GabrielPaschoalin/PFC/maglev/Analises/PULSO_255_150_800_9_800/debug/sync_preview.jpg

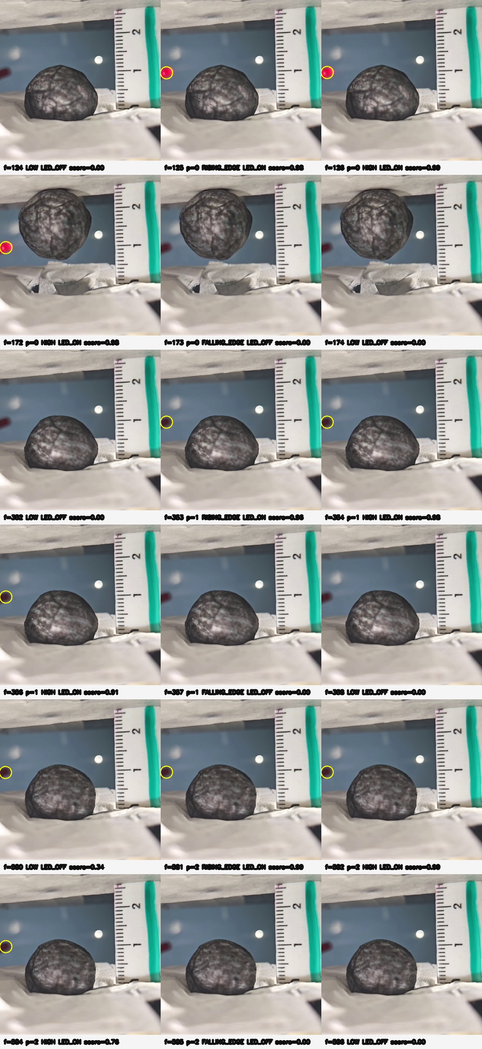
maglev/Analises/PULSO_255_150_800_9_800/debug/sync_preview.jpg
