GabrielPaschoalin/PFC/maglev/Analises/PULSO_255_150_800_9_800/debug/ruler_preview.jpg

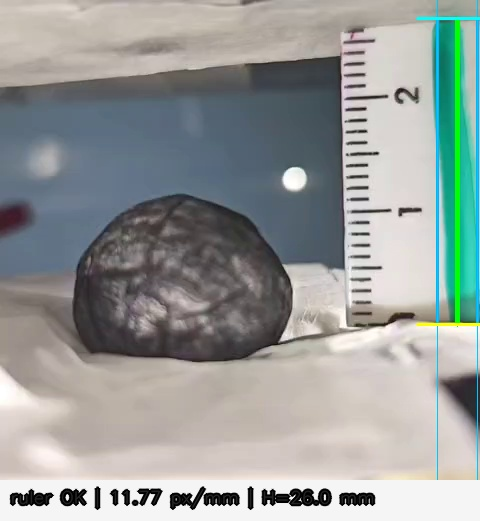
maglev/Analises/PULSO_255_150_800_9_800/debug/ruler_preview.jpg
