GabrielPaschoalin/PFC/TESE/modelo_latex/modelo_latex/Monografia.tex

% Monografia para Projeto de Fim de Curso - Exemplo no LaTeX
%-----------------------------------------------------------

%---------------Inicialização de pacotes--------------------

\documentclass[12pt,a4paper,notitlepage,twoside]{book}
\usepackage{times}

\usepackage{graphicx}
\usepackage[latin1]{inputenc}
\usepackage[brazil]{babel}
\usepackage[T1]{fontenc}
\usepackage{amsmath}
\usepackage{amsthm,amsfonts}
\usepackage{color}
\usepackage[colorlinks]{hyperref}
\usepackage{abntex2abrev}

\usepackage[a4paper,top=30mm,bottom=30mm,inner=30mm,outer=25mm,headheight=7mm,headsep=6mm,footskip=7mm]{geometry}
%\usepackage{epsfig}
%\usepackage{latexsym}
%\usepackage{float}
%\usepackage{quotes}
%\pagestyle {plain}

\makeindex

\def\baselinestretch{1.0}

%---------------Início do documento-------------------------

\begin{document}

\include{Capa/capa}

\pagenumbering{roman}
\include{Resumo/Resumo}
\include{Agradecimentos/Agradecimentos}
\include{TabelaConteudo/TabelaConteudo}
\include{ListaFiguras/ListaFiguras}
\include{ListaTabelas/ListaTabelas}

\pagenumbering{arabic}
\setcounter{page}{1}
\include{Introducao/Introducao}
\include{DescricaoProcesso/DescricaoProcesso}
\include{Metodologia/Metodologia}
\include{Resultados/Resultados}
\include{Conclusao/Conclusao}

\addcontentsline{toc}{chapter}{Referências Bibliográficas}
\bibliographystyle{plain}
\begin{small}
\bibliography{telefonia}%,library}
%\input{Monografia.bbl}
\end{small}

\end{document}

%---------------Fim do documento----------------------------
