GabrielPaschoalin/PFC/Modelagem-PFC/Magnetic Cores with FEMM and LUA.pptx

## Magnetic Cores designs with FEMM

Simulating magnetic core using FEMM and LUA scripts to estimate inductance and Magnetic Gain
Javier Contreras
Scott Vestal
February 2017

## Installing FEMM

- FEMM can be downloaded from the official website. http://www.femm.info/wiki/HomePage.

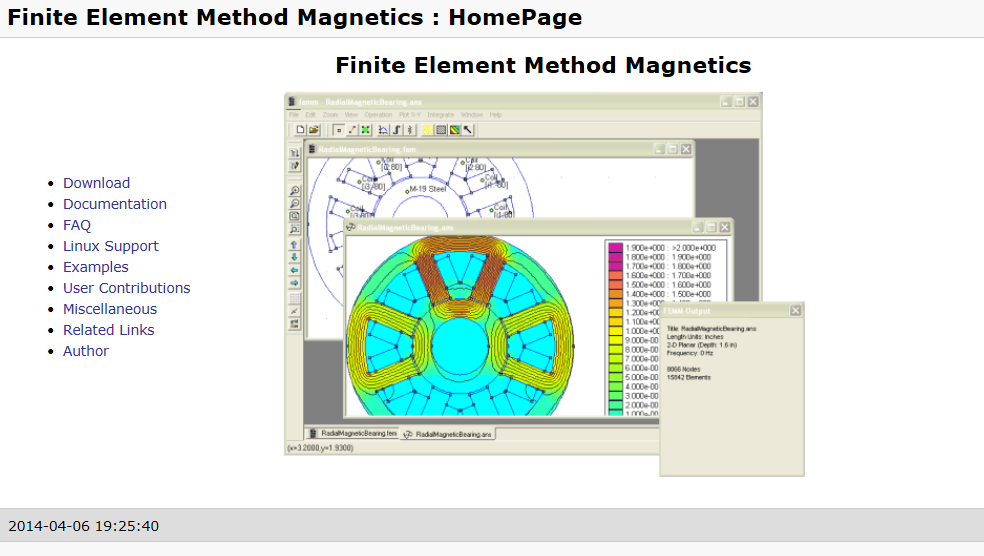
[picture p3: figure]

## Finite Element Method Magnetics (FEMM) Basics

- FEMM uses a Finite Element method to solve electromagnetics problems.
- Nodes connected by line segments and arcs to define boundary conditions as well as regions containing different materials and current distributions.
- FEMM then generates a mesh within this problem’s geometry, which it uses to solve for the magnetic field distribution within the boundaries.

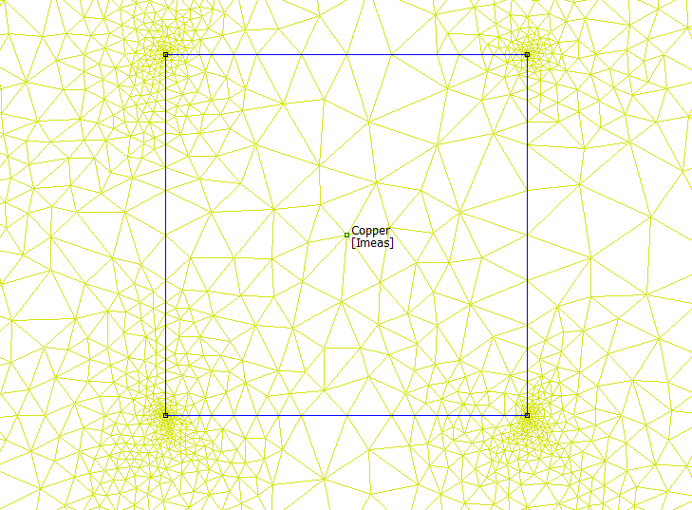
[picture p4: figure]

## Finite Element Method Magnetics (FEMM) Basics

- LUA allows all the functionality of FEMM to be controlled through scripting and make drawing a core and changing parameters quicker and not having to redraw a core in FEMM
- Scripts attached are used to get an estimate of magnetic core’s inductance in the secondary coil and the core’s magnetic gain.
- Parameters are used in the DRV421 System Parameter Calculator (http://www.ti.com/lit/zip/sloc329)

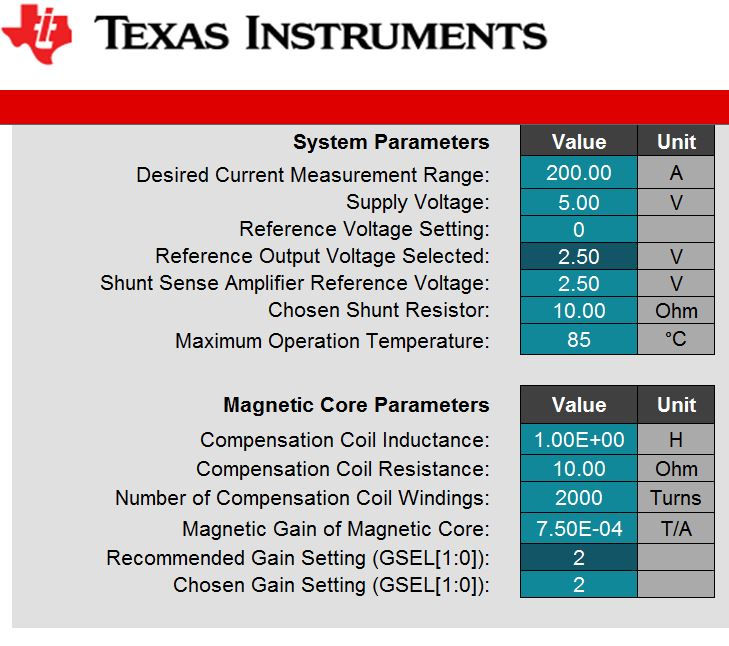
[picture p5: figure]

## Magnetic Core

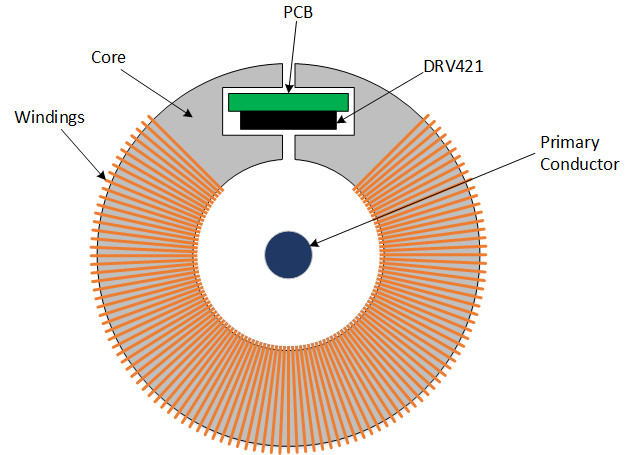
[picture p6: figure]

- The script attached will draw the core seen.
- Download script and save where you would like all your FEMM Magnetic Core simulations saved.

## Run Script From FEMM

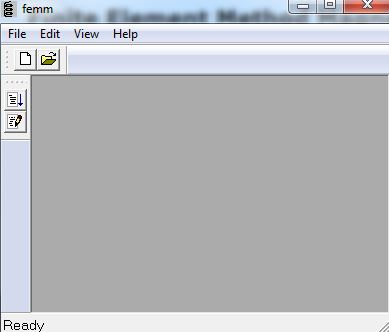
[picture p7: figure]

- Click “Open a Lua Script”
- Navigate to location of the scipt “Build_Magnetic_Core.lua” and select it.
- Follow the next slides for description of the input parameters.

## Input Parameters for Script

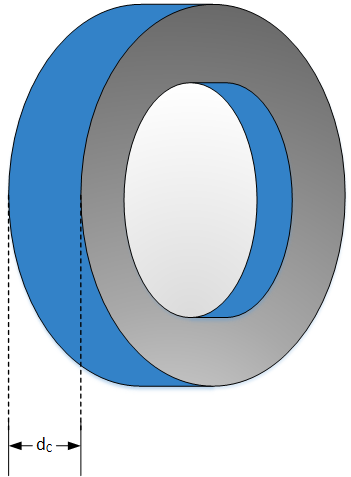
[picture p8: figure]

- File Name – This is the name of the file created and saved. It will be save in the folder that contains the script.
  - Note: file name must include .fem extension
- Core_Depth (dc) This is how much depth in the simulation there is. This is the axis that is not shown in FEMM since this is only a 2D drawing.

## Input Parameters for Script Cont.

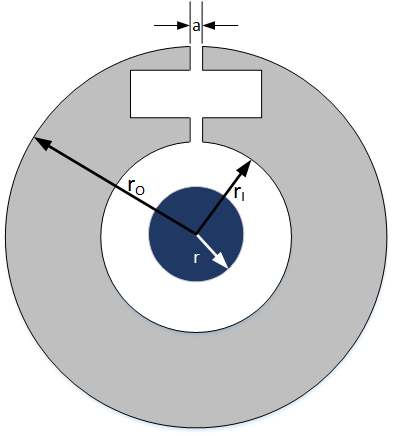
[picture p9: figure]

- Core Inside Radius (ri)
- Core Outer Radius (ro)
- Air Gap (a)

## Input Parameters for Script Cont.

- Primary Radius (r)
- Core Permeability
  - 14000 (Iron)
  - 83000 (Mu Metal)

## Input Parameters for Script Cont.

- Number of Turns- Secondary Coil number of windings.
- Winding Angle (ti°)

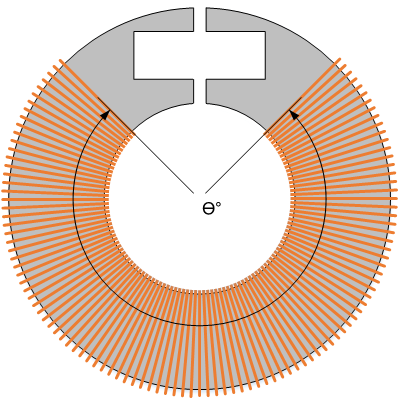
[picture p10: figure]

## Input Parameters for Script Cont.

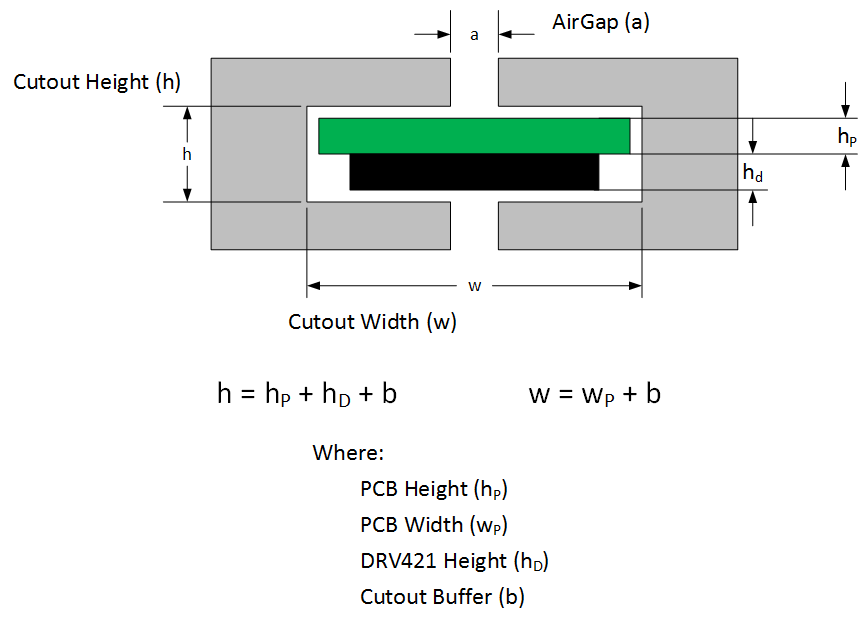
[picture p11: figure]

- PCB Height (hP)
- PCB Width (wP)
- Cutout Buffer (b)
- DRV421 Height (hD) is a constant

## Script outputs

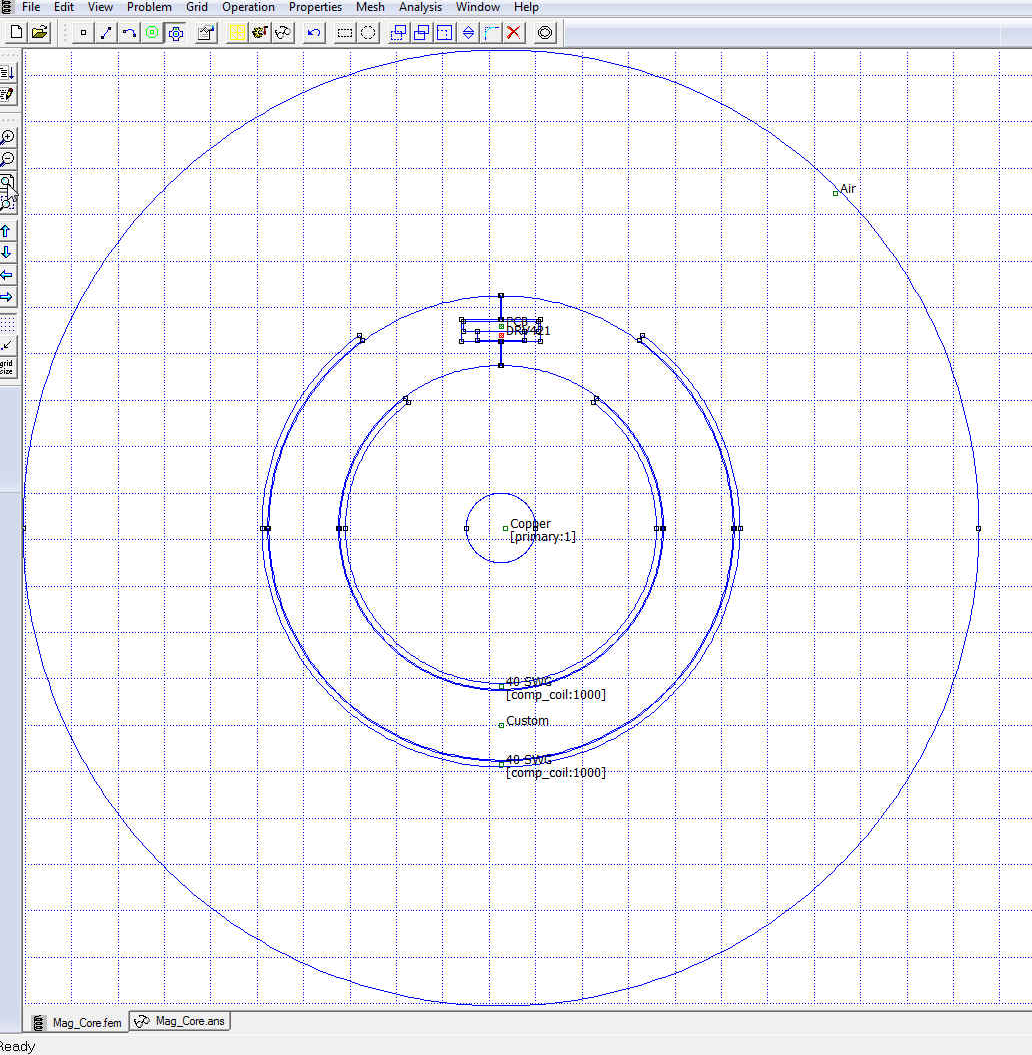
[picture p12: figure]

- Filename.fem file with the drawing of the Magnetic Core with input parameters.
i. A current on the compensation coil. Compensation current is (1A)/(# of Turns) . The current is used to calculate the inductance and magnetic core gain.
ii. Primary current is zero.

## Script outputs Cont.

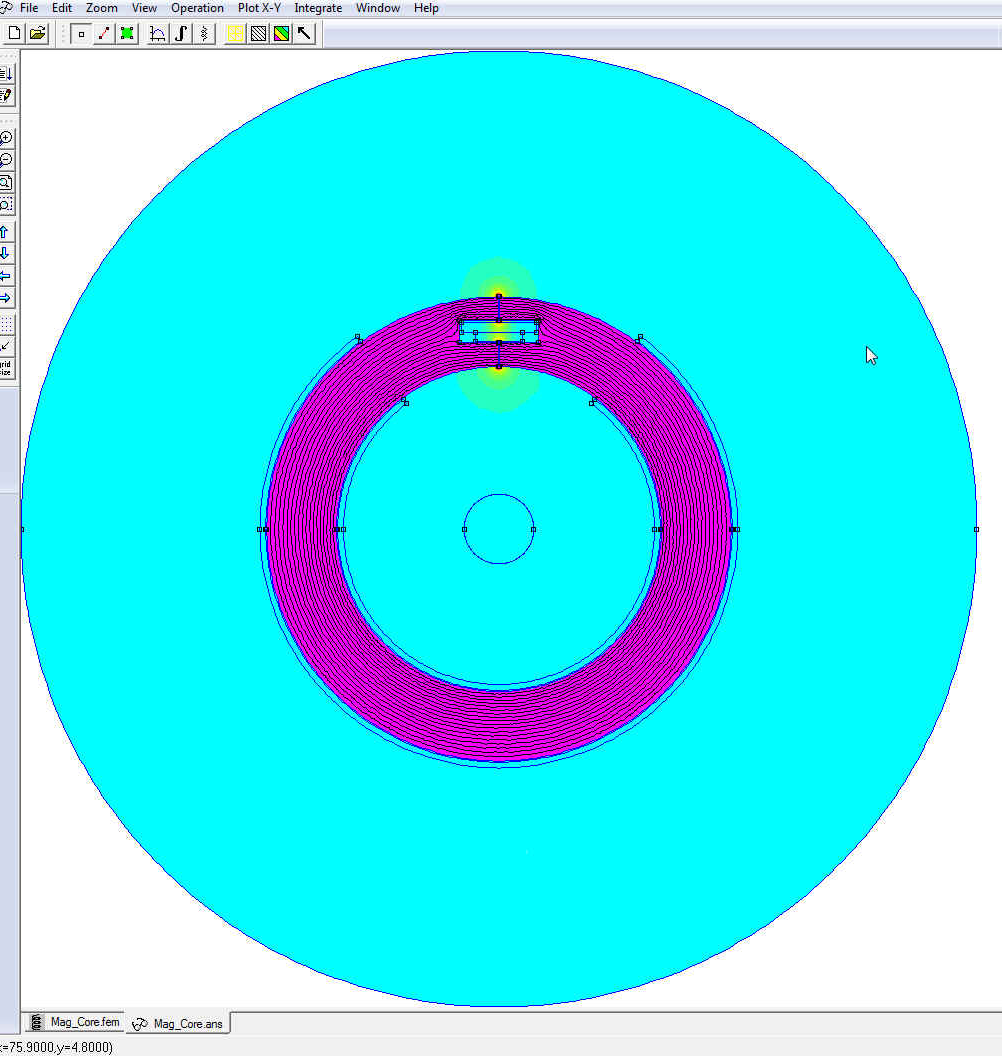
[picture p13: figure]

- Filename.ans (answer) file that shows the magnetic field on and surrounding the magnetic core with current on the compensation coil as described in previous slide.

## Script outputs Cont.

- Lua Outputs.
1. Inductance(H)
2. Core Magnetic Gain (Tesla/Amp)
3. Sensor Location (X,Y) 0.4 mm from top of DRV421

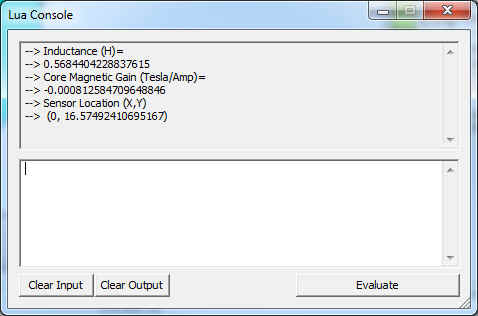
[picture p14: figure]
