GabrielPaschoalin/PFC/TESE/modelo_latex/modelo_latex/Conclusao/Conclusao.tex

\chapter{Conclusões}

\section{Considerações Finais}

Aqui vai o texto da conclusão.

\section{Propostas de Continuidade}

\clearpage
