GabrielPaschoalin/PFC/TESE/modelo_latex/modelo_latex/DescricaoProcesso/DescricaoProcesso.tex

\chapter{Descrição do Processo}

Se desejar, uma visão geral do Capítulo pode ser colocada antes da primeira Seção. Este é o capítulo de descrição do processo e formulação do problema. Tendo em vista que se trata de uma monografia de engenharia de controle e automação, em muitos casos, é fundamental a apresentação dos sensores e atuadores do processo.

\section{Processo de Fazer Alguma Coisa}
\markright{\thesection ~~~ Histórico}
\label{hist}

...

\section{Instrumentação do Processo}
\markright{\thesection ~~~ O Telefone}
\label{telefone}

Continua ...

\section{Resumo do Capítulo}

Não termine de forma abrupta.

\clearpage
