GabrielPaschoalin/PFC/TESE/modelo_latex/modelo_latex/ListaFiguras/ListaFiguras.tex

\listoffigures
\addcontentsline{toc}{chapter}{Lista de Figuras}
%\markboth{Lista de Figuras}{Lista de Figuras}

\clearpage
%\thispagestyle{empty}
%\cleardoublepage

% Normalmente, este arquivo só contém isto.
