GabrielPaschoalin/PFC/TESE/modelo_latex/modelo_latex/ListaTabelas/ListaTabelas.tex

\listoftables
\addcontentsline{toc}{chapter}{Lista de Tabelas}
%\markboth{Lista de Tabelas}{Lista de Tabelas}

\clearpage
%\thispagestyle{empty}
%\cleardoublepage

% Normalmente, este arquivo só contém isto.
