GabrielPaschoalin/PFC/TESE/modelo_latex/modelo_latex/Metodologia/Metodologia.tex

\chapter{Metodologia}

Neste capítulo, você deve apresentar uma breve revisão bibliográfica sobre as técnicas utilizadas para solução do problema.

\section{Técnica 1}
\markright{\thesection ~~~ Metodologia}
\label{metodo}

Aqui você encontra um exemplo de inserção de figura. Veja o arquivo DescricaoProjeto.tex para ver os comandos.
\begin{figure}[!htbp]
	\centering		
	
	\caption{figuara teste}
	\label{fig:ciclodesenvolvimento}
\end{figure}

A figura \ref{fig:ciclodesenvolvimento} tal aparece.

\begin{table}
	\centering
		\begin{tabular}{c|c}
			1 & 2 \\
			1 & 2 \\
			1 & 2 \\
			1 & 2 \\
			1 & 2 \\			
		\end{tabular}
\end{table}

\begin{figure}[htbp]
\centering

\caption{Ciclo de desenvolvimento de um projeto \cite{and/74}.}
\label{CicloDesenvolvimento1}
\end{figure}

Para referenciar a Figura \ref{CicloDesenvolvimento1}, veja arquivo .tex.

\begin{equation}\label{eq:forca}
	f=ma
\end{equation}

A equação \ref{eq:forca}
\section{Técnica 2}
\markright{\thesection ~~~ Metodologia}
\label{metodo1a}

\section{Resumo do Capítulo}
\markright{\thesection ~~~ Metodologia}
\label{metodo1b}

\clearpage
