GabrielPaschoalin/PFC/TESE/Referência/LAB 1 - MAGLEV.pdf

## Relatório do Módulo 2: MAGLEV (Levitador Magnético)

Bernardo de Souza Silva, Gabriel Henrique Lara Paschoalin Dias, Igor Miranda Sartori, Júlia de Castro
Laboratório de Controle e Automação I - Turma PN2 I - Introdução
O objetivo do presente relatório é fornecer uma descrição dos procedimentos realizados em ambiente laboratorial para o desenvolvimento de um controlador destinado à planta conhecida como MAGLEV (Levitador Magnético). O princípio de funcionamento deste dispositivo é baseado na levitação de uma pequena esfera metálica por meio da criação de um campo eletromagnético. Assim, o dispositivo é um modelo simplificado de mecanismos que usam propriedades eletromagnéticas para reduzir o atrito, como trens de levitação magnética, rolamentos magnéticos, bombas, ventiladores, turbinas, entre outros. A Figura 1 apresenta o modelo visual da planta controlada.

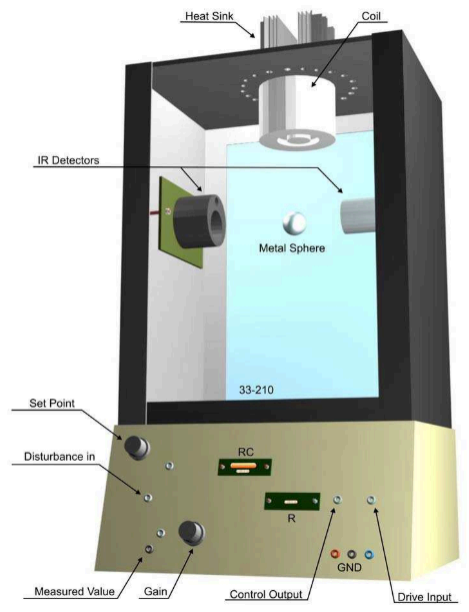
[picture p41: figure]

Figura 1: Modelo visual do MAGLEV (Feedback Instruments Ltd., 2006)

O MAGLEV está equipado com sensor infravermelho para detectar a posição da esfera e uma bobina, que gera o campo eletromagnético quando uma corrente elétrica é aplicada. O sistema é SISO (Single Input, Single Output), tendo como entrada a corrente e como saída a posição da esfera metálica. Na prática, a entrada do módulo de levitação não é a corrente na bobina, tampouco a saída é a posição em metros da esfera. O que ocorre é que a corrente é produzida a partir de um sinal de tensão e a posição da esfera é medida pelo sensor infravermelho e enviada à placa de aquisição de dados, também em forma de tensão.

O módulo possui uma interface para se comunicar com a placa de aquisição de dados, que é responsável por fornecer os sinais necessários para o funcionamento do sistema de controle. Esse sistema de controle é implementado no ambiente MATLAB, utilizando a ferramenta Simulink. Os sinais de controle, calculados pelo controlador, são convertidos em sinais de tensão na faixa de -5 V a 5 V. Esses sinais de tensão são então aplicados à bobina, permitindo o controle preciso da posição vertical da esfera metálica.
A fabricante Feedback libera um projeto inicial funcional, mostrado na Figura 2, com um diagrama de blocos implementado. A partir dele, inicia-se o projeto do controlador.

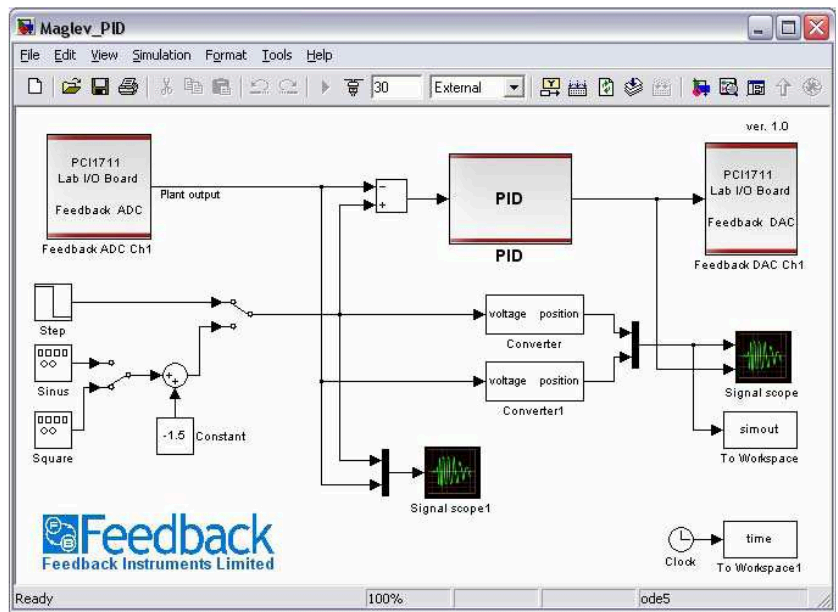
[picture p42: figure]

Figura 2: Projeto inicial do MAGLEV, fornecido pela fabricante Feedback (Feedback Instruments Ltd., 2006)

Na prática realizada, foram editados os blocos PID, para alterar os parâmetros KP, KI e KD; Square, para gerar os degraus; Constant, para alterar o valor da constante que define a posição que será o ponto de operação, em metros. Além disso, adicionou-se um conversor de tensão para posição após a saída da planta; e um conversor de posição para tensão após a saída do controlador. Um bloco ctrl_signal foi adicionado para obter os valores do sinal de controle.

II - Descrição da planta
Identificação das variáveis controlada, manipulada, medida e de referência
Diante da análise feita na planta do MAGLEV, identificou-se as variáveis do sistema. Estas são indicadas a seguir:
- Variável controlada: Posição da esfera metálica (m), após a conversão de tensão para posição;
- Variável manipulada: Corrente elétrica na bobina (A), que é produzida por um sinal de tensão;
- Variável medida: Posição da esfera metálica (m);
- Variável de referência: Posição desejada da esfera metálica, 0,009 metros acima do ponto inicial. Identificação dos subsistemas físicos correspondentes à planta, ao sensor, ao atuador e ao gerador de sinais de referência
Diante da análise feita na planta do MAGLEV, identificou-se os subsistemas físicos correspondentes à planta, ao sensor, ao atuador e ao gerador de sinais de referência. Estes são indicadas a seguir:
- Planta: Representa o sistema físico real sendo controlado, ou seja, o próprio MAGLEV (Levitador Magnético), que consiste em uma estrutura composta por uma bobina e uma esfera metálica.
- Sensor: Refere-se ao sensor infravermelho utilizado para detectar a posição da esfera metálica. Esse sensor fornece informações sobre a posição do sistema em relação à posição vertical.
- Atuador: Representa a bobina do MAGLEV, que é controlada pela variação da tensão aplicada a ela. Essa variação na tensão afeta diretamente a posição vertical da esfera metálica.
- Gerador de sinais de referência: Representa o bloco de geração de sinais de referência do Simulink, que é utilizado para definir as posições verticais desejadas da esfera metálica. Identificação dos sinais de perturbação e não-linearidades
Diante da análise feita na planta do MAGLEV, identificou-se possíveis sinais de perturbação e não-linearidades do sistema. Estes são indicadas a seguir:
- Sinais de perturbação: Incluem influências externas que afetam o comportamento do sistema, como vibrações na planta e na mesa onde ela está localizada, variações na corrente elétrica fornecida, interferências magnéticas externas e outros tipos de esforços externos sobre o sistema durante o seu funcionamento. O controlador deve ser capaz de lidar com essas perturbações, de modo a manter o sistema estável.
- Não-linearidades: A dinâmica do MAGLEV pode apresentar não-linearidades devido a vários fatores, tais como variações altas na corrente elétrica fornecida à bobina, saturação magnética, efeitos não-lineares do sensor infravermelho, não-linearidades nos conversores de tensão para posição e posição para tensão, entre outros. Essas não-linearidades podem afetar o comportamento do sistema, especialmente em posições extremas da esfera metálica ou em condições de alta velocidade.

III - Especificação de desempenho desejado (objetivo)
A fim de obter um bom resultado no controle da planta, foram estabelecidos previamente alguns parâmetros a serem seguidos, sendo estes:
- Rejeitar distúrbios: O sistema deve ser capaz de rejeitar eficientemente os distúrbios externos, como variações na carga, vibrações e interferências magnéticas, garantindo que a posição da esfera metálica seja mantida próxima à posição desejada, mesmo diante dessas perturbações.
- Tempo de assentamento e overshoot baixos: O sistema deve ser capaz de atingir a posição desejada da esfera metálica o mais rápido possível, minimizando tanto o tempo de assentamento, em torno de 1 segundo, quanto o overshoot, em torno de 20%. Isso proporciona uma resposta rápida e suave do sistema, evitando oscilações e permitindo que a esfera atinja a posição desejada com precisão e estabilidade.
- Seguimento de trajetória em degrau: O sistema deve ser capaz de seguir com precisão uma trajetória em degrau, ou seja, quando a posição desejada da esfera metálica é alterada abruptamente. O controlador deve garantir que a esfera se mova suavemente e rapidamente para a nova posição, minimizando o tempo de resposta e reduzindo o overshoot, garantindo assim um controle eficiente e preciso do sistema.

IV - Modelagem matemática
Segundo o manual da planta (Feedback Instruments Ltd., 2006), constatou-se que a função de transferência, no ponto de operação, é dada por:
G(s) = | , | (1)

−Ki
(s² + Kx
)
em que:
K | (2)
x =

−2mg
x
o
e
K | (3)
i =

2mg
i
o
Nas equações (2) e (3), m = 0, 02 kg é a massa da esfera metálica, constatado via pesagem na
balança, i | é a corrente inicial aplicada e | é a posição inicial, expressa em V.
o = 0, 8 A | x

o = 1, 5 V
Para o cálculo das constantes K e | , os valores de e | foram convertidos para metros, de
x

K
i

i
o

x
o
modo que possa ser calculado corretamente o modelo. A fórmula de conversão é indicada abaixo:
Posição[m] = 0, 007 · Tensão[V] + 0, 0195 | (4)
Para x = -1,5 V, a posição, em metros, encontrada é:
o
x [m] | (5)
o | = 0, 007 · (− 1, 5) + 0, 0195 = 0, 009 m
Logo,
K | (6)
x =

−2·(0,02)·(9,8)
0,009 =− 43, 5

Já para i = 0,8 A, a posição, em metros, encontrada é
o
i | , | (7)
o

[m] = 0, 007 · (

0,8
1,05

) + 0, 0195 = 0, 0248 m
de modo que:
K | (8)
i =

2·(0,02)·(9,8)
0,0248 = 15, 8
Com toda a manipulação apresentada, é possível encontrar a função de transferência do sistema G(s), que é:
G(s) = | (9) ⁻ ¹⁵,8
(s² −43,5)

V - Validação do modelo obtido
A validação do modelo obtido do relatório não se fez necessária devido à abordagem adotada durante a fase de modelagem física do sistema. Seguindo as diretrizes estabelecidas no manual, garantimos a fidelidade do modelo em relação à realidade operacional. Os testes subsequentes demonstram essa assertiva, evidenciando a congruência entre a simulação teórica e os resultados práticos obtidos.

VI - Projeto do controlador
Na etapa de projeto do controlador, foram analisados diversos aspectos da planta, especialmente o comportamento do seu lugar das raízes, conforme ilustrado na Figura 3.

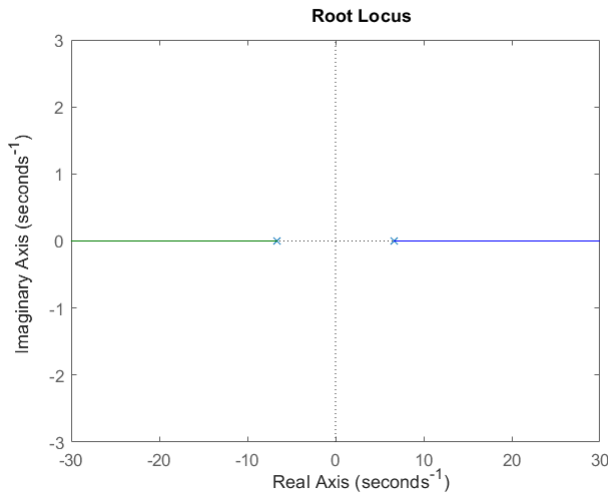
[picture p43: figure]

Figura 3: Lugar das raízes da planta

Para atender os requisitos de rejeição de distúrbios, tempo de assentamento baixo e pouco sobressinal, projetou-se um controlador PID, que tem equação:

PID = K | , | (10)
P +

KI
s + K
D

s
onde K é o ganho proporcional, | é o ganho integral e | é o ganho derivativo. Sabe-se que aumentar o
P

K
I

K
D
K pode tornar a resposta do sistema mais rápida, aumentar o pode reduzir o erro em regime
P

K
I
permanente e aumentar o K pode reduzir a magnitude das oscilações (SOUZA, 2023). Porém, aumentar
D
demais os ganhos pode causar mais instabilidade, oscilações e ruídos. Usando a função systool do MATLAB, identificou-se o melhor lugar para os polos do sistema e, com isso, determinou-se as
constantes do controlador: K = 4, | = 6, | = 0,9.
P

K
I

K
D
A Figura 4 mostra o lugar das raízes da planta junto do controlador.

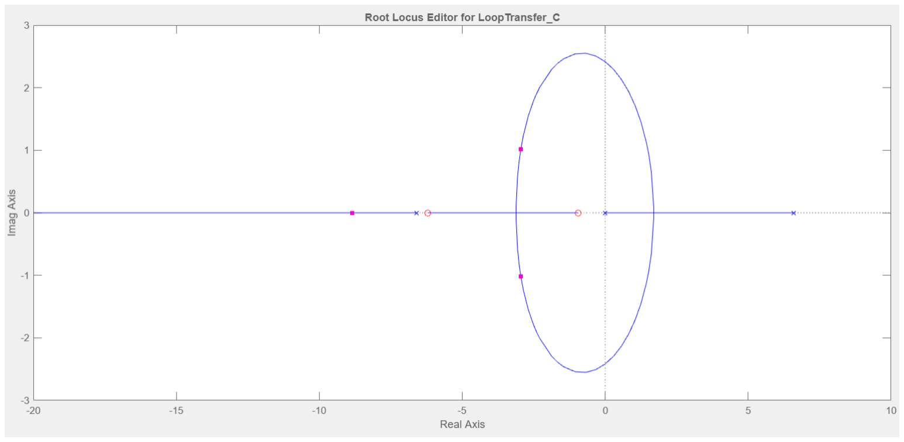
[picture p44: figure]

Figura 4: Lugar das raízes de C(s)G(s)

Logo, por meio da equação (10):
PID = 4 + | (11) ⁶
s + 0, 9s =

0,9s² + 4s + 6
s
Esse controlador apresentou um resultado satisfatório e foi considerado o controlador ideal para solucionar o problema apresentado, como será detalhado na próxima seção.

VII - Resultados experimentais em Malha Fechada
O ambiente no Simulink utilizado para os experimentos é mostrado na Figura 5. Neste diagrama, foi necessário criar os blocos Converter2 e Converter3, onde o primeiro recebe a medição da planta em volts e converter para metros. Já o segundo, recebe o sinal de controle calculado em metros e o converte para volts, para que o mesmo possa ser aplicado no atuador da planta.

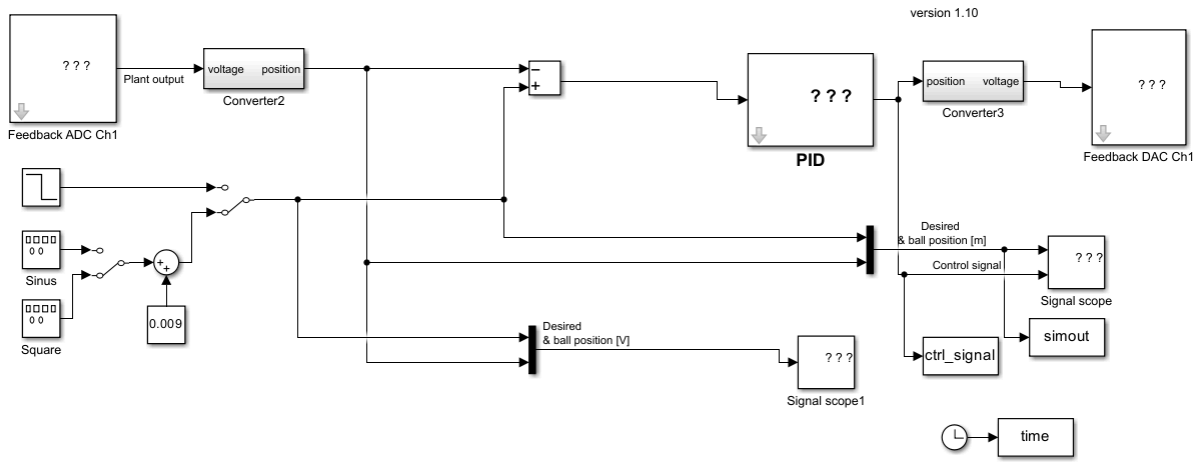
[picture p45: figure]

Figura 5: Ambiente do Simulink utilizado para os experimentos

Para testar o sistema em malha fechada com o controlador PID, definiu-se alguns cenários a serem levados em consideração, sendo indicados abaixo os gráficos das respostas a cada situação. Previamente, é necessário indicar um comportamento programado para o sistema, que é aplicar o efeito do integrador apenas após 15 segundos do início da aplicação. Isso implica que o sistema tende a erro zero apenas após esse tempo.
O primeiro caso é quando o sistema parte do repouso até a sua estabilização, sendo que a esfera é colocada manualmente. Na Figura 6, observa-se que o sistema não apresenta overshoot significativo e a esfera se desloca cerca de 4% para cima e para baixo em regime transitório, o que pode ser considerado um erro pequeno.

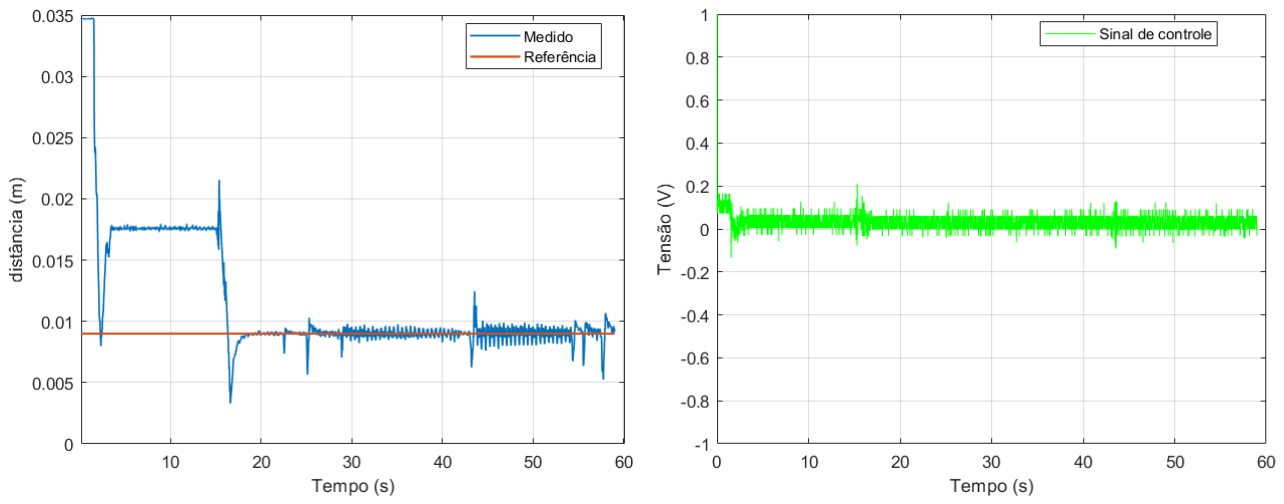
[picture p46: figure]

Figura 6: Comparação entre a posição da esfera e a referência ao longo do tempo e sinal de controle correspondente

Neste experimento específico, para simular um distúrbio, optou-se por aplicar um tremor sobre a mesa sob a qual o experimento está posicionado. A Figura 7 mostra, de forma ampliada, a resposta ao distúrbio no experimento acima, evidenciando, mais uma vez, a eficácia do controlador implementado. Vale ressaltar, que a oscilação no gráfica é baixa, considerando que a escala do eixo da distância está na escala 10 .

−3

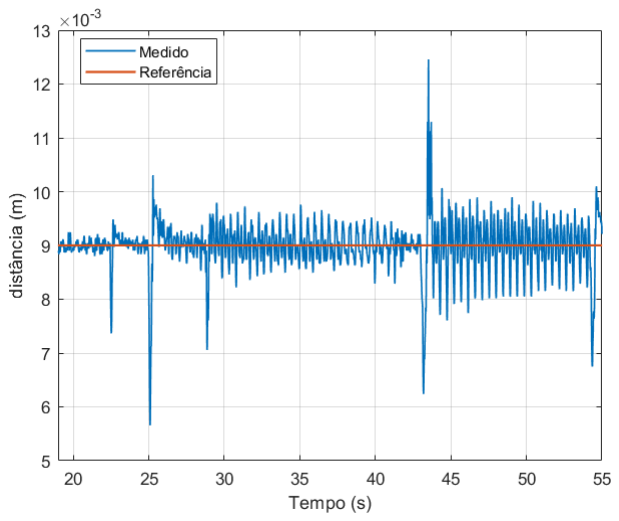
[picture p47: figure]

Figura 7: Regime permanente e aplicação de distúrbio

No segundo experimento realizado, testou-se o segmento de trajetória em degrau, aplicando-se degraus de 2 milímetros de forma ascendente no sistema e observando sua resposta. Na Figura 8, observa-se que o sistema teve uma resposta rápida e pouco oscilatória.

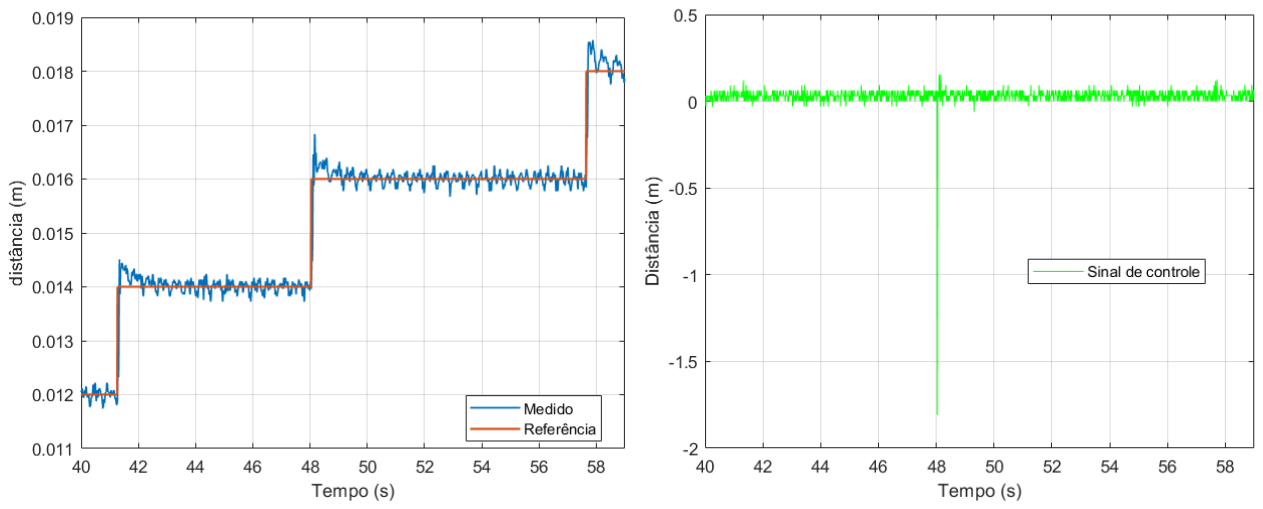
[picture p48: figure]

Figura 8: Trajetória em degrau do sistema e sinal de controle correspondente

No terceiro cenário, aplicou-se um trem de impulsos de amplitude 1 milímetro e frequência 0,2 Hz e observou-se o comportamento do sistema. A Figura 9 mostra que o sistema teve um pouco de dificuldade para acompanhar essa dinâmica devido à frequência dos pulsos, tendo um overshoot de aproximadamente 50% e resposta lenta, sem tempo suficiente para estabilizar completamente antes do próximo degrau.

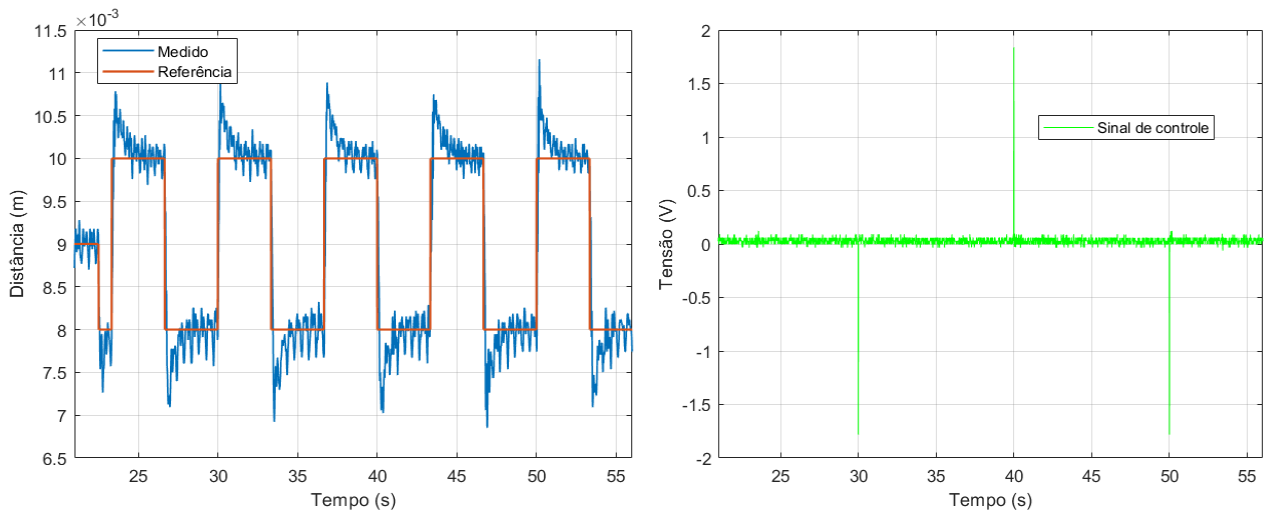
[picture p49: figure]

Figura 9: Resposta do sistema para uma entrada de trem de pulsos e sinal de controle correspondente

No quarto cenário realizado, indicado pela Figura 10, testou-se o segmento de trajetória de uma onda senoidal de frequência 0,2 Hz, aplicando-se inicialmente uma amplitude de 3 milímetros, seguido por 4mm, ambos com uma boa resposta. Por fim, aplicou-se uma amplitude de 5 milímetros, o que gerou uma saturação no sistema, de modo que a linearidade deixou de existir. A Figura 11 apresenta um zoom no gráfico da Figura 10, entre os intervalos 60 e 85 segundos, permitindo observar a qualidade do segmento da curva senoidal.

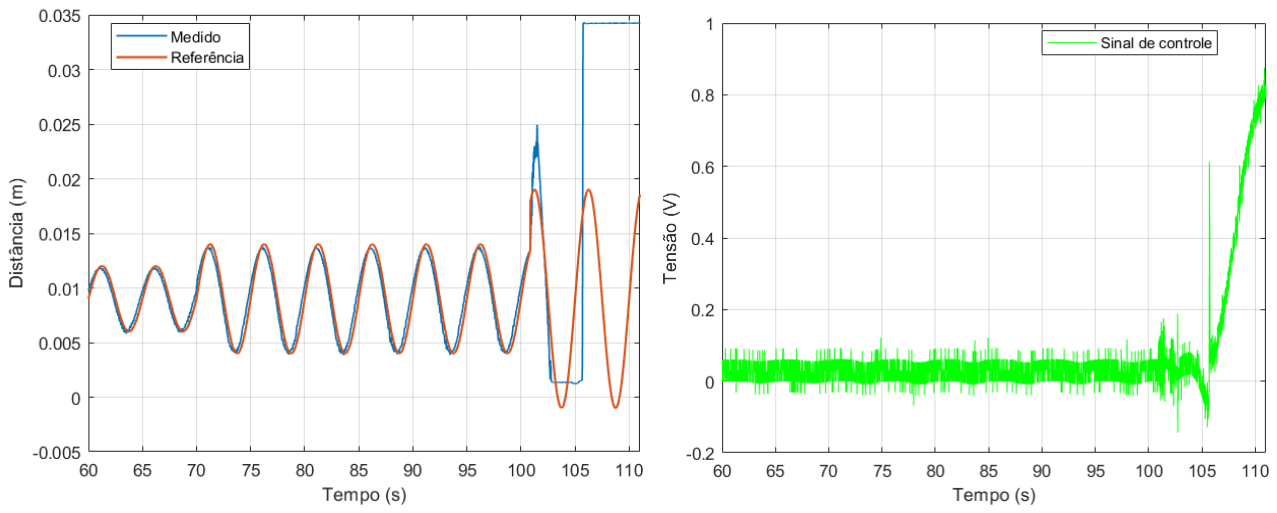
[picture p50: figure]

Figura 10: Resposta do sistema para uma entrada senoidal de amplitude baixa e sinal de controle correspondente

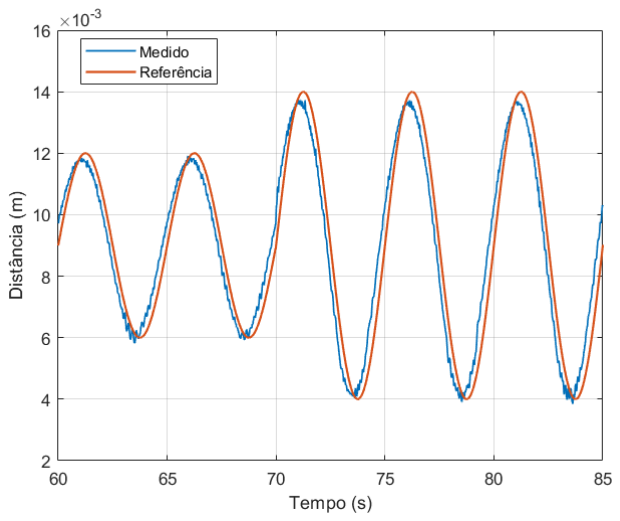
[picture p51: figure]

Figura 11: Destaque de um trecho da resposta à uma entrada senoidal

VIII - Conclusões
Através da modelagem matemática e da determinação das constantes utilizando a ferramenta systool do MATLAB, foi alcançado um resultado de controle satisfatório para a planta utilizando um controlador PID. Esta abordagem nos permitiu desenvolver uma estratégia de controle eficaz, adaptada às características específicas do sistema e aos requisitos de implementação. Devido ao ponto de operação milimétrico da planta, o sistema restringe seu funcionamento a ganhos e distúrbios pequenos como visto nos resultados em malha fechada. Para referências de posição abaixo de 7 milímetros ou acima de 20 milímetros e distúrbios muito grandes, o sistema já se torna instável.

IX - Referências bibliográficas
Feedback Instruments Ltd. MAGNETIC LEVITATION, Installation & Commissioning. Manual: 33-942IC, Ed 1, 2006.
SOUZA, Fernando de Oliveira. Notas de aula de Engenharia de Controle. UFMG, 2023.
