GabrielPaschoalin/PFC/comparacao_permeabilidade_nucleo.png

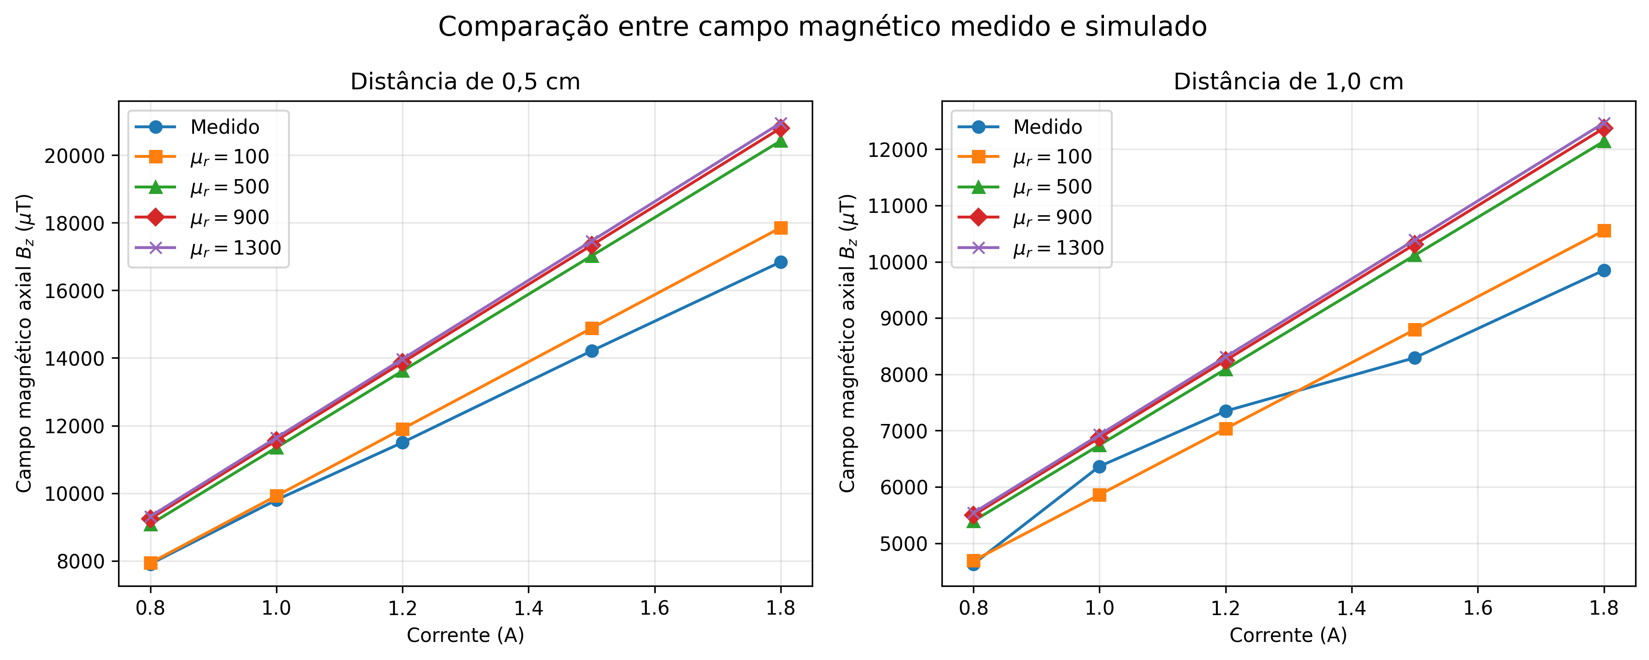
comparacao_permeabilidade_nucleo.png
