GabrielPaschoalin/PFC/Controlador/Plots/Lugar_raizes_sem_compensador.png

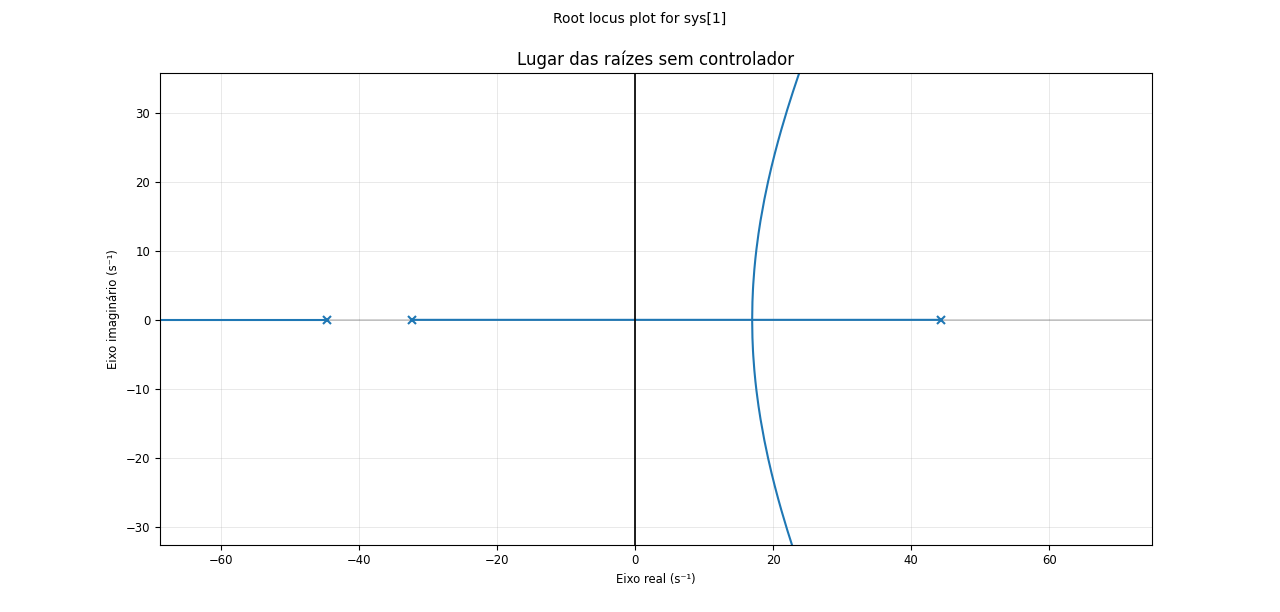
Controlador/Plots/Lugar_raizes_sem_compensador.png
