GabrielPaschoalin/PFC/Controlador/Projeto final/rlocus_planta_-1.png

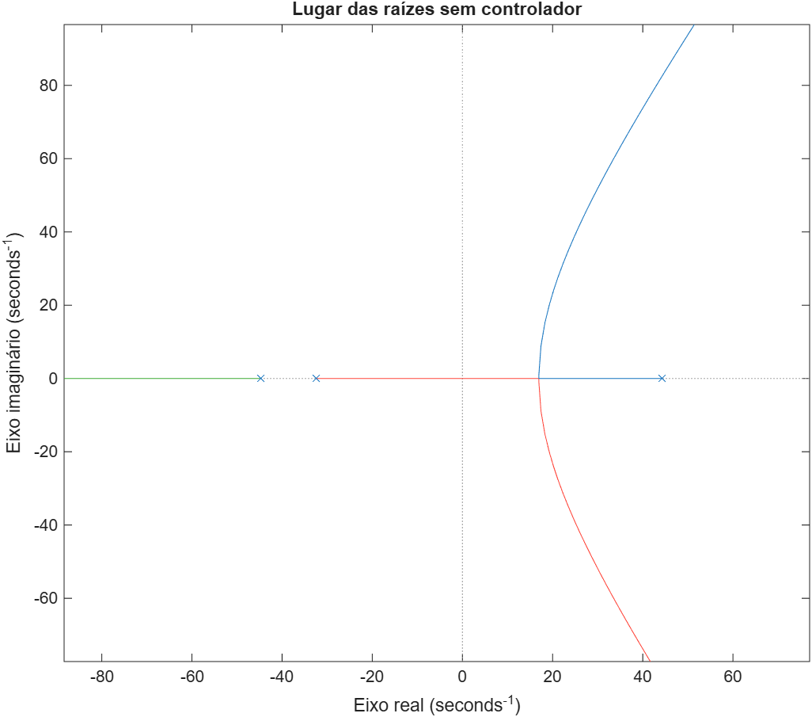
Controlador/Projeto final/rlocus_planta_-1.png
