GabrielPaschoalin/PFC/Controlador/Projeto final/rlocusSem.png

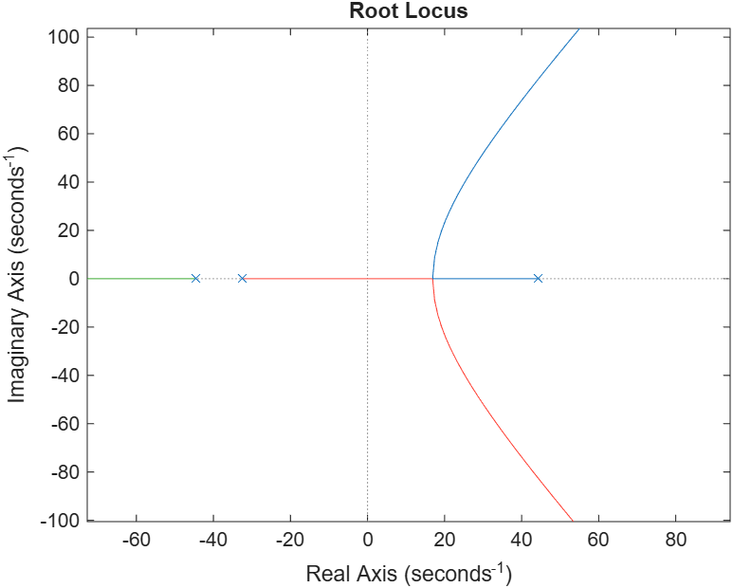
Controlador/Projeto final/rlocusSem.png
