GabrielPaschoalin/PFC/maglev/Analises/2024/plot.png

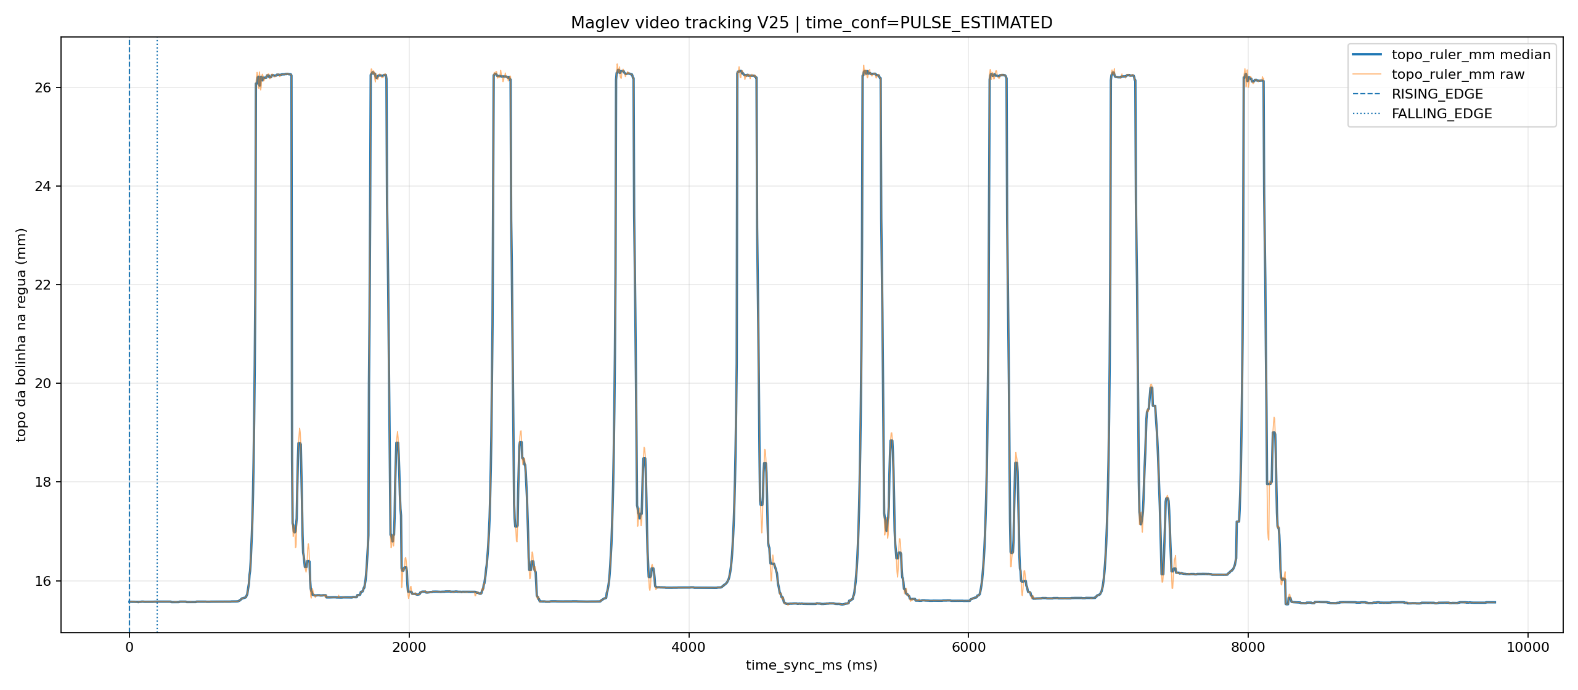
maglev/Analises/2024/plot.png
