GabrielPaschoalin/PFC/maglev/Analises/PULSO_190_250_800_10/Vídeo/plot.png

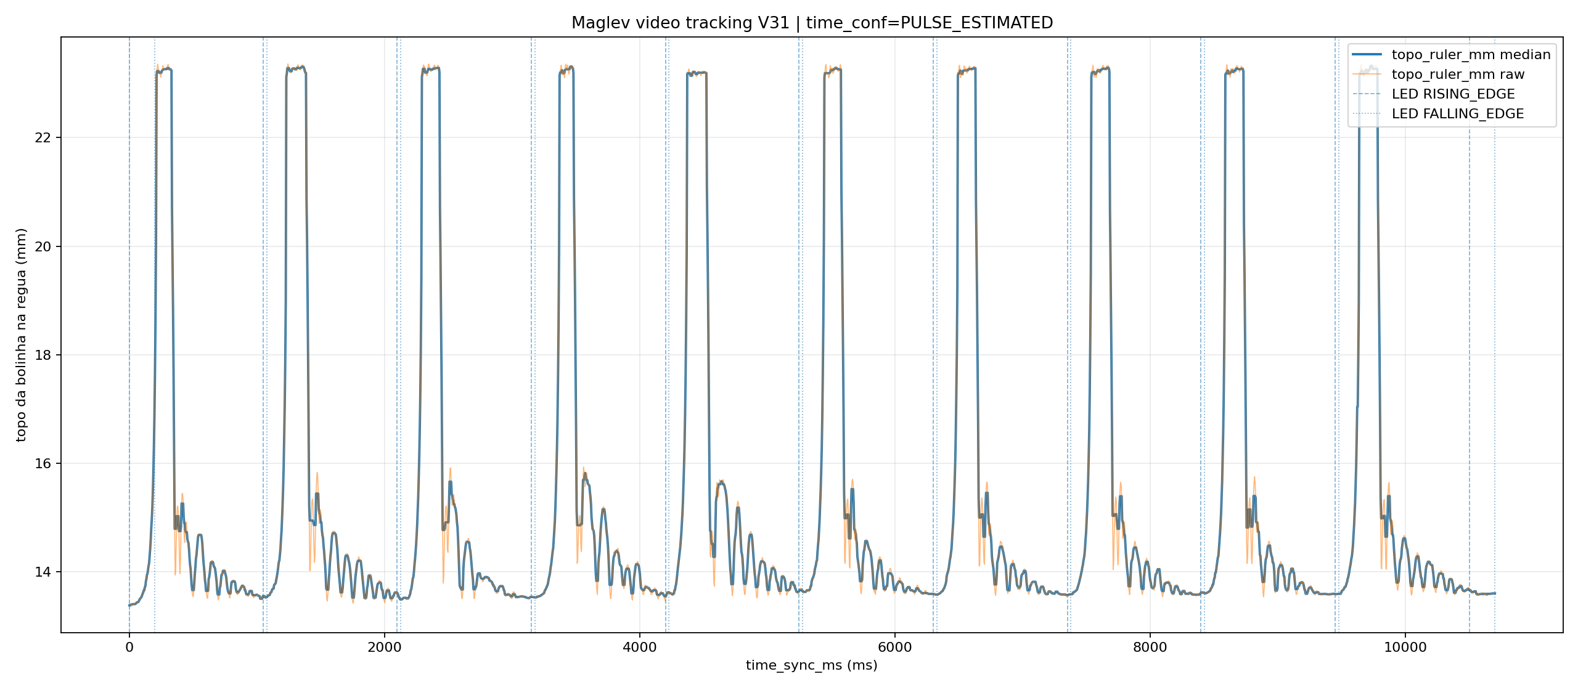
maglev/Analises/PULSO_190_250_800_10/Vídeo/plot.png
