GabrielPaschoalin/PFC/maglev/Analises/PULSO_230_100_1200_10/Video/plot.png

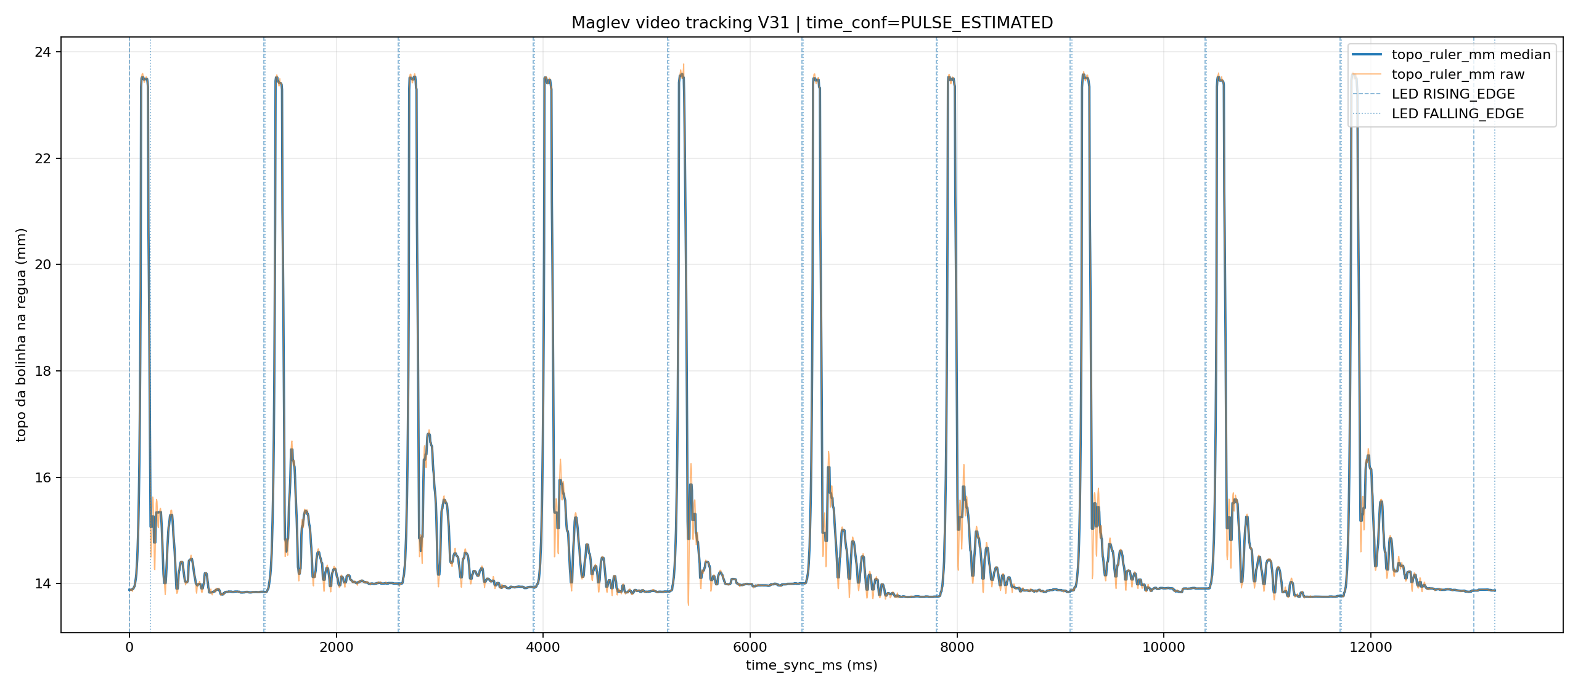
maglev/Analises/PULSO_230_100_1200_10/Video/plot.png
