GabrielPaschoalin/PFC/maglev/Analises/PULSO_255_150_800_9_800/plot.png

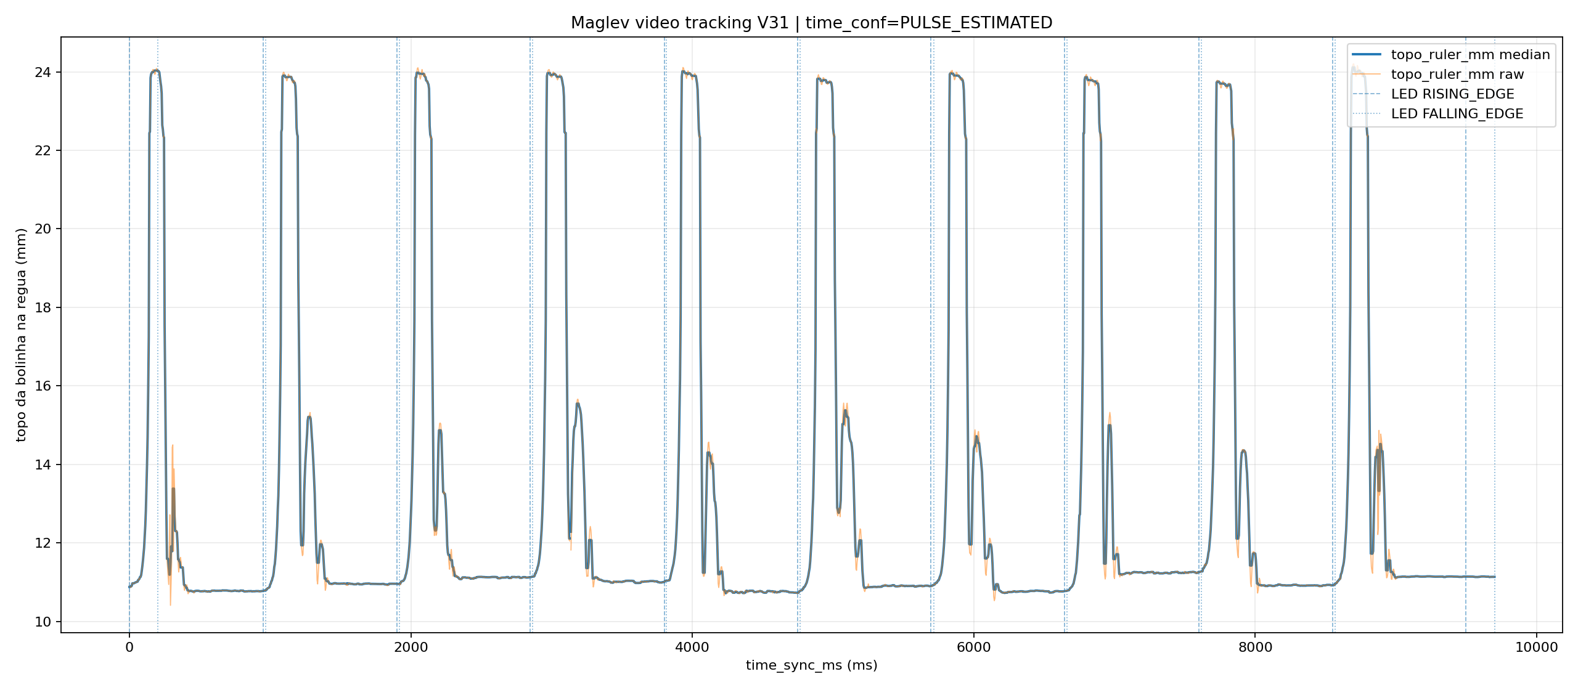
maglev/Analises/PULSO_255_150_800_9_800/plot.png
