GabrielPaschoalin/PFC/maglev/Bckp/00_28/plot.png

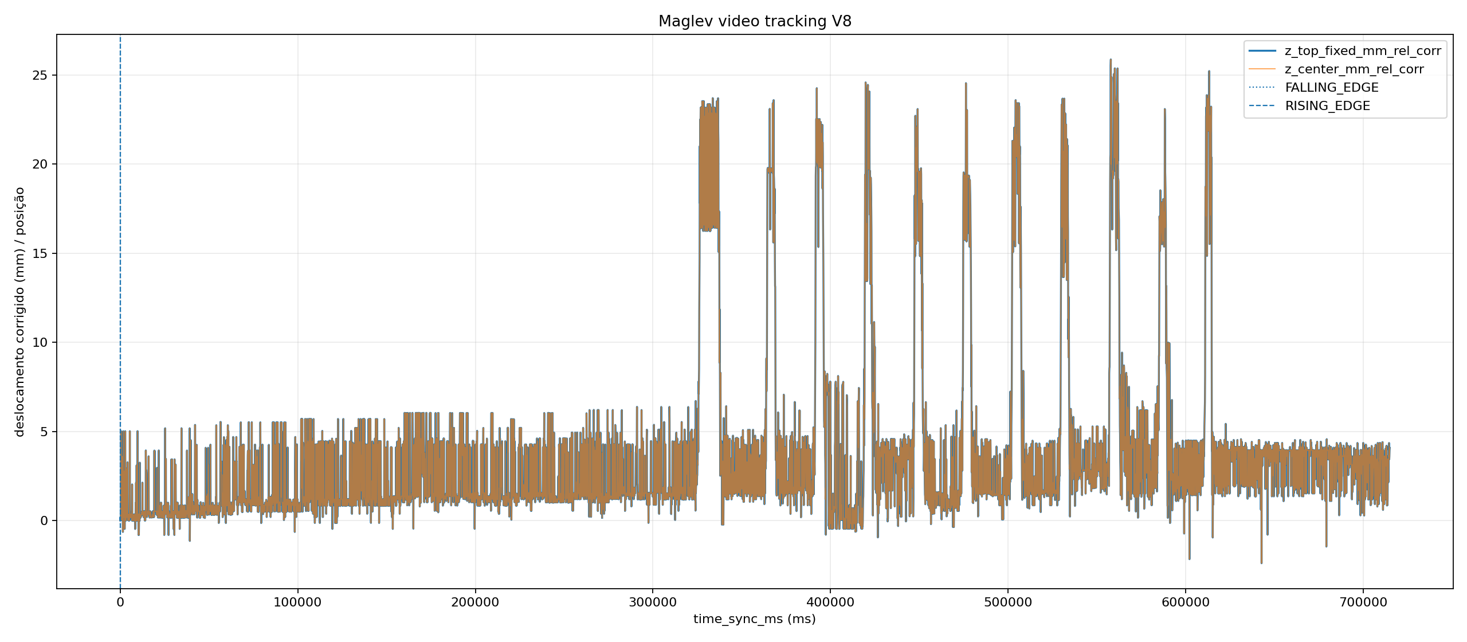
maglev/Bckp/00_28/plot.png
