GabrielPaschoalin/PFC/maglev/Bckp/ident_2/plot.png

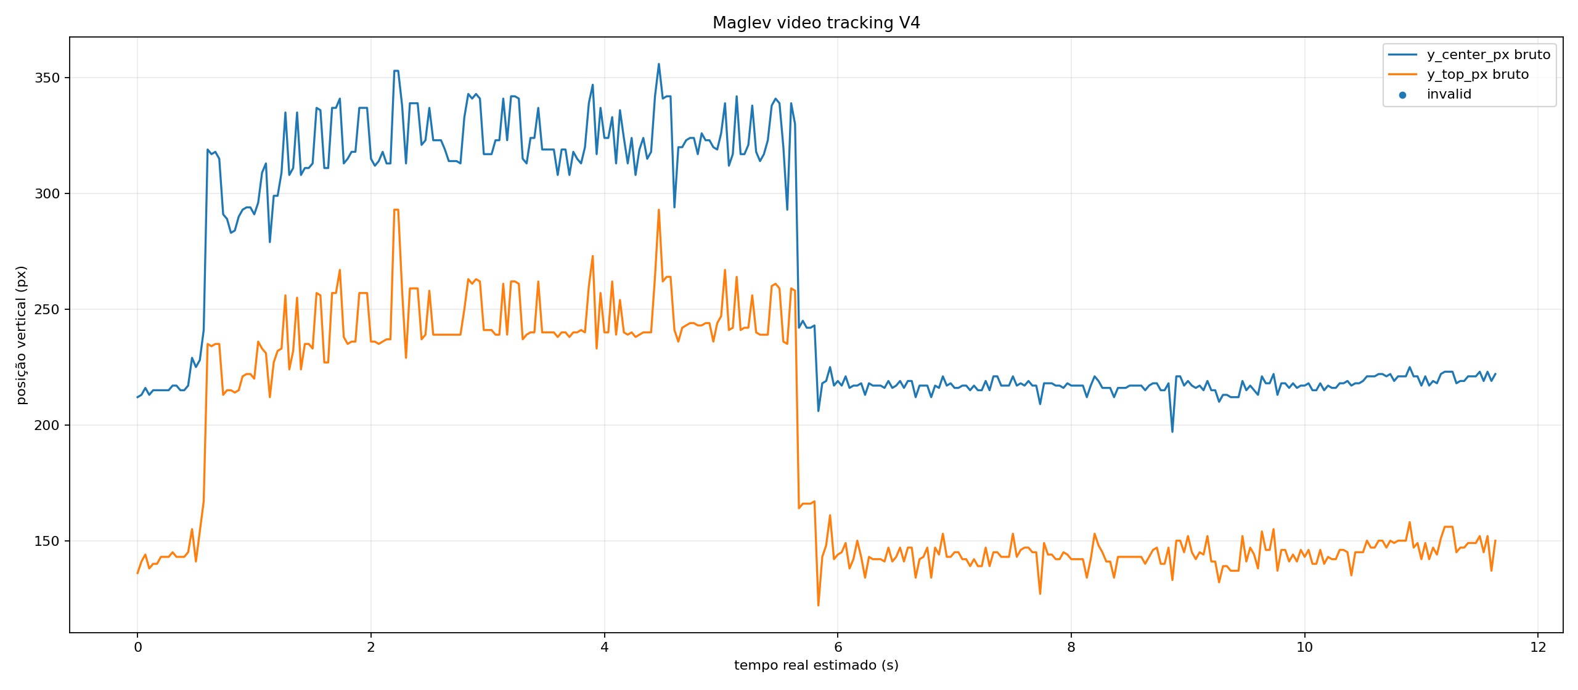
maglev/Bckp/ident_2/plot.png
