GabrielPaschoalin/PFC/maglev/Bckp/ident_2/preview.jpg

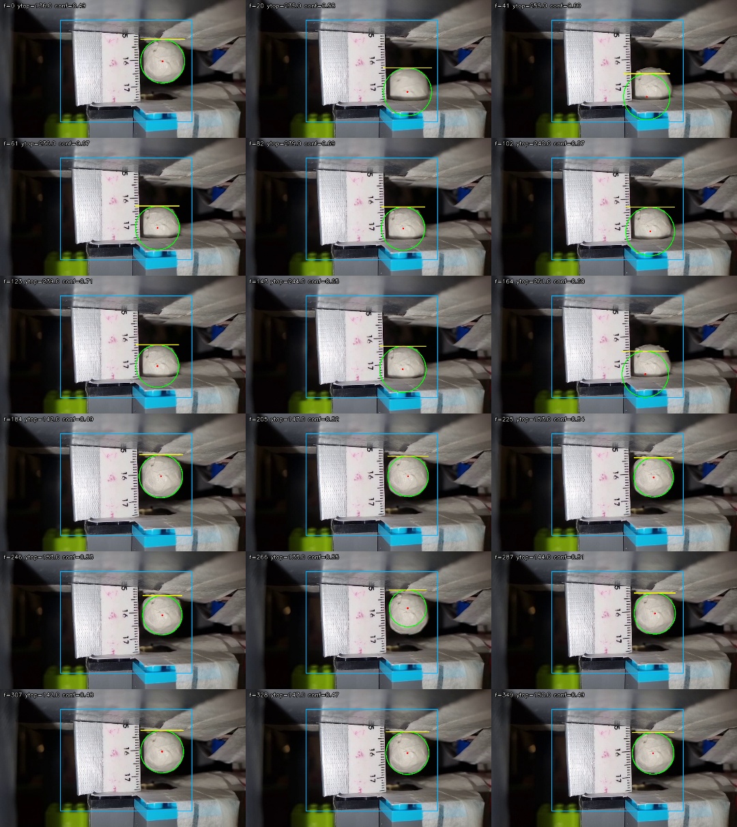
maglev/Bckp/ident_2/preview.jpg
