GabrielPaschoalin/PFC/maglev/Bckp/ident_slow_mo/plot.png

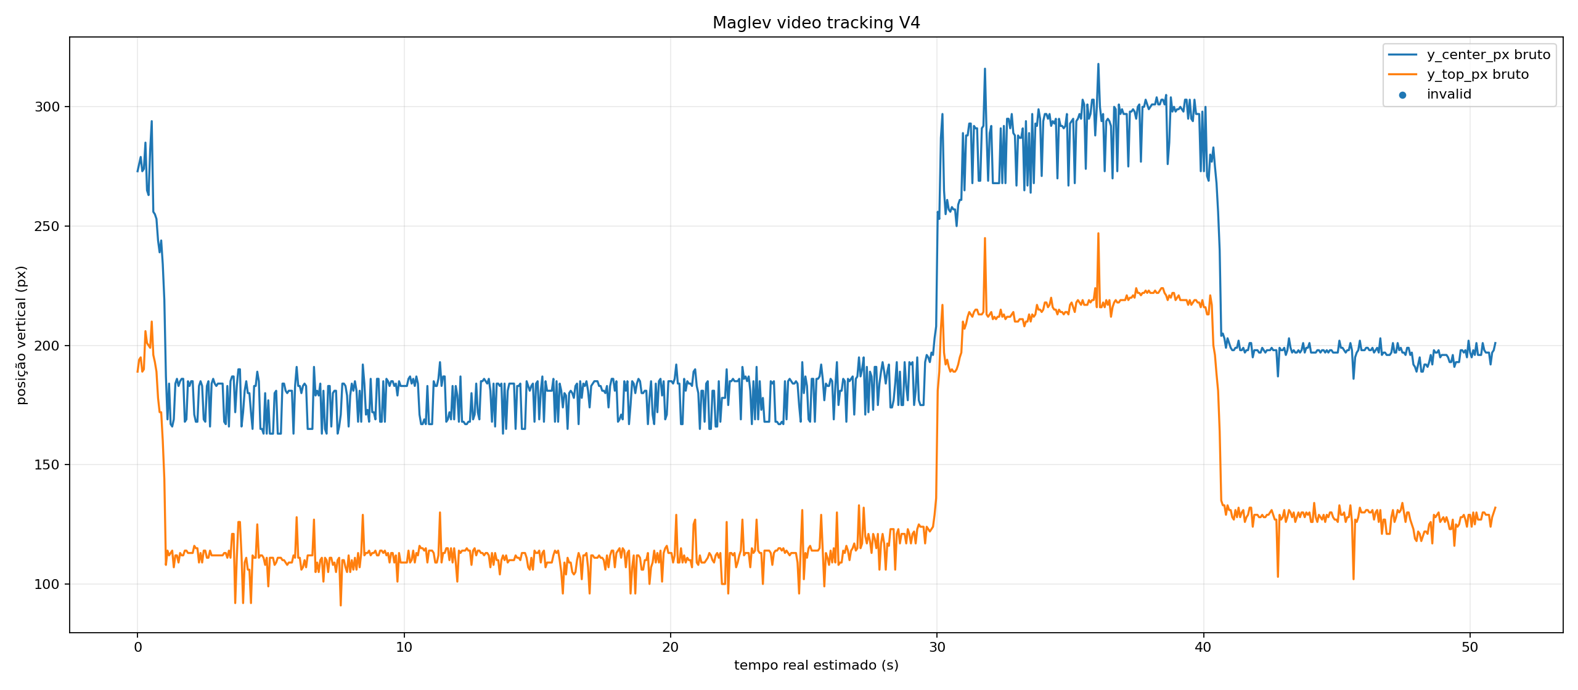
maglev/Bckp/ident_slow_mo/plot.png
