GabrielPaschoalin/PFC/maglev/Bckp/O_MELHOR_PULSO_1434/plot.png

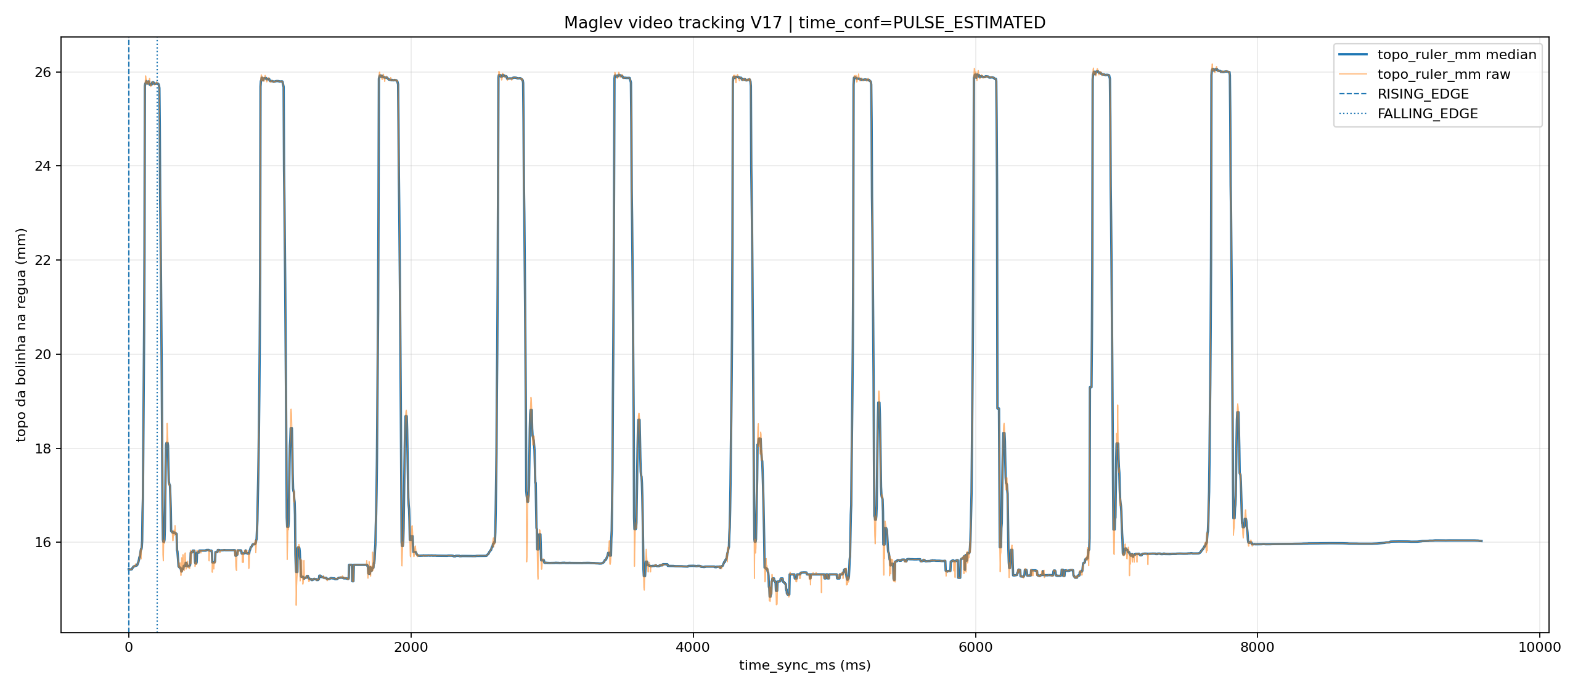
maglev/Bckp/O_MELHOR_PULSO_1434/plot.png
