GabrielPaschoalin/PFC/maglev/Bckp/O_MELHOR_PULSO_1434/preview.jpg

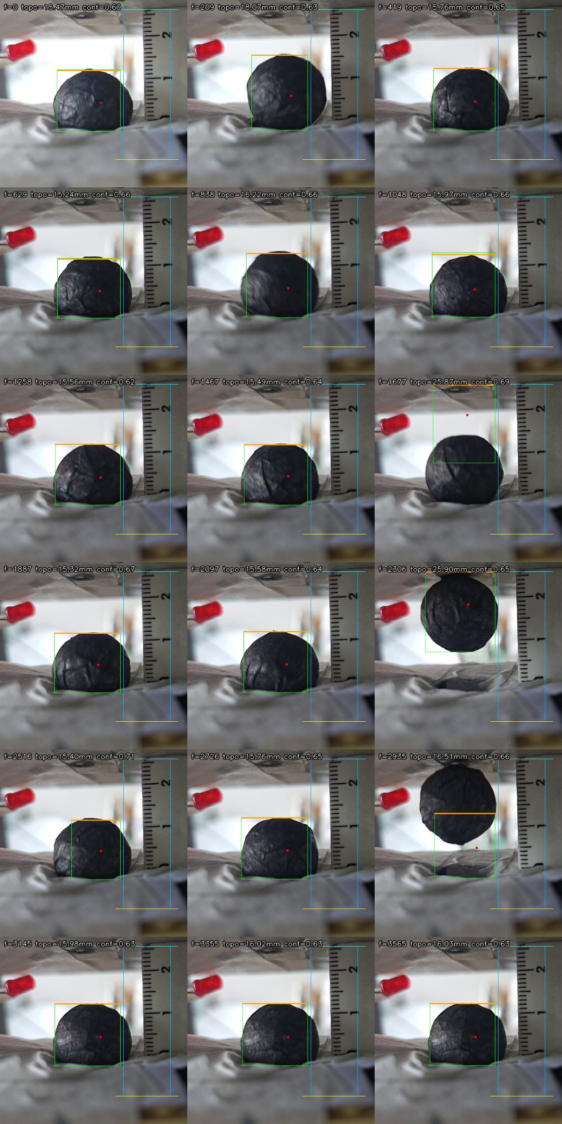
maglev/Bckp/O_MELHOR_PULSO_1434/preview.jpg
