GabrielPaschoalin/PFC/maglev/Bckp/O_MELHOR_PULSO_1434/ruler_preview.jpg

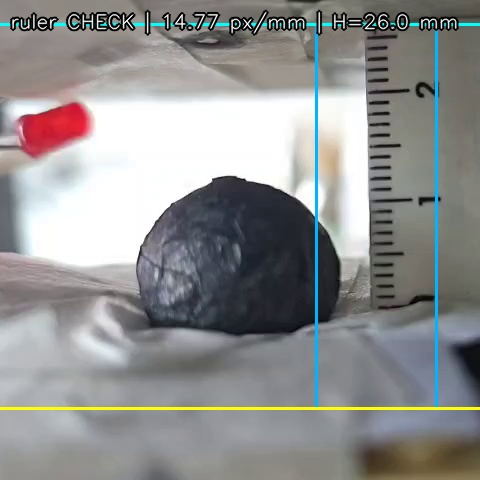
maglev/Bckp/O_MELHOR_PULSO_1434/ruler_preview.jpg
