GabrielPaschoalin/PFC/maglev/Bckp/O_MELHOR_PULSO_1434/sync_preview.jpg

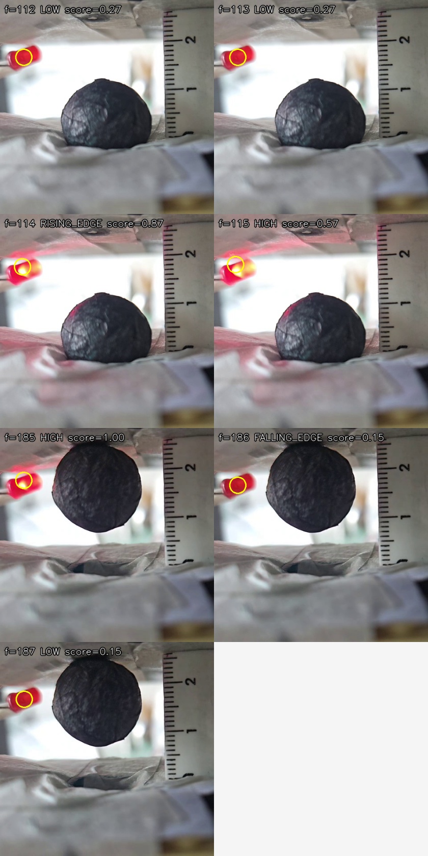
maglev/Bckp/O_MELHOR_PULSO_1434/sync_preview.jpg
