GabrielPaschoalin/PFC/maglev/Bckp/PULSO_00_28/plot.png

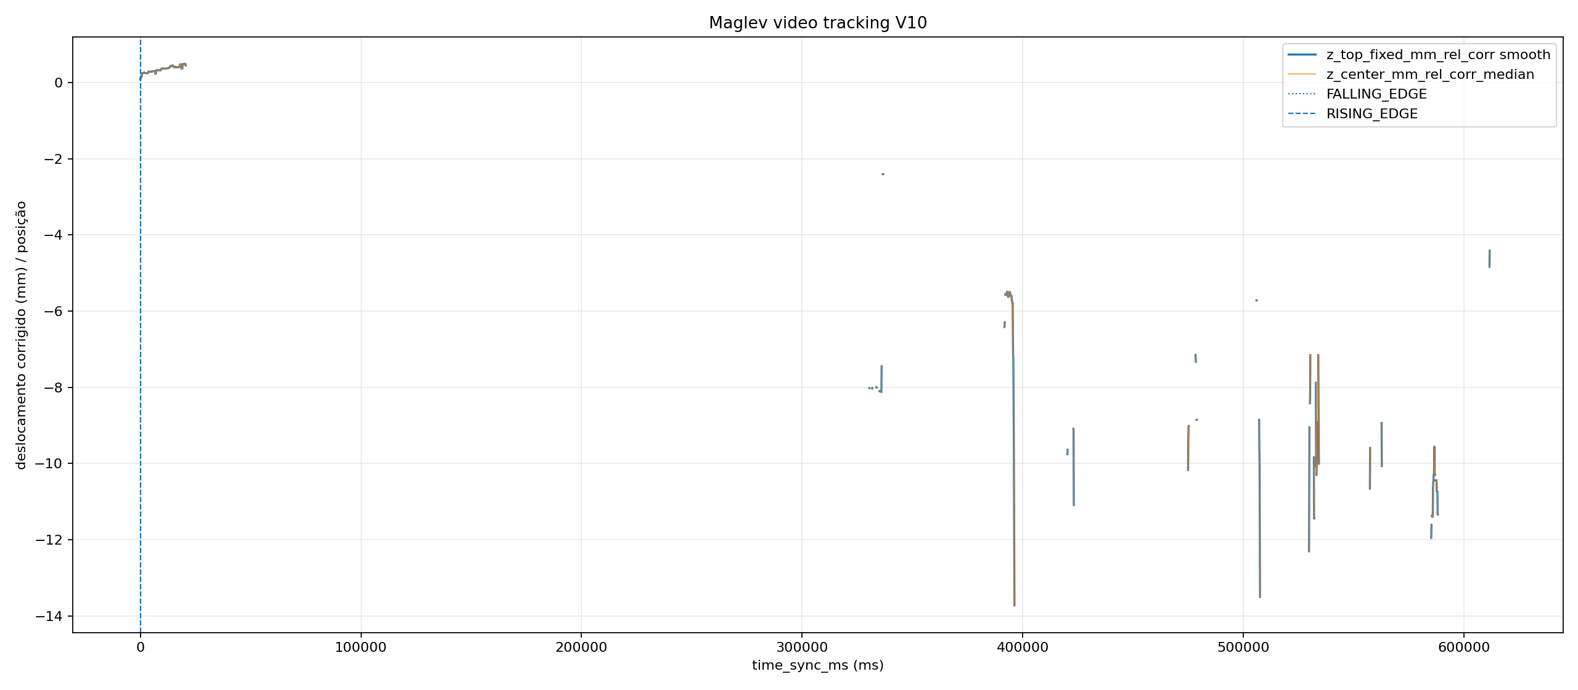
maglev/Bckp/PULSO_00_28/plot.png
