GabrielPaschoalin/PFC/maglev/Bckp/PULSO_00_28/preview.jpg

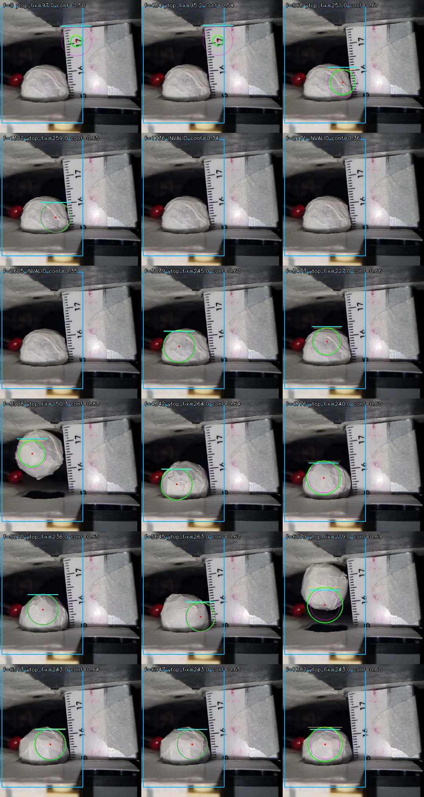
maglev/Bckp/PULSO_00_28/preview.jpg
