GabrielPaschoalin/PFC/maglev/Bckp/PULSO_00_28/ruler_preview.jpg

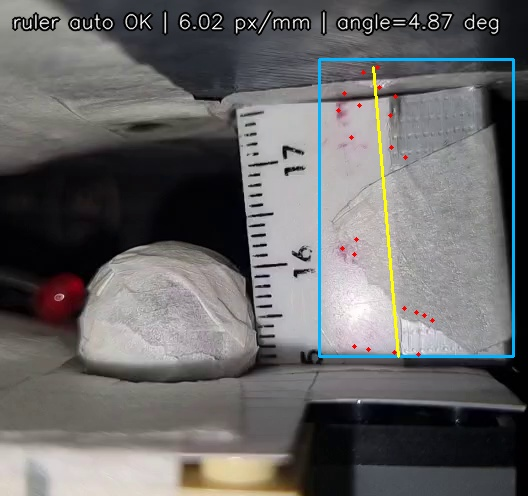
maglev/Bckp/PULSO_00_28/ruler_preview.jpg
