GabrielPaschoalin/PFC/maglev/Bckp/PULSO_00_28/sync_preview.jpg

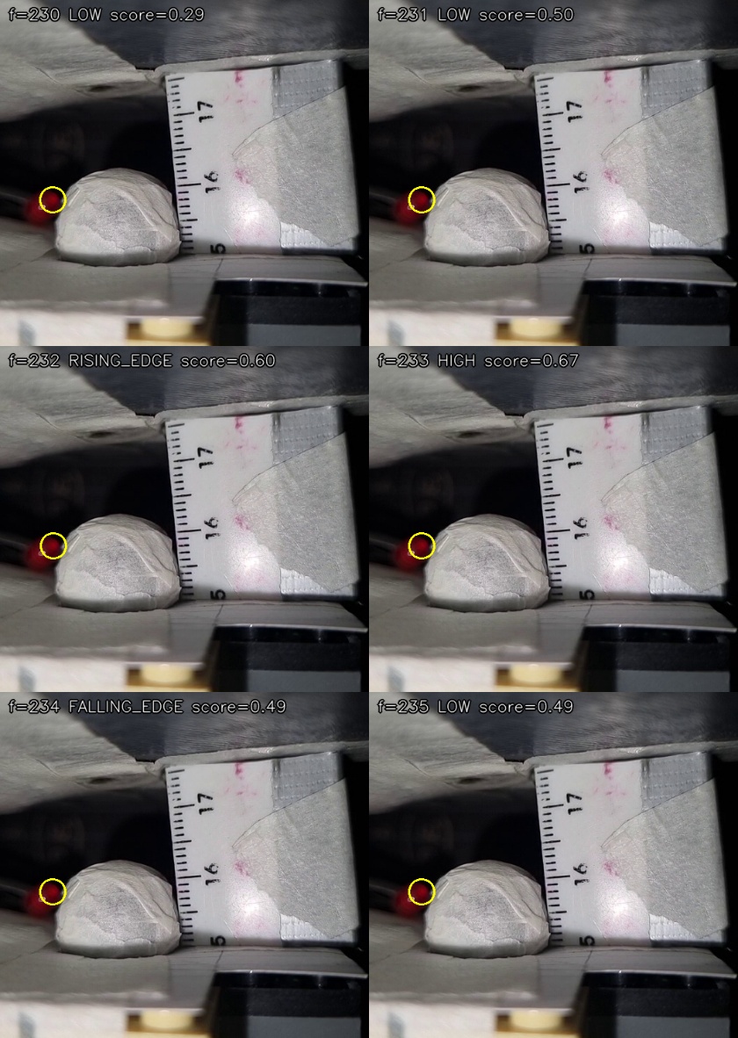
maglev/Bckp/PULSO_00_28/sync_preview.jpg
