GabrielPaschoalin/PFC/maglev/Bckp/PULSO_00_28_v12_preto/plot.png

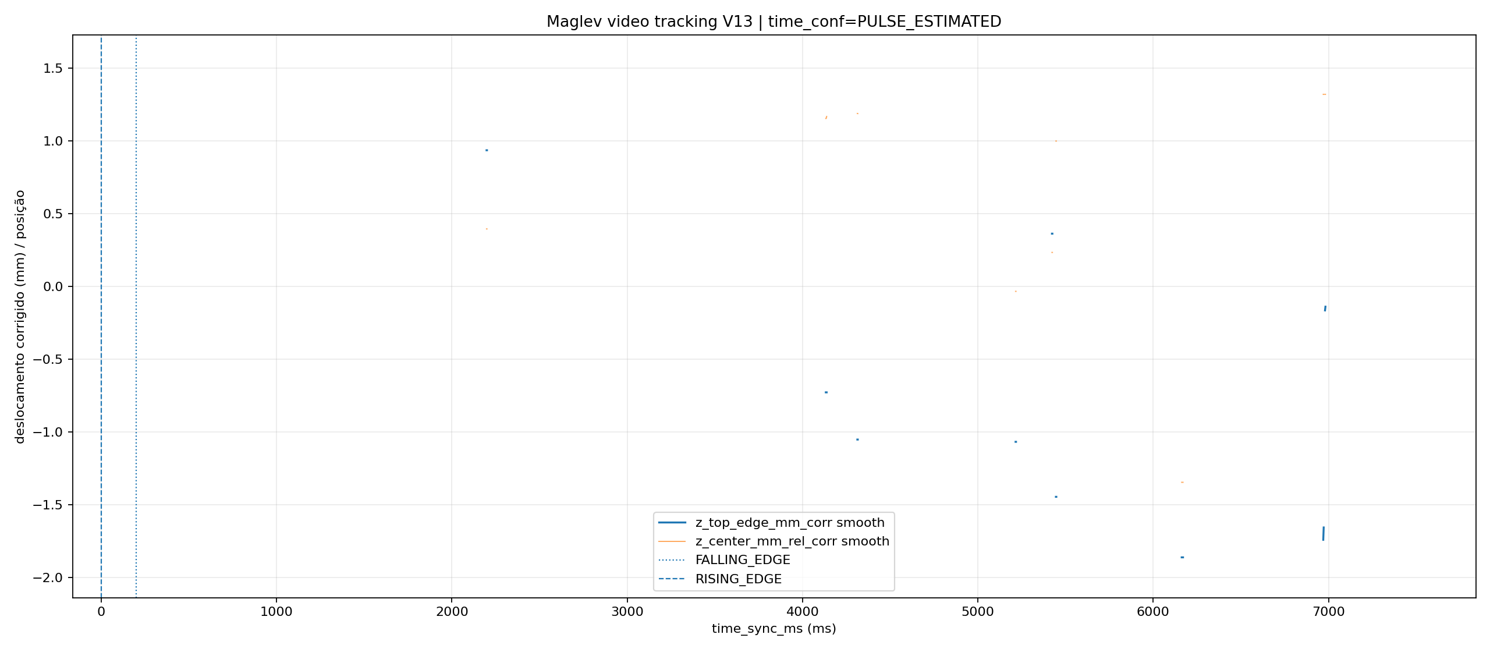
maglev/Bckp/PULSO_00_28_v12_preto/plot.png
