GabrielPaschoalin/PFC/maglev/Bckp/PULSO_IDENT_1220/plot.png

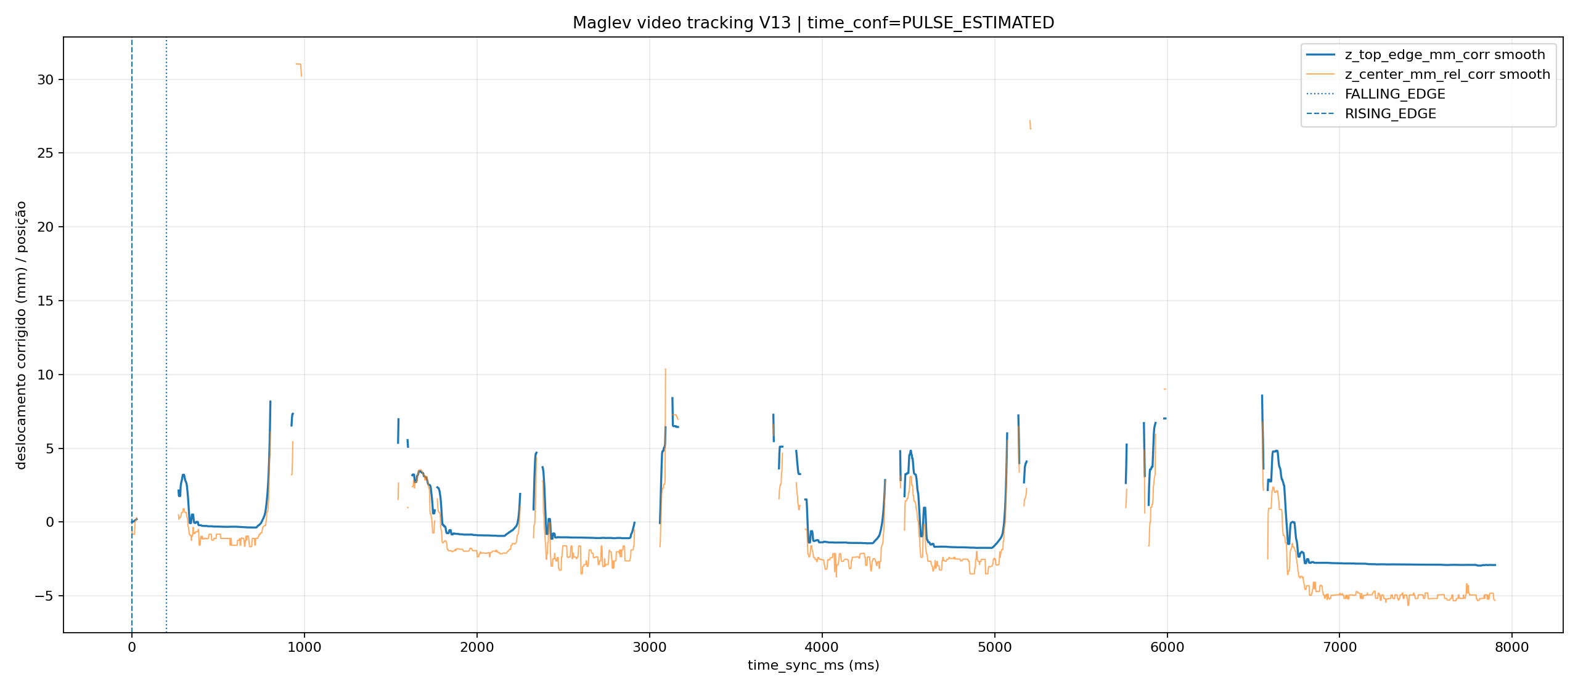
maglev/Bckp/PULSO_IDENT_1220/plot.png
