GabrielPaschoalin/PFC/maglev/Bckp/tracking/plot.png

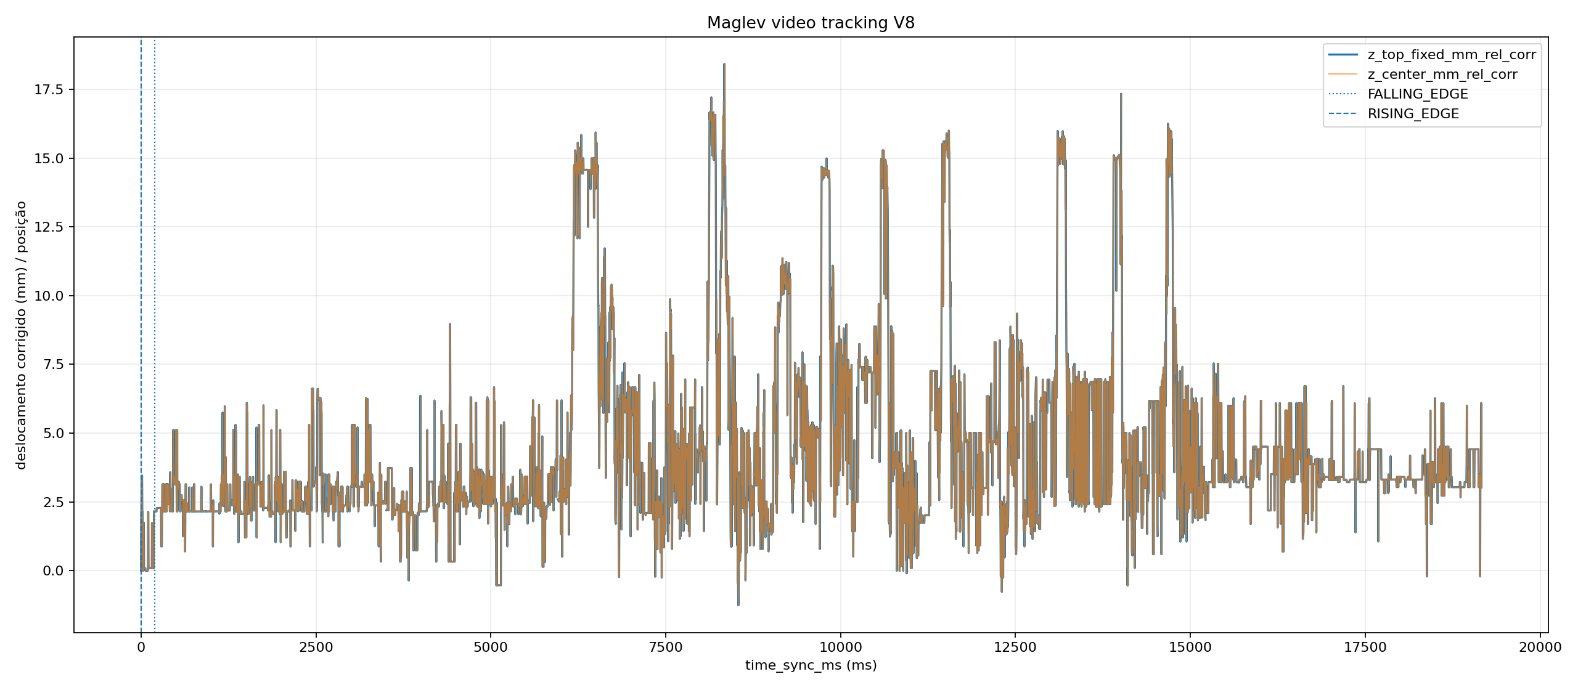
maglev/Bckp/tracking/plot.png
