GabrielPaschoalin/PFC/maglev/videos_ident/CameraOutputs/1608/plot.png

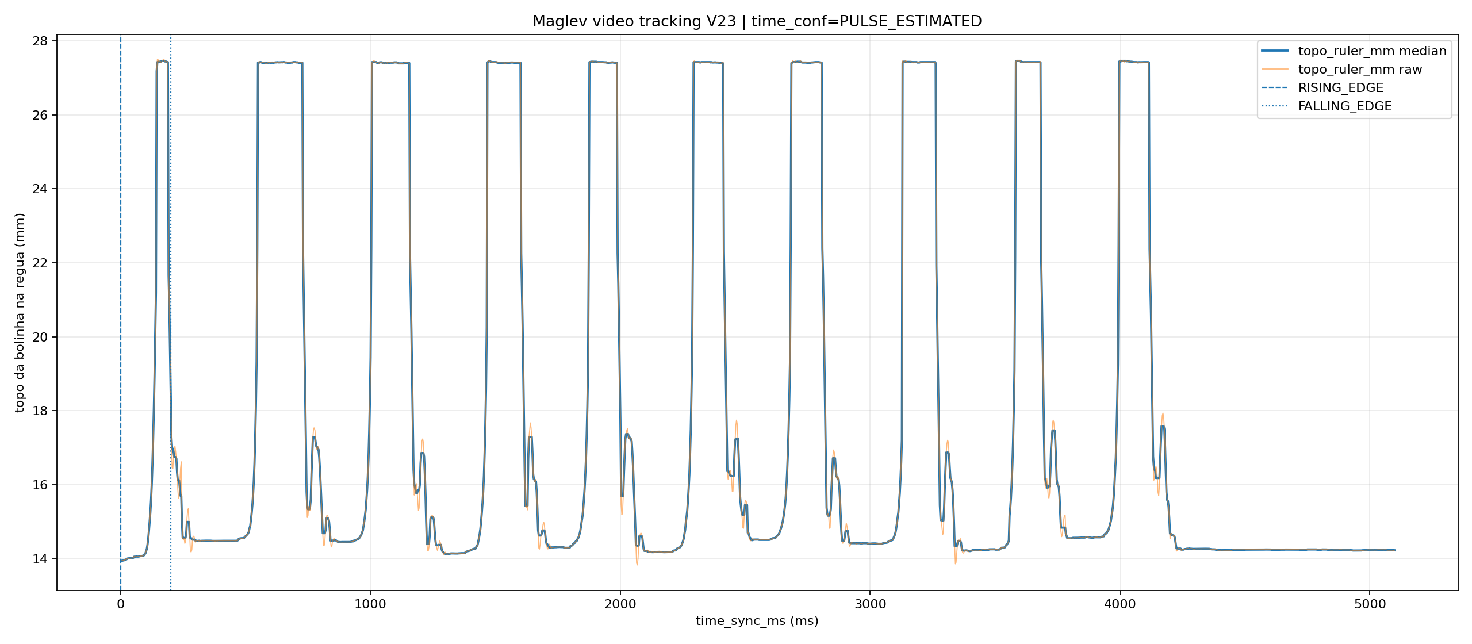
maglev/videos_ident/CameraOutputs/1608/plot.png
