GabrielPaschoalin/PFC/maglev/videos_ident/CameraOutputs/1610/plot.png

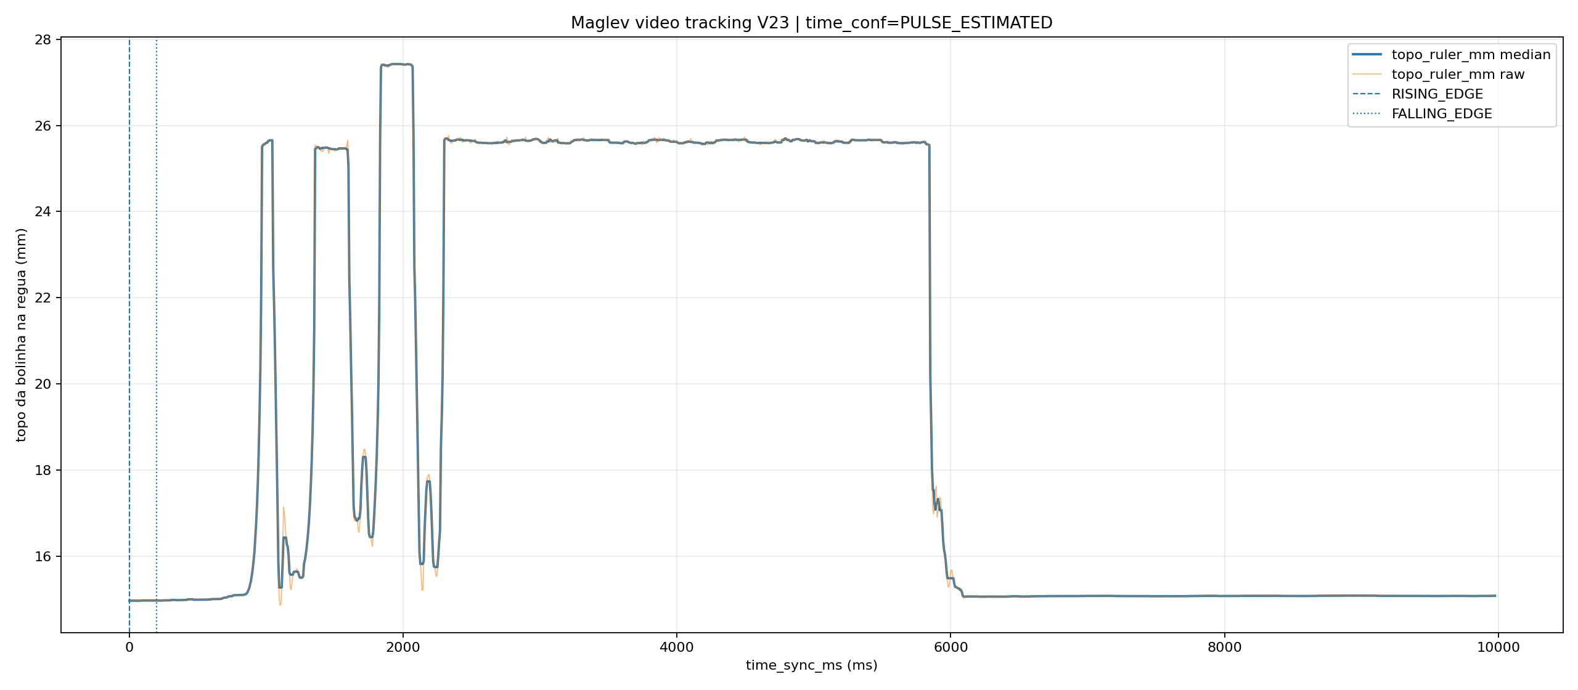
maglev/videos_ident/CameraOutputs/1610/plot.png
