GabrielPaschoalin/PFC/polos_zeros_malha_aberta.png

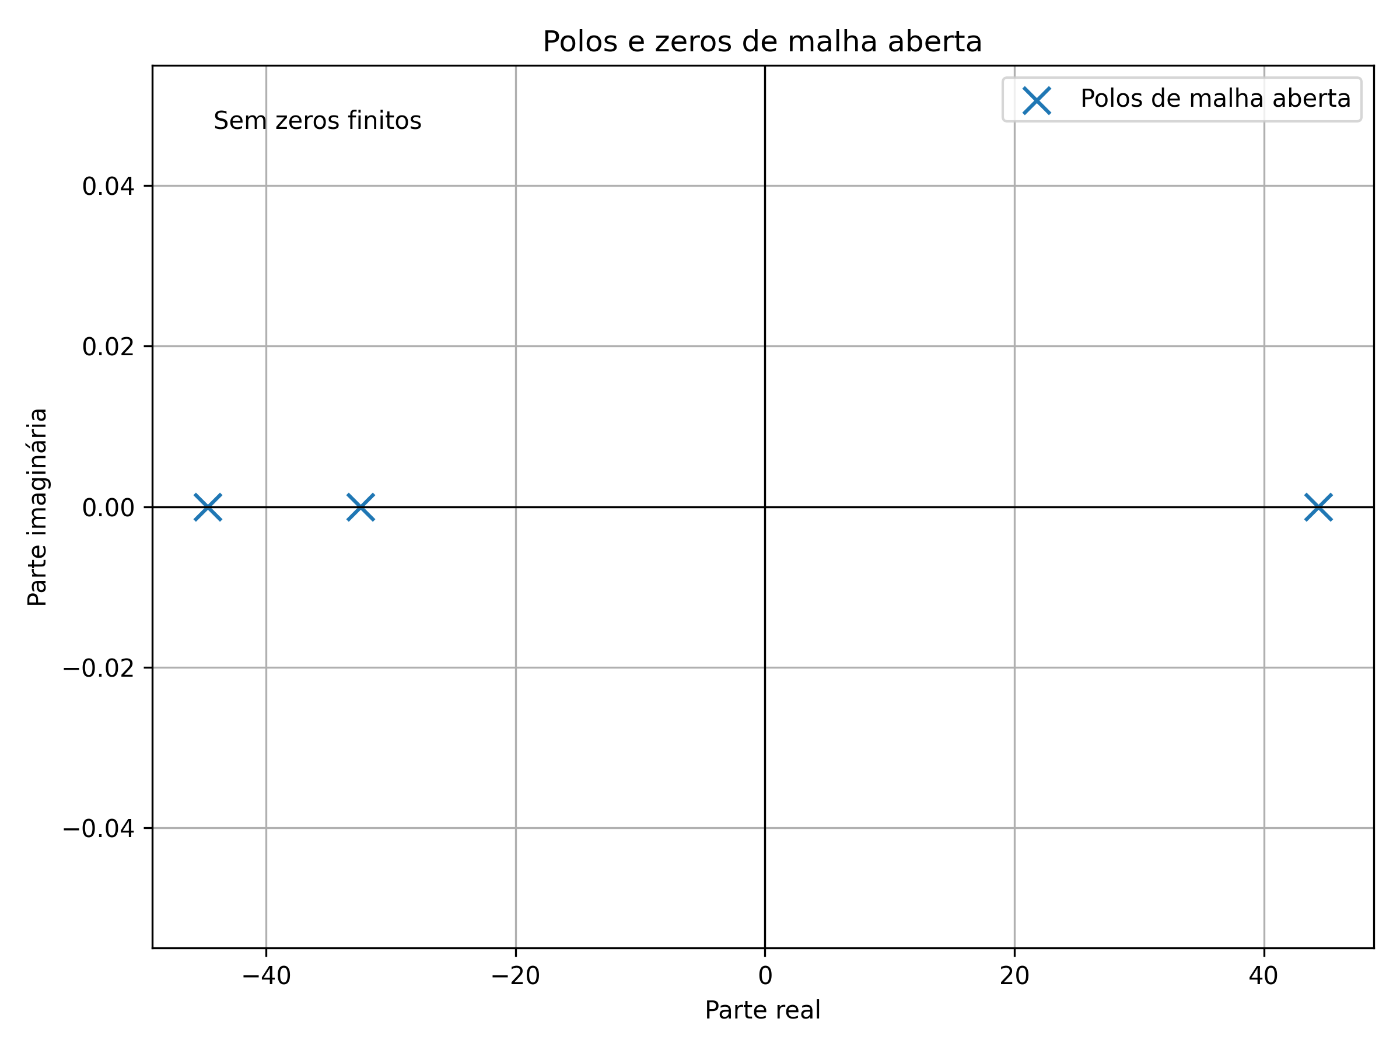
polos_zeros_malha_aberta.png
