GabrielPaschoalin/PFC/resposta_degrau_1mm_pid.png

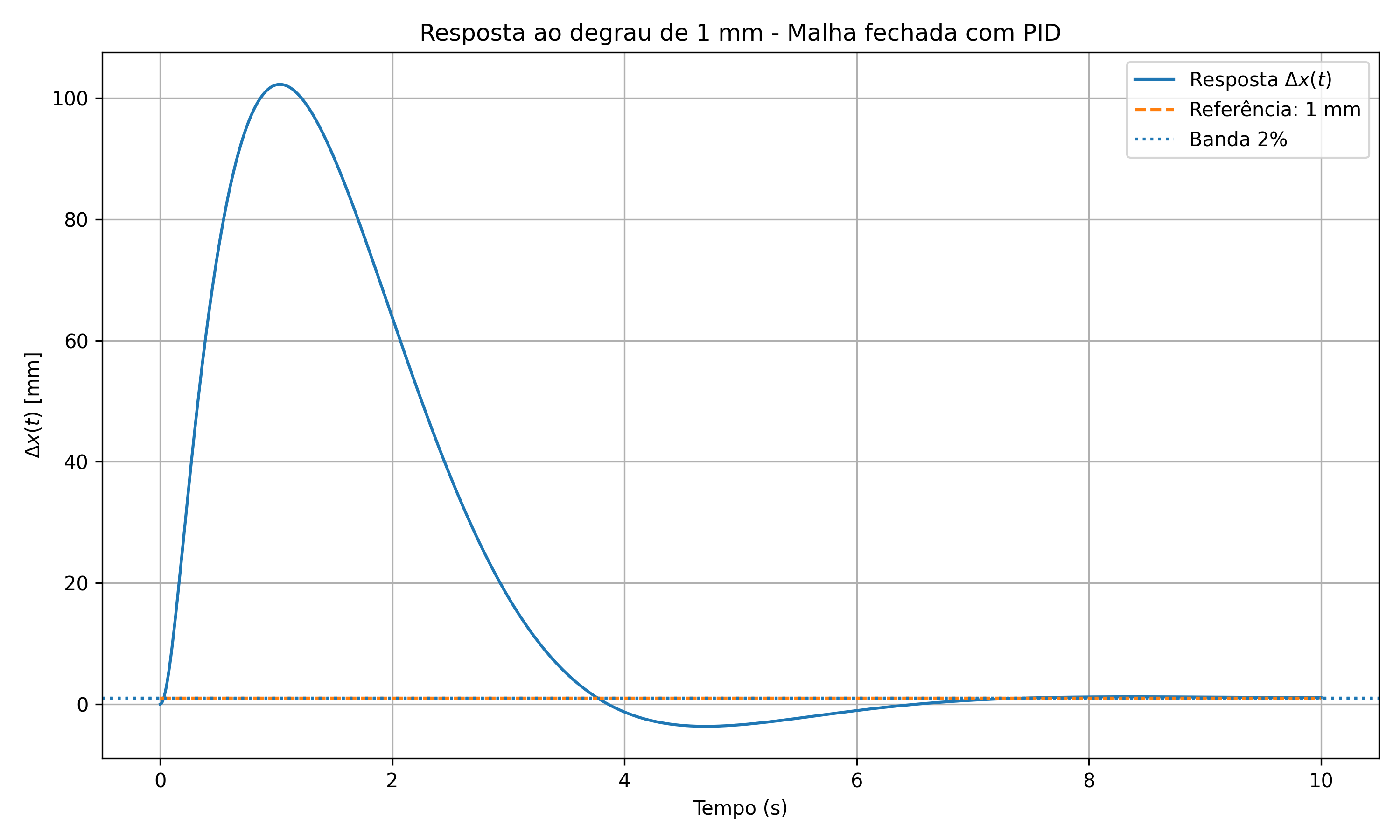
resposta_degrau_1mm_pid.png
