GabrielPaschoalin/PFC/TESE/Imagens/ENROLANDO BOBINA 2.jpeg

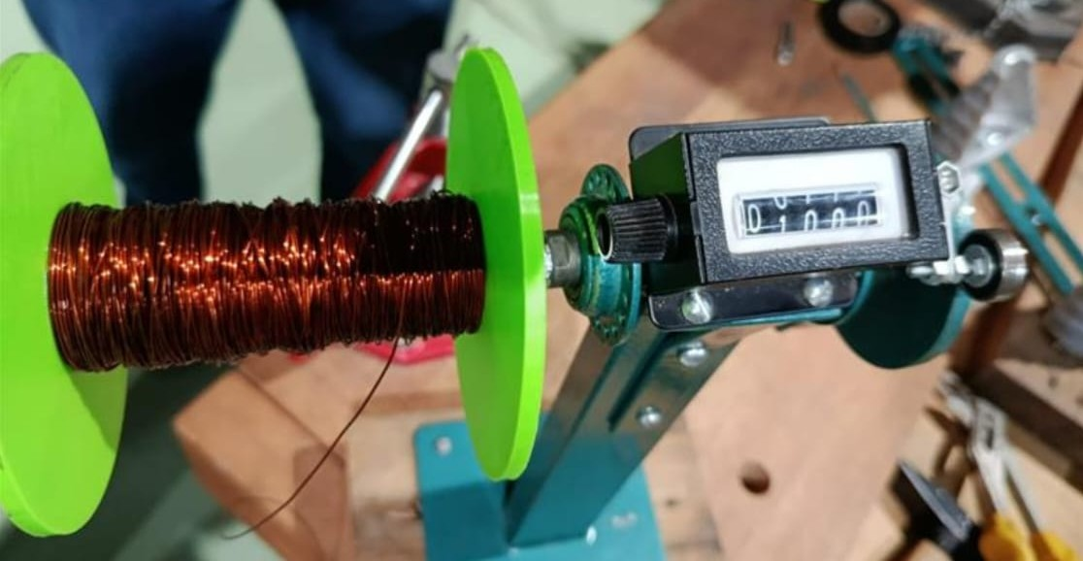
TESE/Imagens/ENROLANDO BOBINA 2.jpeg
