GabrielPaschoalin/PFC/TESE/Imagens/ENROLANDO BOBINA.jpeg

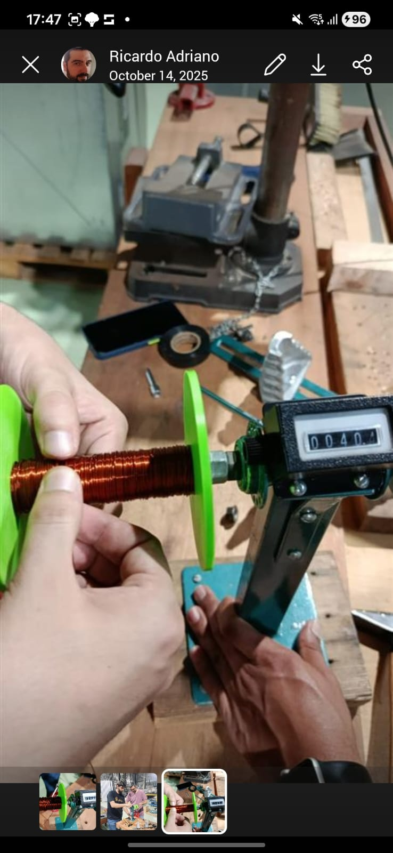
TESE/Imagens/ENROLANDO BOBINA.jpeg
