GabrielPaschoalin/PFC/TESE/Imagens/EU E RICARDO ENROLANDO BOBINA.jpeg

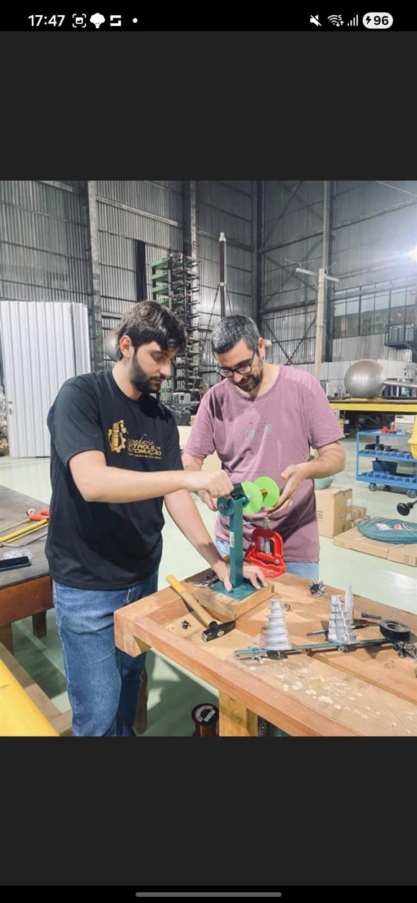
TESE/Imagens/EU E RICARDO ENROLANDO BOBINA.jpeg
