GabrielPaschoalin/PFC/TESE/Imagens/FEMM.jpeg

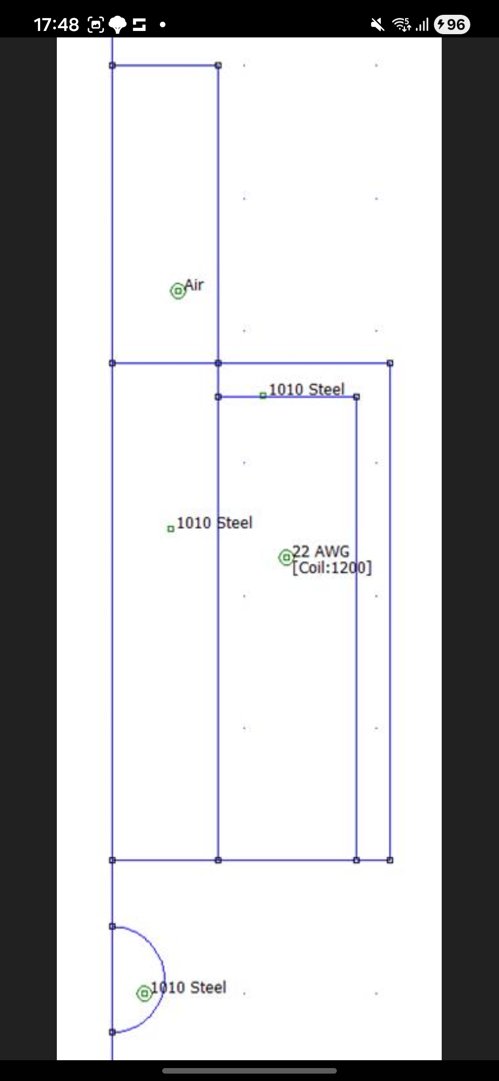
TESE/Imagens/FEMM.jpeg
