GabrielPaschoalin/PFC/TESE/Imagens/FIO COBRE.jpeg

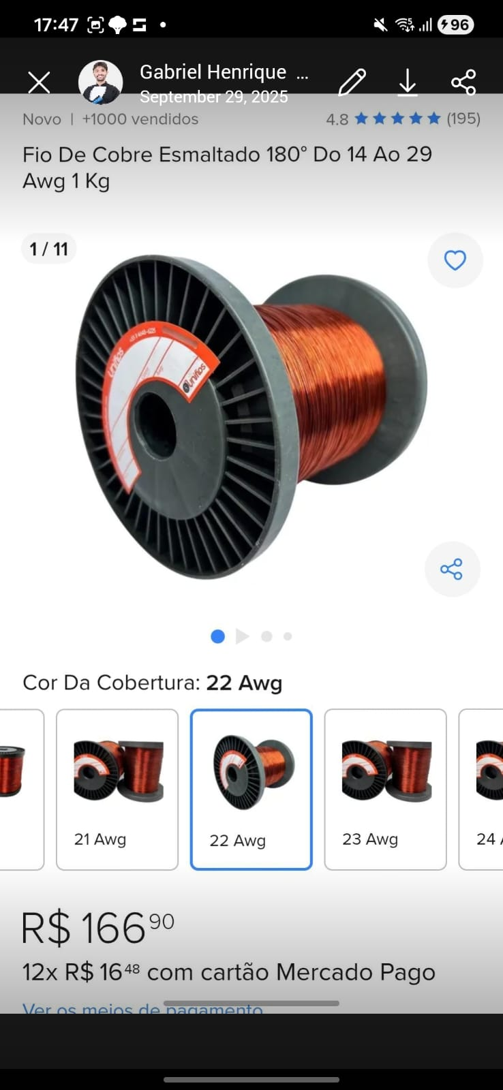
TESE/Imagens/FIO COBRE.jpeg
