GabrielPaschoalin/PFC/TESE/Matéria Ricardo/Figs/Aula04_alto-falante_3D.png

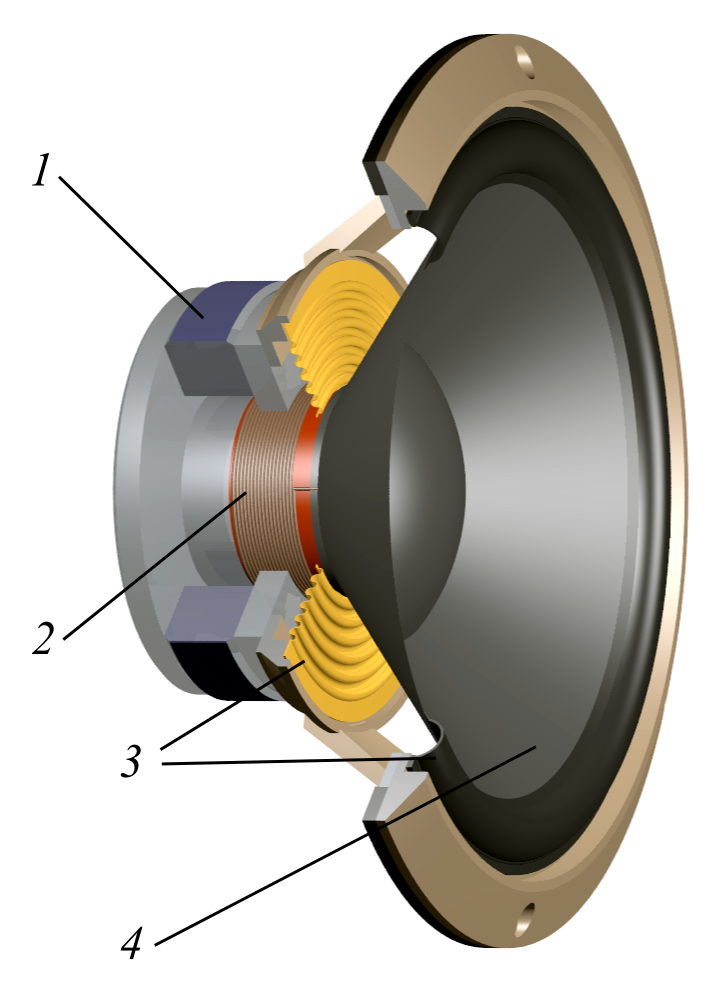
TESE/Matéria Ricardo/Figs/Aula04_alto-falante_3D.png
