GabrielPaschoalin/PFC/TESE/Matéria Ricardo/Figs/Aula04_alto-falante_partes.jpg

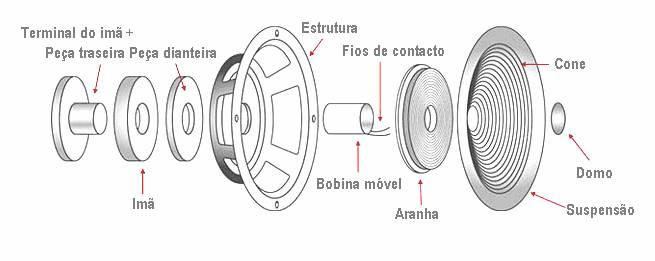
TESE/Matéria Ricardo/Figs/Aula04_alto-falante_partes.jpg
