GabrielPaschoalin/PFC/TESE/Matéria Ricardo/Figs/Aula07_curvaBl.png

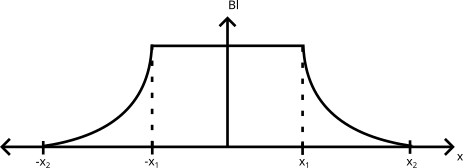
TESE/Matéria Ricardo/Figs/Aula07_curvaBl.png
