GabrielPaschoalin/PFC/TESE/Matéria Ricardo/Figs/Aula08_Capacitor.png

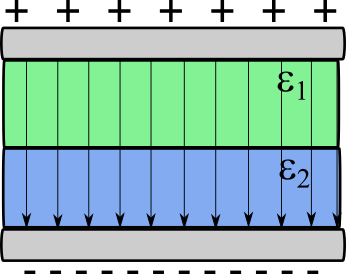
TESE/Matéria Ricardo/Figs/Aula08_Capacitor.png
