GabrielPaschoalin/PFC/TESE/Matéria Ricardo/Figs/Aula08_CSR.png

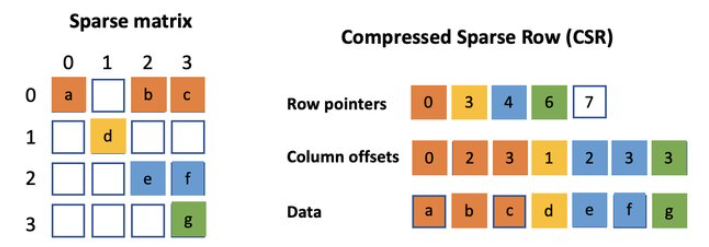
TESE/Matéria Ricardo/Figs/Aula08_CSR.png
