GabrielPaschoalin/PFC/TESE/Matéria Ricardo/Figs/Aula08_Greenfunc.png

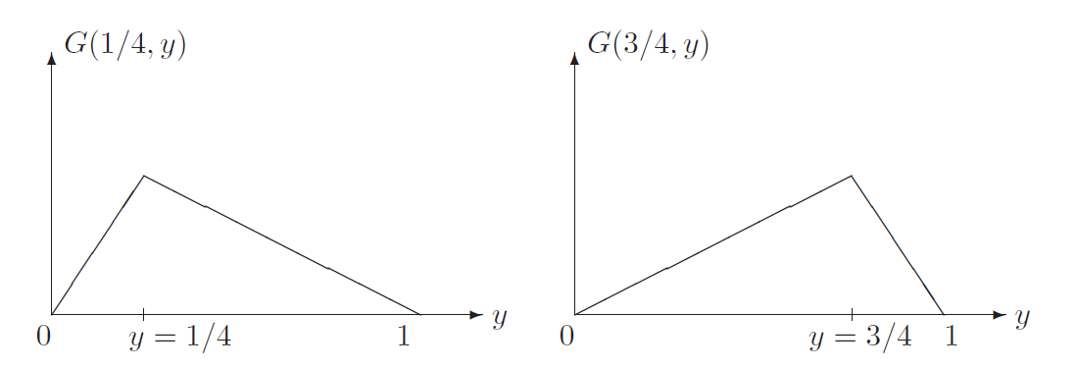
TESE/Matéria Ricardo/Figs/Aula08_Greenfunc.png
