GabrielPaschoalin/PFC/TESE/Matéria Ricardo/Figs/Aula13_BobinaFEMM.png

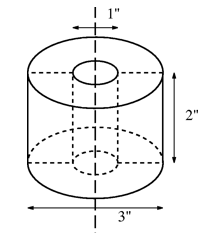
TESE/Matéria Ricardo/Figs/Aula13_BobinaFEMM.png
