GabrielPaschoalin/PFC/TESE/Matéria Ricardo/Figs/Aula16_eletroima.png

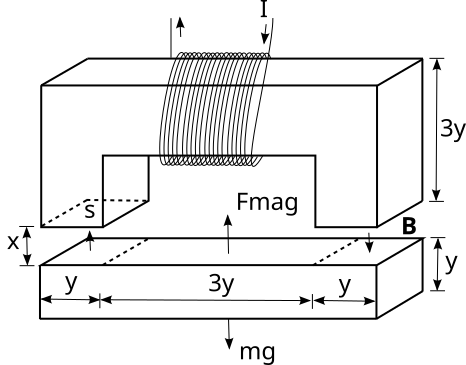
TESE/Matéria Ricardo/Figs/Aula16_eletroima.png
