GabrielPaschoalin/PFC/TESE/Matéria Ricardo/Figs/Aula16_levitadorGeoAxiss.png

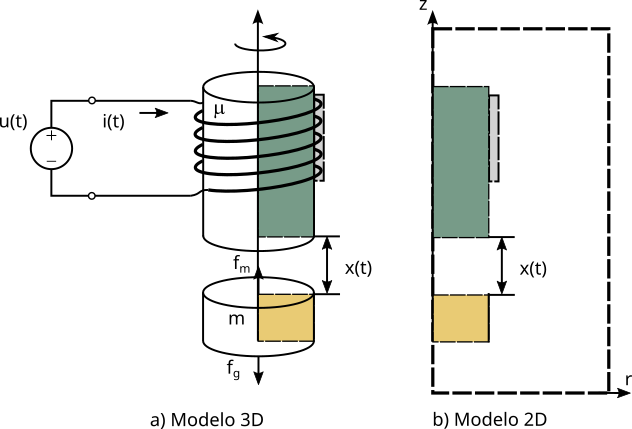
TESE/Matéria Ricardo/Figs/Aula16_levitadorGeoAxiss.png
