GabrielPaschoalin/PFC/TESE/Matéria Ricardo/Figs/Halfwave_geo.png

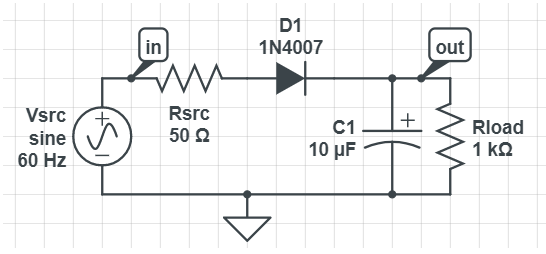
TESE/Matéria Ricardo/Figs/Halfwave_geo.png
