GabrielPaschoalin/PFC/TESE/Matéria Ricardo/Figs/LevitadorCirc.png

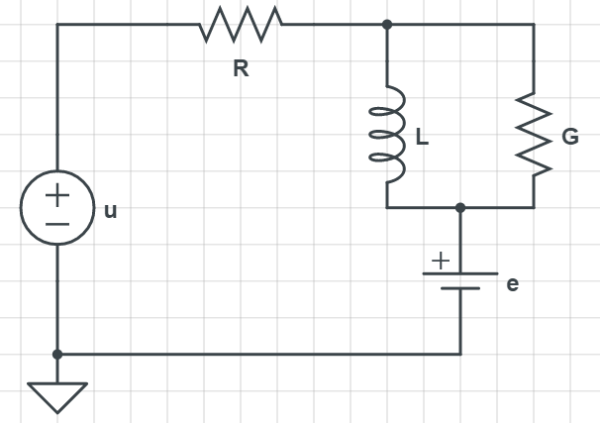
TESE/Matéria Ricardo/Figs/LevitadorCirc.png
