GabrielPaschoalin/PFC/TESE/Matéria Ricardo/Figs/LevitadorGeo.png

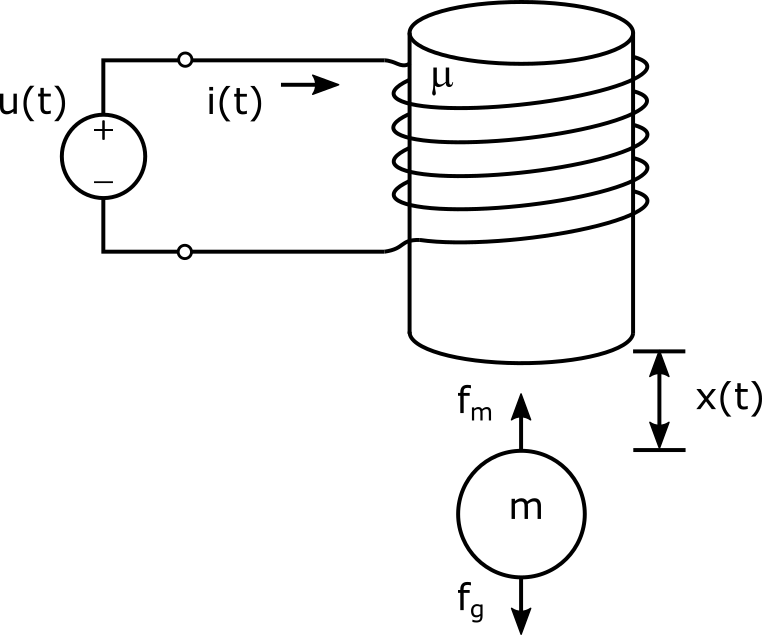
TESE/Matéria Ricardo/Figs/LevitadorGeo.png
