GabrielPaschoalin/PFC/TESE/Matéria Ricardo/Figs/LevitadorReal.png

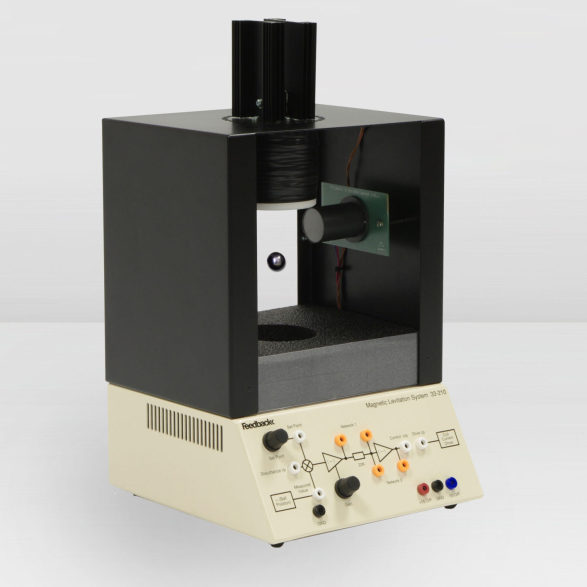
TESE/Matéria Ricardo/Figs/LevitadorReal.png
