GabrielPaschoalin/PFC/TESE/Matéria Ricardo/Figs/Navier-stokes_GEO-2d.png

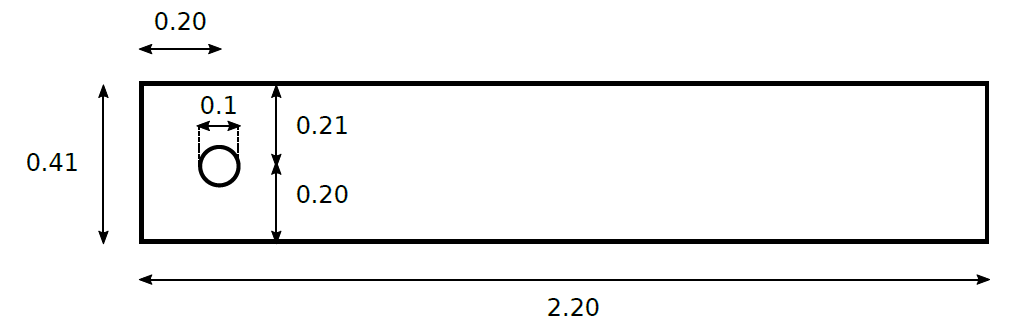
TESE/Matéria Ricardo/Figs/Navier-stokes_GEO-2d.png
