GabrielPaschoalin/PFC/TESE/Matéria Ricardo/Figs/pendulo_geo.jpeg

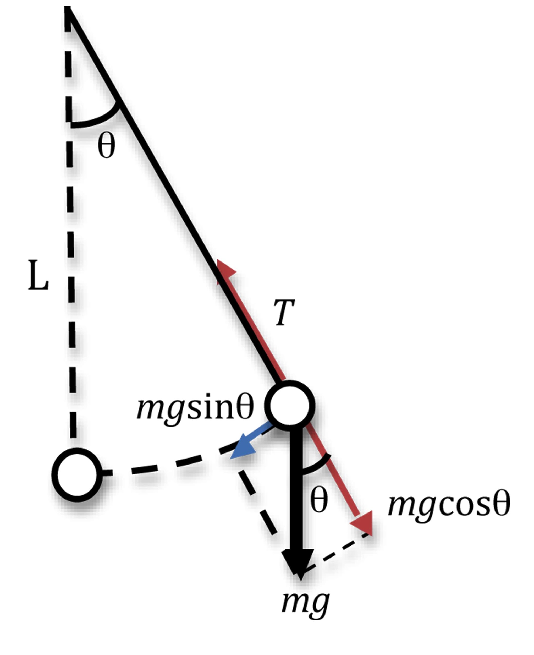
TESE/Matéria Ricardo/Figs/pendulo_geo.jpeg
