GabrielPaschoalin/PFC/TESE/Matéria Ricardo/Figs/RLC_geo.png

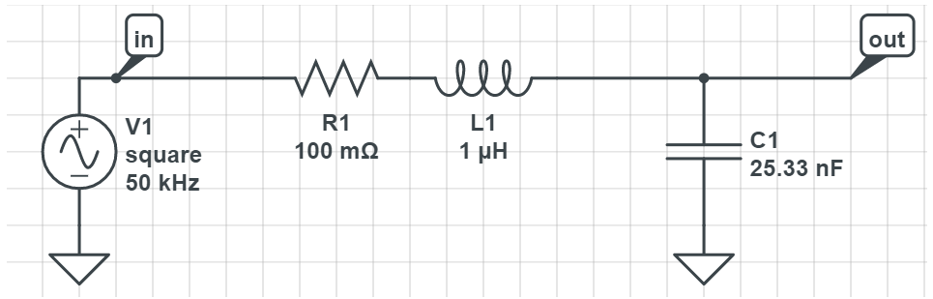
TESE/Matéria Ricardo/Figs/RLC_geo.png
