GabrielPaschoalin/PFC/TESE/Referência/grafico-bobina.png

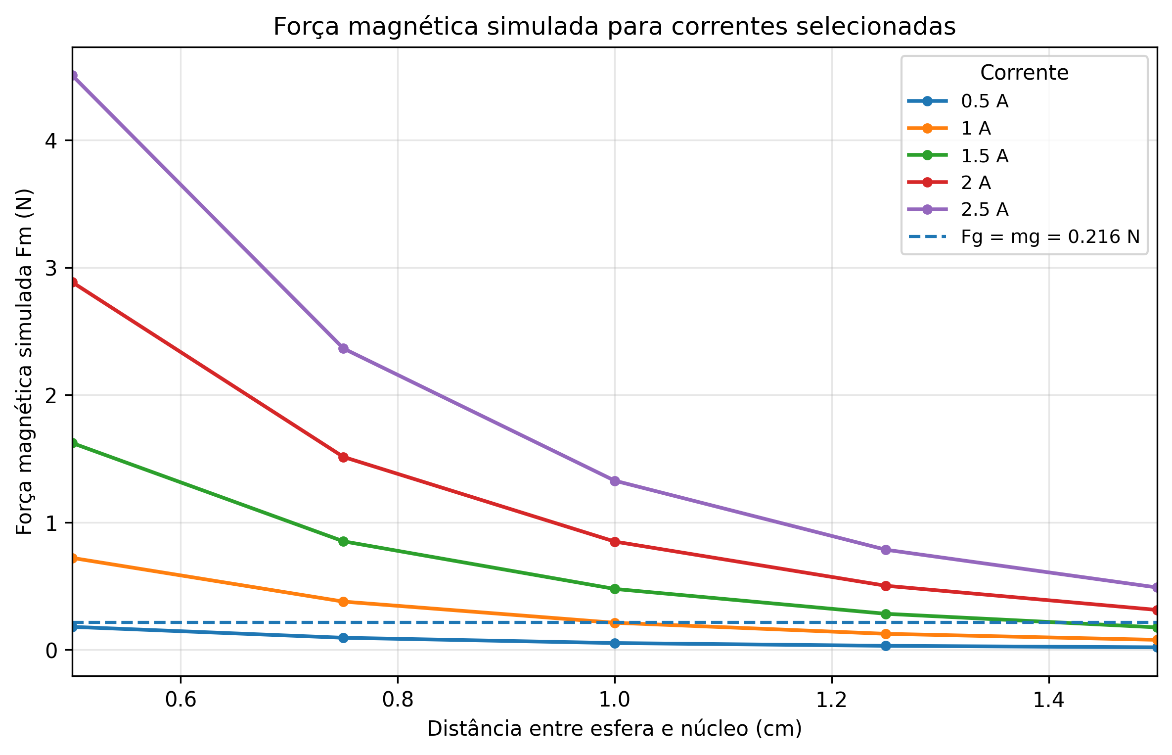
TESE/Referência/grafico-bobina.png
