GabrielPaschoalin/PFC/Self-Balancing-Bike/3D printing/Extra/front_wheel_axle.stl

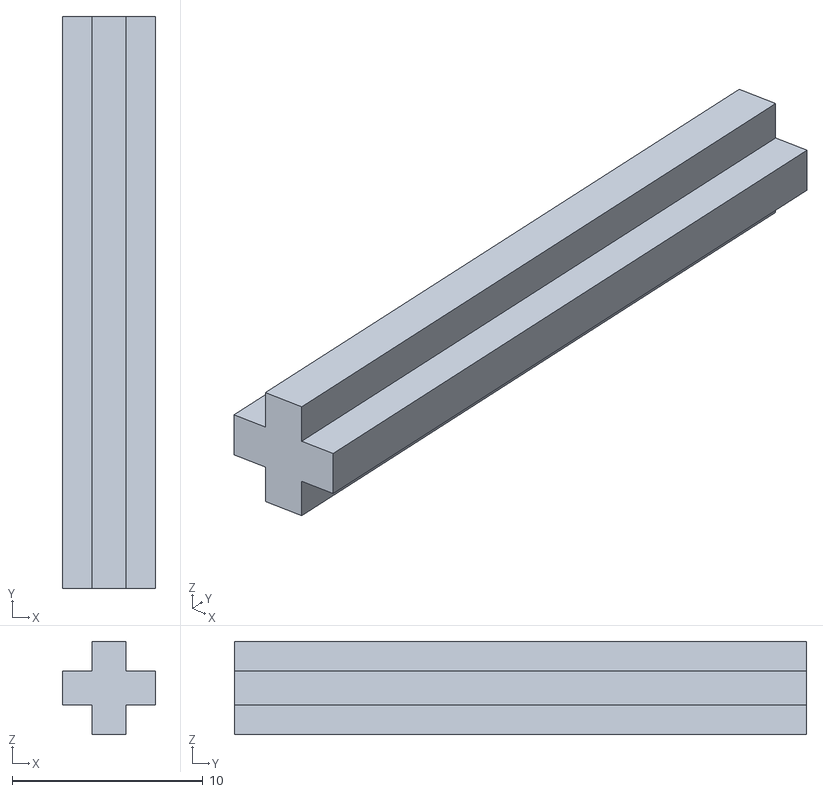
[picture p155: CAD file, 2026-04-25]
Self-Balancing-Bike/3D printing/Extra/front_wheel_axle.stl
4.90 x 30.0 x 4.90
