GabrielPaschoalin/PFC/Self-Balancing-Bike/3D printing/right_body.stl

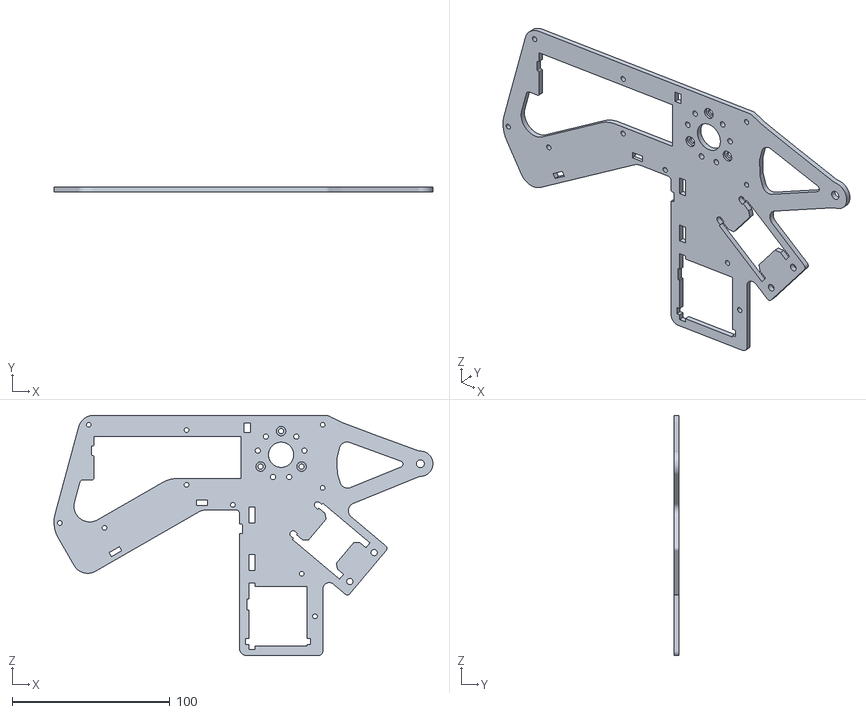
[picture p156: CAD file, 2026-04-25]
Self-Balancing-Bike/3D printing/right_body.stl
240.4 x 3.00 x 152.5
