GabrielPaschoalin/PFC/Self-Balancing-Bike/3D printing/Extra/rear_wheel_axle.stl

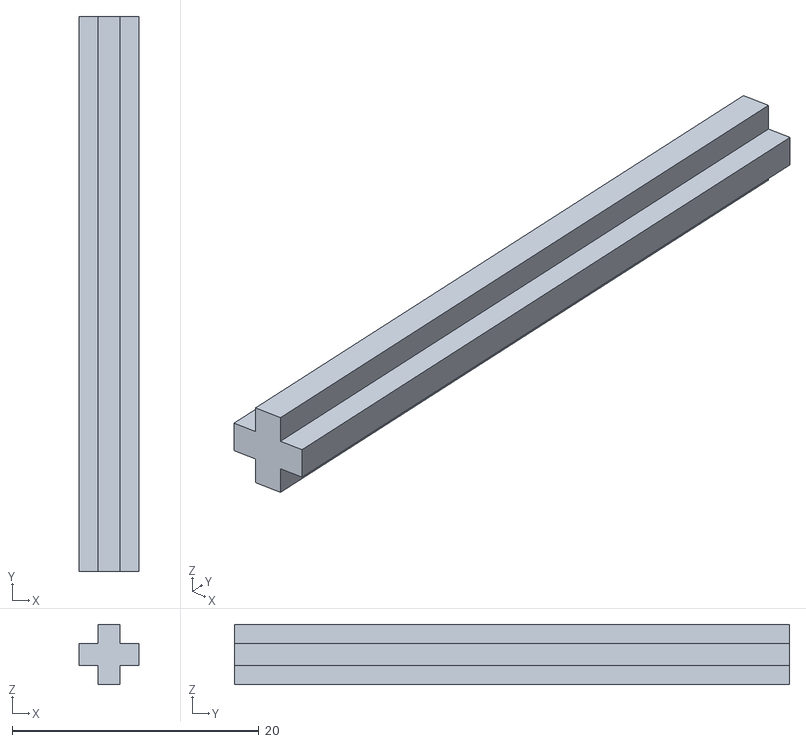
[picture p157: CAD file, 2026-04-25]
Self-Balancing-Bike/3D printing/Extra/rear_wheel_axle.stl
4.90 x 45.0 x 4.90
