GabrielPaschoalin/PFC/Self-Balancing-Bike/3D printing/wheel_spacer.stl

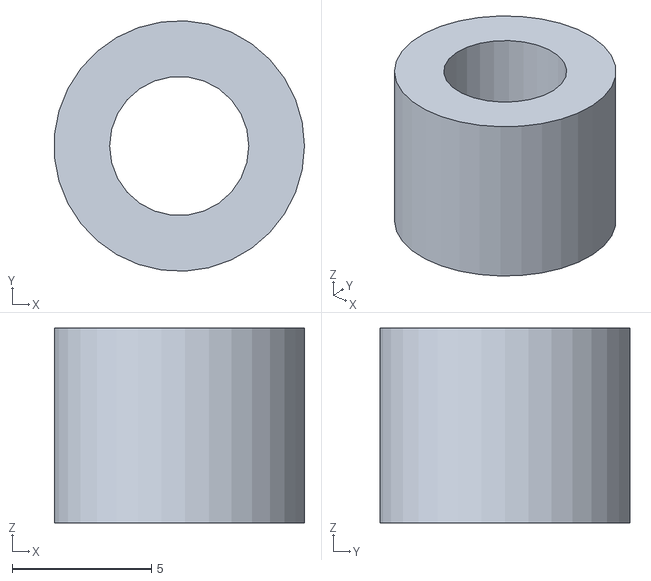
[picture p158: CAD file, 2026-04-25]
Self-Balancing-Bike/3D printing/wheel_spacer.stl
8.98 x 8.99 x 7.00
