GabrielPaschoalin/PFC/Self-Balancing-Bike/3D printing/Extra/tire.stl

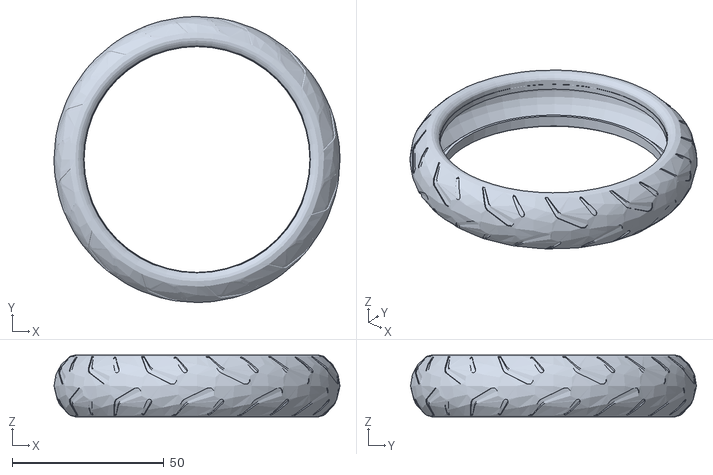
[picture p159: CAD file, 2026-04-25]
Self-Balancing-Bike/3D printing/Extra/tire.stl
94.3 x 94.3 x 20.4
