GabrielPaschoalin/PFC/Self-Balancing-Bike/3D printing/IMU_holder.stl

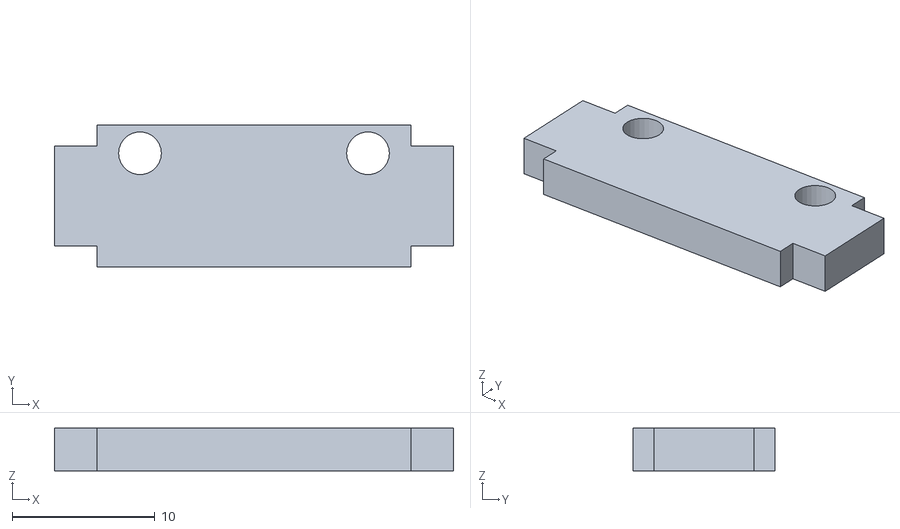
[picture p160: CAD file, 2026-04-25]
Self-Balancing-Bike/3D printing/IMU_holder.stl
28.0 x 10.00 x 3.00
