GabrielPaschoalin/PFC/Self-Balancing-Bike/3D printing/Extra/wheel.stl

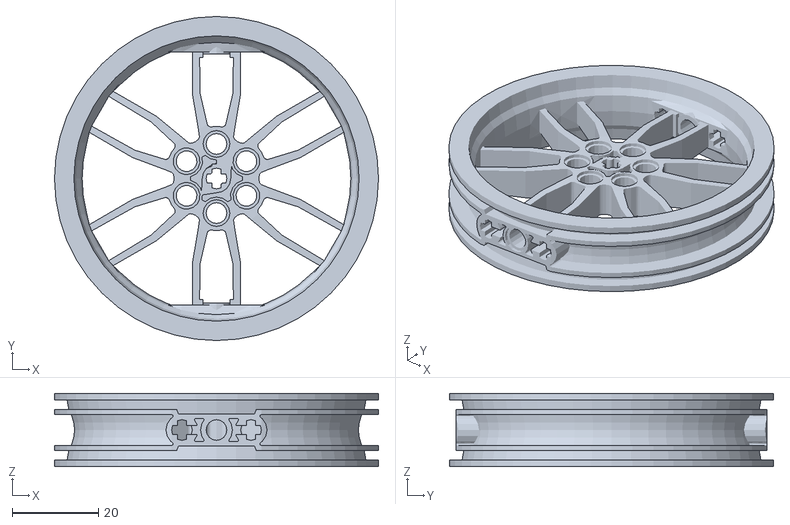
[picture p161: CAD file, 2026-04-25]
Self-Balancing-Bike/3D printing/Extra/wheel.stl
75.0 x 75.0 x 17.0
