GabrielPaschoalin/PFC/Self-Balancing-Bike/3D printing/servo_top.stl

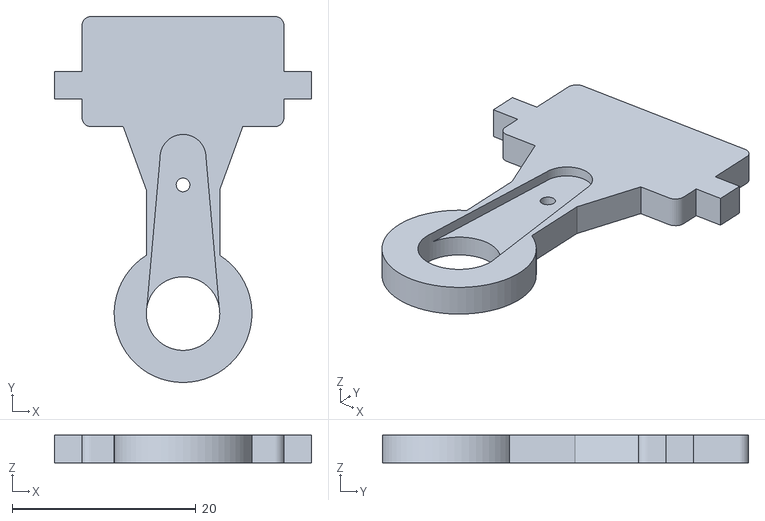
[picture p162: CAD file, 2026-04-25]
Self-Balancing-Bike/3D printing/servo_top.stl
28.0 x 39.8 x 3.00
