GabrielPaschoalin/PFC/Self-Balancing-Bike/3D printing/flywheel.stl

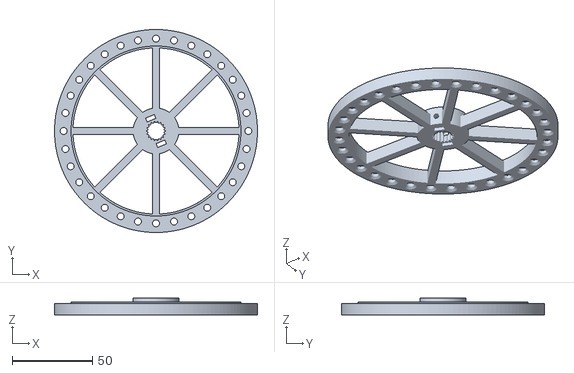
[picture p163: CAD file, 2026-04-25]
Self-Balancing-Bike/3D printing/flywheel.stl
126.4 x 126.4 x 10.5
