GabrielPaschoalin/PFC/Self-Balancing-Bike/3D printing/servo_front.stl

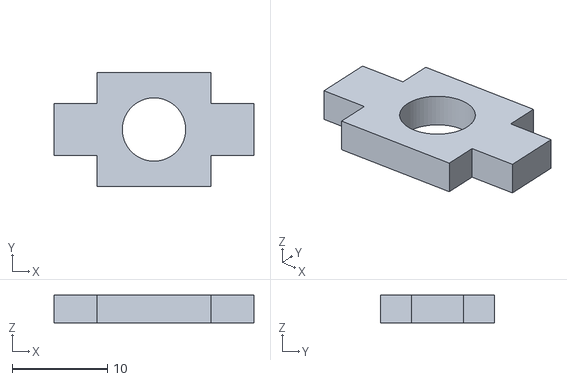
[picture p164: CAD file, 2026-04-25]
Self-Balancing-Bike/3D printing/servo_front.stl
21.0 x 12.0 x 2.90
