GabrielPaschoalin/PFC/Self-Balancing-Bike/3D printing/support.stl

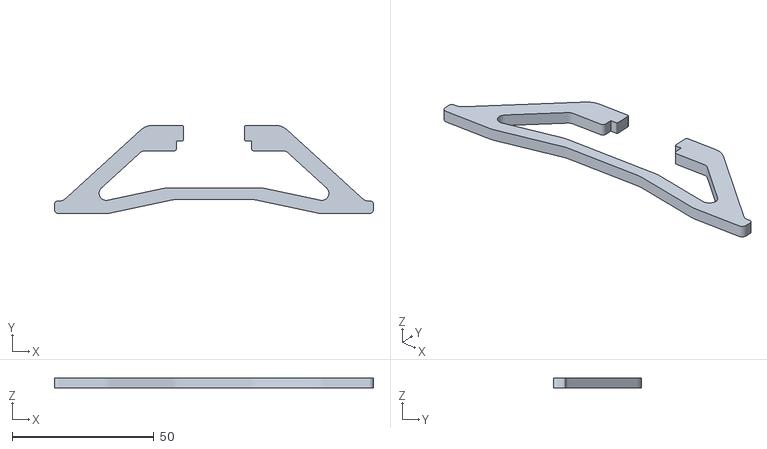
[picture p165: CAD file, 2026-04-25]
Self-Balancing-Bike/3D printing/support.stl
112.7 x 31.2 x 3.60
