GabrielPaschoalin/PFC/Self-Balancing-Bike/3D printing/servo_bottom.stl

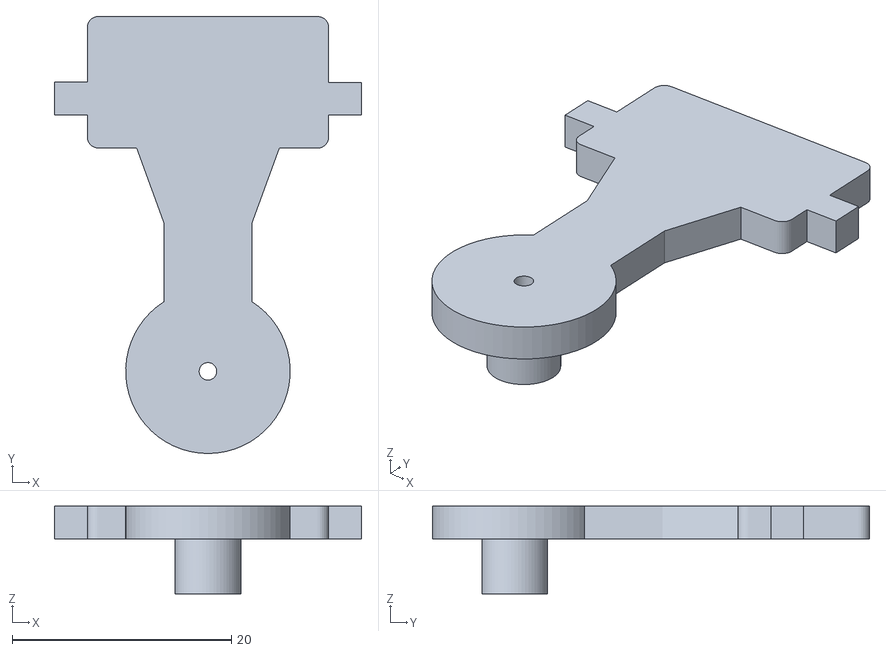
[picture p166: CAD file, 2026-04-25]
Self-Balancing-Bike/3D printing/servo_bottom.stl
28.0 x 39.8 x 8.00
