GabrielPaschoalin/PFC/Self-Balancing-Bike/3D printing/servo_side.stl

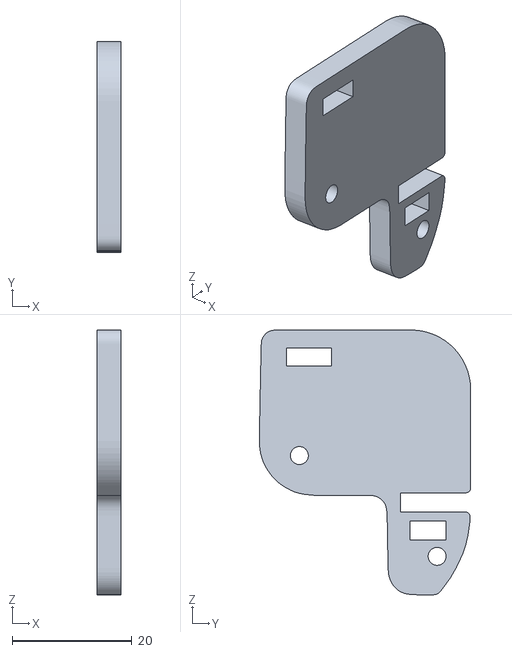
[picture p167: CAD file, 2026-04-25]
Self-Balancing-Bike/3D printing/servo_side.stl
4.00 x 35.4 x 44.3
