GabrielPaschoalin/PFC/Self-Balancing-Bike/3D printing/gear_spacer.stl

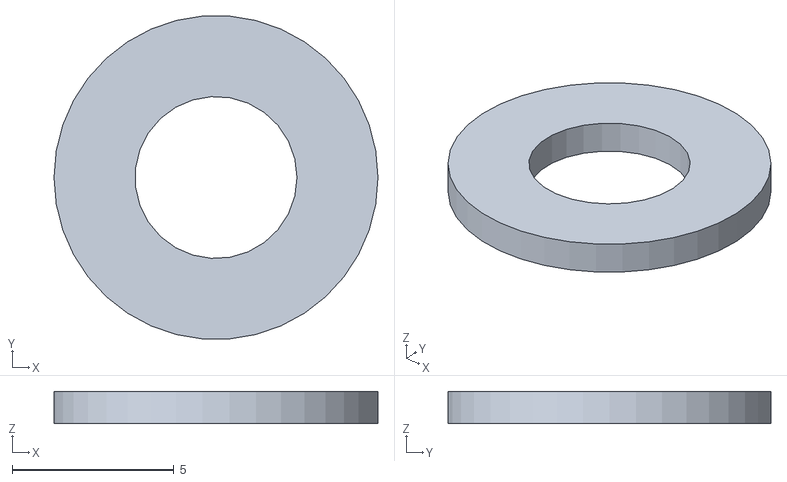
[picture p168: CAD file, 2026-04-25]
Self-Balancing-Bike/3D printing/gear_spacer.stl
10.0 x 9.97 x 1.00
