GabrielPaschoalin/PFC/Self-Balancing-Bike/3D printing/servo_back.stl

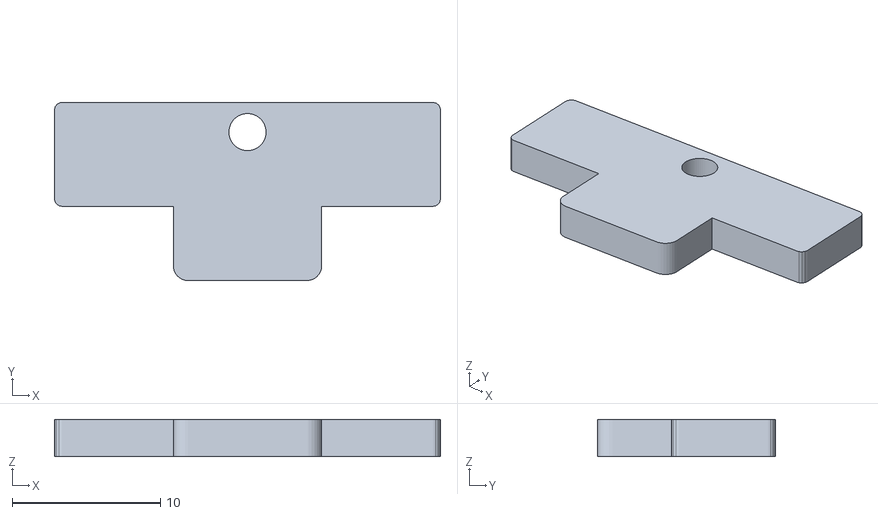
[picture p169: CAD file, 2026-04-25]
Self-Balancing-Bike/3D printing/servo_back.stl
26.0 x 12.0 x 2.50
