GabrielPaschoalin/PFC/Self-Balancing-Bike/3D printing/Nidec_holder.stl

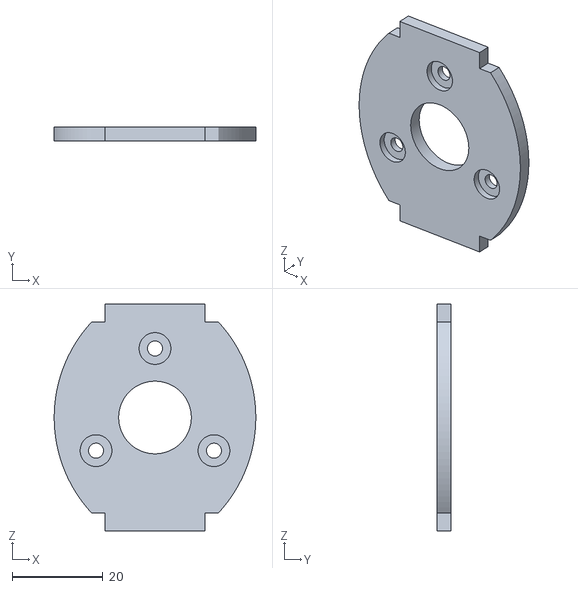
[picture p170: CAD file, 2026-04-25]
Self-Balancing-Bike/3D printing/Nidec_holder.stl
44.4 x 3.00 x 50.0
