GabrielPaschoalin/PFC/Self-Balancing-Bike/3D printing/regulator_holder.stl

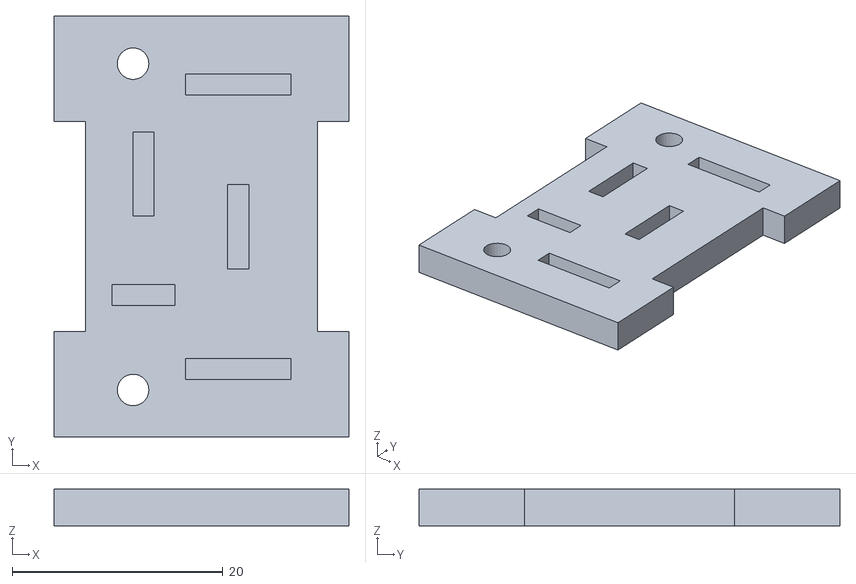
[picture p171: CAD file, 2026-04-25]
Self-Balancing-Bike/3D printing/regulator_holder.stl
28.0 x 40.0 x 3.50
