GabrielPaschoalin/PFC/Self-Balancing-Bike/3D printing/fork.stl

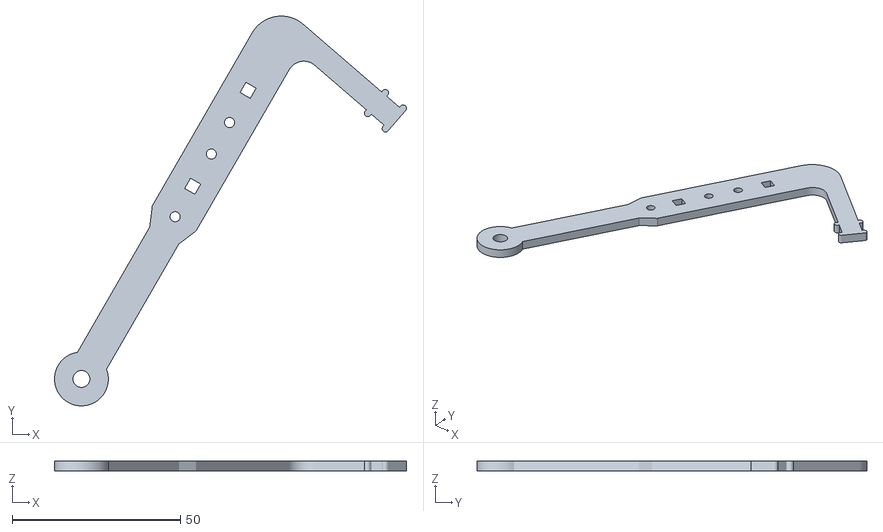
[picture p172: CAD file, 2026-04-25]
Self-Balancing-Bike/3D printing/fork.stl
104.5 x 115.8 x 3.00
