GabrielPaschoalin/PFC/Self-Balancing-Bike/3D printing/wheel_gear.stl

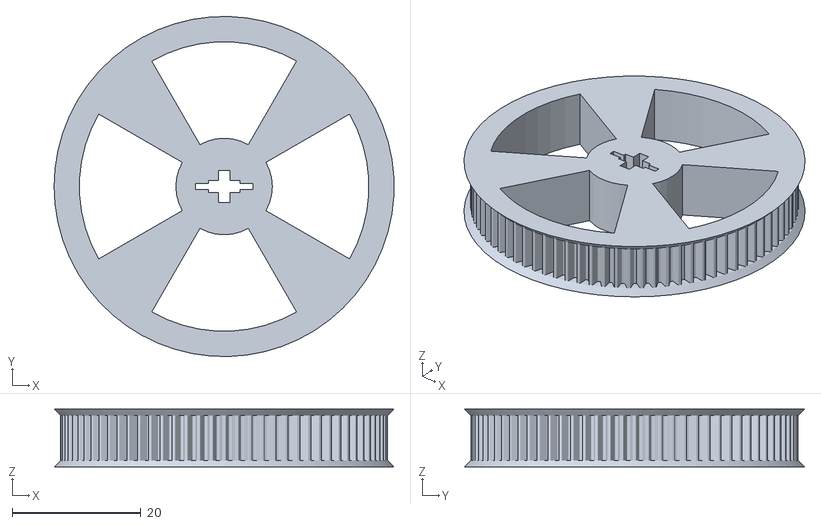
[picture p173: CAD file, 2026-04-25]
Self-Balancing-Bike/3D printing/wheel_gear.stl
52.8 x 52.8 x 9.00
