GabrielPaschoalin/PFC/Self-Balancing-Bike/3D printing/left_body.stl

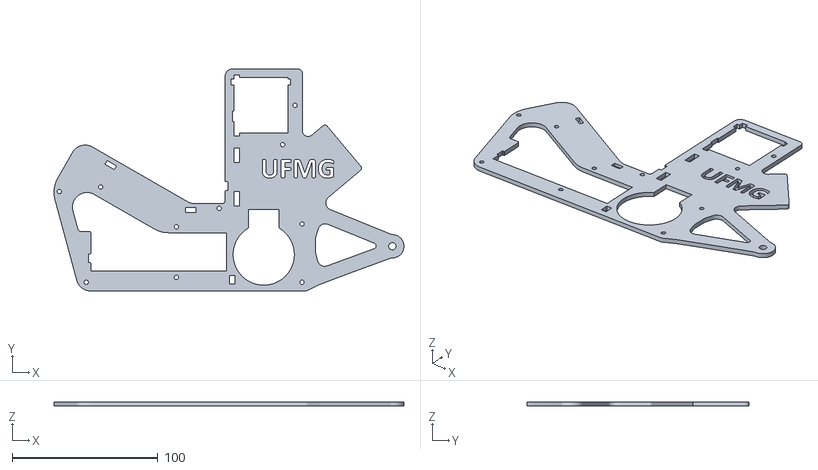
[picture p174: CAD file, 2026-04-25]
Self-Balancing-Bike/3D printing/left_body.stl
240.4 x 152.5 x 3.00
