GabrielPaschoalin/PFC/Self-Balancing-Bike/3D printing/Nidec_gear.stl

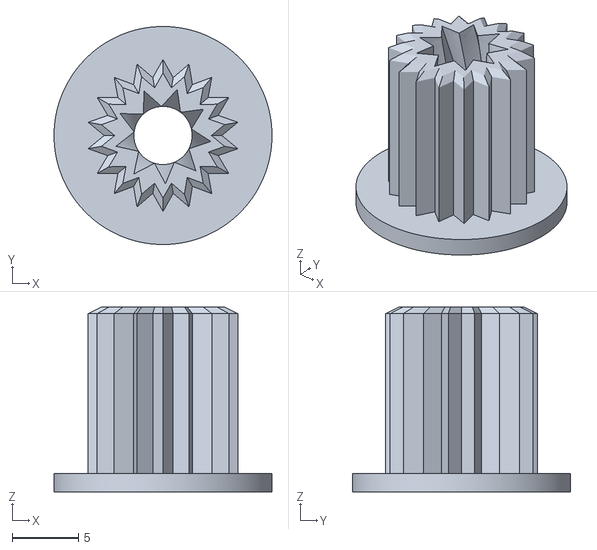
[picture p175: CAD file, 2026-04-25]
Self-Balancing-Bike/3D printing/Nidec_gear.stl
16.5 x 16.5 x 14.0
