GabrielPaschoalin/PFC/maglev/Ensaios/TESTE_PULSO_26_04_00_28.txt

LL_CIMA_MV:1495,PULSO_HALL_CIMA_PICO_MV:1724,SCALE_LOW:-5.00,SCALE_HIGH:30.00
TEST_ID:IDENT_PULSO_SUBIDA_AGR,TEST_PARAM:SIG=PUL;TB=800;BUSCA=5;TPAT=300;RMIN=5.00;MARG=40;TD=1200;TP=150;TE=1000;REP=10,T_US:1737823374,PWM:0,RAW:74.000,ACTUAL:14.351,REF:0.000,ERRO:14.351,HALL_MV:3129,HALL_FILT_MV:3129,HALL_CIMA_MV:1717,HALL_CIMA_FILT_MV:1707,TOF_VALID:1,NEW_TOF:0,RANGE_STATUS:0,SIGNAL_MCPS:22.6250,AMBIENT_MCPS:0.0312,SPAD:14.0156,VEL_MM_S:-0.0046,MEAS_RATE_HZ:12.6247,MEAS_AGE_US:4254,DT_HALL_US:492,DT_TOF_US:79210,DT_EST_US:491,DT_CTRL_US:488,IDENT_ACTIVE:0,IDENT_STATE:FINALIZADO,IDENT_TYPE:PULSO,IDENT_REP:10,IDENT_REP_MAX:10,IDENT_FASE:0,LIM_PWM:185,LIM_HALL_MV:3129,LIM_ACTUAL_MM:-17.867,LIM_RAW_MM:92.000,DELTA_LIM_MM:-6.589,TEST_PWM:225,TOF_BASE_MM:-11.278,PULSO_HALL_PICO_MV:3129,PULSO_ACTUAL_PICO_MM:-16.246,DELTA_PULSO_MM:-4.969,IDENT_MOTIVO:OK,SYNC_PULSE:0,LIM_HALL_CIMA_MV:1495,PULSO_HALL_CIMA_PICO_MV:1724,SCALE_LOW:-5.00,SCALE_HIGH:30.00
TEST_ID:IDENT_PULSO_SUBIDA_AGR,TEST_PARAM:SIG=PUL;TB=800;BUSCA=5;TPAT=300;RMIN=5.00;MARG=40;TD=1200;TP=150;TE=1000;REP=10,T_US:1737966796,PWM:0,RAW:79.000,ACTUAL:13.339,REF:0.000,ERRO:13.339,HALL_MV:3129,HALL_FILT_MV:3129,HALL_CIMA_MV:1692,HALL_CIMA_FILT_MV:1698,TOF_VALID:1,NEW_TOF:0,RANGE_STATUS:0,SIGNAL_MCPS:22.6563,AMBIENT_MCPS:0.0391,SPAD:14.0156,VEL_MM_S:0.0040,MEAS_RATE_HZ:13.4755,MEAS_AGE_US:9270,DT_HALL_US:1997,DT_TOF_US:74209,DT_EST_US:1999,DT_CTRL_US:1998,IDENT_ACTIVE:0,IDENT_STATE:FINALIZADO,IDENT_TYPE:PULSO,IDENT_REP:10,IDENT_REP_MAX:10,IDENT_FASE:0,LIM_PWM:185,LIM_HALL_MV:3129,LIM_ACTUAL_MM:-17.867,LIM_RAW_MM:92.000,DELTA_LIM_MM:-6.589,TEST_PWM:225,TOF_BASE_MM:-11.278,PULSO_HALL_PICO_MV:3129,PULSO_ACTUAL_PICO_MM:-16.246,DELTA_PULSO_MM:-4.969,IDENT_MOTIVO:OK,SYNC_PULSE:0,LIM_HALL_CIMA_MV:1495,PULSO_HALL_CIMA_PICO_MV:1724,SCALE_LOW:-5.00,SCALE_HIGH:30.00
TEST_ID:IDENT_PULSO_SUBIDA_AGR,TEST_PARAM:SIG=PUL;TB=800;BUSCA=5;TPAT=300;RMIN=5.00;MARG=40;TD=1200;TP=150;TE=1000;REP=10,T_US:1737976796,PWM:0,RAW:75.000,ACTUAL:13.865,REF:0.000,ERRO:13.865,HALL_MV:3129,HALL_FILT_MV:3129,HALL_CIMA_MV:1718,HALL_CIMA_FILT_MV:1684,TOF_VALID:1,NEW_TOF:0,RANGE_STATUS:0,SIGNAL_MCPS:22.6563,AMBIENT_MCPS:0.0234,SPAD:14.0156,VEL_MM_S:-0.0012,MEAS_RATE_HZ:12.6250,MEAS_AGE_US:4265,DT_HALL_US:488,DT_TOF_US:79208,DT_EST_US:487,DT_CTRL_US:491,IDENT_ACTIVE:0,IDENT_STATE:FINALIZADO,IDENT_TYPE:PULSO,IDENT_REP:10,IDENT_REP_MAX:10,IDENT_FASE:0,LIM_PWM:185,LIM_HALL_MV:3129,LIM_ACTUAL_MM:-17.867,LIM_RAW_MM:92.000,DELTA_LIM_MM:-6.589,TEST_PWM:225,TOF_BASE_MM:-11.278,PULSO_HALL_PICO_MV:3129,PULSO_ACTUAL_PICO_MM:-16.246,DELTA_PULSO_MM:-4.969,IDENT_MOTIVO:OK,SYNC_PULSE:0,LIM_HALL_CIMA_MV:1495,PULSO_HALL_CIMA_PICO_MV:1724,SCALE_LOW:-5.00,SCALE_HIGH:30.00
TEST_ID:IDENT_PULSO_SUBIDA_AGR,TEST_PARAM:SIG=PUL;TB=800;BUSCA=5;TPAT=300;RMIN=5.00;MARG=40;TD=1200;TP=150;TE=1000;REP=10,T_US:1738120216,PWM:0,RAW:76.000,ACTUAL:13.976,REF:0.000,ERRO:13.976,HALL_MV:3129,HALL_FILT_MV:3129,HALL_CIMA_MV:1733,HALL_CIMA_FILT_MV:1720,TOF_VALID:1,NEW_TOF:0,RANGE_STATUS:0,SIGNAL_MCPS:22.6406,AMBIENT_MCPS:0.0312,SPAD:14.0156,VEL_MM_S:-0.0022,MEAS_RATE_HZ:13.4749,MEAS_AGE_US:9277,DT_HALL_US:2000,DT_TOF_US:74212,DT_EST_US:2002,DT_CTRL_US:2000,IDENT_ACTIVE:0,IDENT_STATE:FINALIZADO,IDENT_TYPE:PULSO,IDENT_REP:10,IDENT_REP_MAX:10,IDENT_FASE:0,LIM_PWM:185,LIM_HALL_MV:3129,LIM_ACTUAL_MM:-17.867,LIM_RAW_MM:92.000,DELTA_LIM_MM:-6.589,TEST_PWM:225,TOF_BASE_MM:-11.278,PULSO_HALL_PICO_MV:3129,PULSO_ACTUAL_PICO_MM:-16.246,DELTA_PULSO_MM:-4.969,IDENT_MOTIVO:OK,SYNC_PULSE:0,LIM_HALL_CIMA_MV:1495,PULSO_HALL_CIMA_PICO_MV:1724,SCALE_LOW:-5.00,SCALE_HIGH:30.00
TEST_ID:IDENT_PULSO_SUBIDA_AGR,TEST_PARAM:SIG=PUL;TB=800;BUSCA=5;TPAT=300;RMIN=5.00;MARG=40;TD=1200;TP=150;TE=1000;REP=10,T_US:1738130216,PWM:0,RAW:77.000,ACTUAL:13.776,REF:0.000,ERRO:13.776,HALL_MV:3129,HALL_FILT_MV:3129,HALL_CIMA_MV:1582,HALL_CIMA_FILT_MV:1642,TOF_VALID:1,NEW_TOF:0,RANGE_STATUS:0,SIGNAL_MCPS:22.7422,AMBIENT_MCPS:0.0234,SPAD:14.0156,VEL_MM_S:0.0001,MEAS_RATE_HZ:12.6234,MEAS_AGE_US:4262,DT_HALL_US:488,DT_TOF_US:79218,DT_EST_US:486,DT_CTRL_US:489,IDENT_ACTIVE:0,IDENT_STATE:FINALIZADO,IDENT_TYPE:PULSO,IDENT_REP:10,IDENT_REP_MAX:10,IDENT_FASE:0,LIM_PWM:185,LIM_HALL_MV:3129,LIM_ACTUAL_MM:-17.867,LIM_RAW_MM:92.000,DELTA_LIM_MM:-6.589,TEST_PWM:225,TOF_BASE_MM:-11.278,PULSO_HALL_PICO_MV:3129,PULSO_ACTUAL_PICO_MM:-16.246,DELTA_PULSO_MM:-4.969,IDENT_MOTIVO:OK,SYNC_PULSE:0,LIM_HALL_CIMA_MV:1495,PULSO_HALL_CIMA_PICO_MV:1724,SCALE_LOW:-5.00,SCALE_HIGH:30.00
TEST_ID:IDENT_PULSO_SUBIDA_AGR,TEST_PARAM:SIG=PUL;TB=800;BUSCA=5;TPAT=300;RMIN=5.00;MARG=40;TD=1200;TP=150;TE=1000;REP=10,T_US:1738273640,PWM:0,RAW:77.000,ACTUAL:13.598,REF:0.000,ERRO:13.598,HALL_MV:3129,HALL_FILT_MV:3129,HALL_CIMA_MV:1678,HALL_CIMA_FILT_MV:1687,TOF_VALID:1,NEW_TOF:0,RANGE_STATUS:0,SIGNAL_MCPS:22.6250,AMBIENT_MCPS:0.0234,SPAD:14.0156,VEL_MM_S:0.0020,MEAS_RATE_HZ:13.4755,MEAS_AGE_US:9268,DT_HALL_US:2000,DT_TOF_US:74209,DT_EST_US:2001,DT_CTRL_US:1999,IDENT_ACTIVE:0,IDENT_STATE:FINALIZADO,IDENT_TYPE:PULSO,IDENT_REP:10,IDENT_REP_MAX:10,IDENT_FASE:0,LIM_PWM:185,LIM_HALL_MV:3129,LIM_ACTUAL_MM:-17.867,LIM_RAW_MM:92.000,DELTA_LIM_MM:-6.589,TEST_PWM:225,TOF_BASE_MM:-11.278,PULSO_HALL_PICO_MV:3129,PULSO_ACTUAL_PICO_MM:-16.246,DELTA_PULSO_MM:-4.969,IDENT_MOTIVO:OK,SYNC_PULSE:0,LIM_HALL_CIMA_MV:1495,PULSO_HALL_CIMA_PICO_MV:1724,SCALE_LOW:-5.00,SCALE_HIGH:30.00
TEST_ID:IDENT_PULSO_SUBIDA_AGR,TEST_PARAM:SIG=PUL;TB=800;BUSCA=5;TPAT=300;RMIN=5.00;MARG=40;TD=1200;TP=150;TE=1000;REP=10,T_US:1738283640,PWM:0,RAW:77.000,ACTUAL:13.449,REF:0.000,ERRO:13.449,HALL_MV:3129,HALL_FILT_MV:3129,HALL_CIMA_MV:1723,HALL_CIMA_FILT_MV:1703,TOF_VALID:1,NEW_TOF:0,RANGE_STATUS:0,SIGNAL_MCPS:22.5703,AMBIENT_MCPS:0.0312,SPAD:14.0156,VEL_MM_S:0.0035,MEAS_RATE_HZ:12.6253,MEAS_AGE_US:4257,DT_HALL_US:489,DT_TOF_US:79206,DT_EST_US:486,DT_CTRL_US:492,IDENT_ACTIVE:0,IDENT_STATE:FINALIZADO,IDENT_TYPE:PULSO,IDENT_REP:10,IDENT_REP_MAX:10,IDENT_FASE:0,LIM_PWM:185,LIM_HALL_MV:3129,LIM_ACTUAL_MM:-17.867,LIM_RAW_MM:92.000,DELTA_LIM_MM:-6.589,TEST_PWM:225,TOF_BASE_MM:-11.278,PULSO_HALL_PICO_MV:3129,PULSO_ACTUAL_PICO_MM:-16.246,DELTA_PULSO_MM:-4.969,IDENT_MOTIVO:OK,SYNC_PULSE:0,LIM_HALL_CIMA_MV:1495,PULSO_HALL_CIMA_PICO_MV:1724,SCALE_LOW:-5.00,SCALE_HIGH:30.00
TEST_ID:IDENT_PULSO_SUBIDA_AGR,TEST_PARAM:SIG=PUL;TB=800;BUSCA=5;TPAT=300;RMIN=5.00;MARG=40;TD=1200;TP=150;TE=1000;REP=10,T_US:1738427058,PWM:0,RAW:77.000,ACTUAL:13.322,REF:0.000,ERRO:13.322,HALL_MV:3129,HALL_FILT_MV:3129,HALL_CIMA_MV:1703,HALL_CIMA_FILT_MV:1686,TOF_VALID:1,NEW_TOF:0,RANGE_STATUS:0,SIGNAL_MCPS:22.7188,AMBIENT_MCPS:0.0234,SPAD:14.0156,VEL_MM_S:0.0045,MEAS_RATE_HZ:13.4758,MEAS_AGE_US:9275,DT_HALL_US:2003,DT_TOF_US:74207,DT_EST_US:2004,DT_CTRL_US:2002,IDENT_ACTIVE:0,IDENT_STATE:FINALIZADO,IDENT_TYPE:PULSO,IDENT_REP:10,IDENT_REP_MAX:10,IDENT_FASE:0,LIM_PWM:185,LIM_HALL_MV:3129,LIM_ACTUAL_MM:-17.867,LIM_RAW_MM:92.000,DELTA_LIM_MM:-6.589,TEST_PWM:225,TOF_BASE_MM:-11.278,PULSO_HALL_PICO_MV:3129,PULSO_ACTUAL_PICO_MM:-16.246,DELTA_PULSO_MM:-4.969,IDENT_MOTIVO:OK,SYNC_PULSE:0,LIM_HALL_CIMA_MV:1495,PULSO_HALL_CIMA_PICO_MV:1724,SCALE_LOW:-5.00,SCALE_HIGH:30.00
TEST_ID:IDENT_PULSO_SUBIDA_AGR,TEST_PARAM:SIG=PUL;TB=800;BUSCA=5;TPAT=300;RMIN=5.00;MARG=40;TD=1200;TP=150;TE=1000;REP=10,T_US:1738437058,PWM:0,RAW:79.000,ACTUAL:12.875,REF:0.000,ERRO:12.875,HALL_MV:3129,HALL_FILT_MV:3129,HALL_CIMA_MV:1656,HALL_CIMA_FILT_MV:1678,TOF_VALID:1,NEW_TOF:1,RANGE_STATUS:0,SIGNAL_MCPS:22.6484,AMBIENT_MCPS:0.0234,SPAD:14.0156,VEL_MM_S:0.0089,MEAS_RATE_HZ:200.0000,MEAS_AGE_US:0,DT_HALL_US:494,DT_TOF_US:5000,DT_EST_US:492,DT_CTRL_US:2540,IDENT_ACTIVE:0,IDENT_STATE:FINALIZADO,IDENT_TYPE:PULSO,IDENT_REP:10,IDENT_REP_MAX:10,IDENT_FASE:0,LIM_PWM:185,LIM_HALL_MV:3129,LIM_ACTUAL_MM:-17.867,LIM_RAW_MM:92.000,DELTA_LIM_MM:-6.589,TEST_PWM:225,TOF_BASE_MM:-11.278,PULSO_HALL_PICO_MV:3129,PULSO_ACTUAL_PICO_MM:-16.246,DELTA_PULSO_MM:-4.969,IDENT_MOTIVO:OK,SYNC_PULSE:0,LIM_HALL_CIMA_MV:1495,PULSO_HALL_CIMA_PICO_MV:1724,SCALE_LOW:-5.00,SCALE_HIGH:30.00
TEST_ID:IDENT_PULSO_SUBIDA_AGR,TEST_PARAM:SIG=PUL;TB=800;BUSCA=5;TPAT=300;RMIN=5.00;MARG=40;TD=1200;TP=150;TE=1000;REP=10,T_US:1738582465,PWM:0,RAW:77.000,ACTUAL:12.828,REF:0.000,ERRO:12.828,HALL_MV:3129,HALL_FILT_MV:3129,HALL_CIMA_MV:1670,HALL_CIMA_FILT_MV:1675,TOF_VALID:1,NEW_TOF:0,RANGE_STATUS:0,SIGNAL_MCPS:22.6719,AMBIENT_MCPS:0.0234,SPAD:14.0156,VEL_MM_S:0.0087,MEAS_RATE_HZ:13.9036,MEAS_AGE_US:9288,DT_HALL_US:2008,DT_TOF_US:71924,DT_EST_US:2009,DT_CTRL_US:2007,IDENT_ACTIVE:0,IDENT_STATE:FINALIZADO,IDENT_TYPE:PULSO,IDENT_REP:10,IDENT_REP_MAX:10,IDENT_FASE:0,LIM_PWM:185,LIM_HALL_MV:3129,LIM_ACTUAL_MM:-17.867,LIM_RAW_MM:92.000,DELTA_LIM_MM:-6.589,TEST_PWM:225,TOF_BASE_MM:-11.278,PULSO_HALL_PICO_MV:3129,PULSO_ACTUAL_PICO_MM:-16.246,DELTA_PULSO_MM:-4.969,IDENT_MOTIVO:OK,SYNC_PULSE:0,LIM_HALL_CIMA_MV:1495,PULSO_HALL_CIMA_PICO_MV:1724,SCALE_LOW:-5.00,SCALE_HIGH:30.00
TEST_ID:IDENT_PULSO_SUBIDA_AGR,TEST_PARAM:SIG=PUL;TB=800;BUSCA=5;TPAT=300;RMIN=5.00;MARG=40;TD=1200;TP=150;TE=1000;REP=10,T_US:1738592465,PWM:0,RAW:76.000,ACTUAL:13.066,REF:0.000,ERRO:13.066,HALL_MV:3129,HALL_FILT_MV:3129,HALL_CIMA_MV:1745,HALL_CIMA_FILT_MV:1704,TOF_VALID:1,NEW_TOF:0,RANGE_STATUS:0,SIGNAL_MCPS:22.6641,AMBIENT_MCPS:0.0234,SPAD:14.0156,VEL_MM_S:0.0057,MEAS_RATE_HZ:12.6088,MEAS_AGE_US:4262,DT_HALL_US:488,DT_TOF_US:79310,DT_EST_US:486,DT_CTRL_US:490,IDENT_ACTIVE:0,IDENT_STATE:FINALIZADO,IDENT_TYPE:PULSO,IDENT_REP:10,IDENT_REP_MAX:10,IDENT_FASE:0,LIM_PWM:185,LIM_HALL_MV:3129,LIM_ACTUAL_MM:-17.867,LIM_RAW_MM:92.000,DELTA_LIM_MM:-6.589,TEST_PWM:225,TOF_BASE_MM:-11.278,PULSO_HALL_PICO_MV:3129,PULSO_ACTUAL_PICO_MM:-16.246,DELTA_PULSO_MM:-4.969,IDENT_MOTIVO:OK,SYNC_PULSE:0,LIM_HALL_CIMA_MV:1495,PULSO_HALL_CIMA_PICO_MV:1724,SCALE_LOW:-5.00,SCALE_HIGH:30.00
TEST_ID:IDENT_PULSO_SUBIDA_AGR,TEST_PARAM:SIG=PUL;TB=800;BUSCA=5;TPAT=300;RMIN=5.00;MARG=40;TD=1200;TP=150;TE=1000;REP=10,T_US:1738735974,PWM:0,RAW:75.000,ACTUAL:13.568,REF:0.000,ERRO:13.568,HALL_MV:3129,HALL_FILT_MV:3129,HALL_CIMA_MV:1716,HALL_CIMA_FILT_MV:1709,TOF_VALID:1,NEW_TOF:0,RANGE_STATUS:0,SIGNAL_MCPS:22.7500,AMBIENT_MCPS:0.0234,SPAD:14.0156,VEL_MM_S:0.0006,MEAS_RATE_HZ:13.4758,MEAS_AGE_US:9274,DT_HALL_US:1996,DT_TOF_US:74207,DT_EST_US:1998,DT_CTRL_US:1996,IDENT_ACTIVE:0,IDENT_STATE:FINALIZADO,IDENT_TYPE:PULSO,IDENT_REP:10,IDENT_REP_MAX:10,IDENT_FASE:0,LIM_PWM:185,LIM_HALL_MV:3129,LIM_ACTUAL_MM:-17.867,LIM_RAW_MM:92.000,DELTA_LIM_MM:-6.589,TEST_PWM:225,TOF_BASE_MM:-11.278,PULSO_HALL_PICO_MV:3129,PULSO_ACTUAL_PICO_MM:-16.246,DELTA_PULSO_MM:-4.969,IDENT_MOTIVO:OK,SYNC_PULSE:0,LIM_HALL_CIMA_MV:1495,PULSO_HALL_CIMA_PICO_MV:1724,SCALE_LOW:-5.00,SCALE_HIGH:30.00
TEST_ID:IDENT_PULSO_SUBIDA_AGR,TEST_PARAM:SIG=PUL;TB=800;BUSCA=5;TPAT=300;RMIN=5.00;MARG=40;TD=1200;TP=150;TE=1000;REP=10,T_US:1738745974,PWM:0,RAW:76.000,ACTUAL:13.714,REF:0.000,ERRO:13.714,HALL_MV:3129,HALL_FILT_MV:3129,HALL_CIMA_MV:1751,HALL_CIMA_FILT_MV:1711,TOF_VALID:1,NEW_TOF:0,RANGE_STATUS:0,SIGNAL_MCPS:22.6797,AMBIENT_MCPS:0.0312,SPAD:14.0156,VEL_MM_S:-0.0008,MEAS_RATE_HZ:12.6248,MEAS_AGE_US:4263,DT_HALL_US:488,DT_TOF_US:79209,DT_EST_US:490,DT_CTRL_US:492,IDENT_ACTIVE:0,IDENT_STATE:FINALIZADO,IDENT_TYPE:PULSO,IDENT_REP:10,IDENT_REP_MAX:10,IDENT_FASE:0,LIM_PWM:185,LIM_HALL_MV:3129,LIM_ACTUAL_MM:-17.867,LIM_RAW_MM:92.000,DELTA_LIM_MM:-6.589,TEST_PWM:225,TOF_BASE_MM:-11.278,PULSO_HALL_PICO_MV:3129,PULSO_ACTUAL_PICO_MM:-16.246,DELTA_PULSO_MM:-4.969,IDENT_MOTIVO:OK,SYNC_PULSE:0,LIM_HALL_CIMA_MV:1495,PULSO_HALL_CIMA_PICO_MV:1724,SCALE_LOW:-5.00,SCALE_HIGH:30.00
TEST_ID:IDENT_PULSO_SUBIDA_AGR,TEST_PARAM:SIG=PUL;TB=800;BUSCA=5;TPAT=300;RMIN=5.00;MARG=40;TD=1200;TP=150;TE=1000;REP=10,T_US:1738889401,PWM:0,RAW:78.000,ACTUAL:13.283,REF:0.000,ERRO:13.283,HALL_MV:3129,HALL_FILT_MV:3129,HALL_CIMA_MV:1769,HALL_CIMA_FILT_MV:1720,TOF_VALID:1,NEW_TOF:0,RANGE_STATUS:0,SIGNAL_MCPS:22.6172,AMBIENT_MCPS:0.0312,SPAD:14.0156,VEL_MM_S:0.0030,MEAS_RATE_HZ:13.4742,MEAS_AGE_US:9276,DT_HALL_US:2000,DT_TOF_US:74216,DT_EST_US:2001,DT_CTRL_US:1999,IDENT_ACTIVE:0,IDENT_STATE:FINALIZADO,IDENT_TYPE:PULSO,IDENT_REP:10,IDENT_REP_MAX:10,IDENT_FASE:0,LIM_PWM:185,LIM_HALL_MV:3129,LIM_ACTUAL_MM:-17.867,LIM_RAW_MM:92.000,DELTA_LIM_MM:-6.589,TEST_PWM:225,TOF_BASE_MM:-11.278,PULSO_HALL_PICO_MV:3129,PULSO_ACTUAL_PICO_MM:-16.246,DELTA_PULSO_MM:-4.969,IDENT_MOTIVO:OK,SYNC_PULSE:0,LIM_HALL_CIMA_MV:1495,PULSO_HALL_CIMA_PICO_MV:1724,SCALE_LOW:-5.00,SCALE_HIGH:30.00
TEST_ID:IDENT_PULSO_SUBIDA_AGR,TEST_PARAM:SIG=PUL;TB=800;BUSCA=5;TPAT=300;RMIN=5.00;MARG=40;TD=1200;TP=150;TE=1000;REP=10,T_US:1738899401,PWM:0,RAW:75.000,ACTUAL:13.723,REF:0.000,ERRO:13.723,HALL_MV:3129,HALL_FILT_MV:3129,HALL_CIMA_MV:1678,HALL_CIMA_FILT_MV:1708,TOF_VALID:1,NEW_TOF:0,RANGE_STATUS:0,SIGNAL_MCPS:24.3125,AMBIENT_MCPS:0.0312,SPAD:15.0156,VEL_MM_S:-0.0009,MEAS_RATE_HZ:12.6236,MEAS_AGE_US:4258,DT_HALL_US:493,DT_TOF_US:79217,DT_EST_US:490,DT_CTRL_US:488,IDENT_ACTIVE:0,IDENT_STATE:FINALIZADO,IDENT_TYPE:PULSO,IDENT_REP:10,IDENT_REP_MAX:10,IDENT_FASE:0,LIM_PWM:185,LIM_HALL_MV:3129,LIM_ACTUAL_MM:-17.867,LIM_RAW_MM:92.000,DELTA_LIM_MM:-6.589,TEST_PWM:225,TOF_BASE_MM:-11.278,PULSO_HALL_PICO_MV:3129,PULSO_ACTUAL_PICO_MM:-16.246,DELTA_PULSO_MM:-4.969,IDENT_MOTIVO:OK,SYNC_PULSE:0,LIM_HALL_CIMA_MV:1495,PULSO_HALL_CIMA_PICO_MV:1724,SCALE_LOW:-5.00,SCALE_HIGH:30.00
TEST_ID:IDENT_PULSO_SUBIDA_AGR,TEST_PARAM:SIG=PUL;TB=800;BUSCA=5;TPAT=300;RMIN=5.00;MARG=40;TD=1200;TP=150;TE=1000;REP=10,T_US:1739042817,PWM:0,RAW:76.000,ACTUAL:13.836,REF:0.000,ERRO:13.836,HALL_MV:3129,HALL_FILT_MV:3129,HALL_CIMA_MV:1712,HALL_CIMA_FILT_MV:1693,TOF_VALID:1,NEW_TOF:0,RANGE_STATUS:0,SIGNAL_MCPS:22.6016,AMBIENT_MCPS:0.0312,SPAD:14.0156,VEL_MM_S:-0.0018,MEAS_RATE_HZ:13.4762,MEAS_AGE_US:9271,DT_HALL_US:1996,DT_TOF_US:74205,DT_EST_US:1998,DT_CTRL_US:1998,IDENT_ACTIVE:0,IDENT_STATE:FINALIZADO,IDENT_TYPE:PULSO,IDENT_REP:10,IDENT_REP_MAX:10,IDENT_FASE:0,LIM_PWM:185,LIM_HALL_MV:3129,LIM_ACTUAL_MM:-17.867,LIM_RAW_MM:92.000,DELTA_LIM_MM:-6.589,TEST_PWM:225,TOF_BASE_MM:-11.278,PULSO_HALL_PICO_MV:3129,PULSO_ACTUAL_PICO_MM:-16.246,DELTA_PULSO_MM:-4.969,IDENT_MOTIVO:OK,SYNC_PULSE:0,LIM_HALL_CIMA_MV:1495,PULSO_HALL_CIMA_PICO_MV:1724,SCALE_LOW:-5.00,SCALE_HIGH:30.00
TEST_ID:IDENT_PULSO_SUBIDA_AGR,TEST_PARAM:SIG=PUL;TB=800;BUSCA=5;TPAT=300;RMIN=5.00;MARG=40;TD=1200;TP=150;TE=1000;REP=10,T_US:1739052817,PWM:0,RAW:76.000,ACTUAL:13.944,REF:0.000,ERRO:13.944,HALL_MV:3129,HALL_FILT_MV:3129,HALL_CIMA_MV:1693,HALL_CIMA_FILT_MV:1710,TOF_VALID:1,NEW_TOF:0,RANGE_STATUS:0,SIGNAL_MCPS:22.6016,AMBIENT_MCPS:0.0312,SPAD:14.0156,VEL_MM_S:-0.0025,MEAS_RATE_HZ:12.6248,MEAS_AGE_US:4257,DT_HALL_US:488,DT_TOF_US:79209,DT_EST_US:486,DT_CTRL_US:492,IDENT_ACTIVE:0,IDENT_STATE:FINALIZADO,IDENT_TYPE:PULSO,IDENT_REP:10,IDENT_REP_MAX:10,IDENT_FASE:0,LIM_PWM:185,LIM_HALL_MV:3129,LIM_ACTUAL_MM:-17.867,LIM_RAW_MM:92.000,DELTA_LIM_MM:-6.589,TEST_PWM:225,TOF_BASE_MM:-11.278,PULSO_HALL_PICO_MV:3129,PULSO_ACTUAL_PICO_MM:-16.246,DELTA_PULSO_MM:-4.969,IDENT_MOTIVO:OK,SYNC_PULSE:0,LIM_HALL_CIMA_MV:1495,PULSO_HALL_CIMA_PICO_MV:1724,SCALE_LOW:-5.00,SCALE_HIGH:30.00
TEST_ID:IDENT_PULSO_SUBIDA_AGR,TEST_PARAM:SIG=PUL;TB=800;BUSCA=5;TPAT=300;RMIN=5.00;MARG=40;TD=1200;TP=150;TE=1000;REP=10,T_US:1739196239,PWM:0,RAW:74.000,ACTUAL:14.617,REF:0.000,ERRO:14.617,HALL_MV:3129,HALL_FILT_MV:3129,HALL_CIMA_MV:1716,HALL_CIMA_FILT_MV:1719,TOF_VALID:1,NEW_TOF:0,RANGE_STATUS:0,SIGNAL_MCPS:22.5391,AMBIENT_MCPS:0.0312,SPAD:14.0156,VEL_MM_S:-0.0074,MEAS_RATE_HZ:13.4749,MEAS_AGE_US:9278,DT_HALL_US:2000,DT_TOF_US:74212,DT_EST_US:2001,DT_CTRL_US:1999,IDENT_ACTIVE:0,IDENT_STATE:FINALIZADO,IDENT_TYPE:PULSO,IDENT_REP:10,IDENT_REP_MAX:10,IDENT_FASE:0,LIM_PWM:185,LIM_HALL_MV:3129,LIM_ACTUAL_MM:-17.867,LIM_RAW_MM:92.000,DELTA_LIM_MM:-6.589,TEST_PWM:225,TOF_BASE_MM:-11.278,PULSO_HALL_PICO_MV:3129,PULSO_ACTUAL_PICO_MM:-16.246,DELTA_PULSO_MM:-4.969,IDENT_MOTIVO:OK,SYNC_PULSE:0,LIM_HALL_CIMA_MV:1495,PULSO_HALL_CIMA_PICO_MV:1724,SCALE_LOW:-5.00,SCALE_HIGH:30.00
TEST_ID:IDENT_PULSO_SUBIDA_AGR,TEST_PARAM:SIG=PUL;TB=800;BUSCA=5;TPAT=300;RMIN=5.00;MARG=40;TD=1200;TP=150;TE=1000;REP=10,T_US:1739206239,PWM:0,RAW:77.000,ACTUAL:14.350,REF:0.000,ERRO:14.350,HALL_MV:3129,HALL_FILT_MV:3129,HALL_CIMA_MV:1695,HALL_CIMA_FILT_MV:1699,TOF_VALID:1,NEW_TOF:0,RANGE_STATUS:0,SIGNAL_MCPS:22.6484,AMBIENT_MCPS:0.0312,SPAD:14.0156,VEL_MM_S:-0.0049,MEAS_RATE_HZ:12.6237,MEAS_AGE_US:4271,DT_HALL_US:492,DT_TOF_US:79216,DT_EST_US:491,DT_CTRL_US:488,IDENT_ACTIVE:0,IDENT_STATE:FINALIZADO,IDENT_TYPE:PULSO,IDENT_REP:10,IDENT_REP_MAX:10,IDENT_FASE:0,LIM_PWM:185,LIM_HALL_MV:3129,LIM_ACTUAL_MM:-17.867,LIM_RAW_MM:92.000,DELTA_LIM_MM:-6.589,TEST_PWM:225,TOF_BASE_MM:-11.278,PULSO_HALL_PICO_MV:3129,PULSO_ACTUAL_PICO_MM:-16.246,DELTA_PULSO_MM:-4.969,IDENT_MOTIVO:OK,SYNC_PULSE:0,LIM_HALL_CIMA_MV:1495,PULSO_HALL_CIMA_PICO_MV:1724,SCALE_LOW:-5.00,SCALE_HIGH:30.00
TEST_ID:IDENT_PULSO_SUBIDA_AGR,TEST_PARAM:SIG=PUL;TB=800;BUSCA=5;TPAT=300;RMIN=5.00;MARG=40;TD=1200;TP=150;TE=1000;REP=10,T_US:1739349667,PWM:0,RAW:77.000,ACTUAL:14.178,REF:0.000,ERRO:14.178,HALL_MV:3129,HALL_FILT_MV:3129,HALL_CIMA_MV:1663,HALL_CIMA_FILT_MV:1695,TOF_VALID:1,NEW_TOF:1,RANGE_STATUS:0,SIGNAL_MCPS:22.7500,AMBIENT_MCPS:0.0312,SPAD:14.0156,VEL_MM_S:-0.0032,MEAS_RATE_HZ:107.7935,MEAS_AGE_US:0,DT_HALL_US:2000,DT_TOF_US:9277,DT_EST_US:2002,DT_CTRL_US:4065,IDENT_ACTIVE:0,IDENT_STATE:FINALIZADO,IDENT_TYPE:PULSO,IDENT_REP:10,IDENT_REP_MAX:10,IDENT_FASE:0,LIM_PWM:185,LIM_HALL_MV:3129,LIM_ACTUAL_MM:-17.867,LIM_RAW_MM:92.000,DELTA_LIM_MM:-6.589,TEST_PWM:225,TOF_BASE_MM:-11.278,PULSO_HALL_PICO_MV:3129,PULSO_ACTUAL_PICO_MM:-16.246,DELTA_PULSO_MM:-4.969,IDENT_MOTIVO:OK,SYNC_PULSE:0,LIM_HALL_CIMA_MV:1495,PULSO_HALL_CIMA_PICO_MV:1724,SCALE_LOW:-5.00,SCALE_HIGH:30.00
TEST_ID:IDENT_PULSO_SUBIDA_AGR,TEST_PARAM:SIG=PUL;TB=800;BUSCA=5;TPAT=300;RMIN=5.00;MARG=40;TD=1200;TP=150;TE=1000;REP=10,T_US:1739359667,PWM:0,RAW:76.000,ACTUAL:14.233,REF:0.000,ERRO:14.233,HALL_MV:3129,HALL_FILT_MV:3129,HALL_CIMA_MV:1701,HALL_CIMA_FILT_MV:1687,TOF_VALID:1,NEW_TOF:0,RANGE_STATUS:0,SIGNAL_MCPS:22.5391,AMBIENT_MCPS:0.0234,SPAD:14.0156,VEL_MM_S:-0.0034,MEAS_RATE_HZ:13.8829,MEAS_AGE_US:4278,DT_HALL_US:488,DT_TOF_US:72031,DT_EST_US:488,DT_CTRL_US:494,IDENT_ACTIVE:0,IDENT_STATE:FINALIZADO,IDENT_TYPE:PULSO,IDENT_REP:10,IDENT_REP_MAX:10,IDENT_FASE:0,LIM_PWM:185,LIM_HALL_MV:3129,LIM_ACTUAL_MM:-17.867,LIM_RAW_MM:92.000,DELTA_LIM_MM:-6.589,TEST_PWM:225,TOF_BASE_MM:-11.278,PULSO_HALL_PICO_MV:3129,PULSO_ACTUAL_PICO_MM:-16.246,DELTA_PULSO_MM:-4.969,IDENT_MOTIVO:OK,SYNC_PULSE:0,LIM_HALL_CIMA_MV:1495,PULSO_HALL_CIMA_PICO_MV:1724,SCALE_LOW:-5.00,SCALE_HIGH:30.00
TEST_ID:IDENT_PULSO_SUBIDA_AGR,TEST_PARAM:SIG=PUL;TB=800;BUSCA=5;TPAT=300;RMIN=5.00;MARG=40;TD=1200;TP=150;TE=1000;REP=10,T_US:1739505184,PWM:0,RAW:77.000,ACTUAL:14.324,REF:0.000,ERRO:14.324,HALL_MV:3129,HALL_FILT_MV:3129,HALL_CIMA_MV:1710,HALL_CIMA_FILT_MV:1699,TOF_VALID:1,NEW_TOF:0,RANGE_STATUS:0,SIGNAL_MCPS:22.6875,AMBIENT_MCPS:0.0312,SPAD:14.0156,VEL_MM_S:-0.0037,MEAS_RATE_HZ:189.2506,MEAS_AGE_US:4006,DT_HALL_US:1432,DT_TOF_US:5284,DT_EST_US:1417,DT_CTRL_US:1328,IDENT_ACTIVE:0,IDENT_STATE:FINALIZADO,IDENT_TYPE:PULSO,IDENT_REP:10,IDENT_REP_MAX:10,IDENT_FASE:0,LIM_PWM:185,LIM_HALL_MV:3129,LIM_ACTUAL_MM:-17.867,LIM_RAW_MM:92.000,DELTA_LIM_MM:-6.589,TEST_PWM:225,TOF_BASE_MM:-11.278,PULSO_HALL_PICO_MV:3129,PULSO_ACTUAL_PICO_MM:-16.246,DELTA_PULSO_MM:-4.969,IDENT_MOTIVO:OK,SYNC_PULSE:0,LIM_HALL_CIMA_MV:1495,PULSO_HALL_CIMA_PICO_MV:1724,SCALE_LOW:-5.00,SCALE_HIGH:30.00
TEST_ID:IDENT_PULSO_SUBIDA_AGR,TEST_PARAM:SIG=PUL;TB=800;BUSCA=5;TPAT=300;RMIN=5.00;MARG=40;TD=1200;TP=150;TE=1000;REP=10,T_US:1739515184,PWM:0,RAW:76.000,ACTUAL:14.360,REF:0.000,ERRO:14.360,HALL_MV:3129,HALL_FILT_MV:3129,HALL_CIMA_MV:1725,HALL_CIMA_FILT_MV:1702,TOF_VALID:1,NEW_TOF:0,RANGE_STATUS:0,SIGNAL_MCPS:22.6953,AMBIENT_MCPS:0.0234,SPAD:14.0156,VEL_MM_S:-0.0037,MEAS_RATE_HZ:13.5068,MEAS_AGE_US:4299,DT_HALL_US:492,DT_TOF_US:74037,DT_EST_US:486,DT_CTRL_US:488,IDENT_ACTIVE:0,IDENT_STATE:FINALIZADO,IDENT_TYPE:PULSO,IDENT_REP:10,IDENT_REP_MAX:10,IDENT_FASE:0,LIM_PWM:185,LIM_HALL_MV:3129,LIM_ACTUAL_MM:-17.867,LIM_RAW_MM:92.000,DELTA_LIM_MM:-6.589,TEST_PWM:225,TOF_BASE_MM:-11.278,PULSO_HALL_PICO_MV:3129,PULSO_ACTUAL_PICO_MM:-16.246,DELTA_PULSO_MM:-4.969,IDENT_MOTIVO:OK,SYNC_PULSE:0,LIM_HALL_CIMA_MV:1495,PULSO_HALL_CIMA_PICO_MV:1724,SCALE_LOW:-5.00,SCALE_HIGH:30.00
TEST_ID:IDENT_PULSO_SUBIDA_AGR,TEST_PARAM:SIG=PUL;TB=800;BUSCA=5;TPAT=300;RMIN=5.00;MARG=40;TD=1200;TP=150;TE=1000;REP=10,T_US:1739660736,PWM:0,RAW:74.000,ACTUAL:14.411,REF:0.000,ERRO:14.411,HALL_MV:3129,HALL_FILT_MV:3129,HALL_CIMA_MV:1705,HALL_CIMA_FILT_MV:1681,TOF_VALID:1,NEW_TOF:0,RANGE_STATUS:0,SIGNAL_MCPS:22.6172,AMBIENT_MCPS:0.0391,SPAD:14.0156,VEL_MM_S:-0.0037,MEAS_RATE_HZ:200.0000,MEAS_AGE_US:8604,DT_HALL_US:1996,DT_TOF_US:5000,DT_EST_US:1996,DT_CTRL_US:1990,IDENT_ACTIVE:1,IDENT_STATE:CAPTURANDO_BASELINE,IDENT_TYPE:PULSO,IDENT_REP:0,IDENT_REP_MAX:10,IDENT_FASE:1,LIM_PWM:-1,LIM_HALL_MV:0,LIM_ACTUAL_MM:NULL,LIM_RAW_MM:NULL,DELTA_LIM_MM:NULL,TEST_PWM:-1,TOF_BASE_MM:NULL,PULSO_HALL_PICO_MV:0,PULSO_ACTUAL_PICO_MM:NULL,DELTA_PULSO_MM:NULL,IDENT_MOTIVO:EM_ANDAMENTO,SYNC_PULSE:1,LIM_HALL_CIMA_MV:0,PULSO_HALL_CIMA_PICO_MV:0,SCALE_LOW:-5.00,SCALE_HIGH:30.00
TEST_ID:IDENT_PULSO_SUBIDA_AGR,TEST_PARAM:SIG=PUL;TB=800;BUSCA=5;TPAT=300;RMIN=5.00;MARG=40;TD=1200;TP=150;TE=1000;REP=10,T_US:1739670736,PWM:0,RAW:77.000,ACTUAL:14.215,REF:0.000,ERRO:14.215,HALL_MV:3129,HALL_FILT_MV:3129,HALL_CIMA_MV:1675,HALL_CIMA_FILT_MV:1685,TOF_VALID:1,NEW_TOF:0,RANGE_STATUS:0,SIGNAL_MCPS:22.7109,AMBIENT_MCPS:0.0312,SPAD:14.0156,VEL_MM_S:-0.0022,MEAS_RATE_HZ:12.8154,MEAS_AGE_US:4347,DT_HALL_US:492,DT_TOF_US:78031,DT_EST_US:490,DT_CTRL_US:489,IDENT_ACTIVE:1,IDENT_STATE:CAPTURANDO_BASELINE,IDENT_TYPE:PULSO,IDENT_REP:0,IDENT_REP_MAX:10,IDENT_FASE:1,LIM_PWM:-1,LIM_HALL_MV:0,LIM_ACTUAL_MM:NULL,LIM_RAW_MM:NULL,DELTA_LIM_MM:NULL,TEST_PWM:-1,TOF_BASE_MM:NULL,PULSO_HALL_PICO_MV:0,PULSO_ACTUAL_PICO_MM:NULL,DELTA_PULSO_MM:NULL,IDENT_MOTIVO:EM_ANDAMENTO,SYNC_PULSE:1,LIM_HALL_CIMA_MV:0,PULSO_HALL_CIMA_PICO_MV:0,SCALE_LOW:-5.00,SCALE_HIGH:30.00
TEST_ID:IDENT_PULSO_SUBIDA_AGR,TEST_PARAM:SIG=PUL;TB=800;BUSCA=5;TPAT=300;RMIN=5.00;MARG=40;TD=1200;TP=150;TE=1000;REP=10,T_US:1739813212,PWM:0,RAW:77.000,ACTUAL:14.027,REF:0.000,ERRO:14.027,HALL_MV:3129,HALL_FILT_MV:3129,HALL_CIMA_MV:1717,HALL_CIMA_FILT_MV:1696,TOF_VALID:1,NEW_TOF:0,RANGE_STATUS:0,SIGNAL_MCPS:22.6406,AMBIENT_MCPS:0.0312,SPAD:14.0156,VEL_MM_S:-0.0009,MEAS_RATE_HZ:13.5555,MEAS_AGE_US:9281,DT_HALL_US:1999,DT_TOF_US:73771,DT_EST_US:2001,DT_CTRL_US:1999,IDENT_ACTIVE:1,IDENT_STATE:CAPTURANDO_BASELINE,IDENT_TYPE:PULSO,IDENT_REP:0,IDENT_REP_MAX:10,IDENT_FASE:1,LIM_PWM:-1,LIM_HALL_MV:0,LIM_ACTUAL_MM:NULL,LIM_RAW_MM:NULL,DELTA_LIM_MM:NULL,TEST_PWM:-1,TOF_BASE_MM:NULL,PULSO_HALL_PICO_MV:0,PULSO_ACTUAL_PICO_MM:NULL,DELTA_PULSO_MM:NULL,IDENT_MOTIVO:EM_ANDAMENTO,SYNC_PULSE:1,LIM_HALL_CIMA_MV:0,PULSO_HALL_CIMA_PICO_MV:0,SCALE_LOW:-5.00,SCALE_HIGH:30.00
TEST_ID:IDENT_PULSO_SUBIDA_AGR,TEST_PARAM:SIG=PUL;TB=800;BUSCA=5;TPAT=300;RMIN=5.00;MARG=40;TD=1200;TP=150;TE=1000;REP=10,T_US:1739823212,PWM:0,RAW:76.000,ACTUAL:14.098,REF:0.000,ERRO:14.098,HALL_MV:3129,HALL_FILT_MV:3129,HALL_CIMA_MV:1760,HALL_CIMA_FILT_MV:1713,TOF_VALID:1,NEW_TOF:0,RANGE_STATUS:0,SIGNAL_MCPS:22.7656,AMBIENT_MCPS:0.0234,SPAD:14.0156,VEL_MM_S:-0.0012,MEAS_RATE_HZ:12.7210,MEAS_AGE_US:4265,DT_HALL_US:489,DT_TOF_US:78610,DT_EST_US:486,DT_CTRL_US:495,IDENT_ACTIVE:1,IDENT_STATE:CAPTURANDO_BASELINE,IDENT_TYPE:PULSO,IDENT_REP:0,IDENT_REP_MAX:10,IDENT_FASE:1,LIM_PWM:-1,LIM_HALL_MV:0,LIM_ACTUAL_MM:NULL,LIM_RAW_MM:NULL,DELTA_LIM_MM:NULL,TEST_PWM:-1,TOF_BASE_MM:NULL,PULSO_HALL_PICO_MV:0,PULSO_ACTUAL_PICO_MM:NULL,DELTA_PULSO_MM:NULL,IDENT_MOTIVO:EM_ANDAMENTO,SYNC_PULSE:1,LIM_HALL_CIMA_MV:0,PULSO_HALL_CIMA_PICO_MV:0,SCALE_LOW:-5.00,SCALE_HIGH:30.00
TEST_ID:IDENT_PULSO_SUBIDA_AGR,TEST_PARAM:SIG=PUL;TB=800;BUSCA=5;TPAT=300;RMIN=5.00;MARG=40;TD=1200;TP=150;TE=1000;REP=10,T_US:1739965425,PWM:0,RAW:77.000,ACTUAL:13.910,REF:0.000,ERRO:13.910,HALL_MV:3129,HALL_FILT_MV:3129,HALL_CIMA_MV:1696,HALL_CIMA_FILT_MV:1701,TOF_VALID:1,NEW_TOF:0,RANGE_STATUS:0,SIGNAL_MCPS:24.3516,AMBIENT_MCPS:0.0312,SPAD:15.0156,VEL_MM_S:-0.0000,MEAS_RATE_HZ:13.5855,MEAS_AGE_US:9272,DT_HALL_US:2000,DT_TOF_US:73608,DT_EST_US:2002,DT_CTRL_US:2000,IDENT_ACTIVE:1,IDENT_STATE:CAPTURANDO_BASELINE,IDENT_TYPE:PULSO,IDENT_REP:0,IDENT_REP_MAX:10,IDENT_FASE:1,LIM_PWM:-1,LIM_HALL_MV:0,LIM_ACTUAL_MM:NULL,LIM_RAW_MM:NULL,DELTA_LIM_MM:NULL,TEST_PWM:-1,TOF_BASE_MM:NULL,PULSO_HALL_PICO_MV:0,PULSO_ACTUAL_PICO_MM:NULL,DELTA_PULSO_MM:NULL,IDENT_MOTIVO:EM_ANDAMENTO,SYNC_PULSE:0,LIM_HALL_CIMA_MV:0,PULSO_HALL_CIMA_PICO_MV:0,SCALE_LOW:-5.00,SCALE_HIGH:30.00
TEST_ID:IDENT_PULSO_SUBIDA_AGR,TEST_PARAM:SIG=PUL;TB=800;BUSCA=5;TPAT=300;RMIN=5.00;MARG=40;TD=1200;TP=150;TE=1000;REP=10,T_US:1739975425,PWM:0,RAW:74.000,ACTUAL:14.506,REF:0.000,ERRO:14.506,HALL_MV:3129,HALL_FILT_MV:3129,HALL_CIMA_MV:1664,HALL_CIMA_FILT_MV:1683,TOF_VALID:1,NEW_TOF:0,RANGE_STATUS:0,SIGNAL_MCPS:22.6250,AMBIENT_MCPS:0.0234,SPAD:14.0156,VEL_MM_S:-0.0035,MEAS_RATE_HZ:12.7094,MEAS_AGE_US:4265,DT_HALL_US:488,DT_TOF_US:78682,DT_EST_US:486,DT_CTRL_US:493,IDENT_ACTIVE:1,IDENT_STATE:CAPTURANDO_BASELINE,IDENT_TYPE:PULSO,IDENT_REP:0,IDENT_REP_MAX:10,IDENT_FASE:1,LIM_PWM:-1,LIM_HALL_MV:0,LIM_ACTUAL_MM:NULL,LIM_RAW_MM:NULL,DELTA_LIM_MM:NULL,TEST_PWM:-1,TOF_BASE_MM:NULL,PULSO_HALL_PICO_MV:0,PULSO_ACTUAL_PICO_MM:NULL,DELTA_PULSO_MM:NULL,IDENT_MOTIVO:EM_ANDAMENTO,SYNC_PULSE:0,LIM_HALL_CIMA_MV:0,PULSO_HALL_CIMA_PICO_MV:0,SCALE_LOW:-5.00,SCALE_HIGH:30.00
TEST_ID:IDENT_PULSO_SUBIDA_AGR,TEST_PARAM:SIG=PUL;TB=800;BUSCA=5;TPAT=300;RMIN=5.00;MARG=40;TD=1200;TP=150;TE=1000;REP=10,T_US:1740117717,PWM:0,RAW:75.000,ACTUAL:14.775,REF:0.000,ERRO:14.775,HALL_MV:3129,HALL_FILT_MV:3129,HALL_CIMA_MV:1742,HALL_CIMA_FILT_MV:1697,TOF_VALID:1,NEW_TOF:0,RANGE_STATUS:0,SIGNAL_MCPS:22.6250,AMBIENT_MCPS:0.0234,SPAD:14.0156,VEL_MM_S:-0.0047,MEAS_RATE_HZ:13.5851,MEAS_AGE_US:9273,DT_HALL_US:1996,DT_TOF_US:73610,DT_EST_US:1998,DT_CTRL_US:1996,IDENT_ACTIVE:1,IDENT_STATE:CAPTURANDO_BASELINE,IDENT_TYPE:PULSO,IDENT_REP:0,IDENT_REP_MAX:10,IDENT_FASE:1,LIM_PWM:-1,LIM_HALL_MV:0,LIM_ACTUAL_MM:NULL,LIM_RAW_MM:NULL,DELTA_LIM_MM:NULL,TEST_PWM:-1,TOF_BASE_MM:NULL,PULSO_HALL_PICO_MV:0,PULSO_ACTUAL_PICO_MM:NULL,DELTA_PULSO_MM:NULL,IDENT_MOTIVO:EM_ANDAMENTO,SYNC_PULSE:0,LIM_HALL_CIMA_MV:0,PULSO_HALL_CIMA_PICO_MV:0,SCALE_LOW:-5.00,SCALE_HIGH:30.00
TEST_ID:IDENT_PULSO_SUBIDA_AGR,TEST_PARAM:SIG=PUL;TB=800;BUSCA=5;TPAT=300;RMIN=5.00;MARG=40;TD=1200;TP=150;TE=1000;REP=10,T_US:1740127717,PWM:0,RAW:76.000,ACTUAL:14.759,REF:0.000,ERRO:14.759,HALL_MV:3129,HALL_FILT_MV:3129,HALL_CIMA_MV:1697,HALL_CIMA_FILT_MV:1700,TOF_VALID:1,NEW_TOF:0,RANGE_STATUS:0,SIGNAL_MCPS:22.5000,AMBIENT_MCPS:0.0234,SPAD:14.0156,VEL_MM_S:-0.0043,MEAS_RATE_HZ:12.7078,MEAS_AGE_US:4264,DT_HALL_US:491,DT_TOF_US:78692,DT_EST_US:489,DT_CTRL_US:488,IDENT_ACTIVE:1,IDENT_STATE:CAPTURANDO_BASELINE,IDENT_TYPE:PULSO,IDENT_REP:0,IDENT_REP_MAX:10,IDENT_FASE:1,LIM_PWM:-1,LIM_HALL_MV:0,LIM_ACTUAL_MM:NULL,LIM_RAW_MM:NULL,DELTA_LIM_MM:NULL,TEST_PWM:-1,TOF_BASE_MM:NULL,PULSO_HALL_PICO_MV:0,PULSO_ACTUAL_PICO_MM:NULL,DELTA_PULSO_MM:NULL,IDENT_MOTIVO:EM_ANDAMENTO,SYNC_PULSE:0,LIM_HALL_CIMA_MV:0,PULSO_HALL_CIMA_PICO_MV:0,SCALE_LOW:-5.00,SCALE_HIGH:30.00
TEST_ID:IDENT_PULSO_SUBIDA_AGR,TEST_PARAM:SIG=PUL;TB=800;BUSCA=5;TPAT=300;RMIN=5.00;MARG=40;TD=1200;TP=150;TE=1000;REP=10,T_US:1740270024,PWM:0,RAW:75.000,ACTUAL:15.014,REF:0.000,ERRO:15.014,HALL_MV:3129,HALL_FILT_MV:3129,HALL_CIMA_MV:1648,HALL_CIMA_FILT_MV:1669,TOF_VALID:1,NEW_TOF:0,RANGE_STATUS:0,SIGNAL_MCPS:22.5469,AMBIENT_MCPS:0.0234,SPAD:14.0156,VEL_MM_S:-0.0054,MEAS_RATE_HZ:13.5868,MEAS_AGE_US:9286,DT_HALL_US:1996,DT_TOF_US:73601,DT_EST_US:1999,DT_CTRL_US:1996,IDENT_ACTIVE:1,IDENT_STATE:CAPTURANDO_BASELINE,IDENT_TYPE:PULSO,IDENT_REP:0,IDENT_REP_MAX:10,IDENT_FASE:1,LIM_PWM:-1,LIM_HALL_MV:0,LIM_ACTUAL_MM:NULL,LIM_RAW_MM:NULL,DELTA_LIM_MM:NULL,TEST_PWM:-1,TOF_BASE_MM:NULL,PULSO_HALL_PICO_MV:0,PULSO_ACTUAL_PICO_MM:NULL,DELTA_PULSO_MM:NULL,IDENT_MOTIVO:EM_ANDAMENTO,SYNC_PULSE:0,LIM_HALL_CIMA_MV:0,PULSO_HALL_CIMA_PICO_MV:0,SCALE_LOW:-5.00,SCALE_HIGH:30.00
TEST_ID:IDENT_PULSO_SUBIDA_AGR,TEST_PARAM:SIG=PUL;TB=800;BUSCA=5;TPAT=300;RMIN=5.00;MARG=40;TD=1200;TP=150;TE=1000;REP=10,T_US:1740280024,PWM:0,RAW:75.000,ACTUAL:15.257,REF:0.000,ERRO:15.257,HALL_MV:3129,HALL_FILT_MV:3129,HALL_CIMA_MV:1659,HALL_CIMA_FILT_MV:1673,TOF_VALID:1,NEW_TOF:0,RANGE_STATUS:0,SIGNAL_MCPS:22.6719,AMBIENT_MCPS:0.0234,SPAD:14.0156,VEL_MM_S:-0.0063,MEAS_RATE_HZ:12.7191,MEAS_AGE_US:4265,DT_HALL_US:492,DT_TOF_US:78622,DT_EST_US:491,DT_CTRL_US:490,IDENT_ACTIVE:1,IDENT_STATE:CAPTURANDO_BASELINE,IDENT_TYPE:PULSO,IDENT_REP:0,IDENT_REP_MAX:10,IDENT_FASE:1,LIM_PWM:-1,LIM_HALL_MV:0,LIM_ACTUAL_MM:NULL,LIM_RAW_MM:NULL,DELTA_LIM_MM:NULL,TEST_PWM:-1,TOF_BASE_MM:NULL,PULSO_HALL_PICO_MV:0,PULSO_ACTUAL_PICO_MM:NULL,DELTA_PULSO_MM:NULL,IDENT_MOTIVO:EM_ANDAMENTO,SYNC_PULSE:0,LIM_HALL_CIMA_MV:0,PULSO_HALL_CIMA_PICO_MV:0,SCALE_LOW:-5.00,SCALE_HIGH:30.00
TEST_ID:IDENT_PULSO_SUBIDA_AGR,TEST_PARAM:SIG=PUL;TB=800;BUSCA=5;TPAT=300;RMIN=5.00;MARG=40;TD=1200;TP=150;TE=1000;REP=10,T_US:1740422230,PWM:0,RAW:75.000,ACTUAL:15.476,REF:0.000,ERRO:15.476,HALL_MV:3129,HALL_FILT_MV:3129,HALL_CIMA_MV:1703,HALL_CIMA_FILT_MV:1697,TOF_VALID:1,NEW_TOF:0,RANGE_STATUS:0,SIGNAL_MCPS:22.6094,AMBIENT_MCPS:0.0312,SPAD:14.0156,VEL_MM_S:-0.0069,MEAS_RATE_HZ:13.5871,MEAS_AGE_US:9280,DT_HALL_US:1999,DT_TOF_US:73599,DT_EST_US:2002,DT_CTRL_US:2000,IDENT_ACTIVE:1,IDENT_STATE:CAPTURANDO_BASELINE,IDENT_TYPE:PULSO,IDENT_REP:0,IDENT_REP_MAX:10,IDENT_FASE:1,LIM_PWM:-1,LIM_HALL_MV:0,LIM_ACTUAL_MM:NULL,LIM_RAW_MM:NULL,DELTA_LIM_MM:NULL,TEST_PWM:-1,TOF_BASE_MM:NULL,PULSO_HALL_PICO_MV:0,PULSO_ACTUAL_PICO_MM:NULL,DELTA_PULSO_MM:NULL,IDENT_MOTIVO:EM_ANDAMENTO,SYNC_PULSE:0,LIM_HALL_CIMA_MV:0,PULSO_HALL_CIMA_PICO_MV:0,SCALE_LOW:-5.00,SCALE_HIGH:30.00
TEST_ID:IDENT_PULSO_SUBIDA_AGR,TEST_PARAM:SIG=PUL;TB=800;BUSCA=5;TPAT=300;RMIN=5.00;MARG=40;TD=1200;TP=150;TE=1000;REP=10,T_US:1740432230,PWM:5,RAW:77.000,ACTUAL:15.068,REF:0.000,ERRO:15.068,HALL_MV:3129,HALL_FILT_MV:3129,HALL_CIMA_MV:1680,HALL_CIMA_FILT_MV:1704,TOF_VALID:1,NEW_TOF:0,RANGE_STATUS:0,SIGNAL_MCPS:22.6484,AMBIENT_MCPS:0.0234,SPAD:14.0156,VEL_MM_S:-0.0042,MEAS_RATE_HZ:12.7079,MEAS_AGE_US:4262,DT_HALL_US:488,DT_TOF_US:78691,DT_EST_US:487,DT_CTRL_US:492,IDENT_ACTIVE:1,IDENT_STATE:BUSCANDO_LIMIAR,IDENT_TYPE:PULSO,IDENT_REP:0,IDENT_REP_MAX:10,IDENT_FASE:1,LIM_PWM:-1,LIM_HALL_MV:0,LIM_ACTUAL_MM:NULL,LIM_RAW_MM:NULL,DELTA_LIM_MM:NULL,TEST_PWM:-1,TOF_BASE_MM:14.602,PULSO_HALL_PICO_MV:0,PULSO_ACTUAL_PICO_MM:NULL,DELTA_PULSO_MM:NULL,IDENT_MOTIVO:EM_ANDAMENTO,SYNC_PULSE:0,LIM_HALL_CIMA_MV:0,PULSO_HALL_CIMA_PICO_MV:0,SCALE_LOW:-5.00,SCALE_HIGH:30.00
TEST_ID:IDENT_PULSO_SUBIDA_AGR,TEST_PARAM:SIG=PUL;TB=800;BUSCA=5;TPAT=300;RMIN=5.00;MARG=40;TD=1200;TP=150;TE=1000;REP=10,T_US:1740574704,PWM:5,RAW:76.000,ACTUAL:15.010,REF:0.000,ERRO:15.010,HALL_MV:3129,HALL_FILT_MV:3129,HALL_CIMA_MV:1681,HALL_CIMA_FILT_MV:1712,TOF_VALID:1,NEW_TOF:0,RANGE_STATUS:0,SIGNAL_MCPS:22.6172,AMBIENT_MCPS:0.0234,SPAD:14.0156,VEL_MM_S:-0.0036,MEAS_RATE_HZ:13.5534,MEAS_AGE_US:9278,DT_HALL_US:2008,DT_TOF_US:73782,DT_EST_US:2009,DT_CTRL_US:2007,IDENT_ACTIVE:1,IDENT_STATE:BUSCANDO_LIMIAR,IDENT_TYPE:PULSO,IDENT_REP:0,IDENT_REP_MAX:10,IDENT_FASE:1,LIM_PWM:-1,LIM_HALL_MV:0,LIM_ACTUAL_MM:NULL,LIM_RAW_MM:NULL,DELTA_LIM_MM:NULL,TEST_PWM:-1,TOF_BASE_MM:14.602,PULSO_HALL_PICO_MV:0,PULSO_ACTUAL_PICO_MM:NULL,DELTA_PULSO_MM:NULL,IDENT_MOTIVO:EM_ANDAMENTO,SYNC_PULSE:0,LIM_HALL_CIMA_MV:0,PULSO_HALL_CIMA_PICO_MV:0,SCALE_LOW:-5.00,SCALE_HIGH:30.00
TEST_ID:IDENT_PULSO_SUBIDA_AGR,TEST_PARAM:SIG=PUL;TB=800;BUSCA=5;TPAT=300;RMIN=5.00;MARG=40;TD=1200;TP=150;TE=1000;REP=10,T_US:1740584704,PWM:5,RAW:79.000,ACTUAL:13.781,REF:0.000,ERRO:13.781,HALL_MV:3129,HALL_FILT_MV:3129,HALL_CIMA_MV:1684,HALL_CIMA_FILT_MV:1708,TOF_VALID:1,NEW_TOF:0,RANGE_STATUS:0,SIGNAL_MCPS:22.5391,AMBIENT_MCPS:0.0234,SPAD:14.0156,VEL_MM_S:0.0018,MEAS_RATE_HZ:12.6928,MEAS_AGE_US:4263,DT_HALL_US:493,DT_TOF_US:78785,DT_EST_US:490,DT_CTRL_US:488,IDENT_ACTIVE:1,IDENT_STATE:BUSCANDO_LIMIAR,IDENT_TYPE:PULSO,IDENT_REP:0,IDENT_REP_MAX:10,IDENT_FASE:1,LIM_PWM:-1,LIM_HALL_MV:0,LIM_ACTUAL_MM:NULL,LIM_RAW_MM:NULL,DELTA_LIM_MM:NULL,TEST_PWM:-1,TOF_BASE_MM:14.602,PULSO_HALL_PICO_MV:0,PULSO_ACTUAL_PICO_MM:NULL,DELTA_PULSO_MM:NULL,IDENT_MOTIVO:EM_ANDAMENTO,SYNC_PULSE:0,LIM_HALL_CIMA_MV:0,PULSO_HALL_CIMA_PICO_MV:0,SCALE_LOW:-5.00,SCALE_HIGH:30.00
TEST_ID:IDENT_PULSO_SUBIDA_AGR,TEST_PARAM:SIG=PUL;TB=800;BUSCA=5;TPAT=300;RMIN=5.00;MARG=40;TD=1200;TP=150;TE=1000;REP=10,T_US:1740727322,PWM:5,RAW:76.000,ACTUAL:13.920,REF:0.000,ERRO:13.920,HALL_MV:3129,HALL_FILT_MV:3129,HALL_CIMA_MV:1685,HALL_CIMA_FILT_MV:1705,TOF_VALID:1,NEW_TOF:0,RANGE_STATUS:0,SIGNAL_MCPS:22.7109,AMBIENT_MCPS:0.0234,SPAD:14.0156,VEL_MM_S:0.0009,MEAS_RATE_HZ:13.5461,MEAS_AGE_US:9285,DT_HALL_US:2000,DT_TOF_US:73822,DT_EST_US:2002,DT_CTRL_US:1999,IDENT_ACTIVE:1,IDENT_STATE:BUSCANDO_LIMIAR,IDENT_TYPE:PULSO,IDENT_REP:0,IDENT_REP_MAX:10,IDENT_FASE:1,LIM_PWM:-1,LIM_HALL_MV:0,LIM_ACTUAL_MM:NULL,LIM_RAW_MM:NULL,DELTA_LIM_MM:NULL,TEST_PWM:-1,TOF_BASE_MM:14.602,PULSO_HALL_PICO_MV:0,PULSO_ACTUAL_PICO_MM:NULL,DELTA_PULSO_MM:NULL,IDENT_MOTIVO:EM_ANDAMENTO,SYNC_PULSE:0,LIM_HALL_CIMA_MV:0,PULSO_HALL_CIMA_PICO_MV:0,SCALE_LOW:-5.00,SCALE_HIGH:30.00
TEST_ID:IDENT_PULSO_SUBIDA_AGR,TEST_PARAM:SIG=PUL;TB=800;BUSCA=5;TPAT=300;RMIN=5.00;MARG=40;TD=1200;TP=150;TE=1000;REP=10,T_US:1740737322,PWM:10,RAW:73.000,ACTUAL:14.927,REF:0.000,ERRO:14.927,HALL_MV:3129,HALL_FILT_MV:3129,HALL_CIMA_MV:1685,HALL_CIMA_FILT_MV:1715,TOF_VALID:1,NEW_TOF:0,RANGE_STATUS:0,SIGNAL_MCPS:22.6875,AMBIENT_MCPS:0.0312,SPAD:14.0156,VEL_MM_S:-0.0054,MEAS_RATE_HZ:12.6933,MEAS_AGE_US:4269,DT_HALL_US:488,DT_TOF_US:78782,DT_EST_US:486,DT_CTRL_US:493,IDENT_ACTIVE:1,IDENT_STATE:BUSCANDO_LIMIAR,IDENT_TYPE:PULSO,IDENT_REP:0,IDENT_REP_MAX:10,IDENT_FASE:1,LIM_PWM:-1,LIM_HALL_MV:0,LIM_ACTUAL_MM:NULL,LIM_RAW_MM:NULL,DELTA_LIM_MM:NULL,TEST_PWM:-1,TOF_BASE_MM:14.602,PULSO_HALL_PICO_MV:0,PULSO_ACTUAL_PICO_MM:NULL,DELTA_PULSO_MM:NULL,IDENT_MOTIVO:EM_ANDAMENTO,SYNC_PULSE:0,LIM_HALL_CIMA_MV:0,PULSO_HALL_CIMA_PICO_MV:0,SCALE_LOW:-5.00,SCALE_HIGH:30.00
TEST_ID:IDENT_PULSO_SUBIDA_AGR,TEST_PARAM:SIG=PUL;TB=800;BUSCA=5;TPAT=300;RMIN=5.00;MARG=40;TD=1200;TP=150;TE=1000;REP=10,T_US:1740879924,PWM:10,RAW:77.000,ACTUAL:14.617,REF:0.000,ERRO:14.617,HALL_MV:3129,HALL_FILT_MV:3129,HALL_CIMA_MV:1673,HALL_CIMA_FILT_MV:1673,TOF_VALID:1,NEW_TOF:0,RANGE_STATUS:0,SIGNAL_MCPS:22.7734,AMBIENT_MCPS:0.0234,SPAD:14.0156,VEL_MM_S:-0.0028,MEAS_RATE_HZ:13.5450,MEAS_AGE_US:9278,DT_HALL_US:2000,DT_TOF_US:73828,DT_EST_US:2002,DT_CTRL_US:2000,IDENT_ACTIVE:1,IDENT_STATE:BUSCANDO_LIMIAR,IDENT_TYPE:PULSO,IDENT_REP:0,IDENT_REP_MAX:10,IDENT_FASE:1,LIM_PWM:-1,LIM_HALL_MV:0,LIM_ACTUAL_MM:NULL,LIM_RAW_MM:NULL,DELTA_LIM_MM:NULL,TEST_PWM:-1,TOF_BASE_MM:14.602,PULSO_HALL_PICO_MV:0,PULSO_ACTUAL_PICO_MM:NULL,DELTA_PULSO_MM:NULL,IDENT_MOTIVO:EM_ANDAMENTO,SYNC_PULSE:0,LIM_HALL_CIMA_MV:0,PULSO_HALL_CIMA_PICO_MV:0,SCALE_LOW:-5.00,SCALE_HIGH:30.00
TEST_ID:IDENT_PULSO_SUBIDA_AGR,TEST_PARAM:SIG=PUL;TB=800;BUSCA=5;TPAT=300;RMIN=5.00;MARG=40;TD=1200;TP=150;TE=1000;REP=10,T_US:1740889924,PWM:10,RAW:76.000,ACTUAL:14.620,REF:0.000,ERRO:14.620,HALL_MV:3129,HALL_FILT_MV:3129,HALL_CIMA_MV:1718,HALL_CIMA_FILT_MV:1687,TOF_VALID:1,NEW_TOF:0,RANGE_STATUS:0,SIGNAL_MCPS:22.5469,AMBIENT_MCPS:0.0312,SPAD:14.0156,VEL_MM_S:-0.0027,MEAS_RATE_HZ:12.6937,MEAS_AGE_US:4270,DT_HALL_US:493,DT_TOF_US:78779,DT_EST_US:486,DT_CTRL_US:490,IDENT_ACTIVE:1,IDENT_STATE:BUSCANDO_LIMIAR,IDENT_TYPE:PULSO,IDENT_REP:0,IDENT_REP_MAX:10,IDENT_FASE:1,LIM_PWM:-1,LIM_HALL_MV:0,LIM_ACTUAL_MM:NULL,LIM_RAW_MM:NULL,DELTA_LIM_MM:NULL,TEST_PWM:-1,TOF_BASE_MM:14.602,PULSO_HALL_PICO_MV:0,PULSO_ACTUAL_PICO_MM:NULL,DELTA_PULSO_MM:NULL,IDENT_MOTIVO:EM_ANDAMENTO,SYNC_PULSE:0,LIM_HALL_CIMA_MV:0,PULSO_HALL_CIMA_PICO_MV:0,SCALE_LOW:-5.00,SCALE_HIGH:30.00
TEST_ID:IDENT_PULSO_SUBIDA_AGR,TEST_PARAM:SIG=PUL;TB=800;BUSCA=5;TPAT=300;RMIN=5.00;MARG=40;TD=1200;TP=150;TE=1000;REP=10,T_US:1741032468,PWM:10,RAW:78.000,ACTUAL:14.095,REF:0.000,ERRO:14.095,HALL_MV:3129,HALL_FILT_MV:3129,HALL_CIMA_MV:1723,HALL_CIMA_FILT_MV:1689,TOF_VALID:1,NEW_TOF:0,RANGE_STATUS:0,SIGNAL_MCPS:22.5938,AMBIENT_MCPS:0.0234,SPAD:14.0156,VEL_MM_S:0.0016,MEAS_RATE_HZ:13.5569,MEAS_AGE_US:9280,DT_HALL_US:2000,DT_TOF_US:73763,DT_EST_US:2002,DT_CTRL_US:2000,IDENT_ACTIVE:1,IDENT_STATE:BUSCANDO_LIMIAR,IDENT_TYPE:PULSO,IDENT_REP:0,IDENT_REP_MAX:10,IDENT_FASE:1,LIM_PWM:-1,LIM_HALL_MV:0,LIM_ACTUAL_MM:NULL,LIM_RAW_MM:NULL,DELTA_LIM_MM:NULL,TEST_PWM:-1,TOF_BASE_MM:14.602,PULSO_HALL_PICO_MV:0,PULSO_ACTUAL_PICO_MM:NULL,DELTA_PULSO_MM:NULL,IDENT_MOTIVO:EM_ANDAMENTO,SYNC_PULSE:0,LIM_HALL_CIMA_MV:0,PULSO_HALL_CIMA_PICO_MV:0,SCALE_LOW:-5.00,SCALE_HIGH:30.00
TEST_ID:IDENT_PULSO_SUBIDA_AGR,TEST_PARAM:SIG=PUL;TB=800;BUSCA=5;TPAT=300;RMIN=5.00;MARG=40;TD=1200;TP=150;TE=1000;REP=10,T_US:1741042468,PWM:15,RAW:75.000,ACTUAL:14.211,REF:0.000,ERRO:14.211,HALL_MV:3129,HALL_FILT_MV:3129,HALL_CIMA_MV:1641,HALL_CIMA_FILT_MV:1688,TOF_VALID:1,NEW_TOF:0,RANGE_STATUS:0,SIGNAL_MCPS:22.5625,AMBIENT_MCPS:0.0234,SPAD:14.0156,VEL_MM_S:0.0005,MEAS_RATE_HZ:200.0000,MEAS_AGE_US:2562,DT_HALL_US:2538,DT_TOF_US:5000,DT_EST_US:2556,DT_CTRL_US:629,IDENT_ACTIVE:1,IDENT_STATE:BUSCANDO_LIMIAR,IDENT_TYPE:PULSO,IDENT_REP:0,IDENT_REP_MAX:10,IDENT_FASE:1,LIM_PWM:-1,LIM_HALL_MV:0,LIM_ACTUAL_MM:NULL,LIM_RAW_MM:NULL,DELTA_LIM_MM:NULL,TEST_PWM:-1,TOF_BASE_MM:14.602,PULSO_HALL_PICO_MV:0,PULSO_ACTUAL_PICO_MM:NULL,DELTA_PULSO_MM:NULL,IDENT_MOTIVO:EM_ANDAMENTO,SYNC_PULSE:0,LIM_HALL_CIMA_MV:0,PULSO_HALL_CIMA_PICO_MV:0,SCALE_LOW:-5.00,SCALE_HIGH:30.00
TEST_ID:IDENT_PULSO_SUBIDA_AGR,TEST_PARAM:SIG=PUL;TB=800;BUSCA=5;TPAT=300;RMIN=5.00;MARG=40;TD=1200;TP=150;TE=1000;REP=10,T_US:1741187180,PWM:15,RAW:75.000,ACTUAL:14.499,REF:0.000,ERRO:14.499,HALL_MV:3129,HALL_FILT_MV:3129,HALL_CIMA_MV:1653,HALL_CIMA_FILT_MV:1670,TOF_VALID:1,NEW_TOF:0,RANGE_STATUS:0,SIGNAL_MCPS:22.7656,AMBIENT_MCPS:0.0312,SPAD:14.0156,VEL_MM_S:-0.0017,MEAS_RATE_HZ:13.8596,MEAS_AGE_US:9283,DT_HALL_US:1998,DT_TOF_US:72152,DT_EST_US:2001,DT_CTRL_US:1998,IDENT_ACTIVE:1,IDENT_STATE:BUSCANDO_LIMIAR,IDENT_TYPE:PULSO,IDENT_REP:0,IDENT_REP_MAX:10,IDENT_FASE:1,LIM_PWM:-1,LIM_HALL_MV:0,LIM_ACTUAL_MM:NULL,LIM_RAW_MM:NULL,DELTA_LIM_MM:NULL,TEST_PWM:-1,TOF_BASE_MM:14.602,PULSO_HALL_PICO_MV:0,PULSO_ACTUAL_PICO_MM:NULL,DELTA_PULSO_MM:NULL,IDENT_MOTIVO:EM_ANDAMENTO,SYNC_PULSE:0,LIM_HALL_CIMA_MV:0,PULSO_HALL_CIMA_PICO_MV:0,SCALE_LOW:-5.00,SCALE_HIGH:30.00
TEST_ID:IDENT_PULSO_SUBIDA_AGR,TEST_PARAM:SIG=PUL;TB=800;BUSCA=5;TPAT=300;RMIN=5.00;MARG=40;TD=1200;TP=150;TE=1000;REP=10,T_US:1741197180,PWM:15,RAW:77.000,ACTUAL:14.260,REF:0.000,ERRO:14.260,HALL_MV:3129,HALL_FILT_MV:3129,HALL_CIMA_MV:1705,HALL_CIMA_FILT_MV:1684,TOF_VALID:1,NEW_TOF:0,RANGE_STATUS:0,SIGNAL_MCPS:22.7500,AMBIENT_MCPS:0.0312,SPAD:14.0156,VEL_MM_S:0.0002,MEAS_RATE_HZ:12.6937,MEAS_AGE_US:4272,DT_HALL_US:488,DT_TOF_US:78779,DT_EST_US:489,DT_CTRL_US:496,IDENT_ACTIVE:1,IDENT_STATE:BUSCANDO_LIMIAR,IDENT_TYPE:PULSO,IDENT_REP:0,IDENT_REP_MAX:10,IDENT_FASE:1,LIM_PWM:-1,LIM_HALL_MV:0,LIM_ACTUAL_MM:NULL,LIM_RAW_MM:NULL,DELTA_LIM_MM:NULL,TEST_PWM:-1,TOF_BASE_MM:14.602,PULSO_HALL_PICO_MV:0,PULSO_ACTUAL_PICO_MM:NULL,DELTA_PULSO_MM:NULL,IDENT_MOTIVO:EM_ANDAMENTO,SYNC_PULSE:0,LIM_HALL_CIMA_MV:0,PULSO_HALL_CIMA_PICO_MV:0,SCALE_LOW:-5.00,SCALE_HIGH:30.00
TEST_ID:IDENT_PULSO_SUBIDA_AGR,TEST_PARAM:SIG=PUL;TB=800;BUSCA=5;TPAT=300;RMIN=5.00;MARG=40;TD=1200;TP=150;TE=1000;REP=10,T_US:1741339782,PWM:15,RAW:75.000,ACTUAL:14.562,REF:0.000,ERRO:14.562,HALL_MV:3129,HALL_FILT_MV:3129,HALL_CIMA_MV:1641,HALL_CIMA_FILT_MV:1679,TOF_VALID:1,NEW_TOF:0,RANGE_STATUS:0,SIGNAL_MCPS:22.6563,AMBIENT_MCPS:0.0312,SPAD:14.0156,VEL_MM_S:-0.0021,MEAS_RATE_HZ:13.5441,MEAS_AGE_US:9270,DT_HALL_US:2000,DT_TOF_US:73833,DT_EST_US:2002,DT_CTRL_US:2000,IDENT_ACTIVE:1,IDENT_STATE:BUSCANDO_LIMIAR,IDENT_TYPE:PULSO,IDENT_REP:0,IDENT_REP_MAX:10,IDENT_FASE:1,LIM_PWM:-1,LIM_HALL_MV:0,LIM_ACTUAL_MM:NULL,LIM_RAW_MM:NULL,DELTA_LIM_MM:NULL,TEST_PWM:-1,TOF_BASE_MM:14.602,PULSO_HALL_PICO_MV:0,PULSO_ACTUAL_PICO_MM:NULL,DELTA_PULSO_MM:NULL,IDENT_MOTIVO:EM_ANDAMENTO,SYNC_PULSE:0,LIM_HALL_CIMA_MV:0,PULSO_HALL_CIMA_PICO_MV:0,SCALE_LOW:-5.00,SCALE_HIGH:30.00
TEST_ID:IDENT_PULSO_SUBIDA_AGR,TEST_PARAM:SIG=PUL;TB=800;BUSCA=5;TPAT=300;RMIN=5.00;MARG=40;TD=1200;TP=150;TE=1000;REP=10,T_US:1741349782,PWM:20,RAW:77.000,ACTUAL:14.300,REF:0.000,ERRO:14.300,HALL_MV:3129,HALL_FILT_MV:3129,HALL_CIMA_MV:1665,HALL_CIMA_FILT_MV:1675,TOF_VALID:1,NEW_TOF:0,RANGE_STATUS:0,SIGNAL_MCPS:22.7188,AMBIENT_MCPS:0.0234,SPAD:14.0156,VEL_MM_S:0.0000,MEAS_RATE_HZ:12.6939,MEAS_AGE_US:4259,DT_HALL_US:488,DT_TOF_US:78778,DT_EST_US:486,DT_CTRL_US:488,IDENT_ACTIVE:1,IDENT_STATE:BUSCANDO_LIMIAR,IDENT_TYPE:PULSO,IDENT_REP:0,IDENT_REP_MAX:10,IDENT_FASE:1,LIM_PWM:-1,LIM_HALL_MV:0,LIM_ACTUAL_MM:NULL,LIM_RAW_MM:NULL,DELTA_LIM_MM:NULL,TEST_PWM:-1,TOF_BASE_MM:14.602,PULSO_HALL_PICO_MV:0,PULSO_ACTUAL_PICO_MM:NULL,DELTA_PULSO_MM:NULL,IDENT_MOTIVO:EM_ANDAMENTO,SYNC_PULSE:0,LIM_HALL_CIMA_MV:0,PULSO_HALL_CIMA_PICO_MV:0,SCALE_LOW:-5.00,SCALE_HIGH:30.00
TEST_ID:IDENT_PULSO_SUBIDA_AGR,TEST_PARAM:SIG=PUL;TB=800;BUSCA=5;TPAT=300;RMIN=5.00;MARG=40;TD=1200;TP=150;TE=1000;REP=10,T_US:1741492394,PWM:20,RAW:78.000,ACTUAL:13.801,REF:0.000,ERRO:13.801,HALL_MV:3129,HALL_FILT_MV:3129,HALL_CIMA_MV:1741,HALL_CIMA_FILT_MV:1703,TOF_VALID:1,NEW_TOF:0,RANGE_STATUS:0,SIGNAL_MCPS:22.7188,AMBIENT_MCPS:0.0312,SPAD:14.0156,VEL_MM_S:0.0037,MEAS_RATE_HZ:13.5455,MEAS_AGE_US:9281,DT_HALL_US:1999,DT_TOF_US:73825,DT_EST_US:2002,DT_CTRL_US:2000,IDENT_ACTIVE:1,IDENT_STATE:BUSCANDO_LIMIAR,IDENT_TYPE:PULSO,IDENT_REP:0,IDENT_REP_MAX:10,IDENT_FASE:1,LIM_PWM:-1,LIM_HALL_MV:0,LIM_ACTUAL_MM:NULL,LIM_RAW_MM:NULL,DELTA_LIM_MM:NULL,TEST_PWM:-1,TOF_BASE_MM:14.602,PULSO_HALL_PICO_MV:0,PULSO_ACTUAL_PICO_MM:NULL,DELTA_PULSO_MM:NULL,IDENT_MOTIVO:EM_ANDAMENTO,SYNC_PULSE:0,LIM_HALL_CIMA_MV:0,PULSO_HALL_CIMA_PICO_MV:0,SCALE_LOW:-5.00,SCALE_HIGH:30.00
TEST_ID:IDENT_PULSO_SUBIDA_AGR,TEST_PARAM:SIG=PUL;TB=800;BUSCA=5;TPAT=300;RMIN=5.00;MARG=40;TD=1200;TP=150;TE=1000;REP=10,T_US:1741502394,PWM:20,RAW:76.000,ACTUAL:13.909,REF:0.000,ERRO:13.909,HALL_MV:3129,HALL_FILT_MV:3129,HALL_CIMA_MV:1643,HALL_CIMA_FILT_MV:1668,TOF_VALID:1,NEW_TOF:0,RANGE_STATUS:0,SIGNAL_MCPS:22.9297,AMBIENT_MCPS:0.0312,SPAD:14.0156,VEL_MM_S:0.0026,MEAS_RATE_HZ:12.6941,MEAS_AGE_US:4278,DT_HALL_US:489,DT_TOF_US:78777,DT_EST_US:490,DT_CTRL_US:492,IDENT_ACTIVE:1,IDENT_STATE:BUSCANDO_LIMIAR,IDENT_TYPE:PULSO,IDENT_REP:0,IDENT_REP_MAX:10,IDENT_FASE:1,LIM_PWM:-1,LIM_HALL_MV:0,LIM_ACTUAL_MM:NULL,LIM_RAW_MM:NULL,DELTA_LIM_MM:NULL,TEST_PWM:-1,TOF_BASE_MM:14.602,PULSO_HALL_PICO_MV:0,PULSO_ACTUAL_PICO_MM:NULL,DELTA_PULSO_MM:NULL,IDENT_MOTIVO:EM_ANDAMENTO,SYNC_PULSE:0,LIM_HALL_CIMA_MV:0,PULSO_HALL_CIMA_PICO_MV:0,SCALE_LOW:-5.00,SCALE_HIGH:30.00
TEST_ID:IDENT_PULSO_SUBIDA_AGR,TEST_PARAM:SIG=PUL;TB=800;BUSCA=5;TPAT=300;RMIN=5.00;MARG=40;TD=1200;TP=150;TE=1000;REP=10,T_US:1741644905,PWM:20,RAW:77.000,ACTUAL:13.732,REF:0.000,ERRO:13.732,HALL_MV:3129,HALL_FILT_MV:3129,HALL_CIMA_MV:1641,HALL_CIMA_FILT_MV:1645,TOF_VALID:1,NEW_TOF:0,RANGE_STATUS:0,SIGNAL_MCPS:22.5469,AMBIENT_MCPS:0.0312,SPAD:14.0156,VEL_MM_S:0.0036,MEAS_RATE_HZ:13.5608,MEAS_AGE_US:9268,DT_HALL_US:1995,DT_TOF_US:73742,DT_EST_US:1998,DT_CTRL_US:1996,IDENT_ACTIVE:1,IDENT_STATE:BUSCANDO_LIMIAR,IDENT_TYPE:PULSO,IDENT_REP:0,IDENT_REP_MAX:10,IDENT_FASE:1,LIM_PWM:-1,LIM_HALL_MV:0,LIM_ACTUAL_MM:NULL,LIM_RAW_MM:NULL,DELTA_LIM_MM:NULL,TEST_PWM:-1,TOF_BASE_MM:14.602,PULSO_HALL_PICO_MV:0,PULSO_ACTUAL_PICO_MM:NULL,DELTA_PULSO_MM:NULL,IDENT_MOTIVO:EM_ANDAMENTO,SYNC_PULSE:0,LIM_HALL_CIMA_MV:0,PULSO_HALL_CIMA_PICO_MV:0,SCALE_LOW:-5.00,SCALE_HIGH:30.00
TEST_ID:IDENT_PULSO_SUBIDA_AGR,TEST_PARAM:SIG=PUL;TB=800;BUSCA=5;TPAT=300;RMIN=5.00;MARG=40;TD=1200;TP=150;TE=1000;REP=10,T_US:1741654905,PWM:25,RAW:75.000,ACTUAL:14.114,REF:0.000,ERRO:14.114,HALL_MV:3129,HALL_FILT_MV:3129,HALL_CIMA_MV:1665,HALL_CIMA_FILT_MV:1666,TOF_VALID:1,NEW_TOF:0,RANGE_STATUS:0,SIGNAL_MCPS:22.5781,AMBIENT_MCPS:0.0312,SPAD:14.0156,VEL_MM_S:0.0008,MEAS_RATE_HZ:12.6947,MEAS_AGE_US:4262,DT_HALL_US:492,DT_TOF_US:78773,DT_EST_US:487,DT_CTRL_US:490,IDENT_ACTIVE:1,IDENT_STATE:BUSCANDO_LIMIAR,IDENT_TYPE:PULSO,IDENT_REP:0,IDENT_REP_MAX:10,IDENT_FASE:1,LIM_PWM:-1,LIM_HALL_MV:0,LIM_ACTUAL_MM:NULL,LIM_RAW_MM:NULL,DELTA_LIM_MM:NULL,TEST_PWM:-1,TOF_BASE_MM:14.602,PULSO_HALL_PICO_MV:0,PULSO_ACTUAL_PICO_MM:NULL,DELTA_PULSO_MM:NULL,IDENT_MOTIVO:EM_ANDAMENTO,SYNC_PULSE:0,LIM_HALL_CIMA_MV:0,PULSO_HALL_CIMA_PICO_MV:0,SCALE_LOW:-5.00,SCALE_HIGH:30.00
TEST_ID:IDENT_PULSO_SUBIDA_AGR,TEST_PARAM:SIG=PUL;TB=800;BUSCA=5;TPAT=300;RMIN=5.00;MARG=40;TD=1200;TP=150;TE=1000;REP=10,T_US:1741797434,PWM:25,RAW:77.000,ACTUAL:13.908,REF:0.000,ERRO:13.908,HALL_MV:3129,HALL_FILT_MV:3129,HALL_CIMA_MV:1725,HALL_CIMA_FILT_MV:1699,TOF_VALID:1,NEW_TOF:0,RANGE_STATUS:0,SIGNAL_MCPS:22.5938,AMBIENT_MCPS:0.0312,SPAD:14.0156,VEL_MM_S:0.0021,MEAS_RATE_HZ:13.5599,MEAS_AGE_US:9280,DT_HALL_US:2000,DT_TOF_US:73747,DT_EST_US:2001,DT_CTRL_US:2000,IDENT_ACTIVE:1,IDENT_STATE:BUSCANDO_LIMIAR,IDENT_TYPE:PULSO,IDENT_REP:0,IDENT_REP_MAX:10,IDENT_FASE:1,LIM_PWM:-1,LIM_HALL_MV:0,LIM_ACTUAL_MM:NULL,LIM_RAW_MM:NULL,DELTA_LIM_MM:NULL,TEST_PWM:-1,TOF_BASE_MM:14.602,PULSO_HALL_PICO_MV:0,PULSO_ACTUAL_PICO_MM:NULL,DELTA_PULSO_MM:NULL,IDENT_MOTIVO:EM_ANDAMENTO,SYNC_PULSE:0,LIM_HALL_CIMA_MV:0,PULSO_HALL_CIMA_PICO_MV:0,SCALE_LOW:-5.00,SCALE_HIGH:30.00
TEST_ID:IDENT_PULSO_SUBIDA_AGR,TEST_PARAM:SIG=PUL;TB=800;BUSCA=5;TPAT=300;RMIN=5.00;MARG=40;TD=1200;TP=150;TE=1000;REP=10,T_US:1741807434,PWM:25,RAW:75.000,ACTUAL:14.277,REF:0.000,ERRO:14.277,HALL_MV:3129,HALL_FILT_MV:3129,HALL_CIMA_MV:1613,HALL_CIMA_FILT_MV:1658,TOF_VALID:1,NEW_TOF:0,RANGE_STATUS:0,SIGNAL_MCPS:22.5938,AMBIENT_MCPS:0.0234,SPAD:14.0156,VEL_MM_S:-0.0004,MEAS_RATE_HZ:12.6941,MEAS_AGE_US:4269,DT_HALL_US:489,DT_TOF_US:78777,DT_EST_US:491,DT_CTRL_US:492,IDENT_ACTIVE:1,IDENT_STATE:BUSCANDO_LIMIAR,IDENT_TYPE:PULSO,IDENT_REP:0,IDENT_REP_MAX:10,IDENT_FASE:1,LIM_PWM:-1,LIM_HALL_MV:0,LIM_ACTUAL_MM:NULL,LIM_RAW_MM:NULL,DELTA_LIM_MM:NULL,TEST_PWM:-1,TOF_BASE_MM:14.602,PULSO_HALL_PICO_MV:0,PULSO_ACTUAL_PICO_MM:NULL,DELTA_PULSO_MM:NULL,IDENT_MOTIVO:EM_ANDAMENTO,SYNC_PULSE:0,LIM_HALL_CIMA_MV:0,PULSO_HALL_CIMA_PICO_MV:0,SCALE_LOW:-5.00,SCALE_HIGH:30.00
TEST_ID:IDENT_PULSO_SUBIDA_AGR,TEST_PARAM:SIG=PUL;TB=800;BUSCA=5;TPAT=300;RMIN=5.00;MARG=40;TD=1200;TP=150;TE=1000;REP=10,T_US:1741950039,PWM:25,RAW:78.000,ACTUAL:13.788,REF:0.000,ERRO:13.788,HALL_MV:3129,HALL_FILT_MV:3129,HALL_CIMA_MV:1585,HALL_CIMA_FILT_MV:1644,TOF_VALID:1,NEW_TOF:0,RANGE_STATUS:0,SIGNAL_MCPS:22.4844,AMBIENT_MCPS:0.0234,SPAD:14.0156,VEL_MM_S:0.0026,MEAS_RATE_HZ:13.5450,MEAS_AGE_US:9283,DT_HALL_US:2000,DT_TOF_US:73828,DT_EST_US:2002,DT_CTRL_US:2000,IDENT_ACTIVE:1,IDENT_STATE:BUSCANDO_LIMIAR,IDENT_TYPE:PULSO,IDENT_REP:0,IDENT_REP_MAX:10,IDENT_FASE:1,LIM_PWM:-1,LIM_HALL_MV:0,LIM_ACTUAL_MM:NULL,LIM_RAW_MM:NULL,DELTA_LIM_MM:NULL,TEST_PWM:-1,TOF_BASE_MM:14.602,PULSO_HALL_PICO_MV:0,PULSO_ACTUAL_PICO_MM:NULL,DELTA_PULSO_MM:NULL,IDENT_MOTIVO:EM_ANDAMENTO,SYNC_PULSE:0,LIM_HALL_CIMA_MV:0,PULSO_HALL_CIMA_PICO_MV:0,SCALE_LOW:-5.00,SCALE_HIGH:30.00
TEST_ID:IDENT_PULSO_SUBIDA_AGR,TEST_PARAM:SIG=PUL;TB=800;BUSCA=5;TPAT=300;RMIN=5.00;MARG=40;TD=1200;TP=150;TE=1000;REP=10,T_US:1741960039,PWM:30,RAW:76.000,ACTUAL:13.897,REF:0.000,ERRO:13.897,HALL_MV:3129,HALL_FILT_MV:3129,HALL_CIMA_MV:1717,HALL_CIMA_FILT_MV:1689,TOF_VALID:1,NEW_TOF:0,RANGE_STATUS:0,SIGNAL_MCPS:22.6172,AMBIENT_MCPS:0.0234,SPAD:14.0156,VEL_MM_S:0.0018,MEAS_RATE_HZ:12.6931,MEAS_AGE_US:4270,DT_HALL_US:489,DT_TOF_US:78783,DT_EST_US:486,DT_CTRL_US:493,IDENT_ACTIVE:1,IDENT_STATE:BUSCANDO_LIMIAR,IDENT_TYPE:PULSO,IDENT_REP:0,IDENT_REP_MAX:10,IDENT_FASE:1,LIM_PWM:-1,LIM_HALL_MV:0,LIM_ACTUAL_MM:NULL,LIM_RAW_MM:NULL,DELTA_LIM_MM:NULL,TEST_PWM:-1,TOF_BASE_MM:14.602,PULSO_HALL_PICO_MV:0,PULSO_ACTUAL_PICO_MM:NULL,DELTA_PULSO_MM:NULL,IDENT_MOTIVO:EM_ANDAMENTO,SYNC_PULSE:0,LIM_HALL_CIMA_MV:0,PULSO_HALL_CIMA_PICO_MV:0,SCALE_LOW:-5.00,SCALE_HIGH:30.00
TEST_ID:IDENT_PULSO_SUBIDA_AGR,TEST_PARAM:SIG=PUL;TB=800;BUSCA=5;TPAT=300;RMIN=5.00;MARG=40;TD=1200;TP=150;TE=1000;REP=10,T_US:1742102566,PWM:30,RAW:79.000,ACTUAL:13.222,REF:0.000,ERRO:13.222,HALL_MV:3129,HALL_FILT_MV:3129,HALL_CIMA_MV:1661,HALL_CIMA_FILT_MV:1684,TOF_VALID:1,NEW_TOF:0,RANGE_STATUS:0,SIGNAL_MCPS:22.7422,AMBIENT_MCPS:0.0234,SPAD:14.0156,VEL_MM_S:0.0055,MEAS_RATE_HZ:13.5602,MEAS_AGE_US:9283,DT_HALL_US:2004,DT_TOF_US:73745,DT_EST_US:2006,DT_CTRL_US:2004,IDENT_ACTIVE:1,IDENT_STATE:BUSCANDO_LIMIAR,IDENT_TYPE:PULSO,IDENT_REP:0,IDENT_REP_MAX:10,IDENT_FASE:1,LIM_PWM:-1,LIM_HALL_MV:0,LIM_ACTUAL_MM:NULL,LIM_RAW_MM:NULL,DELTA_LIM_MM:NULL,TEST_PWM:-1,TOF_BASE_MM:14.602,PULSO_HALL_PICO_MV:0,PULSO_ACTUAL_PICO_MM:NULL,DELTA_PULSO_MM:NULL,IDENT_MOTIVO:EM_ANDAMENTO,SYNC_PULSE:0,LIM_HALL_CIMA_MV:0,PULSO_HALL_CIMA_PICO_MV:0,SCALE_LOW:-5.00,SCALE_HIGH:30.00
TEST_ID:IDENT_PULSO_SUBIDA_AGR,TEST_PARAM:SIG=PUL;TB=800;BUSCA=5;TPAT=300;RMIN=5.00;MARG=40;TD=1200;TP=150;TE=1000;REP=10,T_US:1742112566,PWM:30,RAW:76.000,ACTUAL:13.394,REF:0.000,ERRO:13.394,HALL_MV:3129,HALL_FILT_MV:3129,HALL_CIMA_MV:1689,HALL_CIMA_FILT_MV:1673,TOF_VALID:1,NEW_TOF:0,RANGE_STATUS:0,SIGNAL_MCPS:22.4922,AMBIENT_MCPS:0.0312,SPAD:14.0156,VEL_MM_S:0.0041,MEAS_RATE_HZ:12.6936,MEAS_AGE_US:4265,DT_HALL_US:492,DT_TOF_US:78780,DT_EST_US:490,DT_CTRL_US:489,IDENT_ACTIVE:1,IDENT_STATE:BUSCANDO_LIMIAR,IDENT_TYPE:PULSO,IDENT_REP:0,IDENT_REP_MAX:10,IDENT_FASE:1,LIM_PWM:-1,LIM_HALL_MV:0,LIM_ACTUAL_MM:NULL,LIM_RAW_MM:NULL,DELTA_LIM_MM:NULL,TEST_PWM:-1,TOF_BASE_MM:14.602,PULSO_HALL_PICO_MV:0,PULSO_ACTUAL_PICO_MM:NULL,DELTA_PULSO_MM:NULL,IDENT_MOTIVO:EM_ANDAMENTO,SYNC_PULSE:0,LIM_HALL_CIMA_MV:0,PULSO_HALL_CIMA_PICO_MV:0,SCALE_LOW:-5.00,SCALE_HIGH:30.00
TEST_ID:IDENT_PULSO_SUBIDA_AGR,TEST_PARAM:SIG=PUL;TB=800;BUSCA=5;TPAT=300;RMIN=5.00;MARG=40;TD=1200;TP=150;TE=1000;REP=10,T_US:1742255084,PWM:30,RAW:78.000,ACTUAL:13.032,REF:0.000,ERRO:13.032,HALL_MV:3129,HALL_FILT_MV:3129,HALL_CIMA_MV:1639,HALL_CIMA_FILT_MV:1657,TOF_VALID:1,NEW_TOF:0,RANGE_STATUS:0,SIGNAL_MCPS:22.6016,AMBIENT_MCPS:0.0312,SPAD:14.0156,VEL_MM_S:0.0058,MEAS_RATE_HZ:13.5608,MEAS_AGE_US:9274,DT_HALL_US:1997,DT_TOF_US:73742,DT_EST_US:1999,DT_CTRL_US:1996,IDENT_ACTIVE:1,IDENT_STATE:BUSCANDO_LIMIAR,IDENT_TYPE:PULSO,IDENT_REP:0,IDENT_REP_MAX:10,IDENT_FASE:1,LIM_PWM:-1,LIM_HALL_MV:0,LIM_ACTUAL_MM:NULL,LIM_RAW_MM:NULL,DELTA_LIM_MM:NULL,TEST_PWM:-1,TOF_BASE_MM:14.602,PULSO_HALL_PICO_MV:0,PULSO_ACTUAL_PICO_MM:NULL,DELTA_PULSO_MM:NULL,IDENT_MOTIVO:EM_ANDAMENTO,SYNC_PULSE:0,LIM_HALL_CIMA_MV:0,PULSO_HALL_CIMA_PICO_MV:0,SCALE_LOW:-5.00,SCALE_HIGH:30.00
TEST_ID:IDENT_PULSO_SUBIDA_AGR,TEST_PARAM:SIG=PUL;TB=800;BUSCA=5;TPAT=300;RMIN=5.00;MARG=40;TD=1200;TP=150;TE=1000;REP=10,T_US:1742265084,PWM:35,RAW:76.000,ACTUAL:13.227,REF:0.000,ERRO:13.227,HALL_MV:3129,HALL_FILT_MV:3129,HALL_CIMA_MV:1577,HALL_CIMA_FILT_MV:1647,TOF_VALID:1,NEW_TOF:0,RANGE_STATUS:0,SIGNAL_MCPS:22.5781,AMBIENT_MCPS:0.0234,SPAD:14.0156,VEL_MM_S:0.0043,MEAS_RATE_HZ:12.6944,MEAS_AGE_US:4269,DT_HALL_US:488,DT_TOF_US:78775,DT_EST_US:486,DT_CTRL_US:490,IDENT_ACTIVE:1,IDENT_STATE:BUSCANDO_LIMIAR,IDENT_TYPE:PULSO,IDENT_REP:0,IDENT_REP_MAX:10,IDENT_FASE:1,LIM_PWM:-1,LIM_HALL_MV:0,LIM_ACTUAL_MM:NULL,LIM_RAW_MM:NULL,DELTA_LIM_MM:NULL,TEST_PWM:-1,TOF_BASE_MM:14.602,PULSO_HALL_PICO_MV:0,PULSO_ACTUAL_PICO_MM:NULL,DELTA_PULSO_MM:NULL,IDENT_MOTIVO:EM_ANDAMENTO,SYNC_PULSE:0,LIM_HALL_CIMA_MV:0,PULSO_HALL_CIMA_PICO_MV:0,SCALE_LOW:-5.00,SCALE_HIGH:30.00
TEST_ID:IDENT_PULSO_SUBIDA_AGR,TEST_PARAM:SIG=PUL;TB=800;BUSCA=5;TPAT=300;RMIN=5.00;MARG=40;TD=1200;TP=150;TE=1000;REP=10,T_US:1742407607,PWM:35,RAW:77.000,ACTUAL:13.140,REF:0.000,ERRO:13.140,HALL_MV:3129,HALL_FILT_MV:3129,HALL_CIMA_MV:1595,HALL_CIMA_FILT_MV:1594,TOF_VALID:1,NEW_TOF:0,RANGE_STATUS:0,SIGNAL_MCPS:22.7500,AMBIENT_MCPS:0.0234,SPAD:14.0156,VEL_MM_S:0.0044,MEAS_RATE_HZ:13.5599,MEAS_AGE_US:9277,DT_HALL_US:2004,DT_TOF_US:73747,DT_EST_US:2005,DT_CTRL_US:2003,IDENT_ACTIVE:1,IDENT_STATE:BUSCANDO_LIMIAR,IDENT_TYPE:PULSO,IDENT_REP:0,IDENT_REP_MAX:10,IDENT_FASE:1,LIM_PWM:-1,LIM_HALL_MV:0,LIM_ACTUAL_MM:NULL,LIM_RAW_MM:NULL,DELTA_LIM_MM:NULL,TEST_PWM:-1,TOF_BASE_MM:14.602,PULSO_HALL_PICO_MV:0,PULSO_ACTUAL_PICO_MM:NULL,DELTA_PULSO_MM:NULL,IDENT_MOTIVO:EM_ANDAMENTO,SYNC_PULSE:0,LIM_HALL_CIMA_MV:0,PULSO_HALL_CIMA_PICO_MV:0,SCALE_LOW:-5.00,SCALE_HIGH:30.00
TEST_ID:IDENT_PULSO_SUBIDA_AGR,TEST_PARAM:SIG=PUL;TB=800;BUSCA=5;TPAT=300;RMIN=5.00;MARG=40;TD=1200;TP=150;TE=1000;REP=10,T_US:1742417607,PWM:35,RAW:77.000,ACTUAL:13.063,REF:0.000,ERRO:13.063,HALL_MV:3129,HALL_FILT_MV:3129,HALL_CIMA_MV:1743,HALL_CIMA_FILT_MV:1660,TOF_VALID:1,NEW_TOF:0,RANGE_STATUS:0,SIGNAL_MCPS:22.7266,AMBIENT_MCPS:0.0234,SPAD:14.0156,VEL_MM_S:0.0045,MEAS_RATE_HZ:12.6942,MEAS_AGE_US:4264,DT_HALL_US:490,DT_TOF_US:78776,DT_EST_US:487,DT_CTRL_US:488,IDENT_ACTIVE:1,IDENT_STATE:BUSCANDO_LIMIAR,IDENT_TYPE:PULSO,IDENT_REP:0,IDENT_REP_MAX:10,IDENT_FASE:1,LIM_PWM:-1,LIM_HALL_MV:0,LIM_ACTUAL_MM:NULL,LIM_RAW_MM:NULL,DELTA_LIM_MM:NULL,TEST_PWM:-1,TOF_BASE_MM:14.602,PULSO_HALL_PICO_MV:0,PULSO_ACTUAL_PICO_MM:NULL,DELTA_PULSO_MM:NULL,IDENT_MOTIVO:EM_ANDAMENTO,SYNC_PULSE:0,LIM_HALL_CIMA_MV:0,PULSO_HALL_CIMA_PICO_MV:0,SCALE_LOW:-5.00,SCALE_HIGH:30.00
TEST_ID:IDENT_PULSO_SUBIDA_AGR,TEST_PARAM:SIG=PUL;TB=800;BUSCA=5;TPAT=300;RMIN=5.00;MARG=40;TD=1200;TP=150;TE=1000;REP=10,T_US:1742560121,PWM:35,RAW:77.000,ACTUAL:13.183,REF:0.000,ERRO:13.183,HALL_MV:3129,HALL_FILT_MV:3129,HALL_CIMA_MV:1620,HALL_CIMA_FILT_MV:1654,TOF_VALID:1,NEW_TOF:1,RANGE_STATUS:0,SIGNAL_MCPS:22.7656,AMBIENT_MCPS:0.0234,SPAD:14.0156,VEL_MM_S:0.0035,MEAS_RATE_HZ:107.8283,MEAS_AGE_US:0,DT_HALL_US:1997,DT_TOF_US:9274,DT_EST_US:1998,DT_CTRL_US:4047,IDENT_ACTIVE:1,IDENT_STATE:BUSCANDO_LIMIAR,IDENT_TYPE:PULSO,IDENT_REP:0,IDENT_REP_MAX:10,IDENT_FASE:1,LIM_PWM:-1,LIM_HALL_MV:0,LIM_ACTUAL_MM:NULL,LIM_RAW_MM:NULL,DELTA_LIM_MM:NULL,TEST_PWM:-1,TOF_BASE_MM:14.602,PULSO_HALL_PICO_MV:0,PULSO_ACTUAL_PICO_MM:NULL,DELTA_PULSO_MM:NULL,IDENT_MOTIVO:EM_ANDAMENTO,SYNC_PULSE:0,LIM_HALL_CIMA_MV:0,PULSO_HALL_CIMA_PICO_MV:0,SCALE_LOW:-5.00,SCALE_HIGH:30.00
TEST_ID:IDENT_PULSO_SUBIDA_AGR,TEST_PARAM:SIG=PUL;TB=800;BUSCA=5;TPAT=300;RMIN=5.00;MARG=40;TD=1200;TP=150;TE=1000;REP=10,T_US:1742570121,PWM:40,RAW:76.000,ACTUAL:13.371,REF:0.000,ERRO:13.371,HALL_MV:3129,HALL_FILT_MV:3129,HALL_CIMA_MV:1615,HALL_CIMA_FILT_MV:1627,TOF_VALID:1,NEW_TOF:0,RANGE_STATUS:0,SIGNAL_MCPS:22.7344,AMBIENT_MCPS:0.0234,SPAD:14.0156,VEL_MM_S:0.0023,MEAS_RATE_HZ:13.9706,MEAS_AGE_US:4251,DT_HALL_US:488,DT_TOF_US:71579,DT_EST_US:487,DT_CTRL_US:494,IDENT_ACTIVE:1,IDENT_STATE:BUSCANDO_LIMIAR,IDENT_TYPE:PULSO,IDENT_REP:0,IDENT_REP_MAX:10,IDENT_FASE:1,LIM_PWM:-1,LIM_HALL_MV:0,LIM_ACTUAL_MM:NULL,LIM_RAW_MM:NULL,DELTA_LIM_MM:NULL,TEST_PWM:-1,TOF_BASE_MM:14.602,PULSO_HALL_PICO_MV:0,PULSO_ACTUAL_PICO_MM:NULL,DELTA_PULSO_MM:NULL,IDENT_MOTIVO:EM_ANDAMENTO,SYNC_PULSE:0,LIM_HALL_CIMA_MV:0,PULSO_HALL_CIMA_PICO_MV:0,SCALE_LOW:-5.00,SCALE_HIGH:30.00
TEST_ID:IDENT_PULSO_SUBIDA_AGR,TEST_PARAM:SIG=PUL;TB=800;BUSCA=5;TPAT=300;RMIN=5.00;MARG=40;TD=1200;TP=150;TE=1000;REP=10,T_US:1742714722,PWM:40,RAW:77.000,ACTUAL:13.416,REF:0.000,ERRO:13.416,HALL_MV:3129,HALL_FILT_MV:3129,HALL_CIMA_MV:1614,HALL_CIMA_FILT_MV:1628,TOF_VALID:1,NEW_TOF:0,RANGE_STATUS:0,SIGNAL_MCPS:22.6484,AMBIENT_MCPS:0.0312,SPAD:14.0156,VEL_MM_S:0.0019,MEAS_RATE_HZ:137.2684,MEAS_AGE_US:2574,DT_HALL_US:2547,DT_TOF_US:7285,DT_EST_US:2568,DT_CTRL_US:621,IDENT_ACTIVE:1,IDENT_STATE:BUSCANDO_LIMIAR,IDENT_TYPE:PULSO,IDENT_REP:0,IDENT_REP_MAX:10,IDENT_FASE:1,LIM_PWM:-1,LIM_HALL_MV:0,LIM_ACTUAL_MM:NULL,LIM_RAW_MM:NULL,DELTA_LIM_MM:NULL,TEST_PWM:-1,TOF_BASE_MM:14.602,PULSO_HALL_PICO_MV:0,PULSO_ACTUAL_PICO_MM:NULL,DELTA_PULSO_MM:NULL,IDENT_MOTIVO:EM_ANDAMENTO,SYNC_PULSE:0,LIM_HALL_CIMA_MV:0,PULSO_HALL_CIMA_PICO_MV:0,SCALE_LOW:-5.00,SCALE_HIGH:30.00
TEST_ID:IDENT_PULSO_SUBIDA_AGR,TEST_PARAM:SIG=PUL;TB=800;BUSCA=5;TPAT=300;RMIN=5.00;MARG=40;TD=1200;TP=150;TE=1000;REP=10,T_US:1742724722,PWM:40,RAW:77.000,ACTUAL:13.299,REF:0.000,ERRO:13.299,HALL_MV:3129,HALL_FILT_MV:3129,HALL_CIMA_MV:1610,HALL_CIMA_FILT_MV:1621,TOF_VALID:1,NEW_TOF:0,RANGE_STATUS:0,SIGNAL_MCPS:22.8047,AMBIENT_MCPS:0.0312,SPAD:14.0156,VEL_MM_S:0.0024,MEAS_RATE_HZ:13.8573,MEAS_AGE_US:4272,DT_HALL_US:493,DT_TOF_US:72164,DT_EST_US:494,DT_CTRL_US:492,IDENT_ACTIVE:1,IDENT_STATE:BUSCANDO_LIMIAR,IDENT_TYPE:PULSO,IDENT_REP:0,IDENT_REP_MAX:10,IDENT_FASE:1,LIM_PWM:-1,LIM_HALL_MV:0,LIM_ACTUAL_MM:NULL,LIM_RAW_MM:NULL,DELTA_LIM_MM:NULL,TEST_PWM:-1,TOF_BASE_MM:14.602,PULSO_HALL_PICO_MV:0,PULSO_ACTUAL_PICO_MM:NULL,DELTA_PULSO_MM:NULL,IDENT_MOTIVO:EM_ANDAMENTO,SYNC_PULSE:0,LIM_HALL_CIMA_MV:0,PULSO_HALL_CIMA_PICO_MV:0,SCALE_LOW:-5.00,SCALE_HIGH:30.00
TEST_ID:IDENT_PULSO_SUBIDA_AGR,TEST_PARAM:SIG=PUL;TB=800;BUSCA=5;TPAT=300;RMIN=5.00;MARG=40;TD=1200;TP=150;TE=1000;REP=10,T_US:1742869303,PWM:40,RAW:78.000,ACTUAL:13.132,REF:0.000,ERRO:13.132,HALL_MV:3129,HALL_FILT_MV:3129,HALL_CIMA_MV:1685,HALL_CIMA_FILT_MV:1649,TOF_VALID:1,NEW_TOF:0,RANGE_STATUS:0,SIGNAL_MCPS:22.8203,AMBIENT_MCPS:0.0312,SPAD:14.0156,VEL_MM_S:0.0031,MEAS_RATE_HZ:200.0000,MEAS_AGE_US:5978,DT_HALL_US:2001,DT_TOF_US:5000,DT_EST_US:2002,DT_CTRL_US:1998,IDENT_ACTIVE:1,IDENT_STATE:BUSCANDO_LIMIAR,IDENT_TYPE:PULSO,IDENT_REP:0,IDENT_REP_MAX:10,IDENT_FASE:1,LIM_PWM:-1,LIM_HALL_MV:0,LIM_ACTUAL_MM:NULL,LIM_RAW_MM:NULL,DELTA_LIM_MM:NULL,TEST_PWM:-1,TOF_BASE_MM:14.602,PULSO_HALL_PICO_MV:0,PULSO_ACTUAL_PICO_MM:NULL,DELTA_PULSO_MM:NULL,IDENT_MOTIVO:EM_ANDAMENTO,SYNC_PULSE:0,LIM_HALL_CIMA_MV:0,PULSO_HALL_CIMA_PICO_MV:0,SCALE_LOW:-5.00,SCALE_HIGH:30.00
TEST_ID:IDENT_PULSO_SUBIDA_AGR,TEST_PARAM:SIG=PUL;TB=800;BUSCA=5;TPAT=300;RMIN=5.00;MARG=40;TD=1200;TP=150;TE=1000;REP=10,T_US:1742879303,PWM:45,RAW:76.000,ACTUAL:13.300,REF:0.000,ERRO:13.300,HALL_MV:3129,HALL_FILT_MV:3129,HALL_CIMA_MV:1549,HALL_CIMA_FILT_MV:1599,TOF_VALID:1,NEW_TOF:0,RANGE_STATUS:0,SIGNAL_MCPS:22.6641,AMBIENT_MCPS:0.0312,SPAD:14.0156,VEL_MM_S:0.0020,MEAS_RATE_HZ:13.2494,MEAS_AGE_US:4276,DT_HALL_US:488,DT_TOF_US:75475,DT_EST_US:486,DT_CTRL_US:493,IDENT_ACTIVE:1,IDENT_STATE:BUSCANDO_LIMIAR,IDENT_TYPE:PULSO,IDENT_REP:0,IDENT_REP_MAX:10,IDENT_FASE:1,LIM_PWM:-1,LIM_HALL_MV:0,LIM_ACTUAL_MM:NULL,LIM_RAW_MM:NULL,DELTA_LIM_MM:NULL,TEST_PWM:-1,TOF_BASE_MM:14.602,PULSO_HALL_PICO_MV:0,PULSO_ACTUAL_PICO_MM:NULL,DELTA_PULSO_MM:NULL,IDENT_MOTIVO:EM_ANDAMENTO,SYNC_PULSE:0,LIM_HALL_CIMA_MV:0,PULSO_HALL_CIMA_PICO_MV:0,SCALE_LOW:-5.00,SCALE_HIGH:30.00
TEST_ID:IDENT_PULSO_SUBIDA_AGR,TEST_PARAM:SIG=PUL;TB=800;BUSCA=5;TPAT=300;RMIN=5.00;MARG=40;TD=1200;TP=150;TE=1000;REP=10,T_US:1743021830,PWM:45,RAW:77.000,ACTUAL:13.208,REF:0.000,ERRO:13.208,HALL_MV:3129,HALL_FILT_MV:3129,HALL_CIMA_MV:1556,HALL_CIMA_FILT_MV:1580,TOF_VALID:1,NEW_TOF:0,RANGE_STATUS:0,SIGNAL_MCPS:22.7969,AMBIENT_MCPS:0.0234,SPAD:14.0156,VEL_MM_S:0.0023,MEAS_RATE_HZ:13.5599,MEAS_AGE_US:9285,DT_HALL_US:2004,DT_TOF_US:73747,DT_EST_US:2005,DT_CTRL_US:2005,IDENT_ACTIVE:1,IDENT_STATE:BUSCANDO_LIMIAR,IDENT_TYPE:PULSO,IDENT_REP:0,IDENT_REP_MAX:10,IDENT_FASE:1,LIM_PWM:-1,LIM_HALL_MV:0,LIM_ACTUAL_MM:NULL,LIM_RAW_MM:NULL,DELTA_LIM_MM:NULL,TEST_PWM:-1,TOF_BASE_MM:14.602,PULSO_HALL_PICO_MV:0,PULSO_ACTUAL_PICO_MM:NULL,DELTA_PULSO_MM:NULL,IDENT_MOTIVO:EM_ANDAMENTO,SYNC_PULSE:0,LIM_HALL_CIMA_MV:0,PULSO_HALL_CIMA_PICO_MV:0,SCALE_LOW:-5.00,SCALE_HIGH:30.00
TEST_ID:IDENT_PULSO_SUBIDA_AGR,TEST_PARAM:SIG=PUL;TB=800;BUSCA=5;TPAT=300;RMIN=5.00;MARG=40;TD=1200;TP=150;TE=1000;REP=10,T_US:1743031830,PWM:45,RAW:75.000,ACTUAL:13.629,REF:0.000,ERRO:13.629,HALL_MV:3129,HALL_FILT_MV:3129,HALL_CIMA_MV:1592,HALL_CIMA_FILT_MV:1612,TOF_VALID:1,NEW_TOF:0,RANGE_STATUS:0,SIGNAL_MCPS:22.9375,AMBIENT_MCPS:0.0234,SPAD:14.0156,VEL_MM_S:-0.0001,MEAS_RATE_HZ:12.6913,MEAS_AGE_US:4269,DT_HALL_US:492,DT_TOF_US:78794,DT_EST_US:489,DT_CTRL_US:488,IDENT_ACTIVE:1,IDENT_STATE:BUSCANDO_LIMIAR,IDENT_TYPE:PULSO,IDENT_REP:0,IDENT_REP_MAX:10,IDENT_FASE:1,LIM_PWM:-1,LIM_HALL_MV:0,LIM_ACTUAL_MM:NULL,LIM_RAW_MM:NULL,DELTA_LIM_MM:NULL,TEST_PWM:-1,TOF_BASE_MM:14.602,PULSO_HALL_PICO_MV:0,PULSO_ACTUAL_PICO_MM:NULL,DELTA_PULSO_MM:NULL,IDENT_MOTIVO:EM_ANDAMENTO,SYNC_PULSE:0,LIM_HALL_CIMA_MV:0,PULSO_HALL_CIMA_PICO_MV:0,SCALE_LOW:-5.00,SCALE_HIGH:30.00
TEST_ID:IDENT_PULSO_SUBIDA_AGR,TEST_PARAM:SIG=PUL;TB=800;BUSCA=5;TPAT=300;RMIN=5.00;MARG=40;TD=1200;TP=150;TE=1000;REP=10,T_US:1743174436,PWM:45,RAW:76.000,ACTUAL:13.751,REF:0.000,ERRO:13.751,HALL_MV:3129,HALL_FILT_MV:3129,HALL_CIMA_MV:1556,HALL_CIMA_FILT_MV:1585,TOF_VALID:1,NEW_TOF:0,RANGE_STATUS:0,SIGNAL_MCPS:22.8828,AMBIENT_MCPS:0.0312,SPAD:14.0156,VEL_MM_S:-0.0008,MEAS_RATE_HZ:13.5452,MEAS_AGE_US:9270,DT_HALL_US:2000,DT_TOF_US:73827,DT_EST_US:2002,DT_CTRL_US:2000,IDENT_ACTIVE:1,IDENT_STATE:BUSCANDO_LIMIAR,IDENT_TYPE:PULSO,IDENT_REP:0,IDENT_REP_MAX:10,IDENT_FASE:1,LIM_PWM:-1,LIM_HALL_MV:0,LIM_ACTUAL_MM:NULL,LIM_RAW_MM:NULL,DELTA_LIM_MM:NULL,TEST_PWM:-1,TOF_BASE_MM:14.602,PULSO_HALL_PICO_MV:0,PULSO_ACTUAL_PICO_MM:NULL,DELTA_PULSO_MM:NULL,IDENT_MOTIVO:EM_ANDAMENTO,SYNC_PULSE:0,LIM_HALL_CIMA_MV:0,PULSO_HALL_CIMA_PICO_MV:0,SCALE_LOW:-5.00,SCALE_HIGH:30.00
TEST_ID:IDENT_PULSO_SUBIDA_AGR,TEST_PARAM:SIG=PUL;TB=800;BUSCA=5;TPAT=300;RMIN=5.00;MARG=40;TD=1200;TP=150;TE=1000;REP=10,T_US:1743184436,PWM:50,RAW:78.000,ACTUAL:13.346,REF:0.000,ERRO:13.346,HALL_MV:3129,HALL_FILT_MV:3129,HALL_CIMA_MV:1636,HALL_CIMA_FILT_MV:1607,TOF_VALID:1,NEW_TOF:0,RANGE_STATUS:0,SIGNAL_MCPS:22.7734,AMBIENT_MCPS:0.0391,SPAD:14.0156,VEL_MM_S:0.0014,MEAS_RATE_HZ:12.6958,MEAS_AGE_US:4283,DT_HALL_US:488,DT_TOF_US:78766,DT_EST_US:491,DT_CTRL_US:493,IDENT_ACTIVE:1,IDENT_STATE:BUSCANDO_LIMIAR,IDENT_TYPE:PULSO,IDENT_REP:0,IDENT_REP_MAX:10,IDENT_FASE:1,LIM_PWM:-1,LIM_HALL_MV:0,LIM_ACTUAL_MM:NULL,LIM_RAW_MM:NULL,DELTA_LIM_MM:NULL,TEST_PWM:-1,TOF_BASE_MM:14.602,PULSO_HALL_PICO_MV:0,PULSO_ACTUAL_PICO_MM:NULL,DELTA_PULSO_MM:NULL,IDENT_MOTIVO:EM_ANDAMENTO,SYNC_PULSE:0,LIM_HALL_CIMA_MV:0,PULSO_HALL_CIMA_PICO_MV:0,SCALE_LOW:-5.00,SCALE_HIGH:30.00
TEST_ID:IDENT_PULSO_SUBIDA_AGR,TEST_PARAM:SIG=PUL;TB=800;BUSCA=5;TPAT=300;RMIN=5.00;MARG=40;TD=1200;TP=150;TE=1000;REP=10,T_US:1743327051,PWM:50,RAW:78.000,ACTUAL:12.992,REF:0.000,ERRO:12.992,HALL_MV:3129,HALL_FILT_MV:3129,HALL_CIMA_MV:1617,HALL_CIMA_FILT_MV:1584,TOF_VALID:1,NEW_TOF:0,RANGE_STATUS:0,SIGNAL_MCPS:22.8438,AMBIENT_MCPS:0.0234,SPAD:14.0156,VEL_MM_S:0.0032,MEAS_RATE_HZ:13.5450,MEAS_AGE_US:9289,DT_HALL_US:1996,DT_TOF_US:73828,DT_EST_US:1998,DT_CTRL_US:1996,IDENT_ACTIVE:1,IDENT_STATE:BUSCANDO_LIMIAR,IDENT_TYPE:PULSO,IDENT_REP:0,IDENT_REP_MAX:10,IDENT_FASE:1,LIM_PWM:-1,LIM_HALL_MV:0,LIM_ACTUAL_MM:NULL,LIM_RAW_MM:NULL,DELTA_LIM_MM:NULL,TEST_PWM:-1,TOF_BASE_MM:14.602,PULSO_HALL_PICO_MV:0,PULSO_ACTUAL_PICO_MM:NULL,DELTA_PULSO_MM:NULL,IDENT_MOTIVO:EM_ANDAMENTO,SYNC_PULSE:0,LIM_HALL_CIMA_MV:0,PULSO_HALL_CIMA_PICO_MV:0,SCALE_LOW:-5.00,SCALE_HIGH:30.00
TEST_ID:IDENT_PULSO_SUBIDA_AGR,TEST_PARAM:SIG=PUL;TB=800;BUSCA=5;TPAT=300;RMIN=5.00;MARG=40;TD=1200;TP=150;TE=1000;REP=10,T_US:1743337051,PWM:50,RAW:76.000,ACTUAL:13.187,REF:0.000,ERRO:13.187,HALL_MV:3129,HALL_FILT_MV:3129,HALL_CIMA_MV:1591,HALL_CIMA_FILT_MV:1602,TOF_VALID:1,NEW_TOF:0,RANGE_STATUS:0,SIGNAL_MCPS:22.8281,AMBIENT_MCPS:0.0312,SPAD:14.0156,VEL_MM_S:0.0019,MEAS_RATE_HZ:12.6920,MEAS_AGE_US:4268,DT_HALL_US:489,DT_TOF_US:78790,DT_EST_US:486,DT_CTRL_US:493,IDENT_ACTIVE:1,IDENT_STATE:BUSCANDO_LIMIAR,IDENT_TYPE:PULSO,IDENT_REP:0,IDENT_REP_MAX:10,IDENT_FASE:1,LIM_PWM:-1,LIM_HALL_MV:0,LIM_ACTUAL_MM:NULL,LIM_RAW_MM:NULL,DELTA_LIM_MM:NULL,TEST_PWM:-1,TOF_BASE_MM:14.602,PULSO_HALL_PICO_MV:0,PULSO_ACTUAL_PICO_MM:NULL,DELTA_PULSO_MM:NULL,IDENT_MOTIVO:EM_ANDAMENTO,SYNC_PULSE:0,LIM_HALL_CIMA_MV:0,PULSO_HALL_CIMA_PICO_MV:0,SCALE_LOW:-5.00,SCALE_HIGH:30.00
TEST_ID:IDENT_PULSO_SUBIDA_AGR,TEST_PARAM:SIG=PUL;TB=800;BUSCA=5;TPAT=300;RMIN=5.00;MARG=40;TD=1200;TP=150;TE=1000;REP=10,T_US:1743479570,PWM:50,RAW:75.000,ACTUAL:13.631,REF:0.000,ERRO:13.631,HALL_MV:3129,HALL_FILT_MV:3129,HALL_CIMA_MV:1546,HALL_CIMA_FILT_MV:1588,TOF_VALID:1,NEW_TOF:0,RANGE_STATUS:0,SIGNAL_MCPS:22.8359,AMBIENT_MCPS:0.0312,SPAD:14.0156,VEL_MM_S:-0.0005,MEAS_RATE_HZ:13.5604,MEAS_AGE_US:9274,DT_HALL_US:1996,DT_TOF_US:73744,DT_EST_US:1999,DT_CTRL_US:1997,IDENT_ACTIVE:1,IDENT_STATE:BUSCANDO_LIMIAR,IDENT_TYPE:PULSO,IDENT_REP:0,IDENT_REP_MAX:10,IDENT_FASE:1,LIM_PWM:-1,LIM_HALL_MV:0,LIM_ACTUAL_MM:NULL,LIM_RAW_MM:NULL,DELTA_LIM_MM:NULL,TEST_PWM:-1,TOF_BASE_MM:14.602,PULSO_HALL_PICO_MV:0,PULSO_ACTUAL_PICO_MM:NULL,DELTA_PULSO_MM:NULL,IDENT_MOTIVO:EM_ANDAMENTO,SYNC_PULSE:0,LIM_HALL_CIMA_MV:0,PULSO_HALL_CIMA_PICO_MV:0,SCALE_LOW:-5.00,SCALE_HIGH:30.00
TEST_ID:IDENT_PULSO_SUBIDA_AGR,TEST_PARAM:SIG=PUL;TB=800;BUSCA=5;TPAT=300;RMIN=5.00;MARG=40;TD=1200;TP=150;TE=1000;REP=10,T_US:1743489570,PWM:55,RAW:75.000,ACTUAL:14.047,REF:0.000,ERRO:14.047,HALL_MV:3129,HALL_FILT_MV:3129,HALL_CIMA_MV:1641,HALL_CIMA_FILT_MV:1608,TOF_VALID:1,NEW_TOF:0,RANGE_STATUS:0,SIGNAL_MCPS:22.6719,AMBIENT_MCPS:0.0234,SPAD:14.0156,VEL_MM_S:-0.0025,MEAS_RATE_HZ:12.6950,MEAS_AGE_US:4274,DT_HALL_US:491,DT_TOF_US:78771,DT_EST_US:489,DT_CTRL_US:488,IDENT_ACTIVE:1,IDENT_STATE:BUSCANDO_LIMIAR,IDENT_TYPE:PULSO,IDENT_REP:0,IDENT_REP_MAX:10,IDENT_FASE:1,LIM_PWM:-1,LIM_HALL_MV:0,LIM_ACTUAL_MM:NULL,LIM_RAW_MM:NULL,DELTA_LIM_MM:NULL,TEST_PWM:-1,TOF_BASE_MM:14.602,PULSO_HALL_PICO_MV:0,PULSO_ACTUAL_PICO_MM:NULL,DELTA_PULSO_MM:NULL,IDENT_MOTIVO:EM_ANDAMENTO,SYNC_PULSE:0,LIM_HALL_CIMA_MV:0,PULSO_HALL_CIMA_PICO_MV:0,SCALE_LOW:-5.00,SCALE_HIGH:30.00
TEST_ID:IDENT_PULSO_SUBIDA_AGR,TEST_PARAM:SIG=PUL;TB=800;BUSCA=5;TPAT=300;RMIN=5.00;MARG=40;TD=1200;TP=150;TE=1000;REP=10,T_US:1743632102,PWM:55,RAW:75.000,ACTUAL:14.457,REF:0.000,ERRO:14.457,HALL_MV:3129,HALL_FILT_MV:3129,HALL_CIMA_MV:1543,HALL_CIMA_FILT_MV:1554,TOF_VALID:1,NEW_TOF:0,RANGE_STATUS:0,SIGNAL_MCPS:22.8906,AMBIENT_MCPS:0.0234,SPAD:14.0156,VEL_MM_S:-0.0041,MEAS_RATE_HZ:13.5573,MEAS_AGE_US:9278,DT_HALL_US:2004,DT_TOF_US:73761,DT_EST_US:2007,DT_CTRL_US:2005,IDENT_ACTIVE:1,IDENT_STATE:BUSCANDO_LIMIAR,IDENT_TYPE:PULSO,IDENT_REP:0,IDENT_REP_MAX:10,IDENT_FASE:1,LIM_PWM:-1,LIM_HALL_MV:0,LIM_ACTUAL_MM:NULL,LIM_RAW_MM:NULL,DELTA_LIM_MM:NULL,TEST_PWM:-1,TOF_BASE_MM:14.602,PULSO_HALL_PICO_MV:0,PULSO_ACTUAL_PICO_MM:NULL,DELTA_PULSO_MM:NULL,IDENT_MOTIVO:EM_ANDAMENTO,SYNC_PULSE:0,LIM_HALL_CIMA_MV:0,PULSO_HALL_CIMA_PICO_MV:0,SCALE_LOW:-5.00,SCALE_HIGH:30.00
TEST_ID:IDENT_PULSO_SUBIDA_AGR,TEST_PARAM:SIG=PUL;TB=800;BUSCA=5;TPAT=300;RMIN=5.00;MARG=40;TD=1200;TP=150;TE=1000;REP=10,T_US:1743642102,PWM:55,RAW:77.000,ACTUAL:14.175,REF:0.000,ERRO:14.175,HALL_MV:3129,HALL_FILT_MV:3129,HALL_CIMA_MV:1617,HALL_CIMA_FILT_MV:1574,TOF_VALID:1,NEW_TOF:0,RANGE_STATUS:0,SIGNAL_MCPS:22.8203,AMBIENT_MCPS:0.0234,SPAD:14.0156,VEL_MM_S:-0.0023,MEAS_RATE_HZ:12.6937,MEAS_AGE_US:4266,DT_HALL_US:489,DT_TOF_US:78779,DT_EST_US:486,DT_CTRL_US:491,IDENT_ACTIVE:1,IDENT_STATE:BUSCANDO_LIMIAR,IDENT_TYPE:PULSO,IDENT_REP:0,IDENT_REP_MAX:10,IDENT_FASE:1,LIM_PWM:-1,LIM_HALL_MV:0,LIM_ACTUAL_MM:NULL,LIM_RAW_MM:NULL,DELTA_LIM_MM:NULL,TEST_PWM:-1,TOF_BASE_MM:14.602,PULSO_HALL_PICO_MV:0,PULSO_ACTUAL_PICO_MM:NULL,DELTA_PULSO_MM:NULL,IDENT_MOTIVO:EM_ANDAMENTO,SYNC_PULSE:0,LIM_HALL_CIMA_MV:0,PULSO_HALL_CIMA_PICO_MV:0,SCALE_LOW:-5.00,SCALE_HIGH:30.00
TEST_ID:IDENT_PULSO_SUBIDA_AGR,TEST_PARAM:SIG=PUL;TB=800;BUSCA=5;TPAT=300;RMIN=5.00;MARG=40;TD=1200;TP=150;TE=1000;REP=10,T_US:1743784646,PWM:55,RAW:75.000,ACTUAL:14.531,REF:0.000,ERRO:14.531,HALL_MV:3129,HALL_FILT_MV:3129,HALL_CIMA_MV:1568,HALL_CIMA_FILT_MV:1552,TOF_VALID:1,NEW_TOF:0,RANGE_STATUS:0,SIGNAL_MCPS:22.9922,AMBIENT_MCPS:0.0312,SPAD:14.0156,VEL_MM_S:-0.0041,MEAS_RATE_HZ:13.5560,MEAS_AGE_US:9272,DT_HALL_US:1999,DT_TOF_US:73768,DT_EST_US:2002,DT_CTRL_US:2000,IDENT_ACTIVE:1,IDENT_STATE:BUSCANDO_LIMIAR,IDENT_TYPE:PULSO,IDENT_REP:0,IDENT_REP_MAX:10,IDENT_FASE:1,LIM_PWM:-1,LIM_HALL_MV:0,LIM_ACTUAL_MM:NULL,LIM_RAW_MM:NULL,DELTA_LIM_MM:NULL,TEST_PWM:-1,TOF_BASE_MM:14.602,PULSO_HALL_PICO_MV:0,PULSO_ACTUAL_PICO_MM:NULL,DELTA_PULSO_MM:NULL,IDENT_MOTIVO:EM_ANDAMENTO,SYNC_PULSE:0,LIM_HALL_CIMA_MV:0,PULSO_HALL_CIMA_PICO_MV:0,SCALE_LOW:-5.00,SCALE_HIGH:30.00
TEST_ID:IDENT_PULSO_SUBIDA_AGR,TEST_PARAM:SIG=PUL;TB=800;BUSCA=5;TPAT=300;RMIN=5.00;MARG=40;TD=1200;TP=150;TE=1000;REP=10,T_US:1743794646,PWM:60,RAW:74.000,ACTUAL:15.220,REF:0.000,ERRO:15.220,HALL_MV:3129,HALL_FILT_MV:3129,HALL_CIMA_MV:1504,HALL_CIMA_FILT_MV:1560,TOF_VALID:1,NEW_TOF:0,RANGE_STATUS:0,SIGNAL_MCPS:22.9375,AMBIENT_MCPS:0.0312,SPAD:14.0156,VEL_MM_S:-0.0075,MEAS_RATE_HZ:12.6945,MEAS_AGE_US:4259,DT_HALL_US:489,DT_TOF_US:78774,DT_EST_US:486,DT_CTRL_US:488,IDENT_ACTIVE:1,IDENT_STATE:BUSCANDO_LIMIAR,IDENT_TYPE:PULSO,IDENT_REP:0,IDENT_REP_MAX:10,IDENT_FASE:1,LIM_PWM:-1,LIM_HALL_MV:0,LIM_ACTUAL_MM:NULL,LIM_RAW_MM:NULL,DELTA_LIM_MM:NULL,TEST_PWM:-1,TOF_BASE_MM:14.602,PULSO_HALL_PICO_MV:0,PULSO_ACTUAL_PICO_MM:NULL,DELTA_PULSO_MM:NULL,IDENT_MOTIVO:EM_ANDAMENTO,SYNC_PULSE:0,LIM_HALL_CIMA_MV:0,PULSO_HALL_CIMA_PICO_MV:0,SCALE_LOW:-5.00,SCALE_HIGH:30.00
TEST_ID:IDENT_PULSO_SUBIDA_AGR,TEST_PARAM:SIG=PUL;TB=800;BUSCA=5;TPAT=300;RMIN=5.00;MARG=40;TD=1200;TP=150;TE=1000;REP=10,T_US:1743937189,PWM:60,RAW:78.000,ACTUAL:14.576,REF:0.000,ERRO:14.576,HALL_MV:3129,HALL_FILT_MV:3129,HALL_CIMA_MV:1539,HALL_CIMA_FILT_MV:1540,TOF_VALID:1,NEW_TOF:0,RANGE_STATUS:0,SIGNAL_MCPS:22.8047,AMBIENT_MCPS:0.0234,SPAD:14.0156,VEL_MM_S:-0.0031,MEAS_RATE_HZ:13.5580,MEAS_AGE_US:9288,DT_HALL_US:2000,DT_TOF_US:73757,DT_EST_US:2002,DT_CTRL_US:2000,IDENT_ACTIVE:1,IDENT_STATE:BUSCANDO_LIMIAR,IDENT_TYPE:PULSO,IDENT_REP:0,IDENT_REP_MAX:10,IDENT_FASE:1,LIM_PWM:-1,LIM_HALL_MV:0,LIM_ACTUAL_MM:NULL,LIM_RAW_MM:NULL,DELTA_LIM_MM:NULL,TEST_PWM:-1,TOF_BASE_MM:14.602,PULSO_HALL_PICO_MV:0,PULSO_ACTUAL_PICO_MM:NULL,DELTA_PULSO_MM:NULL,IDENT_MOTIVO:EM_ANDAMENTO,SYNC_PULSE:0,LIM_HALL_CIMA_MV:0,PULSO_HALL_CIMA_PICO_MV:0,SCALE_LOW:-5.00,SCALE_HIGH:30.00
TEST_ID:IDENT_PULSO_SUBIDA_AGR,TEST_PARAM:SIG=PUL;TB=800;BUSCA=5;TPAT=300;RMIN=5.00;MARG=40;TD=1200;TP=150;TE=1000;REP=10,T_US:1743947189,PWM:60,RAW:78.000,ACTUAL:13.973,REF:0.000,ERRO:13.973,HALL_MV:3129,HALL_FILT_MV:3129,HALL_CIMA_MV:1545,HALL_CIMA_FILT_MV:1556,TOF_VALID:1,NEW_TOF:0,RANGE_STATUS:0,SIGNAL_MCPS:22.7734,AMBIENT_MCPS:0.0234,SPAD:14.0156,VEL_MM_S:0.0009,MEAS_RATE_HZ:12.6928,MEAS_AGE_US:4268,DT_HALL_US:488,DT_TOF_US:78785,DT_EST_US:487,DT_CTRL_US:494,IDENT_ACTIVE:1,IDENT_STATE:BUSCANDO_LIMIAR,IDENT_TYPE:PULSO,IDENT_REP:0,IDENT_REP_MAX:10,IDENT_FASE:1,LIM_PWM:-1,LIM_HALL_MV:0,LIM_ACTUAL_MM:NULL,LIM_RAW_MM:NULL,DELTA_LIM_MM:NULL,TEST_PWM:-1,TOF_BASE_MM:14.602,PULSO_HALL_PICO_MV:0,PULSO_ACTUAL_PICO_MM:NULL,DELTA_PULSO_MM:NULL,IDENT_MOTIVO:EM_ANDAMENTO,SYNC_PULSE:0,LIM_HALL_CIMA_MV:0,PULSO_HALL_CIMA_PICO_MV:0,SCALE_LOW:-5.00,SCALE_HIGH:30.00
TEST_ID:IDENT_PULSO_SUBIDA_AGR,TEST_PARAM:SIG=PUL;TB=800;BUSCA=5;TPAT=300;RMIN=5.00;MARG=40;TD=1200;TP=150;TE=1000;REP=10,T_US:1744089797,PWM:60,RAW:74.000,ACTUAL:14.619,REF:0.000,ERRO:14.619,HALL_MV:3129,HALL_FILT_MV:3129,HALL_CIMA_MV:1528,HALL_CIMA_FILT_MV:1553,TOF_VALID:1,NEW_TOF:0,RANGE_STATUS:0,SIGNAL_MCPS:22.7813,AMBIENT_MCPS:0.0234,SPAD:14.0156,VEL_MM_S:-0.0034,MEAS_RATE_HZ:13.5441,MEAS_AGE_US:9273,DT_HALL_US:1997,DT_TOF_US:73833,DT_EST_US:1998,DT_CTRL_US:1997,IDENT_ACTIVE:1,IDENT_STATE:BUSCANDO_LIMIAR,IDENT_TYPE:PULSO,IDENT_REP:0,IDENT_REP_MAX:10,IDENT_FASE:1,LIM_PWM:-1,LIM_HALL_MV:0,LIM_ACTUAL_MM:NULL,LIM_RAW_MM:NULL,DELTA_LIM_MM:NULL,TEST_PWM:-1,TOF_BASE_MM:14.602,PULSO_HALL_PICO_MV:0,PULSO_ACTUAL_PICO_MM:NULL,DELTA_PULSO_MM:NULL,IDENT_MOTIVO:EM_ANDAMENTO,SYNC_PULSE:0,LIM_HALL_CIMA_MV:0,PULSO_HALL_CIMA_PICO_MV:0,SCALE_LOW:-5.00,SCALE_HIGH:30.00
TEST_ID:IDENT_PULSO_SUBIDA_AGR,TEST_PARAM:SIG=PUL;TB=800;BUSCA=5;TPAT=300;RMIN=5.00;MARG=40;TD=1200;TP=150;TE=1000;REP=10,T_US:1744099797,PWM:65,RAW:78.000,ACTUAL:14.077,REF:0.000,ERRO:14.077,HALL_MV:3129,HALL_FILT_MV:3129,HALL_CIMA_MV:1558,HALL_CIMA_FILT_MV:1554,TOF_VALID:1,NEW_TOF:0,RANGE_STATUS:0,SIGNAL_MCPS:22.5859,AMBIENT_MCPS:0.0312,SPAD:14.0156,VEL_MM_S:0.0005,MEAS_RATE_HZ:12.6933,MEAS_AGE_US:4263,DT_HALL_US:492,DT_TOF_US:78782,DT_EST_US:489,DT_CTRL_US:489,IDENT_ACTIVE:1,IDENT_STATE:BUSCANDO_LIMIAR,IDENT_TYPE:PULSO,IDENT_REP:0,IDENT_REP_MAX:10,IDENT_FASE:1,LIM_PWM:-1,LIM_HALL_MV:0,LIM_ACTUAL_MM:NULL,LIM_RAW_MM:NULL,DELTA_LIM_MM:NULL,TEST_PWM:-1,TOF_BASE_MM:14.602,PULSO_HALL_PICO_MV:0,PULSO_ACTUAL_PICO_MM:NULL,DELTA_PULSO_MM:NULL,IDENT_MOTIVO:EM_ANDAMENTO,SYNC_PULSE:0,LIM_HALL_CIMA_MV:0,PULSO_HALL_CIMA_PICO_MV:0,SCALE_LOW:-5.00,SCALE_HIGH:30.00
TEST_ID:IDENT_PULSO_SUBIDA_AGR,TEST_PARAM:SIG=PUL;TB=800;BUSCA=5;TPAT=300;RMIN=5.00;MARG=40;TD=1200;TP=150;TE=1000;REP=10,T_US:1744242416,PWM:65,RAW:75.000,ACTUAL:14.399,REF:0.000,ERRO:14.399,HALL_MV:3129,HALL_FILT_MV:3129,HALL_CIMA_MV:1499,HALL_CIMA_FILT_MV:1528,TOF_VALID:1,NEW_TOF:0,RANGE_STATUS:0,SIGNAL_MCPS:22.8750,AMBIENT_MCPS:0.0234,SPAD:14.0156,VEL_MM_S:-0.0018,MEAS_RATE_HZ:13.5452,MEAS_AGE_US:9282,DT_HALL_US:2000,DT_TOF_US:73827,DT_EST_US:2002,DT_CTRL_US:2000,IDENT_ACTIVE:1,IDENT_STATE:BUSCANDO_LIMIAR,IDENT_TYPE:PULSO,IDENT_REP:0,IDENT_REP_MAX:10,IDENT_FASE:1,LIM_PWM:-1,LIM_HALL_MV:0,LIM_ACTUAL_MM:NULL,LIM_RAW_MM:NULL,DELTA_LIM_MM:NULL,TEST_PWM:-1,TOF_BASE_MM:14.602,PULSO_HALL_PICO_MV:0,PULSO_ACTUAL_PICO_MM:NULL,DELTA_PULSO_MM:NULL,IDENT_MOTIVO:EM_ANDAMENTO,SYNC_PULSE:0,LIM_HALL_CIMA_MV:0,PULSO_HALL_CIMA_PICO_MV:0,SCALE_LOW:-5.00,SCALE_HIGH:30.00
TEST_ID:IDENT_PULSO_SUBIDA_AGR,TEST_PARAM:SIG=PUL;TB=800;BUSCA=5;TPAT=300;RMIN=5.00;MARG=40;TD=1200;TP=150;TE=1000;REP=10,T_US:1744252416,PWM:65,RAW:77.000,ACTUAL:14.174,REF:0.000,ERRO:14.174,HALL_MV:3129,HALL_FILT_MV:3129,HALL_CIMA_MV:1518,HALL_CIMA_FILT_MV:1535,TOF_VALID:1,NEW_TOF:0,RANGE_STATUS:0,SIGNAL_MCPS:22.9375,AMBIENT_MCPS:0.0312,SPAD:14.0156,VEL_MM_S:-0.0000,MEAS_RATE_HZ:12.6937,MEAS_AGE_US:4269,DT_HALL_US:489,DT_TOF_US:78779,DT_EST_US:491,DT_CTRL_US:492,IDENT_ACTIVE:1,IDENT_STATE:BUSCANDO_LIMIAR,IDENT_TYPE:PULSO,IDENT_REP:0,IDENT_REP_MAX:10,IDENT_FASE:1,LIM_PWM:-1,LIM_HALL_MV:0,LIM_ACTUAL_MM:NULL,LIM_RAW_MM:NULL,DELTA_LIM_MM:NULL,TEST_PWM:-1,TOF_BASE_MM:14.602,PULSO_HALL_PICO_MV:0,PULSO_ACTUAL_PICO_MM:NULL,DELTA_PULSO_MM:NULL,IDENT_MOTIVO:EM_ANDAMENTO,SYNC_PULSE:0,LIM_HALL_CIMA_MV:0,PULSO_HALL_CIMA_PICO_MV:0,SCALE_LOW:-5.00,SCALE_HIGH:30.00
TEST_ID:IDENT_PULSO_SUBIDA_AGR,TEST_PARAM:SIG=PUL;TB=800;BUSCA=5;TPAT=300;RMIN=5.00;MARG=40;TD=1200;TP=150;TE=1000;REP=10,T_US:1744394952,PWM:65,RAW:74.000,ACTUAL:14.716,REF:0.000,ERRO:14.716,HALL_MV:3129,HALL_FILT_MV:3129,HALL_CIMA_MV:1552,HALL_CIMA_FILT_MV:1532,TOF_VALID:1,NEW_TOF:0,RANGE_STATUS:0,SIGNAL_MCPS:22.8672,AMBIENT_MCPS:0.0234,SPAD:14.0156,VEL_MM_S:-0.0039,MEAS_RATE_HZ:13.5573,MEAS_AGE_US:9280,DT_HALL_US:1997,DT_TOF_US:73761,DT_EST_US:1999,DT_CTRL_US:1996,IDENT_ACTIVE:1,IDENT_STATE:BUSCANDO_LIMIAR,IDENT_TYPE:PULSO,IDENT_REP:0,IDENT_REP_MAX:10,IDENT_FASE:1,LIM_PWM:-1,LIM_HALL_MV:0,LIM_ACTUAL_MM:NULL,LIM_RAW_MM:NULL,DELTA_LIM_MM:NULL,TEST_PWM:-1,TOF_BASE_MM:14.602,PULSO_HALL_PICO_MV:0,PULSO_ACTUAL_PICO_MM:NULL,DELTA_PULSO_MM:NULL,IDENT_MOTIVO:EM_ANDAMENTO,SYNC_PULSE:0,LIM_HALL_CIMA_MV:0,PULSO_HALL_CIMA_PICO_MV:0,SCALE_LOW:-5.00,SCALE_HIGH:30.00
TEST_ID:IDENT_PULSO_SUBIDA_AGR,TEST_PARAM:SIG=PUL;TB=800;BUSCA=5;TPAT=300;RMIN=5.00;MARG=40;TD=1200;TP=150;TE=1000;REP=10,T_US:1744404952,PWM:70,RAW:76.000,ACTUAL:15.574,REF:0.000,ERRO:15.574,HALL_MV:3129,HALL_FILT_MV:3129,HALL_CIMA_MV:1589,HALL_CIMA_FILT_MV:1537,TOF_VALID:1,NEW_TOF:0,RANGE_STATUS:0,SIGNAL_MCPS:22.8672,AMBIENT_MCPS:0.0312,SPAD:14.0156,VEL_MM_S:-0.0094,MEAS_RATE_HZ:200.0000,MEAS_AGE_US:3136,DT_HALL_US:606,DT_TOF_US:5000,DT_EST_US:584,DT_CTRL_US:489,IDENT_ACTIVE:1,IDENT_STATE:BUSCANDO_LIMIAR,IDENT_TYPE:PULSO,IDENT_REP:0,IDENT_REP_MAX:10,IDENT_FASE:1,LIM_PWM:-1,LIM_HALL_MV:0,LIM_ACTUAL_MM:NULL,LIM_RAW_MM:NULL,DELTA_LIM_MM:NULL,TEST_PWM:-1,TOF_BASE_MM:14.602,PULSO_HALL_PICO_MV:0,PULSO_ACTUAL_PICO_MM:NULL,DELTA_PULSO_MM:NULL,IDENT_MOTIVO:EM_ANDAMENTO,SYNC_PULSE:0,LIM_HALL_CIMA_MV:0,PULSO_HALL_CIMA_PICO_MV:0,SCALE_LOW:-5.00,SCALE_HIGH:30.00
TEST_ID:IDENT_PULSO_SUBIDA_AGR,TEST_PARAM:SIG=PUL;TB=800;BUSCA=5;TPAT=300;RMIN=5.00;MARG=40;TD=1200;TP=150;TE=1000;REP=10,T_US:1744549657,PWM:70,RAW:75.000,ACTUAL:15.727,REF:0.000,ERRO:15.727,HALL_MV:3129,HALL_FILT_MV:3129,HALL_CIMA_MV:1620,HALL_CIMA_FILT_MV:1542,TOF_VALID:1,NEW_TOF:0,RANGE_STATUS:0,SIGNAL_MCPS:22.9375,AMBIENT_MCPS:0.0234,SPAD:14.0156,VEL_MM_S:-0.0095,MEAS_RATE_HZ:13.7669,MEAS_AGE_US:9266,DT_HALL_US:2000,DT_TOF_US:72638,DT_EST_US:2002,DT_CTRL_US:1999,IDENT_ACTIVE:1,IDENT_STATE:BUSCANDO_LIMIAR,IDENT_TYPE:PULSO,IDENT_REP:0,IDENT_REP_MAX:10,IDENT_FASE:1,LIM_PWM:-1,LIM_HALL_MV:0,LIM_ACTUAL_MM:NULL,LIM_RAW_MM:NULL,DELTA_LIM_MM:NULL,TEST_PWM:-1,TOF_BASE_MM:14.602,PULSO_HALL_PICO_MV:0,PULSO_ACTUAL_PICO_MM:NULL,DELTA_PULSO_MM:NULL,IDENT_MOTIVO:EM_ANDAMENTO,SYNC_PULSE:0,LIM_HALL_CIMA_MV:0,PULSO_HALL_CIMA_PICO_MV:0,SCALE_LOW:-5.00,SCALE_HIGH:30.00
TEST_ID:IDENT_PULSO_SUBIDA_AGR,TEST_PARAM:SIG=PUL;TB=800;BUSCA=5;TPAT=300;RMIN=5.00;MARG=40;TD=1200;TP=150;TE=1000;REP=10,T_US:1744559657,PWM:70,RAW:77.000,ACTUAL:15.308,REF:0.000,ERRO:15.308,HALL_MV:3129,HALL_FILT_MV:3129,HALL_CIMA_MV:1474,HALL_CIMA_FILT_MV:1496,TOF_VALID:1,NEW_TOF:0,RANGE_STATUS:0,SIGNAL_MCPS:22.9375,AMBIENT_MCPS:0.0312,SPAD:14.0156,VEL_MM_S:-0.0060,MEAS_RATE_HZ:12.6949,MEAS_AGE_US:4261,DT_HALL_US:489,DT_TOF_US:78772,DT_EST_US:487,DT_CTRL_US:488,IDENT_ACTIVE:1,IDENT_STATE:BUSCANDO_LIMIAR,IDENT_TYPE:PULSO,IDENT_REP:0,IDENT_REP_MAX:10,IDENT_FASE:1,LIM_PWM:-1,LIM_HALL_MV:0,LIM_ACTUAL_MM:NULL,LIM_RAW_MM:NULL,DELTA_LIM_MM:NULL,TEST_PWM:-1,TOF_BASE_MM:14.602,PULSO_HALL_PICO_MV:0,PULSO_ACTUAL_PICO_MM:NULL,DELTA_PULSO_MM:NULL,IDENT_MOTIVO:EM_ANDAMENTO,SYNC_PULSE:0,LIM_HALL_CIMA_MV:0,PULSO_HALL_CIMA_PICO_MV:0,SCALE_LOW:-5.00,SCALE_HIGH:30.00
TEST_ID:IDENT_PULSO_SUBIDA_AGR,TEST_PARAM:SIG=PUL;TB=800;BUSCA=5;TPAT=300;RMIN=5.00;MARG=40;TD=1200;TP=150;TE=1000;REP=10,T_US:1744702189,PWM:70,RAW:79.000,ACTUAL:14.427,REF:0.000,ERRO:14.427,HALL_MV:3129,HALL_FILT_MV:3129,HALL_CIMA_MV:1534,HALL_CIMA_FILT_MV:1544,TOF_VALID:1,NEW_TOF:0,RANGE_STATUS:0,SIGNAL_MCPS:22.8906,AMBIENT_MCPS:0.0312,SPAD:14.0156,VEL_MM_S:0.0006,MEAS_RATE_HZ:13.5588,MEAS_AGE_US:9280,DT_HALL_US:2000,DT_TOF_US:73753,DT_EST_US:2001,DT_CTRL_US:1999,IDENT_ACTIVE:1,IDENT_STATE:BUSCANDO_LIMIAR,IDENT_TYPE:PULSO,IDENT_REP:0,IDENT_REP_MAX:10,IDENT_FASE:1,LIM_PWM:-1,LIM_HALL_MV:0,LIM_ACTUAL_MM:NULL,LIM_RAW_MM:NULL,DELTA_LIM_MM:NULL,TEST_PWM:-1,TOF_BASE_MM:14.602,PULSO_HALL_PICO_MV:0,PULSO_ACTUAL_PICO_MM:NULL,DELTA_PULSO_MM:NULL,IDENT_MOTIVO:EM_ANDAMENTO,SYNC_PULSE:0,LIM_HALL_CIMA_MV:0,PULSO_HALL_CIMA_PICO_MV:0,SCALE_LOW:-5.00,SCALE_HIGH:30.00
TEST_ID:IDENT_PULSO_SUBIDA_AGR,TEST_PARAM:SIG=PUL;TB=800;BUSCA=5;TPAT=300;RMIN=5.00;MARG=40;TD=1200;TP=150;TE=1000;REP=10,T_US:1744712189,PWM:75,RAW:77.000,ACTUAL:14.114,REF:0.000,ERRO:14.114,HALL_MV:3129,HALL_FILT_MV:3129,HALL_CIMA_MV:1480,HALL_CIMA_FILT_MV:1522,TOF_VALID:1,NEW_TOF:0,RANGE_STATUS:0,SIGNAL_MCPS:22.8281,AMBIENT_MCPS:0.0312,SPAD:14.0156,VEL_MM_S:0.0023,MEAS_RATE_HZ:12.6942,MEAS_AGE_US:4274,DT_HALL_US:488,DT_TOF_US:78776,DT_EST_US:487,DT_CTRL_US:493,IDENT_ACTIVE:1,IDENT_STATE:BUSCANDO_LIMIAR,IDENT_TYPE:PULSO,IDENT_REP:0,IDENT_REP_MAX:10,IDENT_FASE:1,LIM_PWM:-1,LIM_HALL_MV:0,LIM_ACTUAL_MM:NULL,LIM_RAW_MM:NULL,DELTA_LIM_MM:NULL,TEST_PWM:-1,TOF_BASE_MM:14.602,PULSO_HALL_PICO_MV:0,PULSO_ACTUAL_PICO_MM:NULL,DELTA_PULSO_MM:NULL,IDENT_MOTIVO:EM_ANDAMENTO,SYNC_PULSE:0,LIM_HALL_CIMA_MV:0,PULSO_HALL_CIMA_PICO_MV:0,SCALE_LOW:-5.00,SCALE_HIGH:30.00
TEST_ID:IDENT_PULSO_SUBIDA_AGR,TEST_PARAM:SIG=PUL;TB=800;BUSCA=5;TPAT=300;RMIN=5.00;MARG=40;TD=1200;TP=150;TE=1000;REP=10,T_US:1744854716,PWM:75,RAW:78.000,ACTUAL:13.271,REF:0.000,ERRO:13.271,HALL_MV:3129,HALL_FILT_MV:3129,HALL_CIMA_MV:1484,HALL_CIMA_FILT_MV:1517,TOF_VALID:1,NEW_TOF:0,RANGE_STATUS:0,SIGNAL_MCPS:22.6875,AMBIENT_MCPS:0.0312,SPAD:14.0156,VEL_MM_S:0.0059,MEAS_RATE_HZ:13.5599,MEAS_AGE_US:9279,DT_HALL_US:1996,DT_TOF_US:73747,DT_EST_US:1998,DT_CTRL_US:1996,IDENT_ACTIVE:1,IDENT_STATE:BUSCANDO_LIMIAR,IDENT_TYPE:PULSO,IDENT_REP:0,IDENT_REP_MAX:10,IDENT_FASE:1,LIM_PWM:-1,LIM_HALL_MV:0,LIM_ACTUAL_MM:NULL,LIM_RAW_MM:NULL,DELTA_LIM_MM:NULL,TEST_PWM:-1,TOF_BASE_MM:14.602,PULSO_HALL_PICO_MV:0,PULSO_ACTUAL_PICO_MM:NULL,DELTA_PULSO_MM:NULL,IDENT_MOTIVO:EM_ANDAMENTO,SYNC_PULSE:0,LIM_HALL_CIMA_MV:0,PULSO_HALL_CIMA_PICO_MV:0,SCALE_LOW:-5.00,SCALE_HIGH:30.00
TEST_ID:IDENT_PULSO_SUBIDA_AGR,TEST_PARAM:SIG=PUL;TB=800;BUSCA=5;TPAT=300;RMIN=5.00;MARG=40;TD=1200;TP=150;TE=1000;REP=10,T_US:1744864716,PWM:75,RAW:76.000,ACTUAL:13.644,REF:0.000,ERRO:13.644,HALL_MV:3129,HALL_FILT_MV:3129,HALL_CIMA_MV:1522,HALL_CIMA_FILT_MV:1504,TOF_VALID:1,NEW_TOF:0,RANGE_STATUS:0,SIGNAL_MCPS:22.8203,AMBIENT_MCPS:0.0234,SPAD:14.0156,VEL_MM_S:0.0036,MEAS_RATE_HZ:12.6928,MEAS_AGE_US:4263,DT_HALL_US:493,DT_TOF_US:78785,DT_EST_US:489,DT_CTRL_US:489,IDENT_ACTIVE:1,IDENT_STATE:BUSCANDO_LIMIAR,IDENT_TYPE:PULSO,IDENT_REP:0,IDENT_REP_MAX:10,IDENT_FASE:1,LIM_PWM:-1,LIM_HALL_MV:0,LIM_ACTUAL_MM:NULL,LIM_RAW_MM:NULL,DELTA_LIM_MM:NULL,TEST_PWM:-1,TOF_BASE_MM:14.602,PULSO_HALL_PICO_MV:0,PULSO_ACTUAL_PICO_MM:NULL,DELTA_PULSO_MM:NULL,IDENT_MOTIVO:EM_ANDAMENTO,SYNC_PULSE:0,LIM_HALL_CIMA_MV:0,PULSO_HALL_CIMA_PICO_MV:0,SCALE_LOW:-5.00,SCALE_HIGH:30.00
TEST_ID:IDENT_PULSO_SUBIDA_AGR,TEST_PARAM:SIG=PUL;TB=800;BUSCA=5;TPAT=300;RMIN=5.00;MARG=40;TD=1200;TP=150;TE=1000;REP=10,T_US:1745007326,PWM:75,RAW:74.000,ACTUAL:14.740,REF:0.000,ERRO:14.740,HALL_MV:3129,HALL_FILT_MV:3129,HALL_CIMA_MV:1526,HALL_CIMA_FILT_MV:1496,TOF_VALID:1,NEW_TOF:0,RANGE_STATUS:0,SIGNAL_MCPS:22.6484,AMBIENT_MCPS:0.0312,SPAD:14.0156,VEL_MM_S:-0.0050,MEAS_RATE_HZ:13.5461,MEAS_AGE_US:9282,DT_HALL_US:1999,DT_TOF_US:73822,DT_EST_US:2001,DT_CTRL_US:1999,IDENT_ACTIVE:1,IDENT_STATE:BUSCANDO_LIMIAR,IDENT_TYPE:PULSO,IDENT_REP:0,IDENT_REP_MAX:10,IDENT_FASE:1,LIM_PWM:-1,LIM_HALL_MV:0,LIM_ACTUAL_MM:NULL,LIM_RAW_MM:NULL,DELTA_LIM_MM:NULL,TEST_PWM:-1,TOF_BASE_MM:14.602,PULSO_HALL_PICO_MV:0,PULSO_ACTUAL_PICO_MM:NULL,DELTA_PULSO_MM:NULL,IDENT_MOTIVO:EM_ANDAMENTO,SYNC_PULSE:0,LIM_HALL_CIMA_MV:0,PULSO_HALL_CIMA_PICO_MV:0,SCALE_LOW:-5.00,SCALE_HIGH:30.00
TEST_ID:IDENT_PULSO_SUBIDA_AGR,TEST_PARAM:SIG=PUL;TB=800;BUSCA=5;TPAT=300;RMIN=5.00;MARG=40;TD=1200;TP=150;TE=1000;REP=10,T_US:1745017326,PWM:80,RAW:76.000,ACTUAL:14.720,REF:0.000,ERRO:14.720,HALL_MV:3129,HALL_FILT_MV:3129,HALL_CIMA_MV:1433,HALL_CIMA_FILT_MV:1487,TOF_VALID:1,NEW_TOF:0,RANGE_STATUS:0,SIGNAL_MCPS:22.6406,AMBIENT_MCPS:0.0234,SPAD:14.0156,VEL_MM_S:-0.0045,MEAS_RATE_HZ:12.6937,MEAS_AGE_US:4271,DT_HALL_US:489,DT_TOF_US:78779,DT_EST_US:486,DT_CTRL_US:492,IDENT_ACTIVE:1,IDENT_STATE:BUSCANDO_LIMIAR,IDENT_TYPE:PULSO,IDENT_REP:0,IDENT_REP_MAX:10,IDENT_FASE:1,LIM_PWM:-1,LIM_HALL_MV:0,LIM_ACTUAL_MM:NULL,LIM_RAW_MM:NULL,DELTA_LIM_MM:NULL,TEST_PWM:-1,TOF_BASE_MM:14.602,PULSO_HALL_PICO_MV:0,PULSO_ACTUAL_PICO_MM:NULL,DELTA_PULSO_MM:NULL,IDENT_MOTIVO:EM_ANDAMENTO,SYNC_PULSE:0,LIM_HALL_CIMA_MV:0,PULSO_HALL_CIMA_PICO_MV:0,SCALE_LOW:-5.00,SCALE_HIGH:30.00
TEST_ID:IDENT_PULSO_SUBIDA_AGR,TEST_PARAM:SIG=PUL;TB=800;BUSCA=5;TPAT=300;RMIN=5.00;MARG=40;TD=1200;TP=150;TE=1000;REP=10,T_US:1745159871,PWM:80,RAW:79.000,ACTUAL:13.586,REF:0.000,ERRO:13.586,HALL_MV:3129,HALL_FILT_MV:3129,HALL_CIMA_MV:1518,HALL_CIMA_FILT_MV:1513,TOF_VALID:1,NEW_TOF:0,RANGE_STATUS:0,SIGNAL_MCPS:22.5078,AMBIENT_MCPS:0.0312,SPAD:14.0156,VEL_MM_S:0.0103,MEAS_RATE_HZ:13.5566,MEAS_AGE_US:9282,DT_HALL_US:1996,DT_TOF_US:73765,DT_EST_US:1998,DT_CTRL_US:1996,IDENT_ACTIVE:1,IDENT_STATE:BUSCANDO_LIMIAR,IDENT_TYPE:PULSO,IDENT_REP:0,IDENT_REP_MAX:10,IDENT_FASE:1,LIM_PWM:-1,LIM_HALL_MV:0,LIM_ACTUAL_MM:NULL,LIM_RAW_MM:NULL,DELTA_LIM_MM:NULL,TEST_PWM:-1,TOF_BASE_MM:14.602,PULSO_HALL_PICO_MV:0,PULSO_ACTUAL_PICO_MM:NULL,DELTA_PULSO_MM:NULL,IDENT_MOTIVO:EM_ANDAMENTO,SYNC_PULSE:0,LIM_HALL_CIMA_MV:0,PULSO_HALL_CIMA_PICO_MV:0,SCALE_LOW:-5.00,SCALE_HIGH:30.00
TEST_ID:IDENT_PULSO_SUBIDA_AGR,TEST_PARAM:SIG=PUL;TB=800;BUSCA=5;TPAT=300;RMIN=5.00;MARG=40;TD=1200;TP=150;TE=1000;REP=10,T_US:1745169871,PWM:80,RAW:77.000,ACTUAL:13.412,REF:0.000,ERRO:13.412,HALL_MV:3129,HALL_FILT_MV:3129,HALL_CIMA_MV:1475,HALL_CIMA_FILT_MV:1499,TOF_VALID:1,NEW_TOF:0,RANGE_STATUS:0,SIGNAL_MCPS:22.6250,AMBIENT_MCPS:0.0312,SPAD:14.0156,VEL_MM_S:0.0120,MEAS_RATE_HZ:12.6920,MEAS_AGE_US:4264,DT_HALL_US:492,DT_TOF_US:78790,DT_EST_US:486,DT_CTRL_US:493,IDENT_ACTIVE:1,IDENT_STATE:BUSCANDO_LIMIAR,IDENT_TYPE:PULSO,IDENT_REP:0,IDENT_REP_MAX:10,IDENT_FASE:1,LIM_PWM:-1,LIM_HALL_MV:0,LIM_ACTUAL_MM:NULL,LIM_RAW_MM:NULL,DELTA_LIM_MM:NULL,TEST_PWM:-1,TOF_BASE_MM:14.602,PULSO_HALL_PICO_MV:0,PULSO_ACTUAL_PICO_MM:NULL,DELTA_PULSO_MM:NULL,IDENT_MOTIVO:EM_ANDAMENTO,SYNC_PULSE:0,LIM_HALL_CIMA_MV:0,PULSO_HALL_CIMA_PICO_MV:0,SCALE_LOW:-5.00,SCALE_HIGH:30.00
TEST_ID:IDENT_PULSO_SUBIDA_AGR,TEST_PARAM:SIG=PUL;TB=800;BUSCA=5;TPAT=300;RMIN=5.00;MARG=40;TD=1200;TP=150;TE=1000;REP=10,T_US:1745312394,PWM:80,RAW:77.000,ACTUAL:13.274,REF:0.000,ERRO:13.274,HALL_MV:3129,HALL_FILT_MV:3129,HALL_CIMA_MV:1487,HALL_CIMA_FILT_MV:1493,TOF_VALID:1,NEW_TOF:0,RANGE_STATUS:0,SIGNAL_MCPS:22.7578,AMBIENT_MCPS:0.0312,SPAD:14.0156,VEL_MM_S:0.0131,MEAS_RATE_HZ:13.5617,MEAS_AGE_US:9277,DT_HALL_US:2000,DT_TOF_US:73737,DT_EST_US:2003,DT_CTRL_US:2000,IDENT_ACTIVE:1,IDENT_STATE:BUSCANDO_LIMIAR,IDENT_TYPE:PULSO,IDENT_REP:0,IDENT_REP_MAX:10,IDENT_FASE:1,LIM_PWM:-1,LIM_HALL_MV:0,LIM_ACTUAL_MM:NULL,LIM_RAW_MM:NULL,DELTA_LIM_MM:NULL,TEST_PWM:-1,TOF_BASE_MM:14.602,PULSO_HALL_PICO_MV:0,PULSO_ACTUAL_PICO_MM:NULL,DELTA_PULSO_MM:NULL,IDENT_MOTIVO:EM_ANDAMENTO,SYNC_PULSE:0,LIM_HALL_CIMA_MV:0,PULSO_HALL_CIMA_PICO_MV:0,SCALE_LOW:-5.00,SCALE_HIGH:30.00
TEST_ID:IDENT_PULSO_SUBIDA_AGR,TEST_PARAM:SIG=PUL;TB=800;BUSCA=5;TPAT=300;RMIN=5.00;MARG=40;TD=1200;TP=150;TE=1000;REP=10,T_US:1745322394,PWM:85,RAW:76.000,ACTUAL:13.478,REF:0.000,ERRO:13.478,HALL_MV:3129,HALL_FILT_MV:3129,HALL_CIMA_MV:1512,HALL_CIMA_FILT_MV:1473,TOF_VALID:1,NEW_TOF:0,RANGE_STATUS:0,SIGNAL_MCPS:22.7813,AMBIENT_MCPS:0.0234,SPAD:14.0156,VEL_MM_S:0.0088,MEAS_RATE_HZ:12.6947,MEAS_AGE_US:4281,DT_HALL_US:488,DT_TOF_US:78773,DT_EST_US:490,DT_CTRL_US:492,IDENT_ACTIVE:1,IDENT_STATE:BUSCANDO_LIMIAR,IDENT_TYPE:PULSO,IDENT_REP:0,IDENT_REP_MAX:10,IDENT_FASE:1,LIM_PWM:-1,LIM_HALL_MV:0,LIM_ACTUAL_MM:NULL,LIM_RAW_MM:NULL,DELTA_LIM_MM:NULL,TEST_PWM:-1,TOF_BASE_MM:14.602,PULSO_HALL_PICO_MV:0,PULSO_ACTUAL_PICO_MM:NULL,DELTA_PULSO_MM:NULL,IDENT_MOTIVO:EM_ANDAMENTO,SYNC_PULSE:0,LIM_HALL_CIMA_MV:0,PULSO_HALL_CIMA_PICO_MV:0,SCALE_LOW:-5.00,SCALE_HIGH:30.00
TEST_ID:IDENT_PULSO_SUBIDA_AGR,TEST_PARAM:SIG=PUL;TB=800;BUSCA=5;TPAT=300;RMIN=5.00;MARG=40;TD=1200;TP=150;TE=1000;REP=10,T_US:1745464914,PWM:85,RAW:76.000,ACTUAL:13.646,REF:0.000,ERRO:13.646,HALL_MV:3129,HALL_FILT_MV:3129,HALL_CIMA_MV:1478,HALL_CIMA_FILT_MV:1496,TOF_VALID:1,NEW_TOF:0,RANGE_STATUS:0,SIGNAL_MCPS:22.8516,AMBIENT_MCPS:0.0312,SPAD:14.0156,VEL_MM_S:0.0054,MEAS_RATE_HZ:13.5608,MEAS_AGE_US:9283,DT_HALL_US:2002,DT_TOF_US:73742,DT_EST_US:2004,DT_CTRL_US:2002,IDENT_ACTIVE:1,IDENT_STATE:BUSCANDO_LIMIAR,IDENT_TYPE:PULSO,IDENT_REP:0,IDENT_REP_MAX:10,IDENT_FASE:1,LIM_PWM:-1,LIM_HALL_MV:0,LIM_ACTUAL_MM:NULL,LIM_RAW_MM:NULL,DELTA_LIM_MM:NULL,TEST_PWM:-1,TOF_BASE_MM:14.602,PULSO_HALL_PICO_MV:0,PULSO_ACTUAL_PICO_MM:NULL,DELTA_PULSO_MM:NULL,IDENT_MOTIVO:EM_ANDAMENTO,SYNC_PULSE:0,LIM_HALL_CIMA_MV:0,PULSO_HALL_CIMA_PICO_MV:0,SCALE_LOW:-5.00,SCALE_HIGH:30.00
TEST_ID:IDENT_PULSO_SUBIDA_AGR,TEST_PARAM:SIG=PUL;TB=800;BUSCA=5;TPAT=300;RMIN=5.00;MARG=40;TD=1200;TP=150;TE=1000;REP=10,T_US:1745474914,PWM:85,RAW:76.000,ACTUAL:13.787,REF:0.000,ERRO:13.787,HALL_MV:3129,HALL_FILT_MV:3129,HALL_CIMA_MV:1418,HALL_CIMA_FILT_MV:1466,TOF_VALID:1,NEW_TOF:0,RANGE_STATUS:0,SIGNAL_MCPS:22.9688,AMBIENT_MCPS:0.0391,SPAD:14.0156,VEL_MM_S:0.0026,MEAS_RATE_HZ:12.6924,MEAS_AGE_US:4269,DT_HALL_US:492,DT_TOF_US:78787,DT_EST_US:486,DT_CTRL_US:488,IDENT_ACTIVE:1,IDENT_STATE:BUSCANDO_LIMIAR,IDENT_TYPE:PULSO,IDENT_REP:0,IDENT_REP_MAX:10,IDENT_FASE:1,LIM_PWM:-1,LIM_HALL_MV:0,LIM_ACTUAL_MM:NULL,LIM_RAW_MM:NULL,DELTA_LIM_MM:NULL,TEST_PWM:-1,TOF_BASE_MM:14.602,PULSO_HALL_PICO_MV:0,PULSO_ACTUAL_PICO_MM:NULL,DELTA_PULSO_MM:NULL,IDENT_MOTIVO:EM_ANDAMENTO,SYNC_PULSE:0,LIM_HALL_CIMA_MV:0,PULSO_HALL_CIMA_PICO_MV:0,SCALE_LOW:-5.00,SCALE_HIGH:30.00
TEST_ID:IDENT_PULSO_SUBIDA_AGR,TEST_PARAM:SIG=PUL;TB=800;BUSCA=5;TPAT=300;RMIN=5.00;MARG=40;TD=1200;TP=150;TE=1000;REP=10,T_US:1745617436,PWM:85,RAW:79.000,ACTUAL:13.009,REF:0.000,ERRO:13.009,HALL_MV:3129,HALL_FILT_MV:3129,HALL_CIMA_MV:1481,HALL_CIMA_FILT_MV:1483,TOF_VALID:1,NEW_TOF:0,RANGE_STATUS:0,SIGNAL_MCPS:23.0234,AMBIENT_MCPS:0.0391,SPAD:14.0156,VEL_MM_S:0.0148,MEAS_RATE_HZ:13.5604,MEAS_AGE_US:9277,DT_HALL_US:2000,DT_TOF_US:73744,DT_EST_US:2002,DT_CTRL_US:2000,IDENT_ACTIVE:1,IDENT_STATE:BUSCANDO_LIMIAR,IDENT_TYPE:PULSO,IDENT_REP:0,IDENT_REP_MAX:10,IDENT_FASE:1,LIM_PWM:-1,LIM_HALL_MV:0,LIM_ACTUAL_MM:NULL,LIM_RAW_MM:NULL,DELTA_LIM_MM:NULL,TEST_PWM:-1,TOF_BASE_MM:14.602,PULSO_HALL_PICO_MV:0,PULSO_ACTUAL_PICO_MM:NULL,DELTA_PULSO_MM:NULL,IDENT_MOTIVO:EM_ANDAMENTO,SYNC_PULSE:0,LIM_HALL_CIMA_MV:0,PULSO_HALL_CIMA_PICO_MV:0,SCALE_LOW:-5.00,SCALE_HIGH:30.00
TEST_ID:IDENT_PULSO_SUBIDA_AGR,TEST_PARAM:SIG=PUL;TB=800;BUSCA=5;TPAT=300;RMIN=5.00;MARG=40;TD=1200;TP=150;TE=1000;REP=10,T_US:1745627436,PWM:90,RAW:79.000,ACTUAL:12.313,REF:0.000,ERRO:12.313,HALL_MV:3129,HALL_FILT_MV:3129,HALL_CIMA_MV:1574,HALL_CIMA_FILT_MV:1492,TOF_VALID:1,NEW_TOF:0,RANGE_STATUS:0,SIGNAL_MCPS:23.1641,AMBIENT_MCPS:0.0156,SPAD:14.0156,VEL_MM_S:0.0244,MEAS_RATE_HZ:12.6945,MEAS_AGE_US:4275,DT_HALL_US:488,DT_TOF_US:78774,DT_EST_US:491,DT_CTRL_US:493,IDENT_ACTIVE:1,IDENT_STATE:BUSCANDO_LIMIAR,IDENT_TYPE:PULSO,IDENT_REP:0,IDENT_REP_MAX:10,IDENT_FASE:1,LIM_PWM:-1,LIM_HALL_MV:0,LIM_ACTUAL_MM:NULL,LIM_RAW_MM:NULL,DELTA_LIM_MM:NULL,TEST_PWM:-1,TOF_BASE_MM:14.602,PULSO_HALL_PICO_MV:0,PULSO_ACTUAL_PICO_MM:NULL,DELTA_PULSO_MM:NULL,IDENT_MOTIVO:EM_ANDAMENTO,SYNC_PULSE:0,LIM_HALL_CIMA_MV:0,PULSO_HALL_CIMA_PICO_MV:0,SCALE_LOW:-5.00,SCALE_HIGH:30.00
TEST_ID:IDENT_PULSO_SUBIDA_AGR,TEST_PARAM:SIG=PUL;TB=800;BUSCA=5;TPAT=300;RMIN=5.00;MARG=40;TD=1200;TP=150;TE=1000;REP=10,T_US:1745769963,PWM:90,RAW:80.000,ACTUAL:11.435,REF:0.000,ERRO:11.435,HALL_MV:3129,HALL_FILT_MV:3129,HALL_CIMA_MV:1408,HALL_CIMA_FILT_MV:1459,TOF_VALID:1,NEW_TOF:0,RANGE_STATUS:0,SIGNAL_MCPS:22.8750,AMBIENT_MCPS:0.0234,SPAD:14.0156,VEL_MM_S:0.0346,MEAS_RATE_HZ:13.5608,MEAS_AGE_US:9287,DT_HALL_US:2004,DT_TOF_US:73742,DT_EST_US:2006,DT_CTRL_US:2003,IDENT_ACTIVE:1,IDENT_STATE:BUSCANDO_LIMIAR,IDENT_TYPE:PULSO,IDENT_REP:0,IDENT_REP_MAX:10,IDENT_FASE:1,LIM_PWM:-1,LIM_HALL_MV:0,LIM_ACTUAL_MM:NULL,LIM_RAW_MM:NULL,DELTA_LIM_MM:NULL,TEST_PWM:-1,TOF_BASE_MM:14.602,PULSO_HALL_PICO_MV:0,PULSO_ACTUAL_PICO_MM:NULL,DELTA_PULSO_MM:NULL,IDENT_MOTIVO:EM_ANDAMENTO,SYNC_PULSE:0,LIM_HALL_CIMA_MV:0,PULSO_HALL_CIMA_PICO_MV:0,SCALE_LOW:-5.00,SCALE_HIGH:30.00
TEST_ID:IDENT_PULSO_SUBIDA_AGR,TEST_PARAM:SIG=PUL;TB=800;BUSCA=5;TPAT=300;RMIN=5.00;MARG=40;TD=1200;TP=150;TE=1000;REP=10,T_US:1745779963,PWM:90,RAW:77.000,ACTUAL:11.586,REF:0.000,ERRO:11.586,HALL_MV:3129,HALL_FILT_MV:3129,HALL_CIMA_MV:1467,HALL_CIMA_FILT_MV:1471,TOF_VALID:1,NEW_TOF:0,RANGE_STATUS:0,SIGNAL_MCPS:22.9688,AMBIENT_MCPS:0.0391,SPAD:14.0156,VEL_MM_S:0.0299,MEAS_RATE_HZ:12.6916,MEAS_AGE_US:4261,DT_HALL_US:491,DT_TOF_US:78792,DT_EST_US:486,DT_CTRL_US:488,IDENT_ACTIVE:1,IDENT_STATE:BUSCANDO_LIMIAR,IDENT_TYPE:PULSO,IDENT_REP:0,IDENT_REP_MAX:10,IDENT_FASE:1,LIM_PWM:-1,LIM_HALL_MV:0,LIM_ACTUAL_MM:NULL,LIM_RAW_MM:NULL,DELTA_LIM_MM:NULL,TEST_PWM:-1,TOF_BASE_MM:14.602,PULSO_HALL_PICO_MV:0,PULSO_ACTUAL_PICO_MM:NULL,DELTA_PULSO_MM:NULL,IDENT_MOTIVO:EM_ANDAMENTO,SYNC_PULSE:0,LIM_HALL_CIMA_MV:0,PULSO_HALL_CIMA_PICO_MV:0,SCALE_LOW:-5.00,SCALE_HIGH:30.00
TEST_ID:IDENT_PULSO_SUBIDA_AGR,TEST_PARAM:SIG=PUL;TB=800;BUSCA=5;TPAT=300;RMIN=5.00;MARG=40;TD=1200;TP=150;TE=1000;REP=10,T_US:1745922484,PWM:90,RAW:78.000,ACTUAL:11.548,REF:0.000,ERRO:11.548,HALL_MV:3129,HALL_FILT_MV:3129,HALL_CIMA_MV:1543,HALL_CIMA_FILT_MV:1494,TOF_VALID:1,NEW_TOF:1,RANGE_STATUS:0,SIGNAL_MCPS:22.9375,AMBIENT_MCPS:0.0312,SPAD:14.0156,VEL_MM_S:0.0280,MEAS_RATE_HZ:107.8981,MEAS_AGE_US:0,DT_HALL_US:1992,DT_TOF_US:9268,DT_EST_US:1995,DT_CTRL_US:4035,IDENT_ACTIVE:1,IDENT_STATE:BUSCANDO_LIMIAR,IDENT_TYPE:PULSO,IDENT_REP:0,IDENT_REP_MAX:10,IDENT_FASE:1,LIM_PWM:-1,LIM_HALL_MV:0,LIM_ACTUAL_MM:NULL,LIM_RAW_MM:NULL,DELTA_LIM_MM:NULL,TEST_PWM:-1,TOF_BASE_MM:14.602,PULSO_HALL_PICO_MV:0,PULSO_ACTUAL_PICO_MM:NULL,DELTA_PULSO_MM:NULL,IDENT_MOTIVO:EM_ANDAMENTO,SYNC_PULSE:0,LIM_HALL_CIMA_MV:0,PULSO_HALL_CIMA_PICO_MV:0,SCALE_LOW:-5.00,SCALE_HIGH:30.00
TEST_ID:IDENT_PULSO_SUBIDA_AGR,TEST_PARAM:SIG=PUL;TB=800;BUSCA=5;TPAT=300;RMIN=5.00;MARG=40;TD=1200;TP=150;TE=1000;REP=10,T_US:1745932484,PWM:95,RAW:77.000,ACTUAL:11.665,REF:0.000,ERRO:11.665,HALL_MV:3129,HALL_FILT_MV:3129,HALL_CIMA_MV:1492,HALL_CIMA_FILT_MV:1494,TOF_VALID:1,NEW_TOF:0,RANGE_STATUS:0,SIGNAL_MCPS:22.9297,AMBIENT_MCPS:0.0234,SPAD:14.0156,VEL_MM_S:0.0245,MEAS_RATE_HZ:13.9731,MEAS_AGE_US:4254,DT_HALL_US:494,DT_TOF_US:71566,DT_EST_US:493,DT_CTRL_US:489,IDENT_ACTIVE:1,IDENT_STATE:BUSCANDO_LIMIAR,IDENT_TYPE:PULSO,IDENT_REP:0,IDENT_REP_MAX:10,IDENT_FASE:1,LIM_PWM:-1,LIM_HALL_MV:0,LIM_ACTUAL_MM:NULL,LIM_RAW_MM:NULL,DELTA_LIM_MM:NULL,TEST_PWM:-1,TOF_BASE_MM:14.602,PULSO_HALL_PICO_MV:0,PULSO_ACTUAL_PICO_MM:NULL,DELTA_PULSO_MM:NULL,IDENT_MOTIVO:EM_ANDAMENTO,SYNC_PULSE:0,LIM_HALL_CIMA_MV:0,PULSO_HALL_CIMA_PICO_MV:0,SCALE_LOW:-5.00,SCALE_HIGH:30.00
TEST_ID:IDENT_PULSO_SUBIDA_AGR,TEST_PARAM:SIG=PUL;TB=800;BUSCA=5;TPAT=300;RMIN=5.00;MARG=40;TD=1200;TP=150;TE=1000;REP=10,T_US:1746077057,PWM:95,RAW:77.000,ACTUAL:11.877,REF:0.000,ERRO:11.877,HALL_MV:3129,HALL_FILT_MV:3129,HALL_CIMA_MV:1401,HALL_CIMA_FILT_MV:1455,TOF_VALID:1,NEW_TOF:0,RANGE_STATUS:0,SIGNAL_MCPS:22.6016,AMBIENT_MCPS:0.0234,SPAD:14.0156,VEL_MM_S:0.0201,MEAS_RATE_HZ:189.5375,MEAS_AGE_US:4002,DT_HALL_US:1450,DT_TOF_US:5276,DT_EST_US:1431,DT_CTRL_US:1333,IDENT_ACTIVE:1,IDENT_STATE:BUSCANDO_LIMIAR,IDENT_TYPE:PULSO,IDENT_REP:0,IDENT_REP_MAX:10,IDENT_FASE:1,LIM_PWM:-1,LIM_HALL_MV:0,LIM_ACTUAL_MM:NULL,LIM_RAW_MM:NULL,DELTA_LIM_MM:NULL,TEST_PWM:-1,TOF_BASE_MM:14.602,PULSO_HALL_PICO_MV:0,PULSO_ACTUAL_PICO_MM:NULL,DELTA_PULSO_MM:NULL,IDENT_MOTIVO:EM_ANDAMENTO,SYNC_PULSE:0,LIM_HALL_CIMA_MV:0,PULSO_HALL_CIMA_PICO_MV:0,SCALE_LOW:-5.00,SCALE_HIGH:30.00
TEST_ID:IDENT_PULSO_SUBIDA_AGR,TEST_PARAM:SIG=PUL;TB=800;BUSCA=5;TPAT=300;RMIN=5.00;MARG=40;TD=1200;TP=150;TE=1000;REP=10,T_US:1746087057,PWM:95,RAW:75.000,ACTUAL:13.139,REF:0.000,ERRO:13.139,HALL_MV:3129,HALL_FILT_MV:3129,HALL_CIMA_MV:1410,HALL_CIMA_FILT_MV:1408,TOF_VALID:1,NEW_TOF:0,RANGE_STATUS:0,SIGNAL_MCPS:22.5625,AMBIENT_MCPS:0.0312,SPAD:14.0156,VEL_MM_S:0.0120,MEAS_RATE_HZ:13.6047,MEAS_AGE_US:4262,DT_HALL_US:488,DT_TOF_US:73504,DT_EST_US:487,DT_CTRL_US:493,IDENT_ACTIVE:1,IDENT_STATE:BUSCANDO_LIMIAR,IDENT_TYPE:PULSO,IDENT_REP:0,IDENT_REP_MAX:10,IDENT_FASE:1,LIM_PWM:-1,LIM_HALL_MV:0,LIM_ACTUAL_MM:NULL,LIM_RAW_MM:NULL,DELTA_LIM_MM:NULL,TEST_PWM:-1,TOF_BASE_MM:14.602,PULSO_HALL_PICO_MV:0,PULSO_ACTUAL_PICO_MM:NULL,DELTA_PULSO_MM:NULL,IDENT_MOTIVO:EM_ANDAMENTO,SYNC_PULSE:0,LIM_HALL_CIMA_MV:0,PULSO_HALL_CIMA_PICO_MV:0,SCALE_LOW:-5.00,SCALE_HIGH:30.00
TEST_ID:IDENT_PULSO_SUBIDA_AGR,TEST_PARAM:SIG=PUL;TB=800;BUSCA=5;TPAT=300;RMIN=5.00;MARG=40;TD=1200;TP=150;TE=1000;REP=10,T_US:1746229574,PWM:95,RAW:75.000,ACTUAL:14.357,REF:0.000,ERRO:14.357,HALL_MV:3129,HALL_FILT_MV:3129,HALL_CIMA_MV:1396,HALL_CIMA_FILT_MV:1410,TOF_VALID:1,NEW_TOF:0,RANGE_STATUS:0,SIGNAL_MCPS:22.5156,AMBIENT_MCPS:0.0312,SPAD:14.0156,VEL_MM_S:0.0047,MEAS_RATE_HZ:189.8614,MEAS_AGE_US:4000,DT_HALL_US:1449,DT_TOF_US:5267,DT_EST_US:1431,DT_CTRL_US:1335,IDENT_ACTIVE:1,IDENT_STATE:BUSCANDO_LIMIAR,IDENT_TYPE:PULSO,IDENT_REP:0,IDENT_REP_MAX:10,IDENT_FASE:1,LIM_PWM:-1,LIM_HALL_MV:0,LIM_ACTUAL_MM:NULL,LIM_RAW_MM:NULL,DELTA_LIM_MM:NULL,TEST_PWM:-1,TOF_BASE_MM:14.602,PULSO_HALL_PICO_MV:0,PULSO_ACTUAL_PICO_MM:NULL,DELTA_PULSO_MM:NULL,IDENT_MOTIVO:EM_ANDAMENTO,SYNC_PULSE:0,LIM_HALL_CIMA_MV:0,PULSO_HALL_CIMA_PICO_MV:0,SCALE_LOW:-5.00,SCALE_HIGH:30.00
TEST_ID:IDENT_PULSO_SUBIDA_AGR,TEST_PARAM:SIG=PUL;TB=800;BUSCA=5;TPAT=300;RMIN=5.00;MARG=40;TD=1200;TP=150;TE=1000;REP=10,T_US:1746239574,PWM:100,RAW:79.000,ACTUAL:13.261,REF:0.000,ERRO:13.261,HALL_MV:3129,HALL_FILT_MV:3129,HALL_CIMA_MV:1573,HALL_CIMA_FILT_MV:1458,TOF_VALID:1,NEW_TOF:0,RANGE_STATUS:0,SIGNAL_MCPS:22.5469,AMBIENT_MCPS:0.0234,SPAD:14.0156,VEL_MM_S:0.0149,MEAS_RATE_HZ:13.6049,MEAS_AGE_US:4265,DT_HALL_US:490,DT_TOF_US:73503,DT_EST_US:489,DT_CTRL_US:488,IDENT_ACTIVE:1,IDENT_STATE:BUSCANDO_LIMIAR,IDENT_TYPE:PULSO,IDENT_REP:0,IDENT_REP_MAX:10,IDENT_FASE:1,LIM_PWM:-1,LIM_HALL_MV:0,LIM_ACTUAL_MM:NULL,LIM_RAW_MM:NULL,DELTA_LIM_MM:NULL,TEST_PWM:-1,TOF_BASE_MM:14.602,PULSO_HALL_PICO_MV:0,PULSO_ACTUAL_PICO_MM:NULL,DELTA_PULSO_MM:NULL,IDENT_MOTIVO:EM_ANDAMENTO,SYNC_PULSE:0,LIM_HALL_CIMA_MV:0,PULSO_HALL_CIMA_PICO_MV:0,SCALE_LOW:-5.00,SCALE_HIGH:30.00
TEST_ID:IDENT_PULSO_SUBIDA_AGR,TEST_PARAM:SIG=PUL;TB=800;BUSCA=5;TPAT=300;RMIN=5.00;MARG=40;TD=1200;TP=150;TE=1000;REP=10,T_US:1746382188,PWM:100,RAW:74.000,ACTUAL:14.491,REF:0.000,ERRO:14.491,HALL_MV:3129,HALL_FILT_MV:3129,HALL_CIMA_MV:1371,HALL_CIMA_FILT_MV:1409,TOF_VALID:1,NEW_TOF:0,RANGE_STATUS:0,SIGNAL_MCPS:22.4922,AMBIENT_MCPS:0.0312,SPAD:14.0156,VEL_MM_S:-0.0029,MEAS_RATE_HZ:189.1432,MEAS_AGE_US:3999,DT_HALL_US:1440,DT_TOF_US:5287,DT_EST_US:1426,DT_CTRL_US:1323,IDENT_ACTIVE:1,IDENT_STATE:BUSCANDO_LIMIAR,IDENT_TYPE:PULSO,IDENT_REP:0,IDENT_REP_MAX:10,IDENT_FASE:1,LIM_PWM:-1,LIM_HALL_MV:0,LIM_ACTUAL_MM:NULL,LIM_RAW_MM:NULL,DELTA_LIM_MM:NULL,TEST_PWM:-1,TOF_BASE_MM:14.602,PULSO_HALL_PICO_MV:0,PULSO_ACTUAL_PICO_MM:NULL,DELTA_PULSO_MM:NULL,IDENT_MOTIVO:EM_ANDAMENTO,SYNC_PULSE:0,LIM_HALL_CIMA_MV:0,PULSO_HALL_CIMA_PICO_MV:0,SCALE_LOW:-5.00,SCALE_HIGH:30.00
TEST_ID:IDENT_PULSO_SUBIDA_AGR,TEST_PARAM:SIG=PUL;TB=800;BUSCA=5;TPAT=300;RMIN=5.00;MARG=40;TD=1200;TP=150;TE=1000;REP=10,T_US:1746392188,PWM:100,RAW:77.000,ACTUAL:14.254,REF:0.000,ERRO:14.254,HALL_MV:3129,HALL_FILT_MV:3129,HALL_CIMA_MV:1407,HALL_CIMA_FILT_MV:1417,TOF_VALID:1,NEW_TOF:0,RANGE_STATUS:0,SIGNAL_MCPS:22.6172,AMBIENT_MCPS:0.0312,SPAD:14.0156,VEL_MM_S:0.0013,MEAS_RATE_HZ:13.6058,MEAS_AGE_US:4270,DT_HALL_US:488,DT_TOF_US:73498,DT_EST_US:487,DT_CTRL_US:493,IDENT_ACTIVE:1,IDENT_STATE:BUSCANDO_LIMIAR,IDENT_TYPE:PULSO,IDENT_REP:0,IDENT_REP_MAX:10,IDENT_FASE:1,LIM_PWM:-1,LIM_HALL_MV:0,LIM_ACTUAL_MM:NULL,LIM_RAW_MM:NULL,DELTA_LIM_MM:NULL,TEST_PWM:-1,TOF_BASE_MM:14.602,PULSO_HALL_PICO_MV:0,PULSO_ACTUAL_PICO_MM:NULL,DELTA_PULSO_MM:NULL,IDENT_MOTIVO:EM_ANDAMENTO,SYNC_PULSE:0,LIM_HALL_CIMA_MV:0,PULSO_HALL_CIMA_PICO_MV:0,SCALE_LOW:-5.00,SCALE_HIGH:30.00
TEST_ID:IDENT_PULSO_SUBIDA_AGR,TEST_PARAM:SIG=PUL;TB=800;BUSCA=5;TPAT=300;RMIN=5.00;MARG=40;TD=1200;TP=150;TE=1000;REP=10,T_US:1746535347,PWM:100,RAW:76.000,ACTUAL:14.301,REF:0.000,ERRO:14.301,HALL_MV:3129,HALL_FILT_MV:3129,HALL_CIMA_MV:1423,HALL_CIMA_FILT_MV:1431,TOF_VALID:1,NEW_TOF:0,RANGE_STATUS:0,SIGNAL_MCPS:22.6875,AMBIENT_MCPS:0.0234,SPAD:14.0156,VEL_MM_S:0.0003,MEAS_RATE_HZ:13.5534,MEAS_AGE_US:9874,DT_HALL_US:2000,DT_TOF_US:73782,DT_EST_US:2002,DT_CTRL_US:1999,IDENT_ACTIVE:1,IDENT_STATE:BUSCANDO_LIMIAR,IDENT_TYPE:PULSO,IDENT_REP:0,IDENT_REP_MAX:10,IDENT_FASE:1,LIM_PWM:-1,LIM_HALL_MV:0,LIM_ACTUAL_MM:NULL,LIM_RAW_MM:NULL,DELTA_LIM_MM:NULL,TEST_PWM:-1,TOF_BASE_MM:14.602,PULSO_HALL_PICO_MV:0,PULSO_ACTUAL_PICO_MM:NULL,DELTA_PULSO_MM:NULL,IDENT_MOTIVO:EM_ANDAMENTO,SYNC_PULSE:0,LIM_HALL_CIMA_MV:0,PULSO_HALL_CIMA_PICO_MV:0,SCALE_LOW:-5.00,SCALE_HIGH:30.00
TEST_ID:IDENT_PULSO_SUBIDA_AGR,TEST_PARAM:SIG=PUL;TB=800;BUSCA=5;TPAT=300;RMIN=5.00;MARG=40;TD=1200;TP=150;TE=1000;REP=10,T_US:1746545347,PWM:105,RAW:75.000,ACTUAL:14.598,REF:0.000,ERRO:14.598,HALL_MV:3129,HALL_FILT_MV:3129,HALL_CIMA_MV:1450,HALL_CIMA_FILT_MV:1452,TOF_VALID:1,NEW_TOF:0,RANGE_STATUS:0,SIGNAL_MCPS:22.6016,AMBIENT_MCPS:0.0234,SPAD:14.0156,VEL_MM_S:-0.0055,MEAS_RATE_HZ:12.5991,MEAS_AGE_US:4278,DT_HALL_US:491,DT_TOF_US:79371,DT_EST_US:488,DT_CTRL_US:492,IDENT_ACTIVE:1,IDENT_STATE:BUSCANDO_LIMIAR,IDENT_TYPE:PULSO,IDENT_REP:0,IDENT_REP_MAX:10,IDENT_FASE:1,LIM_PWM:-1,LIM_HALL_MV:0,LIM_ACTUAL_MM:NULL,LIM_RAW_MM:NULL,DELTA_LIM_MM:NULL,TEST_PWM:-1,TOF_BASE_MM:14.602,PULSO_HALL_PICO_MV:0,PULSO_ACTUAL_PICO_MM:NULL,DELTA_PULSO_MM:NULL,IDENT_MOTIVO:EM_ANDAMENTO,SYNC_PULSE:0,LIM_HALL_CIMA_MV:0,PULSO_HALL_CIMA_PICO_MV:0,SCALE_LOW:-5.00,SCALE_HIGH:30.00
TEST_ID:IDENT_PULSO_SUBIDA_AGR,TEST_PARAM:SIG=PUL;TB=800;BUSCA=5;TPAT=300;RMIN=5.00;MARG=40;TD=1200;TP=150;TE=1000;REP=10,T_US:1746687896,PWM:105,RAW:78.000,ACTUAL:14.095,REF:0.000,ERRO:14.095,HALL_MV:3129,HALL_FILT_MV:3129,HALL_CIMA_MV:1436,HALL_CIMA_FILT_MV:1410,TOF_VALID:1,NEW_TOF:0,RANGE_STATUS:0,SIGNAL_MCPS:22.8203,AMBIENT_MCPS:0.0234,SPAD:14.0156,VEL_MM_S:0.0048,MEAS_RATE_HZ:13.5534,MEAS_AGE_US:9270,DT_HALL_US:2000,DT_TOF_US:73782,DT_EST_US:2002,DT_CTRL_US:2000,IDENT_ACTIVE:1,IDENT_STATE:BUSCANDO_LIMIAR,IDENT_TYPE:PULSO,IDENT_REP:0,IDENT_REP_MAX:10,IDENT_FASE:1,LIM_PWM:-1,LIM_HALL_MV:0,LIM_ACTUAL_MM:NULL,LIM_RAW_MM:NULL,DELTA_LIM_MM:NULL,TEST_PWM:-1,TOF_BASE_MM:14.602,PULSO_HALL_PICO_MV:0,PULSO_ACTUAL_PICO_MM:NULL,DELTA_PULSO_MM:NULL,IDENT_MOTIVO:EM_ANDAMENTO,SYNC_PULSE:0,LIM_HALL_CIMA_MV:0,PULSO_HALL_CIMA_PICO_MV:0,SCALE_LOW:-5.00,SCALE_HIGH:30.00
TEST_ID:IDENT_PULSO_SUBIDA_AGR,TEST_PARAM:SIG=PUL;TB=800;BUSCA=5;TPAT=300;RMIN=5.00;MARG=40;TD=1200;TP=150;TE=1000;REP=10,T_US:1746697896,PWM:105,RAW:76.000,ACTUAL:14.161,REF:0.000,ERRO:14.161,HALL_MV:3129,HALL_FILT_MV:3129,HALL_CIMA_MV:1524,HALL_CIMA_FILT_MV:1414,TOF_VALID:1,NEW_TOF:0,RANGE_STATUS:0,SIGNAL_MCPS:22.8281,AMBIENT_MCPS:0.0234,SPAD:14.0156,VEL_MM_S:0.0031,MEAS_RATE_HZ:12.6949,MEAS_AGE_US:4266,DT_HALL_US:493,DT_TOF_US:78772,DT_EST_US:486,DT_CTRL_US:491,IDENT_ACTIVE:1,IDENT_STATE:BUSCANDO_LIMIAR,IDENT_TYPE:PULSO,IDENT_REP:0,IDENT_REP_MAX:10,IDENT_FASE:1,LIM_PWM:-1,LIM_HALL_MV:0,LIM_ACTUAL_MM:NULL,LIM_RAW_MM:NULL,DELTA_LIM_MM:NULL,TEST_PWM:-1,TOF_BASE_MM:14.602,PULSO_HALL_PICO_MV:0,PULSO_ACTUAL_PICO_MM:NULL,DELTA_PULSO_MM:NULL,IDENT_MOTIVO:EM_ANDAMENTO,SYNC_PULSE:0,LIM_HALL_CIMA_MV:0,PULSO_HALL_CIMA_PICO_MV:0,SCALE_LOW:-5.00,SCALE_HIGH:30.00
TEST_ID:IDENT_PULSO_SUBIDA_AGR,TEST_PARAM:SIG=PUL;TB=800;BUSCA=5;TPAT=300;RMIN=5.00;MARG=40;TD=1200;TP=150;TE=1000;REP=10,T_US:1746840442,PWM:105,RAW:76.000,ACTUAL:14.222,REF:0.000,ERRO:14.222,HALL_MV:3129,HALL_FILT_MV:3129,HALL_CIMA_MV:1436,HALL_CIMA_FILT_MV:1423,TOF_VALID:1,NEW_TOF:0,RANGE_STATUS:0,SIGNAL_MCPS:22.8438,AMBIENT_MCPS:0.0234,SPAD:14.0156,VEL_MM_S:0.0017,MEAS_RATE_HZ:13.5566,MEAS_AGE_US:9285,DT_HALL_US:2000,DT_TOF_US:73765,DT_EST_US:2002,DT_CTRL_US:2000,IDENT_ACTIVE:1,IDENT_STATE:BUSCANDO_LIMIAR,IDENT_TYPE:PULSO,IDENT_REP:0,IDENT_REP_MAX:10,IDENT_FASE:1,LIM_PWM:-1,LIM_HALL_MV:0,LIM_ACTUAL_MM:NULL,LIM_RAW_MM:NULL,DELTA_LIM_MM:NULL,TEST_PWM:-1,TOF_BASE_MM:14.602,PULSO_HALL_PICO_MV:0,PULSO_ACTUAL_PICO_MM:NULL,DELTA_PULSO_MM:NULL,IDENT_MOTIVO:EM_ANDAMENTO,SYNC_PULSE:0,LIM_HALL_CIMA_MV:0,PULSO_HALL_CIMA_PICO_MV:0,SCALE_LOW:-5.00,SCALE_HIGH:30.00
TEST_ID:IDENT_PULSO_SUBIDA_AGR,TEST_PARAM:SIG=PUL;TB=800;BUSCA=5;TPAT=300;RMIN=5.00;MARG=40;TD=1200;TP=150;TE=1000;REP=10,T_US:1746850442,PWM:110,RAW:78.000,ACTUAL:13.681,REF:0.000,ERRO:13.681,HALL_MV:3129,HALL_FILT_MV:3129,HALL_CIMA_MV:1469,HALL_CIMA_FILT_MV:1428,TOF_VALID:1,NEW_TOF:0,RANGE_STATUS:0,SIGNAL_MCPS:22.8672,AMBIENT_MCPS:0.0234,SPAD:14.0156,VEL_MM_S:0.0111,MEAS_RATE_HZ:12.6934,MEAS_AGE_US:4269,DT_HALL_US:489,DT_TOF_US:78781,DT_EST_US:490,DT_CTRL_US:492,IDENT_ACTIVE:1,IDENT_STATE:BUSCANDO_LIMIAR,IDENT_TYPE:PULSO,IDENT_REP:0,IDENT_REP_MAX:10,IDENT_FASE:1,LIM_PWM:-1,LIM_HALL_MV:0,LIM_ACTUAL_MM:NULL,LIM_RAW_MM:NULL,DELTA_LIM_MM:NULL,TEST_PWM:-1,TOF_BASE_MM:14.602,PULSO_HALL_PICO_MV:0,PULSO_ACTUAL_PICO_MM:NULL,DELTA_PULSO_MM:NULL,IDENT_MOTIVO:EM_ANDAMENTO,SYNC_PULSE:0,LIM_HALL_CIMA_MV:0,PULSO_HALL_CIMA_PICO_MV:0,SCALE_LOW:-5.00,SCALE_HIGH:30.00
TEST_ID:IDENT_PULSO_SUBIDA_AGR,TEST_PARAM:SIG=PUL;TB=800;BUSCA=5;TPAT=300;RMIN=5.00;MARG=40;TD=1200;TP=150;TE=1000;REP=10,T_US:1746992982,PWM:110,RAW:75.000,ACTUAL:14.089,REF:0.000,ERRO:14.089,HALL_MV:3129,HALL_FILT_MV:3129,HALL_CIMA_MV:1446,HALL_CIMA_FILT_MV:1389,TOF_VALID:1,NEW_TOF:0,RANGE_STATUS:0,SIGNAL_MCPS:22.5547,AMBIENT_MCPS:0.0312,SPAD:14.0156,VEL_MM_S:0.0033,MEAS_RATE_HZ:13.5573,MEAS_AGE_US:9281,DT_HALL_US:2004,DT_TOF_US:73761,DT_EST_US:2006,DT_CTRL_US:2004,IDENT_ACTIVE:1,IDENT_STATE:BUSCANDO_LIMIAR,IDENT_TYPE:PULSO,IDENT_REP:0,IDENT_REP_MAX:10,IDENT_FASE:1,LIM_PWM:-1,LIM_HALL_MV:0,LIM_ACTUAL_MM:NULL,LIM_RAW_MM:NULL,DELTA_LIM_MM:NULL,TEST_PWM:-1,TOF_BASE_MM:14.602,PULSO_HALL_PICO_MV:0,PULSO_ACTUAL_PICO_MM:NULL,DELTA_PULSO_MM:NULL,IDENT_MOTIVO:EM_ANDAMENTO,SYNC_PULSE:0,LIM_HALL_CIMA_MV:0,PULSO_HALL_CIMA_PICO_MV:0,SCALE_LOW:-5.00,SCALE_HIGH:30.00
TEST_ID:IDENT_PULSO_SUBIDA_AGR,TEST_PARAM:SIG=PUL;TB=800;BUSCA=5;TPAT=300;RMIN=5.00;MARG=40;TD=1200;TP=150;TE=1000;REP=10,T_US:1747002982,PWM:110,RAW:77.000,ACTUAL:13.877,REF:0.000,ERRO:13.877,HALL_MV:3129,HALL_FILT_MV:3129,HALL_CIMA_MV:1405,HALL_CIMA_FILT_MV:1401,TOF_VALID:1,NEW_TOF:0,RANGE_STATUS:0,SIGNAL_MCPS:22.4844,AMBIENT_MCPS:0.0234,SPAD:14.0156,VEL_MM_S:0.0065,MEAS_RATE_HZ:12.6926,MEAS_AGE_US:4269,DT_HALL_US:488,DT_TOF_US:78786,DT_EST_US:486,DT_CTRL_US:490,IDENT_ACTIVE:1,IDENT_STATE:BUSCANDO_LIMIAR,IDENT_TYPE:PULSO,IDENT_REP:0,IDENT_REP_MAX:10,IDENT_FASE:1,LIM_PWM:-1,LIM_HALL_MV:0,LIM_ACTUAL_MM:NULL,LIM_RAW_MM:NULL,DELTA_LIM_MM:NULL,TEST_PWM:-1,TOF_BASE_MM:14.602,PULSO_HALL_PICO_MV:0,PULSO_ACTUAL_PICO_MM:NULL,DELTA_PULSO_MM:NULL,IDENT_MOTIVO:EM_ANDAMENTO,SYNC_PULSE:0,LIM_HALL_CIMA_MV:0,PULSO_HALL_CIMA_PICO_MV:0,SCALE_LOW:-5.00,SCALE_HIGH:30.00
TEST_ID:IDENT_PULSO_SUBIDA_AGR,TEST_PARAM:SIG=PUL;TB=800;BUSCA=5;TPAT=300;RMIN=5.00;MARG=40;TD=1200;TP=150;TE=1000;REP=10,T_US:1747145527,PWM:110,RAW:76.000,ACTUAL:13.978,REF:0.000,ERRO:13.978,HALL_MV:3129,HALL_FILT_MV:3129,HALL_CIMA_MV:1425,HALL_CIMA_FILT_MV:1392,TOF_VALID:1,NEW_TOF:0,RANGE_STATUS:0,SIGNAL_MCPS:22.6016,AMBIENT_MCPS:0.0234,SPAD:14.0156,VEL_MM_S:0.0044,MEAS_RATE_HZ:13.5566,MEAS_AGE_US:9277,DT_HALL_US:1999,DT_TOF_US:73765,DT_EST_US:2002,DT_CTRL_US:2000,IDENT_ACTIVE:1,IDENT_STATE:BUSCANDO_LIMIAR,IDENT_TYPE:PULSO,IDENT_REP:0,IDENT_REP_MAX:10,IDENT_FASE:1,LIM_PWM:-1,LIM_HALL_MV:0,LIM_ACTUAL_MM:NULL,LIM_RAW_MM:NULL,DELTA_LIM_MM:NULL,TEST_PWM:-1,TOF_BASE_MM:14.602,PULSO_HALL_PICO_MV:0,PULSO_ACTUAL_PICO_MM:NULL,DELTA_PULSO_MM:NULL,IDENT_MOTIVO:EM_ANDAMENTO,SYNC_PULSE:0,LIM_HALL_CIMA_MV:0,PULSO_HALL_CIMA_PICO_MV:0,SCALE_LOW:-5.00,SCALE_HIGH:30.00
TEST_ID:IDENT_PULSO_SUBIDA_AGR,TEST_PARAM:SIG=PUL;TB=800;BUSCA=5;TPAT=300;RMIN=5.00;MARG=40;TD=1200;TP=150;TE=1000;REP=10,T_US:1747155527,PWM:115,RAW:79.000,ACTUAL:13.238,REF:0.000,ERRO:13.238,HALL_MV:3129,HALL_FILT_MV:3129,HALL_CIMA_MV:1360,HALL_CIMA_FILT_MV:1399,TOF_VALID:1,NEW_TOF:0,RANGE_STATUS:0,SIGNAL_MCPS:22.6719,AMBIENT_MCPS:0.0234,SPAD:14.0156,VEL_MM_S:0.0147,MEAS_RATE_HZ:12.6947,MEAS_AGE_US:4280,DT_HALL_US:496,DT_TOF_US:78773,DT_EST_US:494,DT_CTRL_US:488,IDENT_ACTIVE:1,IDENT_STATE:BUSCANDO_LIMIAR,IDENT_TYPE:PULSO,IDENT_REP:0,IDENT_REP_MAX:10,IDENT_FASE:1,LIM_PWM:-1,LIM_HALL_MV:0,LIM_ACTUAL_MM:NULL,LIM_RAW_MM:NULL,DELTA_LIM_MM:NULL,TEST_PWM:-1,TOF_BASE_MM:14.602,PULSO_HALL_PICO_MV:0,PULSO_ACTUAL_PICO_MM:NULL,DELTA_PULSO_MM:NULL,IDENT_MOTIVO:EM_ANDAMENTO,SYNC_PULSE:0,LIM_HALL_CIMA_MV:0,PULSO_HALL_CIMA_PICO_MV:0,SCALE_LOW:-5.00,SCALE_HIGH:30.00
TEST_ID:IDENT_PULSO_SUBIDA_AGR,TEST_PARAM:SIG=PUL;TB=800;BUSCA=5;TPAT=300;RMIN=5.00;MARG=40;TD=1200;TP=150;TE=1000;REP=10,T_US:1747298063,PWM:115,RAW:79.000,ACTUAL:12.618,REF:0.000,ERRO:12.618,HALL_MV:3129,HALL_FILT_MV:3129,HALL_CIMA_MV:1392,HALL_CIMA_FILT_MV:1388,TOF_VALID:1,NEW_TOF:0,RANGE_STATUS:0,SIGNAL_MCPS:22.7500,AMBIENT_MCPS:0.0234,SPAD:14.0156,VEL_MM_S:0.0218,MEAS_RATE_HZ:13.5573,MEAS_AGE_US:9278,DT_HALL_US:2004,DT_TOF_US:73761,DT_EST_US:2006,DT_CTRL_US:2004,IDENT_ACTIVE:1,IDENT_STATE:BUSCANDO_LIMIAR,IDENT_TYPE:PULSO,IDENT_REP:0,IDENT_REP_MAX:10,IDENT_FASE:1,LIM_PWM:-1,LIM_HALL_MV:0,LIM_ACTUAL_MM:NULL,LIM_RAW_MM:NULL,DELTA_LIM_MM:NULL,TEST_PWM:-1,TOF_BASE_MM:14.602,PULSO_HALL_PICO_MV:0,PULSO_ACTUAL_PICO_MM:NULL,DELTA_PULSO_MM:NULL,IDENT_MOTIVO:EM_ANDAMENTO,SYNC_PULSE:0,LIM_HALL_CIMA_MV:0,PULSO_HALL_CIMA_PICO_MV:0,SCALE_LOW:-5.00,SCALE_HIGH:30.00
TEST_ID:IDENT_PULSO_SUBIDA_AGR,TEST_PARAM:SIG=PUL;TB=800;BUSCA=5;TPAT=300;RMIN=5.00;MARG=40;TD=1200;TP=150;TE=1000;REP=10,T_US:1747308063,PWM:115,RAW:76.000,ACTUAL:12.867,REF:0.000,ERRO:12.867,HALL_MV:3129,HALL_FILT_MV:3129,HALL_CIMA_MV:1359,HALL_CIMA_FILT_MV:1384,TOF_VALID:1,NEW_TOF:0,RANGE_STATUS:0,SIGNAL_MCPS:22.4844,AMBIENT_MCPS:0.0312,SPAD:14.0156,VEL_MM_S:0.0170,MEAS_RATE_HZ:12.6937,MEAS_AGE_US:4260,DT_HALL_US:488,DT_TOF_US:78779,DT_EST_US:487,DT_CTRL_US:492,IDENT_ACTIVE:1,IDENT_STATE:BUSCANDO_LIMIAR,IDENT_TYPE:PULSO,IDENT_REP:0,IDENT_REP_MAX:10,IDENT_FASE:1,LIM_PWM:-1,LIM_HALL_MV:0,LIM_ACTUAL_MM:NULL,LIM_RAW_MM:NULL,DELTA_LIM_MM:NULL,TEST_PWM:-1,TOF_BASE_MM:14.602,PULSO_HALL_PICO_MV:0,PULSO_ACTUAL_PICO_MM:NULL,DELTA_PULSO_MM:NULL,IDENT_MOTIVO:EM_ANDAMENTO,SYNC_PULSE:0,LIM_HALL_CIMA_MV:0,PULSO_HALL_CIMA_PICO_MV:0,SCALE_LOW:-5.00,SCALE_HIGH:30.00
TEST_ID:IDENT_PULSO_SUBIDA_AGR,TEST_PARAM:SIG=PUL;TB=800;BUSCA=5;TPAT=300;RMIN=5.00;MARG=40;TD=1200;TP=150;TE=1000;REP=10,T_US:1747450603,PWM:115,RAW:76.000,ACTUAL:13.083,REF:0.000,ERRO:13.083,HALL_MV:3129,HALL_FILT_MV:3129,HALL_CIMA_MV:1355,HALL_CIMA_FILT_MV:1383,TOF_VALID:1,NEW_TOF:0,RANGE_STATUS:0,SIGNAL_MCPS:22.3828,AMBIENT_MCPS:0.0234,SPAD:14.0156,VEL_MM_S:0.0131,MEAS_RATE_HZ:13.5569,MEAS_AGE_US:9274,DT_HALL_US:2004,DT_TOF_US:73763,DT_EST_US:2005,DT_CTRL_US:2003,IDENT_ACTIVE:1,IDENT_STATE:BUSCANDO_LIMIAR,IDENT_TYPE:PULSO,IDENT_REP:0,IDENT_REP_MAX:10,IDENT_FASE:1,LIM_PWM:-1,LIM_HALL_MV:0,LIM_ACTUAL_MM:NULL,LIM_RAW_MM:NULL,DELTA_LIM_MM:NULL,TEST_PWM:-1,TOF_BASE_MM:14.602,PULSO_HALL_PICO_MV:0,PULSO_ACTUAL_PICO_MM:NULL,DELTA_PULSO_MM:NULL,IDENT_MOTIVO:EM_ANDAMENTO,SYNC_PULSE:0,LIM_HALL_CIMA_MV:0,PULSO_HALL_CIMA_PICO_MV:0,SCALE_LOW:-5.00,SCALE_HIGH:30.00
TEST_ID:IDENT_PULSO_SUBIDA_AGR,TEST_PARAM:SIG=PUL;TB=800;BUSCA=5;TPAT=300;RMIN=5.00;MARG=40;TD=1200;TP=150;TE=1000;REP=10,T_US:1747460603,PWM:120,RAW:81.000,ACTUAL:12.045,REF:0.000,ERRO:12.045,HALL_MV:3129,HALL_FILT_MV:3129,HALL_CIMA_MV:1411,HALL_CIMA_FILT_MV:1390,TOF_VALID:1,NEW_TOF:0,RANGE_STATUS:0,SIGNAL_MCPS:22.5469,AMBIENT_MCPS:0.0234,SPAD:14.0156,VEL_MM_S:0.0235,MEAS_RATE_HZ:12.6945,MEAS_AGE_US:4267,DT_HALL_US:489,DT_TOF_US:78774,DT_EST_US:487,DT_CTRL_US:488,IDENT_ACTIVE:1,IDENT_STATE:BUSCANDO_LIMIAR,IDENT_TYPE:PULSO,IDENT_REP:0,IDENT_REP_MAX:10,IDENT_FASE:1,LIM_PWM:-1,LIM_HALL_MV:0,LIM_ACTUAL_MM:NULL,LIM_RAW_MM:NULL,DELTA_LIM_MM:NULL,TEST_PWM:-1,TOF_BASE_MM:14.602,PULSO_HALL_PICO_MV:0,PULSO_ACTUAL_PICO_MM:NULL,DELTA_PULSO_MM:NULL,IDENT_MOTIVO:EM_ANDAMENTO,SYNC_PULSE:0,LIM_HALL_CIMA_MV:0,PULSO_HALL_CIMA_PICO_MV:0,SCALE_LOW:-5.00,SCALE_HIGH:30.00
TEST_ID:IDENT_PULSO_SUBIDA_AGR,TEST_PARAM:SIG=PUL;TB=800;BUSCA=5;TPAT=300;RMIN=5.00;MARG=40;TD=1200;TP=150;TE=1000;REP=10,T_US:1747603144,PWM:120,RAW:75.000,ACTUAL:12.561,REF:0.000,ERRO:12.561,HALL_MV:3129,HALL_FILT_MV:3129,HALL_CIMA_MV:1366,HALL_CIMA_FILT_MV:1386,TOF_VALID:1,NEW_TOF:0,RANGE_STATUS:0,SIGNAL_MCPS:22.6875,AMBIENT_MCPS:0.0234,SPAD:14.0156,VEL_MM_S:0.0163,MEAS_RATE_HZ:13.5579,MEAS_AGE_US:9289,DT_HALL_US:2000,DT_TOF_US:73758,DT_EST_US:2006,DT_CTRL_US:1999,IDENT_ACTIVE:1,IDENT_STATE:BUSCANDO_LIMIAR,IDENT_TYPE:PULSO,IDENT_REP:0,IDENT_REP_MAX:10,IDENT_FASE:1,LIM_PWM:-1,LIM_HALL_MV:0,LIM_ACTUAL_MM:NULL,LIM_RAW_MM:NULL,DELTA_LIM_MM:NULL,TEST_PWM:-1,TOF_BASE_MM:14.602,PULSO_HALL_PICO_MV:0,PULSO_ACTUAL_PICO_MM:NULL,DELTA_PULSO_MM:NULL,IDENT_MOTIVO:EM_ANDAMENTO,SYNC_PULSE:0,LIM_HALL_CIMA_MV:0,PULSO_HALL_CIMA_PICO_MV:0,SCALE_LOW:-5.00,SCALE_HIGH:30.00
TEST_ID:IDENT_PULSO_SUBIDA_AGR,TEST_PARAM:SIG=PUL;TB=800;BUSCA=5;TPAT=300;RMIN=5.00;MARG=40;TD=1200;TP=150;TE=1000;REP=10,T_US:1747613144,PWM:120,RAW:75.000,ACTUAL:13.052,REF:0.000,ERRO:13.052,HALL_MV:3129,HALL_FILT_MV:3129,HALL_CIMA_MV:1401,HALL_CIMA_FILT_MV:1364,TOF_VALID:1,NEW_TOF:0,RANGE_STATUS:0,SIGNAL_MCPS:22.7031,AMBIENT_MCPS:0.0312,SPAD:14.0156,VEL_MM_S:0.0105,MEAS_RATE_HZ:12.6926,MEAS_AGE_US:4257,DT_HALL_US:489,DT_TOF_US:78786,DT_EST_US:486,DT_CTRL_US:492,IDENT_ACTIVE:1,IDENT_STATE:BUSCANDO_LIMIAR,IDENT_TYPE:PULSO,IDENT_REP:0,IDENT_REP_MAX:10,IDENT_FASE:1,LIM_PWM:-1,LIM_HALL_MV:0,LIM_ACTUAL_MM:NULL,LIM_RAW_MM:NULL,DELTA_LIM_MM:NULL,TEST_PWM:-1,TOF_BASE_MM:14.602,PULSO_HALL_PICO_MV:0,PULSO_ACTUAL_PICO_MM:NULL,DELTA_PULSO_MM:NULL,IDENT_MOTIVO:EM_ANDAMENTO,SYNC_PULSE:0,LIM_HALL_CIMA_MV:0,PULSO_HALL_CIMA_PICO_MV:0,SCALE_LOW:-5.00,SCALE_HIGH:30.00
TEST_ID:IDENT_PULSO_SUBIDA_AGR,TEST_PARAM:SIG=PUL;TB=800;BUSCA=5;TPAT=300;RMIN=5.00;MARG=40;TD=1200;TP=150;TE=1000;REP=10,T_US:1747755686,PWM:120,RAW:79.000,ACTUAL:12.514,REF:0.000,ERRO:12.514,HALL_MV:3129,HALL_FILT_MV:3129,HALL_CIMA_MV:1323,HALL_CIMA_FILT_MV:1346,TOF_VALID:1,NEW_TOF:0,RANGE_STATUS:0,SIGNAL_MCPS:22.6563,AMBIENT_MCPS:0.0234,SPAD:14.0156,VEL_MM_S:0.0144,MEAS_RATE_HZ:13.5566,MEAS_AGE_US:9276,DT_HALL_US:2004,DT_TOF_US:73765,DT_EST_US:2006,DT_CTRL_US:2005,IDENT_ACTIVE:1,IDENT_STATE:BUSCANDO_LIMIAR,IDENT_TYPE:PULSO,IDENT_REP:0,IDENT_REP_MAX:10,IDENT_FASE:1,LIM_PWM:-1,LIM_HALL_MV:0,LIM_ACTUAL_MM:NULL,LIM_RAW_MM:NULL,DELTA_LIM_MM:NULL,TEST_PWM:-1,TOF_BASE_MM:14.602,PULSO_HALL_PICO_MV:0,PULSO_ACTUAL_PICO_MM:NULL,DELTA_PULSO_MM:NULL,IDENT_MOTIVO:EM_ANDAMENTO,SYNC_PULSE:0,LIM_HALL_CIMA_MV:0,PULSO_HALL_CIMA_PICO_MV:0,SCALE_LOW:-5.00,SCALE_HIGH:30.00
TEST_ID:IDENT_PULSO_SUBIDA_AGR,TEST_PARAM:SIG=PUL;TB=800;BUSCA=5;TPAT=300;RMIN=5.00;MARG=40;TD=1200;TP=150;TE=1000;REP=10,T_US:1747765686,PWM:125,RAW:79.000,ACTUAL:12.529,REF:0.000,ERRO:12.529,HALL_MV:3129,HALL_FILT_MV:3129,HALL_CIMA_MV:1348,HALL_CIMA_FILT_MV:1342,TOF_VALID:1,NEW_TOF:1,RANGE_STATUS:0,SIGNAL_MCPS:22.5391,AMBIENT_MCPS:0.0312,SPAD:14.0156,VEL_MM_S:0.0132,MEAS_RATE_HZ:200.0000,MEAS_AGE_US:0,DT_HALL_US:492,DT_TOF_US:5000,DT_EST_US:491,DT_CTRL_US:2521,IDENT_ACTIVE:1,IDENT_STATE:BUSCANDO_LIMIAR,IDENT_TYPE:PULSO,IDENT_REP:0,IDENT_REP_MAX:10,IDENT_FASE:1,LIM_PWM:-1,LIM_HALL_MV:0,LIM_ACTUAL_MM:NULL,LIM_RAW_MM:NULL,DELTA_LIM_MM:NULL,TEST_PWM:-1,TOF_BASE_MM:14.602,PULSO_HALL_PICO_MV:0,PULSO_ACTUAL_PICO_MM:NULL,DELTA_PULSO_MM:NULL,IDENT_MOTIVO:EM_ANDAMENTO,SYNC_PULSE:0,LIM_HALL_CIMA_MV:0,PULSO_HALL_CIMA_PICO_MV:0,SCALE_LOW:-5.00,SCALE_HIGH:30.00
TEST_ID:IDENT_PULSO_SUBIDA_AGR,TEST_PARAM:SIG=PUL;TB=800;BUSCA=5;TPAT=300;RMIN=5.00;MARG=40;TD=1200;TP=150;TE=1000;REP=10,T_US:1747910293,PWM:125,RAW:77.000,ACTUAL:12.528,REF:0.000,ERRO:12.528,HALL_MV:3129,HALL_FILT_MV:3129,HALL_CIMA_MV:1436,HALL_CIMA_FILT_MV:1373,TOF_VALID:1,NEW_TOF:0,RANGE_STATUS:0,SIGNAL_MCPS:22.7188,AMBIENT_MCPS:0.0312,SPAD:14.0156,VEL_MM_S:0.0122,MEAS_RATE_HZ:13.9745,MEAS_AGE_US:9270,DT_HALL_US:2000,DT_TOF_US:71559,DT_EST_US:2002,DT_CTRL_US:2000,IDENT_ACTIVE:1,IDENT_STATE:BUSCANDO_LIMIAR,IDENT_TYPE:PULSO,IDENT_REP:0,IDENT_REP_MAX:10,IDENT_FASE:1,LIM_PWM:-1,LIM_HALL_MV:0,LIM_ACTUAL_MM:NULL,LIM_RAW_MM:NULL,DELTA_LIM_MM:NULL,TEST_PWM:-1,TOF_BASE_MM:14.602,PULSO_HALL_PICO_MV:0,PULSO_ACTUAL_PICO_MM:NULL,DELTA_PULSO_MM:NULL,IDENT_MOTIVO:EM_ANDAMENTO,SYNC_PULSE:0,LIM_HALL_CIMA_MV:0,PULSO_HALL_CIMA_PICO_MV:0,SCALE_LOW:-5.00,SCALE_HIGH:30.00
TEST_ID:IDENT_PULSO_SUBIDA_AGR,TEST_PARAM:SIG=PUL;TB=800;BUSCA=5;TPAT=300;RMIN=5.00;MARG=40;TD=1200;TP=150;TE=1000;REP=10,T_US:1747920293,PWM:125,RAW:75.000,ACTUAL:12.973,REF:0.000,ERRO:12.973,HALL_MV:3129,HALL_FILT_MV:3129,HALL_CIMA_MV:1440,HALL_CIMA_FILT_MV:1398,TOF_VALID:1,NEW_TOF:0,RANGE_STATUS:0,SIGNAL_MCPS:22.5469,AMBIENT_MCPS:0.0312,SPAD:14.0156,VEL_MM_S:0.0078,MEAS_RATE_HZ:12.6957,MEAS_AGE_US:4253,DT_HALL_US:490,DT_TOF_US:78767,DT_EST_US:487,DT_CTRL_US:489,IDENT_ACTIVE:1,IDENT_STATE:BUSCANDO_LIMIAR,IDENT_TYPE:PULSO,IDENT_REP:0,IDENT_REP_MAX:10,IDENT_FASE:1,LIM_PWM:-1,LIM_HALL_MV:0,LIM_ACTUAL_MM:NULL,LIM_RAW_MM:NULL,DELTA_LIM_MM:NULL,TEST_PWM:-1,TOF_BASE_MM:14.602,PULSO_HALL_PICO_MV:0,PULSO_ACTUAL_PICO_MM:NULL,DELTA_PULSO_MM:NULL,IDENT_MOTIVO:EM_ANDAMENTO,SYNC_PULSE:0,LIM_HALL_CIMA_MV:0,PULSO_HALL_CIMA_PICO_MV:0,SCALE_LOW:-5.00,SCALE_HIGH:30.00
TEST_ID:IDENT_PULSO_SUBIDA_AGR,TEST_PARAM:SIG=PUL;TB=800;BUSCA=5;TPAT=300;RMIN=5.00;MARG=40;TD=1200;TP=150;TE=1000;REP=10,T_US:1748062828,PWM:125,RAW:78.000,ACTUAL:12.693,REF:0.000,ERRO:12.693,HALL_MV:3129,HALL_FILT_MV:3129,HALL_CIMA_MV:1281,HALL_CIMA_FILT_MV:1353,TOF_VALID:1,NEW_TOF:0,RANGE_STATUS:0,SIGNAL_MCPS:22.5391,AMBIENT_MCPS:0.0234,SPAD:14.0156,VEL_MM_S:0.0093,MEAS_RATE_HZ:13.5564,MEAS_AGE_US:9274,DT_HALL_US:2003,DT_TOF_US:73766,DT_EST_US:2005,DT_CTRL_US:2003,IDENT_ACTIVE:1,IDENT_STATE:BUSCANDO_LIMIAR,IDENT_TYPE:PULSO,IDENT_REP:0,IDENT_REP_MAX:10,IDENT_FASE:1,LIM_PWM:-1,LIM_HALL_MV:0,LIM_ACTUAL_MM:NULL,LIM_RAW_MM:NULL,DELTA_LIM_MM:NULL,TEST_PWM:-1,TOF_BASE_MM:14.602,PULSO_HALL_PICO_MV:0,PULSO_ACTUAL_PICO_MM:NULL,DELTA_PULSO_MM:NULL,IDENT_MOTIVO:EM_ANDAMENTO,SYNC_PULSE:0,LIM_HALL_CIMA_MV:0,PULSO_HALL_CIMA_PICO_MV:0,SCALE_LOW:-5.00,SCALE_HIGH:30.00
TEST_ID:IDENT_PULSO_SUBIDA_AGR,TEST_PARAM:SIG=PUL;TB=800;BUSCA=5;TPAT=300;RMIN=5.00;MARG=40;TD=1200;TP=150;TE=1000;REP=10,T_US:1748072828,PWM:130,RAW:75.000,ACTUAL:13.162,REF:0.000,ERRO:13.162,HALL_MV:3129,HALL_FILT_MV:3129,HALL_CIMA_MV:1369,HALL_CIMA_FILT_MV:1350,TOF_VALID:1,NEW_TOF:0,RANGE_STATUS:0,SIGNAL_MCPS:22.7734,AMBIENT_MCPS:0.0312,SPAD:14.0156,VEL_MM_S:0.0052,MEAS_RATE_HZ:12.6934,MEAS_AGE_US:4264,DT_HALL_US:493,DT_TOF_US:78781,DT_EST_US:490,DT_CTRL_US:488,IDENT_ACTIVE:1,IDENT_STATE:BUSCANDO_LIMIAR,IDENT_TYPE:PULSO,IDENT_REP:0,IDENT_REP_MAX:10,IDENT_FASE:1,LIM_PWM:-1,LIM_HALL_MV:0,LIM_ACTUAL_MM:NULL,LIM_RAW_MM:NULL,DELTA_LIM_MM:NULL,TEST_PWM:-1,TOF_BASE_MM:14.602,PULSO_HALL_PICO_MV:0,PULSO_ACTUAL_PICO_MM:NULL,DELTA_PULSO_MM:NULL,IDENT_MOTIVO:EM_ANDAMENTO,SYNC_PULSE:0,LIM_HALL_CIMA_MV:0,PULSO_HALL_CIMA_PICO_MV:0,SCALE_LOW:-5.00,SCALE_HIGH:30.00
TEST_ID:IDENT_PULSO_SUBIDA_AGR,TEST_PARAM:SIG=PUL;TB=800;BUSCA=5;TPAT=300;RMIN=5.00;MARG=40;TD=1200;TP=150;TE=1000;REP=10,T_US:1748215371,PWM:130,RAW:76.000,ACTUAL:13.335,REF:0.000,ERRO:13.335,HALL_MV:3129,HALL_FILT_MV:3129,HALL_CIMA_MV:1275,HALL_CIMA_FILT_MV:1320,TOF_VALID:1,NEW_TOF:0,RANGE_STATUS:0,SIGNAL_MCPS:22.5938,AMBIENT_MCPS:0.0312,SPAD:14.0156,VEL_MM_S:0.0036,MEAS_RATE_HZ:13.5577,MEAS_AGE_US:9278,DT_HALL_US:2000,DT_TOF_US:73759,DT_EST_US:2001,DT_CTRL_US:1999,IDENT_ACTIVE:1,IDENT_STATE:BUSCANDO_LIMIAR,IDENT_TYPE:PULSO,IDENT_REP:0,IDENT_REP_MAX:10,IDENT_FASE:1,LIM_PWM:-1,LIM_HALL_MV:0,LIM_ACTUAL_MM:NULL,LIM_RAW_MM:NULL,DELTA_LIM_MM:NULL,TEST_PWM:-1,TOF_BASE_MM:14.602,PULSO_HALL_PICO_MV:0,PULSO_ACTUAL_PICO_MM:NULL,DELTA_PULSO_MM:NULL,IDENT_MOTIVO:EM_ANDAMENTO,SYNC_PULSE:0,LIM_HALL_CIMA_MV:0,PULSO_HALL_CIMA_PICO_MV:0,SCALE_LOW:-5.00,SCALE_HIGH:30.00
TEST_ID:IDENT_PULSO_SUBIDA_AGR,TEST_PARAM:SIG=PUL;TB=800;BUSCA=5;TPAT=300;RMIN=5.00;MARG=40;TD=1200;TP=150;TE=1000;REP=10,T_US:1748225371,PWM:130,RAW:75.000,ACTUAL:13.854,REF:0.000,ERRO:13.854,HALL_MV:3129,HALL_FILT_MV:3129,HALL_CIMA_MV:1313,HALL_CIMA_FILT_MV:1328,TOF_VALID:1,NEW_TOF:0,RANGE_STATUS:0,SIGNAL_MCPS:22.5938,AMBIENT_MCPS:0.0312,SPAD:14.0156,VEL_MM_S:0.0004,MEAS_RATE_HZ:12.6944,MEAS_AGE_US:4264,DT_HALL_US:491,DT_TOF_US:78775,DT_EST_US:488,DT_CTRL_US:493,IDENT_ACTIVE:1,IDENT_STATE:BUSCANDO_LIMIAR,IDENT_TYPE:PULSO,IDENT_REP:0,IDENT_REP_MAX:10,IDENT_FASE:1,LIM_PWM:-1,LIM_HALL_MV:0,LIM_ACTUAL_MM:NULL,LIM_RAW_MM:NULL,DELTA_LIM_MM:NULL,TEST_PWM:-1,TOF_BASE_MM:14.602,PULSO_HALL_PICO_MV:0,PULSO_ACTUAL_PICO_MM:NULL,DELTA_PULSO_MM:NULL,IDENT_MOTIVO:EM_ANDAMENTO,SYNC_PULSE:0,LIM_HALL_CIMA_MV:0,PULSO_HALL_CIMA_PICO_MV:0,SCALE_LOW:-5.00,SCALE_HIGH:30.00
TEST_ID:IDENT_PULSO_SUBIDA_AGR,TEST_PARAM:SIG=PUL;TB=800;BUSCA=5;TPAT=300;RMIN=5.00;MARG=40;TD=1200;TP=150;TE=1000;REP=10,T_US:1748367903,PWM:130,RAW:74.000,ACTUAL:14.687,REF:0.000,ERRO:14.687,HALL_MV:3129,HALL_FILT_MV:3129,HALL_CIMA_MV:1260,HALL_CIMA_FILT_MV:1325,TOF_VALID:1,NEW_TOF:0,RANGE_STATUS:0,SIGNAL_MCPS:24.3281,AMBIENT_MCPS:0.0234,SPAD:15.0156,VEL_MM_S:-0.0040,MEAS_RATE_HZ:13.5573,MEAS_AGE_US:9272,DT_HALL_US:1996,DT_TOF_US:73761,DT_EST_US:1997,DT_CTRL_US:1995,IDENT_ACTIVE:1,IDENT_STATE:BUSCANDO_LIMIAR,IDENT_TYPE:PULSO,IDENT_REP:0,IDENT_REP_MAX:10,IDENT_FASE:1,LIM_PWM:-1,LIM_HALL_MV:0,LIM_ACTUAL_MM:NULL,LIM_RAW_MM:NULL,DELTA_LIM_MM:NULL,TEST_PWM:-1,TOF_BASE_MM:14.602,PULSO_HALL_PICO_MV:0,PULSO_ACTUAL_PICO_MM:NULL,DELTA_PULSO_MM:NULL,IDENT_MOTIVO:EM_ANDAMENTO,SYNC_PULSE:0,LIM_HALL_CIMA_MV:0,PULSO_HALL_CIMA_PICO_MV:0,SCALE_LOW:-5.00,SCALE_HIGH:30.00
TEST_ID:IDENT_PULSO_SUBIDA_AGR,TEST_PARAM:SIG=PUL;TB=800;BUSCA=5;TPAT=300;RMIN=5.00;MARG=40;TD=1200;TP=150;TE=1000;REP=10,T_US:1748377903,PWM:135,RAW:72.000,ACTUAL:17.216,REF:0.000,ERRO:17.216,HALL_MV:3129,HALL_FILT_MV:3129,HALL_CIMA_MV:1322,HALL_CIMA_FILT_MV:1322,TOF_VALID:1,NEW_TOF:0,RANGE_STATUS:0,SIGNAL_MCPS:22.7344,AMBIENT_MCPS:0.0312,SPAD:14.0156,VEL_MM_S:-0.0121,MEAS_RATE_HZ:12.6941,MEAS_AGE_US:4260,DT_HALL_US:492,DT_TOF_US:78777,DT_EST_US:486,DT_CTRL_US:490,IDENT_ACTIVE:1,IDENT_STATE:BUSCANDO_LIMIAR,IDENT_TYPE:PULSO,IDENT_REP:0,IDENT_REP_MAX:10,IDENT_FASE:1,LIM_PWM:-1,LIM_HALL_MV:0,LIM_ACTUAL_MM:NULL,LIM_RAW_MM:NULL,DELTA_LIM_MM:NULL,TEST_PWM:-1,TOF_BASE_MM:14.602,PULSO_HALL_PICO_MV:0,PULSO_ACTUAL_PICO_MM:NULL,DELTA_PULSO_MM:NULL,IDENT_MOTIVO:EM_ANDAMENTO,SYNC_PULSE:0,LIM_HALL_CIMA_MV:0,PULSO_HALL_CIMA_PICO_MV:0,SCALE_LOW:-5.00,SCALE_HIGH:30.00
TEST_ID:IDENT_PULSO_SUBIDA_AGR,TEST_PARAM:SIG=PUL;TB=800;BUSCA=5;TPAT=300;RMIN=5.00;MARG=40;TD=1200;TP=150;TE=1000;REP=10,T_US:1748520467,PWM:135,RAW:75.000,ACTUAL:17.101,REF:0.000,ERRO:17.101,HALL_MV:3129,HALL_FILT_MV:3129,HALL_CIMA_MV:1282,HALL_CIMA_FILT_MV:1312,TOF_VALID:1,NEW_TOF:0,RANGE_STATUS:0,SIGNAL_MCPS:22.7813,AMBIENT_MCPS:0.0234,SPAD:14.0156,VEL_MM_S:-0.0105,MEAS_RATE_HZ:13.5538,MEAS_AGE_US:9282,DT_HALL_US:2000,DT_TOF_US:73780,DT_EST_US:2002,DT_CTRL_US:2000,IDENT_ACTIVE:1,IDENT_STATE:BUSCANDO_LIMIAR,IDENT_TYPE:PULSO,IDENT_REP:0,IDENT_REP_MAX:10,IDENT_FASE:1,LIM_PWM:-1,LIM_HALL_MV:0,LIM_ACTUAL_MM:NULL,LIM_RAW_MM:NULL,DELTA_LIM_MM:NULL,TEST_PWM:-1,TOF_BASE_MM:14.602,PULSO_HALL_PICO_MV:0,PULSO_ACTUAL_PICO_MM:NULL,DELTA_PULSO_MM:NULL,IDENT_MOTIVO:EM_ANDAMENTO,SYNC_PULSE:0,LIM_HALL_CIMA_MV:0,PULSO_HALL_CIMA_PICO_MV:0,SCALE_LOW:-5.00,SCALE_HIGH:30.00
TEST_ID:IDENT_PULSO_SUBIDA_AGR,TEST_PARAM:SIG=PUL;TB=800;BUSCA=5;TPAT=300;RMIN=5.00;MARG=40;TD=1200;TP=150;TE=1000;REP=10,T_US:1748530467,PWM:135,RAW:77.000,ACTUAL:16.157,REF:0.000,ERRO:16.157,HALL_MV:3129,HALL_FILT_MV:3129,HALL_CIMA_MV:1296,HALL_CIMA_FILT_MV:1311,TOF_VALID:1,NEW_TOF:0,RANGE_STATUS:0,SIGNAL_MCPS:22.7891,AMBIENT_MCPS:0.0312,SPAD:14.0156,VEL_MM_S:-0.0016,MEAS_RATE_HZ:12.6939,MEAS_AGE_US:4265,DT_HALL_US:489,DT_TOF_US:78778,DT_EST_US:490,DT_CTRL_US:492,IDENT_ACTIVE:1,IDENT_STATE:BUSCANDO_LIMIAR,IDENT_TYPE:PULSO,IDENT_REP:0,IDENT_REP_MAX:10,IDENT_FASE:1,LIM_PWM:-1,LIM_HALL_MV:0,LIM_ACTUAL_MM:NULL,LIM_RAW_MM:NULL,DELTA_LIM_MM:NULL,TEST_PWM:-1,TOF_BASE_MM:14.602,PULSO_HALL_PICO_MV:0,PULSO_ACTUAL_PICO_MM:NULL,DELTA_PULSO_MM:NULL,IDENT_MOTIVO:EM_ANDAMENTO,SYNC_PULSE:0,LIM_HALL_CIMA_MV:0,PULSO_HALL_CIMA_PICO_MV:0,SCALE_LOW:-5.00,SCALE_HIGH:30.00
TEST_ID:IDENT_PULSO_SUBIDA_AGR,TEST_PARAM:SIG=PUL;TB=800;BUSCA=5;TPAT=300;RMIN=5.00;MARG=40;TD=1200;TP=150;TE=1000;REP=10,T_US:1748673028,PWM:135,RAW:77.000,ACTUAL:15.495,REF:0.000,ERRO:15.495,HALL_MV:3129,HALL_FILT_MV:3129,HALL_CIMA_MV:1315,HALL_CIMA_FILT_MV:1324,TOF_VALID:1,NEW_TOF:0,RANGE_STATUS:0,SIGNAL_MCPS:22.7734,AMBIENT_MCPS:0.0312,SPAD:14.0156,VEL_MM_S:0.0058,MEAS_RATE_HZ:13.5542,MEAS_AGE_US:9283,DT_HALL_US:2000,DT_TOF_US:73778,DT_EST_US:2003,DT_CTRL_US:2000,IDENT_ACTIVE:1,IDENT_STATE:BUSCANDO_LIMIAR,IDENT_TYPE:PULSO,IDENT_REP:0,IDENT_REP_MAX:10,IDENT_FASE:1,LIM_PWM:-1,LIM_HALL_MV:0,LIM_ACTUAL_MM:NULL,LIM_RAW_MM:NULL,DELTA_LIM_MM:NULL,TEST_PWM:-1,TOF_BASE_MM:14.602,PULSO_HALL_PICO_MV:0,PULSO_ACTUAL_PICO_MM:NULL,DELTA_PULSO_MM:NULL,IDENT_MOTIVO:EM_ANDAMENTO,SYNC_PULSE:0,LIM_HALL_CIMA_MV:0,PULSO_HALL_CIMA_PICO_MV:0,SCALE_LOW:-5.00,SCALE_HIGH:30.00
TEST_ID:IDENT_PULSO_SUBIDA_AGR,TEST_PARAM:SIG=PUL;TB=800;BUSCA=5;TPAT=300;RMIN=5.00;MARG=40;TD=1200;TP=150;TE=1000;REP=10,T_US:1748683028,PWM:140,RAW:77.000,ACTUAL:14.916,REF:0.000,ERRO:14.916,HALL_MV:3129,HALL_FILT_MV:3129,HALL_CIMA_MV:1321,HALL_CIMA_FILT_MV:1311,TOF_VALID:1,NEW_TOF:0,RANGE_STATUS:0,SIGNAL_MCPS:22.7969,AMBIENT_MCPS:0.0312,SPAD:14.0156,VEL_MM_S:0.0124,MEAS_RATE_HZ:12.6928,MEAS_AGE_US:4269,DT_HALL_US:488,DT_TOF_US:78785,DT_EST_US:487,DT_CTRL_US:495,IDENT_ACTIVE:1,IDENT_STATE:BUSCANDO_LIMIAR,IDENT_TYPE:PULSO,IDENT_REP:0,IDENT_REP_MAX:10,IDENT_FASE:1,LIM_PWM:-1,LIM_HALL_MV:0,LIM_ACTUAL_MM:NULL,LIM_RAW_MM:NULL,DELTA_LIM_MM:NULL,TEST_PWM:-1,TOF_BASE_MM:14.602,PULSO_HALL_PICO_MV:0,PULSO_ACTUAL_PICO_MM:NULL,DELTA_PULSO_MM:NULL,IDENT_MOTIVO:EM_ANDAMENTO,SYNC_PULSE:0,LIM_HALL_CIMA_MV:0,PULSO_HALL_CIMA_PICO_MV:0,SCALE_LOW:-5.00,SCALE_HIGH:30.00
TEST_ID:IDENT_PULSO_SUBIDA_AGR,TEST_PARAM:SIG=PUL;TB=800;BUSCA=5;TPAT=300;RMIN=5.00;MARG=40;TD=1200;TP=150;TE=1000;REP=10,T_US:1748825572,PWM:140,RAW:76.000,ACTUAL:14.866,REF:0.000,ERRO:14.866,HALL_MV:3129,HALL_FILT_MV:3129,HALL_CIMA_MV:1343,HALL_CIMA_FILT_MV:1303,TOF_VALID:1,NEW_TOF:0,RANGE_STATUS:0,SIGNAL_MCPS:22.5703,AMBIENT_MCPS:0.0234,SPAD:14.0156,VEL_MM_S:0.0121,MEAS_RATE_HZ:13.5564,MEAS_AGE_US:9276,DT_HALL_US:1996,DT_TOF_US:73766,DT_EST_US:1999,DT_CTRL_US:1996,IDENT_ACTIVE:1,IDENT_STATE:BUSCANDO_LIMIAR,IDENT_TYPE:PULSO,IDENT_REP:0,IDENT_REP_MAX:10,IDENT_FASE:1,LIM_PWM:-1,LIM_HALL_MV:0,LIM_ACTUAL_MM:NULL,LIM_RAW_MM:NULL,DELTA_LIM_MM:NULL,TEST_PWM:-1,TOF_BASE_MM:14.602,PULSO_HALL_PICO_MV:0,PULSO_ACTUAL_PICO_MM:NULL,DELTA_PULSO_MM:NULL,IDENT_MOTIVO:EM_ANDAMENTO,SYNC_PULSE:0,LIM_HALL_CIMA_MV:0,PULSO_HALL_CIMA_PICO_MV:0,SCALE_LOW:-5.00,SCALE_HIGH:30.00
TEST_ID:IDENT_PULSO_SUBIDA_AGR,TEST_PARAM:SIG=PUL;TB=800;BUSCA=5;TPAT=300;RMIN=5.00;MARG=40;TD=1200;TP=150;TE=1000;REP=10,T_US:1748835572,PWM:140,RAW:74.000,ACTUAL:15.519,REF:0.000,ERRO:15.519,HALL_MV:3129,HALL_FILT_MV:3129,HALL_CIMA_MV:1359,HALL_CIMA_FILT_MV:1315,TOF_VALID:1,NEW_TOF:0,RANGE_STATUS:0,SIGNAL_MCPS:22.6094,AMBIENT_MCPS:0.0312,SPAD:14.0156,VEL_MM_S:0.0016,MEAS_RATE_HZ:12.6947,MEAS_AGE_US:4265,DT_HALL_US:492,DT_TOF_US:78773,DT_EST_US:490,DT_CTRL_US:488,IDENT_ACTIVE:1,IDENT_STATE:BUSCANDO_LIMIAR,IDENT_TYPE:PULSO,IDENT_REP:0,IDENT_REP_MAX:10,IDENT_FASE:1,LIM_PWM:-1,LIM_HALL_MV:0,LIM_ACTUAL_MM:NULL,LIM_RAW_MM:NULL,DELTA_LIM_MM:NULL,TEST_PWM:-1,TOF_BASE_MM:14.602,PULSO_HALL_PICO_MV:0,PULSO_ACTUAL_PICO_MM:NULL,DELTA_PULSO_MM:NULL,IDENT_MOTIVO:EM_ANDAMENTO,SYNC_PULSE:0,LIM_HALL_CIMA_MV:0,PULSO_HALL_CIMA_PICO_MV:0,SCALE_LOW:-5.00,SCALE_HIGH:30.00
TEST_ID:IDENT_PULSO_SUBIDA_AGR,TEST_PARAM:SIG=PUL;TB=800;BUSCA=5;TPAT=300;RMIN=5.00;MARG=40;TD=1200;TP=150;TE=1000;REP=10,T_US:1748978108,PWM:140,RAW:72.000,ACTUAL:16.600,REF:0.000,ERRO:16.600,HALL_MV:3129,HALL_FILT_MV:3129,HALL_CIMA_MV:1282,HALL_CIMA_FILT_MV:1293,TOF_VALID:1,NEW_TOF:0,RANGE_STATUS:0,SIGNAL_MCPS:22.4609,AMBIENT_MCPS:0.0312,SPAD:14.0156,VEL_MM_S:-0.0154,MEAS_RATE_HZ:13.5573,MEAS_AGE_US:9281,DT_HALL_US:2000,DT_TOF_US:73761,DT_EST_US:2002,DT_CTRL_US:2000,IDENT_ACTIVE:1,IDENT_STATE:BUSCANDO_LIMIAR,IDENT_TYPE:PULSO,IDENT_REP:0,IDENT_REP_MAX:10,IDENT_FASE:1,LIM_PWM:-1,LIM_HALL_MV:0,LIM_ACTUAL_MM:NULL,LIM_RAW_MM:NULL,DELTA_LIM_MM:NULL,TEST_PWM:-1,TOF_BASE_MM:14.602,PULSO_HALL_PICO_MV:0,PULSO_ACTUAL_PICO_MM:NULL,DELTA_PULSO_MM:NULL,IDENT_MOTIVO:EM_ANDAMENTO,SYNC_PULSE:0,LIM_HALL_CIMA_MV:0,PULSO_HALL_CIMA_PICO_MV:0,SCALE_LOW:-5.00,SCALE_HIGH:30.00
TEST_ID:IDENT_PULSO_SUBIDA_AGR,TEST_PARAM:SIG=PUL;TB=800;BUSCA=5;TPAT=300;RMIN=5.00;MARG=40;TD=1200;TP=150;TE=1000;REP=10,T_US:1748988108,PWM:145,RAW:73.000,ACTUAL:17.240,REF:0.000,ERRO:17.240,HALL_MV:3129,HALL_FILT_MV:3129,HALL_CIMA_MV:1371,HALL_CIMA_FILT_MV:1302,TOF_VALID:1,NEW_TOF:0,RANGE_STATUS:0,SIGNAL_MCPS:22.4844,AMBIENT_MCPS:0.0312,SPAD:14.0156,VEL_MM_S:-0.0241,MEAS_RATE_HZ:12.6933,MEAS_AGE_US:4260,DT_HALL_US:489,DT_TOF_US:78782,DT_EST_US:486,DT_CTRL_US:491,IDENT_ACTIVE:1,IDENT_STATE:BUSCANDO_LIMIAR,IDENT_TYPE:PULSO,IDENT_REP:0,IDENT_REP_MAX:10,IDENT_FASE:1,LIM_PWM:-1,LIM_HALL_MV:0,LIM_ACTUAL_MM:NULL,LIM_RAW_MM:NULL,DELTA_LIM_MM:NULL,TEST_PWM:-1,TOF_BASE_MM:14.602,PULSO_HALL_PICO_MV:0,PULSO_ACTUAL_PICO_MM:NULL,DELTA_PULSO_MM:NULL,IDENT_MOTIVO:EM_ANDAMENTO,SYNC_PULSE:0,LIM_HALL_CIMA_MV:0,PULSO_HALL_CIMA_PICO_MV:0,SCALE_LOW:-5.00,SCALE_HIGH:30.00
TEST_ID:IDENT_PULSO_SUBIDA_AGR,TEST_PARAM:SIG=PUL;TB=800;BUSCA=5;TPAT=300;RMIN=5.00;MARG=40;TD=1200;TP=150;TE=1000;REP=10,T_US:1749130671,PWM:145,RAW:79.000,ACTUAL:15.973,REF:0.000,ERRO:15.973,HALL_MV:3129,HALL_FILT_MV:3129,HALL_CIMA_MV:1284,HALL_CIMA_FILT_MV:1280,TOF_VALID:1,NEW_TOF:0,RANGE_STATUS:0,SIGNAL_MCPS:22.4063,AMBIENT_MCPS:0.0312,SPAD:14.0156,VEL_MM_S:-0.0022,MEAS_RATE_HZ:13.5529,MEAS_AGE_US:9275,DT_HALL_US:1996,DT_TOF_US:73785,DT_EST_US:1998,DT_CTRL_US:1997,IDENT_ACTIVE:1,IDENT_STATE:BUSCANDO_LIMIAR,IDENT_TYPE:PULSO,IDENT_REP:0,IDENT_REP_MAX:10,IDENT_FASE:1,LIM_PWM:-1,LIM_HALL_MV:0,LIM_ACTUAL_MM:NULL,LIM_RAW_MM:NULL,DELTA_LIM_MM:NULL,TEST_PWM:-1,TOF_BASE_MM:14.602,PULSO_HALL_PICO_MV:0,PULSO_ACTUAL_PICO_MM:NULL,DELTA_PULSO_MM:NULL,IDENT_MOTIVO:EM_ANDAMENTO,SYNC_PULSE:0,LIM_HALL_CIMA_MV:0,PULSO_HALL_CIMA_PICO_MV:0,SCALE_LOW:-5.00,SCALE_HIGH:30.00
TEST_ID:IDENT_PULSO_SUBIDA_AGR,TEST_PARAM:SIG=PUL;TB=800;BUSCA=5;TPAT=300;RMIN=5.00;MARG=40;TD=1200;TP=150;TE=1000;REP=10,T_US:1749140671,PWM:145,RAW:77.000,ACTUAL:15.517,REF:0.000,ERRO:15.517,HALL_MV:3129,HALL_FILT_MV:3129,HALL_CIMA_MV:1226,HALL_CIMA_FILT_MV:1255,TOF_VALID:1,NEW_TOF:0,RANGE_STATUS:0,SIGNAL_MCPS:22.4844,AMBIENT_MCPS:0.0234,SPAD:14.0156,VEL_MM_S:0.0052,MEAS_RATE_HZ:12.6941,MEAS_AGE_US:4263,DT_HALL_US:494,DT_TOF_US:78777,DT_EST_US:491,DT_CTRL_US:488,IDENT_ACTIVE:1,IDENT_STATE:BUSCANDO_LIMIAR,IDENT_TYPE:PULSO,IDENT_REP:0,IDENT_REP_MAX:10,IDENT_FASE:1,LIM_PWM:-1,LIM_HALL_MV:0,LIM_ACTUAL_MM:NULL,LIM_RAW_MM:NULL,DELTA_LIM_MM:NULL,TEST_PWM:-1,TOF_BASE_MM:14.602,PULSO_HALL_PICO_MV:0,PULSO_ACTUAL_PICO_MM:NULL,DELTA_PULSO_MM:NULL,IDENT_MOTIVO:EM_ANDAMENTO,SYNC_PULSE:0,LIM_HALL_CIMA_MV:0,PULSO_HALL_CIMA_PICO_MV:0,SCALE_LOW:-5.00,SCALE_HIGH:30.00
TEST_ID:IDENT_PULSO_SUBIDA_AGR,TEST_PARAM:SIG=PUL;TB=800;BUSCA=5;TPAT=300;RMIN=5.00;MARG=40;TD=1200;TP=150;TE=1000;REP=10,T_US:1749283226,PWM:145,RAW:77.000,ACTUAL:14.793,REF:0.000,ERRO:14.793,HALL_MV:3129,HALL_FILT_MV:3129,HALL_CIMA_MV:1308,HALL_CIMA_FILT_MV:1291,TOF_VALID:1,NEW_TOF:1,RANGE_STATUS:0,SIGNAL_MCPS:22.7422,AMBIENT_MCPS:0.0234,SPAD:14.0156,VEL_MM_S:0.0156,MEAS_RATE_HZ:107.6658,MEAS_AGE_US:0,DT_HALL_US:2000,DT_TOF_US:9288,DT_EST_US:2002,DT_CTRL_US:4045,IDENT_ACTIVE:1,IDENT_STATE:BUSCANDO_LIMIAR,IDENT_TYPE:PULSO,IDENT_REP:0,IDENT_REP_MAX:10,IDENT_FASE:1,LIM_PWM:-1,LIM_HALL_MV:0,LIM_ACTUAL_MM:NULL,LIM_RAW_MM:NULL,DELTA_LIM_MM:NULL,TEST_PWM:-1,TOF_BASE_MM:14.602,PULSO_HALL_PICO_MV:0,PULSO_ACTUAL_PICO_MM:NULL,DELTA_PULSO_MM:NULL,IDENT_MOTIVO:EM_ANDAMENTO,SYNC_PULSE:0,LIM_HALL_CIMA_MV:0,PULSO_HALL_CIMA_PICO_MV:0,SCALE_LOW:-5.00,SCALE_HIGH:30.00
TEST_ID:IDENT_PULSO_SUBIDA_AGR,TEST_PARAM:SIG=PUL;TB=800;BUSCA=5;TPAT=300;RMIN=5.00;MARG=40;TD=1200;TP=150;TE=1000;REP=10,T_US:1749293226,PWM:150,RAW:72.000,ACTUAL:15.789,REF:0.000,ERRO:15.789,HALL_MV:3129,HALL_FILT_MV:3129,HALL_CIMA_MV:1270,HALL_CIMA_FILT_MV:1301,TOF_VALID:1,NEW_TOF:0,RANGE_STATUS:0,SIGNAL_MCPS:22.6641,AMBIENT_MCPS:0.0234,SPAD:14.0156,VEL_MM_S:-0.0003,MEAS_RATE_HZ:13.9723,MEAS_AGE_US:4243,DT_HALL_US:489,DT_TOF_US:71570,DT_EST_US:487,DT_CTRL_US:489,IDENT_ACTIVE:1,IDENT_STATE:BUSCANDO_LIMIAR,IDENT_TYPE:PULSO,IDENT_REP:0,IDENT_REP_MAX:10,IDENT_FASE:1,LIM_PWM:-1,LIM_HALL_MV:0,LIM_ACTUAL_MM:NULL,LIM_RAW_MM:NULL,DELTA_LIM_MM:NULL,TEST_PWM:-1,TOF_BASE_MM:14.602,PULSO_HALL_PICO_MV:0,PULSO_ACTUAL_PICO_MM:NULL,DELTA_PULSO_MM:NULL,IDENT_MOTIVO:EM_ANDAMENTO,SYNC_PULSE:0,LIM_HALL_CIMA_MV:0,PULSO_HALL_CIMA_PICO_MV:0,SCALE_LOW:-5.00,SCALE_HIGH:30.00
TEST_ID:IDENT_PULSO_SUBIDA_AGR,TEST_PARAM:SIG=PUL;TB=800;BUSCA=5;TPAT=300;RMIN=5.00;MARG=40;TD=1200;TP=150;TE=1000;REP=10,T_US:1749437897,PWM:150,RAW:74.000,ACTUAL:15.742,REF:0.000,ERRO:15.742,HALL_MV:3129,HALL_FILT_MV:3129,HALL_CIMA_MV:1231,HALL_CIMA_FILT_MV:1258,TOF_VALID:1,NEW_TOF:0,RANGE_STATUS:0,SIGNAL_MCPS:22.7266,AMBIENT_MCPS:0.0234,SPAD:14.0156,VEL_MM_S:0.0003,MEAS_RATE_HZ:137.5516,MEAS_AGE_US:2576,DT_HALL_US:2547,DT_TOF_US:7270,DT_EST_US:2570,DT_CTRL_US:618,IDENT_ACTIVE:1,IDENT_STATE:BUSCANDO_LIMIAR,IDENT_TYPE:PULSO,IDENT_REP:0,IDENT_REP_MAX:10,IDENT_FASE:1,LIM_PWM:-1,LIM_HALL_MV:0,LIM_ACTUAL_MM:NULL,LIM_RAW_MM:NULL,DELTA_LIM_MM:NULL,TEST_PWM:-1,TOF_BASE_MM:14.602,PULSO_HALL_PICO_MV:0,PULSO_ACTUAL_PICO_MM:NULL,DELTA_PULSO_MM:NULL,IDENT_MOTIVO:EM_ANDAMENTO,SYNC_PULSE:0,LIM_HALL_CIMA_MV:0,PULSO_HALL_CIMA_PICO_MV:0,SCALE_LOW:-5.00,SCALE_HIGH:30.00
TEST_ID:IDENT_PULSO_SUBIDA_AGR,TEST_PARAM:SIG=PUL;TB=800;BUSCA=5;TPAT=300;RMIN=5.00;MARG=40;TD=1200;TP=150;TE=1000;REP=10,T_US:1749447897,PWM:150,RAW:76.000,ACTUAL:15.614,REF:0.000,ERRO:15.614,HALL_MV:3129,HALL_FILT_MV:3129,HALL_CIMA_MV:1319,HALL_CIMA_FILT_MV:1285,TOF_VALID:1,NEW_TOF:0,RANGE_STATUS:0,SIGNAL_MCPS:22.8516,AMBIENT_MCPS:0.0312,SPAD:14.0156,VEL_MM_S:0.0019,MEAS_RATE_HZ:13.8569,MEAS_AGE_US:4253,DT_HALL_US:492,DT_TOF_US:72166,DT_EST_US:489,DT_CTRL_US:488,IDENT_ACTIVE:1,IDENT_STATE:BUSCANDO_LIMIAR,IDENT_TYPE:PULSO,IDENT_REP:0,IDENT_REP_MAX:10,IDENT_FASE:1,LIM_PWM:-1,LIM_HALL_MV:0,LIM_ACTUAL_MM:NULL,LIM_RAW_MM:NULL,DELTA_LIM_MM:NULL,TEST_PWM:-1,TOF_BASE_MM:14.602,PULSO_HALL_PICO_MV:0,PULSO_ACTUAL_PICO_MM:NULL,DELTA_PULSO_MM:NULL,IDENT_MOTIVO:EM_ANDAMENTO,SYNC_PULSE:0,LIM_HALL_CIMA_MV:0,PULSO_HALL_CIMA_PICO_MV:0,SCALE_LOW:-5.00,SCALE_HIGH:30.00
TEST_ID:IDENT_PULSO_SUBIDA_AGR,TEST_PARAM:SIG=PUL;TB=800;BUSCA=5;TPAT=300;RMIN=5.00;MARG=40;TD=1200;TP=150;TE=1000;REP=10,T_US:1749592561,PWM:150,RAW:77.000,ACTUAL:15.798,REF:0.000,ERRO:15.798,HALL_MV:3129,HALL_FILT_MV:3129,HALL_CIMA_MV:1152,HALL_CIMA_FILT_MV:1223,TOF_VALID:1,NEW_TOF:0,RANGE_STATUS:0,SIGNAL_MCPS:22.7969,AMBIENT_MCPS:0.0312,SPAD:14.0156,VEL_MM_S:0.0008,MEAS_RATE_HZ:200.0000,MEAS_AGE_US:5978,DT_HALL_US:1996,DT_TOF_US:5000,DT_EST_US:1998,DT_CTRL_US:1990,IDENT_ACTIVE:1,IDENT_STATE:BUSCANDO_LIMIAR,IDENT_TYPE:PULSO,IDENT_REP:0,IDENT_REP_MAX:10,IDENT_FASE:1,LIM_PWM:-1,LIM_HALL_MV:0,LIM_ACTUAL_MM:NULL,LIM_RAW_MM:NULL,DELTA_LIM_MM:NULL,TEST_PWM:-1,TOF_BASE_MM:14.602,PULSO_HALL_PICO_MV:0,PULSO_ACTUAL_PICO_MM:NULL,DELTA_PULSO_MM:NULL,IDENT_MOTIVO:EM_ANDAMENTO,SYNC_PULSE:0,LIM_HALL_CIMA_MV:0,PULSO_HALL_CIMA_PICO_MV:0,SCALE_LOW:-5.00,SCALE_HIGH:30.00
TEST_ID:IDENT_PULSO_SUBIDA_AGR,TEST_PARAM:SIG=PUL;TB=800;BUSCA=5;TPAT=300;RMIN=5.00;MARG=40;TD=1200;TP=150;TE=1000;REP=10,T_US:1749602561,PWM:155,RAW:75.000,ACTUAL:15.949,REF:0.000,ERRO:15.949,HALL_MV:3129,HALL_FILT_MV:3129,HALL_CIMA_MV:1308,HALL_CIMA_FILT_MV:1267,TOF_VALID:1,NEW_TOF:0,RANGE_STATUS:0,SIGNAL_MCPS:22.8828,AMBIENT_MCPS:0.0234,SPAD:14.0156,VEL_MM_S:-0.0007,MEAS_RATE_HZ:13.2494,MEAS_AGE_US:4270,DT_HALL_US:493,DT_TOF_US:75475,DT_EST_US:491,DT_CTRL_US:488,IDENT_ACTIVE:1,IDENT_STATE:BUSCANDO_LIMIAR,IDENT_TYPE:PULSO,IDENT_REP:0,IDENT_REP_MAX:10,IDENT_FASE:1,LIM_PWM:-1,LIM_HALL_MV:0,LIM_ACTUAL_MM:NULL,LIM_RAW_MM:NULL,DELTA_LIM_MM:NULL,TEST_PWM:-1,TOF_BASE_MM:14.602,PULSO_HALL_PICO_MV:0,PULSO_ACTUAL_PICO_MM:NULL,DELTA_PULSO_MM:NULL,IDENT_MOTIVO:EM_ANDAMENTO,SYNC_PULSE:0,LIM_HALL_CIMA_MV:0,PULSO_HALL_CIMA_PICO_MV:0,SCALE_LOW:-5.00,SCALE_HIGH:30.00
TEST_ID:IDENT_PULSO_SUBIDA_AGR,TEST_PARAM:SIG=PUL;TB=800;BUSCA=5;TPAT=300;RMIN=5.00;MARG=40;TD=1200;TP=150;TE=1000;REP=10,T_US:1749745109,PWM:155,RAW:77.000,ACTUAL:15.438,REF:0.000,ERRO:15.438,HALL_MV:3129,HALL_FILT_MV:3129,HALL_CIMA_MV:1255,HALL_CIMA_FILT_MV:1257,TOF_VALID:1,NEW_TOF:0,RANGE_STATUS:0,SIGNAL_MCPS:22.7734,AMBIENT_MCPS:0.0312,SPAD:14.0156,VEL_MM_S:0.0056,MEAS_RATE_HZ:13.5542,MEAS_AGE_US:9280,DT_HALL_US:2000,DT_TOF_US:73778,DT_EST_US:2002,DT_CTRL_US:2001,IDENT_ACTIVE:1,IDENT_STATE:BUSCANDO_LIMIAR,IDENT_TYPE:PULSO,IDENT_REP:0,IDENT_REP_MAX:10,IDENT_FASE:1,LIM_PWM:-1,LIM_HALL_MV:0,LIM_ACTUAL_MM:NULL,LIM_RAW_MM:NULL,DELTA_LIM_MM:NULL,TEST_PWM:-1,TOF_BASE_MM:14.602,PULSO_HALL_PICO_MV:0,PULSO_ACTUAL_PICO_MM:NULL,DELTA_PULSO_MM:NULL,IDENT_MOTIVO:EM_ANDAMENTO,SYNC_PULSE:0,LIM_HALL_CIMA_MV:0,PULSO_HALL_CIMA_PICO_MV:0,SCALE_LOW:-5.00,SCALE_HIGH:30.00
TEST_ID:IDENT_PULSO_SUBIDA_AGR,TEST_PARAM:SIG=PUL;TB=800;BUSCA=5;TPAT=300;RMIN=5.00;MARG=40;TD=1200;TP=150;TE=1000;REP=10,T_US:1749755109,PWM:155,RAW:76.000,ACTUAL:15.284,REF:0.000,ERRO:15.284,HALL_MV:3129,HALL_FILT_MV:3129,HALL_CIMA_MV:1260,HALL_CIMA_FILT_MV:1250,TOF_VALID:1,NEW_TOF:0,RANGE_STATUS:0,SIGNAL_MCPS:22.6641,AMBIENT_MCPS:0.0312,SPAD:14.0156,VEL_MM_S:0.0069,MEAS_RATE_HZ:12.6934,MEAS_AGE_US:4257,DT_HALL_US:488,DT_TOF_US:78781,DT_EST_US:486,DT_CTRL_US:491,IDENT_ACTIVE:1,IDENT_STATE:BUSCANDO_LIMIAR,IDENT_TYPE:PULSO,IDENT_REP:0,IDENT_REP_MAX:10,IDENT_FASE:1,LIM_PWM:-1,LIM_HALL_MV:0,LIM_ACTUAL_MM:NULL,LIM_RAW_MM:NULL,DELTA_LIM_MM:NULL,TEST_PWM:-1,TOF_BASE_MM:14.602,PULSO_HALL_PICO_MV:0,PULSO_ACTUAL_PICO_MM:NULL,DELTA_PULSO_MM:NULL,IDENT_MOTIVO:EM_ANDAMENTO,SYNC_PULSE:0,LIM_HALL_CIMA_MV:0,PULSO_HALL_CIMA_PICO_MV:0,SCALE_LOW:-5.00,SCALE_HIGH:30.00
TEST_ID:IDENT_PULSO_SUBIDA_AGR,TEST_PARAM:SIG=PUL;TB=800;BUSCA=5;TPAT=300;RMIN=5.00;MARG=40;TD=1200;TP=150;TE=1000;REP=10,T_US:1749897653,PWM:155,RAW:78.000,ACTUAL:14.411,REF:0.000,ERRO:14.411,HALL_MV:3129,HALL_FILT_MV:3129,HALL_CIMA_MV:1288,HALL_CIMA_FILT_MV:1280,TOF_VALID:1,NEW_TOF:0,RANGE_STATUS:0,SIGNAL_MCPS:22.8828,AMBIENT_MCPS:0.0234,SPAD:14.0156,VEL_MM_S:0.0179,MEAS_RATE_HZ:13.5560,MEAS_AGE_US:9273,DT_HALL_US:2001,DT_TOF_US:73768,DT_EST_US:2003,DT_CTRL_US:1999,IDENT_ACTIVE:1,IDENT_STATE:BUSCANDO_LIMIAR,IDENT_TYPE:PULSO,IDENT_REP:0,IDENT_REP_MAX:10,IDENT_FASE:1,LIM_PWM:-1,LIM_HALL_MV:0,LIM_ACTUAL_MM:NULL,LIM_RAW_MM:NULL,DELTA_LIM_MM:NULL,TEST_PWM:-1,TOF_BASE_MM:14.602,PULSO_HALL_PICO_MV:0,PULSO_ACTUAL_PICO_MM:NULL,DELTA_PULSO_MM:NULL,IDENT_MOTIVO:EM_ANDAMENTO,SYNC_PULSE:0,LIM_HALL_CIMA_MV:0,PULSO_HALL_CIMA_PICO_MV:0,SCALE_LOW:-5.00,SCALE_HIGH:30.00
TEST_ID:IDENT_PULSO_SUBIDA_AGR,TEST_PARAM:SIG=PUL;TB=800;BUSCA=5;TPAT=300;RMIN=5.00;MARG=40;TD=1200;TP=150;TE=1000;REP=10,T_US:1749907653,PWM:160,RAW:76.000,ACTUAL:14.448,REF:0.000,ERRO:14.448,HALL_MV:3129,HALL_FILT_MV:3129,HALL_CIMA_MV:1256,HALL_CIMA_FILT_MV:1254,TOF_VALID:1,NEW_TOF:0,RANGE_STATUS:0,SIGNAL_MCPS:22.7031,AMBIENT_MCPS:0.0156,SPAD:14.0156,VEL_MM_S:0.0160,MEAS_RATE_HZ:12.6939,MEAS_AGE_US:4261,DT_HALL_US:490,DT_TOF_US:78778,DT_EST_US:488,DT_CTRL_US:488,IDENT_ACTIVE:1,IDENT_STATE:BUSCANDO_LIMIAR,IDENT_TYPE:PULSO,IDENT_REP:0,IDENT_REP_MAX:10,IDENT_FASE:1,LIM_PWM:-1,LIM_HALL_MV:0,LIM_ACTUAL_MM:NULL,LIM_RAW_MM:NULL,DELTA_LIM_MM:NULL,TEST_PWM:-1,TOF_BASE_MM:14.602,PULSO_HALL_PICO_MV:0,PULSO_ACTUAL_PICO_MM:NULL,DELTA_PULSO_MM:NULL,IDENT_MOTIVO:EM_ANDAMENTO,SYNC_PULSE:0,LIM_HALL_CIMA_MV:0,PULSO_HALL_CIMA_PICO_MV:0,SCALE_LOW:-5.00,SCALE_HIGH:30.00
TEST_ID:IDENT_PULSO_SUBIDA_AGR,TEST_PARAM:SIG=PUL;TB=800;BUSCA=5;TPAT=300;RMIN=5.00;MARG=40;TD=1200;TP=150;TE=1000;REP=10,T_US:1750050189,PWM:160,RAW:79.000,ACTUAL:13.421,REF:0.000,ERRO:13.421,HALL_MV:3129,HALL_FILT_MV:3129,HALL_CIMA_MV:1272,HALL_CIMA_FILT_MV:1270,TOF_VALID:1,NEW_TOF:0,RANGE_STATUS:0,SIGNAL_MCPS:22.5313,AMBIENT_MCPS:0.0234,SPAD:14.0156,VEL_MM_S:0.0299,MEAS_RATE_HZ:13.5586,MEAS_AGE_US:9280,DT_HALL_US:2000,DT_TOF_US:73754,DT_EST_US:2001,DT_CTRL_US:1999,IDENT_ACTIVE:1,IDENT_STATE:BUSCANDO_LIMIAR,IDENT_TYPE:PULSO,IDENT_REP:0,IDENT_REP_MAX:10,IDENT_FASE:1,LIM_PWM:-1,LIM_HALL_MV:0,LIM_ACTUAL_MM:NULL,LIM_RAW_MM:NULL,DELTA_LIM_MM:NULL,TEST_PWM:-1,TOF_BASE_MM:14.602,PULSO_HALL_PICO_MV:0,PULSO_ACTUAL_PICO_MM:NULL,DELTA_PULSO_MM:NULL,IDENT_MOTIVO:EM_ANDAMENTO,SYNC_PULSE:0,LIM_HALL_CIMA_MV:0,PULSO_HALL_CIMA_PICO_MV:0,SCALE_LOW:-5.00,SCALE_HIGH:30.00
TEST_ID:IDENT_PULSO_SUBIDA_AGR,TEST_PARAM:SIG=PUL;TB=800;BUSCA=5;TPAT=300;RMIN=5.00;MARG=40;TD=1200;TP=150;TE=1000;REP=10,T_US:1750060189,PWM:160,RAW:78.000,ACTUAL:12.860,REF:0.000,ERRO:12.860,HALL_MV:3129,HALL_FILT_MV:3129,HALL_CIMA_MV:1308,HALL_CIMA_FILT_MV:1280,TOF_VALID:1,NEW_TOF:0,RANGE_STATUS:0,SIGNAL_MCPS:24.0781,AMBIENT_MCPS:0.0312,SPAD:15.0156,VEL_MM_S:0.0351,MEAS_RATE_HZ:12.6941,MEAS_AGE_US:4268,DT_HALL_US:488,DT_TOF_US:78777,DT_EST_US:487,DT_CTRL_US:493,IDENT_ACTIVE:1,IDENT_STATE:BUSCANDO_LIMIAR,IDENT_TYPE:PULSO,IDENT_REP:0,IDENT_REP_MAX:10,IDENT_FASE:1,LIM_PWM:-1,LIM_HALL_MV:0,LIM_ACTUAL_MM:NULL,LIM_RAW_MM:NULL,DELTA_LIM_MM:NULL,TEST_PWM:-1,TOF_BASE_MM:14.602,PULSO_HALL_PICO_MV:0,PULSO_ACTUAL_PICO_MM:NULL,DELTA_PULSO_MM:NULL,IDENT_MOTIVO:EM_ANDAMENTO,SYNC_PULSE:0,LIM_HALL_CIMA_MV:0,PULSO_HALL_CIMA_PICO_MV:0,SCALE_LOW:-5.00,SCALE_HIGH:30.00
TEST_ID:IDENT_PULSO_SUBIDA_AGR,TEST_PARAM:SIG=PUL;TB=800;BUSCA=5;TPAT=300;RMIN=5.00;MARG=40;TD=1200;TP=150;TE=1000;REP=10,T_US:1750202728,PWM:160,RAW:77.000,ACTUAL:12.800,REF:0.000,ERRO:12.800,HALL_MV:3129,HALL_FILT_MV:3129,HALL_CIMA_MV:1260,HALL_CIMA_FILT_MV:1237,TOF_VALID:1,NEW_TOF:0,RANGE_STATUS:0,SIGNAL_MCPS:22.5234,AMBIENT_MCPS:0.0312,SPAD:14.0156,VEL_MM_S:0.0331,MEAS_RATE_HZ:13.5564,MEAS_AGE_US:9271,DT_HALL_US:1996,DT_TOF_US:73766,DT_EST_US:1999,DT_CTRL_US:1997,IDENT_ACTIVE:1,IDENT_STATE:BUSCANDO_LIMIAR,IDENT_TYPE:PULSO,IDENT_REP:0,IDENT_REP_MAX:10,IDENT_FASE:1,LIM_PWM:-1,LIM_HALL_MV:0,LIM_ACTUAL_MM:NULL,LIM_RAW_MM:NULL,DELTA_LIM_MM:NULL,TEST_PWM:-1,TOF_BASE_MM:14.602,PULSO_HALL_PICO_MV:0,PULSO_ACTUAL_PICO_MM:NULL,DELTA_PULSO_MM:NULL,IDENT_MOTIVO:EM_ANDAMENTO,SYNC_PULSE:0,LIM_HALL_CIMA_MV:0,PULSO_HALL_CIMA_PICO_MV:0,SCALE_LOW:-5.00,SCALE_HIGH:30.00
TEST_ID:IDENT_PULSO_SUBIDA_AGR,TEST_PARAM:SIG=PUL;TB=800;BUSCA=5;TPAT=300;RMIN=5.00;MARG=40;TD=1200;TP=150;TE=1000;REP=10,T_US:1750212728,PWM:165,RAW:77.000,ACTUAL:12.751,REF:0.000,ERRO:12.751,HALL_MV:3129,HALL_FILT_MV:3129,HALL_CIMA_MV:1329,HALL_CIMA_FILT_MV:1255,TOF_VALID:1,NEW_TOF:0,RANGE_STATUS:0,SIGNAL_MCPS:22.6406,AMBIENT_MCPS:0.0156,SPAD:14.0156,VEL_MM_S:0.0313,MEAS_RATE_HZ:12.6941,MEAS_AGE_US:4262,DT_HALL_US:490,DT_TOF_US:78777,DT_EST_US:489,DT_CTRL_US:489,IDENT_ACTIVE:1,IDENT_STATE:BUSCANDO_LIMIAR,IDENT_TYPE:PULSO,IDENT_REP:0,IDENT_REP_MAX:10,IDENT_FASE:1,LIM_PWM:-1,LIM_HALL_MV:0,LIM_ACTUAL_MM:NULL,LIM_RAW_MM:NULL,DELTA_LIM_MM:NULL,TEST_PWM:-1,TOF_BASE_MM:14.602,PULSO_HALL_PICO_MV:0,PULSO_ACTUAL_PICO_MM:NULL,DELTA_PULSO_MM:NULL,IDENT_MOTIVO:EM_ANDAMENTO,SYNC_PULSE:0,LIM_HALL_CIMA_MV:0,PULSO_HALL_CIMA_PICO_MV:0,SCALE_LOW:-5.00,SCALE_HIGH:30.00
TEST_ID:IDENT_PULSO_SUBIDA_AGR,TEST_PARAM:SIG=PUL;TB=800;BUSCA=5;TPAT=300;RMIN=5.00;MARG=40;TD=1200;TP=150;TE=1000;REP=10,T_US:1750355275,PWM:165,RAW:77.000,ACTUAL:12.711,REF:0.000,ERRO:12.711,HALL_MV:3129,HALL_FILT_MV:3129,HALL_CIMA_MV:1267,HALL_CIMA_FILT_MV:1254,TOF_VALID:1,NEW_TOF:0,RANGE_STATUS:0,SIGNAL_MCPS:22.6406,AMBIENT_MCPS:0.0312,SPAD:14.0156,VEL_MM_S:0.0294,MEAS_RATE_HZ:13.5582,MEAS_AGE_US:9286,DT_HALL_US:2000,DT_TOF_US:73756,DT_EST_US:2002,DT_CTRL_US:2000,IDENT_ACTIVE:1,IDENT_STATE:BUSCANDO_LIMIAR,IDENT_TYPE:PULSO,IDENT_REP:0,IDENT_REP_MAX:10,IDENT_FASE:1,LIM_PWM:-1,LIM_HALL_MV:0,LIM_ACTUAL_MM:NULL,LIM_RAW_MM:NULL,DELTA_LIM_MM:NULL,TEST_PWM:-1,TOF_BASE_MM:14.602,PULSO_HALL_PICO_MV:0,PULSO_ACTUAL_PICO_MM:NULL,DELTA_PULSO_MM:NULL,IDENT_MOTIVO:EM_ANDAMENTO,SYNC_PULSE:0,LIM_HALL_CIMA_MV:0,PULSO_HALL_CIMA_PICO_MV:0,SCALE_LOW:-5.00,SCALE_HIGH:30.00
TEST_ID:IDENT_PULSO_SUBIDA_AGR,TEST_PARAM:SIG=PUL;TB=800;BUSCA=5;TPAT=300;RMIN=5.00;MARG=40;TD=1200;TP=150;TE=1000;REP=10,T_US:1750365275,PWM:165,RAW:72.000,ACTUAL:14.201,REF:0.000,ERRO:14.201,HALL_MV:3129,HALL_FILT_MV:3129,HALL_CIMA_MV:1266,HALL_CIMA_FILT_MV:1232,TOF_VALID:1,NEW_TOF:0,RANGE_STATUS:0,SIGNAL_MCPS:22.6641,AMBIENT_MCPS:0.0312,SPAD:14.0156,VEL_MM_S:0.0050,MEAS_RATE_HZ:12.6931,MEAS_AGE_US:4258,DT_HALL_US:488,DT_TOF_US:78783,DT_EST_US:487,DT_CTRL_US:491,IDENT_ACTIVE:1,IDENT_STATE:BUSCANDO_LIMIAR,IDENT_TYPE:PULSO,IDENT_REP:0,IDENT_REP_MAX:10,IDENT_FASE:1,LIM_PWM:-1,LIM_HALL_MV:0,LIM_ACTUAL_MM:NULL,LIM_RAW_MM:NULL,DELTA_LIM_MM:NULL,TEST_PWM:-1,TOF_BASE_MM:14.602,PULSO_HALL_PICO_MV:0,PULSO_ACTUAL_PICO_MM:NULL,DELTA_PULSO_MM:NULL,IDENT_MOTIVO:EM_ANDAMENTO,SYNC_PULSE:0,LIM_HALL_CIMA_MV:0,PULSO_HALL_CIMA_PICO_MV:0,SCALE_LOW:-5.00,SCALE_HIGH:30.00
TEST_ID:IDENT_PULSO_SUBIDA_AGR,TEST_PARAM:SIG=PUL;TB=800;BUSCA=5;TPAT=300;RMIN=5.00;MARG=40;TD=1200;TP=150;TE=1000;REP=10,T_US:1750507811,PWM:165,RAW:74.000,ACTUAL:15.268,REF:0.000,ERRO:15.268,HALL_MV:3129,HALL_FILT_MV:3129,HALL_CIMA_MV:1161,HALL_CIMA_FILT_MV:1207,TOF_VALID:1,NEW_TOF:0,RANGE_STATUS:0,SIGNAL_MCPS:22.4688,AMBIENT_MCPS:0.0312,SPAD:14.0156,VEL_MM_S:-0.0050,MEAS_RATE_HZ:13.5564,MEAS_AGE_US:9271,DT_HALL_US:1997,DT_TOF_US:73766,DT_EST_US:1999,DT_CTRL_US:1995,IDENT_ACTIVE:1,IDENT_STATE:BUSCANDO_LIMIAR,IDENT_TYPE:PULSO,IDENT_REP:0,IDENT_REP_MAX:10,IDENT_FASE:1,LIM_PWM:-1,LIM_HALL_MV:0,LIM_ACTUAL_MM:NULL,LIM_RAW_MM:NULL,DELTA_LIM_MM:NULL,TEST_PWM:-1,TOF_BASE_MM:14.602,PULSO_HALL_PICO_MV:0,PULSO_ACTUAL_PICO_MM:NULL,DELTA_PULSO_MM:NULL,IDENT_MOTIVO:EM_ANDAMENTO,SYNC_PULSE:0,LIM_HALL_CIMA_MV:0,PULSO_HALL_CIMA_PICO_MV:0,SCALE_LOW:-5.00,SCALE_HIGH:30.00
TEST_ID:IDENT_PULSO_SUBIDA_AGR,TEST_PARAM:SIG=PUL;TB=800;BUSCA=5;TPAT=300;RMIN=5.00;MARG=40;TD=1200;TP=150;TE=1000;REP=10,T_US:1750517811,PWM:170,RAW:77.000,ACTUAL:14.719,REF:0.000,ERRO:14.719,HALL_MV:3129,HALL_FILT_MV:3129,HALL_CIMA_MV:1276,HALL_CIMA_FILT_MV:1224,TOF_VALID:1,NEW_TOF:0,RANGE_STATUS:0,SIGNAL_MCPS:22.4141,AMBIENT_MCPS:0.0234,SPAD:14.0156,VEL_MM_S:0.0009,MEAS_RATE_HZ:12.6939,MEAS_AGE_US:4262,DT_HALL_US:493,DT_TOF_US:78778,DT_EST_US:490,DT_CTRL_US:488,IDENT_ACTIVE:1,IDENT_STATE:BUSCANDO_LIMIAR,IDENT_TYPE:PULSO,IDENT_REP:0,IDENT_REP_MAX:10,IDENT_FASE:1,LIM_PWM:-1,LIM_HALL_MV:0,LIM_ACTUAL_MM:NULL,LIM_RAW_MM:NULL,DELTA_LIM_MM:NULL,TEST_PWM:-1,TOF_BASE_MM:14.602,PULSO_HALL_PICO_MV:0,PULSO_ACTUAL_PICO_MM:NULL,DELTA_PULSO_MM:NULL,IDENT_MOTIVO:EM_ANDAMENTO,SYNC_PULSE:0,LIM_HALL_CIMA_MV:0,PULSO_HALL_CIMA_PICO_MV:0,SCALE_LOW:-5.00,SCALE_HIGH:30.00
TEST_ID:IDENT_PULSO_SUBIDA_AGR,TEST_PARAM:SIG=PUL;TB=800;BUSCA=5;TPAT=300;RMIN=5.00;MARG=40;TD=1200;TP=150;TE=1000;REP=10,T_US:1750660369,PWM:170,RAW:78.000,ACTUAL:13.944,REF:0.000,ERRO:13.944,HALL_MV:3129,HALL_FILT_MV:3129,HALL_CIMA_MV:1203,HALL_CIMA_FILT_MV:1212,TOF_VALID:1,NEW_TOF:0,RANGE_STATUS:0,SIGNAL_MCPS:22.5625,AMBIENT_MCPS:0.0234,SPAD:14.0156,VEL_MM_S:0.0101,MEAS_RATE_HZ:13.5547,MEAS_AGE_US:9281,DT_HALL_US:2000,DT_TOF_US:73775,DT_EST_US:2002,DT_CTRL_US:2000,IDENT_ACTIVE:1,IDENT_STATE:BUSCANDO_LIMIAR,IDENT_TYPE:PULSO,IDENT_REP:0,IDENT_REP_MAX:10,IDENT_FASE:1,LIM_PWM:-1,LIM_HALL_MV:0,LIM_ACTUAL_MM:NULL,LIM_RAW_MM:NULL,DELTA_LIM_MM:NULL,TEST_PWM:-1,TOF_BASE_MM:14.602,PULSO_HALL_PICO_MV:0,PULSO_ACTUAL_PICO_MM:NULL,DELTA_PULSO_MM:NULL,IDENT_MOTIVO:EM_ANDAMENTO,SYNC_PULSE:0,LIM_HALL_CIMA_MV:0,PULSO_HALL_CIMA_PICO_MV:0,SCALE_LOW:-5.00,SCALE_HIGH:30.00
TEST_ID:IDENT_PULSO_SUBIDA_AGR,TEST_PARAM:SIG=PUL;TB=800;BUSCA=5;TPAT=300;RMIN=5.00;MARG=40;TD=1200;TP=150;TE=1000;REP=10,T_US:1750670369,PWM:170,RAW:75.000,ACTUAL:14.407,REF:0.000,ERRO:14.407,HALL_MV:3129,HALL_FILT_MV:3129,HALL_CIMA_MV:1275,HALL_CIMA_FILT_MV:1233,TOF_VALID:1,NEW_TOF:0,RANGE_STATUS:0,SIGNAL_MCPS:22.4219,AMBIENT_MCPS:0.0312,SPAD:14.0156,VEL_MM_S:0.0029,MEAS_RATE_HZ:12.6941,MEAS_AGE_US:4272,DT_HALL_US:492,DT_TOF_US:78777,DT_EST_US:491,DT_CTRL_US:491,IDENT_ACTIVE:1,IDENT_STATE:BUSCANDO_LIMIAR,IDENT_TYPE:PULSO,IDENT_REP:0,IDENT_REP_MAX:10,IDENT_FASE:1,LIM_PWM:-1,LIM_HALL_MV:0,LIM_ACTUAL_MM:NULL,LIM_RAW_MM:NULL,DELTA_LIM_MM:NULL,TEST_PWM:-1,TOF_BASE_MM:14.602,PULSO_HALL_PICO_MV:0,PULSO_ACTUAL_PICO_MM:NULL,DELTA_PULSO_MM:NULL,IDENT_MOTIVO:EM_ANDAMENTO,SYNC_PULSE:0,LIM_HALL_CIMA_MV:0,PULSO_HALL_CIMA_PICO_MV:0,SCALE_LOW:-5.00,SCALE_HIGH:30.00
TEST_ID:IDENT_PULSO_SUBIDA_AGR,TEST_PARAM:SIG=PUL;TB=800;BUSCA=5;TPAT=300;RMIN=5.00;MARG=40;TD=1200;TP=150;TE=1000;REP=10,T_US:1750812909,PWM:170,RAW:78.000,ACTUAL:13.822,REF:0.000,ERRO:13.822,HALL_MV:3129,HALL_FILT_MV:3129,HALL_CIMA_MV:1204,HALL_CIMA_FILT_MV:1230,TOF_VALID:1,NEW_TOF:0,RANGE_STATUS:0,SIGNAL_MCPS:22.6406,AMBIENT_MCPS:0.0234,SPAD:14.0156,VEL_MM_S:0.0113,MEAS_RATE_HZ:13.5573,MEAS_AGE_US:9276,DT_HALL_US:1995,DT_TOF_US:73761,DT_EST_US:1998,DT_CTRL_US:1997,IDENT_ACTIVE:1,IDENT_STATE:BUSCANDO_LIMIAR,IDENT_TYPE:PULSO,IDENT_REP:0,IDENT_REP_MAX:10,IDENT_FASE:1,LIM_PWM:-1,LIM_HALL_MV:0,LIM_ACTUAL_MM:NULL,LIM_RAW_MM:NULL,DELTA_LIM_MM:NULL,TEST_PWM:-1,TOF_BASE_MM:14.602,PULSO_HALL_PICO_MV:0,PULSO_ACTUAL_PICO_MM:NULL,DELTA_PULSO_MM:NULL,IDENT_MOTIVO:EM_ANDAMENTO,SYNC_PULSE:0,LIM_HALL_CIMA_MV:0,PULSO_HALL_CIMA_PICO_MV:0,SCALE_LOW:-5.00,SCALE_HIGH:30.00
TEST_ID:IDENT_PULSO_SUBIDA_AGR,TEST_PARAM:SIG=PUL;TB=800;BUSCA=5;TPAT=300;RMIN=5.00;MARG=40;TD=1200;TP=150;TE=1000;REP=10,T_US:1750822909,PWM:175,RAW:74.000,ACTUAL:14.516,REF:0.000,ERRO:14.516,HALL_MV:3129,HALL_FILT_MV:3129,HALL_CIMA_MV:1179,HALL_CIMA_FILT_MV:1205,TOF_VALID:1,NEW_TOF:0,RANGE_STATUS:0,SIGNAL_MCPS:22.5547,AMBIENT_MCPS:0.0234,SPAD:14.0156,VEL_MM_S:-0.0003,MEAS_RATE_HZ:12.6936,MEAS_AGE_US:4269,DT_HALL_US:492,DT_TOF_US:78780,DT_EST_US:487,DT_CTRL_US:489,IDENT_ACTIVE:1,IDENT_STATE:BUSCANDO_LIMIAR,IDENT_TYPE:PULSO,IDENT_REP:0,IDENT_REP_MAX:10,IDENT_FASE:1,LIM_PWM:-1,LIM_HALL_MV:0,LIM_ACTUAL_MM:NULL,LIM_RAW_MM:NULL,DELTA_LIM_MM:NULL,TEST_PWM:-1,TOF_BASE_MM:14.602,PULSO_HALL_PICO_MV:0,PULSO_ACTUAL_PICO_MM:NULL,DELTA_PULSO_MM:NULL,IDENT_MOTIVO:EM_ANDAMENTO,SYNC_PULSE:0,LIM_HALL_CIMA_MV:0,PULSO_HALL_CIMA_PICO_MV:0,SCALE_LOW:-5.00,SCALE_HIGH:30.00
TEST_ID:IDENT_PULSO_SUBIDA_AGR,TEST_PARAM:SIG=PUL;TB=800;BUSCA=5;TPAT=300;RMIN=5.00;MARG=40;TD=1200;TP=150;TE=1000;REP=10,T_US:1750965469,PWM:175,RAW:76.000,ACTUAL:14.532,REF:0.000,ERRO:14.532,HALL_MV:3129,HALL_FILT_MV:3129,HALL_CIMA_MV:1193,HALL_CIMA_FILT_MV:1192,TOF_VALID:1,NEW_TOF:0,RANGE_STATUS:0,SIGNAL_MCPS:22.7891,AMBIENT_MCPS:0.0391,SPAD:14.0156,VEL_MM_S:-0.0006,MEAS_RATE_HZ:13.5538,MEAS_AGE_US:9279,DT_HALL_US:2000,DT_TOF_US:73780,DT_EST_US:2002,DT_CTRL_US:2000,IDENT_ACTIVE:1,IDENT_STATE:BUSCANDO_LIMIAR,IDENT_TYPE:PULSO,IDENT_REP:0,IDENT_REP_MAX:10,IDENT_FASE:1,LIM_PWM:-1,LIM_HALL_MV:0,LIM_ACTUAL_MM:NULL,LIM_RAW_MM:NULL,DELTA_LIM_MM:NULL,TEST_PWM:-1,TOF_BASE_MM:14.602,PULSO_HALL_PICO_MV:0,PULSO_ACTUAL_PICO_MM:NULL,DELTA_PULSO_MM:NULL,IDENT_MOTIVO:EM_ANDAMENTO,SYNC_PULSE:0,LIM_HALL_CIMA_MV:0,PULSO_HALL_CIMA_PICO_MV:0,SCALE_LOW:-5.00,SCALE_HIGH:30.00
TEST_ID:IDENT_PULSO_SUBIDA_AGR,TEST_PARAM:SIG=PUL;TB=800;BUSCA=5;TPAT=300;RMIN=5.00;MARG=40;TD=1200;TP=150;TE=1000;REP=10,T_US:1750975469,PWM:175,RAW:76.000,ACTUAL:14.547,REF:0.000,ERRO:14.547,HALL_MV:3129,HALL_FILT_MV:3129,HALL_CIMA_MV:1179,HALL_CIMA_FILT_MV:1173,TOF_VALID:1,NEW_TOF:0,RANGE_STATUS:0,SIGNAL_MCPS:22.5469,AMBIENT_MCPS:0.0234,SPAD:14.0156,VEL_MM_S:-0.0008,MEAS_RATE_HZ:12.6942,MEAS_AGE_US:4262,DT_HALL_US:489,DT_TOF_US:78776,DT_EST_US:491,DT_CTRL_US:492,IDENT_ACTIVE:1,IDENT_STATE:BUSCANDO_LIMIAR,IDENT_TYPE:PULSO,IDENT_REP:0,IDENT_REP_MAX:10,IDENT_FASE:1,LIM_PWM:-1,LIM_HALL_MV:0,LIM_ACTUAL_MM:NULL,LIM_RAW_MM:NULL,DELTA_LIM_MM:NULL,TEST_PWM:-1,TOF_BASE_MM:14.602,PULSO_HALL_PICO_MV:0,PULSO_ACTUAL_PICO_MM:NULL,DELTA_PULSO_MM:NULL,IDENT_MOTIVO:EM_ANDAMENTO,SYNC_PULSE:0,LIM_HALL_CIMA_MV:0,PULSO_HALL_CIMA_PICO_MV:0,SCALE_LOW:-5.00,SCALE_HIGH:30.00
TEST_ID:IDENT_PULSO_SUBIDA_AGR,TEST_PARAM:SIG=PUL;TB=800;BUSCA=5;TPAT=300;RMIN=5.00;MARG=40;TD=1200;TP=150;TE=1000;REP=10,T_US:1751118026,PWM:175,RAW:76.000,ACTUAL:14.560,REF:0.000,ERRO:14.560,HALL_MV:3129,HALL_FILT_MV:3129,HALL_CIMA_MV:1166,HALL_CIMA_FILT_MV:1191,TOF_VALID:1,NEW_TOF:0,RANGE_STATUS:0,SIGNAL_MCPS:22.4375,AMBIENT_MCPS:0.0312,SPAD:14.0156,VEL_MM_S:-0.0009,MEAS_RATE_HZ:13.5542,MEAS_AGE_US:9287,DT_HALL_US:2004,DT_TOF_US:73778,DT_EST_US:2007,DT_CTRL_US:2005,IDENT_ACTIVE:1,IDENT_STATE:BUSCANDO_LIMIAR,IDENT_TYPE:PULSO,IDENT_REP:0,IDENT_REP_MAX:10,IDENT_FASE:1,LIM_PWM:-1,LIM_HALL_MV:0,LIM_ACTUAL_MM:NULL,LIM_RAW_MM:NULL,DELTA_LIM_MM:NULL,TEST_PWM:-1,TOF_BASE_MM:14.602,PULSO_HALL_PICO_MV:0,PULSO_ACTUAL_PICO_MM:NULL,DELTA_PULSO_MM:NULL,IDENT_MOTIVO:EM_ANDAMENTO,SYNC_PULSE:0,LIM_HALL_CIMA_MV:0,PULSO_HALL_CIMA_PICO_MV:0,SCALE_LOW:-5.00,SCALE_HIGH:30.00
TEST_ID:IDENT_PULSO_SUBIDA_AGR,TEST_PARAM:SIG=PUL;TB=800;BUSCA=5;TPAT=300;RMIN=5.00;MARG=40;TD=1200;TP=150;TE=1000;REP=10,T_US:1751128026,PWM:180,RAW:75.000,ACTUAL:14.577,REF:0.000,ERRO:14.577,HALL_MV:3129,HALL_FILT_MV:3129,HALL_CIMA_MV:1118,HALL_CIMA_FILT_MV:1159,TOF_VALID:1,NEW_TOF:0,RANGE_STATUS:0,SIGNAL_MCPS:22.3516,AMBIENT_MCPS:0.0234,SPAD:14.0156,VEL_MM_S:-0.0011,MEAS_RATE_HZ:200.0000,MEAS_AGE_US:2553,DT_HALL_US:2529,DT_TOF_US:5000,DT_EST_US:2547,DT_CTRL_US:622,IDENT_ACTIVE:1,IDENT_STATE:BUSCANDO_LIMIAR,IDENT_TYPE:PULSO,IDENT_REP:0,IDENT_REP_MAX:10,IDENT_FASE:1,LIM_PWM:-1,LIM_HALL_MV:0,LIM_ACTUAL_MM:NULL,LIM_RAW_MM:NULL,DELTA_LIM_MM:NULL,TEST_PWM:-1,TOF_BASE_MM:14.602,PULSO_HALL_PICO_MV:0,PULSO_ACTUAL_PICO_MM:NULL,DELTA_PULSO_MM:NULL,IDENT_MOTIVO:EM_ANDAMENTO,SYNC_PULSE:0,LIM_HALL_CIMA_MV:0,PULSO_HALL_CIMA_PICO_MV:0,SCALE_LOW:-5.00,SCALE_HIGH:30.00
TEST_ID:IDENT_PULSO_SUBIDA_AGR,TEST_PARAM:SIG=PUL;TB=800;BUSCA=5;TPAT=300;RMIN=5.00;MARG=40;TD=1200;TP=150;TE=1000;REP=10,T_US:1751272747,PWM:180,RAW:77.000,ACTUAL:14.314,REF:0.000,ERRO:14.314,HALL_MV:3129,HALL_FILT_MV:3129,HALL_CIMA_MV:1134,HALL_CIMA_FILT_MV:1156,TOF_VALID:1,NEW_TOF:0,RANGE_STATUS:0,SIGNAL_MCPS:22.9063,AMBIENT_MCPS:0.0234,SPAD:14.0156,VEL_MM_S:0.0028,MEAS_RATE_HZ:13.8608,MEAS_AGE_US:9284,DT_HALL_US:2005,DT_TOF_US:72146,DT_EST_US:2006,DT_CTRL_US:2006,IDENT_ACTIVE:1,IDENT_STATE:BUSCANDO_LIMIAR,IDENT_TYPE:PULSO,IDENT_REP:0,IDENT_REP_MAX:10,IDENT_FASE:1,LIM_PWM:-1,LIM_HALL_MV:0,LIM_ACTUAL_MM:NULL,LIM_RAW_MM:NULL,DELTA_LIM_MM:NULL,TEST_PWM:-1,TOF_BASE_MM:14.602,PULSO_HALL_PICO_MV:0,PULSO_ACTUAL_PICO_MM:NULL,DELTA_PULSO_MM:NULL,IDENT_MOTIVO:EM_ANDAMENTO,SYNC_PULSE:0,LIM_HALL_CIMA_MV:0,PULSO_HALL_CIMA_PICO_MV:0,SCALE_LOW:-5.00,SCALE_HIGH:30.00
TEST_ID:IDENT_PULSO_SUBIDA_AGR,TEST_PARAM:SIG=PUL;TB=800;BUSCA=5;TPAT=300;RMIN=5.00;MARG=40;TD=1200;TP=150;TE=1000;REP=10,T_US:1751282747,PWM:180,RAW:77.000,ACTUAL:14.080,REF:0.000,ERRO:14.080,HALL_MV:3129,HALL_FILT_MV:3129,HALL_CIMA_MV:1193,HALL_CIMA_FILT_MV:1179,TOF_VALID:1,NEW_TOF:0,RANGE_STATUS:0,SIGNAL_MCPS:22.6641,AMBIENT_MCPS:0.0391,SPAD:14.0156,VEL_MM_S:0.0058,MEAS_RATE_HZ:12.6918,MEAS_AGE_US:4263,DT_HALL_US:489,DT_TOF_US:78791,DT_EST_US:486,DT_CTRL_US:488,IDENT_ACTIVE:1,IDENT_STATE:BUSCANDO_LIMIAR,IDENT_TYPE:PULSO,IDENT_REP:0,IDENT_REP_MAX:10,IDENT_FASE:1,LIM_PWM:-1,LIM_HALL_MV:0,LIM_ACTUAL_MM:NULL,LIM_RAW_MM:NULL,DELTA_LIM_MM:NULL,TEST_PWM:-1,TOF_BASE_MM:14.602,PULSO_HALL_PICO_MV:0,PULSO_ACTUAL_PICO_MM:NULL,DELTA_PULSO_MM:NULL,IDENT_MOTIVO:EM_ANDAMENTO,SYNC_PULSE:0,LIM_HALL_CIMA_MV:0,PULSO_HALL_CIMA_PICO_MV:0,SCALE_LOW:-5.00,SCALE_HIGH:30.00
TEST_ID:IDENT_PULSO_SUBIDA_AGR,TEST_PARAM:SIG=PUL;TB=800;BUSCA=5;TPAT=300;RMIN=5.00;MARG=40;TD=1200;TP=150;TE=1000;REP=10,T_US:1751425293,PWM:180,RAW:77.000,ACTUAL:13.822,REF:0.000,ERRO:13.822,HALL_MV:3129,HALL_FILT_MV:3129,HALL_CIMA_MV:1195,HALL_CIMA_FILT_MV:1185,TOF_VALID:1,NEW_TOF:0,RANGE_STATUS:0,SIGNAL_MCPS:22.5703,AMBIENT_MCPS:0.0312,SPAD:14.0156,VEL_MM_S:0.0084,MEAS_RATE_HZ:13.5580,MEAS_AGE_US:9280,DT_HALL_US:2000,DT_TOF_US:73757,DT_EST_US:2002,DT_CTRL_US:1999,IDENT_ACTIVE:1,IDENT_STATE:BUSCANDO_LIMIAR,IDENT_TYPE:PULSO,IDENT_REP:0,IDENT_REP_MAX:10,IDENT_FASE:1,LIM_PWM:-1,LIM_HALL_MV:0,LIM_ACTUAL_MM:NULL,LIM_RAW_MM:NULL,DELTA_LIM_MM:NULL,TEST_PWM:-1,TOF_BASE_MM:14.602,PULSO_HALL_PICO_MV:0,PULSO_ACTUAL_PICO_MM:NULL,DELTA_PULSO_MM:NULL,IDENT_MOTIVO:EM_ANDAMENTO,SYNC_PULSE:0,LIM_HALL_CIMA_MV:0,PULSO_HALL_CIMA_PICO_MV:0,SCALE_LOW:-5.00,SCALE_HIGH:30.00
TEST_ID:IDENT_PULSO_SUBIDA_AGR,TEST_PARAM:SIG=PUL;TB=800;BUSCA=5;TPAT=300;RMIN=5.00;MARG=40;TD=1200;TP=150;TE=1000;REP=10,T_US:1751435293,PWM:185,RAW:79.000,ACTUAL:12.811,REF:0.000,ERRO:12.811,HALL_MV:3129,HALL_FILT_MV:3129,HALL_CIMA_MV:1124,HALL_CIMA_FILT_MV:1176,TOF_VALID:1,NEW_TOF:0,RANGE_STATUS:0,SIGNAL_MCPS:22.6484,AMBIENT_MCPS:0.0312,SPAD:14.0156,VEL_MM_S:0.0180,MEAS_RATE_HZ:12.6941,MEAS_AGE_US:4266,DT_HALL_US:488,DT_TOF_US:78777,DT_EST_US:487,DT_CTRL_US:489,IDENT_ACTIVE:1,IDENT_STATE:BUSCANDO_LIMIAR,IDENT_TYPE:PULSO,IDENT_REP:0,IDENT_REP_MAX:10,IDENT_FASE:1,LIM_PWM:-1,LIM_HALL_MV:0,LIM_ACTUAL_MM:NULL,LIM_RAW_MM:NULL,DELTA_LIM_MM:NULL,TEST_PWM:-1,TOF_BASE_MM:14.602,PULSO_HALL_PICO_MV:0,PULSO_ACTUAL_PICO_MM:NULL,DELTA_PULSO_MM:NULL,IDENT_MOTIVO:EM_ANDAMENTO,SYNC_PULSE:0,LIM_HALL_CIMA_MV:0,PULSO_HALL_CIMA_PICO_MV:0,SCALE_LOW:-5.00,SCALE_HIGH:30.00
TEST_ID:IDENT_PULSO_SUBIDA_AGR,TEST_PARAM:SIG=PUL;TB=800;BUSCA=5;TPAT=300;RMIN=5.00;MARG=40;TD=1200;TP=150;TE=1000;REP=10,T_US:1751577834,PWM:185,RAW:77.000,ACTUAL:12.765,REF:0.000,ERRO:12.765,HALL_MV:3129,HALL_FILT_MV:3129,HALL_CIMA_MV:1108,HALL_CIMA_FILT_MV:1124,TOF_VALID:1,NEW_TOF:0,RANGE_STATUS:0,SIGNAL_MCPS:22.7109,AMBIENT_MCPS:0.0234,SPAD:14.0156,VEL_MM_S:0.0170,MEAS_RATE_HZ:13.5564,MEAS_AGE_US:9274,DT_HALL_US:1996,DT_TOF_US:73766,DT_EST_US:1998,DT_CTRL_US:1996,IDENT_ACTIVE:1,IDENT_STATE:BUSCANDO_LIMIAR,IDENT_TYPE:PULSO,IDENT_REP:0,IDENT_REP_MAX:10,IDENT_FASE:1,LIM_PWM:-1,LIM_HALL_MV:0,LIM_ACTUAL_MM:NULL,LIM_RAW_MM:NULL,DELTA_LIM_MM:NULL,TEST_PWM:-1,TOF_BASE_MM:14.602,PULSO_HALL_PICO_MV:0,PULSO_ACTUAL_PICO_MM:NULL,DELTA_PULSO_MM:NULL,IDENT_MOTIVO:EM_ANDAMENTO,SYNC_PULSE:0,LIM_HALL_CIMA_MV:0,PULSO_HALL_CIMA_PICO_MV:0,SCALE_LOW:-5.00,SCALE_HIGH:30.00
TEST_ID:IDENT_PULSO_SUBIDA_AGR,TEST_PARAM:SIG=PUL;TB=800;BUSCA=5;TPAT=300;RMIN=5.00;MARG=40;TD=1200;TP=150;TE=1000;REP=10,T_US:1751587834,PWM:185,RAW:78.000,ACTUAL:12.406,REF:0.000,ERRO:12.406,HALL_MV:3129,HALL_FILT_MV:3129,HALL_CIMA_MV:1091,HALL_CIMA_FILT_MV:1139,TOF_VALID:1,NEW_TOF:0,RANGE_STATUS:0,SIGNAL_MCPS:22.7188,AMBIENT_MCPS:0.0312,SPAD:14.0156,VEL_MM_S:0.0196,MEAS_RATE_HZ:12.6931,MEAS_AGE_US:4264,DT_HALL_US:491,DT_TOF_US:78783,DT_EST_US:490,DT_CTRL_US:489,IDENT_ACTIVE:1,IDENT_STATE:BUSCANDO_LIMIAR,IDENT_TYPE:PULSO,IDENT_REP:0,IDENT_REP_MAX:10,IDENT_FASE:1,LIM_PWM:-1,LIM_HALL_MV:0,LIM_ACTUAL_MM:NULL,LIM_RAW_MM:NULL,DELTA_LIM_MM:NULL,TEST_PWM:-1,TOF_BASE_MM:14.602,PULSO_HALL_PICO_MV:0,PULSO_ACTUAL_PICO_MM:NULL,DELTA_PULSO_MM:NULL,IDENT_MOTIVO:EM_ANDAMENTO,SYNC_PULSE:0,LIM_HALL_CIMA_MV:0,PULSO_HALL_CIMA_PICO_MV:0,SCALE_LOW:-5.00,SCALE_HIGH:30.00
TEST_ID:IDENT_PULSO_SUBIDA_AGR,TEST_PARAM:SIG=PUL;TB=800;BUSCA=5;TPAT=300;RMIN=5.00;MARG=40;TD=1200;TP=150;TE=1000;REP=10,T_US:1751730374,PWM:185,RAW:75.000,ACTUAL:12.993,REF:0.000,ERRO:12.993,HALL_MV:3129,HALL_FILT_MV:3129,HALL_CIMA_MV:1191,HALL_CIMA_FILT_MV:1164,TOF_VALID:1,NEW_TOF:0,RANGE_STATUS:0,SIGNAL_MCPS:22.6016,AMBIENT_MCPS:0.0234,SPAD:14.0156,VEL_MM_S:0.0116,MEAS_RATE_HZ:13.5586,MEAS_AGE_US:9277,DT_HALL_US:2000,DT_TOF_US:73754,DT_EST_US:2002,DT_CTRL_US:1999,IDENT_ACTIVE:1,IDENT_STATE:BUSCANDO_LIMIAR,IDENT_TYPE:PULSO,IDENT_REP:0,IDENT_REP_MAX:10,IDENT_FASE:1,LIM_PWM:-1,LIM_HALL_MV:0,LIM_ACTUAL_MM:NULL,LIM_RAW_MM:NULL,DELTA_LIM_MM:NULL,TEST_PWM:-1,TOF_BASE_MM:14.602,PULSO_HALL_PICO_MV:0,PULSO_ACTUAL_PICO_MM:NULL,DELTA_PULSO_MM:NULL,IDENT_MOTIVO:EM_ANDAMENTO,SYNC_PULSE:0,LIM_HALL_CIMA_MV:0,PULSO_HALL_CIMA_PICO_MV:0,SCALE_LOW:-5.00,SCALE_HIGH:30.00
TEST_ID:IDENT_PULSO_SUBIDA_AGR,TEST_PARAM:SIG=PUL;TB=800;BUSCA=5;TPAT=300;RMIN=5.00;MARG=40;TD=1200;TP=150;TE=1000;REP=10,T_US:1751740374,PWM:190,RAW:78.000,ACTUAL:12.647,REF:0.000,ERRO:12.647,HALL_MV:3129,HALL_FILT_MV:3129,HALL_CIMA_MV:1130,HALL_CIMA_FILT_MV:1164,TOF_VALID:1,NEW_TOF:0,RANGE_STATUS:0,SIGNAL_MCPS:22.6484,AMBIENT_MCPS:0.0312,SPAD:14.0156,VEL_MM_S:0.0145,MEAS_RATE_HZ:12.6945,MEAS_AGE_US:4272,DT_HALL_US:491,DT_TOF_US:78774,DT_EST_US:490,DT_CTRL_US:490,IDENT_ACTIVE:1,IDENT_STATE:BUSCANDO_LIMIAR,IDENT_TYPE:PULSO,IDENT_REP:0,IDENT_REP_MAX:10,IDENT_FASE:1,LIM_PWM:-1,LIM_HALL_MV:0,LIM_ACTUAL_MM:NULL,LIM_RAW_MM:NULL,DELTA_LIM_MM:NULL,TEST_PWM:-1,TOF_BASE_MM:14.602,PULSO_HALL_PICO_MV:0,PULSO_ACTUAL_PICO_MM:NULL,DELTA_PULSO_MM:NULL,IDENT_MOTIVO:EM_ANDAMENTO,SYNC_PULSE:0,LIM_HALL_CIMA_MV:0,PULSO_HALL_CIMA_PICO_MV:0,SCALE_LOW:-5.00,SCALE_HIGH:30.00
TEST_ID:IDENT_PULSO_SUBIDA_AGR,TEST_PARAM:SIG=PUL;TB=800;BUSCA=5;TPAT=300;RMIN=5.00;MARG=40;TD=1200;TP=150;TE=1000;REP=10,T_US:1751882912,PWM:190,RAW:76.000,ACTUAL:12.913,REF:0.000,ERRO:12.913,HALL_MV:3129,HALL_FILT_MV:3129,HALL_CIMA_MV:1181,HALL_CIMA_FILT_MV:1154,TOF_VALID:1,NEW_TOF:0,RANGE_STATUS:0,SIGNAL_MCPS:23.0703,AMBIENT_MCPS:0.0234,SPAD:14.0156,VEL_MM_S:0.0105,MEAS_RATE_HZ:13.5573,MEAS_AGE_US:9284,DT_HALL_US:2004,DT_TOF_US:73761,DT_EST_US:2006,DT_CTRL_US:2003,IDENT_ACTIVE:1,IDENT_STATE:BUSCANDO_LIMIAR,IDENT_TYPE:PULSO,IDENT_REP:0,IDENT_REP_MAX:10,IDENT_FASE:1,LIM_PWM:-1,LIM_HALL_MV:0,LIM_ACTUAL_MM:NULL,LIM_RAW_MM:NULL,DELTA_LIM_MM:NULL,TEST_PWM:-1,TOF_BASE_MM:14.602,PULSO_HALL_PICO_MV:0,PULSO_ACTUAL_PICO_MM:NULL,DELTA_PULSO_MM:NULL,IDENT_MOTIVO:EM_ANDAMENTO,SYNC_PULSE:0,LIM_HALL_CIMA_MV:0,PULSO_HALL_CIMA_PICO_MV:0,SCALE_LOW:-5.00,SCALE_HIGH:30.00
TEST_ID:IDENT_PULSO_SUBIDA_AGR,TEST_PARAM:SIG=PUL;TB=800;BUSCA=5;TPAT=300;RMIN=5.00;MARG=40;TD=1200;TP=150;TE=1000;REP=10,T_US:1751892912,PWM:190,RAW:76.000,ACTUAL:13.145,REF:0.000,ERRO:13.145,HALL_MV:3129,HALL_FILT_MV:3129,HALL_CIMA_MV:1119,HALL_CIMA_FILT_MV:1145,TOF_VALID:1,NEW_TOF:0,RANGE_STATUS:0,SIGNAL_MCPS:22.8750,AMBIENT_MCPS:0.0234,SPAD:14.0156,VEL_MM_S:0.0074,MEAS_RATE_HZ:12.6924,MEAS_AGE_US:4261,DT_HALL_US:494,DT_TOF_US:78787,DT_EST_US:486,DT_CTRL_US:488,IDENT_ACTIVE:1,IDENT_STATE:BUSCANDO_LIMIAR,IDENT_TYPE:PULSO,IDENT_REP:0,IDENT_REP_MAX:10,IDENT_FASE:1,LIM_PWM:-1,LIM_HALL_MV:0,LIM_ACTUAL_MM:NULL,LIM_RAW_MM:NULL,DELTA_LIM_MM:NULL,TEST_PWM:-1,TOF_BASE_MM:14.602,PULSO_HALL_PICO_MV:0,PULSO_ACTUAL_PICO_MM:NULL,DELTA_PULSO_MM:NULL,IDENT_MOTIVO:EM_ANDAMENTO,SYNC_PULSE:0,LIM_HALL_CIMA_MV:0,PULSO_HALL_CIMA_PICO_MV:0,SCALE_LOW:-5.00,SCALE_HIGH:30.00
TEST_ID:IDENT_PULSO_SUBIDA_AGR,TEST_PARAM:SIG=PUL;TB=800;BUSCA=5;TPAT=300;RMIN=5.00;MARG=40;TD=1200;TP=150;TE=1000;REP=10,T_US:1752035454,PWM:190,RAW:76.000,ACTUAL:13.358,REF:0.000,ERRO:13.358,HALL_MV:3129,HALL_FILT_MV:3129,HALL_CIMA_MV:1124,HALL_CIMA_FILT_MV:1147,TOF_VALID:1,NEW_TOF:0,RANGE_STATUS:0,SIGNAL_MCPS:22.9219,AMBIENT_MCPS:0.0312,SPAD:14.0156,VEL_MM_S:0.0049,MEAS_RATE_HZ:13.5566,MEAS_AGE_US:9272,DT_HALL_US:1999,DT_TOF_US:73765,DT_EST_US:2002,DT_CTRL_US:2000,IDENT_ACTIVE:1,IDENT_STATE:BUSCANDO_LIMIAR,IDENT_TYPE:PULSO,IDENT_REP:0,IDENT_REP_MAX:10,IDENT_FASE:1,LIM_PWM:-1,LIM_HALL_MV:0,LIM_ACTUAL_MM:NULL,LIM_RAW_MM:NULL,DELTA_LIM_MM:NULL,TEST_PWM:-1,TOF_BASE_MM:14.602,PULSO_HALL_PICO_MV:0,PULSO_ACTUAL_PICO_MM:NULL,DELTA_PULSO_MM:NULL,IDENT_MOTIVO:EM_ANDAMENTO,SYNC_PULSE:0,LIM_HALL_CIMA_MV:0,PULSO_HALL_CIMA_PICO_MV:0,SCALE_LOW:-5.00,SCALE_HIGH:30.00
TEST_ID:IDENT_PULSO_SUBIDA_AGR,TEST_PARAM:SIG=PUL;TB=800;BUSCA=5;TPAT=300;RMIN=5.00;MARG=40;TD=1200;TP=150;TE=1000;REP=10,T_US:1752045454,PWM:195,RAW:77.000,ACTUAL:13.236,REF:0.000,ERRO:13.236,HALL_MV:3129,HALL_FILT_MV:3129,HALL_CIMA_MV:1089,HALL_CIMA_FILT_MV:1120,TOF_VALID:1,NEW_TOF:0,RANGE_STATUS:0,SIGNAL_MCPS:22.8672,AMBIENT_MCPS:0.0234,SPAD:14.0156,VEL_MM_S:0.0056,MEAS_RATE_HZ:12.6952,MEAS_AGE_US:4267,DT_HALL_US:488,DT_TOF_US:78770,DT_EST_US:491,DT_CTRL_US:493,IDENT_ACTIVE:1,IDENT_STATE:BUSCANDO_LIMIAR,IDENT_TYPE:PULSO,IDENT_REP:0,IDENT_REP_MAX:10,IDENT_FASE:1,LIM_PWM:-1,LIM_HALL_MV:0,LIM_ACTUAL_MM:NULL,LIM_RAW_MM:NULL,DELTA_LIM_MM:NULL,TEST_PWM:-1,TOF_BASE_MM:14.602,PULSO_HALL_PICO_MV:0,PULSO_ACTUAL_PICO_MM:NULL,DELTA_PULSO_MM:NULL,IDENT_MOTIVO:EM_ANDAMENTO,SYNC_PULSE:0,LIM_HALL_CIMA_MV:0,PULSO_HALL_CIMA_PICO_MV:0,SCALE_LOW:-5.00,SCALE_HIGH:30.00
TEST_ID:IDENT_PULSO_SUBIDA_AGR,TEST_PARAM:SIG=PUL;TB=800;BUSCA=5;TPAT=300;RMIN=5.00;MARG=40;TD=1200;TP=150;TE=1000;REP=10,T_US:1752187995,PWM:195,RAW:78.000,ACTUAL:12.823,REF:0.000,ERRO:12.823,HALL_MV:3129,HALL_FILT_MV:3129,HALL_CIMA_MV:1160,HALL_CIMA_FILT_MV:1160,TOF_VALID:1,NEW_TOF:0,RANGE_STATUS:0,SIGNAL_MCPS:22.9766,AMBIENT_MCPS:0.0234,SPAD:14.0156,VEL_MM_S:0.0089,MEAS_RATE_HZ:13.5575,MEAS_AGE_US:9285,DT_HALL_US:1996,DT_TOF_US:73760,DT_EST_US:1999,DT_CTRL_US:1997,IDENT_ACTIVE:1,IDENT_STATE:BUSCANDO_LIMIAR,IDENT_TYPE:PULSO,IDENT_REP:0,IDENT_REP_MAX:10,IDENT_FASE:1,LIM_PWM:-1,LIM_HALL_MV:0,LIM_ACTUAL_MM:NULL,LIM_RAW_MM:NULL,DELTA_LIM_MM:NULL,TEST_PWM:-1,TOF_BASE_MM:14.602,PULSO_HALL_PICO_MV:0,PULSO_ACTUAL_PICO_MM:NULL,DELTA_PULSO_MM:NULL,IDENT_MOTIVO:EM_ANDAMENTO,SYNC_PULSE:0,LIM_HALL_CIMA_MV:0,PULSO_HALL_CIMA_PICO_MV:0,SCALE_LOW:-5.00,SCALE_HIGH:30.00
TEST_ID:IDENT_PULSO_SUBIDA_AGR,TEST_PARAM:SIG=PUL;TB=800;BUSCA=5;TPAT=300;RMIN=5.00;MARG=40;TD=1200;TP=150;TE=1000;REP=10,T_US:1752197995,PWM:195,RAW:79.000,ACTUAL:12.195,REF:0.000,ERRO:12.195,HALL_MV:3129,HALL_FILT_MV:3129,HALL_CIMA_MV:1147,HALL_CIMA_FILT_MV:1153,TOF_VALID:1,NEW_TOF:0,RANGE_STATUS:0,SIGNAL_MCPS:22.3047,AMBIENT_MCPS:0.0312,SPAD:14.0156,VEL_MM_S:0.0139,MEAS_RATE_HZ:12.6923,MEAS_AGE_US:4264,DT_HALL_US:488,DT_TOF_US:78788,DT_EST_US:487,DT_CTRL_US:490,IDENT_ACTIVE:1,IDENT_STATE:BUSCANDO_LIMIAR,IDENT_TYPE:PULSO,IDENT_REP:0,IDENT_REP_MAX:10,IDENT_FASE:1,LIM_PWM:-1,LIM_HALL_MV:0,LIM_ACTUAL_MM:NULL,LIM_RAW_MM:NULL,DELTA_LIM_MM:NULL,TEST_PWM:-1,TOF_BASE_MM:14.602,PULSO_HALL_PICO_MV:0,PULSO_ACTUAL_PICO_MM:NULL,DELTA_PULSO_MM:NULL,IDENT_MOTIVO:EM_ANDAMENTO,SYNC_PULSE:0,LIM_HALL_CIMA_MV:0,PULSO_HALL_CIMA_PICO_MV:0,SCALE_LOW:-5.00,SCALE_HIGH:30.00
TEST_ID:IDENT_PULSO_SUBIDA_AGR,TEST_PARAM:SIG=PUL;TB=800;BUSCA=5;TPAT=300;RMIN=5.00;MARG=40;TD=1200;TP=150;TE=1000;REP=10,T_US:1752340529,PWM:195,RAW:76.000,ACTUAL:12.530,REF:0.000,ERRO:12.530,HALL_MV:3129,HALL_FILT_MV:3129,HALL_CIMA_MV:1123,HALL_CIMA_FILT_MV:1137,TOF_VALID:1,NEW_TOF:0,RANGE_STATUS:0,SIGNAL_MCPS:22.4453,AMBIENT_MCPS:0.0234,SPAD:14.0156,VEL_MM_S:0.0098,MEAS_RATE_HZ:13.5571,MEAS_AGE_US:9265,DT_HALL_US:2000,DT_TOF_US:73762,DT_EST_US:2002,DT_CTRL_US:2000,IDENT_ACTIVE:1,IDENT_STATE:BUSCANDO_LIMIAR,IDENT_TYPE:PULSO,IDENT_REP:0,IDENT_REP_MAX:10,IDENT_FASE:1,LIM_PWM:-1,LIM_HALL_MV:0,LIM_ACTUAL_MM:NULL,LIM_RAW_MM:NULL,DELTA_LIM_MM:NULL,TEST_PWM:-1,TOF_BASE_MM:14.602,PULSO_HALL_PICO_MV:0,PULSO_ACTUAL_PICO_MM:NULL,DELTA_PULSO_MM:NULL,IDENT_MOTIVO:EM_ANDAMENTO,SYNC_PULSE:0,LIM_HALL_CIMA_MV:0,PULSO_HALL_CIMA_PICO_MV:0,SCALE_LOW:-5.00,SCALE_HIGH:30.00
TEST_ID:IDENT_PULSO_SUBIDA_AGR,TEST_PARAM:SIG=PUL;TB=800;BUSCA=5;TPAT=300;RMIN=5.00;MARG=40;TD=1200;TP=150;TE=1000;REP=10,T_US:1752350529,PWM:200,RAW:78.000,ACTUAL:12.240,REF:0.000,ERRO:12.240,HALL_MV:3129,HALL_FILT_MV:3129,HALL_CIMA_MV:1215,HALL_CIMA_FILT_MV:1147,TOF_VALID:1,NEW_TOF:0,RANGE_STATUS:0,SIGNAL_MCPS:22.4688,AMBIENT_MCPS:0.0312,SPAD:14.0156,VEL_MM_S:0.0116,MEAS_RATE_HZ:12.6965,MEAS_AGE_US:4272,DT_HALL_US:494,DT_TOF_US:78762,DT_EST_US:492,DT_CTRL_US:489,IDENT_ACTIVE:1,IDENT_STATE:BUSCANDO_LIMIAR,IDENT_TYPE:PULSO,IDENT_REP:0,IDENT_REP_MAX:10,IDENT_FASE:1,LIM_PWM:-1,LIM_HALL_MV:0,LIM_ACTUAL_MM:NULL,LIM_RAW_MM:NULL,DELTA_LIM_MM:NULL,TEST_PWM:-1,TOF_BASE_MM:14.602,PULSO_HALL_PICO_MV:0,PULSO_ACTUAL_PICO_MM:NULL,DELTA_PULSO_MM:NULL,IDENT_MOTIVO:EM_ANDAMENTO,SYNC_PULSE:0,LIM_HALL_CIMA_MV:0,PULSO_HALL_CIMA_PICO_MV:0,SCALE_LOW:-5.00,SCALE_HIGH:30.00
TEST_ID:IDENT_PULSO_SUBIDA_AGR,TEST_PARAM:SIG=PUL;TB=800;BUSCA=5;TPAT=300;RMIN=5.00;MARG=40;TD=1200;TP=150;TE=1000;REP=10,T_US:1752493061,PWM:200,RAW:76.000,ACTUAL:12.812,REF:0.000,ERRO:12.812,HALL_MV:3129,HALL_FILT_MV:3129,HALL_CIMA_MV:1055,HALL_CIMA_FILT_MV:1114,TOF_VALID:1,NEW_TOF:1,RANGE_STATUS:0,SIGNAL_MCPS:22.7656,AMBIENT_MCPS:0.0234,SPAD:14.0156,VEL_MM_S:0.0058,MEAS_RATE_HZ:107.8283,MEAS_AGE_US:0,DT_HALL_US:1997,DT_TOF_US:9274,DT_EST_US:1998,DT_CTRL_US:4047,IDENT_ACTIVE:1,IDENT_STATE:BUSCANDO_LIMIAR,IDENT_TYPE:PULSO,IDENT_REP:0,IDENT_REP_MAX:10,IDENT_FASE:1,LIM_PWM:-1,LIM_HALL_MV:0,LIM_ACTUAL_MM:NULL,LIM_RAW_MM:NULL,DELTA_LIM_MM:NULL,TEST_PWM:-1,TOF_BASE_MM:14.602,PULSO_HALL_PICO_MV:0,PULSO_ACTUAL_PICO_MM:NULL,DELTA_PULSO_MM:NULL,IDENT_MOTIVO:EM_ANDAMENTO,SYNC_PULSE:0,LIM_HALL_CIMA_MV:0,PULSO_HALL_CIMA_PICO_MV:0,SCALE_LOW:-5.00,SCALE_HIGH:30.00
TEST_ID:IDENT_PULSO_SUBIDA_AGR,TEST_PARAM:SIG=PUL;TB=800;BUSCA=5;TPAT=300;RMIN=5.00;MARG=40;TD=1200;TP=150;TE=1000;REP=10,T_US:1752503061,PWM:200,RAW:76.000,ACTUAL:13.047,REF:0.000,ERRO:13.047,HALL_MV:3129,HALL_FILT_MV:3129,HALL_CIMA_MV:1127,HALL_CIMA_FILT_MV:1123,TOF_VALID:1,NEW_TOF:0,RANGE_STATUS:0,SIGNAL_MCPS:22.5234,AMBIENT_MCPS:0.0234,SPAD:14.0156,VEL_MM_S:0.0035,MEAS_RATE_HZ:13.9712,MEAS_AGE_US:4245,DT_HALL_US:488,DT_TOF_US:71576,DT_EST_US:486,DT_CTRL_US:492,IDENT_ACTIVE:1,IDENT_STATE:BUSCANDO_LIMIAR,IDENT_TYPE:PULSO,IDENT_REP:0,IDENT_REP_MAX:10,IDENT_FASE:1,LIM_PWM:-1,LIM_HALL_MV:0,LIM_ACTUAL_MM:NULL,LIM_RAW_MM:NULL,DELTA_LIM_MM:NULL,TEST_PWM:-1,TOF_BASE_MM:14.602,PULSO_HALL_PICO_MV:0,PULSO_ACTUAL_PICO_MM:NULL,DELTA_PULSO_MM:NULL,IDENT_MOTIVO:EM_ANDAMENTO,SYNC_PULSE:0,LIM_HALL_CIMA_MV:0,PULSO_HALL_CIMA_PICO_MV:0,SCALE_LOW:-5.00,SCALE_HIGH:30.00
TEST_ID:IDENT_PULSO_SUBIDA_AGR,TEST_PARAM:SIG=PUL;TB=800;BUSCA=5;TPAT=300;RMIN=5.00;MARG=40;TD=1200;TP=150;TE=1000;REP=10,T_US:1752647641,PWM:200,RAW:78.000,ACTUAL:12.683,REF:0.000,ERRO:12.683,HALL_MV:3129,HALL_FILT_MV:3129,HALL_CIMA_MV:1054,HALL_CIMA_FILT_MV:1099,TOF_VALID:1,NEW_TOF:0,RANGE_STATUS:0,SIGNAL_MCPS:22.5547,AMBIENT_MCPS:0.0312,SPAD:14.0156,VEL_MM_S:0.0061,MEAS_RATE_HZ:137.6084,MEAS_AGE_US:2581,DT_HALL_US:2549,DT_TOF_US:7267,DT_EST_US:2575,DT_CTRL_US:622,IDENT_ACTIVE:1,IDENT_STATE:BUSCANDO_LIMIAR,IDENT_TYPE:PULSO,IDENT_REP:0,IDENT_REP_MAX:10,IDENT_FASE:1,LIM_PWM:-1,LIM_HALL_MV:0,LIM_ACTUAL_MM:NULL,LIM_RAW_MM:NULL,DELTA_LIM_MM:NULL,TEST_PWM:-1,TOF_BASE_MM:14.602,PULSO_HALL_PICO_MV:0,PULSO_ACTUAL_PICO_MM:NULL,DELTA_PULSO_MM:NULL,IDENT_MOTIVO:EM_ANDAMENTO,SYNC_PULSE:0,LIM_HALL_CIMA_MV:0,PULSO_HALL_CIMA_PICO_MV:0,SCALE_LOW:-5.00,SCALE_HIGH:30.00
TEST_ID:IDENT_PULSO_SUBIDA_AGR,TEST_PARAM:SIG=PUL;TB=800;BUSCA=5;TPAT=300;RMIN=5.00;MARG=40;TD=1200;TP=150;TE=1000;REP=10,T_US:1752657641,PWM:205,RAW:76.000,ACTUAL:12.915,REF:0.000,ERRO:12.915,HALL_MV:3129,HALL_FILT_MV:3129,HALL_CIMA_MV:1115,HALL_CIMA_FILT_MV:1121,TOF_VALID:1,NEW_TOF:0,RANGE_STATUS:0,SIGNAL_MCPS:22.7344,AMBIENT_MCPS:0.0234,SPAD:14.0156,VEL_MM_S:0.0038,MEAS_RATE_HZ:13.8558,MEAS_AGE_US:4261,DT_HALL_US:488,DT_TOF_US:72172,DT_EST_US:486,DT_CTRL_US:488,IDENT_ACTIVE:1,IDENT_STATE:BUSCANDO_LIMIAR,IDENT_TYPE:PULSO,IDENT_REP:0,IDENT_REP_MAX:10,IDENT_FASE:1,LIM_PWM:-1,LIM_HALL_MV:0,LIM_ACTUAL_MM:NULL,LIM_RAW_MM:NULL,DELTA_LIM_MM:NULL,TEST_PWM:-1,TOF_BASE_MM:14.602,PULSO_HALL_PICO_MV:0,PULSO_ACTUAL_PICO_MM:NULL,DELTA_PULSO_MM:NULL,IDENT_MOTIVO:EM_ANDAMENTO,SYNC_PULSE:0,LIM_HALL_CIMA_MV:0,PULSO_HALL_CIMA_PICO_MV:0,SCALE_LOW:-5.00,SCALE_HIGH:30.00
TEST_ID:IDENT_PULSO_SUBIDA_AGR,TEST_PARAM:SIG=PUL;TB=800;BUSCA=5;TPAT=300;RMIN=5.00;MARG=40;TD=1200;TP=150;TE=1000;REP=10,T_US:1752802318,PWM:205,RAW:78.000,ACTUAL:13.072,REF:0.000,ERRO:13.072,HALL_MV:3129,HALL_FILT_MV:3129,HALL_CIMA_MV:1043,HALL_CIMA_FILT_MV:1092,TOF_VALID:1,NEW_TOF:0,RANGE_STATUS:0,SIGNAL_MCPS:23.0391,AMBIENT_MCPS:0.0234,SPAD:14.0156,VEL_MM_S:0.0023,MEAS_RATE_HZ:200.0000,MEAS_AGE_US:5975,DT_HALL_US:2000,DT_TOF_US:5000,DT_EST_US:2003,DT_CTRL_US:1998,IDENT_ACTIVE:1,IDENT_STATE:BUSCANDO_LIMIAR,IDENT_TYPE:PULSO,IDENT_REP:0,IDENT_REP_MAX:10,IDENT_FASE:1,LIM_PWM:-1,LIM_HALL_MV:0,LIM_ACTUAL_MM:NULL,LIM_RAW_MM:NULL,DELTA_LIM_MM:NULL,TEST_PWM:-1,TOF_BASE_MM:14.602,PULSO_HALL_PICO_MV:0,PULSO_ACTUAL_PICO_MM:NULL,DELTA_PULSO_MM:NULL,IDENT_MOTIVO:EM_ANDAMENTO,SYNC_PULSE:0,LIM_HALL_CIMA_MV:0,PULSO_HALL_CIMA_PICO_MV:0,SCALE_LOW:-5.00,SCALE_HIGH:30.00
TEST_ID:IDENT_PULSO_SUBIDA_AGR,TEST_PARAM:SIG=PUL;TB=800;BUSCA=5;TPAT=300;RMIN=5.00;MARG=40;TD=1200;TP=150;TE=1000;REP=10,T_US:1752812318,PWM:205,RAW:75.000,ACTUAL:13.486,REF:0.000,ERRO:13.486,HALL_MV:3129,HALL_FILT_MV:3129,HALL_CIMA_MV:1155,HALL_CIMA_FILT_MV:1103,TOF_VALID:1,NEW_TOF:0,RANGE_STATUS:0,SIGNAL_MCPS:22.6328,AMBIENT_MCPS:0.0234,SPAD:14.0156,VEL_MM_S:-0.0011,MEAS_RATE_HZ:13.2499,MEAS_AGE_US:4271,DT_HALL_US:488,DT_TOF_US:75472,DT_EST_US:487,DT_CTRL_US:492,IDENT_ACTIVE:1,IDENT_STATE:BUSCANDO_LIMIAR,IDENT_TYPE:PULSO,IDENT_REP:0,IDENT_REP_MAX:10,IDENT_FASE:1,LIM_PWM:-1,LIM_HALL_MV:0,LIM_ACTUAL_MM:NULL,LIM_RAW_MM:NULL,DELTA_LIM_MM:NULL,TEST_PWM:-1,TOF_BASE_MM:14.602,PULSO_HALL_PICO_MV:0,PULSO_ACTUAL_PICO_MM:NULL,DELTA_PULSO_MM:NULL,IDENT_MOTIVO:EM_ANDAMENTO,SYNC_PULSE:0,LIM_HALL_CIMA_MV:0,PULSO_HALL_CIMA_PICO_MV:0,SCALE_LOW:-5.00,SCALE_HIGH:30.00
TEST_ID:IDENT_PULSO_SUBIDA_AGR,TEST_PARAM:SIG=PUL;TB=800;BUSCA=5;TPAT=300;RMIN=5.00;MARG=40;TD=1200;TP=150;TE=1000;REP=10,T_US:1752954879,PWM:205,RAW:77.000,ACTUAL:13.379,REF:0.000,ERRO:13.379,HALL_MV:3129,HALL_FILT_MV:3129,HALL_CIMA_MV:1110,HALL_CIMA_FILT_MV:1103,TOF_VALID:1,NEW_TOF:0,RANGE_STATUS:0,SIGNAL_MCPS:22.8906,AMBIENT_MCPS:0.0312,SPAD:14.0156,VEL_MM_S:-0.0002,MEAS_RATE_HZ:13.5533,MEAS_AGE_US:9280,DT_HALL_US:1996,DT_TOF_US:73783,DT_EST_US:1998,DT_CTRL_US:1993,IDENT_ACTIVE:1,IDENT_STATE:BUSCANDO_LIMIAR,IDENT_TYPE:PULSO,IDENT_REP:0,IDENT_REP_MAX:10,IDENT_FASE:1,LIM_PWM:-1,LIM_HALL_MV:0,LIM_ACTUAL_MM:NULL,LIM_RAW_MM:NULL,DELTA_LIM_MM:NULL,TEST_PWM:-1,TOF_BASE_MM:14.602,PULSO_HALL_PICO_MV:0,PULSO_ACTUAL_PICO_MM:NULL,DELTA_PULSO_MM:NULL,IDENT_MOTIVO:EM_ANDAMENTO,SYNC_PULSE:0,LIM_HALL_CIMA_MV:0,PULSO_HALL_CIMA_PICO_MV:0,SCALE_LOW:-5.00,SCALE_HIGH:30.00
TEST_ID:IDENT_PULSO_SUBIDA_AGR,TEST_PARAM:SIG=PUL;TB=800;BUSCA=5;TPAT=300;RMIN=5.00;MARG=40;TD=1200;TP=150;TE=1000;REP=10,T_US:1752964879,PWM:210,RAW:78.000,ACTUAL:13.038,REF:0.000,ERRO:13.038,HALL_MV:3129,HALL_FILT_MV:3129,HALL_CIMA_MV:1057,HALL_CIMA_FILT_MV:1093,TOF_VALID:1,NEW_TOF:0,RANGE_STATUS:0,SIGNAL_MCPS:22.8594,AMBIENT_MCPS:0.0312,SPAD:14.0156,VEL_MM_S:0.0024,MEAS_RATE_HZ:12.6933,MEAS_AGE_US:4272,DT_HALL_US:492,DT_TOF_US:78782,DT_EST_US:487,DT_CTRL_US:492,IDENT_ACTIVE:1,IDENT_STATE:BUSCANDO_LIMIAR,IDENT_TYPE:PULSO,IDENT_REP:0,IDENT_REP_MAX:10,IDENT_FASE:1,LIM_PWM:-1,LIM_HALL_MV:0,LIM_ACTUAL_MM:NULL,LIM_RAW_MM:NULL,DELTA_LIM_MM:NULL,TEST_PWM:-1,TOF_BASE_MM:14.602,PULSO_HALL_PICO_MV:0,PULSO_ACTUAL_PICO_MM:NULL,DELTA_PULSO_MM:NULL,IDENT_MOTIVO:EM_ANDAMENTO,SYNC_PULSE:0,LIM_HALL_CIMA_MV:0,PULSO_HALL_CIMA_PICO_MV:0,SCALE_LOW:-5.00,SCALE_HIGH:30.00
TEST_ID:IDENT_PULSO_SUBIDA_AGR,TEST_PARAM:SIG=PUL;TB=800;BUSCA=5;TPAT=300;RMIN=5.00;MARG=40;TD=1200;TP=150;TE=1000;REP=10,T_US:1753107434,PWM:210,RAW:80.000,ACTUAL:12.247,REF:0.000,ERRO:12.247,HALL_MV:3129,HALL_FILT_MV:3129,HALL_CIMA_MV:1106,HALL_CIMA_FILT_MV:1110,TOF_VALID:1,NEW_TOF:0,RANGE_STATUS:0,SIGNAL_MCPS:22.6328,AMBIENT_MCPS:0.0234,SPAD:14.0156,VEL_MM_S:0.0076,MEAS_RATE_HZ:13.5536,MEAS_AGE_US:9273,DT_HALL_US:2000,DT_TOF_US:73781,DT_EST_US:2002,DT_CTRL_US:2000,IDENT_ACTIVE:1,IDENT_STATE:BUSCANDO_LIMIAR,IDENT_TYPE:PULSO,IDENT_REP:0,IDENT_REP_MAX:10,IDENT_FASE:1,LIM_PWM:-1,LIM_HALL_MV:0,LIM_ACTUAL_MM:NULL,LIM_RAW_MM:NULL,DELTA_LIM_MM:NULL,TEST_PWM:-1,TOF_BASE_MM:14.602,PULSO_HALL_PICO_MV:0,PULSO_ACTUAL_PICO_MM:NULL,DELTA_PULSO_MM:NULL,IDENT_MOTIVO:EM_ANDAMENTO,SYNC_PULSE:0,LIM_HALL_CIMA_MV:0,PULSO_HALL_CIMA_PICO_MV:0,SCALE_LOW:-5.00,SCALE_HIGH:30.00
TEST_ID:IDENT_PULSO_SUBIDA_AGR,TEST_PARAM:SIG=PUL;TB=800;BUSCA=5;TPAT=300;RMIN=5.00;MARG=40;TD=1200;TP=150;TE=1000;REP=10,T_US:1753117434,PWM:210,RAW:77.000,ACTUAL:12.280,REF:0.000,ERRO:12.280,HALL_MV:3129,HALL_FILT_MV:3129,HALL_CIMA_MV:1157,HALL_CIMA_FILT_MV:1122,TOF_VALID:1,NEW_TOF:0,RANGE_STATUS:0,SIGNAL_MCPS:22.4766,AMBIENT_MCPS:0.0234,SPAD:14.0156,VEL_MM_S:0.0068,MEAS_RATE_HZ:12.6952,MEAS_AGE_US:4268,DT_HALL_US:489,DT_TOF_US:78770,DT_EST_US:491,DT_CTRL_US:492,IDENT_ACTIVE:1,IDENT_STATE:BUSCANDO_LIMIAR,IDENT_TYPE:PULSO,IDENT_REP:0,IDENT_REP_MAX:10,IDENT_FASE:1,LIM_PWM:-1,LIM_HALL_MV:0,LIM_ACTUAL_MM:NULL,LIM_RAW_MM:NULL,DELTA_LIM_MM:NULL,TEST_PWM:-1,TOF_BASE_MM:14.602,PULSO_HALL_PICO_MV:0,PULSO_ACTUAL_PICO_MM:NULL,DELTA_PULSO_MM:NULL,IDENT_MOTIVO:EM_ANDAMENTO,SYNC_PULSE:0,LIM_HALL_CIMA_MV:0,PULSO_HALL_CIMA_PICO_MV:0,SCALE_LOW:-5.00,SCALE_HIGH:30.00
TEST_ID:IDENT_PULSO_SUBIDA_AGR,TEST_PARAM:SIG=PUL;TB=800;BUSCA=5;TPAT=300;RMIN=5.00;MARG=40;TD=1200;TP=150;TE=1000;REP=10,T_US:1753259967,PWM:210,RAW:78.000,ACTUAL:12.039,REF:0.000,ERRO:12.039,HALL_MV:3129,HALL_FILT_MV:3129,HALL_CIMA_MV:1072,HALL_CIMA_FILT_MV:1104,TOF_VALID:1,NEW_TOF:0,RANGE_STATUS:0,SIGNAL_MCPS:22.7500,AMBIENT_MCPS:0.0312,SPAD:14.0156,VEL_MM_S:0.0078,MEAS_RATE_HZ:13.5573,MEAS_AGE_US:9276,DT_HALL_US:1996,DT_TOF_US:73761,DT_EST_US:1999,DT_CTRL_US:1996,IDENT_ACTIVE:1,IDENT_STATE:BUSCANDO_LIMIAR,IDENT_TYPE:PULSO,IDENT_REP:0,IDENT_REP_MAX:10,IDENT_FASE:1,LIM_PWM:-1,LIM_HALL_MV:0,LIM_ACTUAL_MM:NULL,LIM_RAW_MM:NULL,DELTA_LIM_MM:NULL,TEST_PWM:-1,TOF_BASE_MM:14.602,PULSO_HALL_PICO_MV:0,PULSO_ACTUAL_PICO_MM:NULL,DELTA_PULSO_MM:NULL,IDENT_MOTIVO:EM_ANDAMENTO,SYNC_PULSE:0,LIM_HALL_CIMA_MV:0,PULSO_HALL_CIMA_PICO_MV:0,SCALE_LOW:-5.00,SCALE_HIGH:30.00
TEST_ID:IDENT_PULSO_SUBIDA_AGR,TEST_PARAM:SIG=PUL;TB=800;BUSCA=5;TPAT=300;RMIN=5.00;MARG=40;TD=1200;TP=150;TE=1000;REP=10,T_US:1753269967,PWM:215,RAW:79.000,ACTUAL:11.498,REF:0.000,ERRO:11.498,HALL_MV:3129,HALL_FILT_MV:3129,HALL_CIMA_MV:1091,HALL_CIMA_FILT_MV:1090,TOF_VALID:1,NEW_TOF:0,RANGE_STATUS:0,SIGNAL_MCPS:22.2500,AMBIENT_MCPS:0.0312,SPAD:14.0156,VEL_MM_S:0.0104,MEAS_RATE_HZ:12.6934,MEAS_AGE_US:4264,DT_HALL_US:491,DT_TOF_US:78781,DT_EST_US:486,DT_CTRL_US:489,IDENT_ACTIVE:1,IDENT_STATE:BUSCANDO_LIMIAR,IDENT_TYPE:PULSO,IDENT_REP:0,IDENT_REP_MAX:10,IDENT_FASE:1,LIM_PWM:-1,LIM_HALL_MV:0,LIM_ACTUAL_MM:NULL,LIM_RAW_MM:NULL,DELTA_LIM_MM:NULL,TEST_PWM:-1,TOF_BASE_MM:14.602,PULSO_HALL_PICO_MV:0,PULSO_ACTUAL_PICO_MM:NULL,DELTA_PULSO_MM:NULL,IDENT_MOTIVO:EM_ANDAMENTO,SYNC_PULSE:0,LIM_HALL_CIMA_MV:0,PULSO_HALL_CIMA_PICO_MV:0,SCALE_LOW:-5.00,SCALE_HIGH:30.00
TEST_ID:IDENT_PULSO_SUBIDA_AGR,TEST_PARAM:SIG=PUL;TB=800;BUSCA=5;TPAT=300;RMIN=5.00;MARG=40;TD=1200;TP=150;TE=1000;REP=10,T_US:1753412513,PWM:215,RAW:88.000,ACTUAL:7.310,REF:0.000,ERRO:7.310,HALL_MV:3129,HALL_FILT_MV:3129,HALL_CIMA_MV:1418,HALL_CIMA_FILT_MV:1317,TOF_VALID:1,NEW_TOF:0,RANGE_STATUS:0,SIGNAL_MCPS:21.9922,AMBIENT_MCPS:0.0391,SPAD:19.0156,VEL_MM_S:0.0211,MEAS_RATE_HZ:13.5567,MEAS_AGE_US:9278,DT_HALL_US:2000,DT_TOF_US:73764,DT_EST_US:2001,DT_CTRL_US:2000,IDENT_ACTIVE:1,IDENT_STATE:BUSCANDO_LIMIAR,IDENT_TYPE:PULSO,IDENT_REP:0,IDENT_REP_MAX:10,IDENT_FASE:1,LIM_PWM:-1,LIM_HALL_MV:0,LIM_ACTUAL_MM:NULL,LIM_RAW_MM:NULL,DELTA_LIM_MM:NULL,TEST_PWM:-1,TOF_BASE_MM:14.602,PULSO_HALL_PICO_MV:0,PULSO_ACTUAL_PICO_MM:NULL,DELTA_PULSO_MM:NULL,IDENT_MOTIVO:EM_ANDAMENTO,SYNC_PULSE:0,LIM_HALL_CIMA_MV:0,PULSO_HALL_CIMA_PICO_MV:0,SCALE_LOW:-5.00,SCALE_HIGH:30.00
TEST_ID:IDENT_PULSO_SUBIDA_AGR,TEST_PARAM:SIG=PUL;TB=800;BUSCA=5;TPAT=300;RMIN=5.00;MARG=40;TD=1200;TP=150;TE=1000;REP=10,T_US:1753422513,PWM:215,RAW:86.000,ACTUAL:1.868,REF:0.000,ERRO:1.868,HALL_MV:3129,HALL_FILT_MV:3129,HALL_CIMA_MV:1387,HALL_CIMA_FILT_MV:1369,TOF_VALID:1,NEW_TOF:0,RANGE_STATUS:0,SIGNAL_MCPS:23.1563,AMBIENT_MCPS:0.0391,SPAD:20.0156,VEL_MM_S:0.0381,MEAS_RATE_HZ:12.6941,MEAS_AGE_US:4273,DT_HALL_US:496,DT_TOF_US:78777,DT_EST_US:493,DT_CTRL_US:488,IDENT_ACTIVE:1,IDENT_STATE:BUSCANDO_LIMIAR,IDENT_TYPE:PULSO,IDENT_REP:0,IDENT_REP_MAX:10,IDENT_FASE:1,LIM_PWM:-1,LIM_HALL_MV:0,LIM_ACTUAL_MM:NULL,LIM_RAW_MM:NULL,DELTA_LIM_MM:NULL,TEST_PWM:-1,TOF_BASE_MM:14.602,PULSO_HALL_PICO_MV:0,PULSO_ACTUAL_PICO_MM:NULL,DELTA_PULSO_MM:NULL,IDENT_MOTIVO:EM_ANDAMENTO,SYNC_PULSE:0,LIM_HALL_CIMA_MV:0,PULSO_HALL_CIMA_PICO_MV:0,SCALE_LOW:-5.00,SCALE_HIGH:30.00
TEST_ID:IDENT_PULSO_SUBIDA_AGR,TEST_PARAM:SIG=PUL;TB=800;BUSCA=5;TPAT=300;RMIN=5.00;MARG=40;TD=1200;TP=150;TE=1000;REP=10,T_US:1753565029,PWM:215,RAW:88.000,ACTUAL:-3.339,REF:0.000,ERRO:-3.339,HALL_MV:3129,HALL_FILT_MV:3129,HALL_CIMA_MV:1342,HALL_CIMA_FILT_MV:1362,TOF_VALID:1,NEW_TOF:0,RANGE_STATUS:0,SIGNAL_MCPS:22.2031,AMBIENT_MCPS:0.0391,SPAD:19.0156,VEL_MM_S:0.0596,MEAS_RATE_HZ:13.5608,MEAS_AGE_US:9271,DT_HALL_US:1993,DT_TOF_US:73742,DT_EST_US:1995,DT_CTRL_US:1992,IDENT_ACTIVE:1,IDENT_STATE:BUSCANDO_LIMIAR,IDENT_TYPE:PULSO,IDENT_REP:0,IDENT_REP_MAX:10,IDENT_FASE:1,LIM_PWM:-1,LIM_HALL_MV:0,LIM_ACTUAL_MM:NULL,LIM_RAW_MM:NULL,DELTA_LIM_MM:NULL,TEST_PWM:-1,TOF_BASE_MM:14.602,PULSO_HALL_PICO_MV:0,PULSO_ACTUAL_PICO_MM:NULL,DELTA_PULSO_MM:NULL,IDENT_MOTIVO:EM_ANDAMENTO,SYNC_PULSE:0,LIM_HALL_CIMA_MV:0,PULSO_HALL_CIMA_PICO_MV:0,SCALE_LOW:-5.00,SCALE_HIGH:30.00
TEST_ID:IDENT_PULSO_SUBIDA_AGR,TEST_PARAM:SIG=PUL;TB=800;BUSCA=5;TPAT=300;RMIN=5.00;MARG=40;TD=1200;TP=150;TE=1000;REP=10,T_US:1753575029,PWM:0,RAW:88.000,ACTUAL:-6.469,REF:0.000,ERRO:-6.469,HALL_MV:3129,HALL_FILT_MV:3129,HALL_CIMA_MV:1401,HALL_CIMA_FILT_MV:1386,TOF_VALID:1,NEW_TOF:0,RANGE_STATUS:0,SIGNAL_MCPS:23.3359,AMBIENT_MCPS:0.0391,SPAD:20.0156,VEL_MM_S:0.0755,MEAS_RATE_HZ:12.6949,MEAS_AGE_US:4271,DT_HALL_US:488,DT_TOF_US:78772,DT_EST_US:486,DT_CTRL_US:493,IDENT_ACTIVE:1,IDENT_STATE:DESGRUDANDO,IDENT_TYPE:PULSO,IDENT_REP:0,IDENT_REP_MAX:10,IDENT_FASE:2,LIM_PWM:215,LIM_HALL_MV:3129,LIM_ACTUAL_MM:-6.468,LIM_RAW_MM:88.000,DELTA_LIM_MM:-21.069,TEST_PWM:255,TOF_BASE_MM:14.602,PULSO_HALL_PICO_MV:0,PULSO_ACTUAL_PICO_MM:NULL,DELTA_PULSO_MM:NULL,IDENT_MOTIVO:EM_ANDAMENTO,SYNC_PULSE:0,LIM_HALL_CIMA_MV:1374,PULSO_HALL_CIMA_PICO_MV:0,SCALE_LOW:-5.00,SCALE_HIGH:30.00
TEST_ID:IDENT_PULSO_SUBIDA_AGR,TEST_PARAM:SIG=PUL;TB=800;BUSCA=5;TPAT=300;RMIN=5.00;MARG=40;TD=1200;TP=150;TE=1000;REP=10,T_US:1753717762,PWM:0,RAW:87.000,ACTUAL:-7.352,REF:0.000,ERRO:-7.352,HALL_MV:3129,HALL_FILT_MV:3129,HALL_CIMA_MV:1690,HALL_CIMA_FILT_MV:1621,TOF_VALID:1,NEW_TOF:0,RANGE_STATUS:0,SIGNAL_MCPS:22.1797,AMBIENT_MCPS:0.0391,SPAD:19.0156,VEL_MM_S:0.0768,MEAS_RATE_HZ:13.5223,MEAS_AGE_US:9279,DT_HALL_US:1997,DT_TOF_US:73952,DT_EST_US:1999,DT_CTRL_US:1996,IDENT_ACTIVE:1,IDENT_STATE:DESGRUDANDO,IDENT_TYPE:PULSO,IDENT_REP:0,IDENT_REP_MAX:10,IDENT_FASE:2,LIM_PWM:215,LIM_HALL_MV:3129,LIM_ACTUAL_MM:-6.468,LIM_RAW_MM:88.000,DELTA_LIM_MM:-21.069,TEST_PWM:255,TOF_BASE_MM:14.602,PULSO_HALL_PICO_MV:0,PULSO_ACTUAL_PICO_MM:NULL,DELTA_PULSO_MM:NULL,IDENT_MOTIVO:EM_ANDAMENTO,SYNC_PULSE:0,LIM_HALL_CIMA_MV:1374,PULSO_HALL_CIMA_PICO_MV:0,SCALE_LOW:-5.00,SCALE_HIGH:30.00
TEST_ID:IDENT_PULSO_SUBIDA_AGR,TEST_PARAM:SIG=PUL;TB=800;BUSCA=5;TPAT=300;RMIN=5.00;MARG=40;TD=1200;TP=150;TE=1000;REP=10,T_US:1753727762,PWM:0,RAW:87.000,ACTUAL:-7.893,REF:0.000,ERRO:-7.893,HALL_MV:3129,HALL_FILT_MV:3129,HALL_CIMA_MV:1717,HALL_CIMA_FILT_MV:1675,TOF_VALID:1,NEW_TOF:0,RANGE_STATUS:0,SIGNAL_MCPS:22.2266,AMBIENT_MCPS:0.0391,SPAD:19.0156,VEL_MM_S:0.0764,MEAS_RATE_HZ:12.6653,MEAS_AGE_US:4267,DT_HALL_US:492,DT_TOF_US:78956,DT_EST_US:487,DT_CTRL_US:492,IDENT_ACTIVE:1,IDENT_STATE:DESGRUDANDO,IDENT_TYPE:PULSO,IDENT_REP:0,IDENT_REP_MAX:10,IDENT_FASE:2,LIM_PWM:215,LIM_HALL_MV:3129,LIM_ACTUAL_MM:-6.468,LIM_RAW_MM:88.000,DELTA_LIM_MM:-21.069,TEST_PWM:255,TOF_BASE_MM:14.602,PULSO_HALL_PICO_MV:0,PULSO_ACTUAL_PICO_MM:NULL,DELTA_PULSO_MM:NULL,IDENT_MOTIVO:EM_ANDAMENTO,SYNC_PULSE:0,LIM_HALL_CIMA_MV:1374,PULSO_HALL_CIMA_PICO_MV:0,SCALE_LOW:-5.00,SCALE_HIGH:30.00
TEST_ID:IDENT_PULSO_SUBIDA_AGR,TEST_PARAM:SIG=PUL;TB=800;BUSCA=5;TPAT=300;RMIN=5.00;MARG=40;TD=1200;TP=150;TE=1000;REP=10,T_US:1753870749,PWM:0,RAW:84.000,ACTUAL:-5.571,REF:0.000,ERRO:-5.571,HALL_MV:3129,HALL_FILT_MV:3129,HALL_CIMA_MV:1662,HALL_CIMA_FILT_MV:1660,TOF_VALID:1,NEW_TOF:0,RANGE_STATUS:0,SIGNAL_MCPS:24.2344,AMBIENT_MCPS:0.0312,SPAD:18.0156,VEL_MM_S:0.0432,MEAS_RATE_HZ:13.5068,MEAS_AGE_US:9278,DT_HALL_US:2004,DT_TOF_US:74037,DT_EST_US:2006,DT_CTRL_US:2005,IDENT_ACTIVE:1,IDENT_STATE:DESGRUDANDO,IDENT_TYPE:PULSO,IDENT_REP:0,IDENT_REP_MAX:10,IDENT_FASE:2,LIM_PWM:215,LIM_HALL_MV:3129,LIM_ACTUAL_MM:-6.468,LIM_RAW_MM:88.000,DELTA_LIM_MM:-21.069,TEST_PWM:255,TOF_BASE_MM:14.602,PULSO_HALL_PICO_MV:0,PULSO_ACTUAL_PICO_MM:NULL,DELTA_PULSO_MM:NULL,IDENT_MOTIVO:EM_ANDAMENTO,SYNC_PULSE:0,LIM_HALL_CIMA_MV:1374,PULSO_HALL_CIMA_PICO_MV:0,SCALE_LOW:-5.00,SCALE_HIGH:30.00
TEST_ID:IDENT_PULSO_SUBIDA_AGR,TEST_PARAM:SIG=PUL;TB=800;BUSCA=5;TPAT=300;RMIN=5.00;MARG=40;TD=1200;TP=150;TE=1000;REP=10,T_US:1753880749,PWM:0,RAW:78.000,ACTUAL:-1.157,REF:0.000,ERRO:-1.157,HALL_MV:3129,HALL_FILT_MV:3129,HALL_CIMA_MV:1680,HALL_CIMA_FILT_MV:1691,TOF_VALID:1,NEW_TOF:0,RANGE_STATUS:0,SIGNAL_MCPS:23.1328,AMBIENT_MCPS:0.0312,SPAD:15.0156,VEL_MM_S:-0.0448,MEAS_RATE_HZ:12.6648,MEAS_AGE_US:4263,DT_HALL_US:492,DT_TOF_US:78959,DT_EST_US:487,DT_CTRL_US:489,IDENT_ACTIVE:1,IDENT_STATE:DESGRUDANDO,IDENT_TYPE:PULSO,IDENT_REP:0,IDENT_REP_MAX:10,IDENT_FASE:2,LIM_PWM:215,LIM_HALL_MV:3129,LIM_ACTUAL_MM:-6.468,LIM_RAW_MM:88.000,DELTA_LIM_MM:-21.069,TEST_PWM:255,TOF_BASE_MM:14.602,PULSO_HALL_PICO_MV:0,PULSO_ACTUAL_PICO_MM:NULL,DELTA_PULSO_MM:NULL,IDENT_MOTIVO:EM_ANDAMENTO,SYNC_PULSE:0,LIM_HALL_CIMA_MV:1374,PULSO_HALL_CIMA_PICO_MV:0,SCALE_LOW:-5.00,SCALE_HIGH:30.00
TEST_ID:IDENT_PULSO_SUBIDA_AGR,TEST_PARAM:SIG=PUL;TB=800;BUSCA=5;TPAT=300;RMIN=5.00;MARG=40;TD=1200;TP=150;TE=1000;REP=10,T_US:1754023659,PWM:0,RAW:77.000,ACTUAL:4.800,REF:0.000,ERRO:4.800,HALL_MV:3129,HALL_FILT_MV:3129,HALL_CIMA_MV:1670,HALL_CIMA_FILT_MV:1699,TOF_VALID:1,NEW_TOF:0,RANGE_STATUS:0,SIGNAL_MCPS:23.4609,AMBIENT_MCPS:0.0312,SPAD:15.0156,VEL_MM_S:-0.1316,MEAS_RATE_HZ:13.5219,MEAS_AGE_US:9276,DT_HALL_US:2000,DT_TOF_US:73954,DT_EST_US:2002,DT_CTRL_US:1999,IDENT_ACTIVE:1,IDENT_STATE:DESGRUDANDO,IDENT_TYPE:PULSO,IDENT_REP:0,IDENT_REP_MAX:10,IDENT_FASE:2,LIM_PWM:215,LIM_HALL_MV:3129,LIM_ACTUAL_MM:-6.468,LIM_RAW_MM:88.000,DELTA_LIM_MM:-21.069,TEST_PWM:255,TOF_BASE_MM:14.602,PULSO_HALL_PICO_MV:0,PULSO_ACTUAL_PICO_MM:NULL,DELTA_PULSO_MM:NULL,IDENT_MOTIVO:EM_ANDAMENTO,SYNC_PULSE:0,LIM_HALL_CIMA_MV:1374,PULSO_HALL_CIMA_PICO_MV:0,SCALE_LOW:-5.00,SCALE_HIGH:30.00
TEST_ID:IDENT_PULSO_SUBIDA_AGR,TEST_PARAM:SIG=PUL;TB=800;BUSCA=5;TPAT=300;RMIN=5.00;MARG=40;TD=1200;TP=150;TE=1000;REP=10,T_US:1754033659,PWM:0,RAW:79.000,ACTUAL:6.257,REF:0.000,ERRO:6.257,HALL_MV:3129,HALL_FILT_MV:3129,HALL_CIMA_MV:1722,HALL_CIMA_FILT_MV:1693,TOF_VALID:1,NEW_TOF:0,RANGE_STATUS:0,SIGNAL_MCPS:23.3281,AMBIENT_MCPS:0.0312,SPAD:15.0156,VEL_MM_S:-0.1435,MEAS_RATE_HZ:12.6520,MEAS_AGE_US:4263,DT_HALL_US:493,DT_TOF_US:79039,DT_EST_US:486,DT_CTRL_US:488,IDENT_ACTIVE:1,IDENT_STATE:DESGRUDANDO,IDENT_TYPE:PULSO,IDENT_REP:0,IDENT_REP_MAX:10,IDENT_FASE:2,LIM_PWM:215,LIM_HALL_MV:3129,LIM_ACTUAL_MM:-6.468,LIM_RAW_MM:88.000,DELTA_LIM_MM:-21.069,TEST_PWM:255,TOF_BASE_MM:14.602,PULSO_HALL_PICO_MV:0,PULSO_ACTUAL_PICO_MM:NULL,DELTA_PULSO_MM:NULL,IDENT_MOTIVO:EM_ANDAMENTO,SYNC_PULSE:0,LIM_HALL_CIMA_MV:1374,PULSO_HALL_CIMA_PICO_MV:0,SCALE_LOW:-5.00,SCALE_HIGH:30.00
TEST_ID:IDENT_PULSO_SUBIDA_AGR,TEST_PARAM:SIG=PUL;TB=800;BUSCA=5;TPAT=300;RMIN=5.00;MARG=40;TD=1200;TP=150;TE=1000;REP=10,T_US:1754176740,PWM:0,RAW:77.000,ACTUAL:9.099,REF:0.000,ERRO:9.099,HALL_MV:3129,HALL_FILT_MV:3129,HALL_CIMA_MV:1745,HALL_CIMA_FILT_MV:1696,TOF_VALID:1,NEW_TOF:0,RANGE_STATUS:0,SIGNAL_MCPS:23.4766,AMBIENT_MCPS:0.0312,SPAD:15.0156,VEL_MM_S:-0.1728,MEAS_RATE_HZ:13.5068,MEAS_AGE_US:9277,DT_HALL_US:1996,DT_TOF_US:74037,DT_EST_US:1998,DT_CTRL_US:1996,IDENT_ACTIVE:1,IDENT_STATE:DESGRUDANDO,IDENT_TYPE:PULSO,IDENT_REP:0,IDENT_REP_MAX:10,IDENT_FASE:2,LIM_PWM:215,LIM_HALL_MV:3129,LIM_ACTUAL_MM:-6.468,LIM_RAW_MM:88.000,DELTA_LIM_MM:-21.069,TEST_PWM:255,TOF_BASE_MM:14.602,PULSO_HALL_PICO_MV:0,PULSO_ACTUAL_PICO_MM:NULL,DELTA_PULSO_MM:NULL,IDENT_MOTIVO:EM_ANDAMENTO,SYNC_PULSE:0,LIM_HALL_CIMA_MV:1374,PULSO_HALL_CIMA_PICO_MV:0,SCALE_LOW:-5.00,SCALE_HIGH:30.00
TEST_ID:IDENT_PULSO_SUBIDA_AGR,TEST_PARAM:SIG=PUL;TB=800;BUSCA=5;TPAT=300;RMIN=5.00;MARG=40;TD=1200;TP=150;TE=1000;REP=10,T_US:1754186740,PWM:0,RAW:75.000,ACTUAL:11.883,REF:0.000,ERRO:11.883,HALL_MV:3129,HALL_FILT_MV:3129,HALL_CIMA_MV:1726,HALL_CIMA_FILT_MV:1699,TOF_VALID:1,NEW_TOF:0,RANGE_STATUS:0,SIGNAL_MCPS:23.5234,AMBIENT_MCPS:0.0234,SPAD:15.0156,VEL_MM_S:-0.2015,MEAS_RATE_HZ:200.0000,MEAS_AGE_US:3630,DT_HALL_US:489,DT_TOF_US:5000,DT_EST_US:486,DT_CTRL_US:492,IDENT_ACTIVE:1,IDENT_STATE:DESGRUDANDO,IDENT_TYPE:PULSO,IDENT_REP:0,IDENT_REP_MAX:10,IDENT_FASE:2,LIM_PWM:215,LIM_HALL_MV:3129,LIM_ACTUAL_MM:-6.468,LIM_RAW_MM:88.000,DELTA_LIM_MM:-21.069,TEST_PWM:255,TOF_BASE_MM:14.602,PULSO_HALL_PICO_MV:0,PULSO_ACTUAL_PICO_MM:NULL,DELTA_PULSO_MM:NULL,IDENT_MOTIVO:EM_ANDAMENTO,SYNC_PULSE:0,LIM_HALL_CIMA_MV:1374,PULSO_HALL_CIMA_PICO_MV:0,SCALE_LOW:-5.00,SCALE_HIGH:30.00
TEST_ID:IDENT_PULSO_SUBIDA_AGR,TEST_PARAM:SIG=PUL;TB=800;BUSCA=5;TPAT=300;RMIN=5.00;MARG=40;TD=1200;TP=150;TE=1000;REP=10,T_US:1754331791,PWM:0,RAW:76.000,ACTUAL:12.962,REF:0.000,ERRO:12.962,HALL_MV:3129,HALL_FILT_MV:3129,HALL_CIMA_MV:1685,HALL_CIMA_FILT_MV:1692,TOF_VALID:1,NEW_TOF:0,RANGE_STATUS:0,SIGNAL_MCPS:22.9766,AMBIENT_MCPS:0.0391,SPAD:15.0156,VEL_MM_S:-0.2025,MEAS_RATE_HZ:13.6409,MEAS_AGE_US:9273,DT_HALL_US:1996,DT_TOF_US:73309,DT_EST_US:1998,DT_CTRL_US:1998,IDENT_ACTIVE:1,IDENT_STATE:DESGRUDANDO,IDENT_TYPE:PULSO,IDENT_REP:0,IDENT_REP_MAX:10,IDENT_FASE:2,LIM_PWM:215,LIM_HALL_MV:3129,LIM_ACTUAL_MM:-6.468,LIM_RAW_MM:88.000,DELTA_LIM_MM:-21.069,TEST_PWM:255,TOF_BASE_MM:14.602,PULSO_HALL_PICO_MV:0,PULSO_ACTUAL_PICO_MM:NULL,DELTA_PULSO_MM:NULL,IDENT_MOTIVO:EM_ANDAMENTO,SYNC_PULSE:0,LIM_HALL_CIMA_MV:1374,PULSO_HALL_CIMA_PICO_MV:0,SCALE_LOW:-5.00,SCALE_HIGH:30.00
TEST_ID:IDENT_PULSO_SUBIDA_AGR,TEST_PARAM:SIG=PUL;TB=800;BUSCA=5;TPAT=300;RMIN=5.00;MARG=40;TD=1200;TP=150;TE=1000;REP=10,T_US:1754341791,PWM:0,RAW:79.000,ACTUAL:11.322,REF:0.000,ERRO:11.322,HALL_MV:3129,HALL_FILT_MV:3129,HALL_CIMA_MV:1661,HALL_CIMA_FILT_MV:1682,TOF_VALID:1,NEW_TOF:0,RANGE_STATUS:0,SIGNAL_MCPS:23.3750,AMBIENT_MCPS:0.0312,SPAD:15.0156,VEL_MM_S:-0.1551,MEAS_RATE_HZ:12.6656,MEAS_AGE_US:4261,DT_HALL_US:492,DT_TOF_US:78954,DT_EST_US:486,DT_CTRL_US:488,IDENT_ACTIVE:1,IDENT_STATE:DESGRUDANDO,IDENT_TYPE:PULSO,IDENT_REP:0,IDENT_REP_MAX:10,IDENT_FASE:2,LIM_PWM:215,LIM_HALL_MV:3129,LIM_ACTUAL_MM:-6.468,LIM_RAW_MM:88.000,DELTA_LIM_MM:-21.069,TEST_PWM:255,TOF_BASE_MM:14.602,PULSO_HALL_PICO_MV:0,PULSO_ACTUAL_PICO_MM:NULL,DELTA_PULSO_MM:NULL,IDENT_MOTIVO:EM_ANDAMENTO,SYNC_PULSE:0,LIM_HALL_CIMA_MV:1374,PULSO_HALL_CIMA_PICO_MV:0,SCALE_LOW:-5.00,SCALE_HIGH:30.00
TEST_ID:IDENT_PULSO_SUBIDA_AGR,TEST_PARAM:SIG=PUL;TB=800;BUSCA=5;TPAT=300;RMIN=5.00;MARG=40;TD=1200;TP=150;TE=1000;REP=10,T_US:1754484719,PWM:0,RAW:77.000,ACTUAL:11.689,REF:0.000,ERRO:11.689,HALL_MV:3129,HALL_FILT_MV:3129,HALL_CIMA_MV:1582,HALL_CIMA_FILT_MV:1674,TOF_VALID:1,NEW_TOF:0,RANGE_STATUS:0,SIGNAL_MCPS:23.5313,AMBIENT_MCPS:0.0234,SPAD:15.0156,VEL_MM_S:-0.1525,MEAS_RATE_HZ:13.5195,MEAS_AGE_US:9282,DT_HALL_US:2004,DT_TOF_US:73967,DT_EST_US:2006,DT_CTRL_US:2004,IDENT_ACTIVE:1,IDENT_STATE:DESGRUDANDO,IDENT_TYPE:PULSO,IDENT_REP:0,IDENT_REP_MAX:10,IDENT_FASE:2,LIM_PWM:215,LIM_HALL_MV:3129,LIM_ACTUAL_MM:-6.468,LIM_RAW_MM:88.000,DELTA_LIM_MM:-21.069,TEST_PWM:255,TOF_BASE_MM:14.602,PULSO_HALL_PICO_MV:0,PULSO_ACTUAL_PICO_MM:NULL,DELTA_PULSO_MM:NULL,IDENT_MOTIVO:EM_ANDAMENTO,SYNC_PULSE:0,LIM_HALL_CIMA_MV:1374,PULSO_HALL_CIMA_PICO_MV:0,SCALE_LOW:-5.00,SCALE_HIGH:30.00
TEST_ID:IDENT_PULSO_SUBIDA_AGR,TEST_PARAM:SIG=PUL;TB=800;BUSCA=5;TPAT=300;RMIN=5.00;MARG=40;TD=1200;TP=150;TE=1000;REP=10,T_US:1754494719,PWM:0,RAW:76.000,ACTUAL:12.448,REF:0.000,ERRO:12.448,HALL_MV:3129,HALL_FILT_MV:3129,HALL_CIMA_MV:1760,HALL_CIMA_FILT_MV:1712,TOF_VALID:1,NEW_TOF:0,RANGE_STATUS:0,SIGNAL_MCPS:23.5078,AMBIENT_MCPS:0.0312,SPAD:15.0156,VEL_MM_S:-0.1682,MEAS_RATE_HZ:12.6648,MEAS_AGE_US:4262,DT_HALL_US:492,DT_TOF_US:78959,DT_EST_US:486,DT_CTRL_US:491,IDENT_ACTIVE:1,IDENT_STATE:DESGRUDANDO,IDENT_TYPE:PULSO,IDENT_REP:0,IDENT_REP_MAX:10,IDENT_FASE:2,LIM_PWM:215,LIM_HALL_MV:3129,LIM_ACTUAL_MM:-6.468,LIM_RAW_MM:88.000,DELTA_LIM_MM:-21.069,TEST_PWM:255,TOF_BASE_MM:14.602,PULSO_HALL_PICO_MV:0,PULSO_ACTUAL_PICO_MM:NULL,DELTA_PULSO_MM:NULL,IDENT_MOTIVO:EM_ANDAMENTO,SYNC_PULSE:0,LIM_HALL_CIMA_MV:1374,PULSO_HALL_CIMA_PICO_MV:0,SCALE_LOW:-5.00,SCALE_HIGH:30.00
TEST_ID:IDENT_PULSO_SUBIDA_AGR,TEST_PARAM:SIG=PUL;TB=800;BUSCA=5;TPAT=300;RMIN=5.00;MARG=40;TD=1200;TP=150;TE=1000;REP=10,T_US:1754637639,PWM:0,RAW:77.000,ACTUAL:12.482,REF:0.000,ERRO:12.482,HALL_MV:3129,HALL_FILT_MV:3129,HALL_CIMA_MV:1692,HALL_CIMA_FILT_MV:1705,TOF_VALID:1,NEW_TOF:0,RANGE_STATUS:0,SIGNAL_MCPS:23.2109,AMBIENT_MCPS:0.0234,SPAD:15.0156,VEL_MM_S:-0.1555,MEAS_RATE_HZ:13.5194,MEAS_AGE_US:9274,DT_HALL_US:2000,DT_TOF_US:73968,DT_EST_US:2001,DT_CTRL_US:1999,IDENT_ACTIVE:1,IDENT_STATE:DESGRUDANDO,IDENT_TYPE:PULSO,IDENT_REP:0,IDENT_REP_MAX:10,IDENT_FASE:2,LIM_PWM:215,LIM_HALL_MV:3129,LIM_ACTUAL_MM:-6.468,LIM_RAW_MM:88.000,DELTA_LIM_MM:-21.069,TEST_PWM:255,TOF_BASE_MM:14.602,PULSO_HALL_PICO_MV:0,PULSO_ACTUAL_PICO_MM:NULL,DELTA_PULSO_MM:NULL,IDENT_MOTIVO:EM_ANDAMENTO,SYNC_PULSE:0,LIM_HALL_CIMA_MV:1374,PULSO_HALL_CIMA_PICO_MV:0,SCALE_LOW:-5.00,SCALE_HIGH:30.00
TEST_ID:IDENT_PULSO_SUBIDA_AGR,TEST_PARAM:SIG=PUL;TB=800;BUSCA=5;TPAT=300;RMIN=5.00;MARG=40;TD=1200;TP=150;TE=1000;REP=10,T_US:1754647639,PWM:0,RAW:78.000,ACTUAL:12.058,REF:0.000,ERRO:12.058,HALL_MV:3129,HALL_FILT_MV:3129,HALL_CIMA_MV:1691,HALL_CIMA_FILT_MV:1682,TOF_VALID:1,NEW_TOF:0,RANGE_STATUS:0,SIGNAL_MCPS:23.3281,AMBIENT_MCPS:0.0234,SPAD:15.0156,VEL_MM_S:-0.1221,MEAS_RATE_HZ:12.6653,MEAS_AGE_US:4258,DT_HALL_US:492,DT_TOF_US:78956,DT_EST_US:491,DT_CTRL_US:488,IDENT_ACTIVE:1,IDENT_STATE:DESGRUDANDO,IDENT_TYPE:PULSO,IDENT_REP:0,IDENT_REP_MAX:10,IDENT_FASE:2,LIM_PWM:215,LIM_HALL_MV:3129,LIM_ACTUAL_MM:-6.468,LIM_RAW_MM:88.000,DELTA_LIM_MM:-21.069,TEST_PWM:255,TOF_BASE_MM:14.602,PULSO_HALL_PICO_MV:0,PULSO_ACTUAL_PICO_MM:NULL,DELTA_PULSO_MM:NULL,IDENT_MOTIVO:EM_ANDAMENTO,SYNC_PULSE:0,LIM_HALL_CIMA_MV:1374,PULSO_HALL_CIMA_PICO_MV:0,SCALE_LOW:-5.00,SCALE_HIGH:30.00
TEST_ID:IDENT_PULSO_SUBIDA_AGR,TEST_PARAM:SIG=PUL;TB=800;BUSCA=5;TPAT=300;RMIN=5.00;MARG=40;TD=1200;TP=150;TE=1000;REP=10,T_US:1754790570,PWM:0,RAW:77.000,ACTUAL:12.160,REF:0.000,ERRO:12.160,HALL_MV:3129,HALL_FILT_MV:3129,HALL_CIMA_MV:1719,HALL_CIMA_FILT_MV:1700,TOF_VALID:1,NEW_TOF:0,RANGE_STATUS:0,SIGNAL_MCPS:23.4297,AMBIENT_MCPS:0.0312,SPAD:15.0156,VEL_MM_S:-0.1171,MEAS_RATE_HZ:13.5197,MEAS_AGE_US:9286,DT_HALL_US:2004,DT_TOF_US:73966,DT_EST_US:2006,DT_CTRL_US:2005,IDENT_ACTIVE:1,IDENT_STATE:DESGRUDANDO,IDENT_TYPE:PULSO,IDENT_REP:0,IDENT_REP_MAX:10,IDENT_FASE:2,LIM_PWM:215,LIM_HALL_MV:3129,LIM_ACTUAL_MM:-6.468,LIM_RAW_MM:88.000,DELTA_LIM_MM:-21.069,TEST_PWM:255,TOF_BASE_MM:14.602,PULSO_HALL_PICO_MV:0,PULSO_ACTUAL_PICO_MM:NULL,DELTA_PULSO_MM:NULL,IDENT_MOTIVO:EM_ANDAMENTO,SYNC_PULSE:0,LIM_HALL_CIMA_MV:1374,PULSO_HALL_CIMA_PICO_MV:0,SCALE_LOW:-5.00,SCALE_HIGH:30.00
TEST_ID:IDENT_PULSO_SUBIDA_AGR,TEST_PARAM:SIG=PUL;TB=800;BUSCA=5;TPAT=300;RMIN=5.00;MARG=40;TD=1200;TP=150;TE=1000;REP=10,T_US:1754800570,PWM:255,RAW:77.000,ACTUAL:12.239,REF:0.000,ERRO:12.239,HALL_MV:3129,HALL_FILT_MV:3129,HALL_CIMA_MV:1715,HALL_CIMA_FILT_MV:1684,TOF_VALID:1,NEW_TOF:0,RANGE_STATUS:0,SIGNAL_MCPS:23.2969,AMBIENT_MCPS:0.0312,SPAD:15.0156,VEL_MM_S:-0.1122,MEAS_RATE_HZ:12.6642,MEAS_AGE_US:4278,DT_HALL_US:488,DT_TOF_US:78963,DT_EST_US:487,DT_CTRL_US:489,IDENT_ACTIVE:1,IDENT_STATE:EXECUTANDO_PULSO,IDENT_TYPE:PULSO,IDENT_REP:1,IDENT_REP_MAX:10,IDENT_FASE:3,LIM_PWM:215,LIM_HALL_MV:3129,LIM_ACTUAL_MM:-6.468,LIM_RAW_MM:88.000,DELTA_LIM_MM:-21.069,TEST_PWM:255,TOF_BASE_MM:14.602,PULSO_HALL_PICO_MV:3129,PULSO_ACTUAL_PICO_MM:12.238,DELTA_PULSO_MM:-2.364,IDENT_MOTIVO:EM_ANDAMENTO,SYNC_PULSE:0,LIM_HALL_CIMA_MV:1374,PULSO_HALL_CIMA_PICO_MV:1691,SCALE_LOW:-5.00,SCALE_HIGH:30.00
TEST_ID:IDENT_PULSO_SUBIDA_AGR,TEST_PARAM:SIG=PUL;TB=800;BUSCA=5;TPAT=300;RMIN=5.00;MARG=40;TD=1200;TP=150;TE=1000;REP=10,T_US:1754943702,PWM:255,RAW:78.000,ACTUAL:11.931,REF:0.000,ERRO:11.931,HALL_MV:3129,HALL_FILT_MV:3129,HALL_CIMA_MV:1047,HALL_CIMA_FILT_MV:1201,TOF_VALID:1,NEW_TOF:0,RANGE_STATUS:0,SIGNAL_MCPS:23.1094,AMBIENT_MCPS:0.0234,SPAD:15.0156,VEL_MM_S:-0.0844,MEAS_RATE_HZ:13.4847,MEAS_AGE_US:9292,DT_HALL_US:2000,DT_TOF_US:74158,DT_EST_US:2001,DT_CTRL_US:2000,IDENT_ACTIVE:1,IDENT_STATE:EXECUTANDO_PULSO,IDENT_TYPE:PULSO,IDENT_REP:1,IDENT_REP_MAX:10,IDENT_FASE:3,LIM_PWM:215,LIM_HALL_MV:3129,LIM_ACTUAL_MM:-6.468,LIM_RAW_MM:88.000,DELTA_LIM_MM:-21.069,TEST_PWM:255,TOF_BASE_MM:14.602,PULSO_HALL_PICO_MV:3129,PULSO_ACTUAL_PICO_MM:11.929,DELTA_PULSO_MM:-2.673,IDENT_MOTIVO:EM_ANDAMENTO,SYNC_PULSE:0,LIM_HALL_CIMA_MV:1374,PULSO_HALL_CIMA_PICO_MV:1514,SCALE_LOW:-5.00,SCALE_HIGH:30.00
TEST_ID:IDENT_PULSO_SUBIDA_AGR,TEST_PARAM:SIG=PUL;TB=800;BUSCA=5;TPAT=300;RMIN=5.00;MARG=40;TD=1200;TP=150;TE=1000;REP=10,T_US:1754953702,PWM:0,RAW:86.000,ACTUAL:8.474,REF:0.000,ERRO:8.474,HALL_MV:3129,HALL_FILT_MV:3129,HALL_CIMA_MV:1277,HALL_CIMA_FILT_MV:1273,TOF_VALID:1,NEW_TOF:0,RANGE_STATUS:0,SIGNAL_MCPS:23.1719,AMBIENT_MCPS:0.0391,SPAD:20.0156,VEL_MM_S:0.0452,MEAS_RATE_HZ:12.6298,MEAS_AGE_US:4283,DT_HALL_US:489,DT_TOF_US:79178,DT_EST_US:487,DT_CTRL_US:492,IDENT_ACTIVE:1,IDENT_STATE:RECUPERANDO,IDENT_TYPE:PULSO,IDENT_REP:1,IDENT_REP_MAX:10,IDENT_FASE:4,LIM_PWM:215,LIM_HALL_MV:3129,LIM_ACTUAL_MM:-6.468,LIM_RAW_MM:88.000,DELTA_LIM_MM:-21.069,TEST_PWM:255,TOF_BASE_MM:14.602,PULSO_HALL_PICO_MV:3129,PULSO_ACTUAL_PICO_MM:8.474,DELTA_PULSO_MM:-6.127,IDENT_MOTIVO:EM_ANDAMENTO,SYNC_PULSE:0,LIM_HALL_CIMA_MV:1374,PULSO_HALL_CIMA_PICO_MV:1273,SCALE_LOW:-5.00,SCALE_HIGH:30.00
TEST_ID:IDENT_PULSO_SUBIDA_AGR,TEST_PARAM:SIG=PUL;TB=800;BUSCA=5;TPAT=300;RMIN=5.00;MARG=40;TD=1200;TP=150;TE=1000;REP=10,T_US:1755096991,PWM:0,RAW:88.000,ACTUAL:1.824,REF:0.000,ERRO:1.824,HALL_MV:3129,HALL_FILT_MV:3129,HALL_CIMA_MV:1769,HALL_CIMA_FILT_MV:1616,TOF_VALID:1,NEW_TOF:0,RANGE_STATUS:0,SIGNAL_MCPS:22.1719,AMBIENT_MCPS:0.0391,SPAD:19.0156,VEL_MM_S:0.1592,MEAS_RATE_HZ:13.4925,MEAS_AGE_US:9296,DT_HALL_US:1999,DT_TOF_US:74115,DT_EST_US:2000,DT_CTRL_US:1998,IDENT_ACTIVE:1,IDENT_STATE:RECUPERANDO,IDENT_TYPE:PULSO,IDENT_REP:1,IDENT_REP_MAX:10,IDENT_FASE:4,LIM_PWM:215,LIM_HALL_MV:3129,LIM_ACTUAL_MM:-6.468,LIM_RAW_MM:88.000,DELTA_LIM_MM:-21.069,TEST_PWM:255,TOF_BASE_MM:14.602,PULSO_HALL_PICO_MV:3129,PULSO_ACTUAL_PICO_MM:1.824,DELTA_PULSO_MM:-12.778,IDENT_MOTIVO:EM_ANDAMENTO,SYNC_PULSE:0,LIM_HALL_CIMA_MV:1374,PULSO_HALL_CIMA_PICO_MV:1616,SCALE_LOW:-5.00,SCALE_HIGH:30.00
TEST_ID:IDENT_PULSO_SUBIDA_AGR,TEST_PARAM:SIG=PUL;TB=800;BUSCA=5;TPAT=300;RMIN=5.00;MARG=40;TD=1200;TP=150;TE=1000;REP=10,T_US:1755106991,PWM:0,RAW:86.000,ACTUAL:-1.899,REF:0.000,ERRO:-1.899,HALL_MV:3129,HALL_FILT_MV:3129,HALL_CIMA_MV:1629,HALL_CIMA_FILT_MV:1657,TOF_VALID:1,NEW_TOF:0,RANGE_STATUS:0,SIGNAL_MCPS:22.7578,AMBIENT_MCPS:0.0391,SPAD:19.0156,VEL_MM_S:0.1966,MEAS_RATE_HZ:12.6357,MEAS_AGE_US:4278,DT_HALL_US:491,DT_TOF_US:79141,DT_EST_US:488,DT_CTRL_US:492,IDENT_ACTIVE:1,IDENT_STATE:RECUPERANDO,IDENT_TYPE:PULSO,IDENT_REP:1,IDENT_REP_MAX:10,IDENT_FASE:4,LIM_PWM:215,LIM_HALL_MV:3129,LIM_ACTUAL_MM:-6.468,LIM_RAW_MM:88.000,DELTA_LIM_MM:-21.069,TEST_PWM:255,TOF_BASE_MM:14.602,PULSO_HALL_PICO_MV:3129,PULSO_ACTUAL_PICO_MM:-1.899,DELTA_PULSO_MM:-16.501,IDENT_MOTIVO:EM_ANDAMENTO,SYNC_PULSE:0,LIM_HALL_CIMA_MV:1374,PULSO_HALL_CIMA_PICO_MV:1657,SCALE_LOW:-5.00,SCALE_HIGH:30.00
TEST_ID:IDENT_PULSO_SUBIDA_AGR,TEST_PARAM:SIG=PUL;TB=800;BUSCA=5;TPAT=300;RMIN=5.00;MARG=40;TD=1200;TP=150;TE=1000;REP=10,T_US:1755250359,PWM:0,RAW:76.000,ACTUAL:6.826,REF:0.000,ERRO:6.826,HALL_MV:3129,HALL_FILT_MV:3129,HALL_CIMA_MV:1633,HALL_CIMA_FILT_MV:1669,TOF_VALID:1,NEW_TOF:1,RANGE_STATUS:0,SIGNAL_MCPS:22.5469,AMBIENT_MCPS:0.0312,SPAD:14.0156,VEL_MM_S:0.0696,MEAS_RATE_HZ:107.6195,MEAS_AGE_US:0,DT_HALL_US:2000,DT_TOF_US:9292,DT_EST_US:2002,DT_CTRL_US:4050,IDENT_ACTIVE:1,IDENT_STATE:RECUPERANDO,IDENT_TYPE:PULSO,IDENT_REP:1,IDENT_REP_MAX:10,IDENT_FASE:4,LIM_PWM:215,LIM_HALL_MV:3129,LIM_ACTUAL_MM:-6.468,LIM_RAW_MM:88.000,DELTA_LIM_MM:-21.069,TEST_PWM:255,TOF_BASE_MM:14.602,PULSO_HALL_PICO_MV:3129,PULSO_ACTUAL_PICO_MM:-1.899,DELTA_PULSO_MM:-16.501,IDENT_MOTIVO:EM_ANDAMENTO,SYNC_PULSE:0,LIM_HALL_CIMA_MV:1374,PULSO_HALL_CIMA_PICO_MV:1657,SCALE_LOW:-5.00,SCALE_HIGH:30.00
TEST_ID:IDENT_PULSO_SUBIDA_AGR,TEST_PARAM:SIG=PUL;TB=800;BUSCA=5;TPAT=300;RMIN=5.00;MARG=40;TD=1200;TP=150;TE=1000;REP=10,T_US:1755260359,PWM:0,RAW:74.000,ACTUAL:9.602,REF:0.000,ERRO:9.602,HALL_MV:3129,HALL_FILT_MV:3129,HALL_CIMA_MV:1678,HALL_CIMA_FILT_MV:1680,TOF_VALID:1,NEW_TOF:0,RANGE_STATUS:0,SIGNAL_MCPS:23.8828,AMBIENT_MCPS:0.0234,SPAD:15.0156,VEL_MM_S:0.0071,MEAS_RATE_HZ:13.9016,MEAS_AGE_US:4247,DT_HALL_US:489,DT_TOF_US:71934,DT_EST_US:486,DT_CTRL_US:488,IDENT_ACTIVE:1,IDENT_STATE:RECUPERANDO,IDENT_TYPE:PULSO,IDENT_REP:1,IDENT_REP_MAX:10,IDENT_FASE:4,LIM_PWM:215,LIM_HALL_MV:3129,LIM_ACTUAL_MM:-6.468,LIM_RAW_MM:88.000,DELTA_LIM_MM:-21.069,TEST_PWM:255,TOF_BASE_MM:14.602,PULSO_HALL_PICO_MV:3129,PULSO_ACTUAL_PICO_MM:-1.899,DELTA_PULSO_MM:-16.501,IDENT_MOTIVO:EM_ANDAMENTO,SYNC_PULSE:0,LIM_HALL_CIMA_MV:1374,PULSO_HALL_CIMA_PICO_MV:1657,SCALE_LOW:-5.00,SCALE_HIGH:30.00
TEST_ID:IDENT_PULSO_SUBIDA_AGR,TEST_PARAM:SIG=PUL;TB=800;BUSCA=5;TPAT=300;RMIN=5.00;MARG=40;TD=1200;TP=150;TE=1000;REP=10,T_US:1755405789,PWM:0,RAW:73.000,ACTUAL:13.201,REF:0.000,ERRO:13.201,HALL_MV:3129,HALL_FILT_MV:3129,HALL_CIMA_MV:1713,HALL_CIMA_FILT_MV:1682,TOF_VALID:1,NEW_TOF:0,RANGE_STATUS:0,SIGNAL_MCPS:23.8047,AMBIENT_MCPS:0.0234,SPAD:15.0156,VEL_MM_S:-0.0566,MEAS_RATE_HZ:189.4298,MEAS_AGE_US:4004,DT_HALL_US:1439,DT_TOF_US:5279,DT_EST_US:1417,DT_CTRL_US:1323,IDENT_ACTIVE:1,IDENT_STATE:RECUPERANDO,IDENT_TYPE:PULSO,IDENT_REP:1,IDENT_REP_MAX:10,IDENT_FASE:4,LIM_PWM:215,LIM_HALL_MV:3129,LIM_ACTUAL_MM:-6.468,LIM_RAW_MM:88.000,DELTA_LIM_MM:-21.069,TEST_PWM:255,TOF_BASE_MM:14.602,PULSO_HALL_PICO_MV:3129,PULSO_ACTUAL_PICO_MM:-1.899,DELTA_PULSO_MM:-16.501,IDENT_MOTIVO:EM_ANDAMENTO,SYNC_PULSE:0,LIM_HALL_CIMA_MV:1374,PULSO_HALL_CIMA_PICO_MV:1657,SCALE_LOW:-5.00,SCALE_HIGH:30.00
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
