GabrielPaschoalin/PFC/maglev/Bckp/TESTES HALL/IDENT_1606.csv

T_FASE:0 | LIM_PWM:-1 | LIM_HALL_MV:0 | LIM_ACTUAL_MM:NULL | LIM_RAW_MM:NULL | DELTA_LIM_MM:NULL | TEST_PWM:200 | TOF_BASE_MM:NULL | PULSO_HALL_PICO_MV:0 | PULSO_ACTUAL_PICO_MM:NULL | DELTA_PULSO_MM:NULL | IDENT_MOTIVO:NULL | SYNC_PULSE:0 | LIM_HALL_CIMA_MV:0 | PULSO_HALL_CIMA_PICO_MV:0 | PULSO_PWM:200 | PULSO_T_MS:30 | PULSO_ENTRE_MS:1000 | PULSO_PRE_MS:0 | HALL_BASE_MV:0 | HALL_DELTA_PICO_MV:0 | HALL_CIMA_BASE_MV:0 | HALL_CIMA_DELTA_PICO_MV:0 | SCALE_LOW:-5.00 | SCALE_HIGH:30.00
TEST_ID:IDENT_PULSO_FIXO | TEST_PARAM:SIG=PUL_FIXO;PWM=200;TP=30;TE=1000;REP=10;PRE=0;TOF=IGNORADO | T_US:1223308870 | HALL_INF_MV:1574 | HALL_INF_FILT_MV:1593 | HALL_SUP_MV:1740 | HALL_SUP_FILT_MV:1703 | PWM:0 | RAW:0.000 | ACTUAL:11.558 | REF:0.000 | ERRO:11.558 | TOF_VALID:0 | NEW_TOF:0 | RANGE_STATUS:3 | SIGNAL_MCPS:0.0000 | AMBIENT_MCPS:0.0000 | SPAD:64.0000 | VEL_MM_S:-0.0000 | MEAS_RATE_HZ:11.8167 | MEAS_AGE_US:169627968 | DT_HALL_US:5216 | DT_TOF_US:84626 | DT_EST_US:5221 | DT_CTRL_US:5227 | IDENT_ACTIVE:0 | IDENT_STATE:PARADO | IDENT_TYPE:PULSO_FIXO | IDENT_REP:0 | IDENT_REP_MAX:10 | IDENT_FASE:0 | LIM_PWM:-1 | LIM_HALL_MV:0 | LIM_ACTUAL_MM:NULL | LIM_RAW_MM:NULL | DELTA_LIM_MM:NULL | TEST_PWM:200 | TOF_BASE_MM:NULL | PULSO_HALL_PICO_MV:0 | PULSO_ACTUAL_PICO_MM:NULL | DELTA_PULSO_MM:NULL | IDENT_MOTIVO:NULL | SYNC_PULSE:0 | LIM_HALL_CIMA_MV:0 | PULSO_HALL_CIMA_PICO_MV:0 | PULSO_PWM:200 | PULSO_T_MS:30 | PULSO_ENTRE_MS:1000 | PULSO_PRE_MS:0 | HALL_BASE_MV:0 | HALL_DELTA_PICO_MV:0 | HALL_CIMA_BASE_MV:0 | HALL_CIMA_DELTA_PICO_MV:0 | SCALE_LOW:-5.00 | SCALE_HIGH:30.00
TEST_ID:IDENT_PULSO_FIXO | TEST_PARAM:SIG=PUL_FIXO;PWM=200;TP=30;TE=1000;REP=10;PRE=0;TOF=IGNORADO | T_US:1223318870 | HALL_INF_MV:1613 | HALL_INF_FILT_MV:1609 | HALL_SUP_MV:1773 | HALL_SUP_FILT_MV:1722 | PWM:0 | RAW:0.000 | ACTUAL:11.558 | REF:0.000 | ERRO:11.558 | TOF_VALID:0 | NEW_TOF:0 | RANGE_STATUS:3 | SIGNAL_MCPS:0.0000 | AMBIENT_MCPS:0.0000 | SPAD:64.0000 | VEL_MM_S:-0.0000 | MEAS_RATE_HZ:11.8167 | MEAS_AGE_US:169724448 | DT_HALL_US:3213 | DT_TOF_US:84626 | DT_EST_US:3214 | DT_CTRL_US:3217 | IDENT_ACTIVE:0 | IDENT_STATE:PARADO | IDENT_TYPE:PULSO_FIXO | IDENT_REP:0 | IDENT_REP_MAX:10 | IDENT_FASE:0 | LIM_PWM:-1 | LIM_HALL_MV:0 | LIM_ACTUAL_MM:NULL | LIM_RAW_MM:NULL | DELTA_LIM_MM:NULL | TEST_PWM:200 | TOF_BASE_MM:NULL | PULSO_HALL_PICO_MV:0 | PULSO_ACTUAL_PICO_MM:NULL | DELTA_PULSO_MM:NULL | IDENT_MOTIVO:NULL | SYNC_PULSE:0 | LIM_HALL_CIMA_MV:0 | PULSO_HALL_CIMA_PICO_MV:0 | PULSO_PWM:200 | PULSO_T_MS:30 | PULSO_ENTRE_MS:1000 | PULSO_PRE_MS:0 | HALL_BASE_MV:0 | HALL_DELTA_PICO_MV:0 | HALL_CIMA_BASE_MV:0 | HALL_CIMA_DELTA_PICO_MV:0 | SCALE_LOW:-5.00 | SCALE_HIGH:30.00
TEST_ID:IDENT_PULSO_FIXO | TEST_PARAM:SIG=PUL_FIXO;PWM=200;TP=30;TE=1000;REP=10;PRE=0;TOF=IGNORADO | T_US:1223501373 | HALL_INF_MV:1589 | HALL_INF_FILT_MV:1592 | HALL_SUP_MV:1573 | HALL_SUP_FILT_MV:1678 | PWM:0 | RAW:0.000 | ACTUAL:11.558 | REF:0.000 | ERRO:11.558 | TOF_VALID:0 | NEW_TOF:0 | RANGE_STATUS:3 | SIGNAL_MCPS:0.0000 | AMBIENT_MCPS:0.0000 | SPAD:64.0000 | VEL_MM_S:-0.0000 | MEAS_RATE_HZ:11.8167 | MEAS_AGE_US:169822912 | DT_HALL_US:3214 | DT_TOF_US:84626 | DT_EST_US:3215 | DT_CTRL_US:3213 | IDENT_ACTIVE:0 | IDENT_STATE:PARADO | IDENT_TYPE:PULSO_FIXO | IDENT_REP:0 | IDENT_REP_MAX:10 | IDENT_FASE:0 | LIM_PWM:-1 | LIM_HALL_MV:0 | LIM_ACTUAL_MM:NULL | LIM_RAW_MM:NULL | DELTA_LIM_MM:NULL | TEST_PWM:200 | TOF_BASE_MM:NULL | PULSO_HALL_PICO_MV:0 | PULSO_ACTUAL_PICO_MM:NULL | DELTA_PULSO_MM:NULL | IDENT_MOTIVO:NULL | SYNC_PULSE:0 | LIM_HALL_CIMA_MV:0 | PULSO_HALL_CIMA_PICO_MV:0 | PULSO_PWM:200 | PULSO_T_MS:30 | PULSO_ENTRE_MS:1000 | PULSO_PRE_MS:0 | HALL_BASE_MV:0 | HALL_DELTA_PICO_MV:0 | HALL_CIMA_BASE_MV:0 | HALL_CIMA_DELTA_PICO_MV:0 | SCALE_LOW:-5.00 | SCALE_HIGH:30.00
TEST_ID:IDENT_PULSO_FIXO | TEST_PARAM:SIG=PUL_FIXO;PWM=200;TP=30;TE=1000;REP=10;PRE=0;TOF=IGNORADO | T_US:1223511373 | HALL_INF_MV:1587 | HALL_INF_FILT_MV:1574 | HALL_SUP_MV:1747 | HALL_SUP_FILT_MV:1713 | PWM:0 | RAW:0.000 | ACTUAL:11.558 | REF:0.000 | ERRO:11.558 | TOF_VALID:0 | NEW_TOF:0 | RANGE_STATUS:3 | SIGNAL_MCPS:0.0000 | AMBIENT_MCPS:0.0000 | SPAD:64.0000 | VEL_MM_S:-0.0000 | MEAS_RATE_HZ:11.8167 | MEAS_AGE_US:169919376 | DT_HALL_US:3220 | DT_TOF_US:84626 | DT_EST_US:3219 | DT_CTRL_US:3216 | IDENT_ACTIVE:0 | IDENT_STATE:PARADO | IDENT_TYPE:PULSO_FIXO | IDENT_REP:0 | IDENT_REP_MAX:10 | IDENT_FASE:0 | LIM_PWM:-1 | LIM_HALL_MV:0 | LIM_ACTUAL_MM:NULL | LIM_RAW_MM:NULL | DELTA_LIM_MM:NULL | TEST_PWM:200 | TOF_BASE_MM:NULL | PULSO_HALL_PICO_MV:0 | PULSO_ACTUAL_PICO_MM:NULL | DELTA_PULSO_MM:NULL | IDENT_MOTIVO:NULL | SYNC_PULSE:0 | LIM_HALL_CIMA_MV:0 | PULSO_HALL_CIMA_PICO_MV:0 | PULSO_PWM:200 | PULSO_T_MS:30 | PULSO_ENTRE_MS:1000 | PULSO_PRE_MS:0 | HALL_BASE_MV:0 | HALL_DELTA_PICO_MV:0 | HALL_CIMA_BASE_MV:0 | HALL_CIMA_DELTA_PICO_MV:0 | SCALE_LOW:-5.00 | SCALE_HIGH:30.00
TEST_ID:IDENT_PULSO_FIXO | TEST_PARAM:SIG=PUL_FIXO;PWM=200;TP=30;TE=1000;REP=10;PRE=0;TOF=IGNORADO | T_US:1223693737 | HALL_INF_MV:1614 | HALL_INF_FILT_MV:1580 | HALL_SUP_MV:1794 | HALL_SUP_FILT_MV:1710 | PWM:0 | RAW:0.000 | ACTUAL:11.558 | REF:0.000 | ERRO:11.558 | TOF_VALID:0 | NEW_TOF:0 | RANGE_STATUS:3 | SIGNAL_MCPS:0.0000 | AMBIENT_MCPS:0.0000 | SPAD:64.0000 | VEL_MM_S:-0.0000 | MEAS_RATE_HZ:11.8167 | MEAS_AGE_US:170017840 | DT_HALL_US:3214 | DT_TOF_US:84626 | DT_EST_US:3214 | DT_CTRL_US:3216 | IDENT_ACTIVE:0 | IDENT_STATE:PARADO | IDENT_TYPE:PULSO_FIXO | IDENT_REP:0 | IDENT_REP_MAX:10 | IDENT_FASE:0 | LIM_PWM:-1 | LIM_HALL_MV:0 | LIM_ACTUAL_MM:NULL | LIM_RAW_MM:NULL | DELTA_LIM_MM:NULL | TEST_PWM:200 | TOF_BASE_MM:NULL | PULSO_HALL_PICO_MV:0 | PULSO_ACTUAL_PICO_MM:NULL | DELTA_PULSO_MM:NULL | IDENT_MOTIVO:NULL | SYNC_PULSE:0 | LIM_HALL_CIMA_MV:0 | PULSO_HALL_CIMA_PICO_MV:0 | PULSO_PWM:200 | PULSO_T_MS:30 | PULSO_ENTRE_MS:1000 | PULSO_PRE_MS:0 | HALL_BASE_MV:0 | HALL_DELTA_PICO_MV:0 | HALL_CIMA_BASE_MV:0 | HALL_CIMA_DELTA_PICO_MV:0 | SCALE_LOW:-5.00 | SCALE_HIGH:30.00
TEST_ID:IDENT_PULSO_FIXO | TEST_PARAM:SIG=PUL_FIXO;PWM=200;TP=30;TE=1000;REP=10;PRE=0;TOF=IGNORADO | T_US:1223795986 | HALL_INF_MV:1609 | HALL_INF_FILT_MV:1594 | HALL_SUP_MV:1641 | HALL_SUP_FILT_MV:1696 | PWM:0 | RAW:0.000 | ACTUAL:11.558 | REF:0.000 | ERRO:11.558 | TOF_VALID:0 | NEW_TOF:0 | RANGE_STATUS:3 | SIGNAL_MCPS:0.0000 | AMBIENT_MCPS:0.0000 | SPAD:64.0000 | VEL_MM_S:-0.0000 | MEAS_RATE_HZ:11.8167 | MEAS_AGE_US:170116304 | DT_HALL_US:3222 | DT_TOF_US:84626 | DT_EST_US:3218 | DT_CTRL_US:3218 | IDENT_ACTIVE:0 | IDENT_STATE:PARADO | IDENT_TYPE:PULSO_FIXO | IDENT_REP:0 | IDENT_REP_MAX:10 | IDENT_FASE:0 | LIM_PWM:-1 | LIM_HALL_MV:0 | LIM_ACTUAL_MM:NULL | LIM_RAW_MM:NULL | DELTA_LIM_MM:NULL | TEST_PWM:200 | TOF_BASE_MM:NULL | PULSO_HALL_PICO_MV:0 | PULSO_ACTUAL_PICO_MM:NULL | DELTA_PULSO_MM:NULL | IDENT_MOTIVO:NULL | SYNC_PULSE:0 | LIM_HALL_CIMA_MV:0 | PULSO_HALL_CIMA_PICO_MV:0 | PULSO_PWM:200 | PULSO_T_MS:30 | PULSO_ENTRE_MS:1000 | PULSO_PRE_MS:0 | HALL_BASE_MV:0 | HALL_DELTA_PICO_MV:0 | HALL_CIMA_BASE_MV:0 | HALL_CIMA_DELTA_PICO_MV:0 | SCALE_LOW:-5.00 | SCALE_HIGH:30.00
TEST_ID:IDENT_PULSO_FIXO | TEST_PARAM:SIG=PUL_FIXO;PWM=200;TP=30;TE=1000;REP=10;PRE=0;TOF=IGNORADO | T_US:1223805986 | HALL_INF_MV:1578 | HALL_INF_FILT_MV:1607 | HALL_SUP_MV:1685 | HALL_SUP_FILT_MV:1685 | PWM:0 | RAW:0.000 | ACTUAL:11.558 | REF:0.000 | ERRO:11.558 | TOF_VALID:0 | NEW_TOF:0 | RANGE_STATUS:3 | SIGNAL_MCPS:0.0000 | AMBIENT_MCPS:0.0000 | SPAD:64.0000 | VEL_MM_S:-0.0000 | MEAS_RATE_HZ:11.8167 | MEAS_AGE_US:170212768 | DT_HALL_US:3210 | DT_TOF_US:84626 | DT_EST_US:3211 | DT_CTRL_US:3211 | IDENT_ACTIVE:0 | IDENT_STATE:PARADO | IDENT_TYPE:PULSO_FIXO | IDENT_REP:0 | IDENT_REP_MAX:10 | IDENT_FASE:0 | LIM_PWM:-1 | LIM_HALL_MV:0 | LIM_ACTUAL_MM:NULL | LIM_RAW_MM:NULL | DELTA_LIM_MM:NULL | TEST_PWM:200 | TOF_BASE_MM:NULL | PULSO_HALL_PICO_MV:0 | PULSO_ACTUAL_PICO_MM:NULL | DELTA_PULSO_MM:NULL | IDENT_MOTIVO:NULL | SYNC_PULSE:0 | LIM_HALL_CIMA_MV:0 | PULSO_HALL_CIMA_PICO_MV:0 | PULSO_PWM:200 | PULSO_T_MS:30 | PULSO_ENTRE_MS:1000 | PULSO_PRE_MS:0 | HALL_BASE_MV:0 | HALL_DELTA_PICO_MV:0 | HALL_CIMA_BASE_MV:0 | HALL_CIMA_DELTA_PICO_MV:0 | SCALE_LOW:-5.00 | SCALE_HIGH:30.00
TEST_ID:IDENT_PULSO_FIXO | TEST_PARAM:SIG=PUL_FIXO;PWM=200;TP=30;TE=1000;REP=10;PRE=0;TOF=IGNORADO | T_US:1223988465 | HALL_INF_MV:1620 | HALL_INF_FILT_MV:1600 | HALL_SUP_MV:1721 | HALL_SUP_FILT_MV:1708 | PWM:0 | RAW:0.000 | ACTUAL:11.558 | REF:0.000 | ERRO:11.558 | TOF_VALID:0 | NEW_TOF:0 | RANGE_STATUS:3 | SIGNAL_MCPS:0.0000 | AMBIENT_MCPS:0.0000 | SPAD:64.0000 | VEL_MM_S:-0.0000 | MEAS_RATE_HZ:11.8167 | MEAS_AGE_US:170311232 | DT_HALL_US:3214 | DT_TOF_US:84626 | DT_EST_US:3214 | DT_CTRL_US:3212 | IDENT_ACTIVE:0 | IDENT_STATE:PARADO | IDENT_TYPE:PULSO_FIXO | IDENT_REP:0 | IDENT_REP_MAX:10 | IDENT_FASE:0 | LIM_PWM:-1 | LIM_HALL_MV:0 | LIM_ACTUAL_MM:NULL | LIM_RAW_MM:NULL | DELTA_LIM_MM:NULL | TEST_PWM:200 | TOF_BASE_MM:NULL | PULSO_HALL_PICO_MV:0 | PULSO_ACTUAL_PICO_MM:NULL | DELTA_PULSO_MM:NULL | IDENT_MOTIVO:NULL | SYNC_PULSE:0 | LIM_HALL_CIMA_MV:0 | PULSO_HALL_CIMA_PICO_MV:0 | PULSO_PWM:200 | PULSO_T_MS:30 | PULSO_ENTRE_MS:1000 | PULSO_PRE_MS:0 | HALL_BASE_MV:0 | HALL_DELTA_PICO_MV:0 | HALL_CIMA_BASE_MV:0 | HALL_CIMA_DELTA_PICO_MV:0 | SCALE_LOW:-5.00 | SCALE_HIGH:30.00
TEST_ID:IDENT_PULSO_FIXO | TEST_PARAM:SIG=PUL_FIXO;PWM=200;TP=30;TE=1000;REP=10;PRE=0;TOF=IGNORADO | T_US:1224090588 | HALL_INF_MV:1629 | HALL_INF_FILT_MV:1598 | HALL_SUP_MV:1645 | HALL_SUP_FILT_MV:1677 | PWM:0 | RAW:0.000 | ACTUAL:11.558 | REF:0.000 | ERRO:11.558 | TOF_VALID:0 | NEW_TOF:0 | RANGE_STATUS:3 | SIGNAL_MCPS:0.0000 | AMBIENT_MCPS:0.0000 | SPAD:64.0000 | VEL_MM_S:-0.0000 | MEAS_RATE_HZ:11.8167 | MEAS_AGE_US:170409696 | DT_HALL_US:5221 | DT_TOF_US:84626 | DT_EST_US:5225 | DT_CTRL_US:5230 | IDENT_ACTIVE:0 | IDENT_STATE:PARADO | IDENT_TYPE:PULSO_FIXO | IDENT_REP:0 | IDENT_REP_MAX:10 | IDENT_FASE:0 | LIM_PWM:-1 | LIM_HALL_MV:0 | LIM_ACTUAL_MM:NULL | LIM_RAW_MM:NULL | DELTA_LIM_MM:NULL | TEST_PWM:200 | TOF_BASE_MM:NULL | PULSO_HALL_PICO_MV:0 | PULSO_ACTUAL_PICO_MM:NULL | DELTA_PULSO_MM:NULL | IDENT_MOTIVO:NULL | SYNC_PULSE:0 | LIM_HALL_CIMA_MV:0 | PULSO_HALL_CIMA_PICO_MV:0 | PULSO_PWM:200 | PULSO_T_MS:30 | PULSO_ENTRE_MS:1000 | PULSO_PRE_MS:0 | HALL_BASE_MV:0 | HALL_DELTA_PICO_MV:0 | HALL_CIMA_BASE_MV:0 | HALL_CIMA_DELTA_PICO_MV:0 | SCALE_LOW:-5.00 | SCALE_HIGH:30.00
TEST_ID:IDENT_PULSO_FIXO | TEST_PARAM:SIG=PUL_FIXO;PWM=200;TP=30;TE=1000;REP=10;PRE=0;TOF=IGNORADO | T_US:1224100588 | HALL_INF_MV:1666 | HALL_INF_FILT_MV:1597 | HALL_SUP_MV:1641 | HALL_SUP_FILT_MV:1686 | PWM:0 | RAW:0.000 | ACTUAL:11.558 | REF:0.000 | ERRO:11.558 | TOF_VALID:0 | NEW_TOF:0 | RANGE_STATUS:3 | SIGNAL_MCPS:0.0000 | AMBIENT_MCPS:0.0000 | SPAD:64.0000 | VEL_MM_S:-0.0000 | MEAS_RATE_HZ:11.8167 | MEAS_AGE_US:170506144 | DT_HALL_US:3210 | DT_TOF_US:84626 | DT_EST_US:3209 | DT_CTRL_US:3219 | IDENT_ACTIVE:0 | IDENT_STATE:PARADO | IDENT_TYPE:PULSO_FIXO | IDENT_REP:0 | IDENT_REP_MAX:10 | IDENT_FASE:0 | LIM_PWM:-1 | LIM_HALL_MV:0 | LIM_ACTUAL_MM:NULL | LIM_RAW_MM:NULL | DELTA_LIM_MM:NULL | TEST_PWM:200 | TOF_BASE_MM:NULL | PULSO_HALL_PICO_MV:0 | PULSO_ACTUAL_PICO_MM:NULL | DELTA_PULSO_MM:NULL | IDENT_MOTIVO:NULL | SYNC_PULSE:0 | LIM_HALL_CIMA_MV:0 | PULSO_HALL_CIMA_PICO_MV:0 | PULSO_PWM:200 | PULSO_T_MS:30 | PULSO_ENTRE_MS:1000 | PULSO_PRE_MS:0 | HALL_BASE_MV:0 | HALL_DELTA_PICO_MV:0 | HALL_CIMA_BASE_MV:0 | HALL_CIMA_DELTA_PICO_MV:0 | SCALE_LOW:-5.00 | SCALE_HIGH:30.00
TEST_ID:IDENT_PULSO_FIXO | TEST_PARAM:SIG=PUL_FIXO;PWM=200;TP=30;TE=1000;REP=10;PRE=0;TOF=IGNORADO | T_US:1224283088 | HALL_INF_MV:1589 | HALL_INF_FILT_MV:1585 | HALL_SUP_MV:1633 | HALL_SUP_FILT_MV:1676 | PWM:0 | RAW:0.000 | ACTUAL:11.558 | REF:0.000 | ERRO:11.558 | TOF_VALID:0 | NEW_TOF:0 | RANGE_STATUS:3 | SIGNAL_MCPS:0.0000 | AMBIENT_MCPS:0.0000 | SPAD:64.0000 | VEL_MM_S:-0.0000 | MEAS_RATE_HZ:11.8167 | MEAS_AGE_US:170604624 | DT_HALL_US:3214 | DT_TOF_US:84626 | DT_EST_US:3211 | DT_CTRL_US:3215 | IDENT_ACTIVE:0 | IDENT_STATE:PARADO | IDENT_TYPE:PULSO_FIXO | IDENT_REP:0 | IDENT_REP_MAX:10 | IDENT_FASE:0 | LIM_PWM:-1 | LIM_HALL_MV:0 | LIM_ACTUAL_MM:NULL | LIM_RAW_MM:NULL | DELTA_LIM_MM:NULL | TEST_PWM:200 | TOF_BASE_MM:NULL | PULSO_HALL_PICO_MV:0 | PULSO_ACTUAL_PICO_MM:NULL | DELTA_PULSO_MM:NULL | IDENT_MOTIVO:NULL | SYNC_PULSE:0 | LIM_HALL_CIMA_MV:0 | PULSO_HALL_CIMA_PICO_MV:0 | PULSO_PWM:200 | PULSO_T_MS:30 | PULSO_ENTRE_MS:1000 | PULSO_PRE_MS:0 | HALL_BASE_MV:0 | HALL_DELTA_PICO_MV:0 | HALL_CIMA_BASE_MV:0 | HALL_CIMA_DELTA_PICO_MV:0 | SCALE_LOW:-5.00 | SCALE_HIGH:30.00
TEST_ID:IDENT_PULSO_FIXO | TEST_PARAM:SIG=PUL_FIXO;PWM=200;TP=30;TE=1000;REP=10;PRE=0;TOF=IGNORADO | T_US:1224293088 | HALL_INF_MV:1602 | HALL_INF_FILT_MV:1590 | HALL_SUP_MV:1743 | HALL_SUP_FILT_MV:1705 | PWM:0 | RAW:0.000 | ACTUAL:11.558 | REF:0.000 | ERRO:11.558 | TOF_VALID:0 | NEW_TOF:0 | RANGE_STATUS:3 | SIGNAL_MCPS:0.0000 | AMBIENT_MCPS:0.0000 | SPAD:64.0000 | VEL_MM_S:-0.0000 | MEAS_RATE_HZ:11.8167 | MEAS_AGE_US:170701072 | DT_HALL_US:3212 | DT_TOF_US:84626 | DT_EST_US:3211 | DT_CTRL_US:3212 | IDENT_ACTIVE:0 | IDENT_STATE:PARADO | IDENT_TYPE:PULSO_FIXO | IDENT_REP:0 | IDENT_REP_MAX:10 | IDENT_FASE:0 | LIM_PWM:-1 | LIM_HALL_MV:0 | LIM_ACTUAL_MM:NULL | LIM_RAW_MM:NULL | DELTA_LIM_MM:NULL | TEST_PWM:200 | TOF_BASE_MM:NULL | PULSO_HALL_PICO_MV:0 | PULSO_ACTUAL_PICO_MM:NULL | DELTA_PULSO_MM:NULL | IDENT_MOTIVO:NULL | SYNC_PULSE:0 | LIM_HALL_CIMA_MV:0 | PULSO_HALL_CIMA_PICO_MV:0 | PULSO_PWM:200 | PULSO_T_MS:30 | PULSO_ENTRE_MS:1000 | PULSO_PRE_MS:0 | HALL_BASE_MV:0 | HALL_DELTA_PICO_MV:0 | HALL_CIMA_BASE_MV:0 | HALL_CIMA_DELTA_PICO_MV:0 | SCALE_LOW:-5.00 | SCALE_HIGH:30.00
TEST_ID:IDENT_PULSO_FIXO | TEST_PARAM:SIG=PUL_FIXO;PWM=200;TP=30;TE=1000;REP=10;PRE=0;TOF=IGNORADO | T_US:1224475441 | HALL_INF_MV:1607 | HALL_INF_FILT_MV:1582 | HALL_SUP_MV:1675 | HALL_SUP_FILT_MV:1699 | PWM:0 | RAW:0.000 | ACTUAL:11.558 | REF:0.000 | ERRO:11.558 | TOF_VALID:0 | NEW_TOF:0 | RANGE_STATUS:3 | SIGNAL_MCPS:0.0000 | AMBIENT_MCPS:0.0000 | SPAD:64.0000 | VEL_MM_S:-0.0000 | MEAS_RATE_HZ:11.8167 | MEAS_AGE_US:170799536 | DT_HALL_US:3218 | DT_TOF_US:84626 | DT_EST_US:3218 | DT_CTRL_US:3219 | IDENT_ACTIVE:0 | IDENT_STATE:PARADO | IDENT_TYPE:PULSO_FIXO | IDENT_REP:0 | IDENT_REP_MAX:10 | IDENT_FASE:0 | LIM_PWM:-1 | LIM_HALL_MV:0 | LIM_ACTUAL_MM:NULL | LIM_RAW_MM:NULL | DELTA_LIM_MM:NULL | TEST_PWM:200 | TOF_BASE_MM:NULL | PULSO_HALL_PICO_MV:0 | PULSO_ACTUAL_PICO_MM:NULL | DELTA_PULSO_MM:NULL | IDENT_MOTIVO:NULL | SYNC_PULSE:0 | LIM_HALL_CIMA_MV:0 | PULSO_HALL_CIMA_PICO_MV:0 | PULSO_PWM:200 | PULSO_T_MS:30 | PULSO_ENTRE_MS:1000 | PULSO_PRE_MS:0 | HALL_BASE_MV:0 | HALL_DELTA_PICO_MV:0 | HALL_CIMA_BASE_MV:0 | HALL_CIMA_DELTA_PICO_MV:0 | SCALE_LOW:-5.00 | SCALE_HIGH:30.00
TEST_ID:IDENT_PULSO_FIXO | TEST_PARAM:SIG=PUL_FIXO;PWM=200;TP=30;TE=1000;REP=10;PRE=0;TOF=IGNORADO | T_US:1224577670 | HALL_INF_MV:1649 | HALL_INF_FILT_MV:1562 | HALL_SUP_MV:1765 | HALL_SUP_FILT_MV:1746 | PWM:0 | RAW:0.000 | ACTUAL:11.558 | REF:0.000 | ERRO:11.558 | TOF_VALID:0 | NEW_TOF:0 | RANGE_STATUS:3 | SIGNAL_MCPS:0.0000 | AMBIENT_MCPS:0.0000 | SPAD:64.0000 | VEL_MM_S:-0.0000 | MEAS_RATE_HZ:11.8167 | MEAS_AGE_US:170897984 | DT_HALL_US:3228 | DT_TOF_US:84626 | DT_EST_US:3224 | DT_CTRL_US:3220 | IDENT_ACTIVE:0 | IDENT_STATE:PARADO | IDENT_TYPE:PULSO_FIXO | IDENT_REP:0 | IDENT_REP_MAX:10 | IDENT_FASE:0 | LIM_PWM:-1 | LIM_HALL_MV:0 | LIM_ACTUAL_MM:NULL | LIM_RAW_MM:NULL | DELTA_LIM_MM:NULL | TEST_PWM:200 | TOF_BASE_MM:NULL | PULSO_HALL_PICO_MV:0 | PULSO_ACTUAL_PICO_MM:NULL | DELTA_PULSO_MM:NULL | IDENT_MOTIVO:NULL | SYNC_PULSE:0 | LIM_HALL_CIMA_MV:0 | PULSO_HALL_CIMA_PICO_MV:0 | PULSO_PWM:200 | PULSO_T_MS:30 | PULSO_ENTRE_MS:1000 | PULSO_PRE_MS:0 | HALL_BASE_MV:0 | HALL_DELTA_PICO_MV:0 | HALL_CIMA_BASE_MV:0 | HALL_CIMA_DELTA_PICO_MV:0 | SCALE_LOW:-5.00 | SCALE_HIGH:30.00
TEST_ID:IDENT_PULSO_FIXO | TEST_PARAM:SIG=PUL_FIXO;PWM=200;TP=30;TE=1000;REP=10;PRE=0;TOF=IGNORADO | T_US:1224587670 | HALL_INF_MV:1615 | HALL_INF_FILT_MV:1600 | HALL_SUP_MV:1738 | HALL_SUP_FILT_MV:1730 | PWM:0 | RAW:0.000 | ACTUAL:11.558 | REF:0.000 | ERRO:11.558 | TOF_VALID:0 | NEW_TOF:0 | RANGE_STATUS:3 | SIGNAL_MCPS:0.0000 | AMBIENT_MCPS:0.0000 | SPAD:64.0000 | VEL_MM_S:-0.0000 | MEAS_RATE_HZ:11.8167 | MEAS_AGE_US:170994464 | DT_HALL_US:3214 | DT_TOF_US:84626 | DT_EST_US:3214 | DT_CTRL_US:3214 | IDENT_ACTIVE:0 | IDENT_STATE:PARADO | IDENT_TYPE:PULSO_FIXO | IDENT_REP:0 | IDENT_REP_MAX:10 | IDENT_FASE:0 | LIM_PWM:-1 | LIM_HALL_MV:0 | LIM_ACTUAL_MM:NULL | LIM_RAW_MM:NULL | DELTA_LIM_MM:NULL | TEST_PWM:200 | TOF_BASE_MM:NULL | PULSO_HALL_PICO_MV:0 | PULSO_ACTUAL_PICO_MM:NULL | DELTA_PULSO_MM:NULL | IDENT_MOTIVO:NULL | SYNC_PULSE:0 | LIM_HALL_CIMA_MV:0 | PULSO_HALL_CIMA_PICO_MV:0 | PULSO_PWM:200 | PULSO_T_MS:30 | PULSO_ENTRE_MS:1000 | PULSO_PRE_MS:0 | HALL_BASE_MV:0 | HALL_DELTA_PICO_MV:0 | HALL_CIMA_BASE_MV:0 | HALL_CIMA_DELTA_PICO_MV:0 | SCALE_LOW:-5.00 | SCALE_HIGH:30.00
TEST_ID:IDENT_PULSO_FIXO | TEST_PARAM:SIG=PUL_FIXO;PWM=200;TP=30;TE=1000;REP=10;PRE=0;TOF=IGNORADO | T_US:1224770172 | HALL_INF_MV:1529 | HALL_INF_FILT_MV:1566 | HALL_SUP_MV:1752 | HALL_SUP_FILT_MV:1702 | PWM:0 | RAW:0.000 | ACTUAL:11.558 | REF:0.000 | ERRO:11.558 | TOF_VALID:0 | NEW_TOF:0 | RANGE_STATUS:3 | SIGNAL_MCPS:0.0000 | AMBIENT_MCPS:0.0000 | SPAD:64.0000 | VEL_MM_S:-0.0000 | MEAS_RATE_HZ:11.8167 | MEAS_AGE_US:171092928 | DT_HALL_US:3211 | DT_TOF_US:84626 | DT_EST_US:3211 | DT_CTRL_US:3210 | IDENT_ACTIVE:0 | IDENT_STATE:PARADO | IDENT_TYPE:PULSO_FIXO | IDENT_REP:0 | IDENT_REP_MAX:10 | IDENT_FASE:0 | LIM_PWM:-1 | LIM_HALL_MV:0 | LIM_ACTUAL_MM:NULL | LIM_RAW_MM:NULL | DELTA_LIM_MM:NULL | TEST_PWM:200 | TOF_BASE_MM:NULL | PULSO_HALL_PICO_MV:0 | PULSO_ACTUAL_PICO_MM:NULL | DELTA_PULSO_MM:NULL | IDENT_MOTIVO:NULL | SYNC_PULSE:0 | LIM_HALL_CIMA_MV:0 | PULSO_HALL_CIMA_PICO_MV:0 | PULSO_PWM:200 | PULSO_T_MS:30 | PULSO_ENTRE_MS:1000 | PULSO_PRE_MS:0 | HALL_BASE_MV:0 | HALL_DELTA_PICO_MV:0 | HALL_CIMA_BASE_MV:0 | HALL_CIMA_DELTA_PICO_MV:0 | SCALE_LOW:-5.00 | SCALE_HIGH:30.00
TEST_ID:IDENT_PULSO_FIXO | TEST_PARAM:SIG=PUL_FIXO;PWM=200;TP=30;TE=1000;REP=10;PRE=0;TOF=IGNORADO | T_US:1224872288 | HALL_INF_MV:1512 | HALL_INF_FILT_MV:1579 | HALL_SUP_MV:1643 | HALL_SUP_FILT_MV:1689 | PWM:0 | RAW:0.000 | ACTUAL:11.558 | REF:0.000 | ERRO:11.558 | TOF_VALID:0 | NEW_TOF:0 | RANGE_STATUS:3 | SIGNAL_MCPS:0.0000 | AMBIENT_MCPS:0.0000 | SPAD:64.0000 | VEL_MM_S:-0.0000 | MEAS_RATE_HZ:11.8167 | MEAS_AGE_US:171191392 | DT_HALL_US:5218 | DT_TOF_US:84626 | DT_EST_US:5225 | DT_CTRL_US:5230 | IDENT_ACTIVE:0 | IDENT_STATE:PARADO | IDENT_TYPE:PULSO_FIXO | IDENT_REP:0 | IDENT_REP_MAX:10 | IDENT_FASE:0 | LIM_PWM:-1 | LIM_HALL_MV:0 | LIM_ACTUAL_MM:NULL | LIM_RAW_MM:NULL | DELTA_LIM_MM:NULL | TEST_PWM:200 | TOF_BASE_MM:NULL | PULSO_HALL_PICO_MV:0 | PULSO_ACTUAL_PICO_MM:NULL | DELTA_PULSO_MM:NULL | IDENT_MOTIVO:NULL | SYNC_PULSE:0 | LIM_HALL_CIMA_MV:0 | PULSO_HALL_CIMA_PICO_MV:0 | PULSO_PWM:200 | PULSO_T_MS:30 | PULSO_ENTRE_MS:1000 | PULSO_PRE_MS:0 | HALL_BASE_MV:0 | HALL_DELTA_PICO_MV:0 | HALL_CIMA_BASE_MV:0 | HALL_CIMA_DELTA_PICO_MV:0 | SCALE_LOW:-5.00 | SCALE_HIGH:30.00
TEST_ID:IDENT_PULSO_FIXO | TEST_PARAM:SIG=PUL_FIXO;PWM=200;TP=30;TE=1000;REP=10;PRE=0;TOF=IGNORADO | T_US:1224882288 | HALL_INF_MV:1588 | HALL_INF_FILT_MV:1568 | HALL_SUP_MV:1684 | HALL_SUP_FILT_MV:1703 | PWM:0 | RAW:0.000 | ACTUAL:11.558 | REF:0.000 | ERRO:11.558 | TOF_VALID:0 | NEW_TOF:0 | RANGE_STATUS:3 | SIGNAL_MCPS:0.0000 | AMBIENT_MCPS:0.0000 | SPAD:64.0000 | VEL_MM_S:-0.0000 | MEAS_RATE_HZ:11.8167 | MEAS_AGE_US:171287840 | DT_HALL_US:3213 | DT_TOF_US:84626 | DT_EST_US:3213 | DT_CTRL_US:3218 | IDENT_ACTIVE:0 | IDENT_STATE:PARADO | IDENT_TYPE:PULSO_FIXO | IDENT_REP:0 | IDENT_REP_MAX:10 | IDENT_FASE:0 | LIM_PWM:-1 | LIM_HALL_MV:0 | LIM_ACTUAL_MM:NULL | LIM_RAW_MM:NULL | DELTA_LIM_MM:NULL | TEST_PWM:200 | TOF_BASE_MM:NULL | PULSO_HALL_PICO_MV:0 | PULSO_ACTUAL_PICO_MM:NULL | DELTA_PULSO_MM:NULL | IDENT_MOTIVO:NULL | SYNC_PULSE:0 | LIM_HALL_CIMA_MV:0 | PULSO_HALL_CIMA_PICO_MV:0 | PULSO_PWM:200 | PULSO_T_MS:30 | PULSO_ENTRE_MS:1000 | PULSO_PRE_MS:0 | HALL_BASE_MV:0 | HALL_DELTA_PICO_MV:0 | HALL_CIMA_BASE_MV:0 | HALL_CIMA_DELTA_PICO_MV:0 | SCALE_LOW:-5.00 | SCALE_HIGH:30.00
TEST_ID:IDENT_PULSO_FIXO | TEST_PARAM:SIG=PUL_FIXO;PWM=200;TP=30;TE=1000;REP=10;PRE=0;TOF=IGNORADO | T_US:1225064776 | HALL_INF_MV:1638 | HALL_INF_FILT_MV:1572 | HALL_SUP_MV:1662 | HALL_SUP_FILT_MV:1683 | PWM:0 | RAW:0.000 | ACTUAL:11.558 | REF:0.000 | ERRO:11.558 | TOF_VALID:0 | NEW_TOF:0 | RANGE_STATUS:3 | SIGNAL_MCPS:0.0000 | AMBIENT_MCPS:0.0000 | SPAD:64.0000 | VEL_MM_S:-0.0000 | MEAS_RATE_HZ:11.8167 | MEAS_AGE_US:171386304 | DT_HALL_US:3210 | DT_TOF_US:84626 | DT_EST_US:3210 | DT_CTRL_US:3216 | IDENT_ACTIVE:0 | IDENT_STATE:PARADO | IDENT_TYPE:PULSO_FIXO | IDENT_REP:0 | IDENT_REP_MAX:10 | IDENT_FASE:0 | LIM_PWM:-1 | LIM_HALL_MV:0 | LIM_ACTUAL_MM:NULL | LIM_RAW_MM:NULL | DELTA_LIM_MM:NULL | TEST_PWM:200 | TOF_BASE_MM:NULL | PULSO_HALL_PICO_MV:0 | PULSO_ACTUAL_PICO_MM:NULL | DELTA_PULSO_MM:NULL | IDENT_MOTIVO:NULL | SYNC_PULSE:0 | LIM_HALL_CIMA_MV:0 | PULSO_HALL_CIMA_PICO_MV:0 | PULSO_PWM:200 | PULSO_T_MS:30 | PULSO_ENTRE_MS:1000 | PULSO_PRE_MS:0 | HALL_BASE_MV:0 | HALL_DELTA_PICO_MV:0 | HALL_CIMA_BASE_MV:0 | HALL_CIMA_DELTA_PICO_MV:0 | SCALE_LOW:-5.00 | SCALE_HIGH:30.00
TEST_ID:IDENT_PULSO_FIXO | TEST_PARAM:SIG=PUL_FIXO;PWM=200;TP=30;TE=1000;REP=10;PRE=0;TOF=IGNORADO | T_US:1225074776 | HALL_INF_MV:1573 | HALL_INF_FILT_MV:1606 | HALL_SUP_MV:1602 | HALL_SUP_FILT_MV:1643 | PWM:0 | RAW:0.000 | ACTUAL:11.558 | REF:0.000 | ERRO:11.558 | TOF_VALID:0 | NEW_TOF:0 | RANGE_STATUS:3 | SIGNAL_MCPS:0.0000 | AMBIENT_MCPS:0.0000 | SPAD:64.0000 | VEL_MM_S:-0.0000 | MEAS_RATE_HZ:11.8167 | MEAS_AGE_US:171482768 | DT_HALL_US:3216 | DT_TOF_US:84626 | DT_EST_US:3217 | DT_CTRL_US:3215 | IDENT_ACTIVE:0 | IDENT_STATE:PARADO | IDENT_TYPE:PULSO_FIXO | IDENT_REP:0 | IDENT_REP_MAX:10 | IDENT_FASE:0 | LIM_PWM:-1 | LIM_HALL_MV:0 | LIM_ACTUAL_MM:NULL | LIM_RAW_MM:NULL | DELTA_LIM_MM:NULL | TEST_PWM:200 | TOF_BASE_MM:NULL | PULSO_HALL_PICO_MV:0 | PULSO_ACTUAL_PICO_MM:NULL | DELTA_PULSO_MM:NULL | IDENT_MOTIVO:NULL | SYNC_PULSE:0 | LIM_HALL_CIMA_MV:0 | PULSO_HALL_CIMA_PICO_MV:0 | PULSO_PWM:200 | PULSO_T_MS:30 | PULSO_ENTRE_MS:1000 | PULSO_PRE_MS:0 | HALL_BASE_MV:0 | HALL_DELTA_PICO_MV:0 | HALL_CIMA_BASE_MV:0 | HALL_CIMA_DELTA_PICO_MV:0 | SCALE_LOW:-5.00 | SCALE_HIGH:30.00
TEST_ID:IDENT_PULSO_FIXO | TEST_PARAM:SIG=PUL_FIXO;PWM=200;TP=30;TE=1000;REP=10;PRE=0;TOF=IGNORADO | T_US:1225257133 | HALL_INF_MV:1556 | HALL_INF_FILT_MV:1584 | HALL_SUP_MV:1673 | HALL_SUP_FILT_MV:1659 | PWM:0 | RAW:0.000 | ACTUAL:11.558 | REF:0.000 | ERRO:11.558 | TOF_VALID:0 | NEW_TOF:0 | RANGE_STATUS:3 | SIGNAL_MCPS:0.0000 | AMBIENT_MCPS:0.0000 | SPAD:64.0000 | VEL_MM_S:-0.0000 | MEAS_RATE_HZ:11.8167 | MEAS_AGE_US:171581232 | DT_HALL_US:3215 | DT_TOF_US:84626 | DT_EST_US:3215 | DT_CTRL_US:3216 | IDENT_ACTIVE:0 | IDENT_STATE:PARADO | IDENT_TYPE:PULSO_FIXO | IDENT_REP:0 | IDENT_REP_MAX:10 | IDENT_FASE:0 | LIM_PWM:-1 | LIM_HALL_MV:0 | LIM_ACTUAL_MM:NULL | LIM_RAW_MM:NULL | DELTA_LIM_MM:NULL | TEST_PWM:200 | TOF_BASE_MM:NULL | PULSO_HALL_PICO_MV:0 | PULSO_ACTUAL_PICO_MM:NULL | DELTA_PULSO_MM:NULL | IDENT_MOTIVO:NULL | SYNC_PULSE:0 | LIM_HALL_CIMA_MV:0 | PULSO_HALL_CIMA_PICO_MV:0 | PULSO_PWM:200 | PULSO_T_MS:30 | PULSO_ENTRE_MS:1000 | PULSO_PRE_MS:0 | HALL_BASE_MV:0 | HALL_DELTA_PICO_MV:0 | HALL_CIMA_BASE_MV:0 | HALL_CIMA_DELTA_PICO_MV:0 | SCALE_LOW:-5.00 | SCALE_HIGH:30.00
TEST_ID:IDENT_PULSO_FIXO | TEST_PARAM:SIG=PUL_FIXO;PWM=200;TP=30;TE=1000;REP=10;PRE=0;TOF=IGNORADO | T_US:1225359373 | HALL_INF_MV:1681 | HALL_INF_FILT_MV:1606 | HALL_SUP_MV:1661 | HALL_SUP_FILT_MV:1689 | PWM:0 | RAW:0.000 | ACTUAL:11.558 | REF:0.000 | ERRO:11.558 | TOF_VALID:0 | NEW_TOF:0 | RANGE_STATUS:3 | SIGNAL_MCPS:0.0000 | AMBIENT_MCPS:0.0000 | SPAD:64.0000 | VEL_MM_S:-0.0000 | MEAS_RATE_HZ:11.8167 | MEAS_AGE_US:171679696 | DT_HALL_US:3224 | DT_TOF_US:84626 | DT_EST_US:3220 | DT_CTRL_US:3214 | IDENT_ACTIVE:0 | IDENT_STATE:PARADO | IDENT_TYPE:PULSO_FIXO | IDENT_REP:0 | IDENT_REP_MAX:10 | IDENT_FASE:0 | LIM_PWM:-1 | LIM_HALL_MV:0 | LIM_ACTUAL_MM:NULL | LIM_RAW_MM:NULL | DELTA_LIM_MM:NULL | TEST_PWM:200 | TOF_BASE_MM:NULL | PULSO_HALL_PICO_MV:0 | PULSO_ACTUAL_PICO_MM:NULL | DELTA_PULSO_MM:NULL | IDENT_MOTIVO:NULL | SYNC_PULSE:0 | LIM_HALL_CIMA_MV:0 | PULSO_HALL_CIMA_PICO_MV:0 | PULSO_PWM:200 | PULSO_T_MS:30 | PULSO_ENTRE_MS:1000 | PULSO_PRE_MS:0 | HALL_BASE_MV:0 | HALL_DELTA_PICO_MV:0 | HALL_CIMA_BASE_MV:0 | HALL_CIMA_DELTA_PICO_MV:0 | SCALE_LOW:-5.00 | SCALE_HIGH:30.00
TEST_ID:IDENT_PULSO_FIXO | TEST_PARAM:SIG=PUL_FIXO;PWM=200;TP=30;TE=1000;REP=10;PRE=0;TOF=IGNORADO | T_US:1225369373 | HALL_INF_MV:1591 | HALL_INF_FILT_MV:1556 | HALL_SUP_MV:1705 | HALL_SUP_FILT_MV:1690 | PWM:0 | RAW:0.000 | ACTUAL:11.558 | REF:0.000 | ERRO:11.558 | TOF_VALID:0 | NEW_TOF:0 | RANGE_STATUS:3 | SIGNAL_MCPS:0.0000 | AMBIENT_MCPS:0.0000 | SPAD:64.0000 | VEL_MM_S:-0.0000 | MEAS_RATE_HZ:11.8167 | MEAS_AGE_US:171776144 | DT_HALL_US:3211 | DT_TOF_US:84626 | DT_EST_US:3212 | DT_CTRL_US:3211 | IDENT_ACTIVE:0 | IDENT_STATE:PARADO | IDENT_TYPE:PULSO_FIXO | IDENT_REP:0 | IDENT_REP_MAX:10 | IDENT_FASE:0 | LIM_PWM:-1 | LIM_HALL_MV:0 | LIM_ACTUAL_MM:NULL | LIM_RAW_MM:NULL | DELTA_LIM_MM:NULL | TEST_PWM:200 | TOF_BASE_MM:NULL | PULSO_HALL_PICO_MV:0 | PULSO_ACTUAL_PICO_MM:NULL | DELTA_PULSO_MM:NULL | IDENT_MOTIVO:NULL | SYNC_PULSE:0 | LIM_HALL_CIMA_MV:0 | PULSO_HALL_CIMA_PICO_MV:0 | PULSO_PWM:200 | PULSO_T_MS:30 | PULSO_ENTRE_MS:1000 | PULSO_PRE_MS:0 | HALL_BASE_MV:0 | HALL_DELTA_PICO_MV:0 | HALL_CIMA_BASE_MV:0 | HALL_CIMA_DELTA_PICO_MV:0 | SCALE_LOW:-5.00 | SCALE_HIGH:30.00
TEST_ID:IDENT_PULSO_FIXO | TEST_PARAM:SIG=PUL_FIXO;PWM=200;TP=30;TE=1000;REP=10;PRE=0;TOF=IGNORADO | T_US:1225551842 | HALL_INF_MV:1614 | HALL_INF_FILT_MV:1565 | HALL_SUP_MV:1689 | HALL_SUP_FILT_MV:1709 | PWM:0 | RAW:0.000 | ACTUAL:11.558 | REF:0.000 | ERRO:11.558 | TOF_VALID:0 | NEW_TOF:0 | RANGE_STATUS:3 | SIGNAL_MCPS:0.0000 | AMBIENT_MCPS:0.0000 | SPAD:64.0000 | VEL_MM_S:-0.0000 | MEAS_RATE_HZ:11.8167 | MEAS_AGE_US:171874608 | DT_HALL_US:3218 | DT_TOF_US:84626 | DT_EST_US:3214 | DT_CTRL_US:3218 | IDENT_ACTIVE:0 | IDENT_STATE:PARADO | IDENT_TYPE:PULSO_FIXO | IDENT_REP:0 | IDENT_REP_MAX:10 | IDENT_FASE:0 | LIM_PWM:-1 | LIM_HALL_MV:0 | LIM_ACTUAL_MM:NULL | LIM_RAW_MM:NULL | DELTA_LIM_MM:NULL | TEST_PWM:200 | TOF_BASE_MM:NULL | PULSO_HALL_PICO_MV:0 | PULSO_ACTUAL_PICO_MM:NULL | DELTA_PULSO_MM:NULL | IDENT_MOTIVO:NULL | SYNC_PULSE:0 | LIM_HALL_CIMA_MV:0 | PULSO_HALL_CIMA_PICO_MV:0 | PULSO_PWM:200 | PULSO_T_MS:30 | PULSO_ENTRE_MS:1000 | PULSO_PRE_MS:0 | HALL_BASE_MV:0 | HALL_DELTA_PICO_MV:0 | HALL_CIMA_BASE_MV:0 | HALL_CIMA_DELTA_PICO_MV:0 | SCALE_LOW:-5.00 | SCALE_HIGH:30.00
TEST_ID:IDENT_PULSO_FIXO | TEST_PARAM:SIG=PUL_FIXO;PWM=200;TP=30;TE=1000;REP=10;PRE=0;TOF=IGNORADO | T_US:1225653969 | HALL_INF_MV:1550 | HALL_INF_FILT_MV:1586 | HALL_SUP_MV:1734 | HALL_SUP_FILT_MV:1732 | PWM:0 | RAW:0.000 | ACTUAL:11.558 | REF:0.000 | ERRO:11.558 | TOF_VALID:0 | NEW_TOF:0 | RANGE_STATUS:3 | SIGNAL_MCPS:0.0000 | AMBIENT_MCPS:0.0000 | SPAD:64.0000 | VEL_MM_S:-0.0000 | MEAS_RATE_HZ:11.8167 | MEAS_AGE_US:171973072 | DT_HALL_US:5216 | DT_TOF_US:84626 | DT_EST_US:5219 | DT_CTRL_US:5226 | IDENT_ACTIVE:0 | IDENT_STATE:PARADO | IDENT_TYPE:PULSO_FIXO | IDENT_REP:0 | IDENT_REP_MAX:10 | IDENT_FASE:0 | LIM_PWM:-1 | LIM_HALL_MV:0 | LIM_ACTUAL_MM:NULL | LIM_RAW_MM:NULL | DELTA_LIM_MM:NULL | TEST_PWM:200 | TOF_BASE_MM:NULL | PULSO_HALL_PICO_MV:0 | PULSO_ACTUAL_PICO_MM:NULL | DELTA_PULSO_MM:NULL | IDENT_MOTIVO:NULL | SYNC_PULSE:0 | LIM_HALL_CIMA_MV:0 | PULSO_HALL_CIMA_PICO_MV:0 | PULSO_PWM:200 | PULSO_T_MS:30 | PULSO_ENTRE_MS:1000 | PULSO_PRE_MS:0 | HALL_BASE_MV:0 | HALL_DELTA_PICO_MV:0 | HALL_CIMA_BASE_MV:0 | HALL_CIMA_DELTA_PICO_MV:0 | SCALE_LOW:-5.00 | SCALE_HIGH:30.00
TEST_ID:IDENT_PULSO_FIXO | TEST_PARAM:SIG=PUL_FIXO;PWM=200;TP=30;TE=1000;REP=10;PRE=0;TOF=IGNORADO | T_US:1225663969 | HALL_INF_MV:1573 | HALL_INF_FILT_MV:1578 | HALL_SUP_MV:1661 | HALL_SUP_FILT_MV:1711 | PWM:0 | RAW:0.000 | ACTUAL:11.558 | REF:0.000 | ERRO:11.558 | TOF_VALID:0 | NEW_TOF:0 | RANGE_STATUS:3 | SIGNAL_MCPS:0.0000 | AMBIENT_MCPS:0.0000 | SPAD:64.0000 | VEL_MM_S:-0.0000 | MEAS_RATE_HZ:11.8167 | MEAS_AGE_US:172069536 | DT_HALL_US:3219 | DT_TOF_US:84626 | DT_EST_US:3219 | DT_CTRL_US:3217 | IDENT_ACTIVE:0 | IDENT_STATE:PARADO | IDENT_TYPE:PULSO_FIXO | IDENT_REP:0 | IDENT_REP_MAX:10 | IDENT_FASE:0 | LIM_PWM:-1 | LIM_HALL_MV:0 | LIM_ACTUAL_MM:NULL | LIM_RAW_MM:NULL | DELTA_LIM_MM:NULL | TEST_PWM:200 | TOF_BASE_MM:NULL | PULSO_HALL_PICO_MV:0 | PULSO_ACTUAL_PICO_MM:NULL | DELTA_PULSO_MM:NULL | IDENT_MOTIVO:NULL | SYNC_PULSE:0 | LIM_HALL_CIMA_MV:0 | PULSO_HALL_CIMA_PICO_MV:0 | PULSO_PWM:200 | PULSO_T_MS:30 | PULSO_ENTRE_MS:1000 | PULSO_PRE_MS:0 | HALL_BASE_MV:0 | HALL_DELTA_PICO_MV:0 | HALL_CIMA_BASE_MV:0 | HALL_CIMA_DELTA_PICO_MV:0 | SCALE_LOW:-5.00 | SCALE_HIGH:30.00
TEST_ID:IDENT_PULSO_FIXO | TEST_PARAM:SIG=PUL_FIXO;PWM=200;TP=30;TE=1000;REP=10;PRE=0;TOF=IGNORADO | T_US:1225846457 | HALL_INF_MV:1588 | HALL_INF_FILT_MV:1575 | HALL_SUP_MV:1675 | HALL_SUP_FILT_MV:1722 | PWM:0 | RAW:0.000 | ACTUAL:11.558 | REF:0.000 | ERRO:11.558 | TOF_VALID:0 | NEW_TOF:0 | RANGE_STATUS:3 | SIGNAL_MCPS:0.0000 | AMBIENT_MCPS:0.0000 | SPAD:64.0000 | VEL_MM_S:-0.0000 | MEAS_RATE_HZ:11.8167 | MEAS_AGE_US:172168000 | DT_HALL_US:3213 | DT_TOF_US:84626 | DT_EST_US:3213 | DT_CTRL_US:3216 | IDENT_ACTIVE:0 | IDENT_STATE:PARADO | IDENT_TYPE:PULSO_FIXO | IDENT_REP:0 | IDENT_REP_MAX:10 | IDENT_FASE:0 | LIM_PWM:-1 | LIM_HALL_MV:0 | LIM_ACTUAL_MM:NULL | LIM_RAW_MM:NULL | DELTA_LIM_MM:NULL | TEST_PWM:200 | TOF_BASE_MM:NULL | PULSO_HALL_PICO_MV:0 | PULSO_ACTUAL_PICO_MM:NULL | DELTA_PULSO_MM:NULL | IDENT_MOTIVO:NULL | SYNC_PULSE:0 | LIM_HALL_CIMA_MV:0 | PULSO_HALL_CIMA_PICO_MV:0 | PULSO_PWM:200 | PULSO_T_MS:30 | PULSO_ENTRE_MS:1000 | PULSO_PRE_MS:0 | HALL_BASE_MV:0 | HALL_DELTA_PICO_MV:0 | HALL_CIMA_BASE_MV:0 | HALL_CIMA_DELTA_PICO_MV:0 | SCALE_LOW:-5.00 | SCALE_HIGH:30.00
TEST_ID:IDENT_PULSO_FIXO | TEST_PARAM:SIG=PUL_FIXO;PWM=200;TP=30;TE=1000;REP=10;PRE=0;TOF=IGNORADO | T_US:1225856457 | HALL_INF_MV:1614 | HALL_INF_FILT_MV:1570 | HALL_SUP_MV:1761 | HALL_SUP_FILT_MV:1703 | PWM:0 | RAW:0.000 | ACTUAL:11.558 | REF:0.000 | ERRO:11.558 | TOF_VALID:0 | NEW_TOF:0 | RANGE_STATUS:3 | SIGNAL_MCPS:0.0000 | AMBIENT_MCPS:0.0000 | SPAD:64.0000 | VEL_MM_S:-0.0000 | MEAS_RATE_HZ:11.8167 | MEAS_AGE_US:172264464 | DT_HALL_US:3211 | DT_TOF_US:84626 | DT_EST_US:3211 | DT_CTRL_US:3216 | IDENT_ACTIVE:0 | IDENT_STATE:PARADO | IDENT_TYPE:PULSO_FIXO | IDENT_REP:0 | IDENT_REP_MAX:10 | IDENT_FASE:0 | LIM_PWM:-1 | LIM_HALL_MV:0 | LIM_ACTUAL_MM:NULL | LIM_RAW_MM:NULL | DELTA_LIM_MM:NULL | TEST_PWM:200 | TOF_BASE_MM:NULL | PULSO_HALL_PICO_MV:0 | PULSO_ACTUAL_PICO_MM:NULL | DELTA_PULSO_MM:NULL | IDENT_MOTIVO:NULL | SYNC_PULSE:0 | LIM_HALL_CIMA_MV:0 | PULSO_HALL_CIMA_PICO_MV:0 | PULSO_PWM:200 | PULSO_T_MS:30 | PULSO_ENTRE_MS:1000 | PULSO_PRE_MS:0 | HALL_BASE_MV:0 | HALL_DELTA_PICO_MV:0 | HALL_CIMA_BASE_MV:0 | HALL_CIMA_DELTA_PICO_MV:0 | SCALE_LOW:-5.00 | SCALE_HIGH:30.00
TEST_ID:IDENT_PULSO_FIXO | TEST_PARAM:SIG=PUL_FIXO;PWM=200;TP=30;TE=1000;REP=10;PRE=0;TOF=IGNORADO | T_US:1226038824 | HALL_INF_MV:1577 | HALL_INF_FILT_MV:1571 | HALL_SUP_MV:1661 | HALL_SUP_FILT_MV:1693 | PWM:0 | RAW:0.000 | ACTUAL:11.558 | REF:0.000 | ERRO:11.558 | TOF_VALID:0 | NEW_TOF:0 | RANGE_STATUS:3 | SIGNAL_MCPS:0.0000 | AMBIENT_MCPS:0.0000 | SPAD:64.0000 | VEL_MM_S:-0.0000 | MEAS_RATE_HZ:11.8167 | MEAS_AGE_US:172362928 | DT_HALL_US:3218 | DT_TOF_US:84626 | DT_EST_US:3218 | DT_CTRL_US:3211 | IDENT_ACTIVE:0 | IDENT_STATE:PARADO | IDENT_TYPE:PULSO_FIXO | IDENT_REP:0 | IDENT_REP_MAX:10 | IDENT_FASE:0 | LIM_PWM:-1 | LIM_HALL_MV:0 | LIM_ACTUAL_MM:NULL | LIM_RAW_MM:NULL | DELTA_LIM_MM:NULL | TEST_PWM:200 | TOF_BASE_MM:NULL | PULSO_HALL_PICO_MV:0 | PULSO_ACTUAL_PICO_MM:NULL | DELTA_PULSO_MM:NULL | IDENT_MOTIVO:NULL | SYNC_PULSE:0 | LIM_HALL_CIMA_MV:0 | PULSO_HALL_CIMA_PICO_MV:0 | PULSO_PWM:200 | PULSO_T_MS:30 | PULSO_ENTRE_MS:1000 | PULSO_PRE_MS:0 | HALL_BASE_MV:0 | HALL_DELTA_PICO_MV:0 | HALL_CIMA_BASE_MV:0 | HALL_CIMA_DELTA_PICO_MV:0 | SCALE_LOW:-5.00 | SCALE_HIGH:30.00
TEST_ID:IDENT_PULSO_FIXO | TEST_PARAM:SIG=PUL_FIXO;PWM=200;TP=30;TE=1000;REP=10;PRE=0;TOF=IGNORADO | T_US:1226141070 | HALL_INF_MV:1585 | HALL_INF_FILT_MV:1568 | HALL_SUP_MV:1846 | HALL_SUP_FILT_MV:1722 | PWM:0 | RAW:0.000 | ACTUAL:11.558 | REF:0.000 | ERRO:11.558 | TOF_VALID:0 | NEW_TOF:0 | RANGE_STATUS:3 | SIGNAL_MCPS:0.0000 | AMBIENT_MCPS:0.0000 | SPAD:64.0000 | VEL_MM_S:-0.0000 | MEAS_RATE_HZ:11.8167 | MEAS_AGE_US:172461392 | DT_HALL_US:3223 | DT_TOF_US:84626 | DT_EST_US:3223 | DT_CTRL_US:3223 | IDENT_ACTIVE:0 | IDENT_STATE:PARADO | IDENT_TYPE:PULSO_FIXO | IDENT_REP:0 | IDENT_REP_MAX:10 | IDENT_FASE:0 | LIM_PWM:-1 | LIM_HALL_MV:0 | LIM_ACTUAL_MM:NULL | LIM_RAW_MM:NULL | DELTA_LIM_MM:NULL | TEST_PWM:200 | TOF_BASE_MM:NULL | PULSO_HALL_PICO_MV:0 | PULSO_ACTUAL_PICO_MM:NULL | DELTA_PULSO_MM:NULL | IDENT_MOTIVO:NULL | SYNC_PULSE:0 | LIM_HALL_CIMA_MV:0 | PULSO_HALL_CIMA_PICO_MV:0 | PULSO_PWM:200 | PULSO_T_MS:30 | PULSO_ENTRE_MS:1000 | PULSO_PRE_MS:0 | HALL_BASE_MV:0 | HALL_DELTA_PICO_MV:0 | HALL_CIMA_BASE_MV:0 | HALL_CIMA_DELTA_PICO_MV:0 | SCALE_LOW:-5.00 | SCALE_HIGH:30.00
TEST_ID:IDENT_PULSO_FIXO | TEST_PARAM:SIG=PUL_FIXO;PWM=200;TP=30;TE=1000;REP=10;PRE=0;TOF=IGNORADO | T_US:1226151070 | HALL_INF_MV:1526 | HALL_INF_FILT_MV:1553 | HALL_SUP_MV:1717 | HALL_SUP_FILT_MV:1730 | PWM:0 | RAW:0.000 | ACTUAL:11.558 | REF:0.000 | ERRO:11.558 | TOF_VALID:0 | NEW_TOF:0 | RANGE_STATUS:3 | SIGNAL_MCPS:0.0000 | AMBIENT_MCPS:0.0000 | SPAD:64.0000 | VEL_MM_S:-0.0000 | MEAS_RATE_HZ:11.8167 | MEAS_AGE_US:172557856 | DT_HALL_US:3213 | DT_TOF_US:84626 | DT_EST_US:3214 | DT_CTRL_US:3217 | IDENT_ACTIVE:0 | IDENT_STATE:PARADO | IDENT_TYPE:PULSO_FIXO | IDENT_REP:0 | IDENT_REP_MAX:10 | IDENT_FASE:0 | LIM_PWM:-1 | LIM_HALL_MV:0 | LIM_ACTUAL_MM:NULL | LIM_RAW_MM:NULL | DELTA_LIM_MM:NULL | TEST_PWM:200 | TOF_BASE_MM:NULL | PULSO_HALL_PICO_MV:0 | PULSO_ACTUAL_PICO_MM:NULL | DELTA_PULSO_MM:NULL | IDENT_MOTIVO:NULL | SYNC_PULSE:0 | LIM_HALL_CIMA_MV:0 | PULSO_HALL_CIMA_PICO_MV:0 | PULSO_PWM:200 | PULSO_T_MS:30 | PULSO_ENTRE_MS:1000 | PULSO_PRE_MS:0 | HALL_BASE_MV:0 | HALL_DELTA_PICO_MV:0 | HALL_CIMA_BASE_MV:0 | HALL_CIMA_DELTA_PICO_MV:0 | SCALE_LOW:-5.00 | SCALE_HIGH:30.00
TEST_ID:IDENT_PULSO_FIXO | TEST_PARAM:SIG=PUL_FIXO;PWM=200;TP=30;TE=1000;REP=10;PRE=0;TOF=IGNORADO | T_US:1226333555 | HALL_INF_MV:1609 | HALL_INF_FILT_MV:1559 | HALL_SUP_MV:1705 | HALL_SUP_FILT_MV:1699 | PWM:0 | RAW:0.000 | ACTUAL:11.558 | REF:0.000 | ERRO:11.558 | TOF_VALID:0 | NEW_TOF:0 | RANGE_STATUS:3 | SIGNAL_MCPS:0.0000 | AMBIENT_MCPS:0.0000 | SPAD:64.0000 | VEL_MM_S:-0.0000 | MEAS_RATE_HZ:11.8167 | MEAS_AGE_US:172656320 | DT_HALL_US:3208 | DT_TOF_US:84626 | DT_EST_US:3208 | DT_CTRL_US:3220 | IDENT_ACTIVE:0 | IDENT_STATE:PARADO | IDENT_TYPE:PULSO_FIXO | IDENT_REP:0 | IDENT_REP_MAX:10 | IDENT_FASE:0 | LIM_PWM:-1 | LIM_HALL_MV:0 | LIM_ACTUAL_MM:NULL | LIM_RAW_MM:NULL | DELTA_LIM_MM:NULL | TEST_PWM:200 | TOF_BASE_MM:NULL | PULSO_HALL_PICO_MV:0 | PULSO_ACTUAL_PICO_MM:NULL | DELTA_PULSO_MM:NULL | IDENT_MOTIVO:NULL | SYNC_PULSE:0 | LIM_HALL_CIMA_MV:0 | PULSO_HALL_CIMA_PICO_MV:0 | PULSO_PWM:200 | PULSO_T_MS:30 | PULSO_ENTRE_MS:1000 | PULSO_PRE_MS:0 | HALL_BASE_MV:0 | HALL_DELTA_PICO_MV:0 | HALL_CIMA_BASE_MV:0 | HALL_CIMA_DELTA_PICO_MV:0 | SCALE_LOW:-5.00 | SCALE_HIGH:30.00
TEST_ID:IDENT_PULSO_FIXO | TEST_PARAM:SIG=PUL_FIXO;PWM=200;TP=30;TE=1000;REP=10;PRE=0;TOF=IGNORADO | T_US:1226435694 | HALL_INF_MV:1631 | HALL_INF_FILT_MV:1570 | HALL_SUP_MV:1685 | HALL_SUP_FILT_MV:1713 | PWM:0 | RAW:0.000 | ACTUAL:11.558 | REF:0.000 | ERRO:11.558 | TOF_VALID:0 | NEW_TOF:0 | RANGE_STATUS:3 | SIGNAL_MCPS:0.0000 | AMBIENT_MCPS:0.0000 | SPAD:64.0000 | VEL_MM_S:-0.0000 | MEAS_RATE_HZ:11.8167 | MEAS_AGE_US:172754800 | DT_HALL_US:5222 | DT_TOF_US:84626 | DT_EST_US:5226 | DT_CTRL_US:5228 | IDENT_ACTIVE:0 | IDENT_STATE:PARADO | IDENT_TYPE:PULSO_FIXO | IDENT_REP:0 | IDENT_REP_MAX:10 | IDENT_FASE:0 | LIM_PWM:-1 | LIM_HALL_MV:0 | LIM_ACTUAL_MM:NULL | LIM_RAW_MM:NULL | DELTA_LIM_MM:NULL | TEST_PWM:200 | TOF_BASE_MM:NULL | PULSO_HALL_PICO_MV:0 | PULSO_ACTUAL_PICO_MM:NULL | DELTA_PULSO_MM:NULL | IDENT_MOTIVO:NULL | SYNC_PULSE:0 | LIM_HALL_CIMA_MV:0 | PULSO_HALL_CIMA_PICO_MV:0 | PULSO_PWM:200 | PULSO_T_MS:30 | PULSO_ENTRE_MS:1000 | PULSO_PRE_MS:0 | HALL_BASE_MV:0 | HALL_DELTA_PICO_MV:0 | HALL_CIMA_BASE_MV:0 | HALL_CIMA_DELTA_PICO_MV:0 | SCALE_LOW:-5.00 | SCALE_HIGH:30.00
TEST_ID:IDENT_PULSO_FIXO | TEST_PARAM:SIG=PUL_FIXO;PWM=200;TP=30;TE=1000;REP=10;PRE=0;TOF=IGNORADO | T_US:1226445694 | HALL_INF_MV:1574 | HALL_INF_FILT_MV:1557 | HALL_SUP_MV:1669 | HALL_SUP_FILT_MV:1691 | PWM:0 | RAW:0.000 | ACTUAL:11.558 | REF:0.000 | ERRO:11.558 | TOF_VALID:0 | NEW_TOF:0 | RANGE_STATUS:3 | SIGNAL_MCPS:0.0000 | AMBIENT_MCPS:0.0000 | SPAD:64.0000 | VEL_MM_S:-0.0000 | MEAS_RATE_HZ:11.8167 | MEAS_AGE_US:172851264 | DT_HALL_US:3212 | DT_TOF_US:84626 | DT_EST_US:3212 | DT_CTRL_US:3218 | IDENT_ACTIVE:0 | IDENT_STATE:PARADO | IDENT_TYPE:PULSO_FIXO | IDENT_REP:0 | IDENT_REP_MAX:10 | IDENT_FASE:0 | LIM_PWM:-1 | LIM_HALL_MV:0 | LIM_ACTUAL_MM:NULL | LIM_RAW_MM:NULL | DELTA_LIM_MM:NULL | TEST_PWM:200 | TOF_BASE_MM:NULL | PULSO_HALL_PICO_MV:0 | PULSO_ACTUAL_PICO_MM:NULL | DELTA_PULSO_MM:NULL | IDENT_MOTIVO:NULL | SYNC_PULSE:0 | LIM_HALL_CIMA_MV:0 | PULSO_HALL_CIMA_PICO_MV:0 | PULSO_PWM:200 | PULSO_T_MS:30 | PULSO_ENTRE_MS:1000 | PULSO_PRE_MS:0 | HALL_BASE_MV:0 | HALL_DELTA_PICO_MV:0 | HALL_CIMA_BASE_MV:0 | HALL_CIMA_DELTA_PICO_MV:0 | SCALE_LOW:-5.00 | SCALE_HIGH:30.00
TEST_ID:IDENT_PULSO_FIXO | TEST_PARAM:SIG=PUL_FIXO;PWM=200;TP=30;TE=1000;REP=10;PRE=0;TOF=IGNORADO | T_US:1226628201 | HALL_INF_MV:1555 | HALL_INF_FILT_MV:1582 | HALL_SUP_MV:1728 | HALL_SUP_FILT_MV:1701 | PWM:0 | RAW:0.000 | ACTUAL:11.558 | REF:0.000 | ERRO:11.558 | TOF_VALID:0 | NEW_TOF:0 | RANGE_STATUS:3 | SIGNAL_MCPS:0.0000 | AMBIENT_MCPS:0.0000 | SPAD:64.0000 | VEL_MM_S:-0.0000 | MEAS_RATE_HZ:11.8167 | MEAS_AGE_US:172949744 | DT_HALL_US:3221 | DT_TOF_US:84626 | DT_EST_US:3221 | DT_CTRL_US:3210 | IDENT_ACTIVE:0 | IDENT_STATE:PARADO | IDENT_TYPE:PULSO_FIXO | IDENT_REP:0 | IDENT_REP_MAX:10 | IDENT_FASE:0 | LIM_PWM:-1 | LIM_HALL_MV:0 | LIM_ACTUAL_MM:NULL | LIM_RAW_MM:NULL | DELTA_LIM_MM:NULL | TEST_PWM:200 | TOF_BASE_MM:NULL | PULSO_HALL_PICO_MV:0 | PULSO_ACTUAL_PICO_MM:NULL | DELTA_PULSO_MM:NULL | IDENT_MOTIVO:NULL | SYNC_PULSE:0 | LIM_HALL_CIMA_MV:0 | PULSO_HALL_CIMA_PICO_MV:0 | PULSO_PWM:200 | PULSO_T_MS:30 | PULSO_ENTRE_MS:1000 | PULSO_PRE_MS:0 | HALL_BASE_MV:0 | HALL_DELTA_PICO_MV:0 | HALL_CIMA_BASE_MV:0 | HALL_CIMA_DELTA_PICO_MV:0 | SCALE_LOW:-5.00 | SCALE_HIGH:30.00
TEST_ID:IDENT_PULSO_FIXO | TEST_PARAM:SIG=PUL_FIXO;PWM=200;TP=30;TE=1000;REP=10;PRE=0;TOF=IGNORADO | T_US:1226638201 | HALL_INF_MV:1504 | HALL_INF_FILT_MV:1571 | HALL_SUP_MV:1780 | HALL_SUP_FILT_MV:1730 | PWM:0 | RAW:0.000 | ACTUAL:11.558 | REF:0.000 | ERRO:11.558 | TOF_VALID:0 | NEW_TOF:0 | RANGE_STATUS:3 | SIGNAL_MCPS:0.0000 | AMBIENT_MCPS:0.0000 | SPAD:64.0000 | VEL_MM_S:-0.0000 | MEAS_RATE_HZ:11.8167 | MEAS_AGE_US:173046208 | DT_HALL_US:3211 | DT_TOF_US:84626 | DT_EST_US:3215 | DT_CTRL_US:3220 | IDENT_ACTIVE:0 | IDENT_STATE:PARADO | IDENT_TYPE:PULSO_FIXO | IDENT_REP:0 | IDENT_REP_MAX:10 | IDENT_FASE:0 | LIM_PWM:-1 | LIM_HALL_MV:0 | LIM_ACTUAL_MM:NULL | LIM_RAW_MM:NULL | DELTA_LIM_MM:NULL | TEST_PWM:200 | TOF_BASE_MM:NULL | PULSO_HALL_PICO_MV:0 | PULSO_ACTUAL_PICO_MM:NULL | DELTA_PULSO_MM:NULL | IDENT_MOTIVO:NULL | SYNC_PULSE:0 | LIM_HALL_CIMA_MV:0 | PULSO_HALL_CIMA_PICO_MV:0 | PULSO_PWM:200 | PULSO_T_MS:30 | PULSO_ENTRE_MS:1000 | PULSO_PRE_MS:0 | HALL_BASE_MV:0 | HALL_DELTA_PICO_MV:0 | HALL_CIMA_BASE_MV:0 | HALL_CIMA_DELTA_PICO_MV:0 | SCALE_LOW:-5.00 | SCALE_HIGH:30.00
TEST_ID:IDENT_PULSO_FIXO | TEST_PARAM:SIG=PUL_FIXO;PWM=200;TP=30;TE=1000;REP=10;PRE=0;TOF=IGNORADO | T_US:1226820571 | HALL_INF_MV:1666 | HALL_INF_FILT_MV:1609 | HALL_SUP_MV:1793 | HALL_SUP_FILT_MV:1742 | PWM:0 | RAW:0.000 | ACTUAL:11.558 | REF:0.000 | ERRO:11.558 | TOF_VALID:0 | NEW_TOF:0 | RANGE_STATUS:3 | SIGNAL_MCPS:0.0000 | AMBIENT_MCPS:0.0000 | SPAD:64.0000 | VEL_MM_S:-0.0000 | MEAS_RATE_HZ:11.8167 | MEAS_AGE_US:173144688 | DT_HALL_US:3227 | DT_TOF_US:84626 | DT_EST_US:3229 | DT_CTRL_US:3218 | IDENT_ACTIVE:0 | IDENT_STATE:PARADO | IDENT_TYPE:PULSO_FIXO | IDENT_REP:0 | IDENT_REP_MAX:10 | IDENT_FASE:0 | LIM_PWM:-1 | LIM_HALL_MV:0 | LIM_ACTUAL_MM:NULL | LIM_RAW_MM:NULL | DELTA_LIM_MM:NULL | TEST_PWM:200 | TOF_BASE_MM:NULL | PULSO_HALL_PICO_MV:0 | PULSO_ACTUAL_PICO_MM:NULL | DELTA_PULSO_MM:NULL | IDENT_MOTIVO:NULL | SYNC_PULSE:0 | LIM_HALL_CIMA_MV:0 | PULSO_HALL_CIMA_PICO_MV:0 | PULSO_PWM:200 | PULSO_T_MS:30 | PULSO_ENTRE_MS:1000 | PULSO_PRE_MS:0 | HALL_BASE_MV:0 | HALL_DELTA_PICO_MV:0 | HALL_CIMA_BASE_MV:0 | HALL_CIMA_DELTA_PICO_MV:0 | SCALE_LOW:-5.00 | SCALE_HIGH:30.00
TEST_ID:IDENT_PULSO_CMD | TEST_PARAM:SIG=PUL_FIXO;PWM=255;TP=150;TE=500;REP=10;PRE=0;TOF=IGNORADO | T_US:1226922834 | HALL_INF_MV:1608 | HALL_INF_FILT_MV:1580 | HALL_SUP_MV:1708 | HALL_SUP_FILT_MV:1706 | PWM:255 | RAW:0.000 | ACTUAL:11.558 | REF:0.000 | ERRO:11.558 | TOF_VALID:0 | NEW_TOF:0 | RANGE_STATUS:3 | SIGNAL_MCPS:0.0000 | AMBIENT_MCPS:0.0000 | SPAD:64.0000 | VEL_MM_S:-0.0000 | MEAS_RATE_HZ:11.8167 | MEAS_AGE_US:173243328 | DT_HALL_US:3403 | DT_TOF_US:84626 | DT_EST_US:3375 | DT_CTRL_US:3256 | IDENT_ACTIVE:1 | IDENT_STATE:EXECUTANDO_PULSO | IDENT_TYPE:PULSO_FIXO | IDENT_REP:1 | IDENT_REP_MAX:10 | IDENT_FASE:2 | LIM_PWM:-1 | LIM_HALL_MV:1585 | LIM_ACTUAL_MM:NULL | LIM_RAW_MM:NULL | DELTA_LIM_MM:NULL | TEST_PWM:255 | TOF_BASE_MM:NULL | PULSO_HALL_PICO_MV:1571 | PULSO_ACTUAL_PICO_MM:NULL | DELTA_PULSO_MM:NULL | IDENT_MOTIVO:EM_ANDAMENTO | SYNC_PULSE:1 | LIM_HALL_CIMA_MV:1688 | PULSO_HALL_CIMA_PICO_MV:1706 | PULSO_PWM:255 | PULSO_T_MS:150 | PULSO_ENTRE_MS:500 | PULSO_PRE_MS:0 | HALL_BASE_MV:1585 | HALL_DELTA_PICO_MV:-14 | HALL_CIMA_BASE_MV:1688 | HALL_CIMA_DELTA_PICO_MV:18 | SCALE_LOW:-5.00 | SCALE_HIGH:30.00
TEST_ID:IDENT_PULSO_CMD | TEST_PARAM:SIG=PUL_FIXO;PWM=255;TP=150;TE=500;REP=10;PRE=0;TOF=IGNORADO | T_US:1226932834 | HALL_INF_MV:1492 | HALL_INF_FILT_MV:1454 | HALL_SUP_MV:959 | HALL_SUP_FILT_MV:1202 | PWM:255 | RAW:0.000 | ACTUAL:11.558 | REF:0.000 | ERRO:11.558 | TOF_VALID:0 | NEW_TOF:0 | RANGE_STATUS:3 | SIGNAL_MCPS:0.0000 | AMBIENT_MCPS:0.0000 | SPAD:64.0000 | VEL_MM_S:-0.0000 | MEAS_RATE_HZ:11.8167 | MEAS_AGE_US:173339904 | DT_HALL_US:3239 | DT_TOF_US:84626 | DT_EST_US:3240 | DT_CTRL_US:3234 | IDENT_ACTIVE:1 | IDENT_STATE:EXECUTANDO_PULSO | IDENT_TYPE:PULSO_FIXO | IDENT_REP:1 | IDENT_REP_MAX:10 | IDENT_FASE:2 | LIM_PWM:-1 | LIM_HALL_MV:1585 | LIM_ACTUAL_MM:NULL | LIM_RAW_MM:NULL | DELTA_LIM_MM:NULL | TEST_PWM:255 | TOF_BASE_MM:NULL | PULSO_HALL_PICO_MV:1441 | PULSO_ACTUAL_PICO_MM:NULL | DELTA_PULSO_MM:NULL | IDENT_MOTIVO:EM_ANDAMENTO | SYNC_PULSE:1 | LIM_HALL_CIMA_MV:1688 | PULSO_HALL_CIMA_PICO_MV:1202 | PULSO_PWM:255 | PULSO_T_MS:150 | PULSO_ENTRE_MS:500 | PULSO_PRE_MS:0 | HALL_BASE_MV:1585 | HALL_DELTA_PICO_MV:-144 | HALL_CIMA_BASE_MV:1688 | HALL_CIMA_DELTA_PICO_MV:-486 | SCALE_LOW:-5.00 | SCALE_HIGH:30.00
TEST_ID:IDENT_PULSO_CMD | TEST_PARAM:SIG=PUL_FIXO;PWM=255;TP=150;TE=500;REP=10;PRE=0;TOF=IGNORADO | T_US:1227115686 | HALL_INF_MV:1469 | HALL_INF_FILT_MV:1403 | HALL_SUP_MV:1203 | HALL_SUP_FILT_MV:1156 | PWM:0 | RAW:0.000 | ACTUAL:11.558 | REF:0.000 | ERRO:11.558 | TOF_VALID:0 | NEW_TOF:0 | RANGE_STATUS:3 | SIGNAL_MCPS:0.0000 | AMBIENT_MCPS:0.0000 | SPAD:64.0000 | VEL_MM_S:-0.0000 | MEAS_RATE_HZ:11.8167 | MEAS_AGE_US:173438528 | DT_HALL_US:3249 | DT_TOF_US:84626 | DT_EST_US:3245 | DT_CTRL_US:3242 | IDENT_ACTIVE:1 | IDENT_STATE:RECUPERANDO | IDENT_TYPE:PULSO_FIXO | IDENT_REP:1 | IDENT_REP_MAX:10 | IDENT_FASE:3 | LIM_PWM:-1 | LIM_HALL_MV:1585 | LIM_ACTUAL_MM:NULL | LIM_RAW_MM:NULL | DELTA_LIM_MM:NULL | TEST_PWM:255 | TOF_BASE_MM:NULL | PULSO_HALL_PICO_MV:1381 | PULSO_ACTUAL_PICO_MM:NULL | DELTA_PULSO_MM:NULL | IDENT_MOTIVO:EM_ANDAMENTO | SYNC_PULSE:1 | LIM_HALL_CIMA_MV:1688 | PULSO_HALL_CIMA_PICO_MV:1118 | PULSO_PWM:255 | PULSO_T_MS:150 | PULSO_ENTRE_MS:500 | PULSO_PRE_MS:0 | HALL_BASE_MV:1585 | HALL_DELTA_PICO_MV:-204 | HALL_CIMA_BASE_MV:1688 | HALL_CIMA_DELTA_PICO_MV:-570 | SCALE_LOW:-5.00 | SCALE_HIGH:30.00
TEST_ID:IDENT_PULSO_CMD | TEST_PARAM:SIG=PUL_FIXO;PWM=255;TP=150;TE=500;REP=10;PRE=0;TOF=IGNORADO | T_US:1227217941 | HALL_INF_MV:1641 | HALL_INF_FILT_MV:1549 | HALL_SUP_MV:1517 | HALL_SUP_FILT_MV:1528 | PWM:0 | RAW:0.000 | ACTUAL:11.558 | REF:0.000 | ERRO:11.558 | TOF_VALID:0 | NEW_TOF:0 | RANGE_STATUS:3 | SIGNAL_MCPS:0.0000 | AMBIENT_MCPS:0.0000 | SPAD:64.0000 | VEL_MM_S:-0.0000 | MEAS_RATE_HZ:11.8167 | MEAS_AGE_US:173537040 | DT_HALL_US:5238 | DT_TOF_US:84626 | DT_EST_US:5245 | DT_CTRL_US:5256 | IDENT_ACTIVE:1 | IDENT_STATE:RECUPERANDO | IDENT_TYPE:PULSO_FIXO | IDENT_REP:1 | IDENT_REP_MAX:10 | IDENT_FASE:3 | LIM_PWM:-1 | LIM_HALL_MV:1585 | LIM_ACTUAL_MM:NULL | LIM_RAW_MM:NULL | DELTA_LIM_MM:NULL | TEST_PWM:255 | TOF_BASE_MM:NULL | PULSO_HALL_PICO_MV:1381 | PULSO_ACTUAL_PICO_MM:NULL | DELTA_PULSO_MM:NULL | IDENT_MOTIVO:EM_ANDAMENTO | SYNC_PULSE:0 | LIM_HALL_CIMA_MV:1688 | PULSO_HALL_CIMA_PICO_MV:1118 | PULSO_PWM:255 | PULSO_T_MS:150 | PULSO_ENTRE_MS:500 | PULSO_PRE_MS:0 | HALL_BASE_MV:1585 | HALL_DELTA_PICO_MV:-204 | HALL_CIMA_BASE_MV:1688 | HALL_CIMA_DELTA_PICO_MV:-570 | SCALE_LOW:-5.00 | SCALE_HIGH:30.00
TEST_ID:IDENT_PULSO_CMD | TEST_PARAM:SIG=PUL_FIXO;PWM=255;TP=150;TE=500;REP=10;PRE=0;TOF=IGNORADO | T_US:1227227941 | HALL_INF_MV:1576 | HALL_INF_FILT_MV:1567 | HALL_SUP_MV:1645 | HALL_SUP_FILT_MV:1643 | PWM:0 | RAW:0.000 | ACTUAL:11.558 | REF:0.000 | ERRO:11.558 | TOF_VALID:0 | NEW_TOF:0 | RANGE_STATUS:3 | SIGNAL_MCPS:0.0000 | AMBIENT_MCPS:0.0000 | SPAD:64.0000 | VEL_MM_S:-0.0000 | MEAS_RATE_HZ:11.8167 | MEAS_AGE_US:173633568 | DT_HALL_US:3244 | DT_TOF_US:84626 | DT_EST_US:3240 | DT_CTRL_US:3245 | IDENT_ACTIVE:1 | IDENT_STATE:RECUPERANDO | IDENT_TYPE:PULSO_FIXO | IDENT_REP:1 | IDENT_REP_MAX:10 | IDENT_FASE:3 | LIM_PWM:-1 | LIM_HALL_MV:1585 | LIM_ACTUAL_MM:NULL | LIM_RAW_MM:NULL | DELTA_LIM_MM:NULL | TEST_PWM:255 | TOF_BASE_MM:NULL | PULSO_HALL_PICO_MV:1381 | PULSO_ACTUAL_PICO_MM:NULL | DELTA_PULSO_MM:NULL | IDENT_MOTIVO:EM_ANDAMENTO | SYNC_PULSE:0 | LIM_HALL_CIMA_MV:1688 | PULSO_HALL_CIMA_PICO_MV:1118 | PULSO_PWM:255 | PULSO_T_MS:150 | PULSO_ENTRE_MS:500 | PULSO_PRE_MS:0 | HALL_BASE_MV:1585 | HALL_DELTA_PICO_MV:-204 | HALL_CIMA_BASE_MV:1688 | HALL_CIMA_DELTA_PICO_MV:-570 | SCALE_LOW:-5.00 | SCALE_HIGH:30.00
TEST_ID:IDENT_PULSO_CMD | TEST_PARAM:SIG=PUL_FIXO;PWM=255;TP=150;TE=500;REP=10;PRE=0;TOF=IGNORADO | T_US:1227410518 | HALL_INF_MV:1548 | HALL_INF_FILT_MV:1583 | HALL_SUP_MV:1743 | HALL_SUP_FILT_MV:1710 | PWM:0 | RAW:0.000 | ACTUAL:11.558 | REF:0.000 | ERRO:11.558 | TOF_VALID:0 | NEW_TOF:0 | RANGE_STATUS:3 | SIGNAL_MCPS:0.0000 | AMBIENT_MCPS:0.0000 | SPAD:64.0000 | VEL_MM_S:-0.0000 | MEAS_RATE_HZ:11.8167 | MEAS_AGE_US:173732112 | DT_HALL_US:3238 | DT_TOF_US:84626 | DT_EST_US:3241 | DT_CTRL_US:3231 | IDENT_ACTIVE:1 | IDENT_STATE:RECUPERANDO | IDENT_TYPE:PULSO_FIXO | IDENT_REP:1 | IDENT_REP_MAX:10 | IDENT_FASE:3 | LIM_PWM:-1 | LIM_HALL_MV:1585 | LIM_ACTUAL_MM:NULL | LIM_RAW_MM:NULL | DELTA_LIM_MM:NULL | TEST_PWM:255 | TOF_BASE_MM:NULL | PULSO_HALL_PICO_MV:1381 | PULSO_ACTUAL_PICO_MM:NULL | DELTA_PULSO_MM:NULL | IDENT_MOTIVO:EM_ANDAMENTO | SYNC_PULSE:0 | LIM_HALL_CIMA_MV:1688 | PULSO_HALL_CIMA_PICO_MV:1118 | PULSO_PWM:255 | PULSO_T_MS:150 | PULSO_ENTRE_MS:500 | PULSO_PRE_MS:0 | HALL_BASE_MV:1585 | HALL_DELTA_PICO_MV:-204 | HALL_CIMA_BASE_MV:1688 | HALL_CIMA_DELTA_PICO_MV:-570 | SCALE_LOW:-5.00 | SCALE_HIGH:30.00
TEST_ID:IDENT_PULSO_CMD | TEST_PARAM:SIG=PUL_FIXO;PWM=255;TP=150;TE=500;REP=10;PRE=0;TOF=IGNORADO | T_US:1227420518 | HALL_INF_MV:1569 | HALL_INF_FILT_MV:1591 | HALL_SUP_MV:1689 | HALL_SUP_FILT_MV:1727 | PWM:0 | RAW:0.000 | ACTUAL:11.558 | REF:0.000 | ERRO:11.558 | TOF_VALID:0 | NEW_TOF:0 | RANGE_STATUS:3 | SIGNAL_MCPS:0.0000 | AMBIENT_MCPS:0.0000 | SPAD:64.0000 | VEL_MM_S:-0.0000 | MEAS_RATE_HZ:11.8167 | MEAS_AGE_US:173828624 | DT_HALL_US:3247 | DT_TOF_US:84626 | DT_EST_US:3240 | DT_CTRL_US:3241 | IDENT_ACTIVE:1 | IDENT_STATE:RECUPERANDO | IDENT_TYPE:PULSO_FIXO | IDENT_REP:1 | IDENT_REP_MAX:10 | IDENT_FASE:3 | LIM_PWM:-1 | LIM_HALL_MV:1585 | LIM_ACTUAL_MM:NULL | LIM_RAW_MM:NULL | DELTA_LIM_MM:NULL | TEST_PWM:255 | TOF_BASE_MM:NULL | PULSO_HALL_PICO_MV:1381 | PULSO_ACTUAL_PICO_MM:NULL | DELTA_PULSO_MM:NULL | IDENT_MOTIVO:EM_ANDAMENTO | SYNC_PULSE:0 | LIM_HALL_CIMA_MV:1688 | PULSO_HALL_CIMA_PICO_MV:1118 | PULSO_PWM:255 | PULSO_T_MS:150 | PULSO_ENTRE_MS:500 | PULSO_PRE_MS:0 | HALL_BASE_MV:1585 | HALL_DELTA_PICO_MV:-204 | HALL_CIMA_BASE_MV:1688 | HALL_CIMA_DELTA_PICO_MV:-570 | SCALE_LOW:-5.00 | SCALE_HIGH:30.00
TEST_ID:IDENT_PULSO_CMD | TEST_PARAM:SIG=PUL_FIXO;PWM=255;TP=150;TE=500;REP=10;PRE=0;TOF=IGNORADO | T_US:1227602947 | HALL_INF_MV:1681 | HALL_INF_FILT_MV:1607 | HALL_SUP_MV:1715 | HALL_SUP_FILT_MV:1695 | PWM:255 | RAW:0.000 | ACTUAL:11.558 | REF:0.000 | ERRO:11.558 | TOF_VALID:0 | NEW_TOF:0 | RANGE_STATUS:3 | SIGNAL_MCPS:0.0000 | AMBIENT_MCPS:0.0000 | SPAD:64.0000 | VEL_MM_S:-0.0000 | MEAS_RATE_HZ:11.8167 | MEAS_AGE_US:173927168 | DT_HALL_US:3247 | DT_TOF_US:84626 | DT_EST_US:3254 | DT_CTRL_US:3252 | IDENT_ACTIVE:1 | IDENT_STATE:EXECUTANDO_PULSO | IDENT_TYPE:PULSO_FIXO | IDENT_REP:2 | IDENT_REP_MAX:10 | IDENT_FASE:2 | LIM_PWM:-1 | LIM_HALL_MV:1585 | LIM_ACTUAL_MM:NULL | LIM_RAW_MM:NULL | DELTA_LIM_MM:NULL | TEST_PWM:255 | TOF_BASE_MM:NULL | PULSO_HALL_PICO_MV:1607 | PULSO_ACTUAL_PICO_MM:NULL | DELTA_PULSO_MM:NULL | IDENT_MOTIVO:EM_ANDAMENTO | SYNC_PULSE:0 | LIM_HALL_CIMA_MV:1688 | PULSO_HALL_CIMA_PICO_MV:1695 | PULSO_PWM:255 | PULSO_T_MS:150 | PULSO_ENTRE_MS:500 | PULSO_PRE_MS:0 | HALL_BASE_MV:1585 | HALL_DELTA_PICO_MV:22 | HALL_CIMA_BASE_MV:1688 | HALL_CIMA_DELTA_PICO_MV:7 | SCALE_LOW:-5.00 | SCALE_HIGH:30.00
TEST_ID:IDENT_PULSO_CMD | TEST_PARAM:SIG=PUL_FIXO;PWM=255;TP=150;TE=500;REP=10;PRE=0;TOF=IGNORADO | T_US:1227705404 | HALL_INF_MV:1360 | HALL_INF_FILT_MV:1427 | HALL_SUP_MV:929 | HALL_SUP_FILT_MV:1153 | PWM:255 | RAW:0.000 | ACTUAL:11.558 | REF:0.000 | ERRO:11.558 | TOF_VALID:0 | NEW_TOF:0 | RANGE_STATUS:3 | SIGNAL_MCPS:0.0000 | AMBIENT_MCPS:0.0000 | SPAD:64.0000 | VEL_MM_S:-0.0000 | MEAS_RATE_HZ:11.8167 | MEAS_AGE_US:174025744 | DT_HALL_US:3245 | DT_TOF_US:84626 | DT_EST_US:3239 | DT_CTRL_US:3235 | IDENT_ACTIVE:1 | IDENT_STATE:EXECUTANDO_PULSO | IDENT_TYPE:PULSO_FIXO | IDENT_REP:2 | IDENT_REP_MAX:10 | IDENT_FASE:2 | LIM_PWM:-1 | LIM_HALL_MV:1585 | LIM_ACTUAL_MM:NULL | LIM_RAW_MM:NULL | DELTA_LIM_MM:NULL | TEST_PWM:255 | TOF_BASE_MM:NULL | PULSO_HALL_PICO_MV:1427 | PULSO_ACTUAL_PICO_MM:NULL | DELTA_PULSO_MM:NULL | IDENT_MOTIVO:EM_ANDAMENTO | SYNC_PULSE:0 | LIM_HALL_CIMA_MV:1688 | PULSO_HALL_CIMA_PICO_MV:1153 | PULSO_PWM:255 | PULSO_T_MS:150 | PULSO_ENTRE_MS:500 | PULSO_PRE_MS:0 | HALL_BASE_MV:1585 | HALL_DELTA_PICO_MV:-158 | HALL_CIMA_BASE_MV:1688 | HALL_CIMA_DELTA_PICO_MV:-535 | SCALE_LOW:-5.00 | SCALE_HIGH:30.00
TEST_ID:IDENT_PULSO_CMD | TEST_PARAM:SIG=PUL_FIXO;PWM=255;TP=150;TE=500;REP=10;PRE=0;TOF=IGNORADO | T_US:1227715404 | HALL_INF_MV:1200 | HALL_INF_FILT_MV:1249 | HALL_SUP_MV:1509 | HALL_SUP_FILT_MV:1327 | PWM:0 | RAW:0.000 | ACTUAL:11.558 | REF:0.000 | ERRO:11.558 | TOF_VALID:0 | NEW_TOF:0 | RANGE_STATUS:3 | SIGNAL_MCPS:0.0000 | AMBIENT_MCPS:0.0000 | SPAD:64.0000 | VEL_MM_S:-0.0000 | MEAS_RATE_HZ:11.8167 | MEAS_AGE_US:174122336 | DT_HALL_US:3236 | DT_TOF_US:84626 | DT_EST_US:3235 | DT_CTRL_US:3241 | IDENT_ACTIVE:1 | IDENT_STATE:RECUPERANDO | IDENT_TYPE:PULSO_FIXO | IDENT_REP:2 | IDENT_REP_MAX:10 | IDENT_FASE:3 | LIM_PWM:-1 | LIM_HALL_MV:1585 | LIM_ACTUAL_MM:NULL | LIM_RAW_MM:NULL | DELTA_LIM_MM:NULL | TEST_PWM:255 | TOF_BASE_MM:NULL | PULSO_HALL_PICO_MV:1249 | PULSO_ACTUAL_PICO_MM:NULL | DELTA_PULSO_MM:NULL | IDENT_MOTIVO:EM_ANDAMENTO | SYNC_PULSE:0 | LIM_HALL_CIMA_MV:1688 | PULSO_HALL_CIMA_PICO_MV:1153 | PULSO_PWM:255 | PULSO_T_MS:150 | PULSO_ENTRE_MS:500 | PULSO_PRE_MS:0 | HALL_BASE_MV:1585 | HALL_DELTA_PICO_MV:-336 | HALL_CIMA_BASE_MV:1688 | HALL_CIMA_DELTA_PICO_MV:-535 | SCALE_LOW:-5.00 | SCALE_HIGH:30.00
TEST_ID:IDENT_PULSO_CMD | TEST_PARAM:SIG=PUL_FIXO;PWM=255;TP=150;TE=500;REP=10;PRE=0;TOF=IGNORADO | T_US:1227898033 | HALL_INF_MV:1589 | HALL_INF_FILT_MV:1492 | HALL_SUP_MV:1700 | HALL_SUP_FILT_MV:1623 | PWM:0 | RAW:0.000 | ACTUAL:11.558 | REF:0.000 | ERRO:11.558 | TOF_VALID:0 | NEW_TOF:0 | RANGE_STATUS:3 | SIGNAL_MCPS:0.0000 | AMBIENT_MCPS:0.0000 | SPAD:64.0000 | VEL_MM_S:-0.0000 | MEAS_RATE_HZ:11.8167 | MEAS_AGE_US:174220880 | DT_HALL_US:3236 | DT_TOF_US:84626 | DT_EST_US:3237 | DT_CTRL_US:3240 | IDENT_ACTIVE:1 | IDENT_STATE:RECUPERANDO | IDENT_TYPE:PULSO_FIXO | IDENT_REP:2 | IDENT_REP_MAX:10 | IDENT_FASE:3 | LIM_PWM:-1 | LIM_HALL_MV:1585 | LIM_ACTUAL_MM:NULL | LIM_RAW_MM:NULL | DELTA_LIM_MM:NULL | TEST_PWM:255 | TOF_BASE_MM:NULL | PULSO_HALL_PICO_MV:1249 | PULSO_ACTUAL_PICO_MM:NULL | DELTA_PULSO_MM:NULL | IDENT_MOTIVO:EM_ANDAMENTO | SYNC_PULSE:0 | LIM_HALL_CIMA_MV:1688 | PULSO_HALL_CIMA_PICO_MV:1153 | PULSO_PWM:255 | PULSO_T_MS:150 | PULSO_ENTRE_MS:500 | PULSO_PRE_MS:0 | HALL_BASE_MV:1585 | HALL_DELTA_PICO_MV:-336 | HALL_CIMA_BASE_MV:1688 | HALL_CIMA_DELTA_PICO_MV:-535 | SCALE_LOW:-5.00 | SCALE_HIGH:30.00
TEST_ID:IDENT_PULSO_CMD | TEST_PARAM:SIG=PUL_FIXO;PWM=255;TP=150;TE=500;REP=10;PRE=0;TOF=IGNORADO | T_US:1228000309 | HALL_INF_MV:1686 | HALL_INF_FILT_MV:1577 | HALL_SUP_MV:1684 | HALL_SUP_FILT_MV:1700 | PWM:0 | RAW:0.000 | ACTUAL:11.558 | REF:0.000 | ERRO:11.558 | TOF_VALID:0 | NEW_TOF:0 | RANGE_STATUS:3 | SIGNAL_MCPS:0.0000 | AMBIENT_MCPS:0.0000 | SPAD:64.0000 | VEL_MM_S:-0.0000 | MEAS_RATE_HZ:11.8167 | MEAS_AGE_US:174319408 | DT_HALL_US:5240 | DT_TOF_US:84626 | DT_EST_US:5248 | DT_CTRL_US:5254 | IDENT_ACTIVE:1 | IDENT_STATE:RECUPERANDO | IDENT_TYPE:PULSO_FIXO | IDENT_REP:2 | IDENT_REP_MAX:10 | IDENT_FASE:3 | LIM_PWM:-1 | LIM_HALL_MV:1585 | LIM_ACTUAL_MM:NULL | LIM_RAW_MM:NULL | DELTA_LIM_MM:NULL | TEST_PWM:255 | TOF_BASE_MM:NULL | PULSO_HALL_PICO_MV:1249 | PULSO_ACTUAL_PICO_MM:NULL | DELTA_PULSO_MM:NULL | IDENT_MOTIVO:EM_ANDAMENTO | SYNC_PULSE:0 | LIM_HALL_CIMA_MV:1688 | PULSO_HALL_CIMA_PICO_MV:1153 | PULSO_PWM:255 | PULSO_T_MS:150 | PULSO_ENTRE_MS:500 | PULSO_PRE_MS:0 | HALL_BASE_MV:1585 | HALL_DELTA_PICO_MV:-336 | HALL_CIMA_BASE_MV:1688 | HALL_CIMA_DELTA_PICO_MV:-535 | SCALE_LOW:-5.00 | SCALE_HIGH:30.00
TEST_ID:IDENT_PULSO_CMD | TEST_PARAM:SIG=PUL_FIXO;PWM=255;TP=150;TE=500;REP=10;PRE=0;TOF=IGNORADO | T_US:1228010309 | HALL_INF_MV:1512 | HALL_INF_FILT_MV:1558 | HALL_SUP_MV:1641 | HALL_SUP_FILT_MV:1672 | PWM:0 | RAW:0.000 | ACTUAL:11.558 | REF:0.000 | ERRO:11.558 | TOF_VALID:0 | NEW_TOF:0 | RANGE_STATUS:3 | SIGNAL_MCPS:0.0000 | AMBIENT_MCPS:0.0000 | SPAD:64.0000 | VEL_MM_S:-0.0000 | MEAS_RATE_HZ:11.8167 | MEAS_AGE_US:174415936 | DT_HALL_US:3239 | DT_TOF_US:84626 | DT_EST_US:3239 | DT_CTRL_US:3235 | IDENT_ACTIVE:1 | IDENT_STATE:RECUPERANDO | IDENT_TYPE:PULSO_FIXO | IDENT_REP:2 | IDENT_REP_MAX:10 | IDENT_FASE:3 | LIM_PWM:-1 | LIM_HALL_MV:1585 | LIM_ACTUAL_MM:NULL | LIM_RAW_MM:NULL | DELTA_LIM_MM:NULL | TEST_PWM:255 | TOF_BASE_MM:NULL | PULSO_HALL_PICO_MV:1249 | PULSO_ACTUAL_PICO_MM:NULL | DELTA_PULSO_MM:NULL | IDENT_MOTIVO:EM_ANDAMENTO | SYNC_PULSE:0 | LIM_HALL_CIMA_MV:1688 | PULSO_HALL_CIMA_PICO_MV:1153 | PULSO_PWM:255 | PULSO_T_MS:150 | PULSO_ENTRE_MS:500 | PULSO_PRE_MS:0 | HALL_BASE_MV:1585 | HALL_DELTA_PICO_MV:-336 | HALL_CIMA_BASE_MV:1688 | HALL_CIMA_DELTA_PICO_MV:-535 | SCALE_LOW:-5.00 | SCALE_HIGH:30.00
TEST_ID:IDENT_PULSO_CMD | TEST_PARAM:SIG=PUL_FIXO;PWM=255;TP=150;TE=500;REP=10;PRE=0;TOF=IGNORADO | T_US:1228192883 | HALL_INF_MV:1472 | HALL_INF_FILT_MV:1566 | HALL_SUP_MV:1707 | HALL_SUP_FILT_MV:1716 | PWM:0 | RAW:0.000 | ACTUAL:11.558 | REF:0.000 | ERRO:11.558 | TOF_VALID:0 | NEW_TOF:0 | RANGE_STATUS:3 | SIGNAL_MCPS:0.0000 | AMBIENT_MCPS:0.0000 | SPAD:64.0000 | VEL_MM_S:-0.0000 | MEAS_RATE_HZ:11.8167 | MEAS_AGE_US:174514480 | DT_HALL_US:3241 | DT_TOF_US:84626 | DT_EST_US:3239 | DT_CTRL_US:3240 | IDENT_ACTIVE:1 | IDENT_STATE:RECUPERANDO | IDENT_TYPE:PULSO_FIXO | IDENT_REP:2 | IDENT_REP_MAX:10 | IDENT_FASE:3 | LIM_PWM:-1 | LIM_HALL_MV:1585 | LIM_ACTUAL_MM:NULL | LIM_RAW_MM:NULL | DELTA_LIM_MM:NULL | TEST_PWM:255 | TOF_BASE_MM:NULL | PULSO_HALL_PICO_MV:1249 | PULSO_ACTUAL_PICO_MM:NULL | DELTA_PULSO_MM:NULL | IDENT_MOTIVO:EM_ANDAMENTO | SYNC_PULSE:0 | LIM_HALL_CIMA_MV:1688 | PULSO_HALL_CIMA_PICO_MV:1153 | PULSO_PWM:255 | PULSO_T_MS:150 | PULSO_ENTRE_MS:500 | PULSO_PRE_MS:0 | HALL_BASE_MV:1585 | HALL_DELTA_PICO_MV:-336 | HALL_CIMA_BASE_MV:1688 | HALL_CIMA_DELTA_PICO_MV:-535 | SCALE_LOW:-5.00 | SCALE_HIGH:30.00
TEST_ID:IDENT_PULSO_CMD | TEST_PARAM:SIG=PUL_FIXO;PWM=255;TP=150;TE=500;REP=10;PRE=0;TOF=IGNORADO | T_US:1228202883 | HALL_INF_MV:1564 | HALL_INF_FILT_MV:1567 | HALL_SUP_MV:1743 | HALL_SUP_FILT_MV:1706 | PWM:255 | RAW:0.000 | ACTUAL:11.558 | REF:0.000 | ERRO:11.558 | TOF_VALID:0 | NEW_TOF:0 | RANGE_STATUS:3 | SIGNAL_MCPS:0.0000 | AMBIENT_MCPS:0.0000 | SPAD:64.0000 | VEL_MM_S:-0.0000 | MEAS_RATE_HZ:11.8167 | MEAS_AGE_US:174610992 | DT_HALL_US:3238 | DT_TOF_US:84626 | DT_EST_US:3238 | DT_CTRL_US:3246 | IDENT_ACTIVE:1 | IDENT_STATE:EXECUTANDO_PULSO | IDENT_TYPE:PULSO_FIXO | IDENT_REP:3 | IDENT_REP_MAX:10 | IDENT_FASE:2 | LIM_PWM:-1 | LIM_HALL_MV:1585 | LIM_ACTUAL_MM:NULL | LIM_RAW_MM:NULL | DELTA_LIM_MM:NULL | TEST_PWM:255 | TOF_BASE_MM:NULL | PULSO_HALL_PICO_MV:1567 | PULSO_ACTUAL_PICO_MM:NULL | DELTA_PULSO_MM:NULL | IDENT_MOTIVO:EM_ANDAMENTO | SYNC_PULSE:0 | LIM_HALL_CIMA_MV:1688 | PULSO_HALL_CIMA_PICO_MV:1706 | PULSO_PWM:255 | PULSO_T_MS:150 | PULSO_ENTRE_MS:500 | PULSO_PRE_MS:0 | HALL_BASE_MV:1585 | HALL_DELTA_PICO_MV:-18 | HALL_CIMA_BASE_MV:1688 | HALL_CIMA_DELTA_PICO_MV:18 | SCALE_LOW:-5.00 | SCALE_HIGH:30.00
TEST_ID:IDENT_PULSO_CMD | TEST_PARAM:SIG=PUL_FIXO;PWM=255;TP=150;TE=500;REP=10;PRE=0;TOF=IGNORADO | T_US:1228385400 | HALL_INF_MV:1406 | HALL_INF_FILT_MV:1443 | HALL_SUP_MV:1089 | HALL_SUP_FILT_MV:1199 | PWM:255 | RAW:0.000 | ACTUAL:11.558 | REF:0.000 | ERRO:11.558 | TOF_VALID:0 | NEW_TOF:0 | RANGE_STATUS:3 | SIGNAL_MCPS:0.0000 | AMBIENT_MCPS:0.0000 | SPAD:64.0000 | VEL_MM_S:-0.0000 | MEAS_RATE_HZ:11.8167 | MEAS_AGE_US:174709600 | DT_HALL_US:3242 | DT_TOF_US:84626 | DT_EST_US:3240 | DT_CTRL_US:3236 | IDENT_ACTIVE:1 | IDENT_STATE:EXECUTANDO_PULSO | IDENT_TYPE:PULSO_FIXO | IDENT_REP:3 | IDENT_REP_MAX:10 | IDENT_FASE:2 | LIM_PWM:-1 | LIM_HALL_MV:1585 | LIM_ACTUAL_MM:NULL | LIM_RAW_MM:NULL | DELTA_LIM_MM:NULL | TEST_PWM:255 | TOF_BASE_MM:NULL | PULSO_HALL_PICO_MV:1443 | PULSO_ACTUAL_PICO_MM:NULL | DELTA_PULSO_MM:NULL | IDENT_MOTIVO:EM_ANDAMENTO | SYNC_PULSE:0 | LIM_HALL_CIMA_MV:1688 | PULSO_HALL_CIMA_PICO_MV:1199 | PULSO_PWM:255 | PULSO_T_MS:150 | PULSO_ENTRE_MS:500 | PULSO_PRE_MS:0 | HALL_BASE_MV:1585 | HALL_DELTA_PICO_MV:-142 | HALL_CIMA_BASE_MV:1688 | HALL_CIMA_DELTA_PICO_MV:-489 | SCALE_LOW:-5.00 | SCALE_HIGH:30.00
TEST_ID:IDENT_PULSO_CMD | TEST_PARAM:SIG=PUL_FIXO;PWM=255;TP=150;TE=500;REP=10;PRE=0;TOF=IGNORADO | T_US:1228487880 | HALL_INF_MV:1324 | HALL_INF_FILT_MV:1279 | HALL_SUP_MV:1475 | HALL_SUP_FILT_MV:1338 | PWM:0 | RAW:0.000 | ACTUAL:11.558 | REF:0.000 | ERRO:11.558 | TOF_VALID:0 | NEW_TOF:0 | RANGE_STATUS:3 | SIGNAL_MCPS:0.0000 | AMBIENT_MCPS:0.0000 | SPAD:64.0000 | VEL_MM_S:-0.0000 | MEAS_RATE_HZ:11.8167 | MEAS_AGE_US:174808240 | DT_HALL_US:3259 | DT_TOF_US:84626 | DT_EST_US:3254 | DT_CTRL_US:3244 | IDENT_ACTIVE:1 | IDENT_STATE:RECUPERANDO | IDENT_TYPE:PULSO_FIXO | IDENT_REP:3 | IDENT_REP_MAX:10 | IDENT_FASE:3 | LIM_PWM:-1 | LIM_HALL_MV:1585 | LIM_ACTUAL_MM:NULL | LIM_RAW_MM:NULL | DELTA_LIM_MM:NULL | TEST_PWM:255 | TOF_BASE_MM:NULL | PULSO_HALL_PICO_MV:1264 | PULSO_ACTUAL_PICO_MM:NULL | DELTA_PULSO_MM:NULL | IDENT_MOTIVO:EM_ANDAMENTO | SYNC_PULSE:0 | LIM_HALL_CIMA_MV:1688 | PULSO_HALL_CIMA_PICO_MV:1199 | PULSO_PWM:255 | PULSO_T_MS:150 | PULSO_ENTRE_MS:500 | PULSO_PRE_MS:0 | HALL_BASE_MV:1585 | HALL_DELTA_PICO_MV:-321 | HALL_CIMA_BASE_MV:1688 | HALL_CIMA_DELTA_PICO_MV:-489 | SCALE_LOW:-5.00 | SCALE_HIGH:30.00
TEST_ID:IDENT_PULSO_CMD | TEST_PARAM:SIG=PUL_FIXO;PWM=255;TP=150;TE=500;REP=10;PRE=0;TOF=IGNORADO | T_US:1228497880 | HALL_INF_MV:1613 | HALL_INF_FILT_MV:1513 | HALL_SUP_MV:1672 | HALL_SUP_FILT_MV:1627 | PWM:0 | RAW:0.000 | ACTUAL:11.558 | REF:0.000 | ERRO:11.558 | TOF_VALID:0 | NEW_TOF:0 | RANGE_STATUS:3 | SIGNAL_MCPS:0.0000 | AMBIENT_MCPS:0.0000 | SPAD:64.0000 | VEL_MM_S:-0.0000 | MEAS_RATE_HZ:11.8167 | MEAS_AGE_US:174904752 | DT_HALL_US:3235 | DT_TOF_US:84626 | DT_EST_US:3240 | DT_CTRL_US:3236 | IDENT_ACTIVE:1 | IDENT_STATE:RECUPERANDO | IDENT_TYPE:PULSO_FIXO | IDENT_REP:3 | IDENT_REP_MAX:10 | IDENT_FASE:3 | LIM_PWM:-1 | LIM_HALL_MV:1585 | LIM_ACTUAL_MM:NULL | LIM_RAW_MM:NULL | DELTA_LIM_MM:NULL | TEST_PWM:255 | TOF_BASE_MM:NULL | PULSO_HALL_PICO_MV:1264 | PULSO_ACTUAL_PICO_MM:NULL | DELTA_PULSO_MM:NULL | IDENT_MOTIVO:EM_ANDAMENTO | SYNC_PULSE:0 | LIM_HALL_CIMA_MV:1688 | PULSO_HALL_CIMA_PICO_MV:1199 | PULSO_PWM:255 | PULSO_T_MS:150 | PULSO_ENTRE_MS:500 | PULSO_PRE_MS:0 | HALL_BASE_MV:1585 | HALL_DELTA_PICO_MV:-321 | HALL_CIMA_BASE_MV:1688 | HALL_CIMA_DELTA_PICO_MV:-489 | SCALE_LOW:-5.00 | SCALE_HIGH:30.00
TEST_ID:IDENT_PULSO_CMD | TEST_PARAM:SIG=PUL_FIXO;PWM=255;TP=150;TE=500;REP=10;PRE=0;TOF=IGNORADO | T_US:1228680445 | HALL_INF_MV:1508 | HALL_INF_FILT_MV:1538 | HALL_SUP_MV:1769 | HALL_SUP_FILT_MV:1709 | PWM:0 | RAW:0.000 | ACTUAL:11.558 | REF:0.000 | ERRO:11.558 | TOF_VALID:0 | NEW_TOF:0 | RANGE_STATUS:3 | SIGNAL_MCPS:0.0000 | AMBIENT_MCPS:0.0000 | SPAD:64.0000 | VEL_MM_S:-0.0000 | MEAS_RATE_HZ:11.8167 | MEAS_AGE_US:175003280 | DT_HALL_US:3237 | DT_TOF_US:84626 | DT_EST_US:3234 | DT_CTRL_US:3244 | IDENT_ACTIVE:1 | IDENT_STATE:RECUPERANDO | IDENT_TYPE:PULSO_FIXO | IDENT_REP:3 | IDENT_REP_MAX:10 | IDENT_FASE:3 | LIM_PWM:-1 | LIM_HALL_MV:1585 | LIM_ACTUAL_MM:NULL | LIM_RAW_MM:NULL | DELTA_LIM_MM:NULL | TEST_PWM:255 | TOF_BASE_MM:NULL | PULSO_HALL_PICO_MV:1264 | PULSO_ACTUAL_PICO_MM:NULL | DELTA_PULSO_MM:NULL | IDENT_MOTIVO:EM_ANDAMENTO | SYNC_PULSE:0 | LIM_HALL_CIMA_MV:1688 | PULSO_HALL_CIMA_PICO_MV:1199 | PULSO_PWM:255 | PULSO_T_MS:150 | PULSO_ENTRE_MS:500 | PULSO_PRE_MS:0 | HALL_BASE_MV:1585 | HALL_DELTA_PICO_MV:-321 | HALL_CIMA_BASE_MV:1688 | HALL_CIMA_DELTA_PICO_MV:-489 | SCALE_LOW:-5.00 | SCALE_HIGH:30.00
TEST_ID:IDENT_PULSO_CMD | TEST_PARAM:SIG=PUL_FIXO;PWM=255;TP=150;TE=500;REP=10;PRE=0;TOF=IGNORADO | T_US:1228782699 | HALL_INF_MV:1606 | HALL_INF_FILT_MV:1550 | HALL_SUP_MV:1666 | HALL_SUP_FILT_MV:1677 | PWM:0 | RAW:0.000 | ACTUAL:11.558 | REF:0.000 | ERRO:11.558 | TOF_VALID:0 | NEW_TOF:0 | RANGE_STATUS:3 | SIGNAL_MCPS:0.0000 | AMBIENT_MCPS:0.0000 | SPAD:64.0000 | VEL_MM_S:-0.0000 | MEAS_RATE_HZ:11.8167 | MEAS_AGE_US:175101808 | DT_HALL_US:5241 | DT_TOF_US:84626 | DT_EST_US:5249 | DT_CTRL_US:5248 | IDENT_ACTIVE:1 | IDENT_STATE:RECUPERANDO | IDENT_TYPE:PULSO_FIXO | IDENT_REP:3 | IDENT_REP_MAX:10 | IDENT_FASE:3 | LIM_PWM:-1 | LIM_HALL_MV:1585 | LIM_ACTUAL_MM:NULL | LIM_RAW_MM:NULL | DELTA_LIM_MM:NULL | TEST_PWM:255 | TOF_BASE_MM:NULL | PULSO_HALL_PICO_MV:1264 | PULSO_ACTUAL_PICO_MM:NULL | DELTA_PULSO_MM:NULL | IDENT_MOTIVO:EM_ANDAMENTO | SYNC_PULSE:0 | LIM_HALL_CIMA_MV:1688 | PULSO_HALL_CIMA_PICO_MV:1199 | PULSO_PWM:255 | PULSO_T_MS:150 | PULSO_ENTRE_MS:500 | PULSO_PRE_MS:0 | HALL_BASE_MV:1585 | HALL_DELTA_PICO_MV:-321 | HALL_CIMA_BASE_MV:1688 | HALL_CIMA_DELTA_PICO_MV:-489 | SCALE_LOW:-5.00 | SCALE_HIGH:30.00
TEST_ID:IDENT_PULSO_CMD | TEST_PARAM:SIG=PUL_FIXO;PWM=255;TP=150;TE=500;REP=10;PRE=0;TOF=IGNORADO | T_US:1228792699 | HALL_INF_MV:1552 | HALL_INF_FILT_MV:1553 | HALL_SUP_MV:1702 | HALL_SUP_FILT_MV:1702 | PWM:0 | RAW:0.000 | ACTUAL:11.558 | REF:0.000 | ERRO:11.558 | TOF_VALID:0 | NEW_TOF:0 | RANGE_STATUS:3 | SIGNAL_MCPS:0.0000 | AMBIENT_MCPS:0.0000 | SPAD:64.0000 | VEL_MM_S:-0.0000 | MEAS_RATE_HZ:11.8167 | MEAS_AGE_US:175198320 | DT_HALL_US:3235 | DT_TOF_US:84626 | DT_EST_US:3232 | DT_CTRL_US:3248 | IDENT_ACTIVE:1 | IDENT_STATE:RECUPERANDO | IDENT_TYPE:PULSO_FIXO | IDENT_REP:3 | IDENT_REP_MAX:10 | IDENT_FASE:3 | LIM_PWM:-1 | LIM_HALL_MV:1585 | LIM_ACTUAL_MM:NULL | LIM_RAW_MM:NULL | DELTA_LIM_MM:NULL | TEST_PWM:255 | TOF_BASE_MM:NULL | PULSO_HALL_PICO_MV:1264 | PULSO_ACTUAL_PICO_MM:NULL | DELTA_PULSO_MM:NULL | IDENT_MOTIVO:EM_ANDAMENTO | SYNC_PULSE:0 | LIM_HALL_CIMA_MV:1688 | PULSO_HALL_CIMA_PICO_MV:1199 | PULSO_PWM:255 | PULSO_T_MS:150 | PULSO_ENTRE_MS:500 | PULSO_PRE_MS:0 | HALL_BASE_MV:1585 | HALL_DELTA_PICO_MV:-321 | HALL_CIMA_BASE_MV:1688 | HALL_CIMA_DELTA_PICO_MV:-489 | SCALE_LOW:-5.00 | SCALE_HIGH:30.00
TEST_ID:IDENT_PULSO_CMD | TEST_PARAM:SIG=PUL_FIXO;PWM=255;TP=150;TE=500;REP=10;PRE=0;TOF=IGNORADO | T_US:1228975274 | HALL_INF_MV:1604 | HALL_INF_FILT_MV:1585 | HALL_SUP_MV:1765 | HALL_SUP_FILT_MV:1735 | PWM:255 | RAW:0.000 | ACTUAL:11.558 | REF:0.000 | ERRO:11.558 | TOF_VALID:0 | NEW_TOF:0 | RANGE_STATUS:3 | SIGNAL_MCPS:0.0000 | AMBIENT_MCPS:0.0000 | SPAD:64.0000 | VEL_MM_S:-0.0000 | MEAS_RATE_HZ:11.8167 | MEAS_AGE_US:175296880 | DT_HALL_US:3248 | DT_TOF_US:84626 | DT_EST_US:3256 | DT_CTRL_US:3250 | IDENT_ACTIVE:1 | IDENT_STATE:EXECUTANDO_PULSO | IDENT_TYPE:PULSO_FIXO | IDENT_REP:4 | IDENT_REP_MAX:10 | IDENT_FASE:2 | LIM_PWM:-1 | LIM_HALL_MV:1585 | LIM_ACTUAL_MM:NULL | LIM_RAW_MM:NULL | DELTA_LIM_MM:NULL | TEST_PWM:255 | TOF_BASE_MM:NULL | PULSO_HALL_PICO_MV:1578 | PULSO_ACTUAL_PICO_MM:NULL | DELTA_PULSO_MM:NULL | IDENT_MOTIVO:EM_ANDAMENTO | SYNC_PULSE:0 | LIM_HALL_CIMA_MV:1688 | PULSO_HALL_CIMA_PICO_MV:1735 | PULSO_PWM:255 | PULSO_T_MS:150 | PULSO_ENTRE_MS:500 | PULSO_PRE_MS:0 | HALL_BASE_MV:1585 | HALL_DELTA_PICO_MV:-7 | HALL_CIMA_BASE_MV:1688 | HALL_CIMA_DELTA_PICO_MV:47 | SCALE_LOW:-5.00 | SCALE_HIGH:30.00
TEST_ID:IDENT_PULSO_CMD | TEST_PARAM:SIG=PUL_FIXO;PWM=255;TP=150;TE=500;REP=10;PRE=0;TOF=IGNORADO | T_US:1228985274 | HALL_INF_MV:1436 | HALL_INF_FILT_MV:1468 | HALL_SUP_MV:1014 | HALL_SUP_FILT_MV:1228 | PWM:255 | RAW:0.000 | ACTUAL:11.558 | REF:0.000 | ERRO:11.558 | TOF_VALID:0 | NEW_TOF:0 | RANGE_STATUS:3 | SIGNAL_MCPS:0.0000 | AMBIENT_MCPS:0.0000 | SPAD:64.0000 | VEL_MM_S:-0.0000 | MEAS_RATE_HZ:11.8167 | MEAS_AGE_US:175393472 | DT_HALL_US:3244 | DT_TOF_US:84626 | DT_EST_US:3242 | DT_CTRL_US:3243 | IDENT_ACTIVE:1 | IDENT_STATE:EXECUTANDO_PULSO | IDENT_TYPE:PULSO_FIXO | IDENT_REP:4 | IDENT_REP_MAX:10 | IDENT_FASE:2 | LIM_PWM:-1 | LIM_HALL_MV:1585 | LIM_ACTUAL_MM:NULL | LIM_RAW_MM:NULL | DELTA_LIM_MM:NULL | TEST_PWM:255 | TOF_BASE_MM:NULL | PULSO_HALL_PICO_MV:1468 | PULSO_ACTUAL_PICO_MM:NULL | DELTA_PULSO_MM:NULL | IDENT_MOTIVO:EM_ANDAMENTO | SYNC_PULSE:0 | LIM_HALL_CIMA_MV:1688 | PULSO_HALL_CIMA_PICO_MV:1228 | PULSO_PWM:255 | PULSO_T_MS:150 | PULSO_ENTRE_MS:500 | PULSO_PRE_MS:0 | HALL_BASE_MV:1585 | HALL_DELTA_PICO_MV:-117 | HALL_CIMA_BASE_MV:1688 | HALL_CIMA_DELTA_PICO_MV:-460 | SCALE_LOW:-5.00 | SCALE_HIGH:30.00
TEST_ID:IDENT_PULSO_CMD | TEST_PARAM:SIG=PUL_FIXO;PWM=255;TP=150;TE=500;REP=10;PRE=0;TOF=IGNORADO | T_US:1229167870 | HALL_INF_MV:1282 | HALL_INF_FILT_MV:1295 | HALL_SUP_MV:1536 | HALL_SUP_FILT_MV:1361 | PWM:0 | RAW:0.000 | ACTUAL:11.558 | REF:0.000 | ERRO:11.558 | TOF_VALID:0 | NEW_TOF:0 | RANGE_STATUS:3 | SIGNAL_MCPS:0.0000 | AMBIENT_MCPS:0.0000 | SPAD:64.0000 | VEL_MM_S:-0.0000 | MEAS_RATE_HZ:11.8167 | MEAS_AGE_US:175492064 | DT_HALL_US:3241 | DT_TOF_US:84626 | DT_EST_US:3240 | DT_CTRL_US:3240 | IDENT_ACTIVE:1 | IDENT_STATE:RECUPERANDO | IDENT_TYPE:PULSO_FIXO | IDENT_REP:4 | IDENT_REP_MAX:10 | IDENT_FASE:3 | LIM_PWM:-1 | LIM_HALL_MV:1585 | LIM_ACTUAL_MM:NULL | LIM_RAW_MM:NULL | DELTA_LIM_MM:NULL | TEST_PWM:255 | TOF_BASE_MM:NULL | PULSO_HALL_PICO_MV:1295 | PULSO_ACTUAL_PICO_MM:NULL | DELTA_PULSO_MM:NULL | IDENT_MOTIVO:EM_ANDAMENTO | SYNC_PULSE:0 | LIM_HALL_CIMA_MV:1688 | PULSO_HALL_CIMA_PICO_MV:1226 | PULSO_PWM:255 | PULSO_T_MS:150 | PULSO_ENTRE_MS:500 | PULSO_PRE_MS:0 | HALL_BASE_MV:1585 | HALL_DELTA_PICO_MV:-290 | HALL_CIMA_BASE_MV:1688 | HALL_CIMA_DELTA_PICO_MV:-462 | SCALE_LOW:-5.00 | SCALE_HIGH:30.00
TEST_ID:IDENT_PULSO_CMD | TEST_PARAM:SIG=PUL_FIXO;PWM=255;TP=150;TE=500;REP=10;PRE=0;TOF=IGNORADO | T_US:1229270245 | HALL_INF_MV:1705 | HALL_INF_FILT_MV:1551 | HALL_SUP_MV:1632 | HALL_SUP_FILT_MV:1588 | PWM:0 | RAW:0.000 | ACTUAL:11.558 | REF:0.000 | ERRO:11.558 | TOF_VALID:0 | NEW_TOF:0 | RANGE_STATUS:3 | SIGNAL_MCPS:0.0000 | AMBIENT_MCPS:0.0000 | SPAD:64.0000 | VEL_MM_S:-0.0000 | MEAS_RATE_HZ:11.8167 | MEAS_AGE_US:175590608 | DT_HALL_US:3259 | DT_TOF_US:84626 | DT_EST_US:3255 | DT_CTRL_US:3240 | IDENT_ACTIVE:1 | IDENT_STATE:RECUPERANDO | IDENT_TYPE:PULSO_FIXO | IDENT_REP:4 | IDENT_REP_MAX:10 | IDENT_FASE:3 | LIM_PWM:-1 | LIM_HALL_MV:1585 | LIM_ACTUAL_MM:NULL | LIM_RAW_MM:NULL | DELTA_LIM_MM:NULL | TEST_PWM:255 | TOF_BASE_MM:NULL | PULSO_HALL_PICO_MV:1295 | PULSO_ACTUAL_PICO_MM:NULL | DELTA_PULSO_MM:NULL | IDENT_MOTIVO:EM_ANDAMENTO | SYNC_PULSE:0 | LIM_HALL_CIMA_MV:1688 | PULSO_HALL_CIMA_PICO_MV:1226 | PULSO_PWM:255 | PULSO_T_MS:150 | PULSO_ENTRE_MS:500 | PULSO_PRE_MS:0 | HALL_BASE_MV:1585 | HALL_DELTA_PICO_MV:-290 | HALL_CIMA_BASE_MV:1688 | HALL_CIMA_DELTA_PICO_MV:-462 | SCALE_LOW:-5.00 | SCALE_HIGH:30.00
TEST_ID:IDENT_PULSO_CMD | TEST_PARAM:SIG=PUL_FIXO;PWM=255;TP=150;TE=500;REP=10;PRE=0;TOF=IGNORADO | T_US:1229280245 | HALL_INF_MV:1592 | HALL_INF_FILT_MV:1580 | HALL_SUP_MV:1661 | HALL_SUP_FILT_MV:1684 | PWM:0 | RAW:0.000 | ACTUAL:11.558 | REF:0.000 | ERRO:11.558 | TOF_VALID:0 | NEW_TOF:0 | RANGE_STATUS:3 | SIGNAL_MCPS:0.0000 | AMBIENT_MCPS:0.0000 | SPAD:64.0000 | VEL_MM_S:-0.0000 | MEAS_RATE_HZ:11.8167 | MEAS_AGE_US:175687104 | DT_HALL_US:3237 | DT_TOF_US:84626 | DT_EST_US:3236 | DT_CTRL_US:3235 | IDENT_ACTIVE:1 | IDENT_STATE:RECUPERANDO | IDENT_TYPE:PULSO_FIXO | IDENT_REP:4 | IDENT_REP_MAX:10 | IDENT_FASE:3 | LIM_PWM:-1 | LIM_HALL_MV:1585 | LIM_ACTUAL_MM:NULL | LIM_RAW_MM:NULL | DELTA_LIM_MM:NULL | TEST_PWM:255 | TOF_BASE_MM:NULL | PULSO_HALL_PICO_MV:1295 | PULSO_ACTUAL_PICO_MM:NULL | DELTA_PULSO_MM:NULL | IDENT_MOTIVO:EM_ANDAMENTO | SYNC_PULSE:0 | LIM_HALL_CIMA_MV:1688 | PULSO_HALL_CIMA_PICO_MV:1226 | PULSO_PWM:255 | PULSO_T_MS:150 | PULSO_ENTRE_MS:500 | PULSO_PRE_MS:0 | HALL_BASE_MV:1585 | HALL_DELTA_PICO_MV:-290 | HALL_CIMA_BASE_MV:1688 | HALL_CIMA_DELTA_PICO_MV:-462 | SCALE_LOW:-5.00 | SCALE_HIGH:30.00
TEST_ID:IDENT_PULSO_CMD | TEST_PARAM:SIG=PUL_FIXO;PWM=255;TP=150;TE=500;REP=10;PRE=0;TOF=IGNORADO | T_US:1229462801 | HALL_INF_MV:1607 | HALL_INF_FILT_MV:1594 | HALL_SUP_MV:1700 | HALL_SUP_FILT_MV:1693 | PWM:0 | RAW:0.000 | ACTUAL:11.558 | REF:0.000 | ERRO:11.558 | TOF_VALID:0 | NEW_TOF:0 | RANGE_STATUS:3 | SIGNAL_MCPS:0.0000 | AMBIENT_MCPS:0.0000 | SPAD:64.0000 | VEL_MM_S:-0.0000 | MEAS_RATE_HZ:11.8167 | MEAS_AGE_US:175785648 | DT_HALL_US:3240 | DT_TOF_US:84626 | DT_EST_US:3236 | DT_CTRL_US:3240 | IDENT_ACTIVE:1 | IDENT_STATE:RECUPERANDO | IDENT_TYPE:PULSO_FIXO | IDENT_REP:4 | IDENT_REP_MAX:10 | IDENT_FASE:3 | LIM_PWM:-1 | LIM_HALL_MV:1585 | LIM_ACTUAL_MM:NULL | LIM_RAW_MM:NULL | DELTA_LIM_MM:NULL | TEST_PWM:255 | TOF_BASE_MM:NULL | PULSO_HALL_PICO_MV:1295 | PULSO_ACTUAL_PICO_MM:NULL | DELTA_PULSO_MM:NULL | IDENT_MOTIVO:EM_ANDAMENTO | SYNC_PULSE:0 | LIM_HALL_CIMA_MV:1688 | PULSO_HALL_CIMA_PICO_MV:1226 | PULSO_PWM:255 | PULSO_T_MS:150 | PULSO_ENTRE_MS:500 | PULSO_PRE_MS:0 | HALL_BASE_MV:1585 | HALL_DELTA_PICO_MV:-290 | HALL_CIMA_BASE_MV:1688 | HALL_CIMA_DELTA_PICO_MV:-462 | SCALE_LOW:-5.00 | SCALE_HIGH:30.00
TEST_ID:IDENT_PULSO_CMD | TEST_PARAM:SIG=PUL_FIXO;PWM=255;TP=150;TE=500;REP=10;PRE=0;TOF=IGNORADO | T_US:1229565066 | HALL_INF_MV:1580 | HALL_INF_FILT_MV:1586 | HALL_SUP_MV:1712 | HALL_SUP_FILT_MV:1710 | PWM:0 | RAW:0.000 | ACTUAL:11.558 | REF:0.000 | ERRO:11.558 | TOF_VALID:0 | NEW_TOF:0 | RANGE_STATUS:3 | SIGNAL_MCPS:0.0000 | AMBIENT_MCPS:0.0000 | SPAD:64.0000 | VEL_MM_S:-0.0000 | MEAS_RATE_HZ:11.8167 | MEAS_AGE_US:175884160 | DT_HALL_US:5241 | DT_TOF_US:84626 | DT_EST_US:5245 | DT_CTRL_US:5253 | IDENT_ACTIVE:1 | IDENT_STATE:RECUPERANDO | IDENT_TYPE:PULSO_FIXO | IDENT_REP:4 | IDENT_REP_MAX:10 | IDENT_FASE:3 | LIM_PWM:-1 | LIM_HALL_MV:1585 | LIM_ACTUAL_MM:NULL | LIM_RAW_MM:NULL | DELTA_LIM_MM:NULL | TEST_PWM:255 | TOF_BASE_MM:NULL | PULSO_HALL_PICO_MV:1295 | PULSO_ACTUAL_PICO_MM:NULL | DELTA_PULSO_MM:NULL | IDENT_MOTIVO:EM_ANDAMENTO | SYNC_PULSE:0 | LIM_HALL_CIMA_MV:1688 | PULSO_HALL_CIMA_PICO_MV:1226 | PULSO_PWM:255 | PULSO_T_MS:150 | PULSO_ENTRE_MS:500 | PULSO_PRE_MS:0 | HALL_BASE_MV:1585 | HALL_DELTA_PICO_MV:-290 | HALL_CIMA_BASE_MV:1688 | HALL_CIMA_DELTA_PICO_MV:-462 | SCALE_LOW:-5.00 | SCALE_HIGH:30.00
TEST_ID:IDENT_PULSO_CMD | TEST_PARAM:SIG=PUL_FIXO;PWM=255;TP=150;TE=500;REP=10;PRE=0;TOF=IGNORADO | T_US:1229575066 | HALL_INF_MV:1512 | HALL_INF_FILT_MV:1577 | HALL_SUP_MV:1761 | HALL_SUP_FILT_MV:1742 | PWM:255 | RAW:0.000 | ACTUAL:11.558 | REF:0.000 | ERRO:11.558 | TOF_VALID:0 | NEW_TOF:0 | RANGE_STATUS:3 | SIGNAL_MCPS:0.0000 | AMBIENT_MCPS:0.0000 | SPAD:64.0000 | VEL_MM_S:-0.0000 | MEAS_RATE_HZ:11.8167 | MEAS_AGE_US:175980704 | DT_HALL_US:3242 | DT_TOF_US:84626 | DT_EST_US:3242 | DT_CTRL_US:3242 | IDENT_ACTIVE:1 | IDENT_STATE:EXECUTANDO_PULSO | IDENT_TYPE:PULSO_FIXO | IDENT_REP:5 | IDENT_REP_MAX:10 | IDENT_FASE:2 | LIM_PWM:-1 | LIM_HALL_MV:1585 | LIM_ACTUAL_MM:NULL | LIM_RAW_MM:NULL | DELTA_LIM_MM:NULL | TEST_PWM:255 | TOF_BASE_MM:NULL | PULSO_HALL_PICO_MV:1577 | PULSO_ACTUAL_PICO_MM:NULL | DELTA_PULSO_MM:NULL | IDENT_MOTIVO:EM_ANDAMENTO | SYNC_PULSE:0 | LIM_HALL_CIMA_MV:1688 | PULSO_HALL_CIMA_PICO_MV:1742 | PULSO_PWM:255 | PULSO_T_MS:150 | PULSO_ENTRE_MS:500 | PULSO_PRE_MS:0 | HALL_BASE_MV:1585 | HALL_DELTA_PICO_MV:-8 | HALL_CIMA_BASE_MV:1688 | HALL_CIMA_DELTA_PICO_MV:54 | SCALE_LOW:-5.00 | SCALE_HIGH:30.00
TEST_ID:IDENT_PULSO_CMD | TEST_PARAM:SIG=PUL_FIXO;PWM=255;TP=150;TE=500;REP=10;PRE=0;TOF=IGNORADO | T_US:1229757732 | HALL_INF_MV:1447 | HALL_INF_FILT_MV:1483 | HALL_SUP_MV:1089 | HALL_SUP_FILT_MV:1203 | PWM:255 | RAW:0.000 | ACTUAL:11.558 | REF:0.000 | ERRO:11.558 | TOF_VALID:0 | NEW_TOF:0 | RANGE_STATUS:3 | SIGNAL_MCPS:0.0000 | AMBIENT_MCPS:0.0000 | SPAD:64.0000 | VEL_MM_S:-0.0000 | MEAS_RATE_HZ:11.8167 | MEAS_AGE_US:176079312 | DT_HALL_US:3230 | DT_TOF_US:84626 | DT_EST_US:3231 | DT_CTRL_US:3241 | IDENT_ACTIVE:1 | IDENT_STATE:EXECUTANDO_PULSO | IDENT_TYPE:PULSO_FIXO | IDENT_REP:5 | IDENT_REP_MAX:10 | IDENT_FASE:2 | LIM_PWM:-1 | LIM_HALL_MV:1585 | LIM_ACTUAL_MM:NULL | LIM_RAW_MM:NULL | DELTA_LIM_MM:NULL | TEST_PWM:255 | TOF_BASE_MM:NULL | PULSO_HALL_PICO_MV:1483 | PULSO_ACTUAL_PICO_MM:NULL | DELTA_PULSO_MM:NULL | IDENT_MOTIVO:EM_ANDAMENTO | SYNC_PULSE:0 | LIM_HALL_CIMA_MV:1688 | PULSO_HALL_CIMA_PICO_MV:1203 | PULSO_PWM:255 | PULSO_T_MS:150 | PULSO_ENTRE_MS:500 | PULSO_PRE_MS:0 | HALL_BASE_MV:1585 | HALL_DELTA_PICO_MV:-102 | HALL_CIMA_BASE_MV:1688 | HALL_CIMA_DELTA_PICO_MV:-485 | SCALE_LOW:-5.00 | SCALE_HIGH:30.00
TEST_ID:IDENT_PULSO_CMD | TEST_PARAM:SIG=PUL_FIXO;PWM=255;TP=150;TE=500;REP=10;PRE=0;TOF=IGNORADO | T_US:1229767732 | HALL_INF_MV:1195 | HALL_INF_FILT_MV:1232 | HALL_SUP_MV:1590 | HALL_SUP_FILT_MV:1408 | PWM:0 | RAW:0.000 | ACTUAL:11.558 | REF:0.000 | ERRO:11.558 | TOF_VALID:0 | NEW_TOF:0 | RANGE_STATUS:3 | SIGNAL_MCPS:0.0000 | AMBIENT_MCPS:0.0000 | SPAD:64.0000 | VEL_MM_S:-0.0000 | MEAS_RATE_HZ:11.8167 | MEAS_AGE_US:176175920 | DT_HALL_US:3244 | DT_TOF_US:84626 | DT_EST_US:3241 | DT_CTRL_US:3242 | IDENT_ACTIVE:1 | IDENT_STATE:RECUPERANDO | IDENT_TYPE:PULSO_FIXO | IDENT_REP:5 | IDENT_REP_MAX:10 | IDENT_FASE:3 | LIM_PWM:-1 | LIM_HALL_MV:1585 | LIM_ACTUAL_MM:NULL | LIM_RAW_MM:NULL | DELTA_LIM_MM:NULL | TEST_PWM:255 | TOF_BASE_MM:NULL | PULSO_HALL_PICO_MV:1232 | PULSO_ACTUAL_PICO_MM:NULL | DELTA_PULSO_MM:NULL | IDENT_MOTIVO:EM_ANDAMENTO | SYNC_PULSE:0 | LIM_HALL_CIMA_MV:1688 | PULSO_HALL_CIMA_PICO_MV:1203 | PULSO_PWM:255 | PULSO_T_MS:150 | PULSO_ENTRE_MS:500 | PULSO_PRE_MS:0 | HALL_BASE_MV:1585 | HALL_DELTA_PICO_MV:-353 | HALL_CIMA_BASE_MV:1688 | HALL_CIMA_DELTA_PICO_MV:-485 | SCALE_LOW:-5.00 | SCALE_HIGH:30.00
TEST_ID:IDENT_PULSO_CMD | TEST_PARAM:SIG=PUL_FIXO;PWM=255;TP=150;TE=500;REP=10;PRE=0;TOF=IGNORADO | T_US:1229950238 | HALL_INF_MV:1633 | HALL_INF_FILT_MV:1523 | HALL_SUP_MV:1702 | HALL_SUP_FILT_MV:1614 | PWM:0 | RAW:0.000 | ACTUAL:11.558 | REF:0.000 | ERRO:11.558 | TOF_VALID:0 | NEW_TOF:0 | RANGE_STATUS:3 | SIGNAL_MCPS:0.0000 | AMBIENT_MCPS:0.0000 | SPAD:64.0000 | VEL_MM_S:-0.0000 | MEAS_RATE_HZ:11.8167 | MEAS_AGE_US:176274464 | DT_HALL_US:3245 | DT_TOF_US:84626 | DT_EST_US:3248 | DT_CTRL_US:3247 | IDENT_ACTIVE:1 | IDENT_STATE:RECUPERANDO | IDENT_TYPE:PULSO_FIXO | IDENT_REP:5 | IDENT_REP_MAX:10 | IDENT_FASE:3 | LIM_PWM:-1 | LIM_HALL_MV:1585 | LIM_ACTUAL_MM:NULL | LIM_RAW_MM:NULL | DELTA_LIM_MM:NULL | TEST_PWM:255 | TOF_BASE_MM:NULL | PULSO_HALL_PICO_MV:1232 | PULSO_ACTUAL_PICO_MM:NULL | DELTA_PULSO_MM:NULL | IDENT_MOTIVO:EM_ANDAMENTO | SYNC_PULSE:0 | LIM_HALL_CIMA_MV:1688 | PULSO_HALL_CIMA_PICO_MV:1203 | PULSO_PWM:255 | PULSO_T_MS:150 | PULSO_ENTRE_MS:500 | PULSO_PRE_MS:0 | HALL_BASE_MV:1585 | HALL_DELTA_PICO_MV:-353 | HALL_CIMA_BASE_MV:1688 | HALL_CIMA_DELTA_PICO_MV:-485 | SCALE_LOW:-5.00 | SCALE_HIGH:30.00
TEST_ID:IDENT_PULSO_CMD | TEST_PARAM:SIG=PUL_FIXO;PWM=255;TP=150;TE=500;REP=10;PRE=0;TOF=IGNORADO | T_US:1230052641 | HALL_INF_MV:1661 | HALL_INF_FILT_MV:1591 | HALL_SUP_MV:1582 | HALL_SUP_FILT_MV:1656 | PWM:0 | RAW:0.000 | ACTUAL:11.558 | REF:0.000 | ERRO:11.558 | TOF_VALID:0 | NEW_TOF:0 | RANGE_STATUS:3 | SIGNAL_MCPS:0.0000 | AMBIENT_MCPS:0.0000 | SPAD:64.0000 | VEL_MM_S:-0.0000 | MEAS_RATE_HZ:11.8167 | MEAS_AGE_US:176372992 | DT_HALL_US:3256 | DT_TOF_US:84626 | DT_EST_US:3249 | DT_CTRL_US:3248 | IDENT_ACTIVE:1 | IDENT_STATE:RECUPERANDO | IDENT_TYPE:PULSO_FIXO | IDENT_REP:5 | IDENT_REP_MAX:10 | IDENT_FASE:3 | LIM_PWM:-1 | LIM_HALL_MV:1585 | LIM_ACTUAL_MM:NULL | LIM_RAW_MM:NULL | DELTA_LIM_MM:NULL | TEST_PWM:255 | TOF_BASE_MM:NULL | PULSO_HALL_PICO_MV:1232 | PULSO_ACTUAL_PICO_MM:NULL | DELTA_PULSO_MM:NULL | IDENT_MOTIVO:EM_ANDAMENTO | SYNC_PULSE:0 | LIM_HALL_CIMA_MV:1688 | PULSO_HALL_CIMA_PICO_MV:1203 | PULSO_PWM:255 | PULSO_T_MS:150 | PULSO_ENTRE_MS:500 | PULSO_PRE_MS:0 | HALL_BASE_MV:1585 | HALL_DELTA_PICO_MV:-353 | HALL_CIMA_BASE_MV:1688 | HALL_CIMA_DELTA_PICO_MV:-485 | SCALE_LOW:-5.00 | SCALE_HIGH:30.00
TEST_ID:IDENT_PULSO_CMD | TEST_PARAM:SIG=PUL_FIXO;PWM=255;TP=150;TE=500;REP=10;PRE=0;TOF=IGNORADO | T_US:1230062641 | HALL_INF_MV:1591 | HALL_INF_FILT_MV:1585 | HALL_SUP_MV:1690 | HALL_SUP_FILT_MV:1659 | PWM:0 | RAW:0.000 | ACTUAL:11.558 | REF:0.000 | ERRO:11.558 | TOF_VALID:0 | NEW_TOF:0 | RANGE_STATUS:3 | SIGNAL_MCPS:0.0000 | AMBIENT_MCPS:0.0000 | SPAD:64.0000 | VEL_MM_S:-0.0000 | MEAS_RATE_HZ:11.8167 | MEAS_AGE_US:176469520 | DT_HALL_US:3239 | DT_TOF_US:84626 | DT_EST_US:3244 | DT_CTRL_US:3236 | IDENT_ACTIVE:1 | IDENT_STATE:RECUPERANDO | IDENT_TYPE:PULSO_FIXO | IDENT_REP:5 | IDENT_REP_MAX:10 | IDENT_FASE:3 | LIM_PWM:-1 | LIM_HALL_MV:1585 | LIM_ACTUAL_MM:NULL | LIM_RAW_MM:NULL | DELTA_LIM_MM:NULL | TEST_PWM:255 | TOF_BASE_MM:NULL | PULSO_HALL_PICO_MV:1232 | PULSO_ACTUAL_PICO_MM:NULL | DELTA_PULSO_MM:NULL | IDENT_MOTIVO:EM_ANDAMENTO | SYNC_PULSE:0 | LIM_HALL_CIMA_MV:1688 | PULSO_HALL_CIMA_PICO_MV:1203 | PULSO_PWM:255 | PULSO_T_MS:150 | PULSO_ENTRE_MS:500 | PULSO_PRE_MS:0 | HALL_BASE_MV:1585 | HALL_DELTA_PICO_MV:-353 | HALL_CIMA_BASE_MV:1688 | HALL_CIMA_DELTA_PICO_MV:-485 | SCALE_LOW:-5.00 | SCALE_HIGH:30.00
TEST_ID:IDENT_PULSO_CMD | TEST_PARAM:SIG=PUL_FIXO;PWM=255;TP=150;TE=500;REP=10;PRE=0;TOF=IGNORADO | T_US:1230245201 | HALL_INF_MV:1495 | HALL_INF_FILT_MV:1563 | HALL_SUP_MV:1750 | HALL_SUP_FILT_MV:1716 | PWM:0 | RAW:0.000 | ACTUAL:11.558 | REF:0.000 | ERRO:11.558 | TOF_VALID:0 | NEW_TOF:0 | RANGE_STATUS:3 | SIGNAL_MCPS:0.0000 | AMBIENT_MCPS:0.0000 | SPAD:64.0000 | VEL_MM_S:-0.0000 | MEAS_RATE_HZ:11.8167 | MEAS_AGE_US:176568048 | DT_HALL_US:3237 | DT_TOF_US:84626 | DT_EST_US:3233 | DT_CTRL_US:3239 | IDENT_ACTIVE:1 | IDENT_STATE:RECUPERANDO | IDENT_TYPE:PULSO_FIXO | IDENT_REP:5 | IDENT_REP_MAX:10 | IDENT_FASE:3 | LIM_PWM:-1 | LIM_HALL_MV:1585 | LIM_ACTUAL_MM:NULL | LIM_RAW_MM:NULL | DELTA_LIM_MM:NULL | TEST_PWM:255 | TOF_BASE_MM:NULL | PULSO_HALL_PICO_MV:1232 | PULSO_ACTUAL_PICO_MM:NULL | DELTA_PULSO_MM:NULL | IDENT_MOTIVO:EM_ANDAMENTO | SYNC_PULSE:0 | LIM_HALL_CIMA_MV:1688 | PULSO_HALL_CIMA_PICO_MV:1203 | PULSO_PWM:255 | PULSO_T_MS:150 | PULSO_ENTRE_MS:500 | PULSO_PRE_MS:0 | HALL_BASE_MV:1585 | HALL_DELTA_PICO_MV:-353 | HALL_CIMA_BASE_MV:1688 | HALL_CIMA_DELTA_PICO_MV:-485 | SCALE_LOW:-5.00 | SCALE_HIGH:30.00
TEST_ID:IDENT_PULSO_CMD | TEST_PARAM:SIG=PUL_FIXO;PWM=255;TP=150;TE=500;REP=10;PRE=0;TOF=IGNORADO | T_US:1230347472 | HALL_INF_MV:1611 | HALL_INF_FILT_MV:1580 | HALL_SUP_MV:1695 | HALL_SUP_FILT_MV:1738 | PWM:255 | RAW:0.000 | ACTUAL:11.558 | REF:0.000 | ERRO:11.558 | TOF_VALID:0 | NEW_TOF:0 | RANGE_STATUS:3 | SIGNAL_MCPS:0.0000 | AMBIENT_MCPS:0.0000 | SPAD:64.0000 | VEL_MM_S:-0.0000 | MEAS_RATE_HZ:11.8167 | MEAS_AGE_US:176666576 | DT_HALL_US:5246 | DT_TOF_US:84626 | DT_EST_US:5255 | DT_CTRL_US:5256 | IDENT_ACTIVE:1 | IDENT_STATE:EXECUTANDO_PULSO | IDENT_TYPE:PULSO_FIXO | IDENT_REP:6 | IDENT_REP_MAX:10 | IDENT_FASE:2 | LIM_PWM:-1 | LIM_HALL_MV:1585 | LIM_ACTUAL_MM:NULL | LIM_RAW_MM:NULL | DELTA_LIM_MM:NULL | TEST_PWM:255 | TOF_BASE_MM:NULL | PULSO_HALL_PICO_MV:1580 | PULSO_ACTUAL_PICO_MM:NULL | DELTA_PULSO_MM:NULL | IDENT_MOTIVO:EM_ANDAMENTO | SYNC_PULSE:0 | LIM_HALL_CIMA_MV:1688 | PULSO_HALL_CIMA_PICO_MV:1738 | PULSO_PWM:255 | PULSO_T_MS:150 | PULSO_ENTRE_MS:500 | PULSO_PRE_MS:0 | HALL_BASE_MV:1585 | HALL_DELTA_PICO_MV:-5 | HALL_CIMA_BASE_MV:1688 | HALL_CIMA_DELTA_PICO_MV:50 | SCALE_LOW:-5.00 | SCALE_HIGH:30.00
TEST_ID:IDENT_PULSO_CMD | TEST_PARAM:SIG=PUL_FIXO;PWM=255;TP=150;TE=500;REP=10;PRE=0;TOF=IGNORADO | T_US:1230357472 | HALL_INF_MV:1362 | HALL_INF_FILT_MV:1432 | HALL_SUP_MV:975 | HALL_SUP_FILT_MV:1152 | PWM:255 | RAW:0.000 | ACTUAL:11.558 | REF:0.000 | ERRO:11.558 | TOF_VALID:0 | NEW_TOF:0 | RANGE_STATUS:3 | SIGNAL_MCPS:0.0000 | AMBIENT_MCPS:0.0000 | SPAD:64.0000 | VEL_MM_S:-0.0000 | MEAS_RATE_HZ:11.8167 | MEAS_AGE_US:176763184 | DT_HALL_US:3233 | DT_TOF_US:84626 | DT_EST_US:3232 | DT_CTRL_US:3237 | IDENT_ACTIVE:1 | IDENT_STATE:EXECUTANDO_PULSO | IDENT_TYPE:PULSO_FIXO | IDENT_REP:6 | IDENT_REP_MAX:10 | IDENT_FASE:2 | LIM_PWM:-1 | LIM_HALL_MV:1585 | LIM_ACTUAL_MM:NULL | LIM_RAW_MM:NULL | DELTA_LIM_MM:NULL | TEST_PWM:255 | TOF_BASE_MM:NULL | PULSO_HALL_PICO_MV:1432 | PULSO_ACTUAL_PICO_MM:NULL | DELTA_PULSO_MM:NULL | IDENT_MOTIVO:EM_ANDAMENTO | SYNC_PULSE:0 | LIM_HALL_CIMA_MV:1688 | PULSO_HALL_CIMA_PICO_MV:1152 | PULSO_PWM:255 | PULSO_T_MS:150 | PULSO_ENTRE_MS:500 | PULSO_PRE_MS:0 | HALL_BASE_MV:1585 | HALL_DELTA_PICO_MV:-153 | HALL_CIMA_BASE_MV:1688 | HALL_CIMA_DELTA_PICO_MV:-536 | SCALE_LOW:-5.00 | SCALE_HIGH:30.00
TEST_ID:IDENT_PULSO_CMD | TEST_PARAM:SIG=PUL_FIXO;PWM=255;TP=150;TE=500;REP=10;PRE=0;TOF=IGNORADO | T_US:1230540202 | HALL_INF_MV:1370 | HALL_INF_FILT_MV:1283 | HALL_SUP_MV:1472 | HALL_SUP_FILT_MV:1308 | PWM:0 | RAW:0.000 | ACTUAL:11.558 | REF:0.000 | ERRO:11.558 | TOF_VALID:0 | NEW_TOF:0 | RANGE_STATUS:3 | SIGNAL_MCPS:0.0000 | AMBIENT_MCPS:0.0000 | SPAD:64.0000 | VEL_MM_S:-0.0000 | MEAS_RATE_HZ:11.8167 | MEAS_AGE_US:176861792 | DT_HALL_US:3243 | DT_TOF_US:84626 | DT_EST_US:3242 | DT_CTRL_US:3235 | IDENT_ACTIVE:1 | IDENT_STATE:RECUPERANDO | IDENT_TYPE:PULSO_FIXO | IDENT_REP:6 | IDENT_REP_MAX:10 | IDENT_FASE:3 | LIM_PWM:-1 | LIM_HALL_MV:1585 | LIM_ACTUAL_MM:NULL | LIM_RAW_MM:NULL | DELTA_LIM_MM:NULL | TEST_PWM:255 | TOF_BASE_MM:NULL | PULSO_HALL_PICO_MV:1247 | PULSO_ACTUAL_PICO_MM:NULL | DELTA_PULSO_MM:NULL | IDENT_MOTIVO:EM_ANDAMENTO | SYNC_PULSE:0 | LIM_HALL_CIMA_MV:1688 | PULSO_HALL_CIMA_PICO_MV:1152 | PULSO_PWM:255 | PULSO_T_MS:150 | PULSO_ENTRE_MS:500 | PULSO_PRE_MS:0 | HALL_BASE_MV:1585 | HALL_DELTA_PICO_MV:-338 | HALL_CIMA_BASE_MV:1688 | HALL_CIMA_DELTA_PICO_MV:-536 | SCALE_LOW:-5.00 | SCALE_HIGH:30.00
TEST_ID:IDENT_PULSO_CMD | TEST_PARAM:SIG=PUL_FIXO;PWM=255;TP=150;TE=500;REP=10;PRE=0;TOF=IGNORADO | T_US:1230550202 | HALL_INF_MV:1619 | HALL_INF_FILT_MV:1508 | HALL_SUP_MV:1692 | HALL_SUP_FILT_MV:1597 | PWM:0 | RAW:0.000 | ACTUAL:11.558 | REF:0.000 | ERRO:11.558 | TOF_VALID:0 | NEW_TOF:0 | RANGE_STATUS:3 | SIGNAL_MCPS:0.0000 | AMBIENT_MCPS:0.0000 | SPAD:64.0000 | VEL_MM_S:-0.0000 | MEAS_RATE_HZ:11.8167 | MEAS_AGE_US:176958304 | DT_HALL_US:3235 | DT_TOF_US:84626 | DT_EST_US:3236 | DT_CTRL_US:3244 | IDENT_ACTIVE:1 | IDENT_STATE:RECUPERANDO | IDENT_TYPE:PULSO_FIXO | IDENT_REP:6 | IDENT_REP_MAX:10 | IDENT_FASE:3 | LIM_PWM:-1 | LIM_HALL_MV:1585 | LIM_ACTUAL_MM:NULL | LIM_RAW_MM:NULL | DELTA_LIM_MM:NULL | TEST_PWM:255 | TOF_BASE_MM:NULL | PULSO_HALL_PICO_MV:1247 | PULSO_ACTUAL_PICO_MM:NULL | DELTA_PULSO_MM:NULL | IDENT_MOTIVO:EM_ANDAMENTO | SYNC_PULSE:0 | LIM_HALL_CIMA_MV:1688 | PULSO_HALL_CIMA_PICO_MV:1152 | PULSO_PWM:255 | PULSO_T_MS:150 | PULSO_ENTRE_MS:500 | PULSO_PRE_MS:0 | HALL_BASE_MV:1585 | HALL_DELTA_PICO_MV:-338 | HALL_CIMA_BASE_MV:1688 | HALL_CIMA_DELTA_PICO_MV:-536 | SCALE_LOW:-5.00 | SCALE_HIGH:30.00
TEST_ID:IDENT_PULSO_CMD | TEST_PARAM:SIG=PUL_FIXO;PWM=255;TP=150;TE=500;REP=10;PRE=0;TOF=IGNORADO | T_US:1230732637 | HALL_INF_MV:1629 | HALL_INF_FILT_MV:1549 | HALL_SUP_MV:1603 | HALL_SUP_FILT_MV:1648 | PWM:0 | RAW:0.000 | ACTUAL:11.558 | REF:0.000 | ERRO:11.558 | TOF_VALID:0 | NEW_TOF:0 | RANGE_STATUS:3 | SIGNAL_MCPS:0.0000 | AMBIENT_MCPS:0.0000 | SPAD:64.0000 | VEL_MM_S:-0.0000 | MEAS_RATE_HZ:11.8167 | MEAS_AGE_US:177056848 | DT_HALL_US:3243 | DT_TOF_US:84626 | DT_EST_US:3243 | DT_CTRL_US:3243 | IDENT_ACTIVE:1 | IDENT_STATE:RECUPERANDO | IDENT_TYPE:PULSO_FIXO | IDENT_REP:6 | IDENT_REP_MAX:10 | IDENT_FASE:3 | LIM_PWM:-1 | LIM_HALL_MV:1585 | LIM_ACTUAL_MM:NULL | LIM_RAW_MM:NULL | DELTA_LIM_MM:NULL | TEST_PWM:255 | TOF_BASE_MM:NULL | PULSO_HALL_PICO_MV:1247 | PULSO_ACTUAL_PICO_MM:NULL | DELTA_PULSO_MM:NULL | IDENT_MOTIVO:EM_ANDAMENTO | SYNC_PULSE:0 | LIM_HALL_CIMA_MV:1688 | PULSO_HALL_CIMA_PICO_MV:1152 | PULSO_PWM:255 | PULSO_T_MS:150 | PULSO_ENTRE_MS:500 | PULSO_PRE_MS:0 | HALL_BASE_MV:1585 | HALL_DELTA_PICO_MV:-338 | HALL_CIMA_BASE_MV:1688 | HALL_CIMA_DELTA_PICO_MV:-536 | SCALE_LOW:-5.00 | SCALE_HIGH:30.00
TEST_ID:IDENT_PULSO_CMD | TEST_PARAM:SIG=PUL_FIXO;PWM=255;TP=150;TE=500;REP=10;PRE=0;TOF=IGNORADO | T_US:1230835040 | HALL_INF_MV:1577 | HALL_INF_FILT_MV:1559 | HALL_SUP_MV:1698 | HALL_SUP_FILT_MV:1726 | PWM:0 | RAW:0.000 | ACTUAL:11.558 | REF:0.000 | ERRO:11.558 | TOF_VALID:0 | NEW_TOF:0 | RANGE_STATUS:3 | SIGNAL_MCPS:0.0000 | AMBIENT_MCPS:0.0000 | SPAD:64.0000 | VEL_MM_S:-0.0000 | MEAS_RATE_HZ:11.8167 | MEAS_AGE_US:177155392 | DT_HALL_US:3258 | DT_TOF_US:84626 | DT_EST_US:3259 | DT_CTRL_US:3242 | IDENT_ACTIVE:1 | IDENT_STATE:RECUPERANDO | IDENT_TYPE:PULSO_FIXO | IDENT_REP:6 | IDENT_REP_MAX:10 | IDENT_FASE:3 | LIM_PWM:-1 | LIM_HALL_MV:1585 | LIM_ACTUAL_MM:NULL | LIM_RAW_MM:NULL | DELTA_LIM_MM:NULL | TEST_PWM:255 | TOF_BASE_MM:NULL | PULSO_HALL_PICO_MV:1247 | PULSO_ACTUAL_PICO_MM:NULL | DELTA_PULSO_MM:NULL | IDENT_MOTIVO:EM_ANDAMENTO | SYNC_PULSE:0 | LIM_HALL_CIMA_MV:1688 | PULSO_HALL_CIMA_PICO_MV:1152 | PULSO_PWM:255 | PULSO_T_MS:150 | PULSO_ENTRE_MS:500 | PULSO_PRE_MS:0 | HALL_BASE_MV:1585 | HALL_DELTA_PICO_MV:-338 | HALL_CIMA_BASE_MV:1688 | HALL_CIMA_DELTA_PICO_MV:-536 | SCALE_LOW:-5.00 | SCALE_HIGH:30.00
TEST_ID:IDENT_PULSO_CMD | TEST_PARAM:SIG=PUL_FIXO;PWM=255;TP=150;TE=500;REP=10;PRE=0;TOF=IGNORADO | T_US:1230845040 | HALL_INF_MV:1512 | HALL_INF_FILT_MV:1564 | HALL_SUP_MV:1641 | HALL_SUP_FILT_MV:1731 | PWM:0 | RAW:0.000 | ACTUAL:11.558 | REF:0.000 | ERRO:11.558 | TOF_VALID:0 | NEW_TOF:0 | RANGE_STATUS:3 | SIGNAL_MCPS:0.0000 | AMBIENT_MCPS:0.0000 | SPAD:64.0000 | VEL_MM_S:-0.0000 | MEAS_RATE_HZ:11.8167 | MEAS_AGE_US:177251920 | DT_HALL_US:3247 | DT_TOF_US:84626 | DT_EST_US:3246 | DT_CTRL_US:3237 | IDENT_ACTIVE:1 | IDENT_STATE:RECUPERANDO | IDENT_TYPE:PULSO_FIXO | IDENT_REP:6 | IDENT_REP_MAX:10 | IDENT_FASE:3 | LIM_PWM:-1 | LIM_HALL_MV:1585 | LIM_ACTUAL_MM:NULL | LIM_RAW_MM:NULL | DELTA_LIM_MM:NULL | TEST_PWM:255 | TOF_BASE_MM:NULL | PULSO_HALL_PICO_MV:1247 | PULSO_ACTUAL_PICO_MM:NULL | DELTA_PULSO_MM:NULL | IDENT_MOTIVO:EM_ANDAMENTO | SYNC_PULSE:0 | LIM_HALL_CIMA_MV:1688 | PULSO_HALL_CIMA_PICO_MV:1152 | PULSO_PWM:255 | PULSO_T_MS:150 | PULSO_ENTRE_MS:500 | PULSO_PRE_MS:0 | HALL_BASE_MV:1585 | HALL_DELTA_PICO_MV:-338 | HALL_CIMA_BASE_MV:1688 | HALL_CIMA_DELTA_PICO_MV:-536 | SCALE_LOW:-5.00 | SCALE_HIGH:30.00
TEST_ID:IDENT_PULSO_CMD | TEST_PARAM:SIG=PUL_FIXO;PWM=255;TP=150;TE=500;REP=10;PRE=0;TOF=IGNORADO | T_US:1231027610 | HALL_INF_MV:1522 | HALL_INF_FILT_MV:1553 | HALL_SUP_MV:1702 | HALL_SUP_FILT_MV:1734 | PWM:255 | RAW:0.000 | ACTUAL:11.558 | REF:0.000 | ERRO:11.558 | TOF_VALID:0 | NEW_TOF:0 | RANGE_STATUS:3 | SIGNAL_MCPS:0.0000 | AMBIENT_MCPS:0.0000 | SPAD:64.0000 | VEL_MM_S:-0.0000 | MEAS_RATE_HZ:11.8167 | MEAS_AGE_US:177350464 | DT_HALL_US:3252 | DT_TOF_US:84626 | DT_EST_US:3256 | DT_CTRL_US:3258 | IDENT_ACTIVE:1 | IDENT_STATE:EXECUTANDO_PULSO | IDENT_TYPE:PULSO_FIXO | IDENT_REP:7 | IDENT_REP_MAX:10 | IDENT_FASE:2 | LIM_PWM:-1 | LIM_HALL_MV:1585 | LIM_ACTUAL_MM:NULL | LIM_RAW_MM:NULL | DELTA_LIM_MM:NULL | TEST_PWM:255 | TOF_BASE_MM:NULL | PULSO_HALL_PICO_MV:1553 | PULSO_ACTUAL_PICO_MM:NULL | DELTA_PULSO_MM:NULL | IDENT_MOTIVO:EM_ANDAMENTO | SYNC_PULSE:0 | LIM_HALL_CIMA_MV:1688 | PULSO_HALL_CIMA_PICO_MV:1744 | PULSO_PWM:255 | PULSO_T_MS:150 | PULSO_ENTRE_MS:500 | PULSO_PRE_MS:0 | HALL_BASE_MV:1585 | HALL_DELTA_PICO_MV:-32 | HALL_CIMA_BASE_MV:1688 | HALL_CIMA_DELTA_PICO_MV:56 | SCALE_LOW:-5.00 | SCALE_HIGH:30.00
TEST_ID:IDENT_PULSO_CMD | TEST_PARAM:SIG=PUL_FIXO;PWM=255;TP=150;TE=500;REP=10;PRE=0;TOF=IGNORADO | T_US:1231129945 | HALL_INF_MV:1496 | HALL_INF_FILT_MV:1483 | HALL_SUP_MV:947 | HALL_SUP_FILT_MV:1171 | PWM:255 | RAW:0.000 | ACTUAL:11.558 | REF:0.000 | ERRO:11.558 | TOF_VALID:0 | NEW_TOF:0 | RANGE_STATUS:3 | SIGNAL_MCPS:0.0000 | AMBIENT_MCPS:0.0000 | SPAD:64.0000 | VEL_MM_S:-0.0000 | MEAS_RATE_HZ:11.8167 | MEAS_AGE_US:177449056 | DT_HALL_US:5239 | DT_TOF_US:84626 | DT_EST_US:5245 | DT_CTRL_US:5255 | IDENT_ACTIVE:1 | IDENT_STATE:EXECUTANDO_PULSO | IDENT_TYPE:PULSO_FIXO | IDENT_REP:7 | IDENT_REP_MAX:10 | IDENT_FASE:2 | LIM_PWM:-1 | LIM_HALL_MV:1585 | LIM_ACTUAL_MM:NULL | LIM_RAW_MM:NULL | DELTA_LIM_MM:NULL | TEST_PWM:255 | TOF_BASE_MM:NULL | PULSO_HALL_PICO_MV:1479 | PULSO_ACTUAL_PICO_MM:NULL | DELTA_PULSO_MM:NULL | IDENT_MOTIVO:EM_ANDAMENTO | SYNC_PULSE:0 | LIM_HALL_CIMA_MV:1688 | PULSO_HALL_CIMA_PICO_MV:1171 | PULSO_PWM:255 | PULSO_T_MS:150 | PULSO_ENTRE_MS:500 | PULSO_PRE_MS:0 | HALL_BASE_MV:1585 | HALL_DELTA_PICO_MV:-106 | HALL_CIMA_BASE_MV:1688 | HALL_CIMA_DELTA_PICO_MV:-517 | SCALE_LOW:-5.00 | SCALE_HIGH:30.00
TEST_ID:IDENT_PULSO_CMD | TEST_PARAM:SIG=PUL_FIXO;PWM=255;TP=150;TE=500;REP=10;PRE=0;TOF=IGNORADO | T_US:1231139945 | HALL_INF_MV:1260 | HALL_INF_FILT_MV:1290 | HALL_SUP_MV:1401 | HALL_SUP_FILT_MV:1313 | PWM:0 | RAW:0.000 | ACTUAL:11.558 | REF:0.000 | ERRO:11.558 | TOF_VALID:0 | NEW_TOF:0 | RANGE_STATUS:3 | SIGNAL_MCPS:0.0000 | AMBIENT_MCPS:0.0000 | SPAD:64.0000 | VEL_MM_S:-0.0000 | MEAS_RATE_HZ:11.8167 | MEAS_AGE_US:177545648 | DT_HALL_US:3243 | DT_TOF_US:84626 | DT_EST_US:3236 | DT_CTRL_US:3239 | IDENT_ACTIVE:1 | IDENT_STATE:RECUPERANDO | IDENT_TYPE:PULSO_FIXO | IDENT_REP:7 | IDENT_REP_MAX:10 | IDENT_FASE:3 | LIM_PWM:-1 | LIM_HALL_MV:1585 | LIM_ACTUAL_MM:NULL | LIM_RAW_MM:NULL | DELTA_LIM_MM:NULL | TEST_PWM:255 | TOF_BASE_MM:NULL | PULSO_HALL_PICO_MV:1283 | PULSO_ACTUAL_PICO_MM:NULL | DELTA_PULSO_MM:NULL | IDENT_MOTIVO:EM_ANDAMENTO | SYNC_PULSE:0 | LIM_HALL_CIMA_MV:1688 | PULSO_HALL_CIMA_PICO_MV:1171 | PULSO_PWM:255 | PULSO_T_MS:150 | PULSO_ENTRE_MS:500 | PULSO_PRE_MS:0 | HALL_BASE_MV:1585 | HALL_DELTA_PICO_MV:-302 | HALL_CIMA_BASE_MV:1688 | HALL_CIMA_DELTA_PICO_MV:-517 | SCALE_LOW:-5.00 | SCALE_HIGH:30.00
TEST_ID:IDENT_PULSO_CMD | TEST_PARAM:SIG=PUL_FIXO;PWM=255;TP=150;TE=500;REP=10;PRE=0;TOF=IGNORADO | T_US:1231322603 | HALL_INF_MV:1637 | HALL_INF_FILT_MV:1536 | HALL_SUP_MV:1769 | HALL_SUP_FILT_MV:1664 | PWM:0 | RAW:0.000 | ACTUAL:11.558 | REF:0.000 | ERRO:11.558 | TOF_VALID:0 | NEW_TOF:0 | RANGE_STATUS:3 | SIGNAL_MCPS:0.0000 | AMBIENT_MCPS:0.0000 | SPAD:64.0000 | VEL_MM_S:-0.0000 | MEAS_RATE_HZ:11.8167 | MEAS_AGE_US:177644192 | DT_HALL_US:3235 | DT_TOF_US:84626 | DT_EST_US:3240 | DT_CTRL_US:3241 | IDENT_ACTIVE:1 | IDENT_STATE:RECUPERANDO | IDENT_TYPE:PULSO_FIXO | IDENT_REP:7 | IDENT_REP_MAX:10 | IDENT_FASE:3 | LIM_PWM:-1 | LIM_HALL_MV:1585 | LIM_ACTUAL_MM:NULL | LIM_RAW_MM:NULL | DELTA_LIM_MM:NULL | TEST_PWM:255 | TOF_BASE_MM:NULL | PULSO_HALL_PICO_MV:1283 | PULSO_ACTUAL_PICO_MM:NULL | DELTA_PULSO_MM:NULL | IDENT_MOTIVO:EM_ANDAMENTO | SYNC_PULSE:0 | LIM_HALL_CIMA_MV:1688 | PULSO_HALL_CIMA_PICO_MV:1171 | PULSO_PWM:255 | PULSO_T_MS:150 | PULSO_ENTRE_MS:500 | PULSO_PRE_MS:0 | HALL_BASE_MV:1585 | HALL_DELTA_PICO_MV:-302 | HALL_CIMA_BASE_MV:1688 | HALL_CIMA_DELTA_PICO_MV:-517 | SCALE_LOW:-5.00 | SCALE_HIGH:30.00
TEST_ID:IDENT_PULSO_CMD | TEST_PARAM:SIG=PUL_FIXO;PWM=255;TP=150;TE=500;REP=10;PRE=0;TOF=IGNORADO | T_US:1231332603 | HALL_INF_MV:1507 | HALL_INF_FILT_MV:1558 | HALL_SUP_MV:1680 | HALL_SUP_FILT_MV:1700 | PWM:0 | RAW:0.000 | ACTUAL:11.558 | REF:0.000 | ERRO:11.558 | TOF_VALID:0 | NEW_TOF:0 | RANGE_STATUS:3 | SIGNAL_MCPS:0.0000 | AMBIENT_MCPS:0.0000 | SPAD:64.0000 | VEL_MM_S:-0.0000 | MEAS_RATE_HZ:11.8167 | MEAS_AGE_US:177740720 | DT_HALL_US:3239 | DT_TOF_US:84626 | DT_EST_US:3236 | DT_CTRL_US:3240 | IDENT_ACTIVE:1 | IDENT_STATE:RECUPERANDO | IDENT_TYPE:PULSO_FIXO | IDENT_REP:7 | IDENT_REP_MAX:10 | IDENT_FASE:3 | LIM_PWM:-1 | LIM_HALL_MV:1585 | LIM_ACTUAL_MM:NULL | LIM_RAW_MM:NULL | DELTA_LIM_MM:NULL | TEST_PWM:255 | TOF_BASE_MM:NULL | PULSO_HALL_PICO_MV:1283 | PULSO_ACTUAL_PICO_MM:NULL | DELTA_PULSO_MM:NULL | IDENT_MOTIVO:EM_ANDAMENTO | SYNC_PULSE:0 | LIM_HALL_CIMA_MV:1688 | PULSO_HALL_CIMA_PICO_MV:1171 | PULSO_PWM:255 | PULSO_T_MS:150 | PULSO_ENTRE_MS:500 | PULSO_PRE_MS:0 | HALL_BASE_MV:1585 | HALL_DELTA_PICO_MV:-302 | HALL_CIMA_BASE_MV:1688 | HALL_CIMA_DELTA_PICO_MV:-517 | SCALE_LOW:-5.00 | SCALE_HIGH:30.00
TEST_ID:IDENT_PULSO_CMD | TEST_PARAM:SIG=PUL_FIXO;PWM=255;TP=150;TE=500;REP=10;PRE=0;TOF=IGNORADO | T_US:1231515034 | HALL_INF_MV:1568 | HALL_INF_FILT_MV:1568 | HALL_SUP_MV:1616 | HALL_SUP_FILT_MV:1669 | PWM:0 | RAW:0.000 | ACTUAL:11.558 | REF:0.000 | ERRO:11.558 | TOF_VALID:0 | NEW_TOF:0 | RANGE_STATUS:3 | SIGNAL_MCPS:0.0000 | AMBIENT_MCPS:0.0000 | SPAD:64.0000 | VEL_MM_S:-0.0000 | MEAS_RATE_HZ:11.8167 | MEAS_AGE_US:177839264 | DT_HALL_US:3240 | DT_TOF_US:84626 | DT_EST_US:3244 | DT_CTRL_US:3241 | IDENT_ACTIVE:1 | IDENT_STATE:RECUPERANDO | IDENT_TYPE:PULSO_FIXO | IDENT_REP:7 | IDENT_REP_MAX:10 | IDENT_FASE:3 | LIM_PWM:-1 | LIM_HALL_MV:1585 | LIM_ACTUAL_MM:NULL | LIM_RAW_MM:NULL | DELTA_LIM_MM:NULL | TEST_PWM:255 | TOF_BASE_MM:NULL | PULSO_HALL_PICO_MV:1283 | PULSO_ACTUAL_PICO_MM:NULL | DELTA_PULSO_MM:NULL | IDENT_MOTIVO:EM_ANDAMENTO | SYNC_PULSE:0 | LIM_HALL_CIMA_MV:1688 | PULSO_HALL_CIMA_PICO_MV:1171 | PULSO_PWM:255 | PULSO_T_MS:150 | PULSO_ENTRE_MS:500 | PULSO_PRE_MS:0 | HALL_BASE_MV:1585 | HALL_DELTA_PICO_MV:-302 | HALL_CIMA_BASE_MV:1688 | HALL_CIMA_DELTA_PICO_MV:-517 | SCALE_LOW:-5.00 | SCALE_HIGH:30.00
TEST_ID:IDENT_PULSO_CMD | TEST_PARAM:SIG=PUL_FIXO;PWM=255;TP=150;TE=500;REP=10;PRE=0;TOF=IGNORADO | T_US:1231617446 | HALL_INF_MV:1517 | HALL_INF_FILT_MV:1591 | HALL_SUP_MV:1665 | HALL_SUP_FILT_MV:1714 | PWM:0 | RAW:0.000 | ACTUAL:11.558 | REF:0.000 | ERRO:11.558 | TOF_VALID:0 | NEW_TOF:0 | RANGE_STATUS:3 | SIGNAL_MCPS:0.0000 | AMBIENT_MCPS:0.0000 | SPAD:64.0000 | VEL_MM_S:-0.0000 | MEAS_RATE_HZ:11.8167 | MEAS_AGE_US:177937808 | DT_HALL_US:3257 | DT_TOF_US:84626 | DT_EST_US:3250 | DT_CTRL_US:3238 | IDENT_ACTIVE:1 | IDENT_STATE:RECUPERANDO | IDENT_TYPE:PULSO_FIXO | IDENT_REP:7 | IDENT_REP_MAX:10 | IDENT_FASE:3 | LIM_PWM:-1 | LIM_HALL_MV:1585 | LIM_ACTUAL_MM:NULL | LIM_RAW_MM:NULL | DELTA_LIM_MM:NULL | TEST_PWM:255 | TOF_BASE_MM:NULL | PULSO_HALL_PICO_MV:1283 | PULSO_ACTUAL_PICO_MM:NULL | DELTA_PULSO_MM:NULL | IDENT_MOTIVO:EM_ANDAMENTO | SYNC_PULSE:0 | LIM_HALL_CIMA_MV:1688 | PULSO_HALL_CIMA_PICO_MV:1171 | PULSO_PWM:255 | PULSO_T_MS:150 | PULSO_ENTRE_MS:500 | PULSO_PRE_MS:0 | HALL_BASE_MV:1585 | HALL_DELTA_PICO_MV:-302 | HALL_CIMA_BASE_MV:1688 | HALL_CIMA_DELTA_PICO_MV:-517 | SCALE_LOW:-5.00 | SCALE_HIGH:30.00
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
