GabrielPaschoalin/PFC/maglev/Bckp/test_slow_mo/plot.png

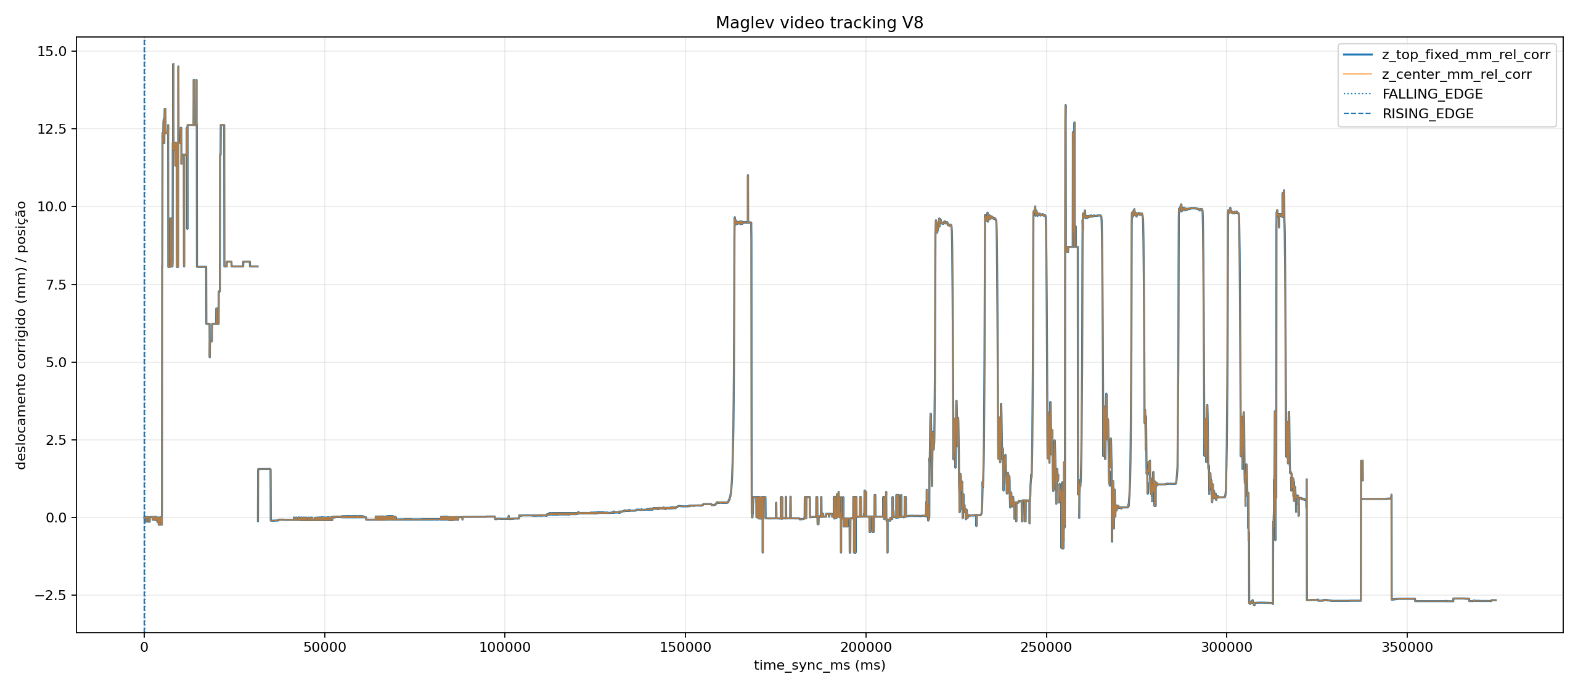
maglev/Bckp/test_slow_mo/plot.png
