GabrielPaschoalin/PFC/maglev/Bckp/tracking_v7_teste_01/plot.png

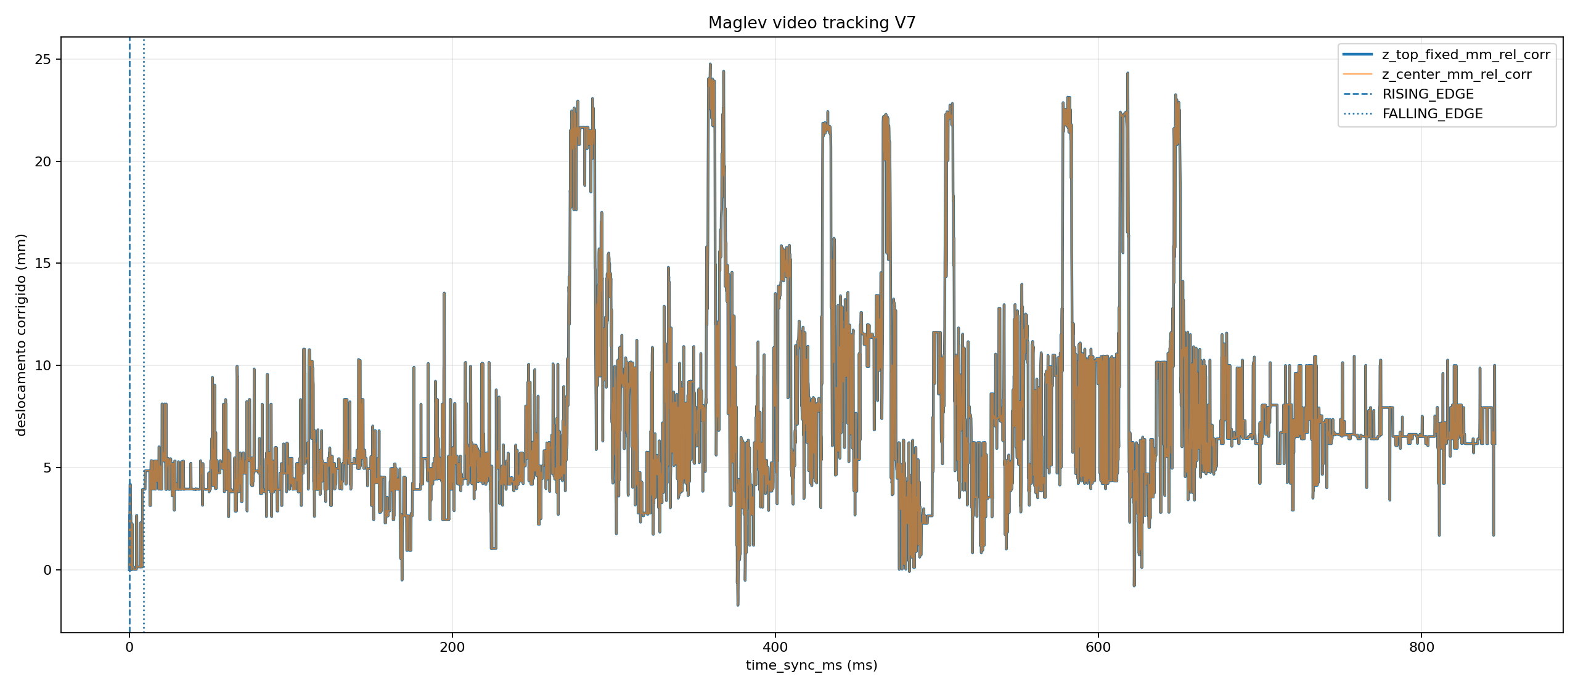
maglev/Bckp/tracking_v7_teste_01/plot.png
