GabrielPaschoalin/PFC/Modelagem-PFC/Validação modelo/validacao_v9_teste1_sem_perturbacao.png

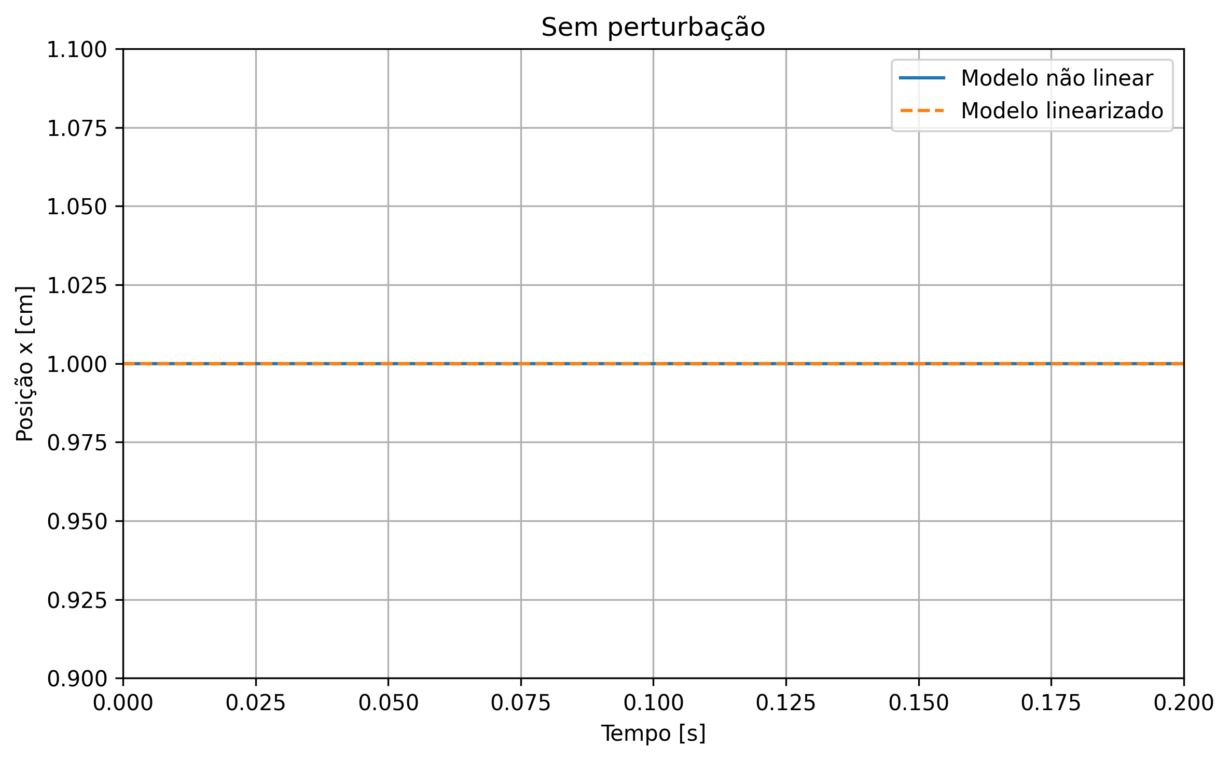
Modelagem-PFC/Validação modelo/validacao_v9_teste1_sem_perturbacao.png
