GabrielPaschoalin/PFC/Modelagem-PFC/Validação modelo/validacao_v9_teste2_perturbacao_posicao.png

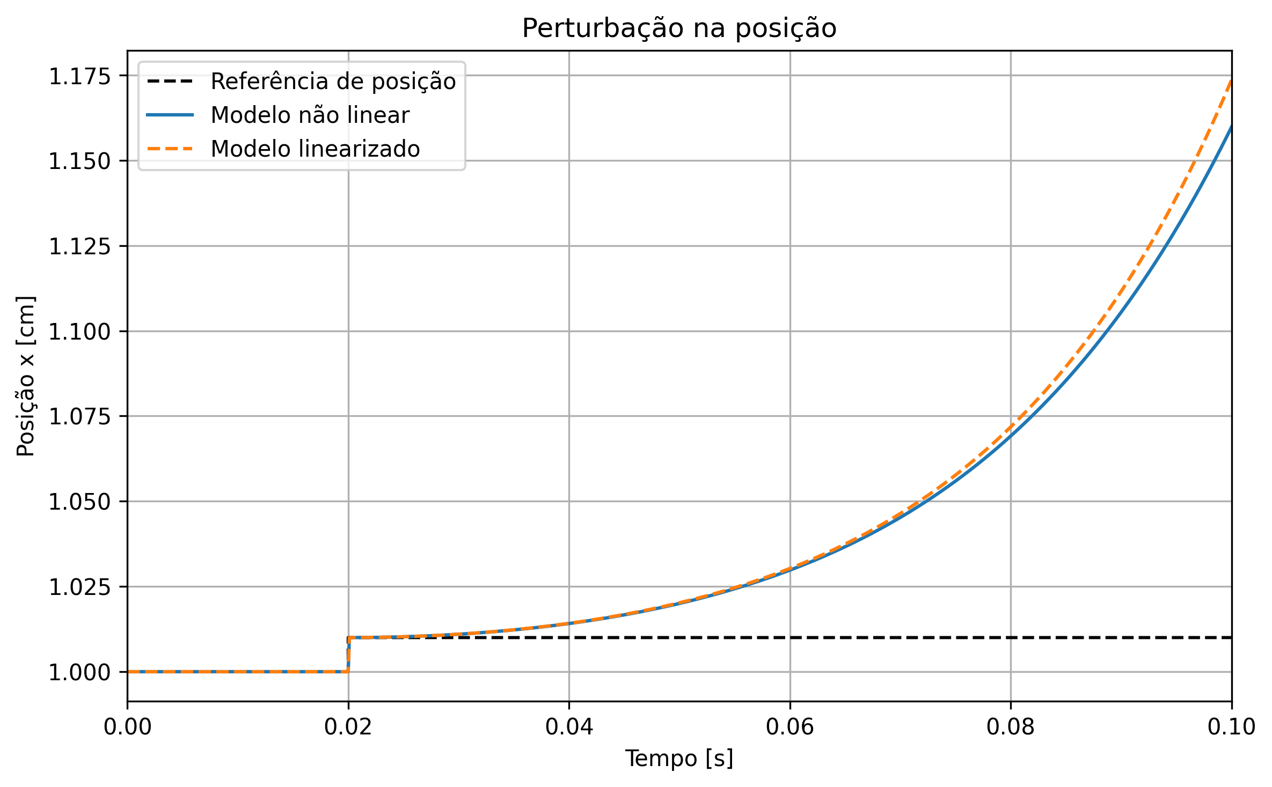
Modelagem-PFC/Validação modelo/validacao_v9_teste2_perturbacao_posicao.png
