GabrielPaschoalin/PFC/TESE/Referência/Lab 5.pdf

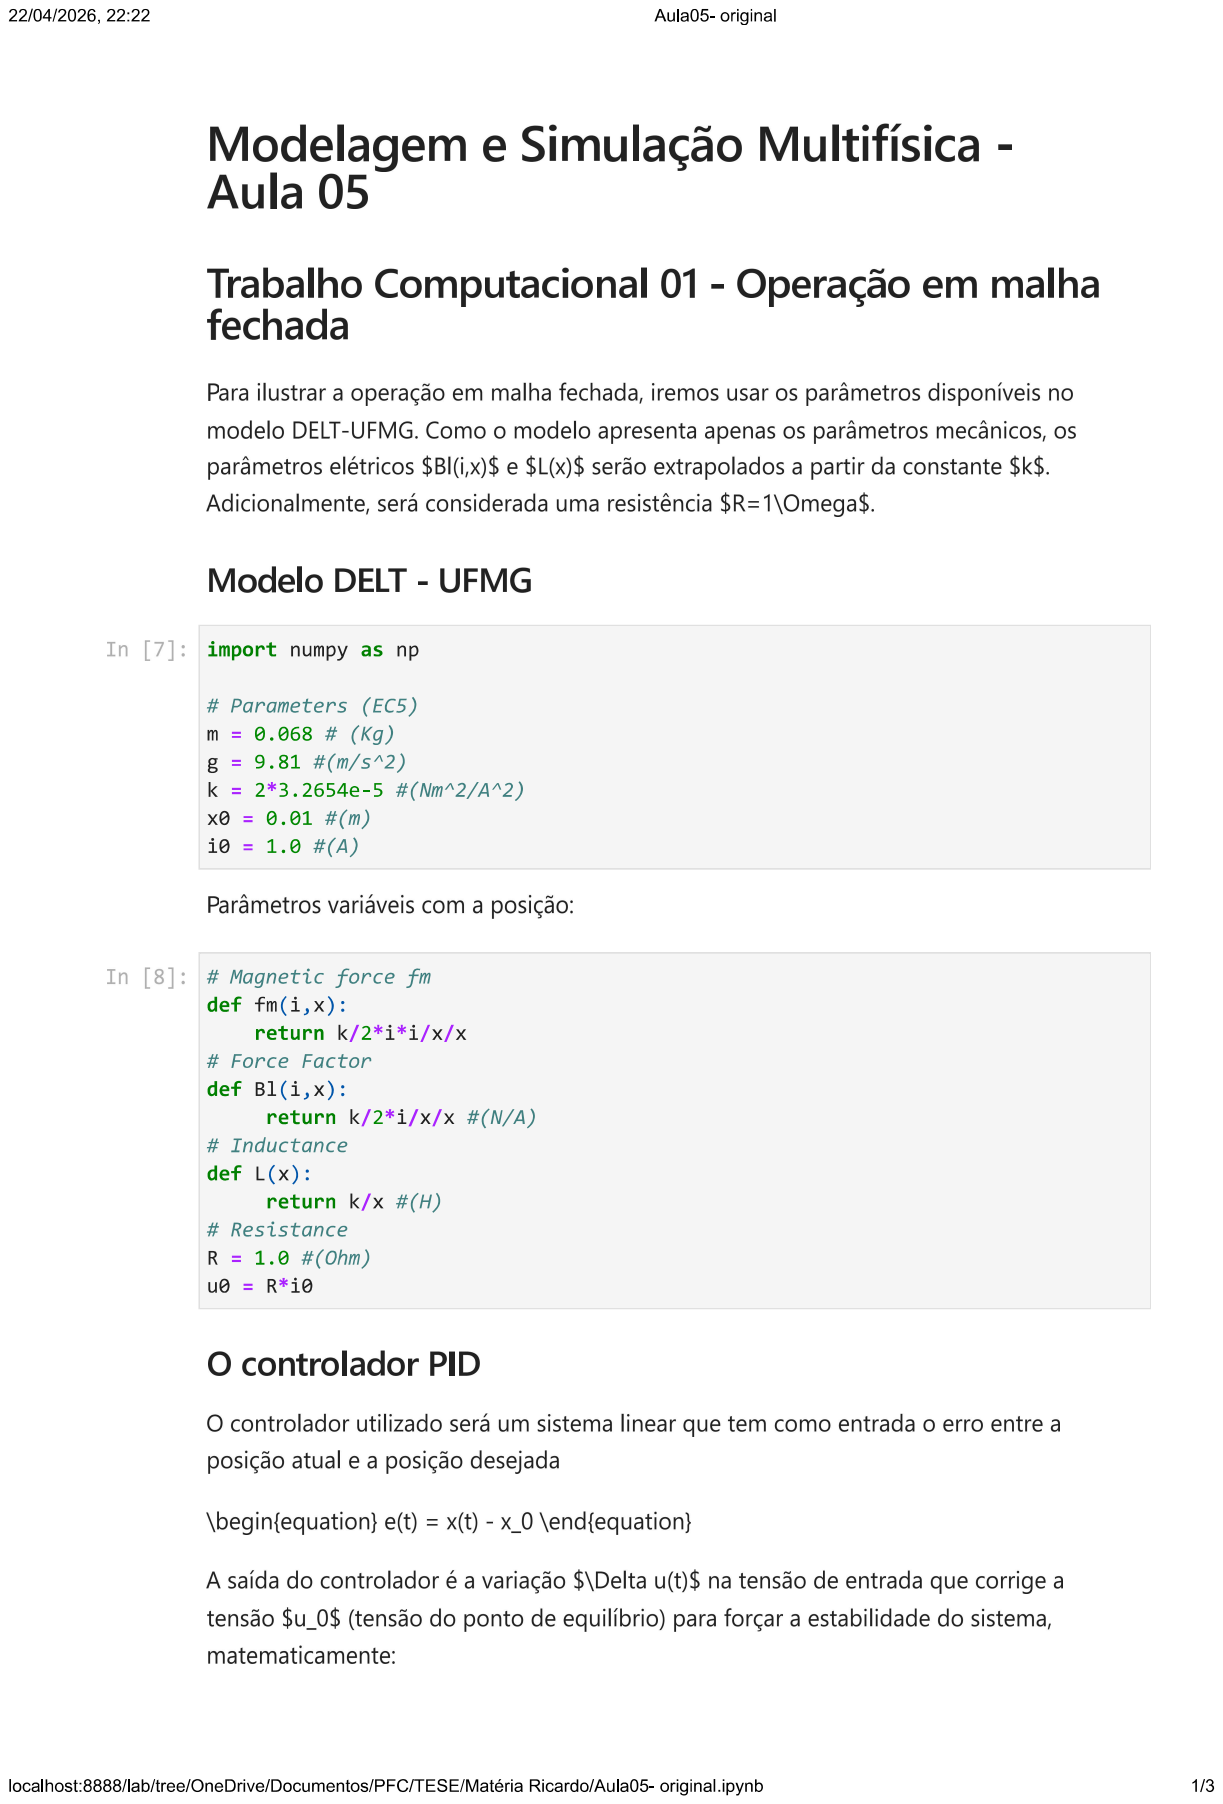
[picture p186: page 1]

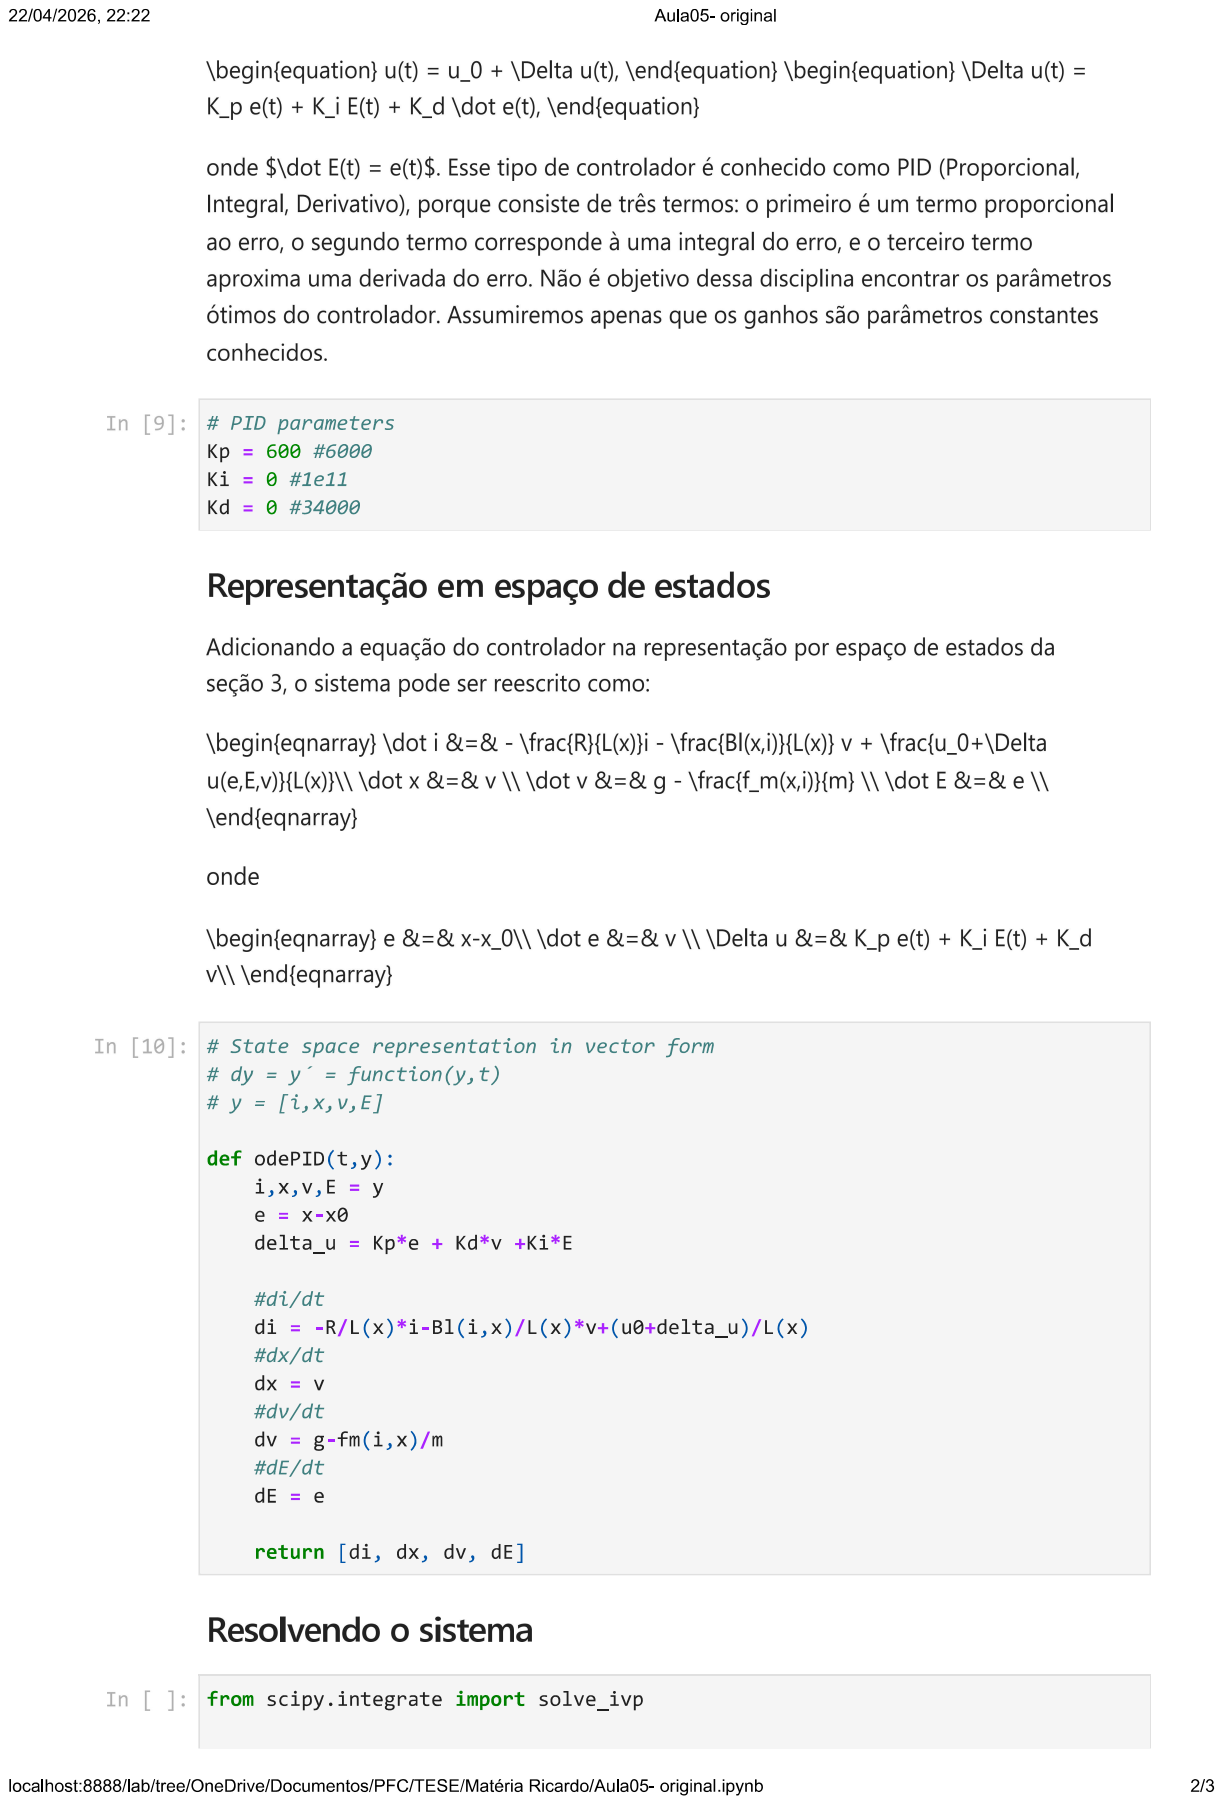
[picture p187: page 2]

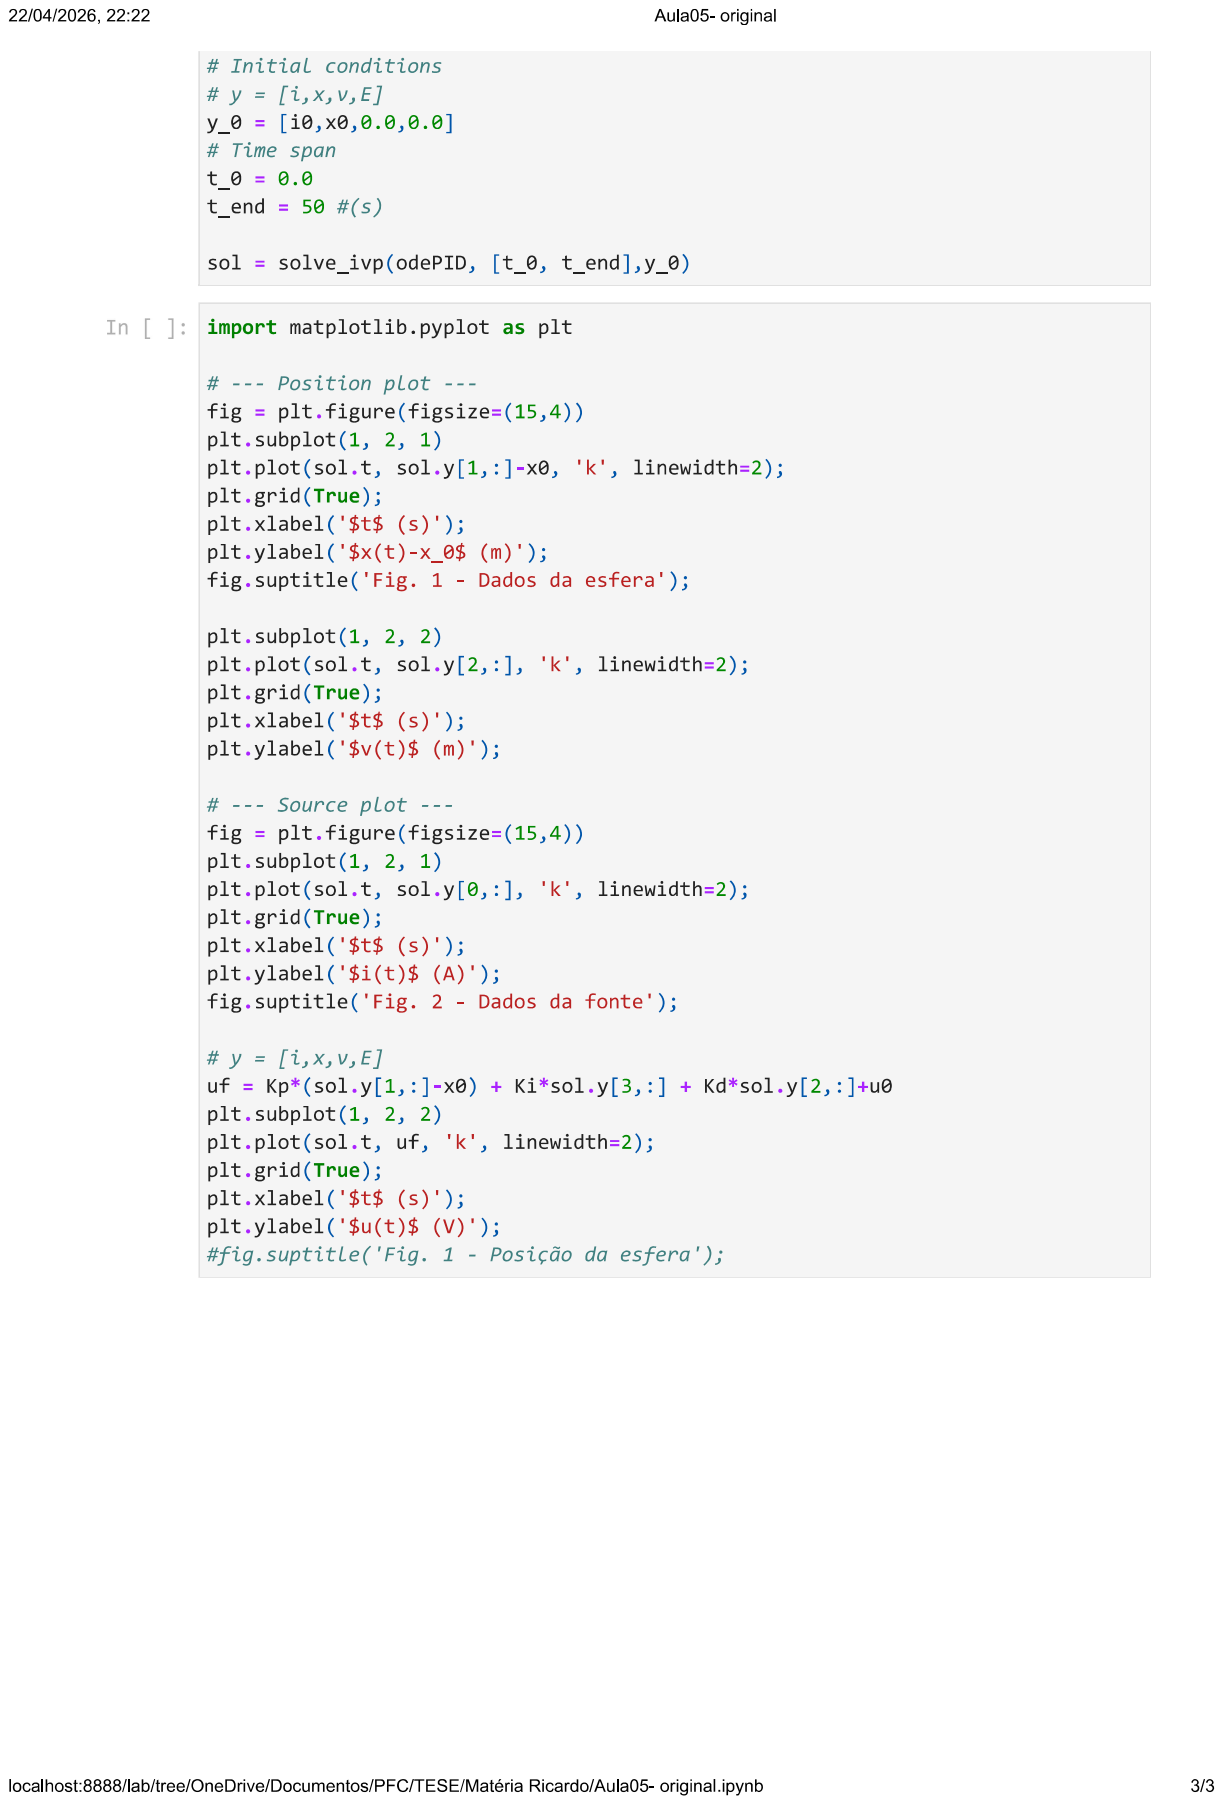
[picture p188: page 3]
