GabrielPaschoalin/PFC/TESE/Matéria Ricardo/PDFs/Aula 4.pdf

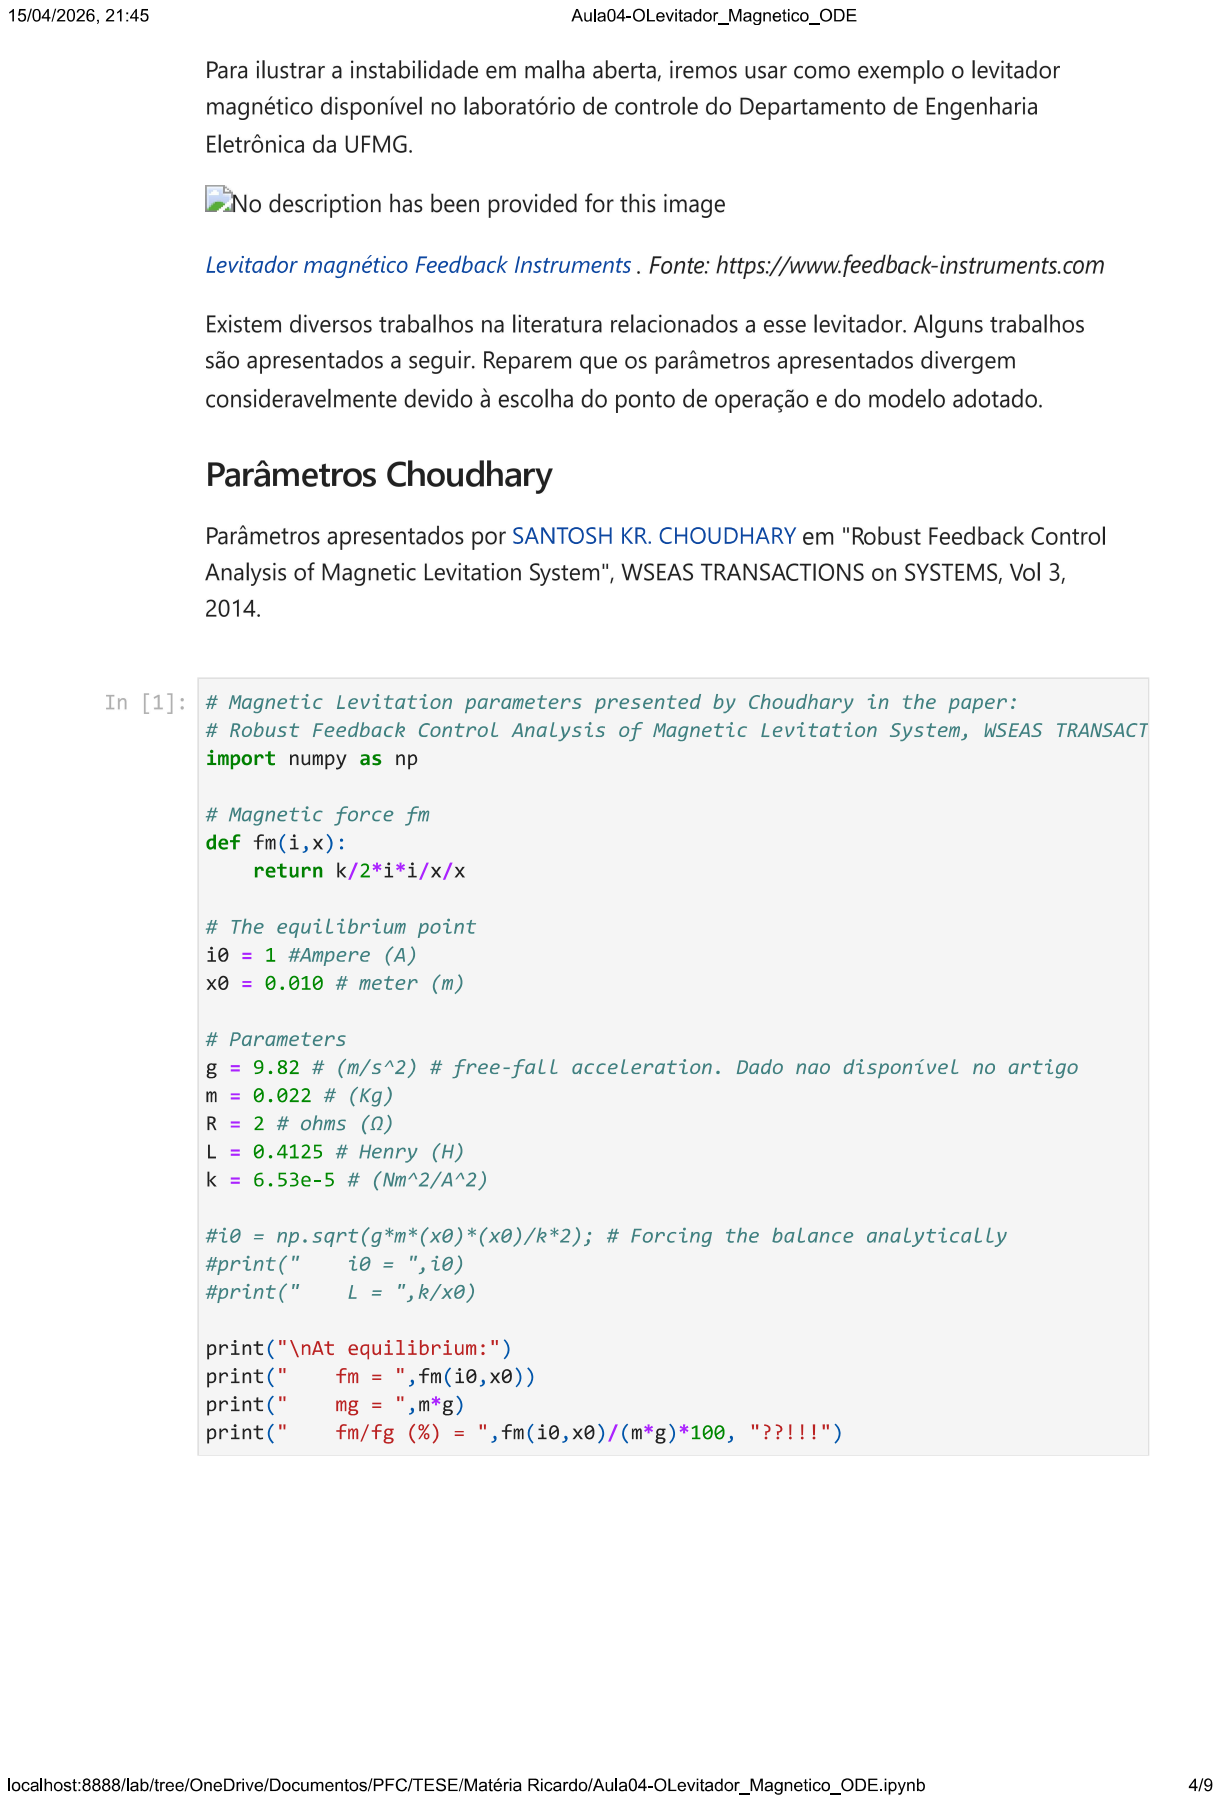
[picture p197: page 4]

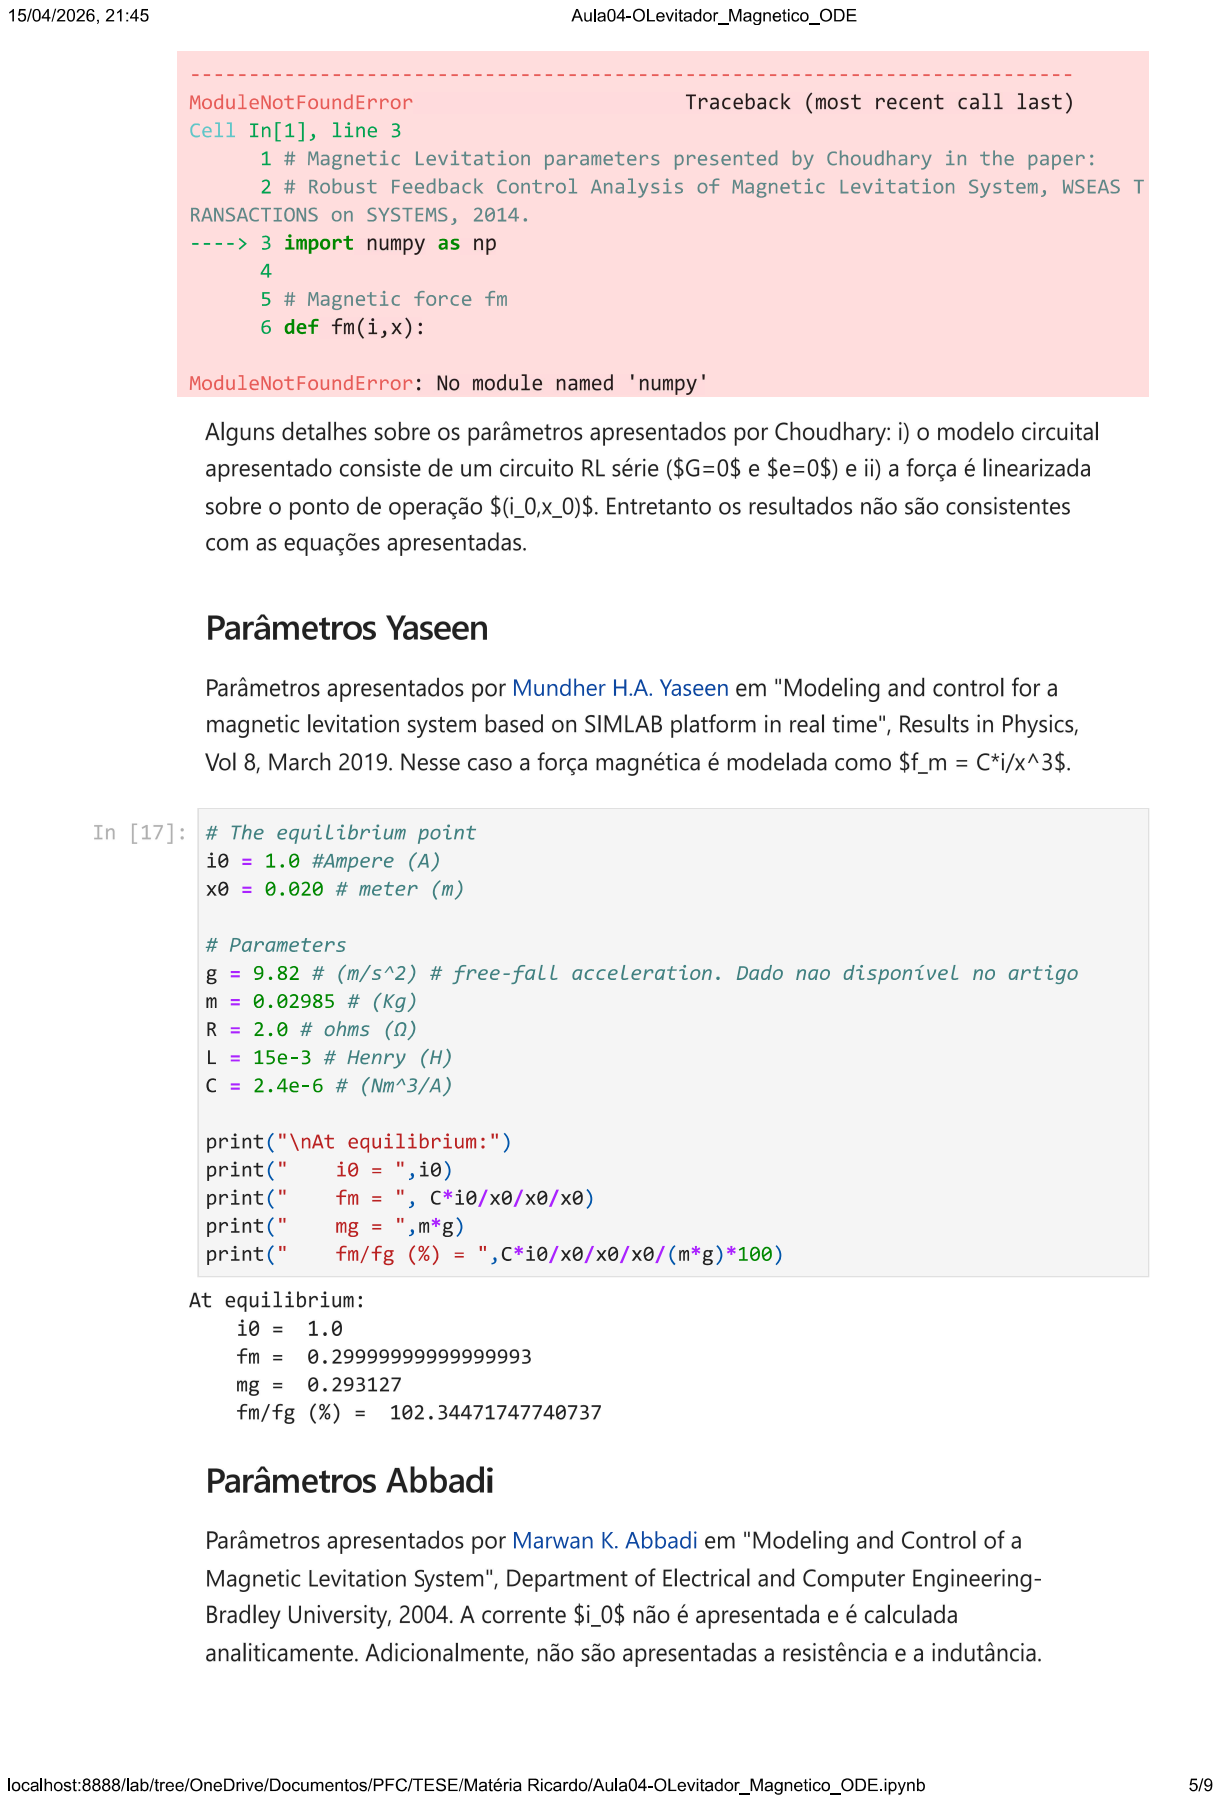
[picture p198: page 5]

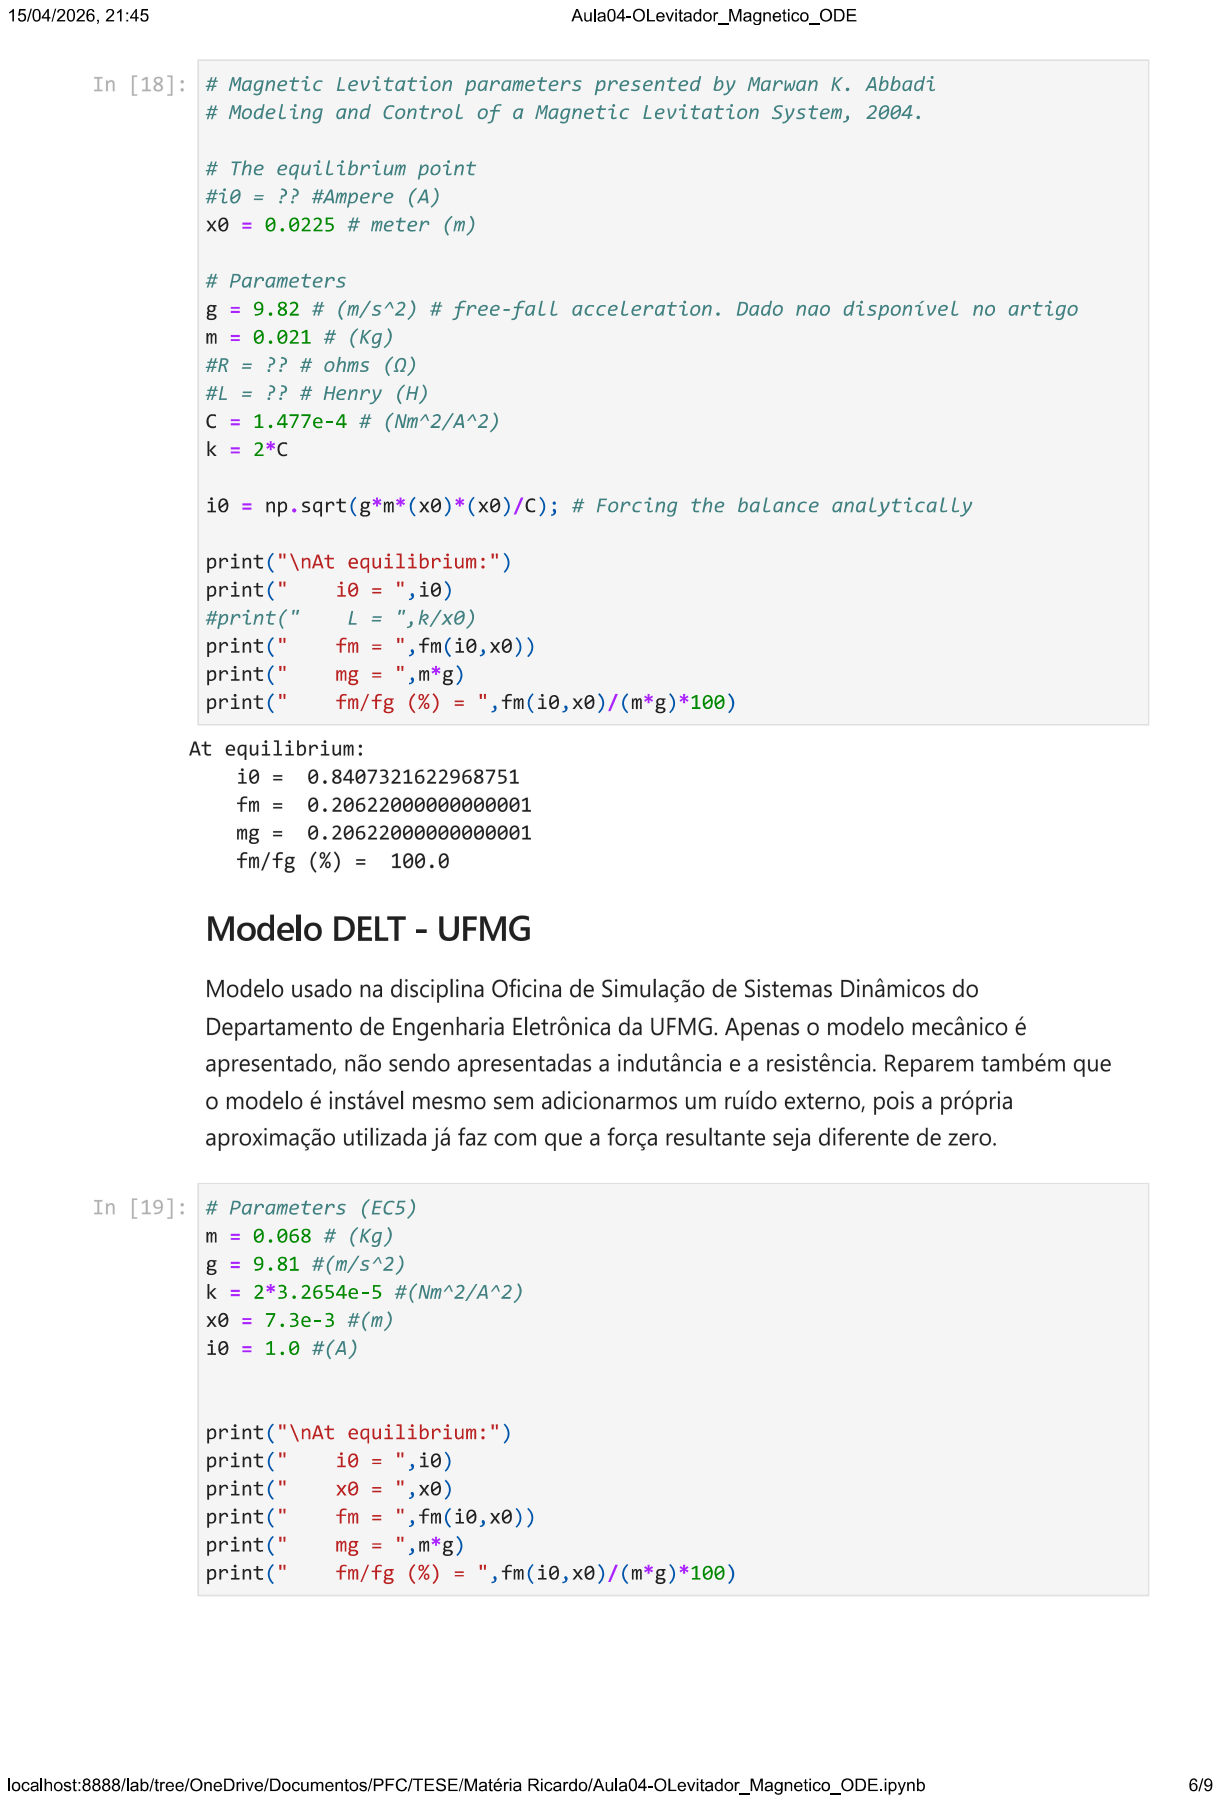
[picture p199: page 6]

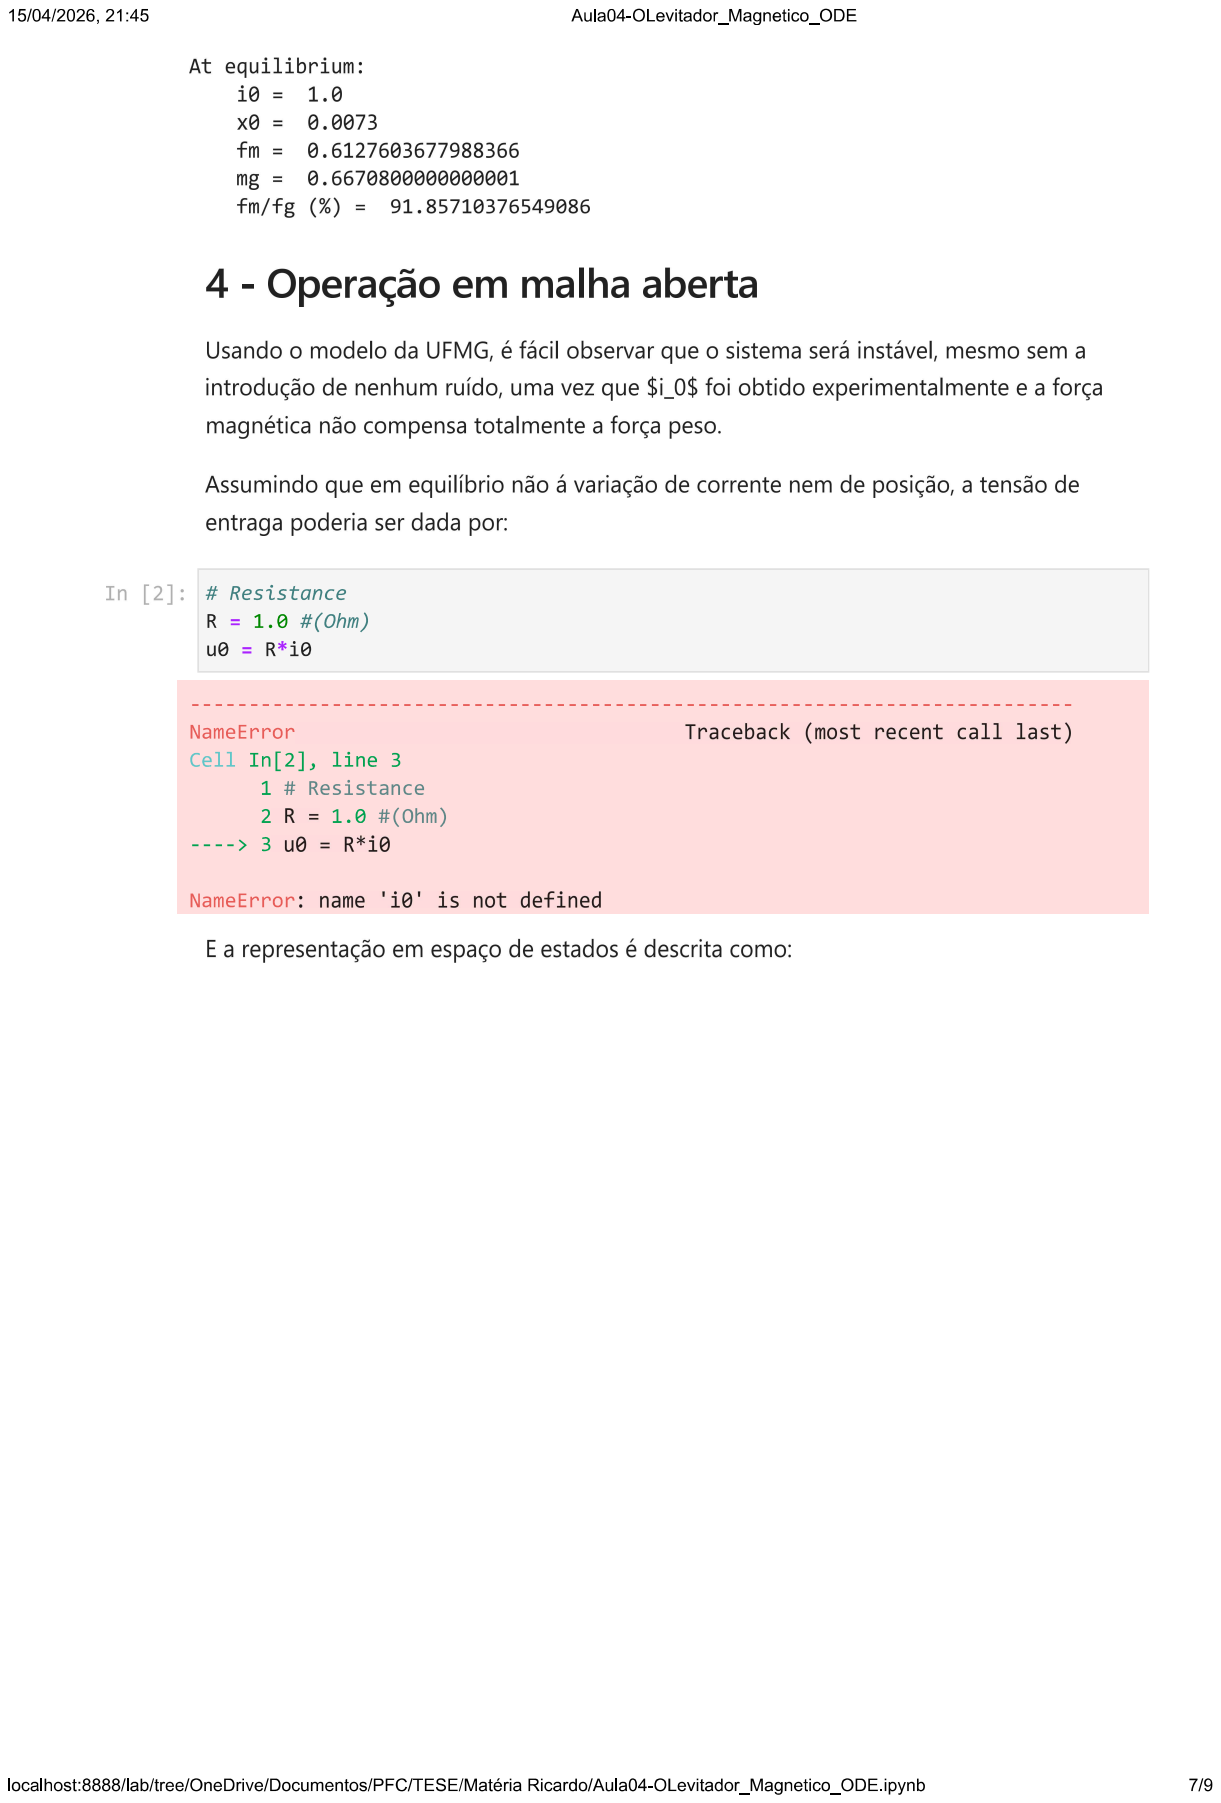
[picture p200: page 7]

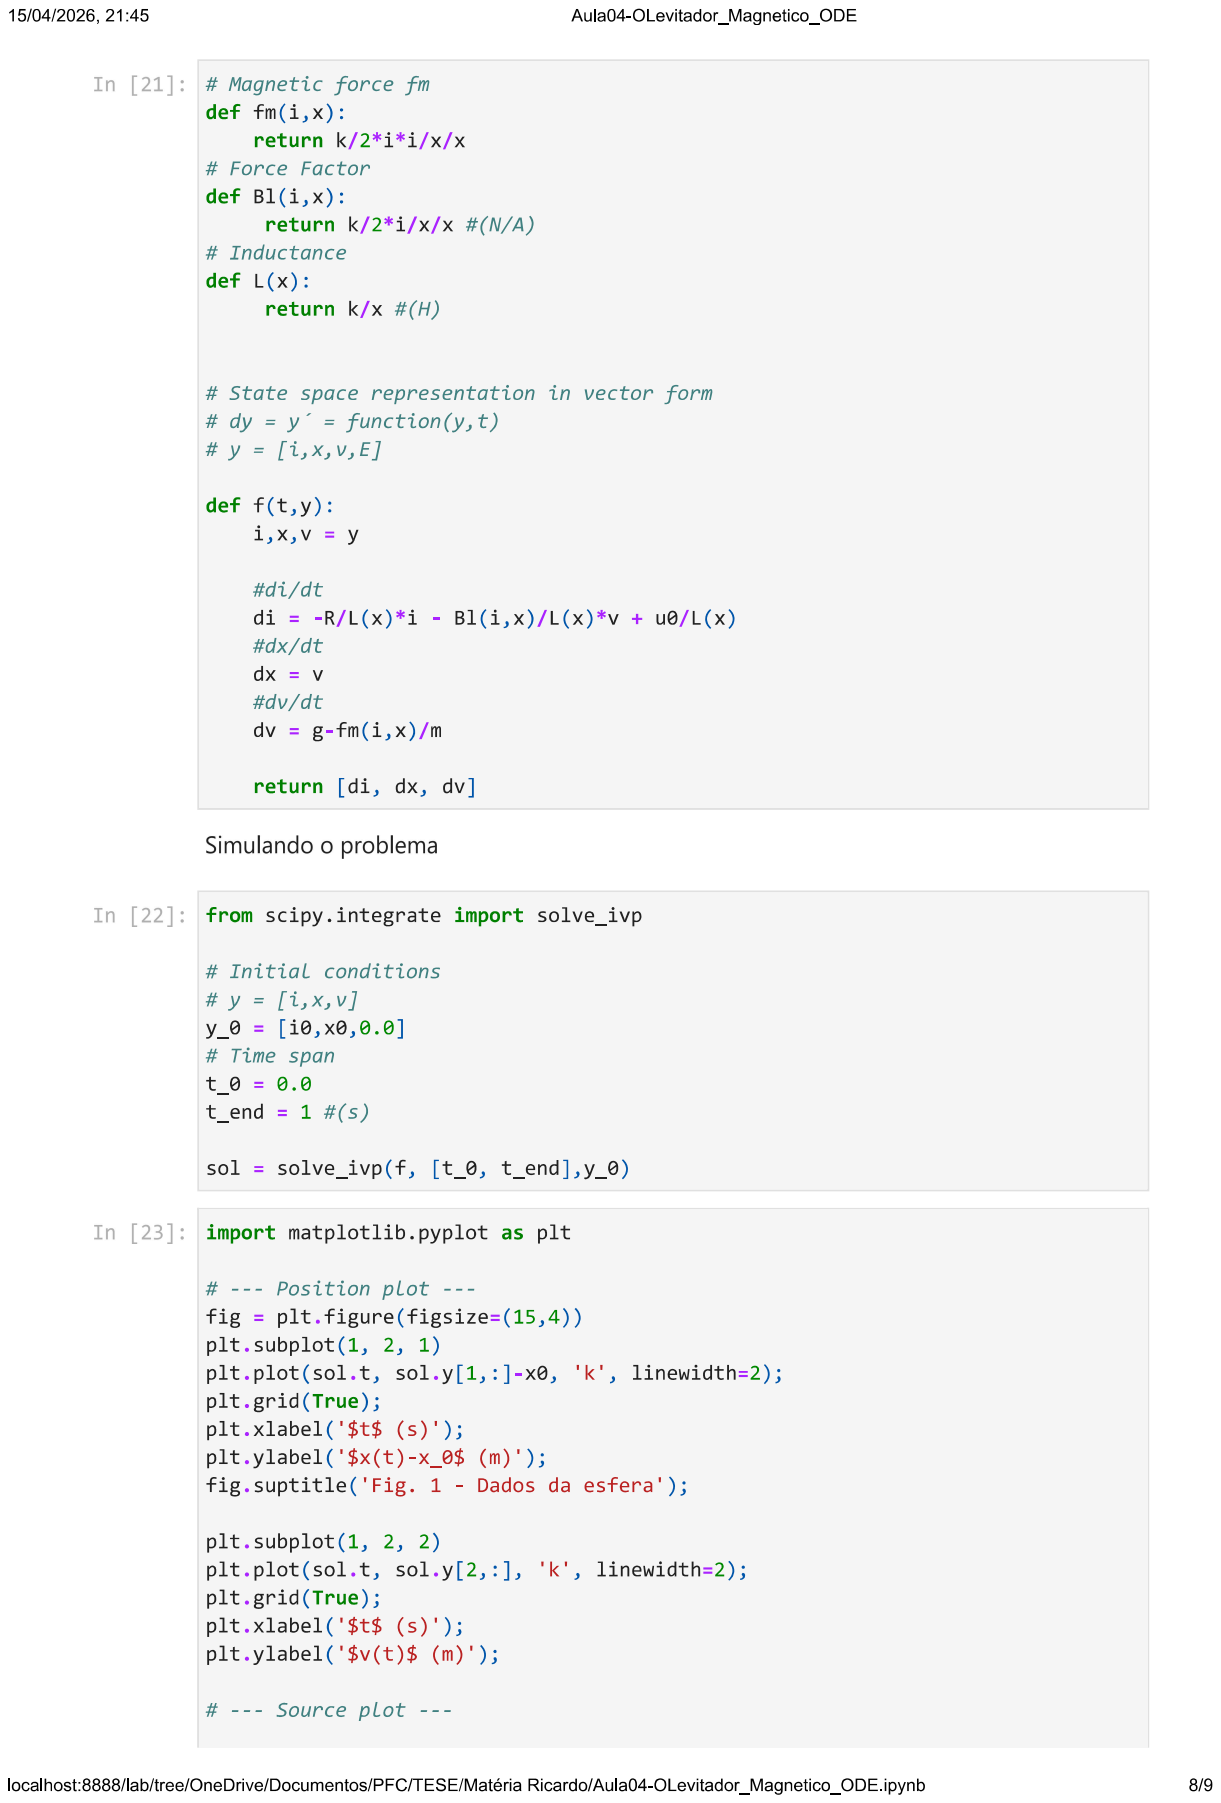
[picture p201: page 8]

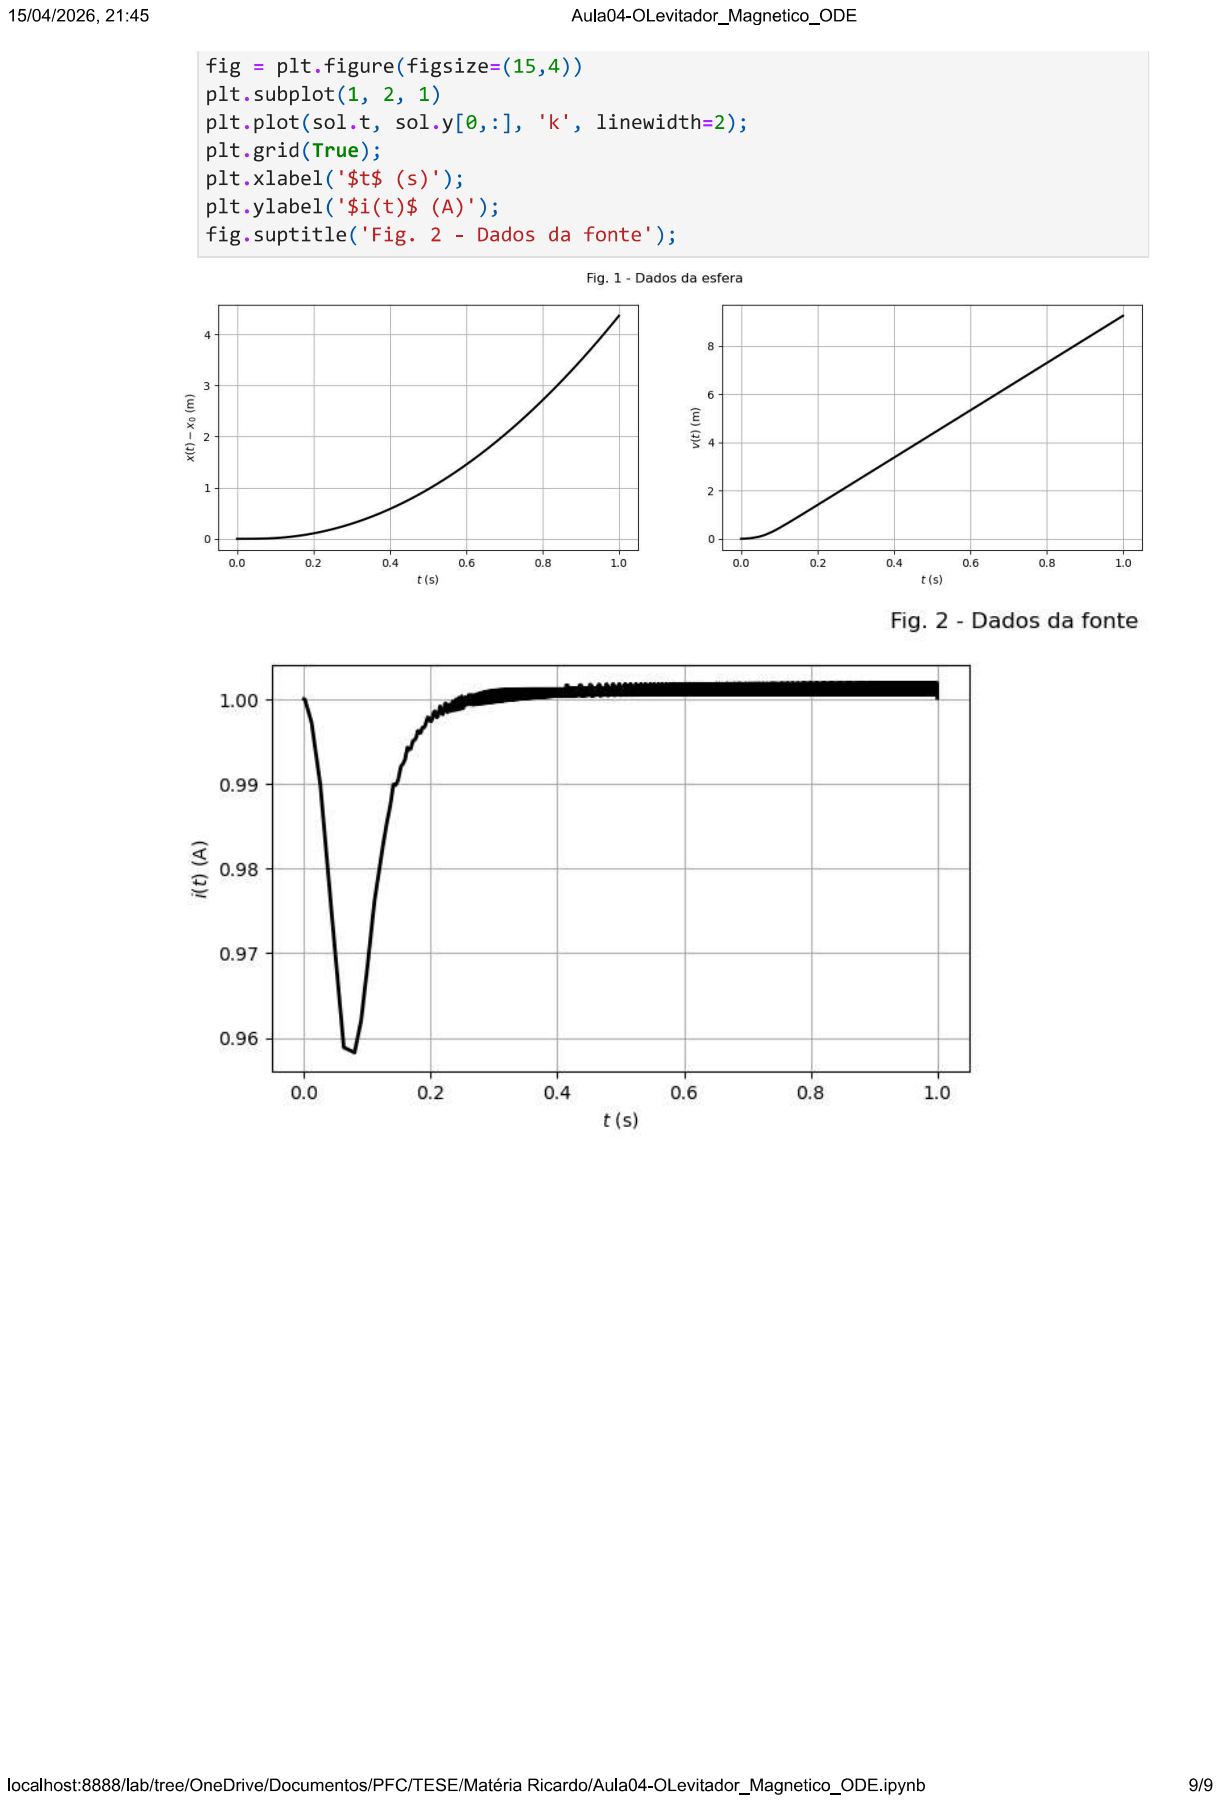
[picture p202: page 9]
