GabrielPaschoalin/PFC/(commit log)

2026-05-01 Inclusão dos códigos da implementação física
    [1606.csv, 1608.csv, 1610.csv, 2024.csv, 2024_mesclado.csv, 2024_tratado.csv, IDENT_1606.csv, IDENT_1608.csv]
2026-05-02 testes maglev
    [1606.csv, 1608.csv, 1610.csv, 2024.csv, 2024_mesclado.csv, 2024_tratado.csv, IDENT_1606.csv, IDENT_1608.csv]
2026-05-05 atualização
    [0105.csv, 0105_mesclado.csv, 0105_tratado.csv, 190_sem_bolinha.csv, 210_sem_bolinha.csv, 230_sem_bolinha.csv, 255_sem_bolinha.csv, candidates.csv]
2026-05-15 Adicionar códigos controlador
    [resultados_busca_pid_maglev_v2_aceitos.csv, resultados_busca_pid_maglev_v2_todos.csv]
